OpenAgricultureFoundation/openag-mechanical/prj/hazelnut_large/LHC-001/1-Documentation/2018-2019 Large Tree Computer - Superceded Designs and Documentation/2019-4-18 Light Test Setup in SHC/IMG_1373.JPG

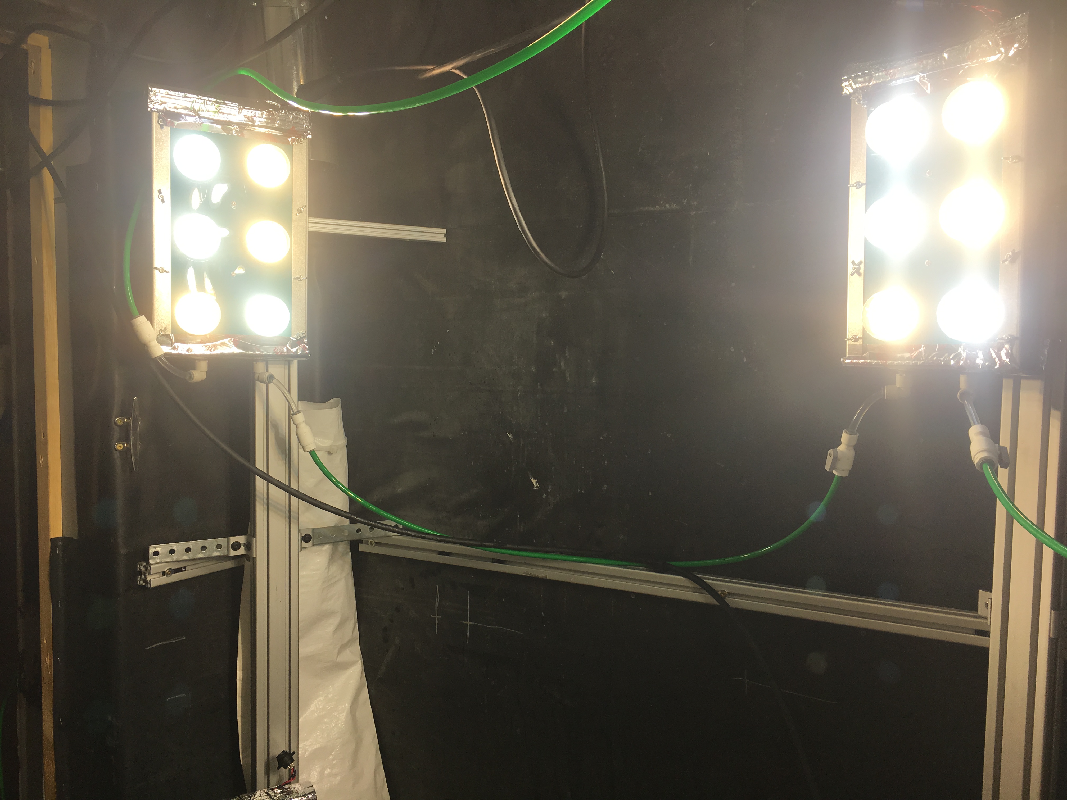
prj/hazelnut_large/LHC-001/1-Documentation/2018-2019 Large Tree Computer - Superceded Designs and Documentation/2019-4-18 Light Test Setup in SHC/IMG_1373.JPG
