OpenAgricultureFoundation/openag-mechanical/prj/hazelnut_large/LHC-001/1-Documentation/2018-2019 Large Tree Computer - Superceded Designs and Documentation/2018-10-1 Status Update/2.jpg

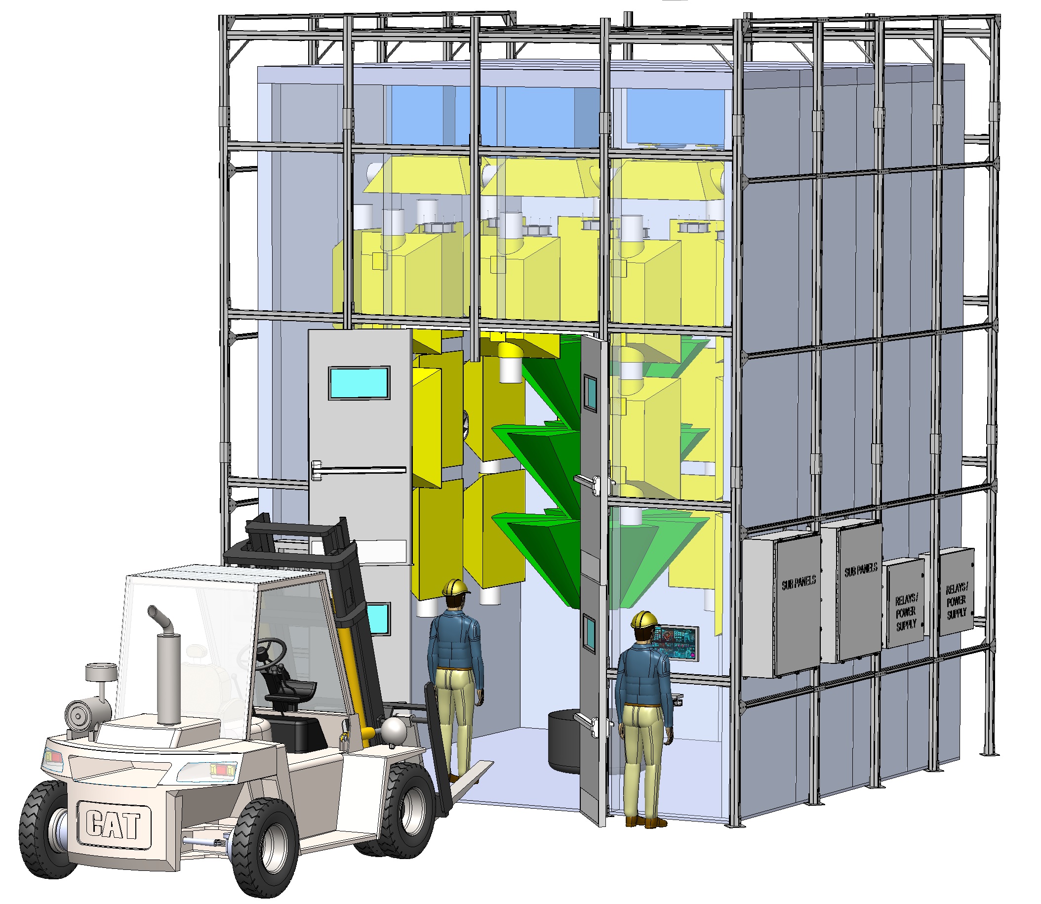
prj/hazelnut_large/LHC-001/1-Documentation/2018-2019 Large Tree Computer - Superceded Designs and Documentation/2018-10-1 Status Update/2.jpg
