OpenAgricultureFoundation/openag-mechanical/README.md

# OpenAg Body
Body of mechanical hardware for the various food computers.
Mechanical design based in Solidworks.

*WORK IN PROGRESS*

### Projects
- Create project directory structure
- Follow naming conventions
