OpenAgricultureFoundation/openag-mechanical/prj/fs-waterbot/v1.0/README.md

# waterbot
Mechanical specs and model for automated irrigation system sub-assemblies
