OpenAgricultureFoundation/openag-mechanical/prj/hazelnut_large/LHC-001/1-Documentation/2019-10-24 LED Coolant Line Routing Designs/2019-10-30 Fluid Line Routing Details.pptx

LHC-201 Fluid Line Routing Details
OpenAg, MIT Media Lab

By Eugene Zeleny
Oct 30th, 2019

## Slide 2

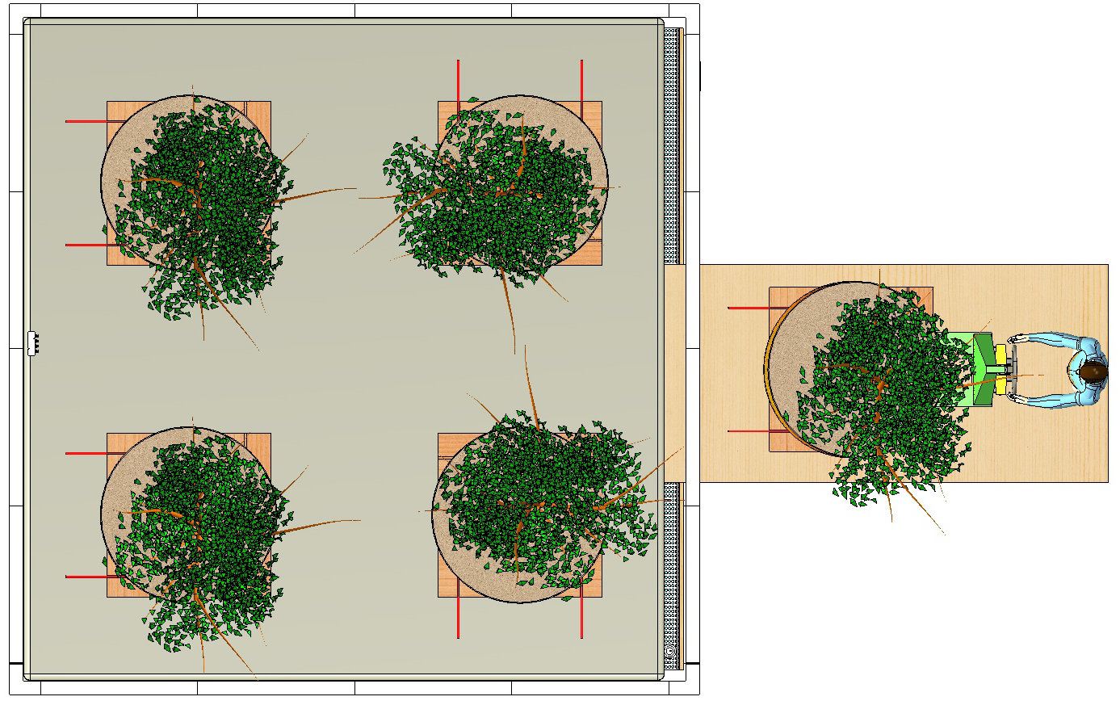
[picture p3: figure]

- Tree pallet layout and suggested fluid line routing for the Tree Heater Assembly

Fluid to Tree Heater

Fluid from Tree Heater

## Slide 3

Heated Fluid
To Radiator

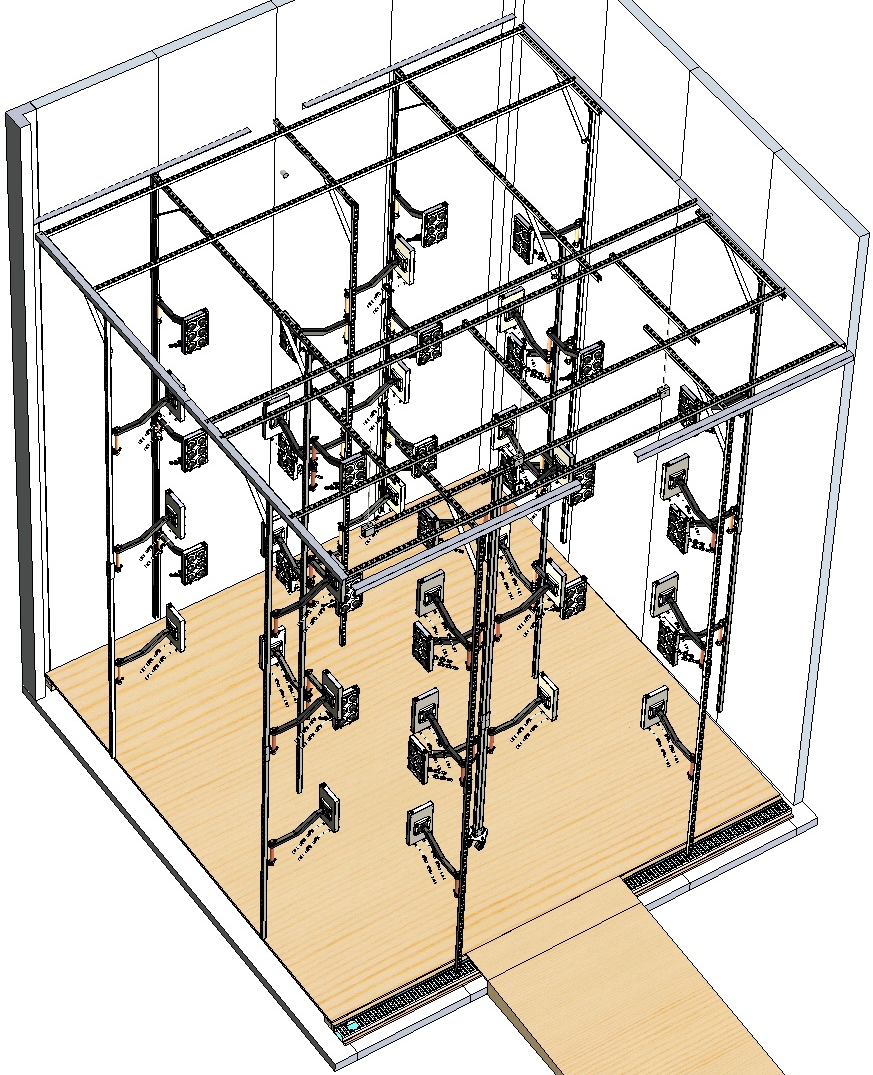
[picture p4: figure]

- Suggested fluid line routing for LED Enclosures

Cooled Fluid
To LEDs

Fluid Leaving the LEDs

Fluid Entering the LEDs
