OpenAgricultureFoundation/openag-mechanical/prj/hazelnut_large/LHC-001/1-Documentation/2019-10-23 Light Unistrut Designs - Updated/2019-10-29 LED Unistrut Design Details.pptx

LHC-201 LED Unistrut Design Details
and
Installation Guide
OpenAg, MIT Media Lab

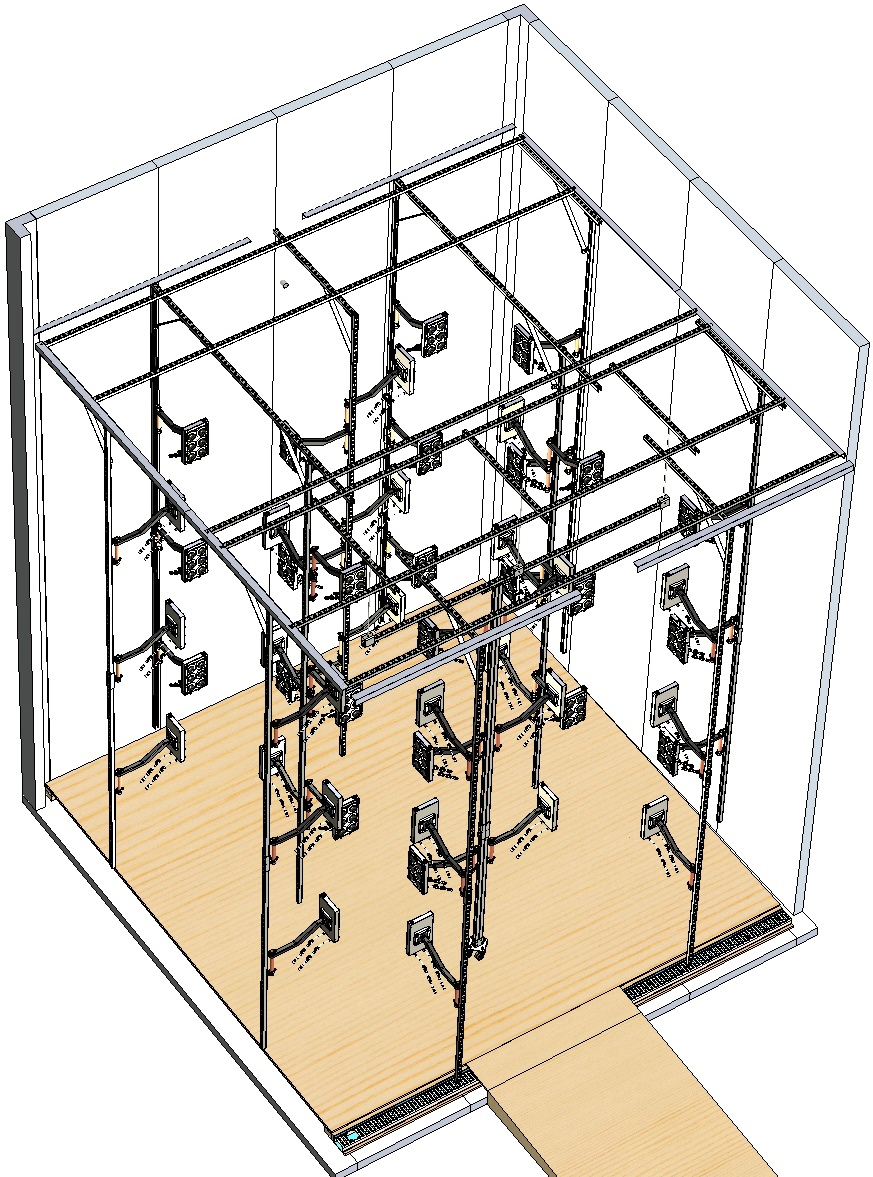
[picture p5: figure]

By Eugene Zeleny
Oct 29th, 2019

## Slide 2

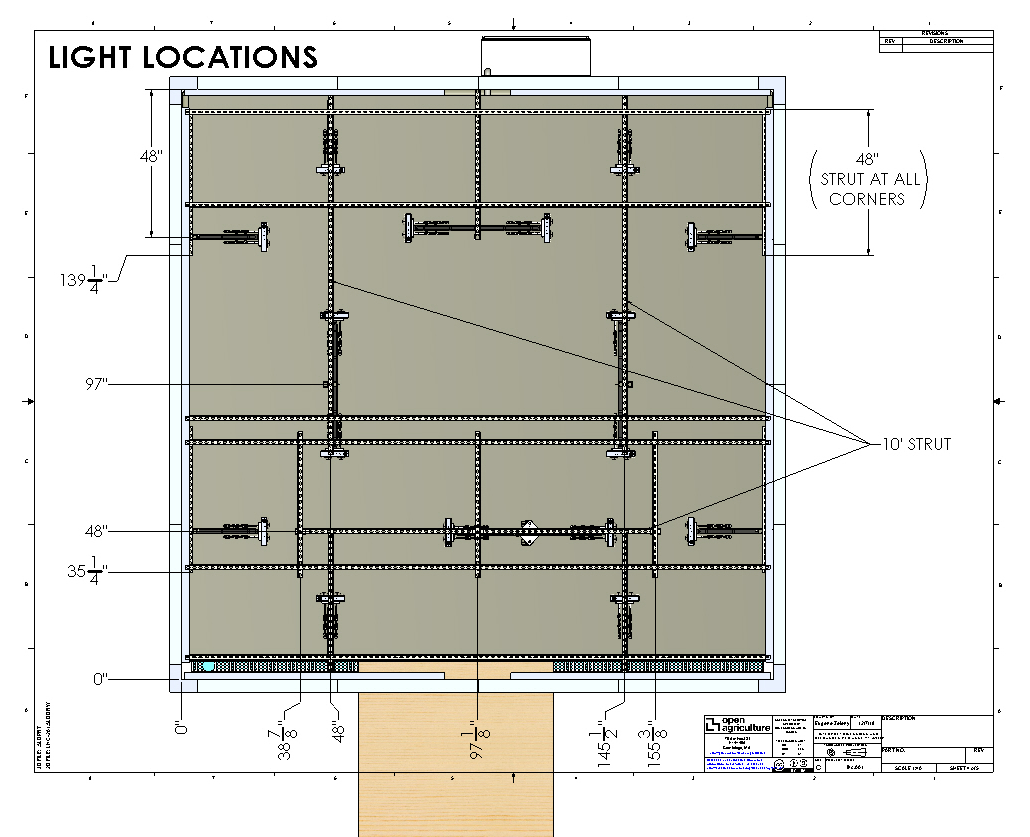
[picture p6: figure]

- Layout and dimensions for position of Unistrut channel that support the LED Enclosure Assemblies
- All LED Enclosures are shown in their most extended arm positions

## Slide 3

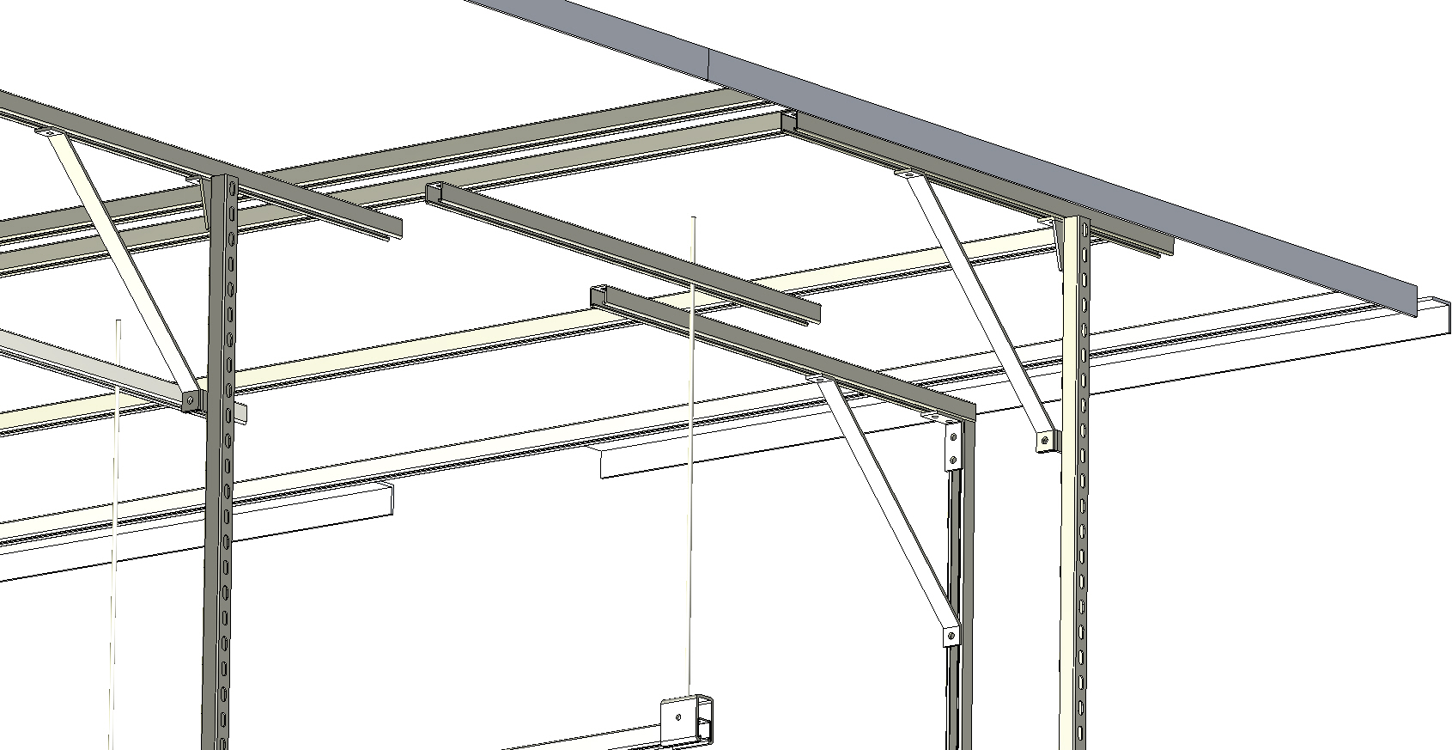
[picture p7: figure]

4” 90° Bracket
MCM 33125T146

Perpendicular 90° Bracket
MCM 33125T421

Front Left Corner (if facing the box from the outside, head-on)

3/8”-16 Threaded Rod, 3’
MCM 98847A031

Hanging/Connecting Channel Trolley Bracket MCM3626T42

2” 90° Bracket
MCM 33125T32

24” Strut Channel Brace
MCM 3574T42

Recommended 3/8-16 Strut Washer
MCM 3259T14

Hardware details and call-outs
All hardware sourced from McMaster Carr

## Slide 4

Rear Wall

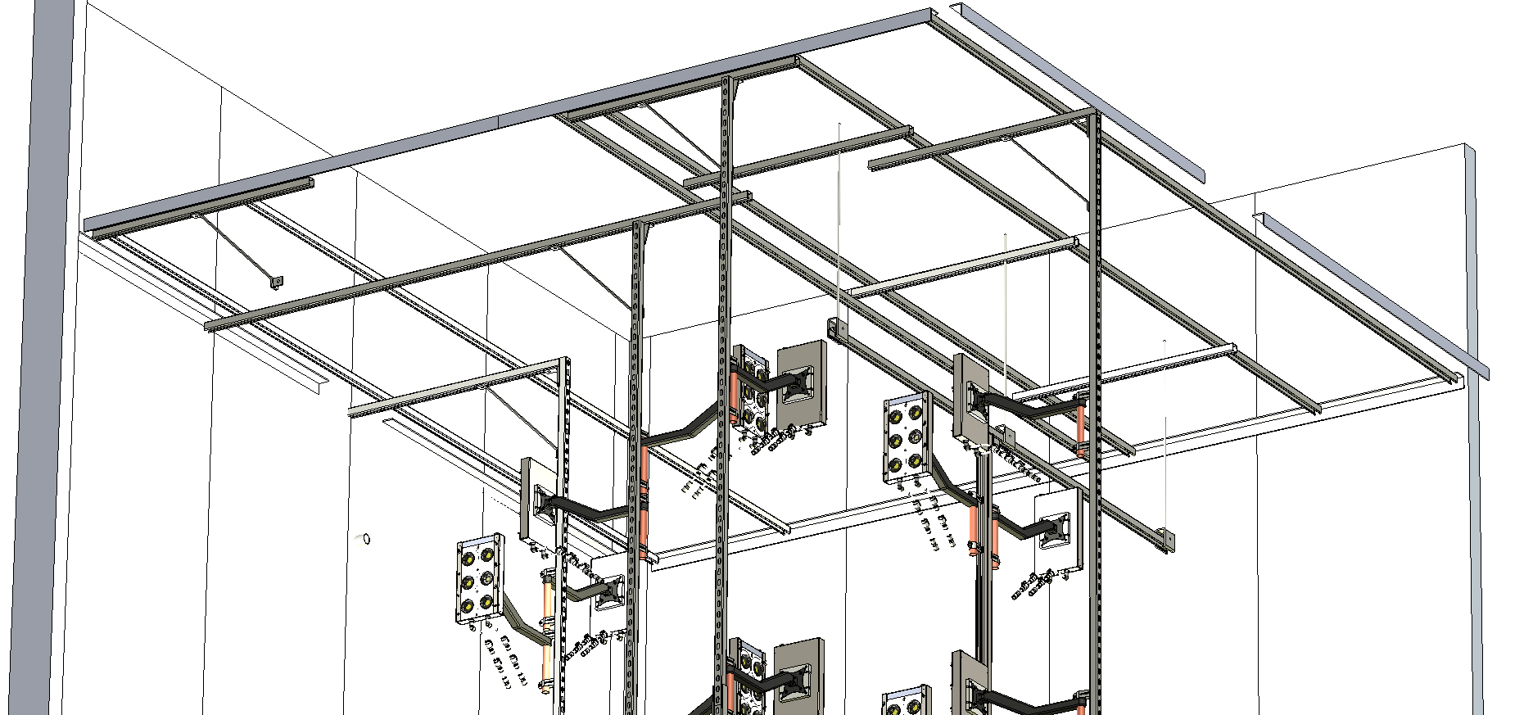
[picture p8: figure]

Strut installation reference images and views
All LED Enclosures are shown in their most extended arm positions

## Slide 5

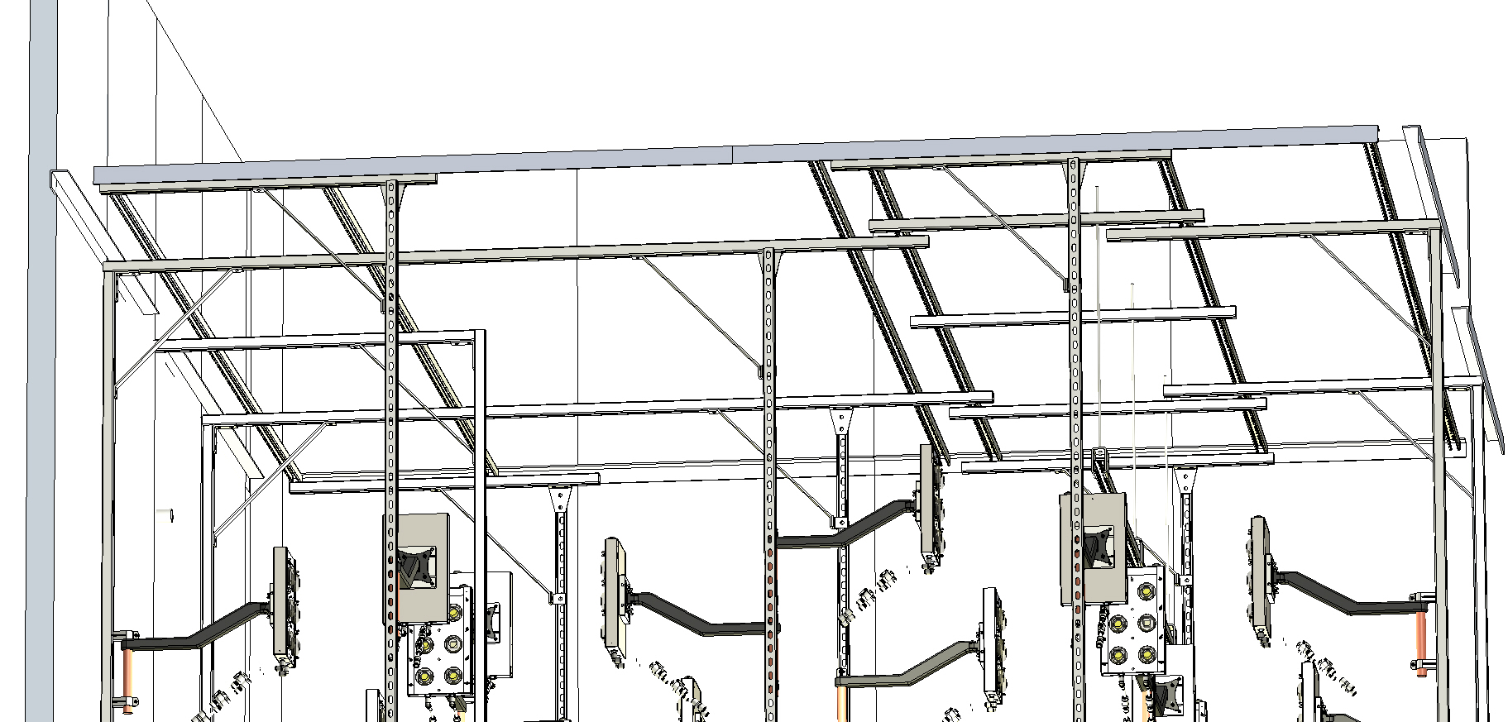
[picture p9: figure]

Rear Wall

Strut installation reference images and views
All LED Enclosures are shown in their most extended arm positions

## Slide 6

Rear Wall

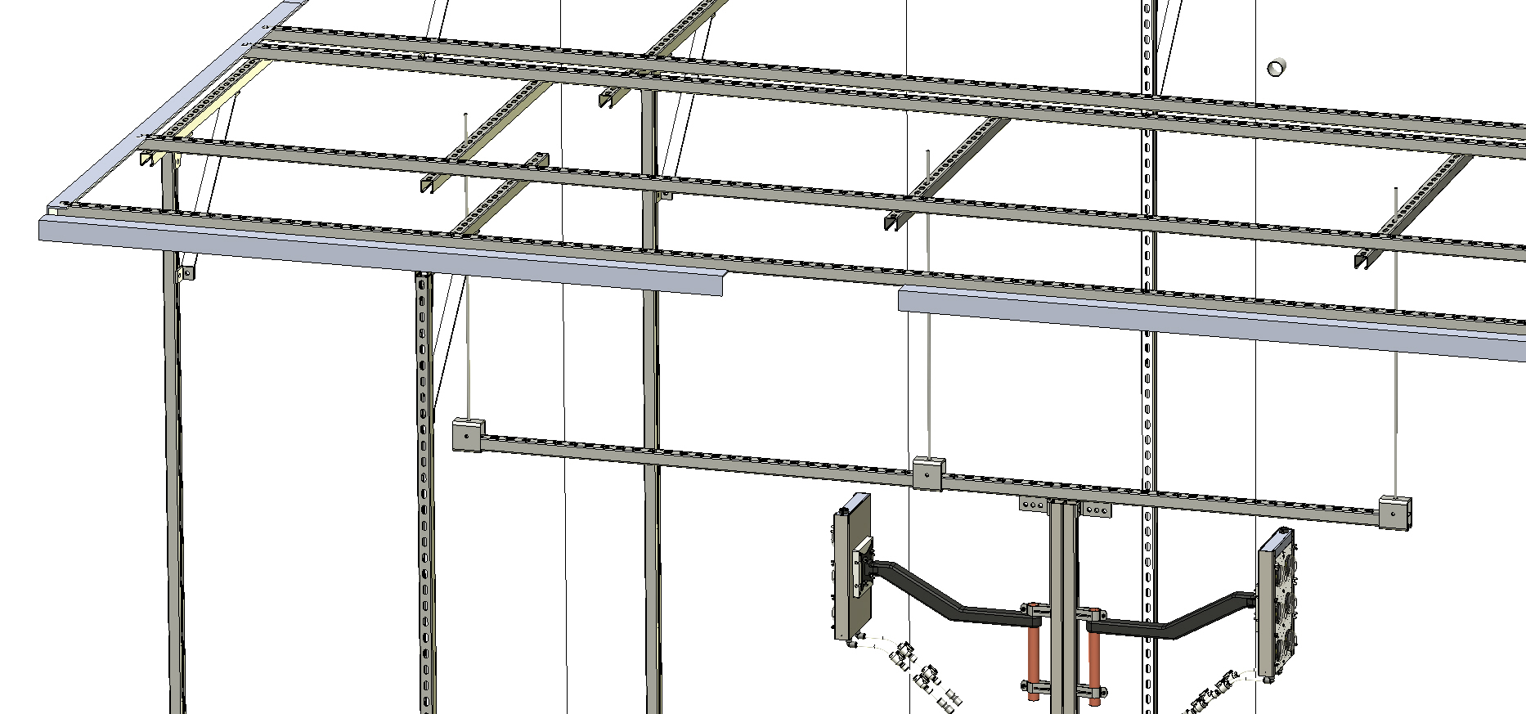
[picture p10: figure]

Strut installation reference images and views
All LED Enclosures are shown in their most extended arm positions

Front Left Corner (if facing the box from the outside, head-on)

10’ Unistrut

## Slide 7

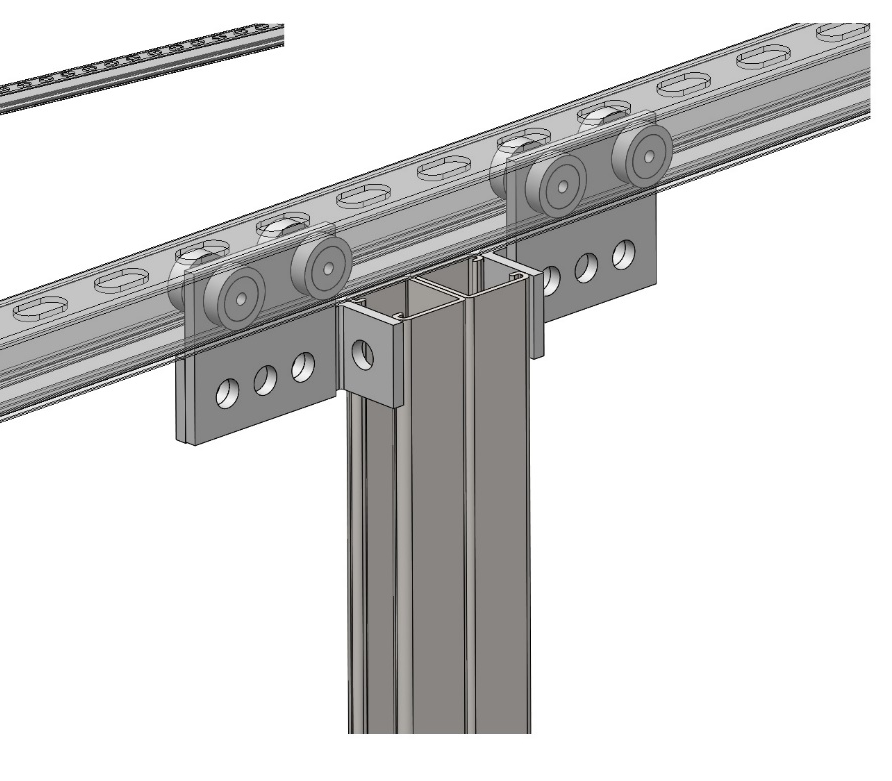
[picture p11: figure]
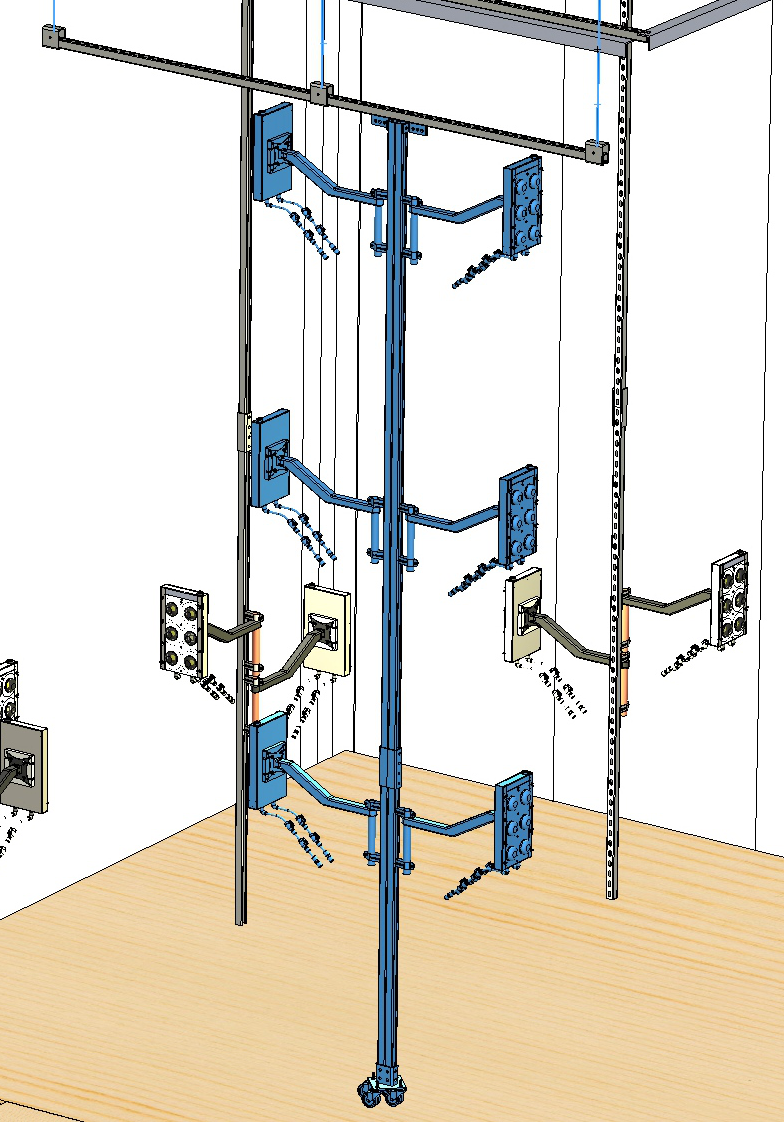
[picture p12: figure]
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

Strut Channel Trolley
MCM 3626T11

Back-to-Back Strut Channel, 10’
MCM 3208T6

90° Bracket
MCM 3626T11

Wraparound Bracket
MCM 33125T139

Floor Mount
MCM 33145T49

Swivel Caster
MCM 87845T64

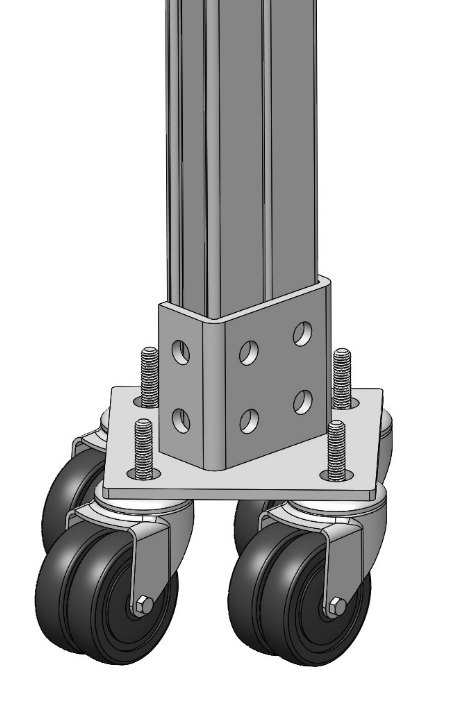
[picture p13: figure]

Back-to-Back Strut Channel, 5’
MCM 3208T6
