OpenAgricultureFoundation/openag-mechanical/prj/hazelnut_large/LHC-001/3-Specification Sheets/other/heat_exchange_specs.rtf

12” Aavid heatsink (https://www.digikey.com/product-detail/en/aavid-thermal-division-of-boyd-corporation/416201U00000G/416201U00000G-ND/6131504):
0.010°C/W @ 1.0 GPM

Circulation pump (https://www.mcmaster.com/9930k63):
1/12hp
@ 3’ of head: 11.8gpm
@ 10’ of head: 9.5gpm

Heat exchanger (https://www.mcmaster.com/35145k75)
7,100 btu/hr
