OpenAgricultureFoundation/openag-mechanical/prj/hazelnut_large/LHC-001/1-Documentation/2019-10-28 Fan Research and Comparison/2019-10-28 Large Tree Computer Fan Research.pptx

Wall-Mounted Fan Research

Open Agriculture Initiative
Project: Large Tree Computer
2019-10-28

## Slide 2

Non-Oscillating

## Slide 3

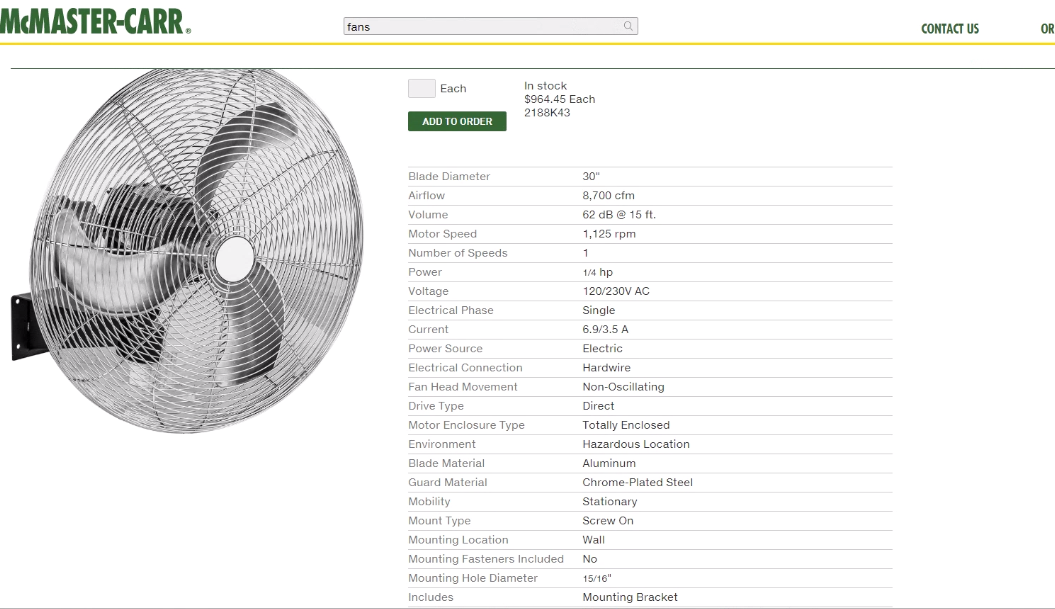
[picture p40: figure]

## Slide 4

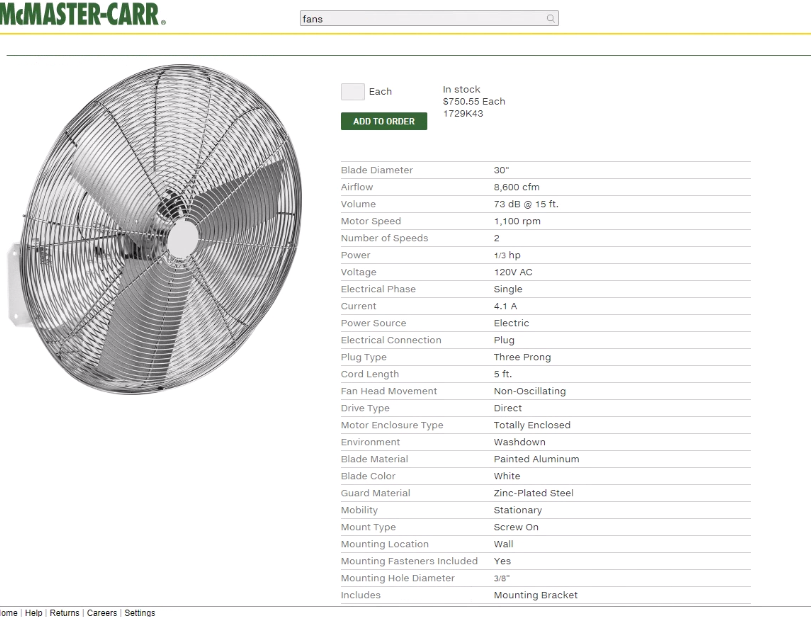
[picture p41: figure]

## Slide 5

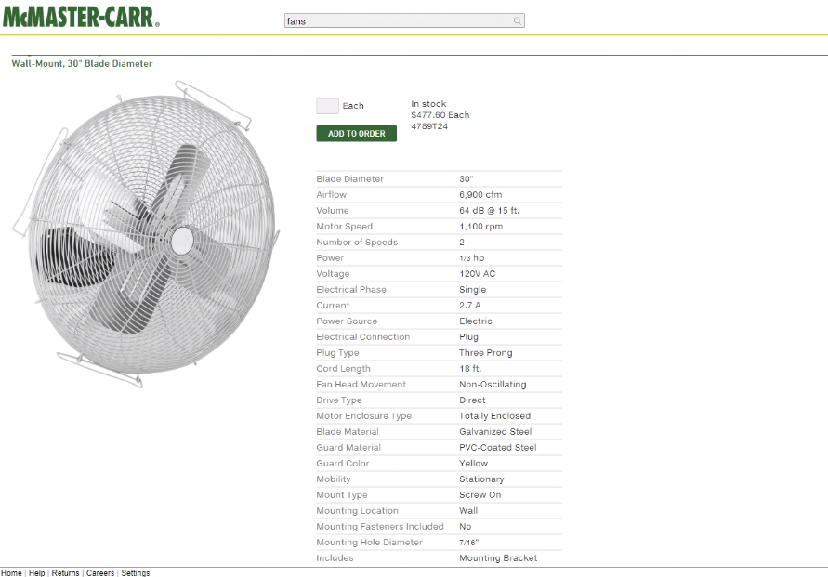
[picture p42: figure]

## Slide 6

Non-Oscillating, Tilting

## Slide 7

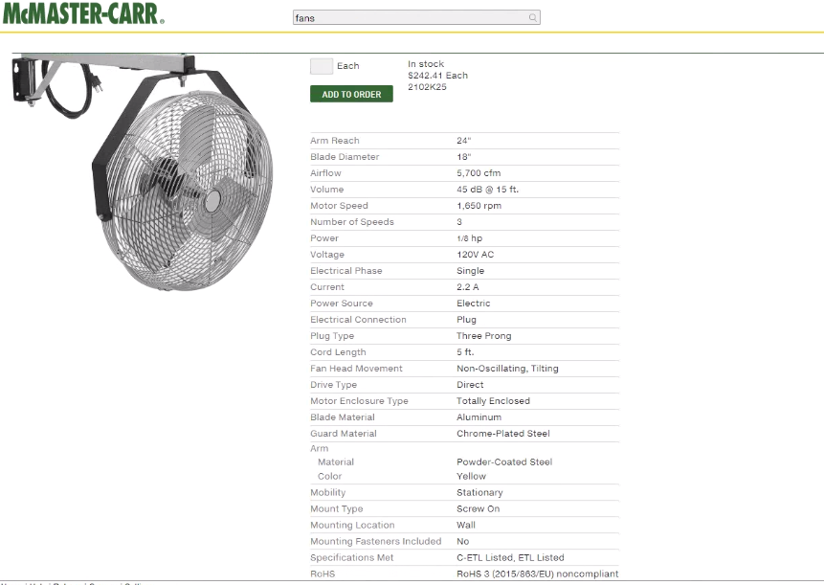
[picture p43: figure]

## Slide 8

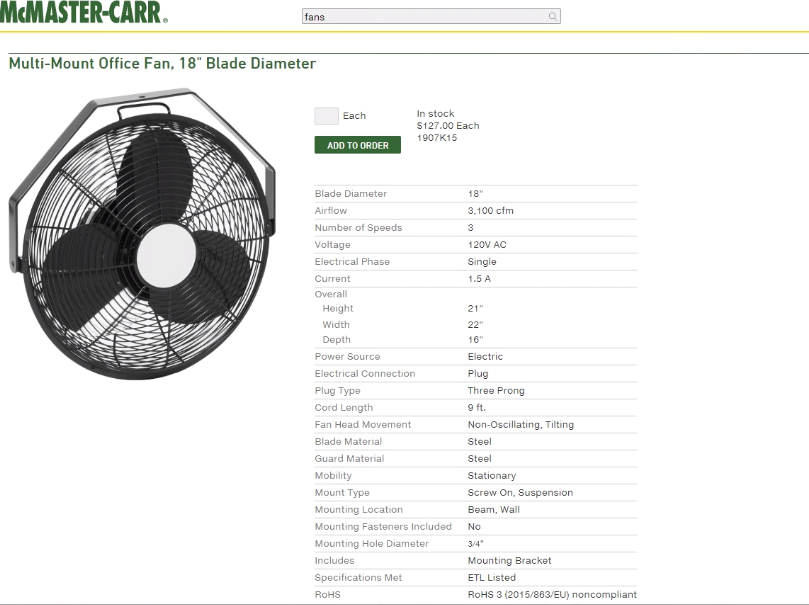
[picture p44: figure]

## Slide 9

Oscillating

## Slide 10

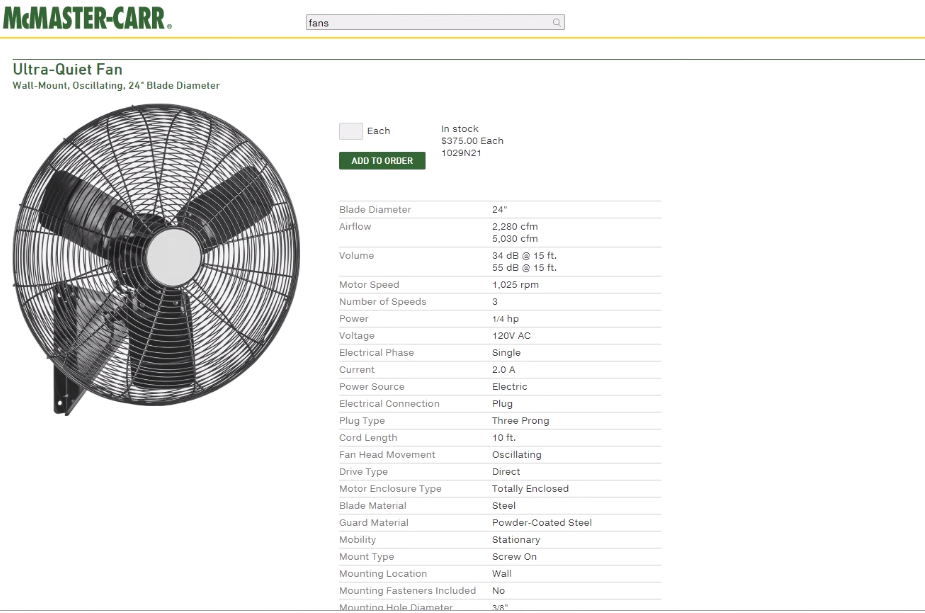
[picture p45: figure]

## Slide 11

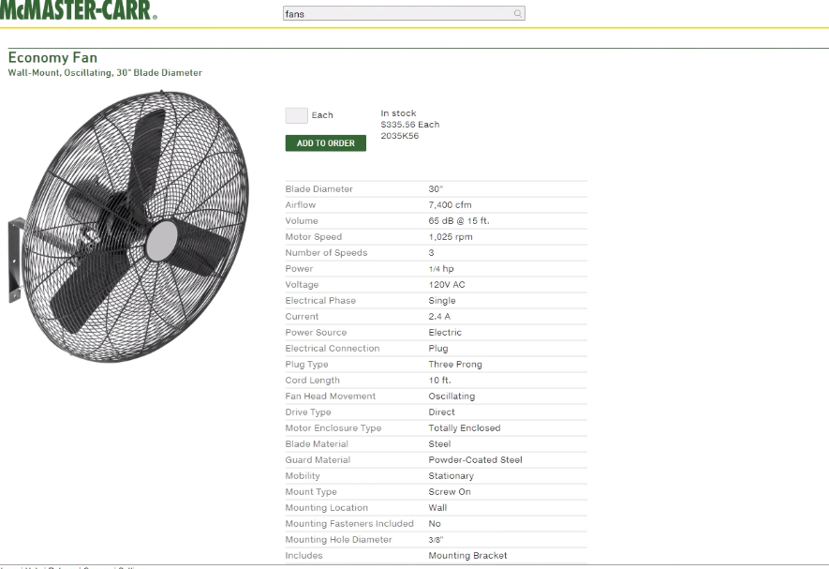
[picture p46: figure]

## Slide 12

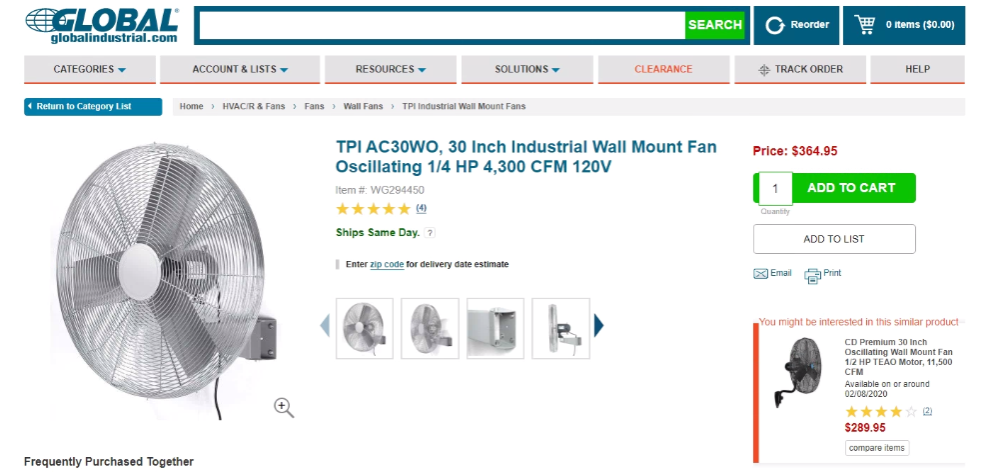
[picture p47: figure]

## Slide 13

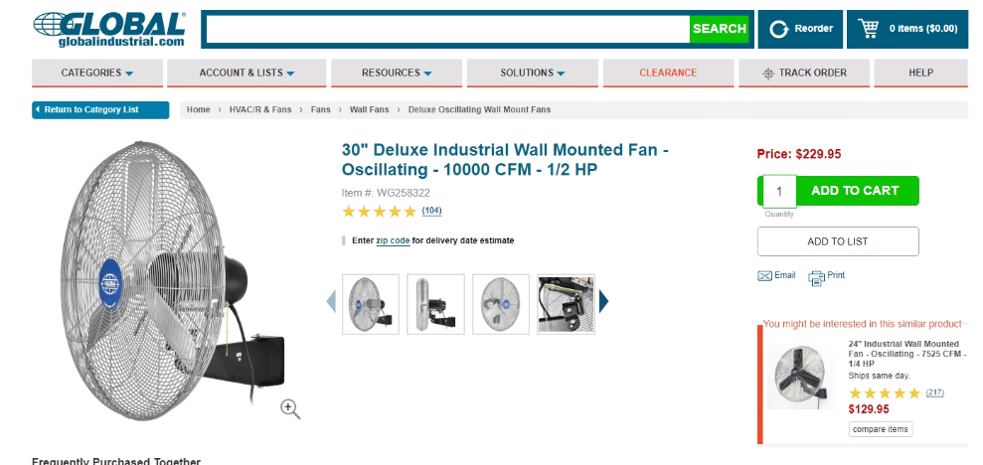
[picture p48: figure]

## Slide 14

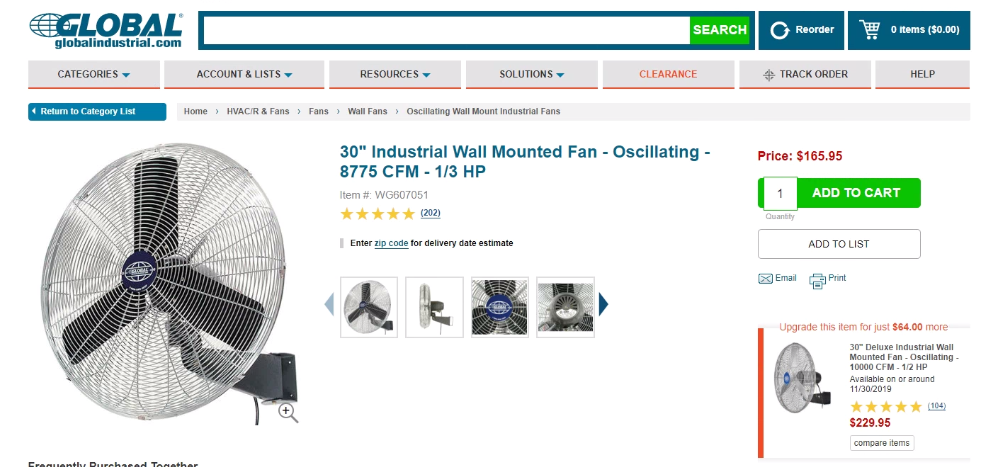
[picture p49: figure]

## Slide 15

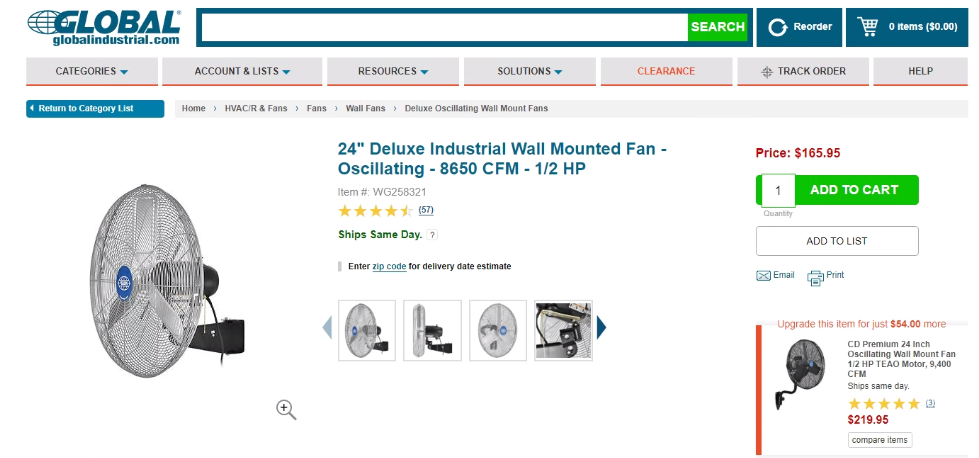
[picture p50: figure]
