OpenAgricultureFoundation/openag-mechanical/incoming/5-25-18 Salem Sheet Metal/Q6438.pdf

Quote To:

MIT Media Lab
75 Amherst Street
Cambridge MA 02139
United States

Date Quoted: 5/25/2018
Quote Expiration: 6/24/2018

978.777.4597
Email:
Phone: | 978.774.2100
Line | Part Number | Description | Rev | Drawing
1 | LFR.001 | LIGHT ARRAY ENCLOSURE | 1
| | | Lead Time TBD
Quantity | Unit Price | Net Price
50 | EA | $23.60 | $1,180.00
300 | EA | $21.00 | $6,300.00

Line(1) - Miscellaneous Charge -
| | | Non-Recurring Engineering Chg | 35.00
| | | First Article Inspection | 75.00

QuotForm:001:00

Thank you for this quotation opportunity.
Quoted pricing valid for 60 days unless otherwise noted.
Quote Number: 6438 | Quote

21 Lonergan Road
Middleton, MA 01949-2403
978-774-2100
F. 978-777-4597
