OpenAgricultureFoundation/openag-mechanical/prj/hazelnut_large/LHC-001/2-RFQs/2019-2-21 Salem Metal.pdf

Quote To:

MIT Media Lab
75 Amherst Street
Cambridge MA 02139
United States

Date Quoted: 2/22/2019
Quote Expiration: 3/24/2019

gregv@salemmetal.com

Fax: | 978.777.4597
Email:
Phone: | 978.774.2100
Sales Person: | Greg Valentine
Line | Part Number | Description | Rev | Drawing
1 | LHC-306 | LHC ENCLOSURE | 01
Lead Time 6 WEEKS ARO
Quantity | Unit Price | Net Price
40 | EA | $15.70 | $628.00
80 | EA | $14.30 | $1,144.00

Line(1) - Miscellaneous Charge -
| | | Non-Recurring Engineering Chg | 35.00
| | | First Article Inspection | 50.00

QuotForm:001:00

Thank you for this quotation opportunity.
Quoted pricing valid for 60 days unless otherwise noted.
Quote Number: 7209 | Quote

21 Lonergan Road
Middleton, MA 01949-2403
978-774-2100
F. 978-777-4597
