OpenAgricultureFoundation/openag-mechanical/prj/hazelnut_large/LHC-001/4-Brainstorm Concepts/STENCIL 1.docx

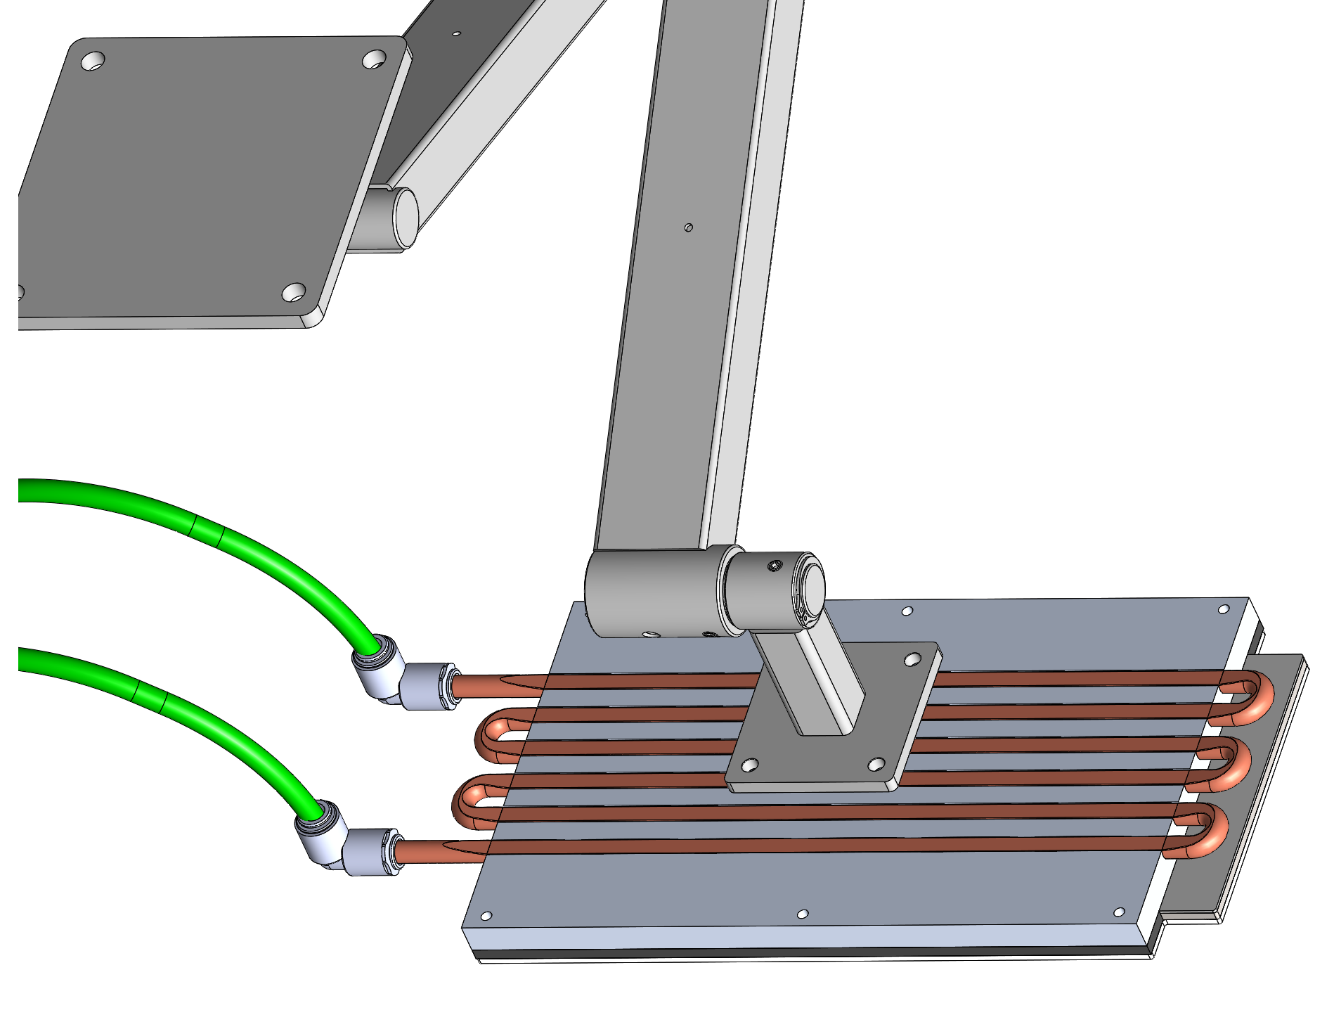
[picture p92: figure]
