OpenAgricultureFoundation/openag-mechanical/prj/hazelnut_large/LHC-001/1-Documentation/2019-9-11 LED Strut Redesign Sketches/9-11-19 Strut Redesign Overlays.docx

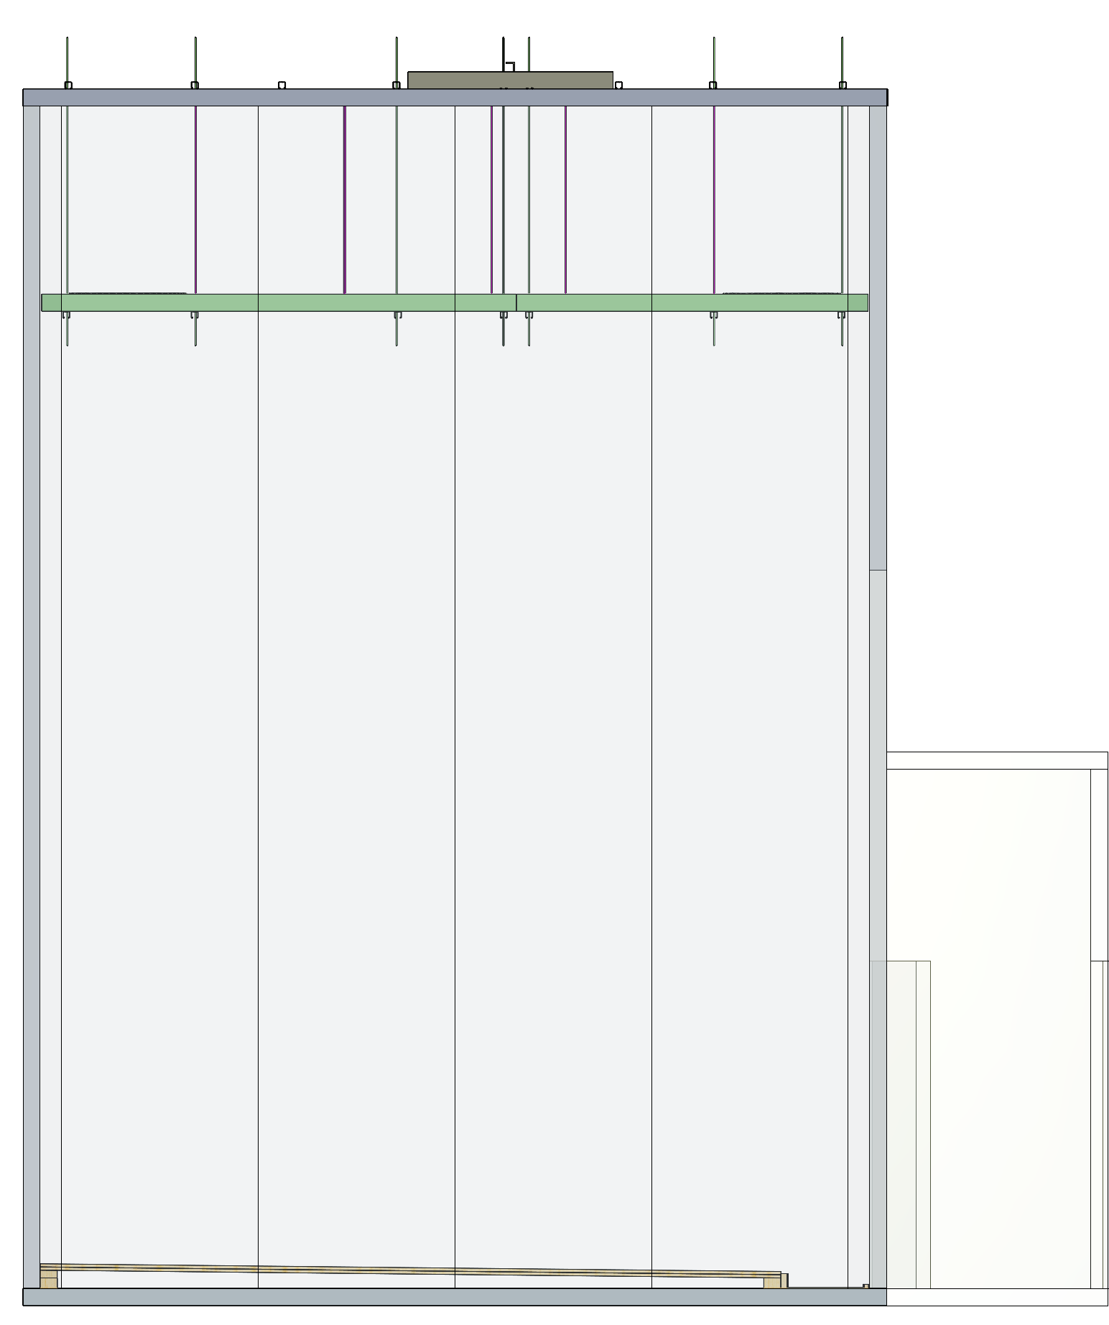
[picture p93: figure]
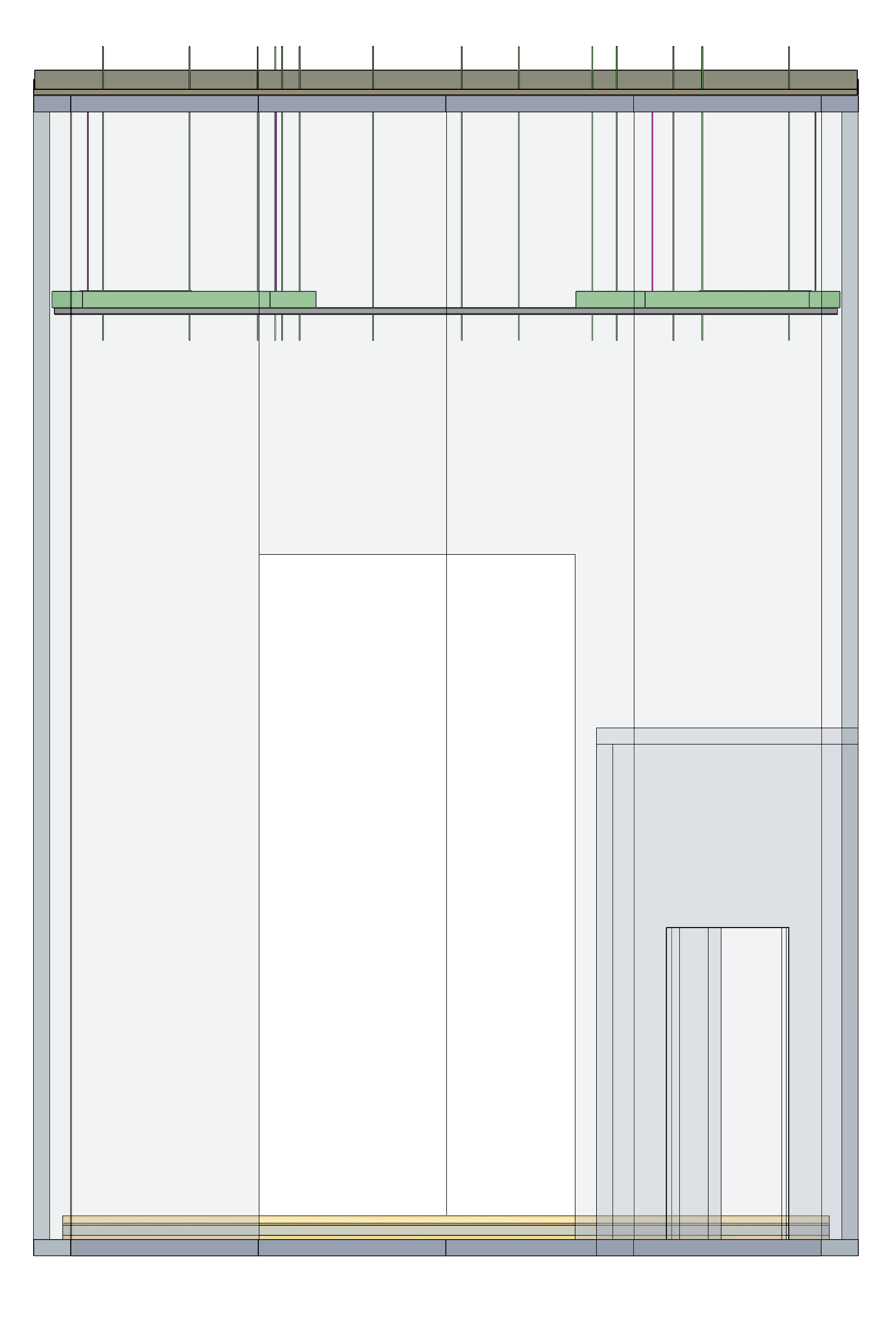
[picture p94: figure]
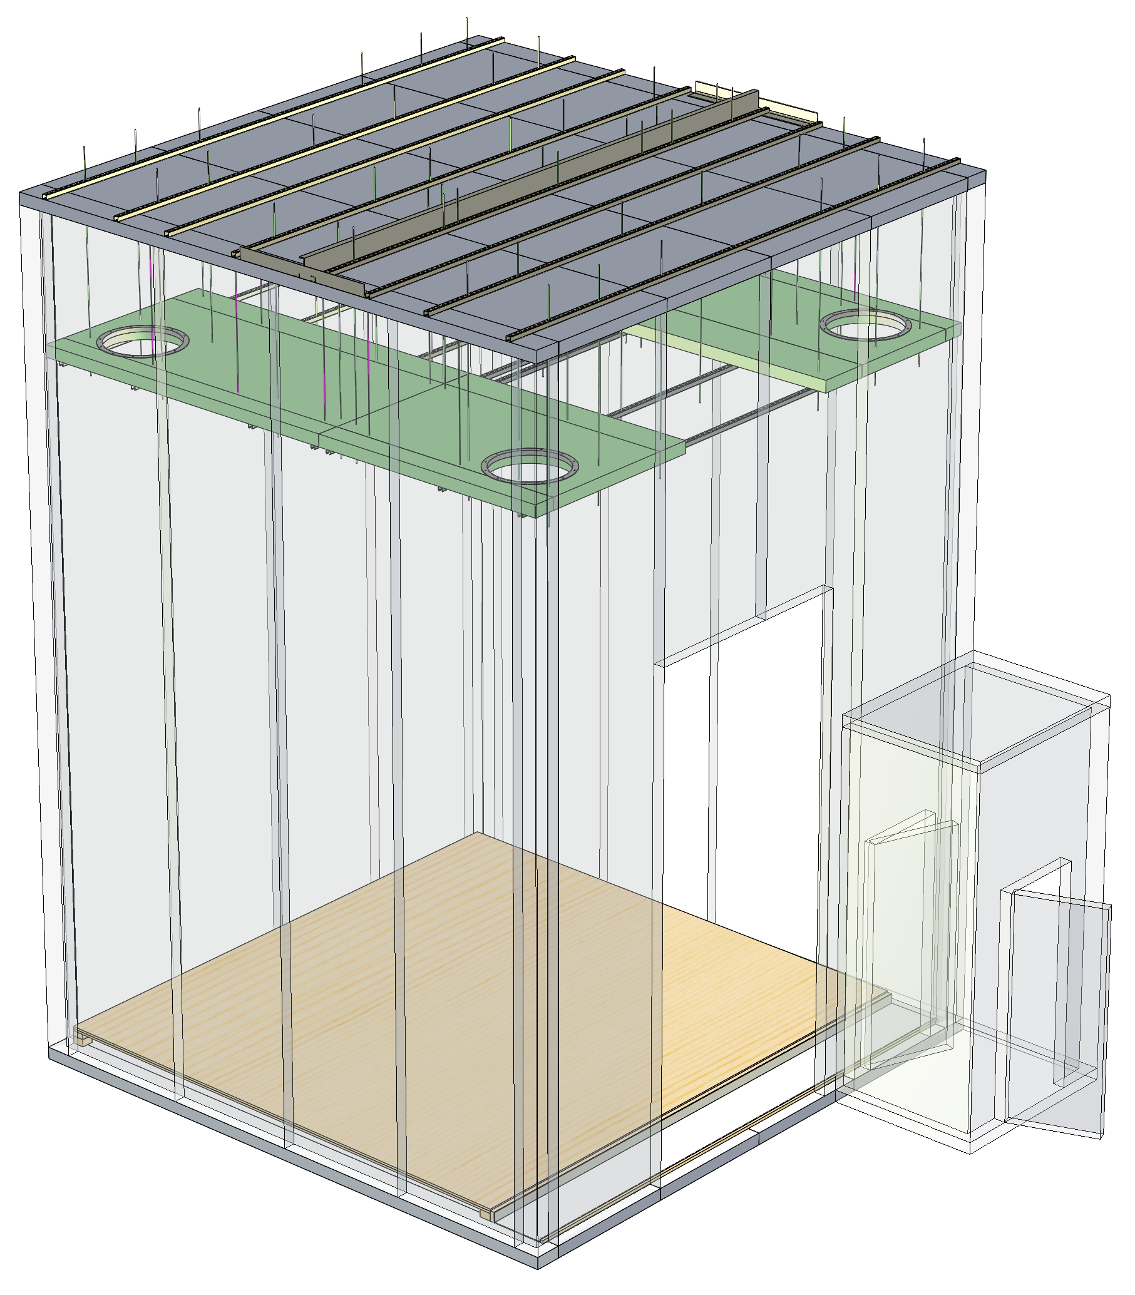
[picture p95: figure]
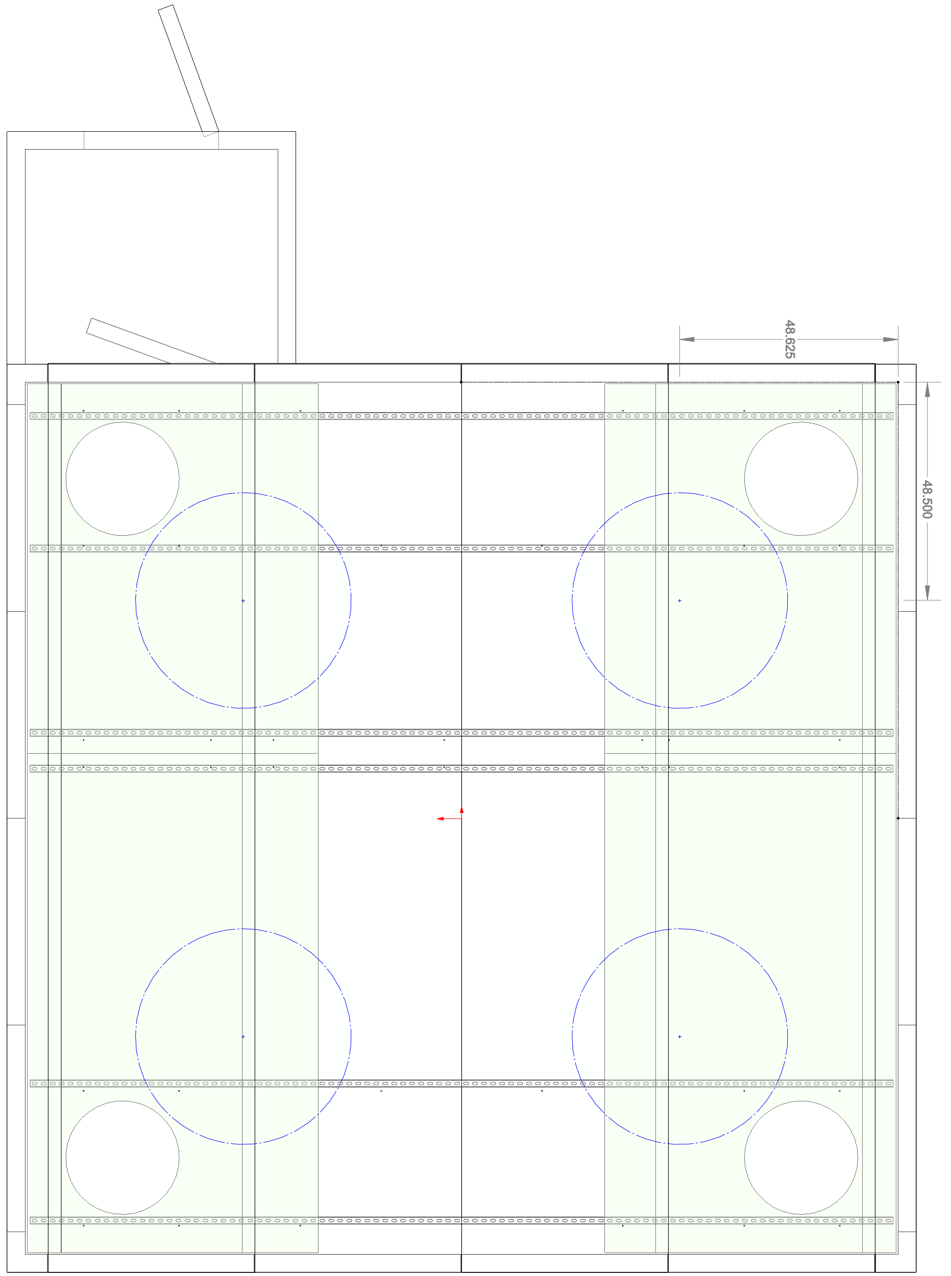
[picture p96: figure]
