OpenAgricultureFoundation/openag-mechanical/prj/container 1/Container/Container_Overlays.docx

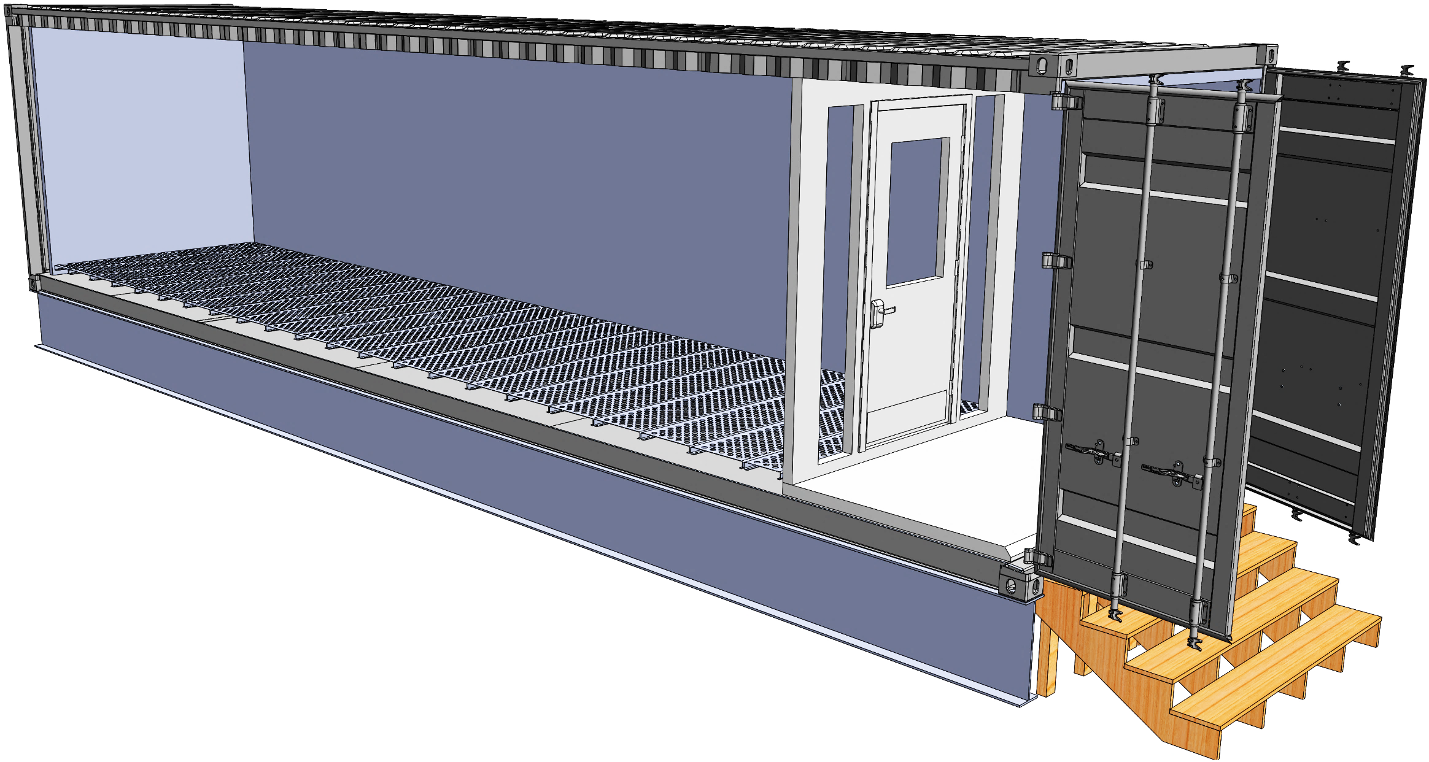
[picture p97: figure]
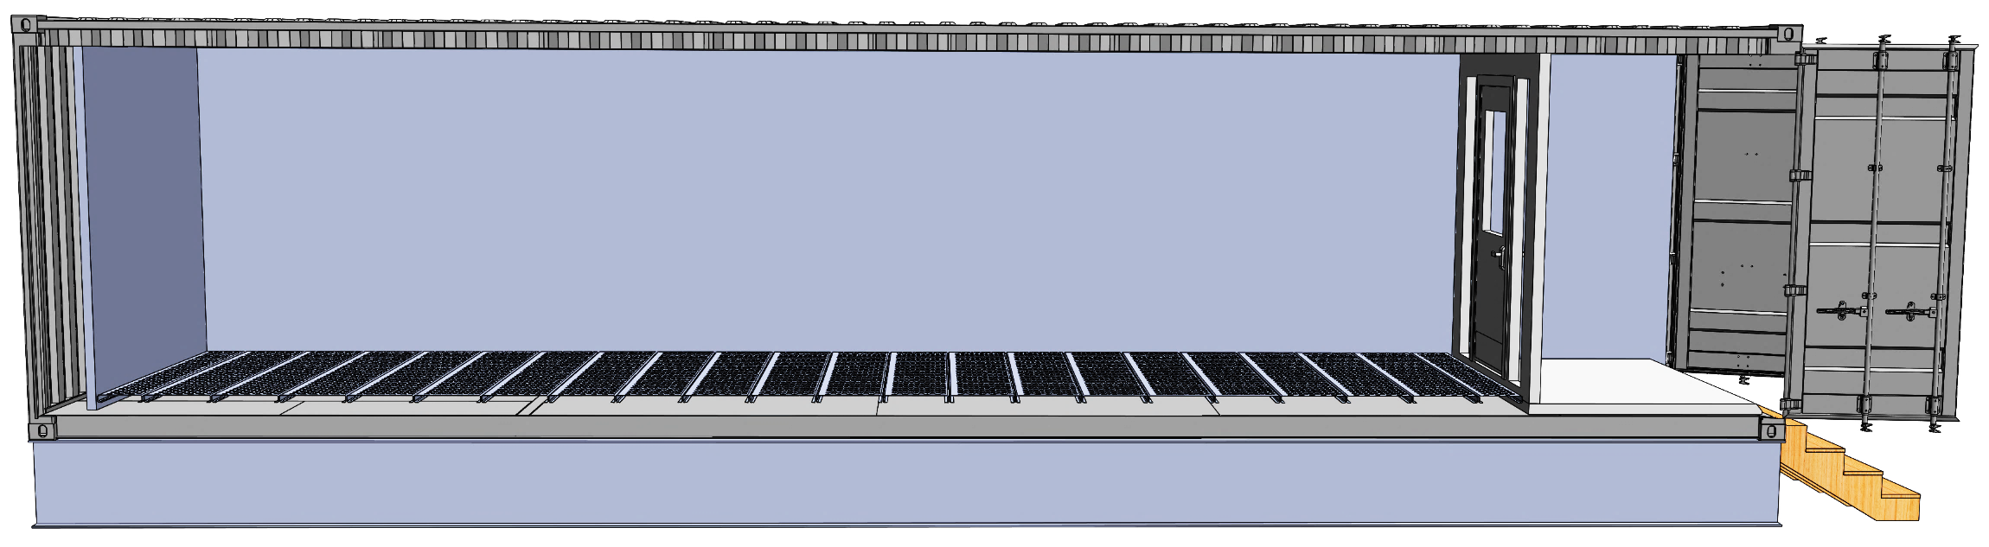
[picture p98: figure]
