OpenAgricultureFoundation/openag-mechanical/prj/hazelnut_large/LHC-001/3-Specification Sheets/DOC.PDF

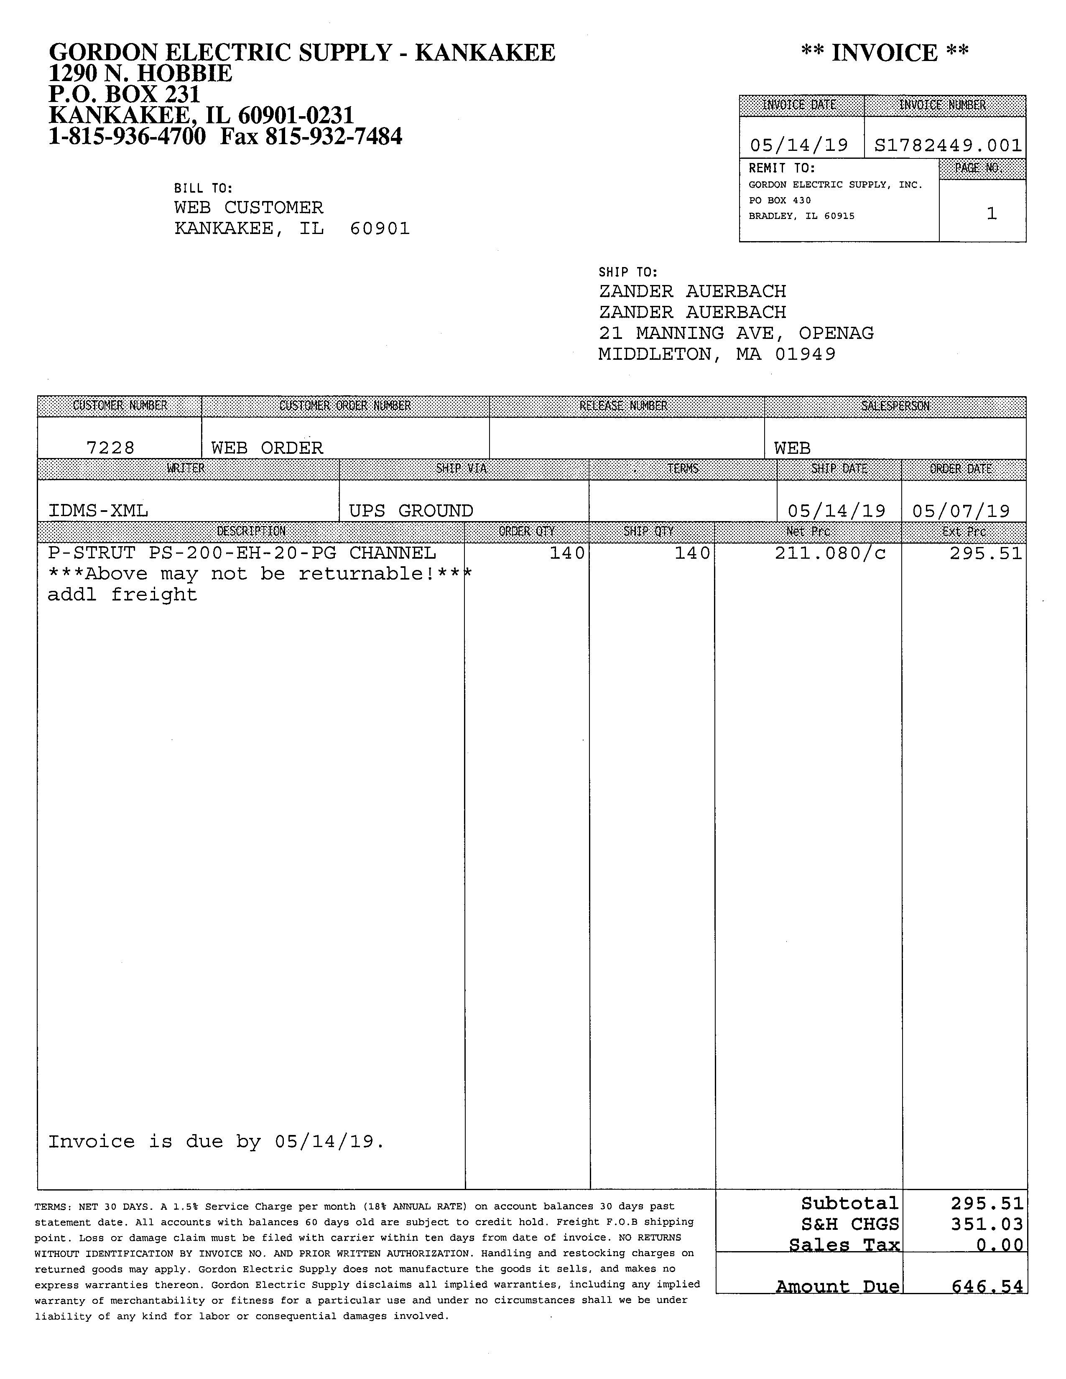
[picture p99: page 1]
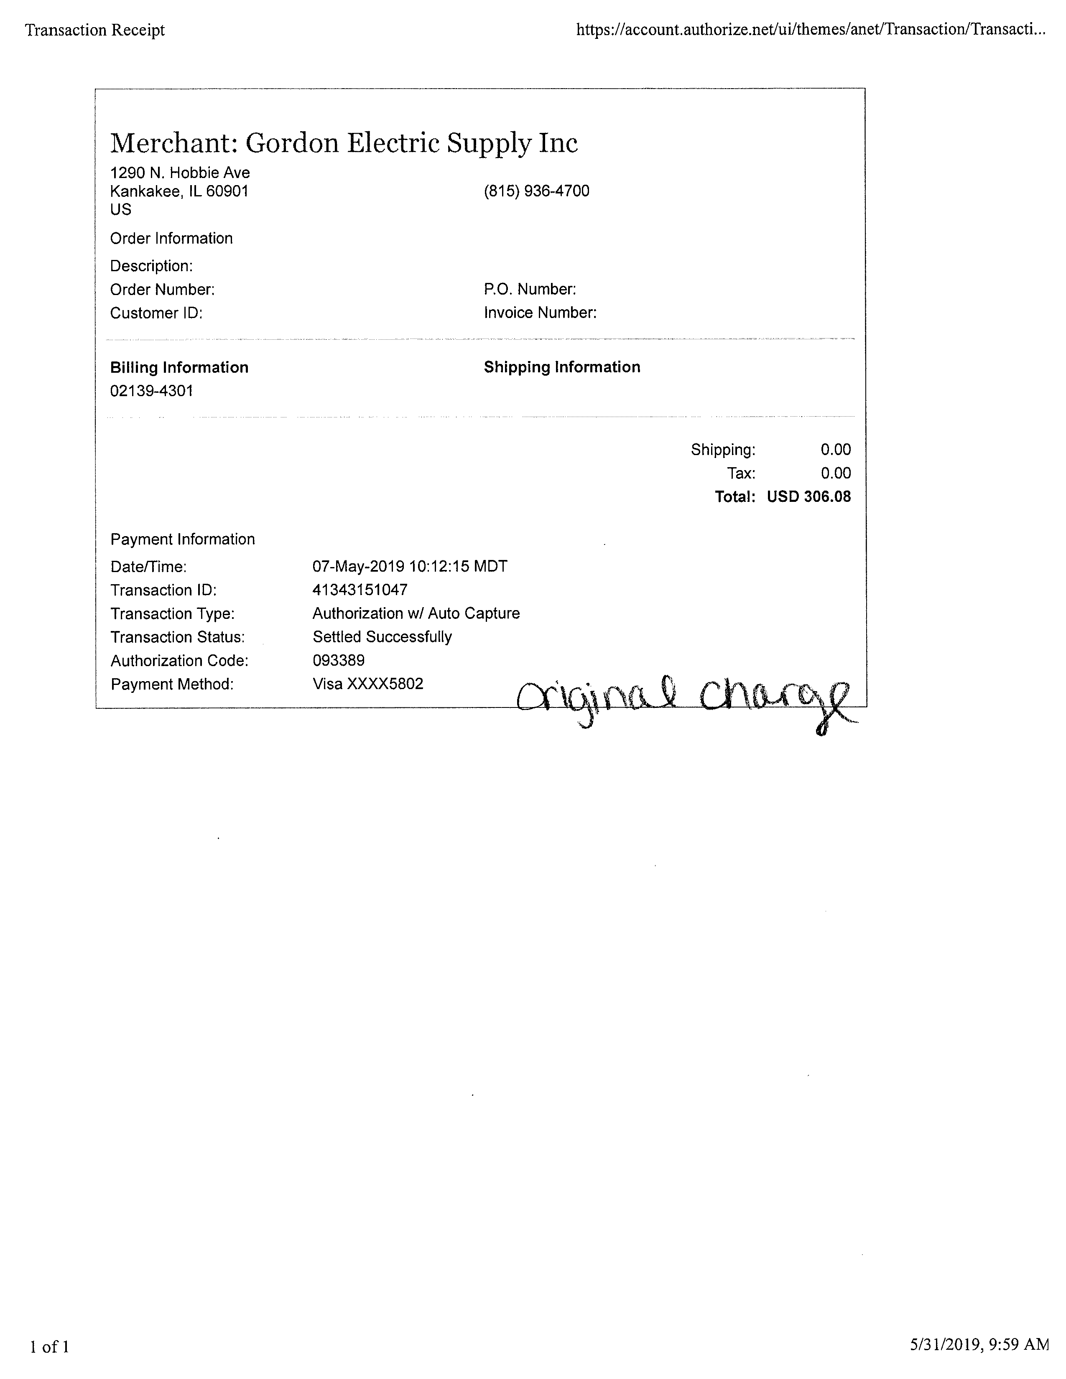
[picture p100: page 2]
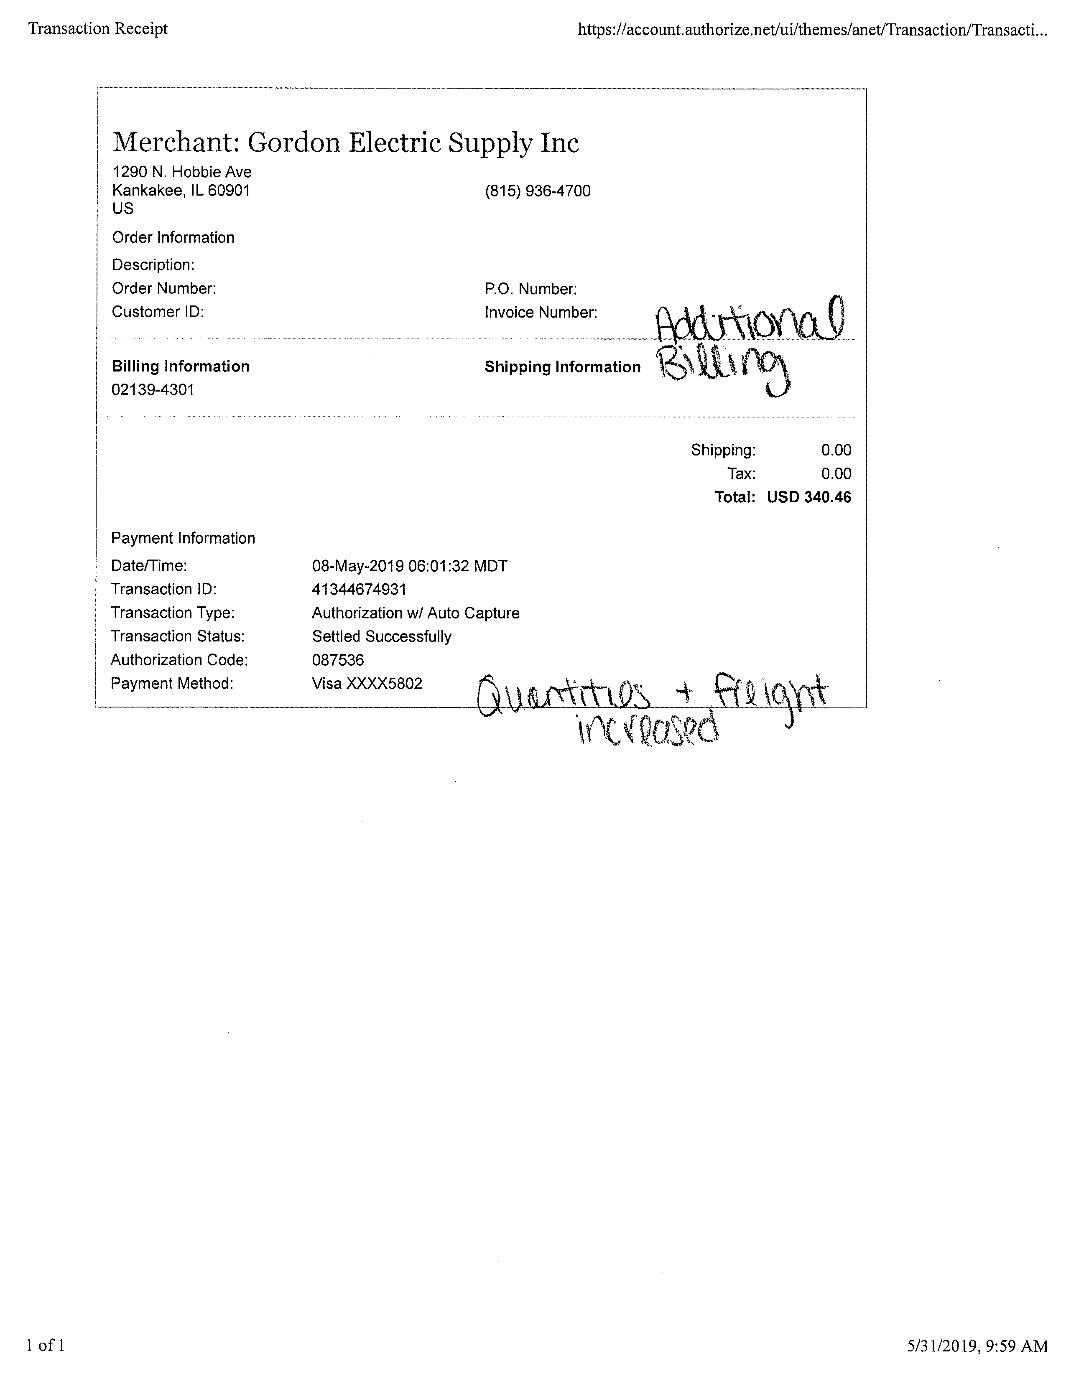
[picture p101: page 3]
