OpenAgricultureFoundation/openag-mechanical/prj/hazelnut_large/LHC-001/3-Specification Sheets/DOC001.PDF

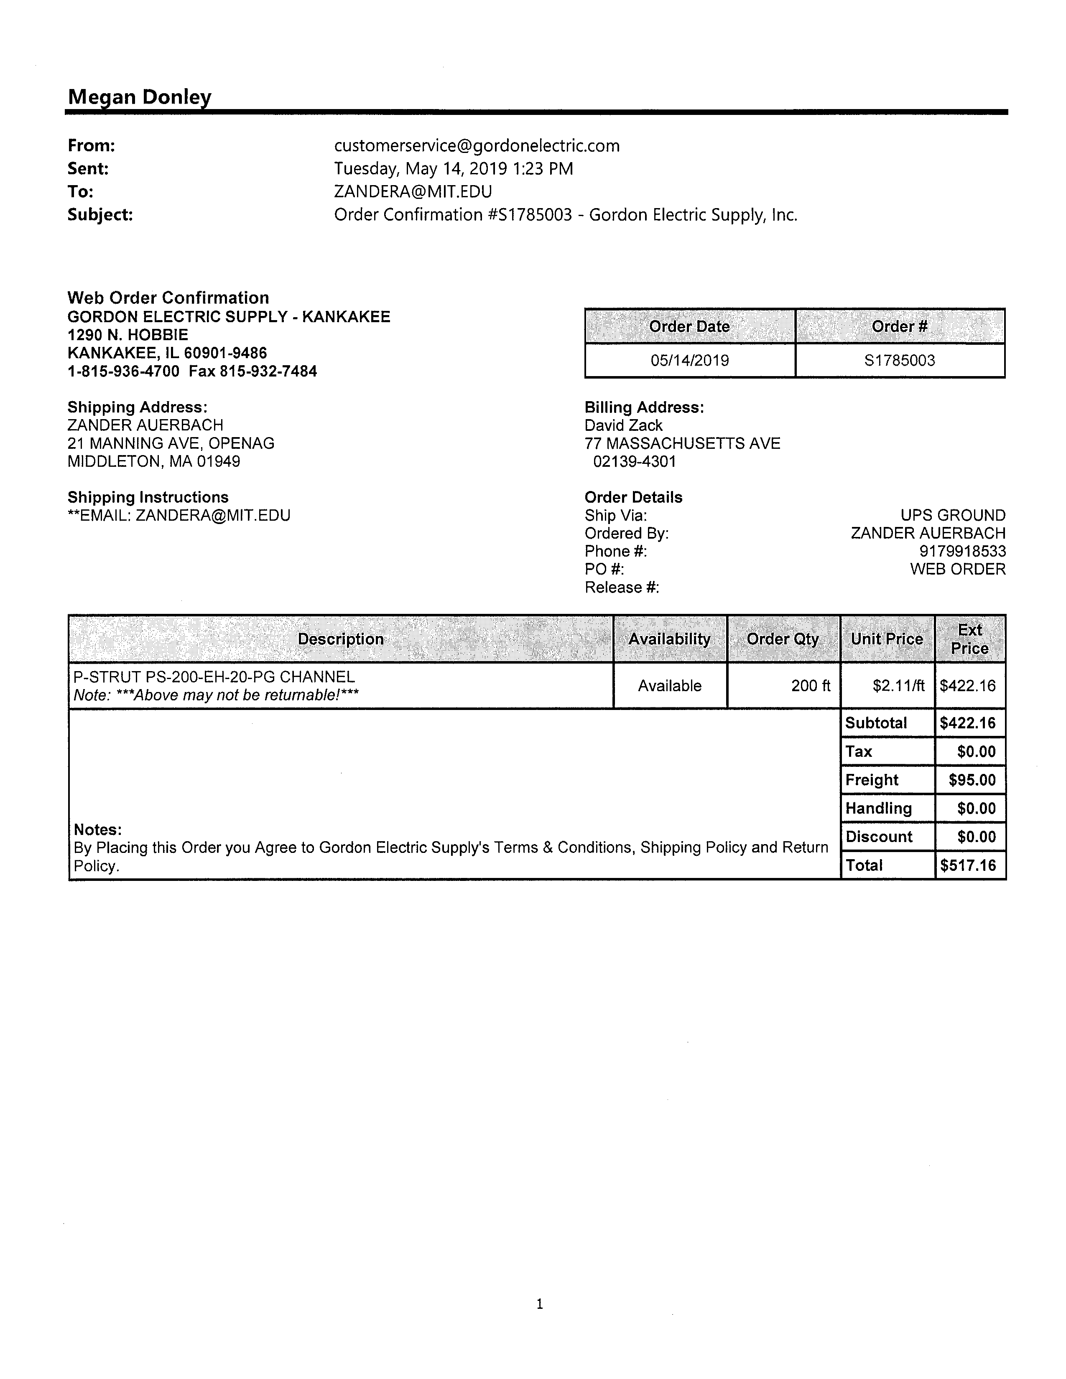
[picture p102: page 1]
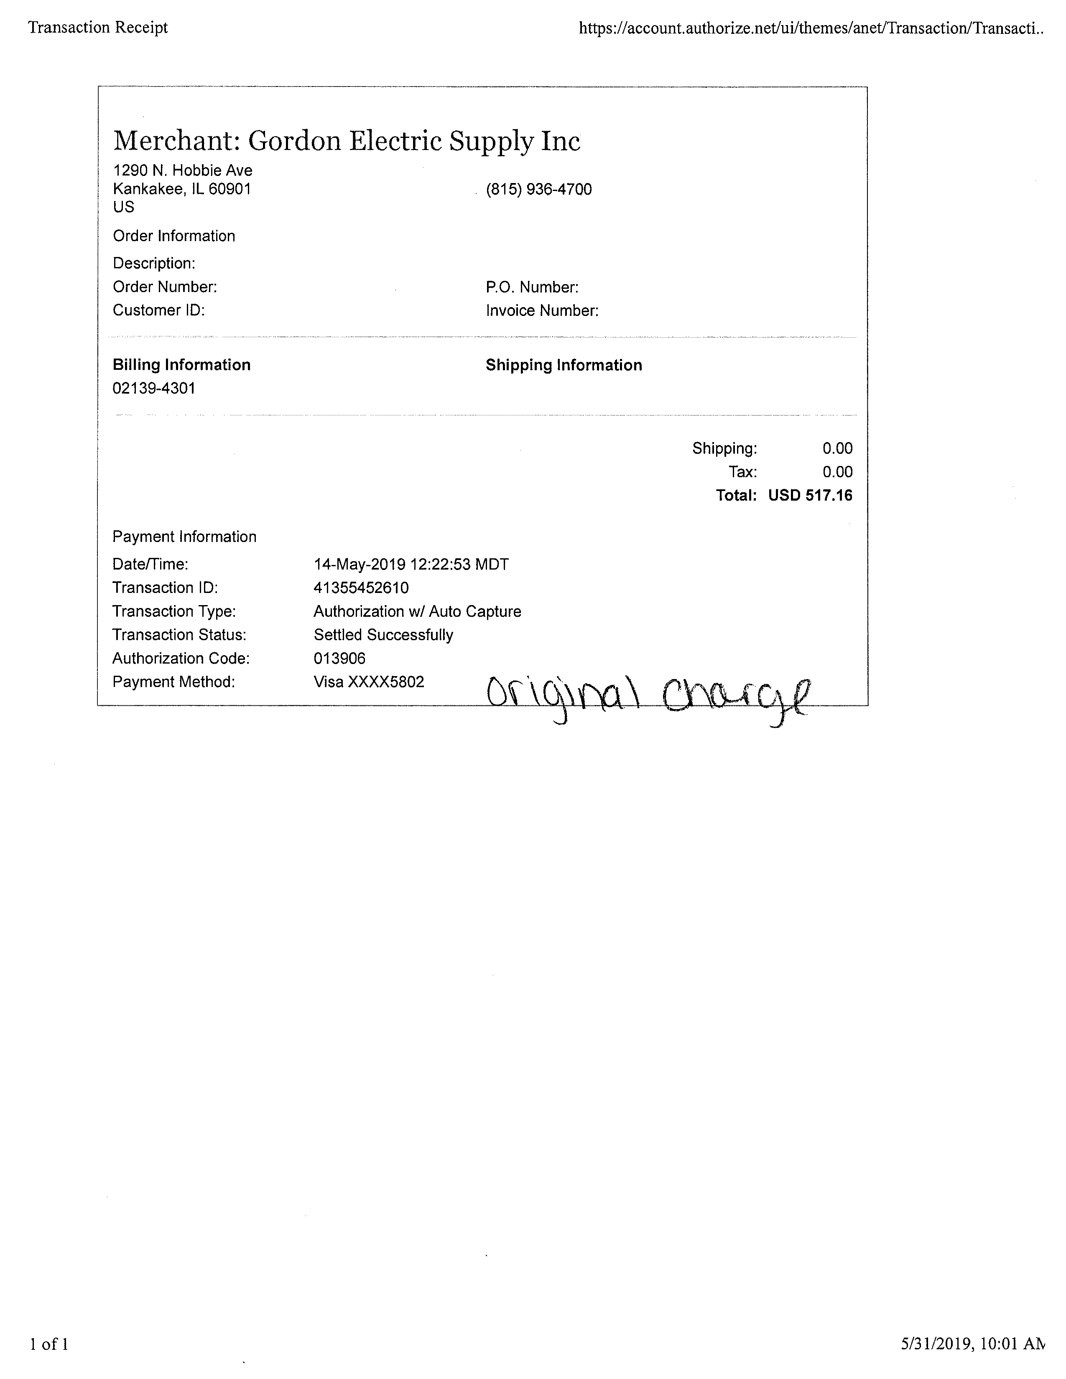
[picture p103: page 2]
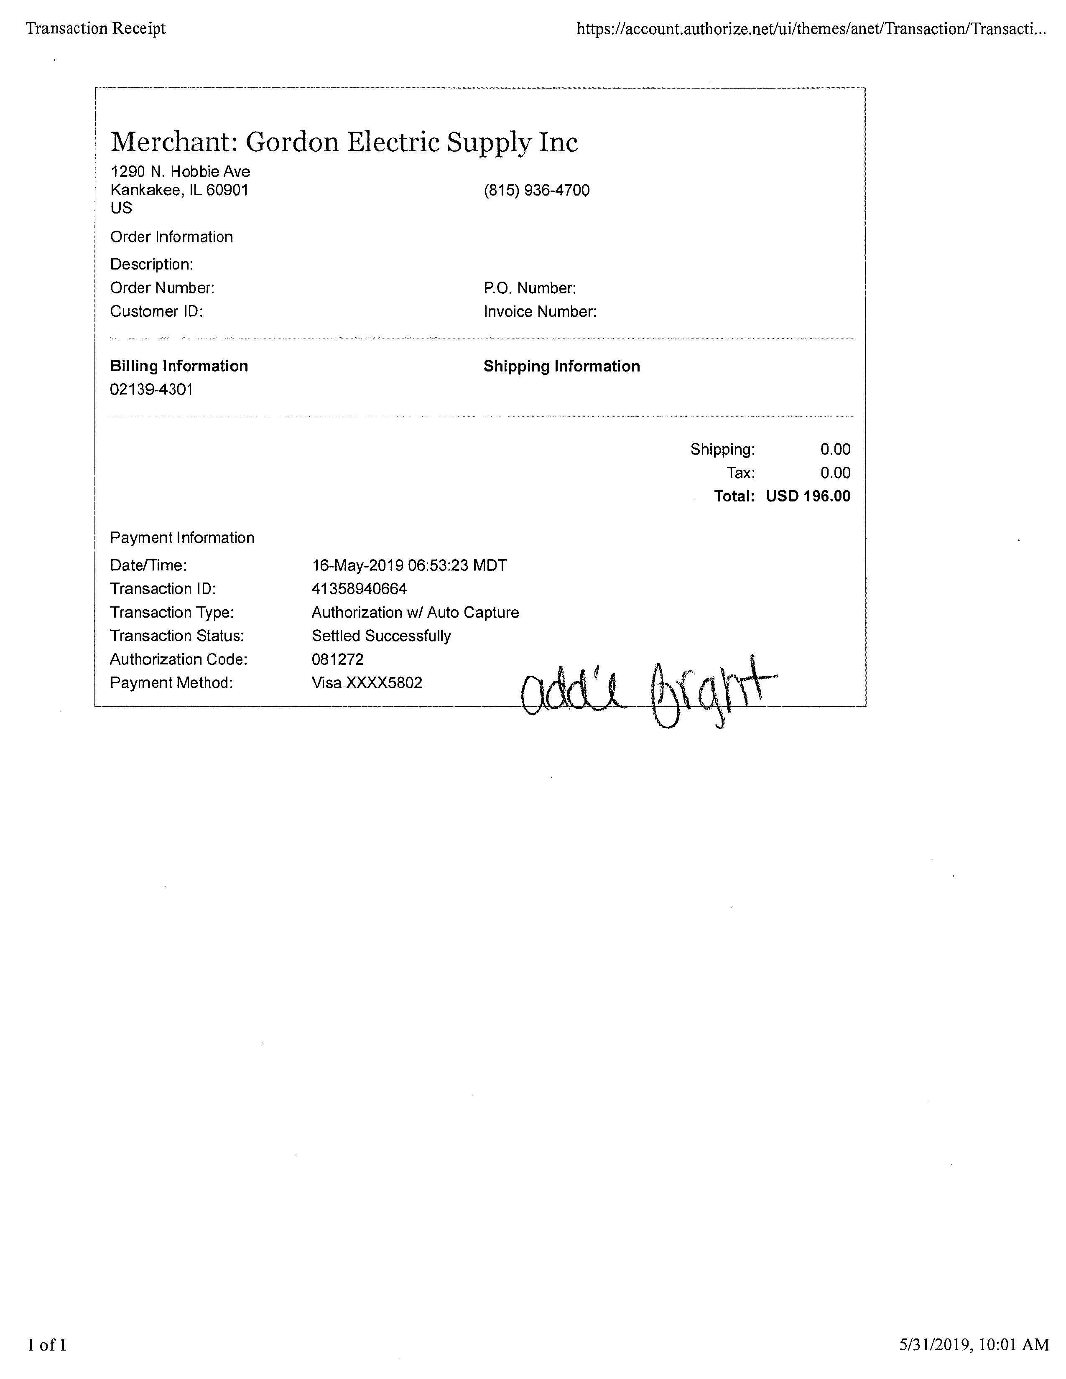
[picture p104: page 3]
