OpenAgricultureFoundation/openag-mechanical/prj/hazelnut_large/LHC-001/3-Specification Sheets/S1782449-0001_19021.pdf

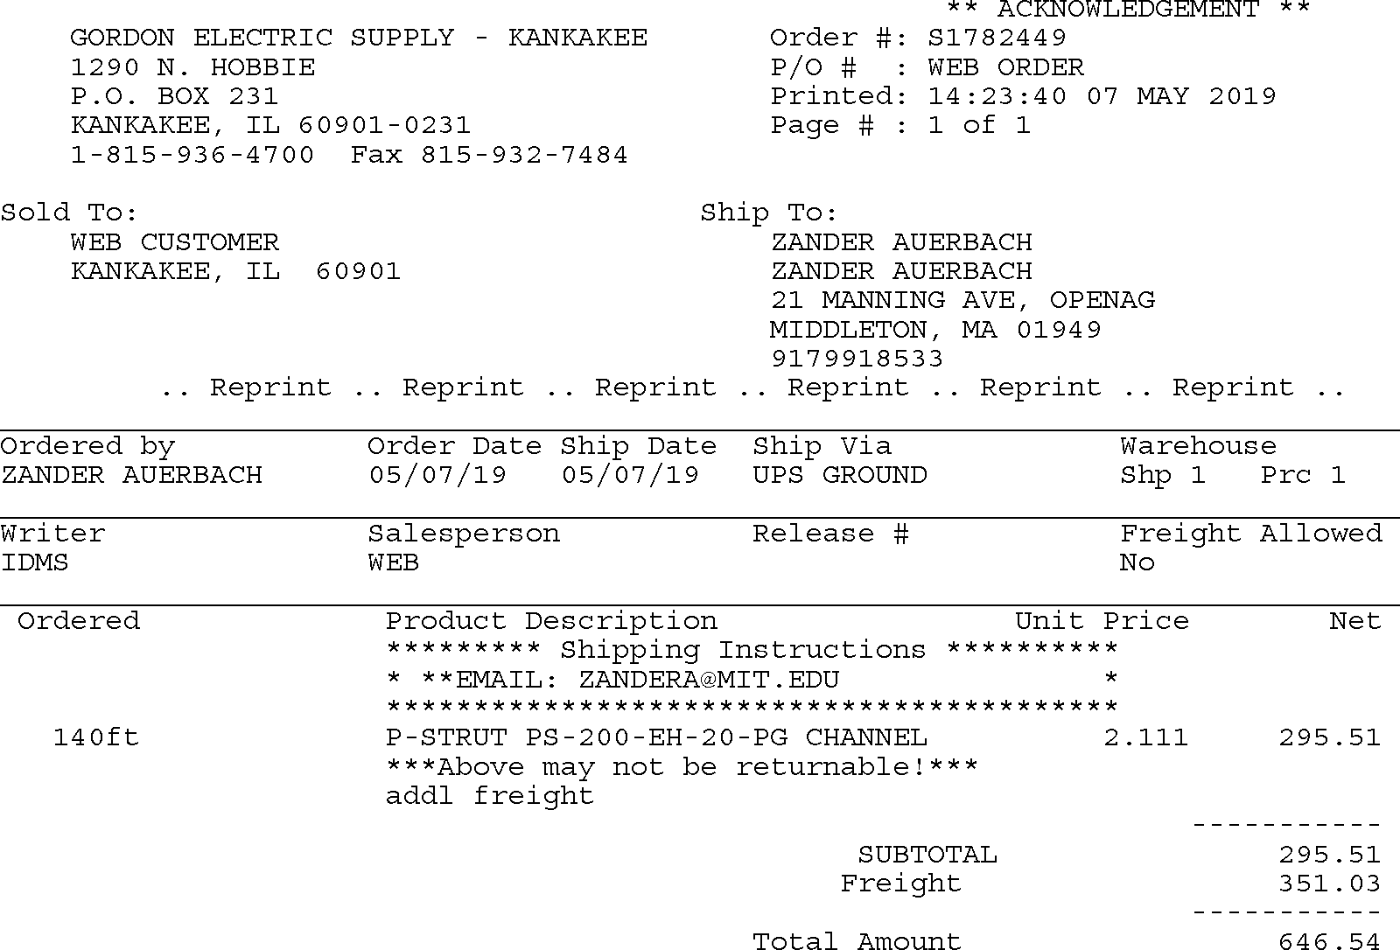
[picture p105: figure]
