OpenAgricultureFoundation/openag-mechanical/prj/hazelnut_large/LHC-001/1-Documentation/2019-9-11 LED Strut Redesign Sketches/9-11-19 Strut Redesign Overlays-top.pdf

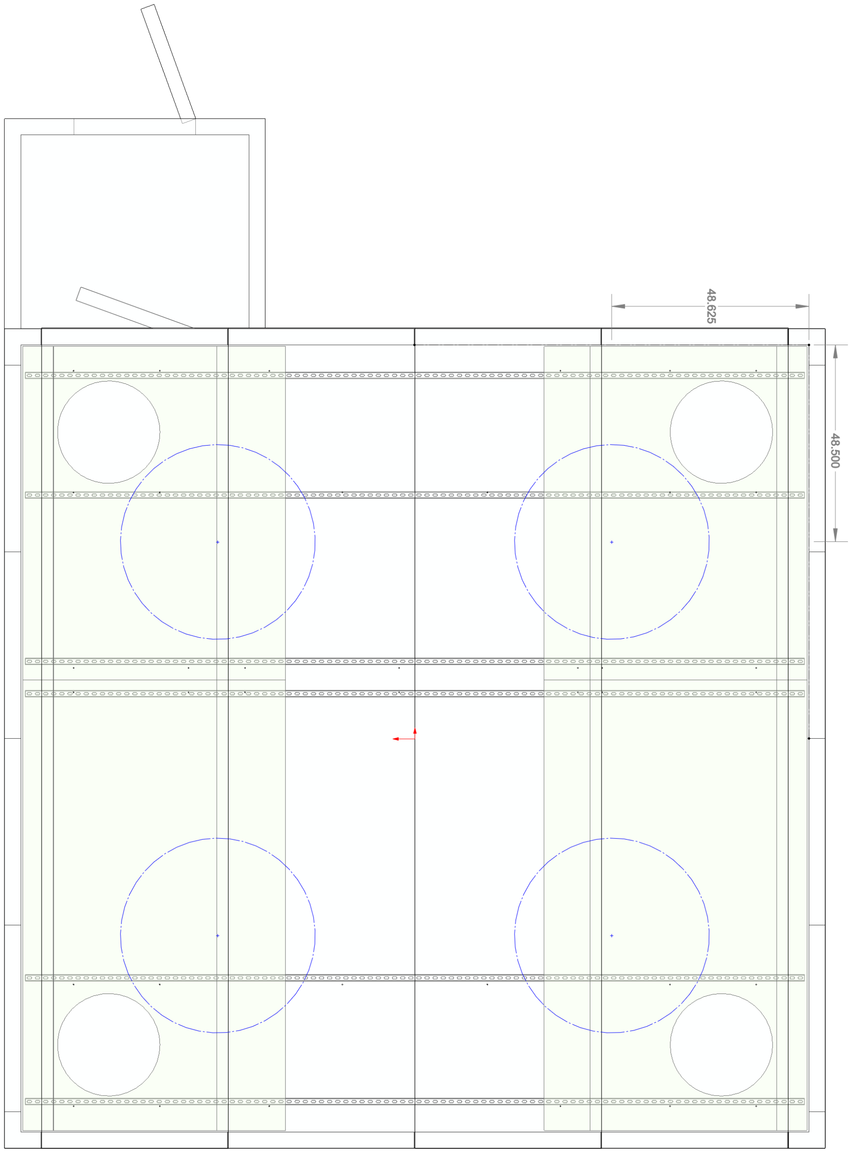
[picture p106: page 1]
