OpenAgricultureFoundation/openag-mechanical/prj/hazelnut_large/LHC-001/3-Specification Sheets/other/C01630G00610012.pdf

Create Your Individual 3D PDF Datasheet (http://www.cadenas.de/electronic-productcatalog/3d-pdf-data-sheet)

Learn How to Create Your
Mechanical Product Catalog (http://www.cadenas.de/electronic-productcatalog/motivation)

Learn How to Create Your BIM Product Catalog (http://www.cadenas.de/en/products/electronic-productcatalog/vertical-marketplaces/bimcatalogs.net)

Reduce Your Costs in
Engineering and Purchasing (http://www.cadenas.de/strategic-partsmanagement/motivation)

# 3D View

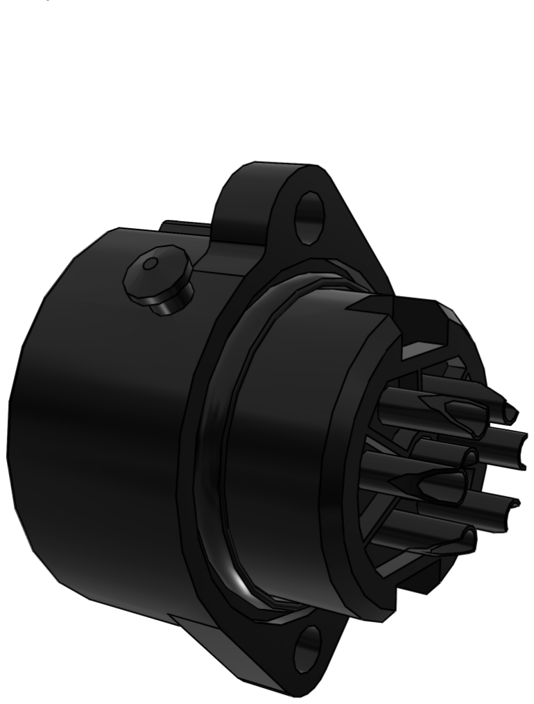
[picture p107: figure]

Create Your Individual 3D PDF Datasheet - www.cadenas.de (http://www.cadenas.de/en/contact/form) | Datasheet creation date: 14/03/2019 17:11

C01630G00610012

### Standard Female Receptacle - 6 Position, with Contacts

Moves the model vertically and horizontally only. You can also pan with the hand tool: Ctrl-drag.

Turns 3D objects around relative to the screen. How the objects move depends on the starting view, where you start dragging and the direction in which you drag.

Moves you toward or away from objects in the scene when you drag vertically. You can
also zoom with the hand tool by holding down
Shift as you drag.
Zoom | Pan | Rotate

To activate the interactive 3D view, you must trust this document (see hint on the top) in Adobe Acrobat and click on the question mark.

C01630G00610012

### Standard Female Receptacle - 6 Position, with Contacts

Create Your Individual 3D PDF Datasheet (http://www.cadenas.de/electronic-productcatalog/3d-pdf-data-sheet)

Learn How to Create Your
Mechanical Product Catalog (http://www.cadenas.de/electronic-productcatalog/motivation)

Learn How to Create Your BIM Product Catalog (http://www.cadenas.de/en/products/electronic-productcatalog/vertical-marketplaces/bimcatalogs.net)

Reduce Your Costs in
Engineering and Purchasing (http://www.cadenas.de/strategic-partsmanagement/motivation)
2D derivation | ISO View

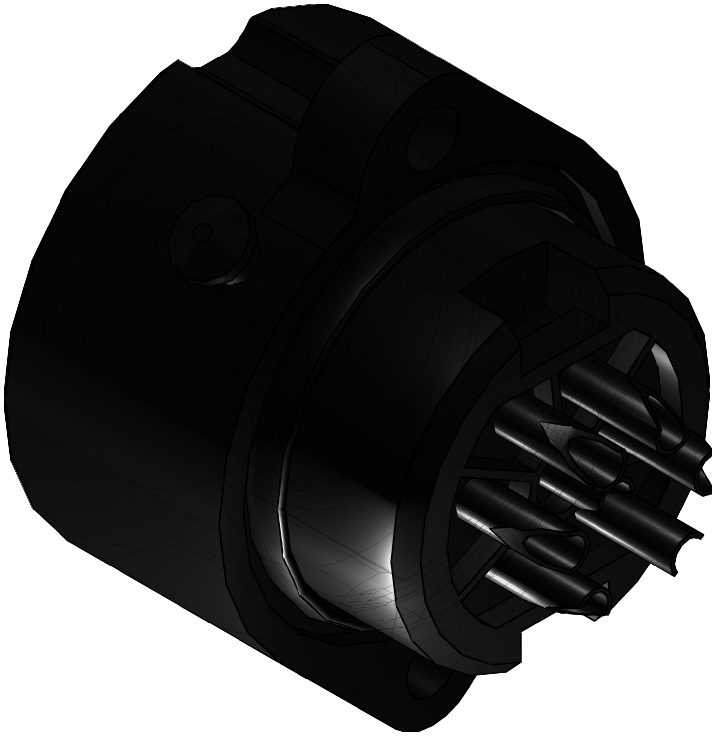
[picture p108: figure]
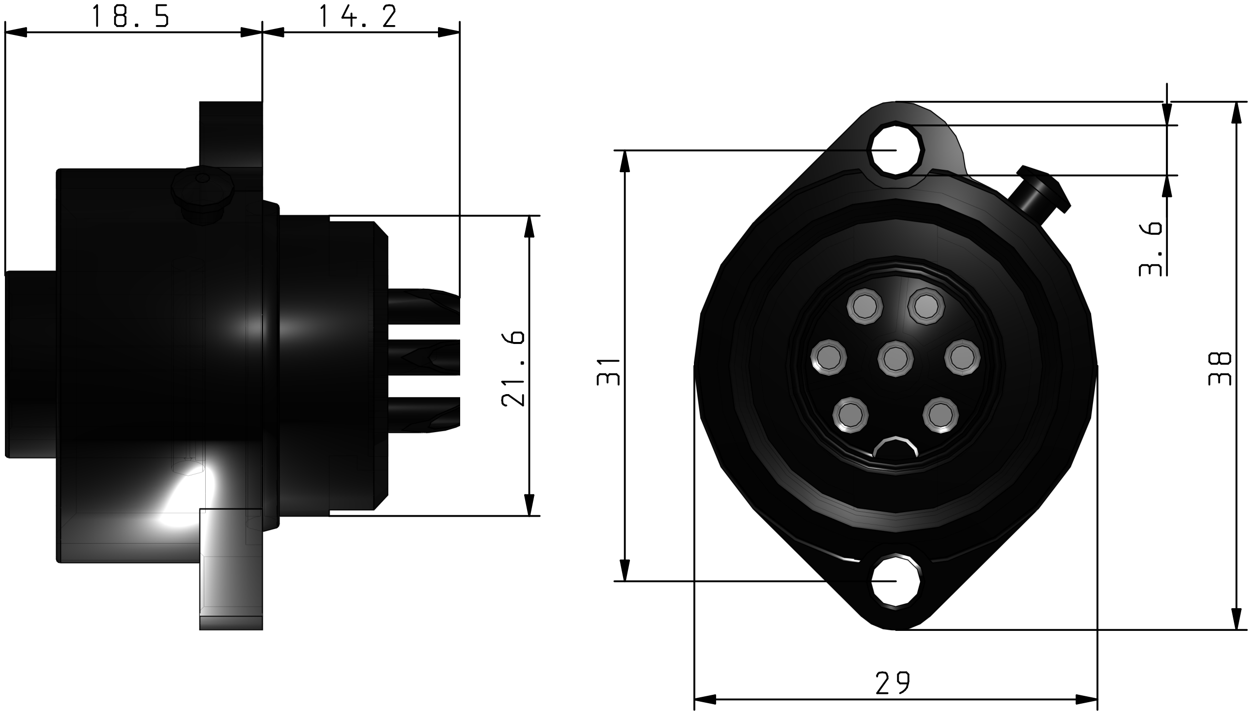
[picture p109: figure]
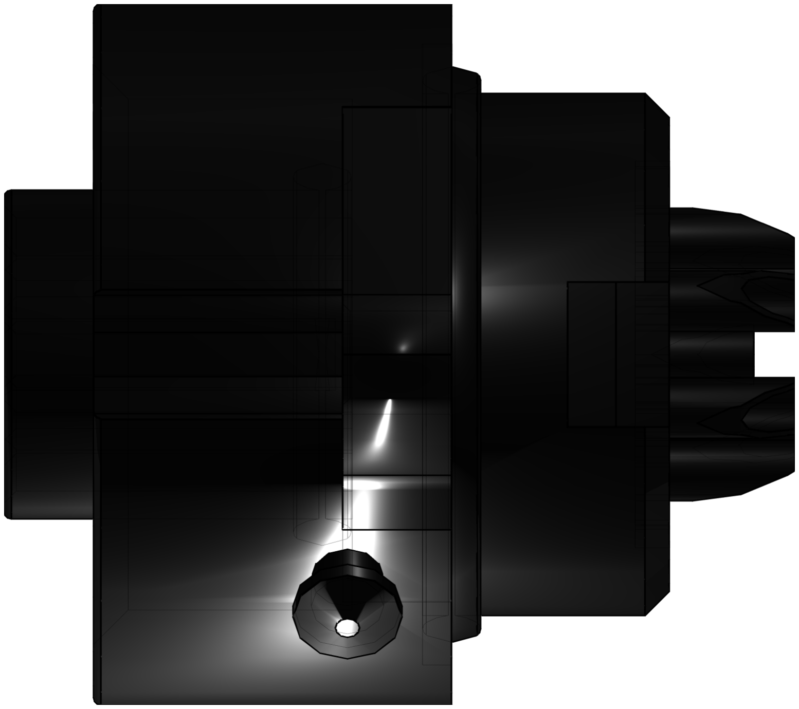
[picture p110: figure]

C01630G00610012

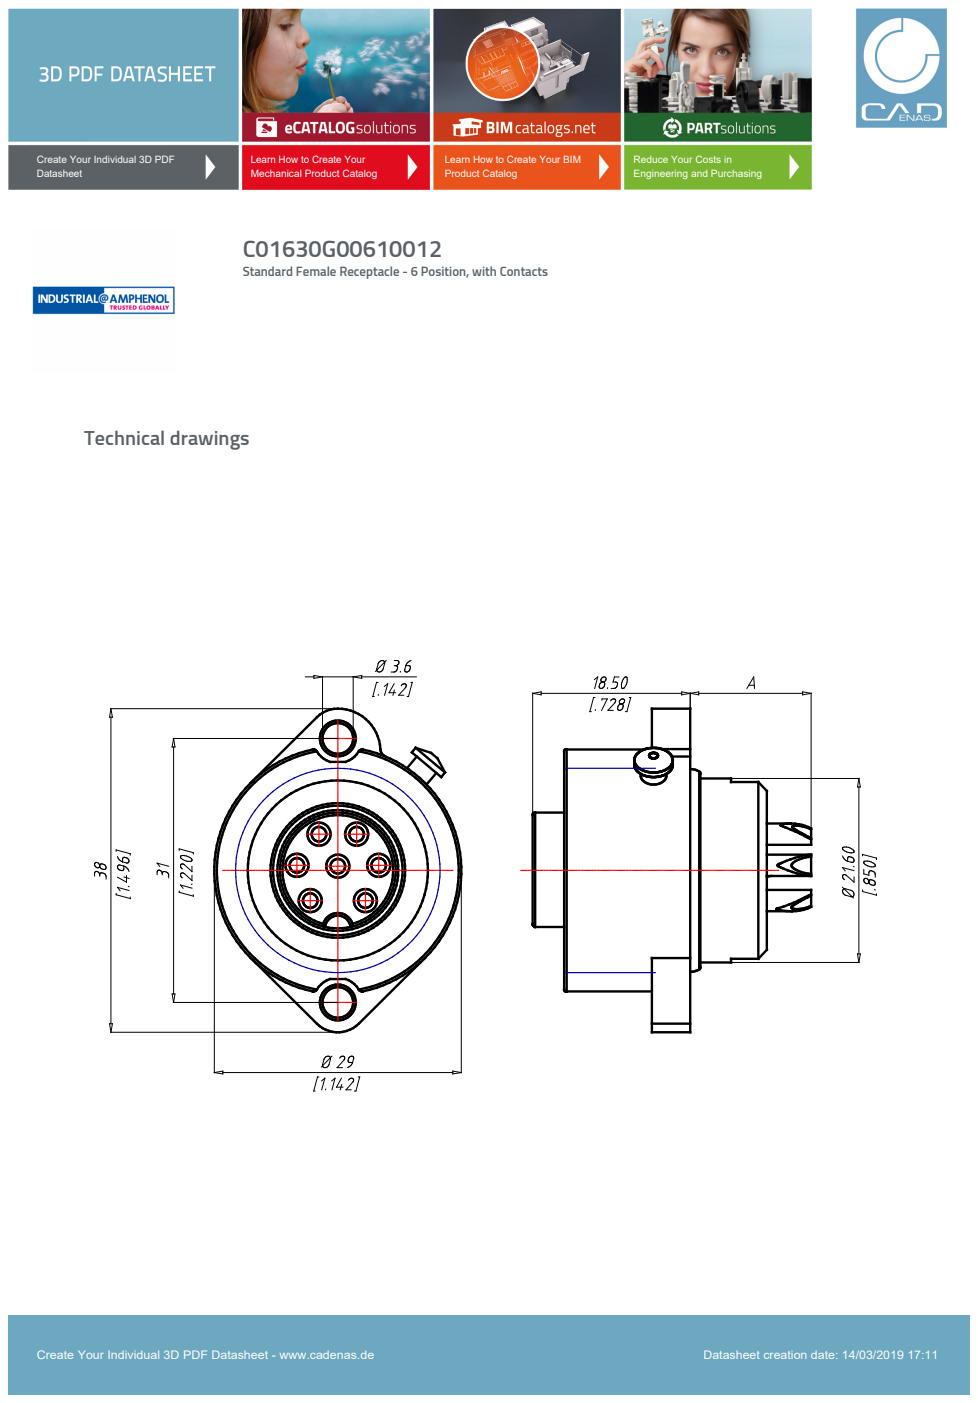
[picture p111: page 3]
Technical drawings

Create Your Individual 3D PDF
Datasheet (http://www.cadenas.de/electronic-productcatalog/3d-pdf-data-sheet)

Learn How to Create Your
Mechanical Product Catalog (http://www.cadenas.de/electronic-productcatalog/motivation)

Learn How to Create Your BIM
Product Catalog (http://www.cadenas.de/en/products/electronic-productcatalog/vertical-marketplaces/bimcatalogs.net)

Reduce Your Costs in
Engineering and Purchasing (http://www.cadenas.de/strategic-partsmanagement/motivation)

Standard Female Receptacle - 6 Position, with Contacts

PN (Part No.) | C01630G00610012
PL (Plating) | Silver
A (A / mm) | 14.2
INFO (More Product Information) | Link to Product Page

Create Your Individual 3D PDF Datasheet (http://www.cadenas.de/electronic-productcatalog/3d-pdf-data-sheet)

C01630G00610012

### Standard Female Receptacle - 6 Position, with Contacts

Learn How to Create Your
Mechanical Product Catalog (http://www.cadenas.de/electronic-productcatalog/motivation)

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

Reduce Your Costs in
Engineering and Purchasing (http://www.cadenas.de/strategic-partsmanagement/motivation)

# Technical Data

# Bill of Materials

N° | Description | Amount
1.1 | C01630G00610012 | 1

Create Your Individual 3D PDF Datasheet (http://www.cadenas.de/electronic-productcatalog/3d-pdf-data-sheet)

Learn How to Create Your
Mechanical Product Catalog (http://www.cadenas.de/electronic-productcatalog/motivation)

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

Reduce Your Costs in
Engineering and Purchasing (http://www.cadenas.de/strategic-partsmanagement/motivation)

C01630G00610012

### Standard Female Receptacle - 6 Position, with Contacts
