OpenAgricultureFoundation/openag-mechanical/prj/hazelnut_large/LHC-001/2-RFQs/2019-3-19_Profab_Quote.pdf

## MIT

00014623

03/19/2019

FOB DEFAULT

1-2 WEEKS

COD

MARK BECKETT

EUGENE ZELENY

Inquiry Date :

FOB :

Delivery :

Terms :

Sales Person :

Buyer :

Letter :

To:

This quote is valid for | : | 30 Days
Ship VIA : | | OUR TRUCK

# PROFAB METAL PRODUCTS

Zip Code:

541 CHESTNUT ST.
LYNN, MA 01904
PHONE 781-599-8500 FAX 781-599-1210 E-mail: GSellers@Profab-Metal.com

1

0029526

LHC-306 | 01
Item # : | Quote # :
P/N : | Rev :

Comment :

Quantity | Price Each | Extended Price

RFQ # :

Description
LHC ENCLOSURE | 10 | $38.50 | $385.00
| 50 | $30.00 | $1,500.00
By: | 03/20/2019 | Page | 1
