OpenAgricultureFoundation/openag-mechanical/prj/fermentabot/FMT201/For Reference/Fermentabot Spending Log (mechanical engineering only, for reference only).xlsx

PO | $
259578 | $87.83
253686 | $141.77
252616 | $297.08
247420 | $77.95
245127 | $170.73
245125 | $34.29
242080 | $39.86
234549 | $38.08
234460 | $76.11
224325 | $170.88
218319 | $138.57
216038 | $123.75
113-8821832-5289029 | $83.94
113-7017502-1517045 | $384.54
113-2892651-1823451 | $25.99
113-5756364-0440201 | $25.06
113-5514039-2855417 | $44.50
the first catering box? | $200.00
TOTAL PURCHASES: | $2160.93
Hours Worked (Eugene) | 187
TOTAL LABOR: | $5610.00
TOTAL BUDGET SPENT ON FERMENTABOT: | $7770.93
