OpenAgricultureFoundation/openag-mechanical/prj/fs-rack/v1.0/README.md

# server_rack
models and files for Food Server™ hydroponic rack system
