OpenAgricultureFoundation/openag-mechanical/prj/container 3 rack v2/hanging-fan/2018-9-11 Documentation/IMG_9427.JPG

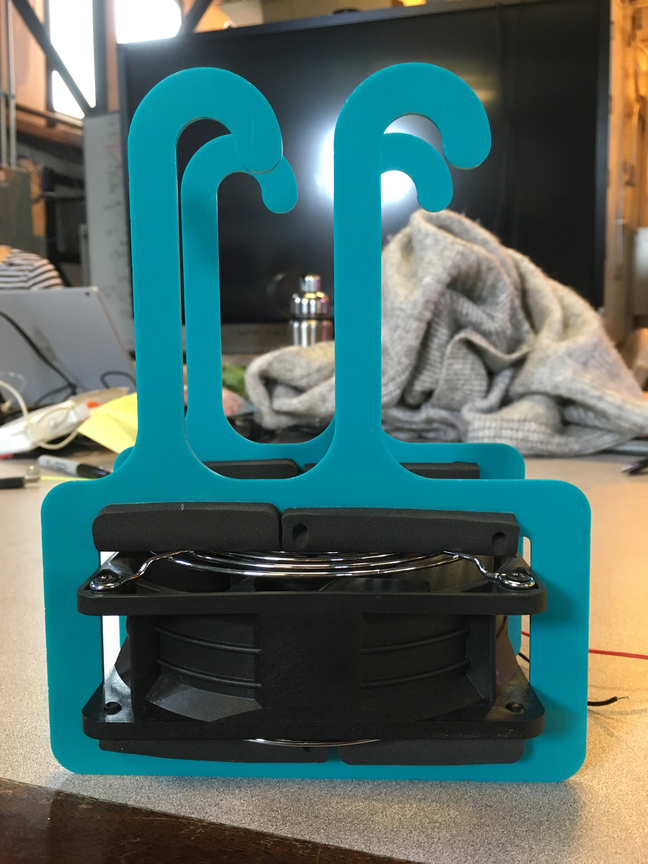
prj/container 3 rack v2/hanging-fan/2018-9-11 Documentation/IMG_9427.JPG
