OpenAgricultureFoundation/openag-mechanical/prj/container 3 rack v2/IMG_3295.JPG

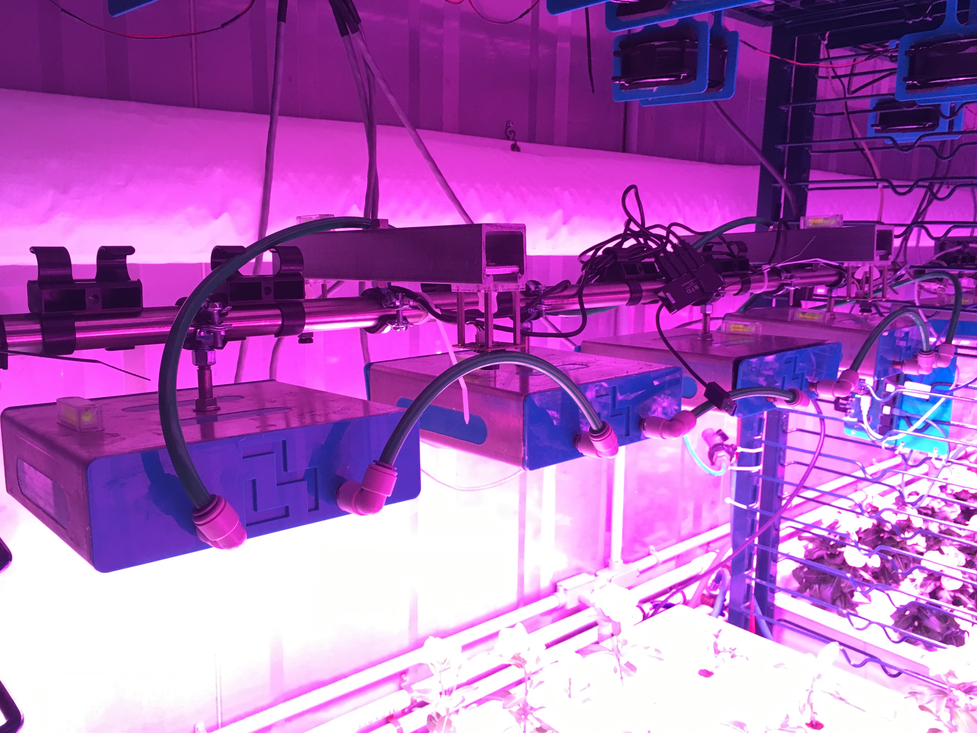
prj/container 3 rack v2/IMG_3295.JPG
