OpenAgricultureFoundation/openag-mechanical/prj/fermentabot/10-31-18 Progress Update Documentation/IMG_9802.JPG

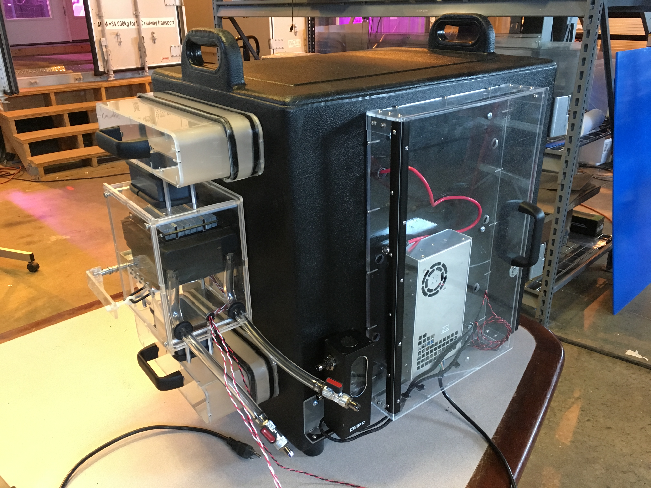
prj/fermentabot/10-31-18 Progress Update Documentation/IMG_9802.JPG
