OpenAgricultureFoundation/openag-mechanical/prj/fermentabot/FMT201/Fermentabot Image Documentation/2018.10.24 REV 1.1 Members Week Photoshoot/IMG_9810.JPG

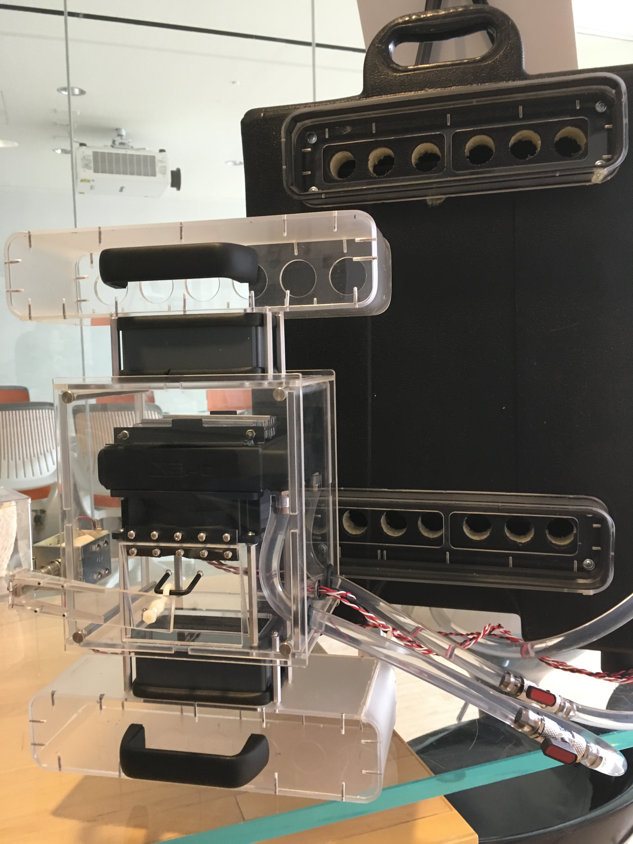
prj/fermentabot/FMT201/Fermentabot Image Documentation/2018.10.24 REV 1.1 Members Week Photoshoot/IMG_9810.JPG
