OpenAgricultureFoundation/openag-mechanical/prj/fermentabot/FMT201/Fermentabot Image Documentation/2018.12.06 REV 1.1 Photoshoot/IMG_0162.jpeg

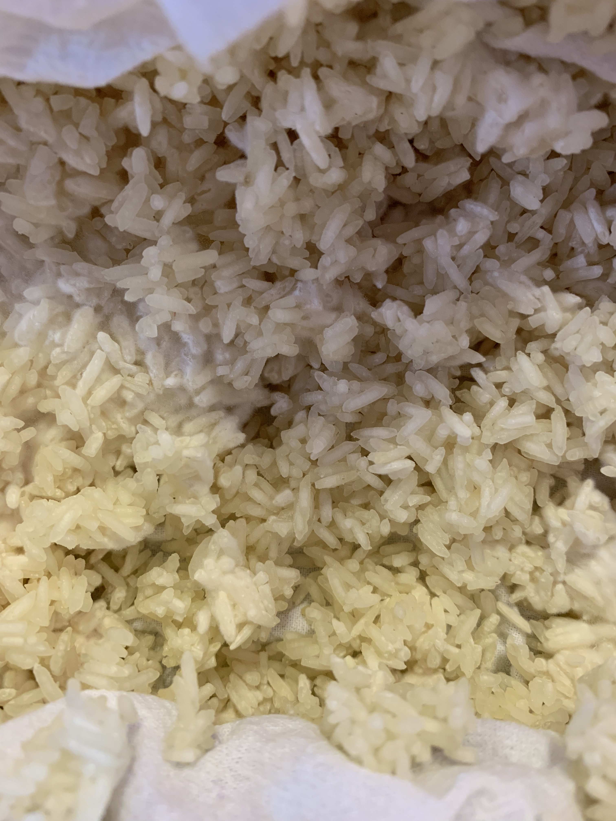
prj/fermentabot/FMT201/Fermentabot Image Documentation/2018.12.06 REV 1.1 Photoshoot/IMG_0162.jpeg
