OpenAgricultureFoundation/openag-mechanical/prj/fermentabot/FMT201/Fermentabot Image Documentation/2018.12.13 REV 1.1 Photoshoot/IMG_0311.JPG

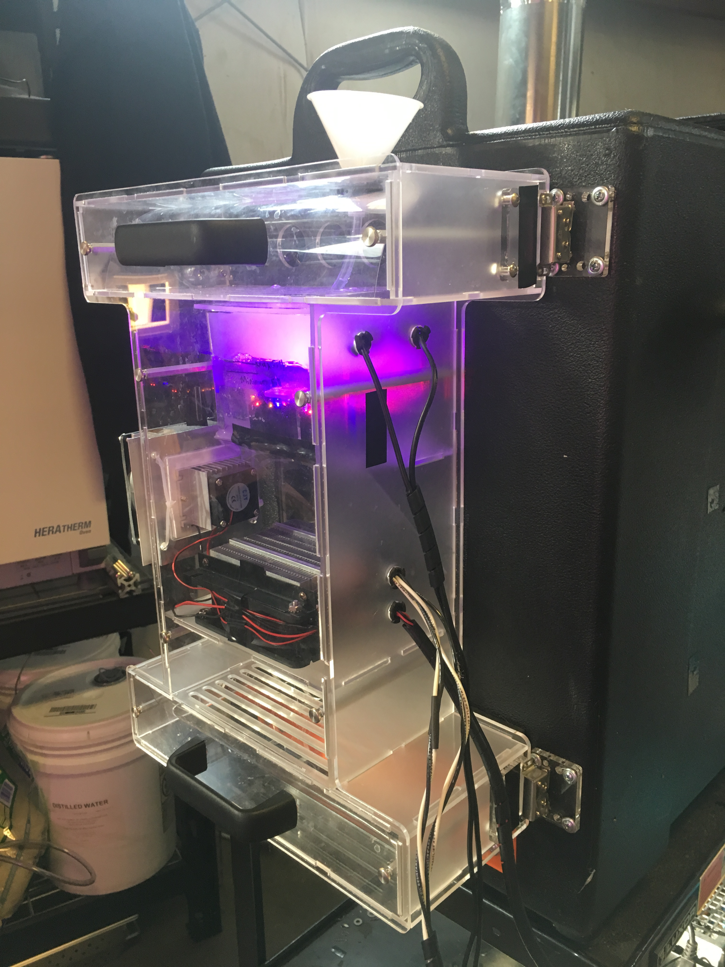
prj/fermentabot/FMT201/Fermentabot Image Documentation/2018.12.13 REV 1.1 Photoshoot/IMG_0311.JPG
