OpenAgricultureFoundation/openag-mechanical/prj/fermentabot/FMT201/Fermentabot Image Documentation/2018.12.26 REV 2.0 Renderings/Fermentabot Rendering 4 12-26-18.jpg

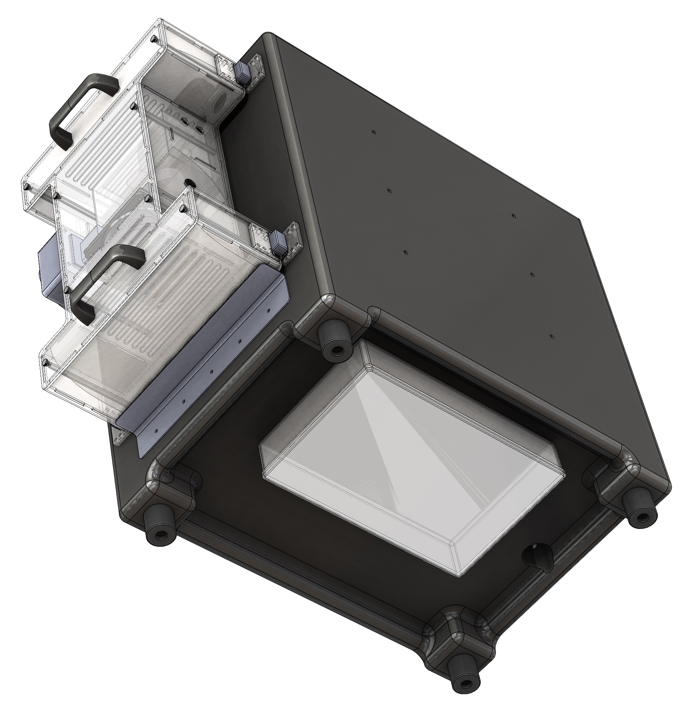
prj/fermentabot/FMT201/Fermentabot Image Documentation/2018.12.26 REV 2.0 Renderings/Fermentabot Rendering 4 12-26-18.jpg
