OpenAgricultureFoundation/openag-mechanical/prj/fermentabot/FMT201/Fermentabot Image Documentation/2019.01.25 REV 2.0 Photoshoot/IMG_0369.JPG

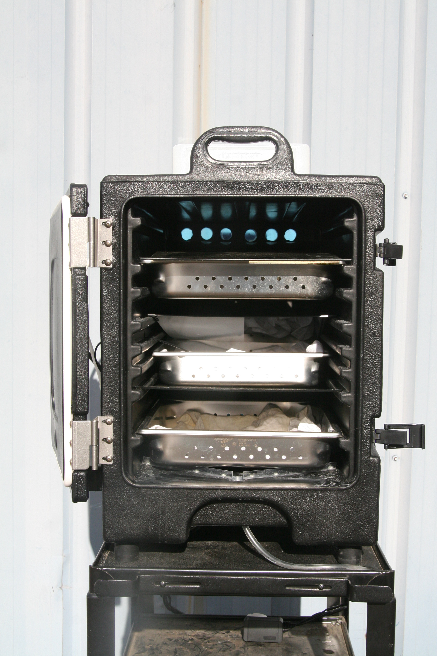
prj/fermentabot/FMT201/Fermentabot Image Documentation/2019.01.25 REV 2.0 Photoshoot/IMG_0369.JPG
