OpenAgricultureFoundation/openag-mechanical/prj/fermentabot/FMT201/Fermentabot Image Documentation/2019.02.06 Koji Batch/Tray 3 (4).JPG

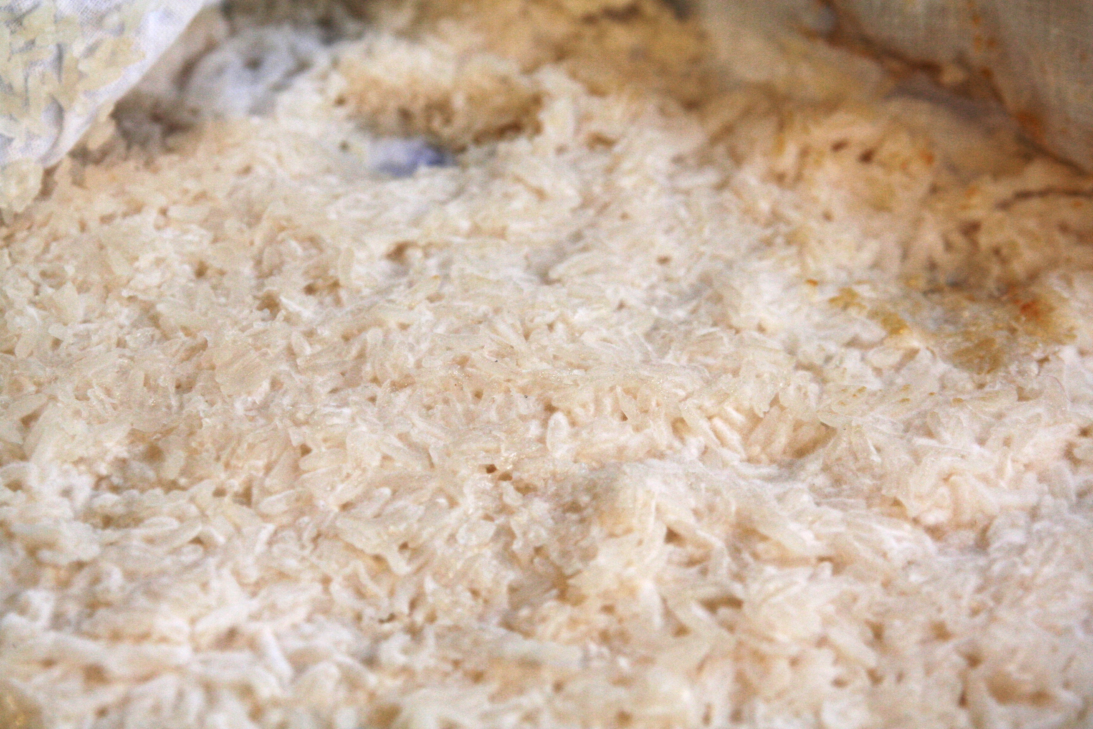
prj/fermentabot/FMT201/Fermentabot Image Documentation/2019.02.06 Koji Batch/Tray 3 (4).JPG
