OpenAgricultureFoundation/openag-mechanical/prj/fermentabot/FMT201/Fermentabot Image Documentation/2019.3.12 REV 2.1 Photoshoot/IMG_0417.JPG

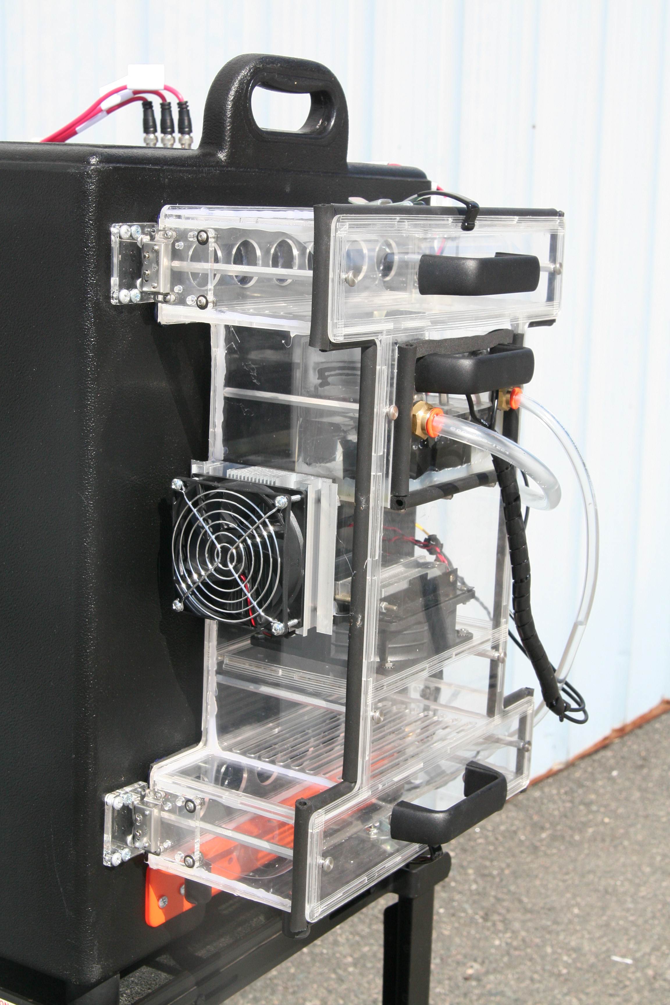
prj/fermentabot/FMT201/Fermentabot Image Documentation/2019.3.12 REV 2.1 Photoshoot/IMG_0417.JPG
