OpenAgricultureFoundation/openag-mechanical/prj/germinator v3/8-1-18 Prototype Documentation/GMR001 Flow simulation.jpg

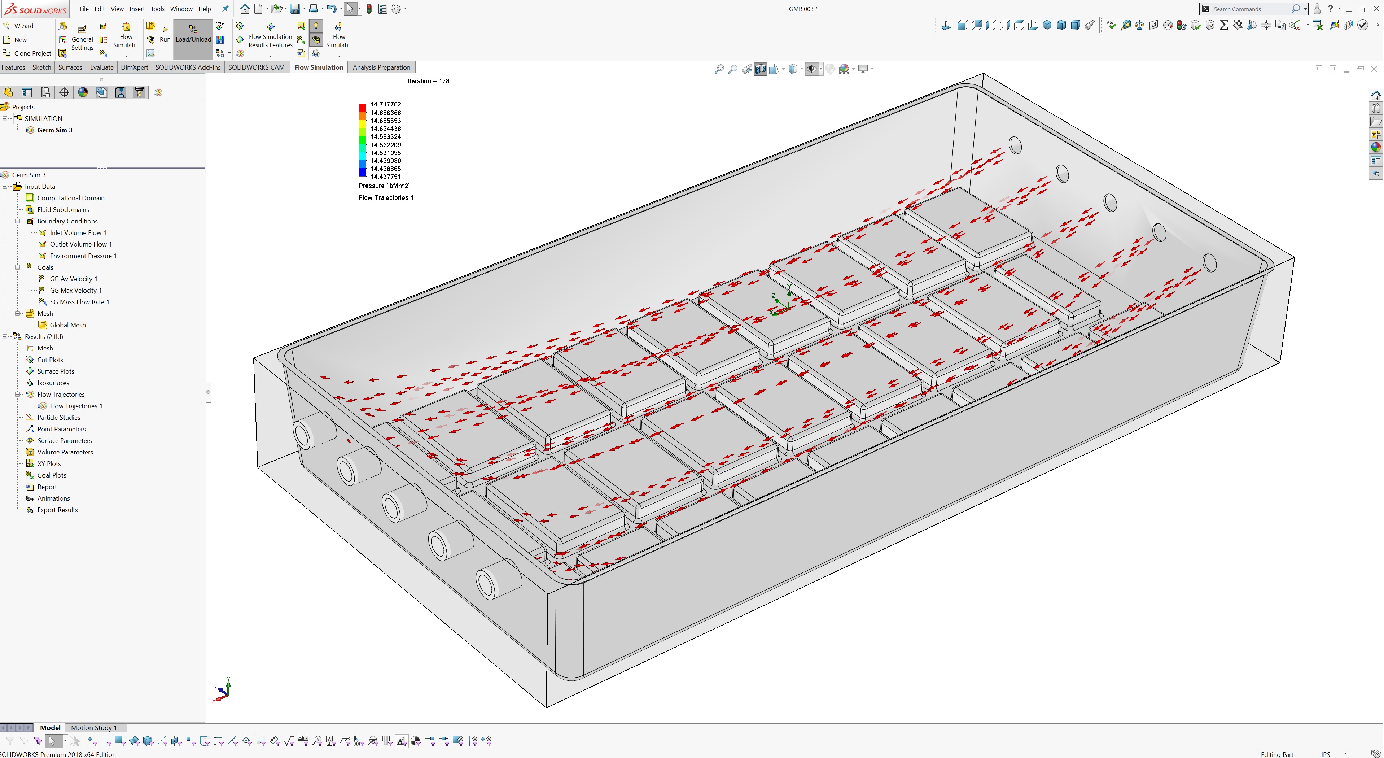
prj/germinator v3/8-1-18 Prototype Documentation/GMR001 Flow simulation.jpg
