OpenAgricultureFoundation/openag-mechanical/prj/germinator v3/8-1-18 Prototype Documentation/IMG_8914.JPG

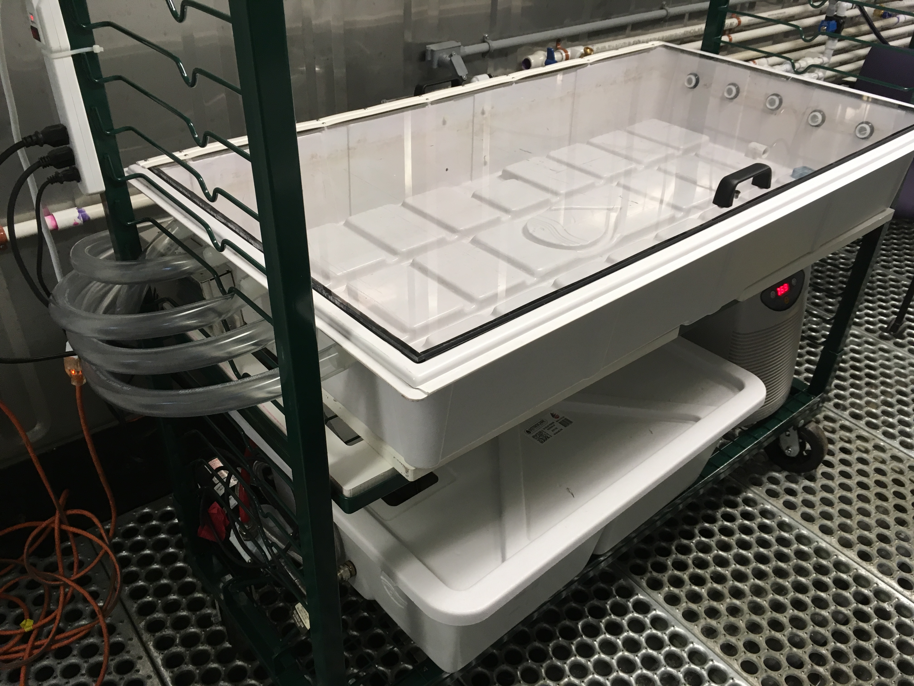
prj/germinator v3/8-1-18 Prototype Documentation/IMG_8914.JPG
