OpenAgricultureFoundation/openag-mechanical/prj/germinator v3/8-1-18 Prototype Documentation/IMG_8916.JPG

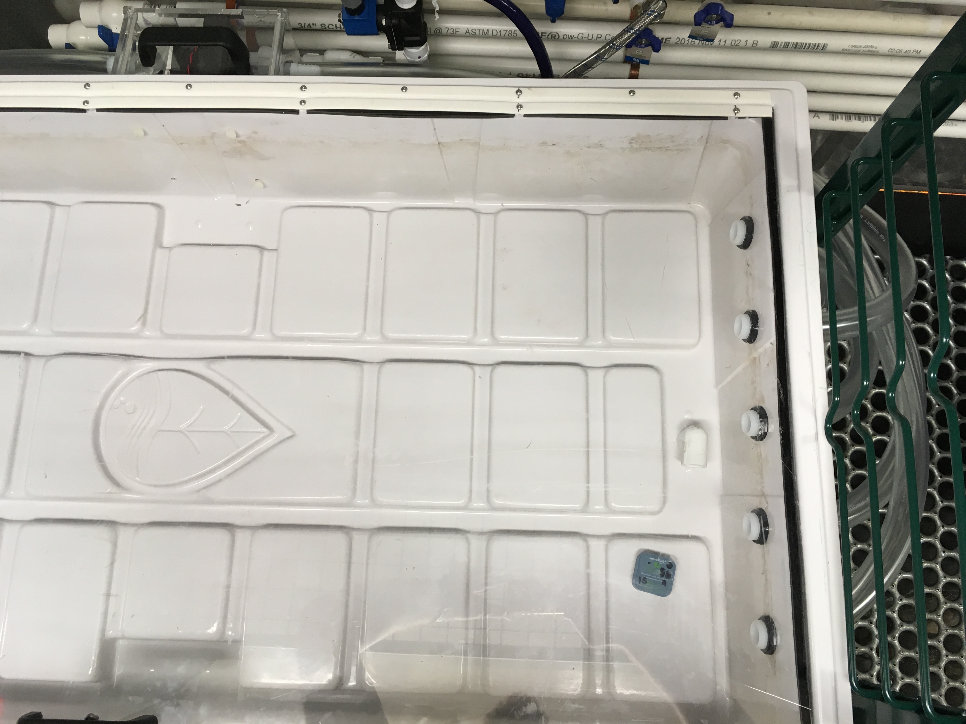
prj/germinator v3/8-1-18 Prototype Documentation/IMG_8916.JPG
