OpenAgricultureFoundation/openag-mechanical/prj/hazelnut_large/LHC-001/1-Documentation/2018-2019 Large Tree Computer - Superceded Designs and Documentation/2018-6-20 Screen Shots/LHC001 - 1.jpg

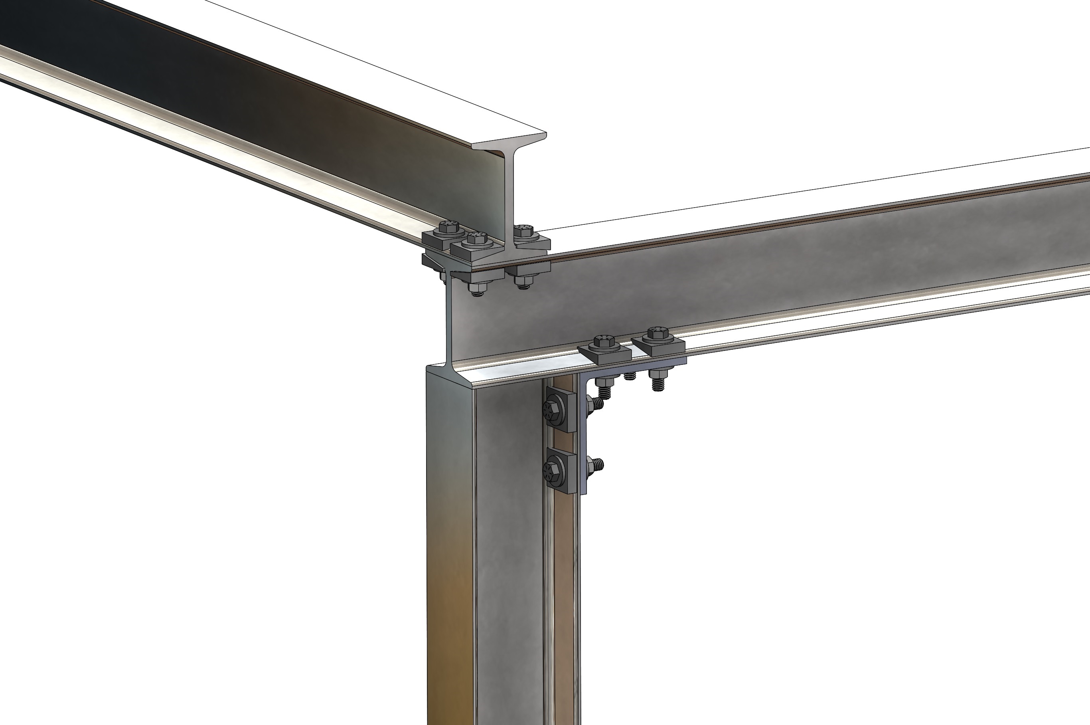
prj/hazelnut_large/LHC-001/1-Documentation/2018-2019 Large Tree Computer - Superceded Designs and Documentation/2018-6-20 Screen Shots/LHC001 - 1.jpg
