OpenAgricultureFoundation/openag-mechanical/prj/hazelnut_large/LHC-001/1-Documentation/2018-2019 Large Tree Computer - Superceded Designs and Documentation/2018-06-20 Structural Simulations/lhc-101-Static 1-Displacement-Displacement1.jpg

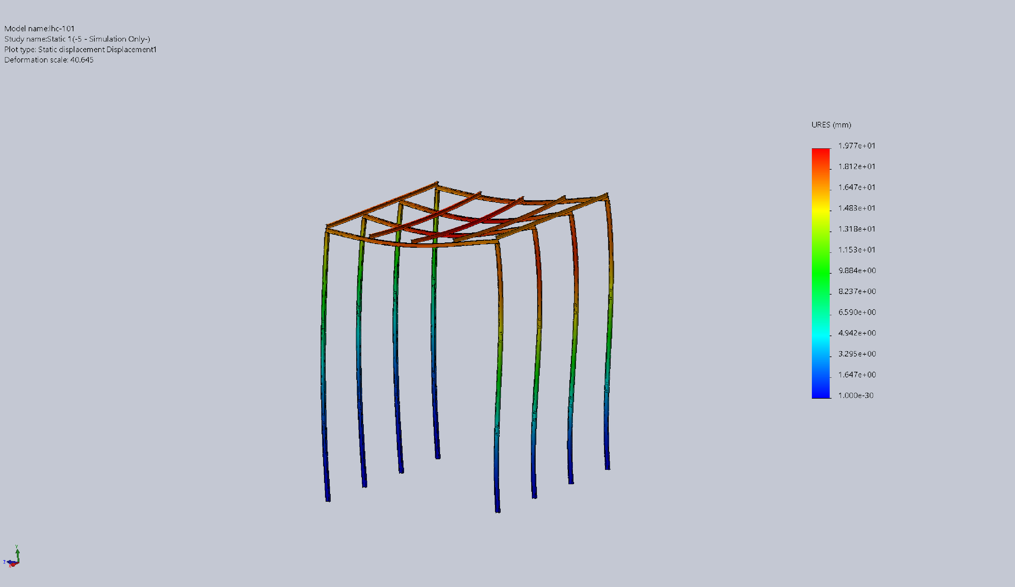
prj/hazelnut_large/LHC-001/1-Documentation/2018-2019 Large Tree Computer - Superceded Designs and Documentation/2018-06-20 Structural Simulations/lhc-101-Static 1-Displacement-Displacement1.jpg
