OpenAgricultureFoundation/openag-mechanical/prj/hazelnut_large/LHC-001/1-Documentation/2018-2019 Large Tree Computer - Superceded Designs and Documentation/2018-10-3 Outgoing to Ray McCabe/MIT_Media_Lab_OpenAg_3_LHC_10-3-18.jpg

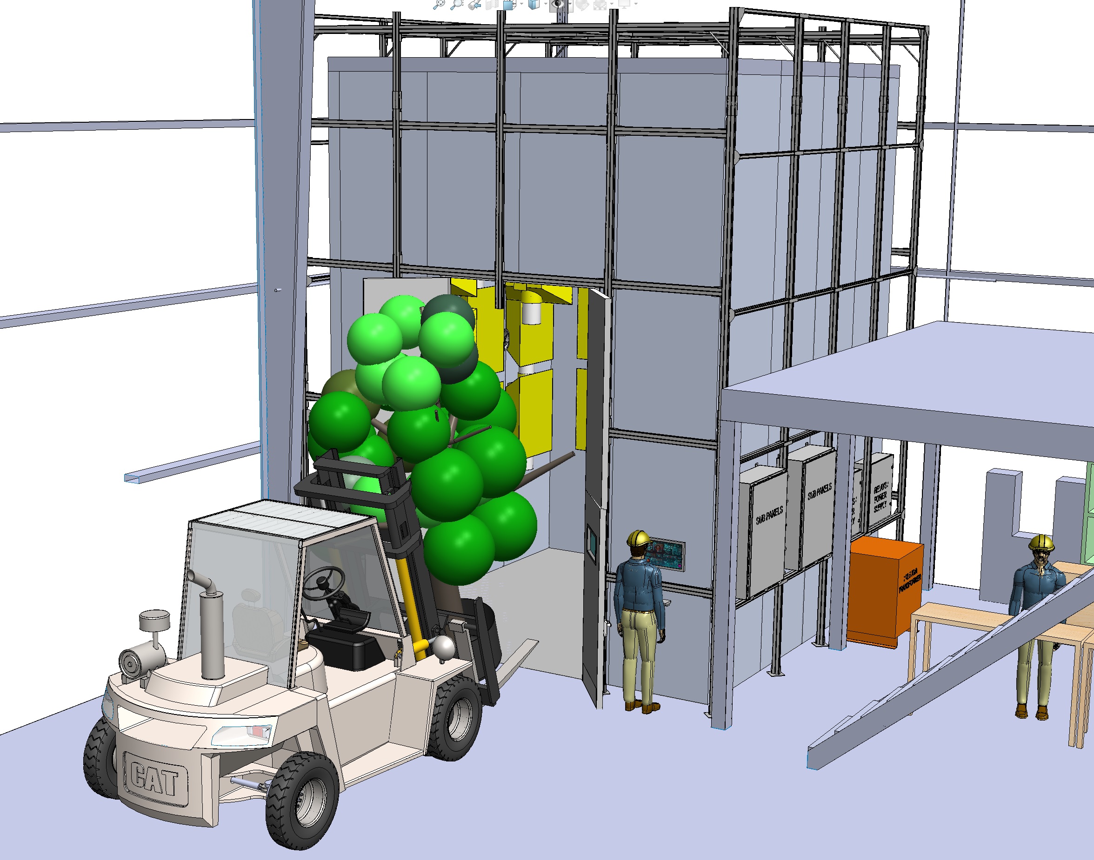
prj/hazelnut_large/LHC-001/1-Documentation/2018-2019 Large Tree Computer - Superceded Designs and Documentation/2018-10-3 Outgoing to Ray McCabe/MIT_Media_Lab_OpenAg_3_LHC_10-3-18.jpg
