OpenAgricultureFoundation/openag-mechanical/prj/hazelnut_large/LHC-001/1-Documentation/2018-2019 Large Tree Computer - Superceded Designs and Documentation/2018- Warehouse Renders/6-20-18 MIT Media Lab RFQ Warehouse Detail.jpg

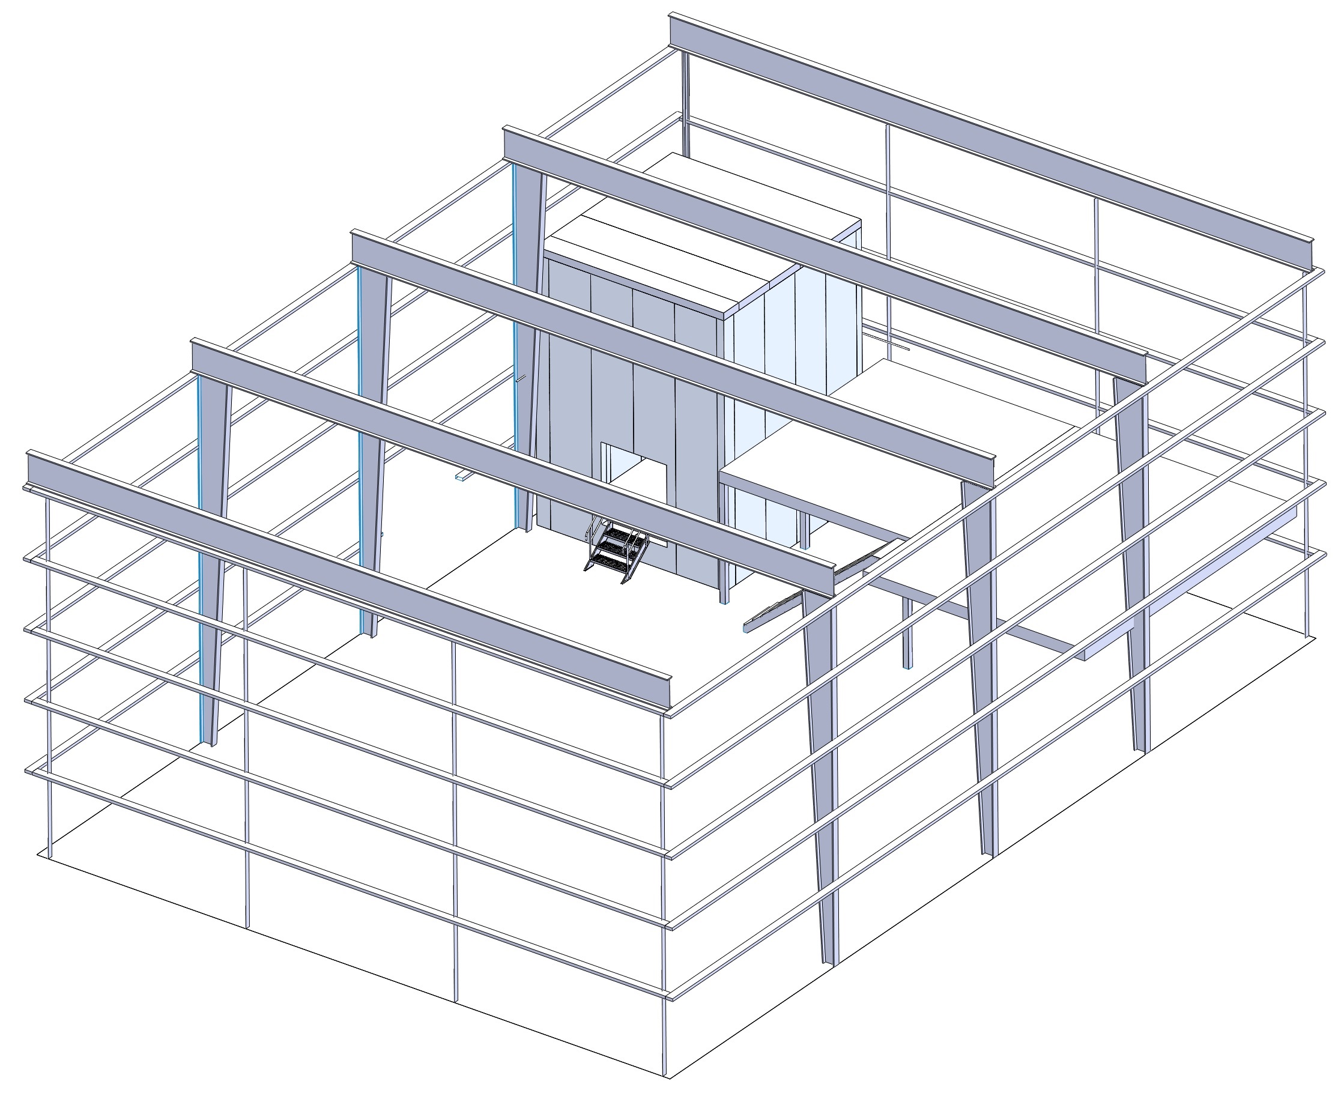
prj/hazelnut_large/LHC-001/1-Documentation/2018-2019 Large Tree Computer - Superceded Designs and Documentation/2018- Warehouse Renders/6-20-18 MIT Media Lab RFQ Warehouse Detail.jpg
