OpenAgricultureFoundation/openag-mechanical/prj/hazelnut_large/LHC-001/1-Documentation/2018-2019 Large Tree Computer - Superceded Designs and Documentation/2019-2-14 LHC in Warehouse/2019_2_14_Bates_Warehouse.jpg

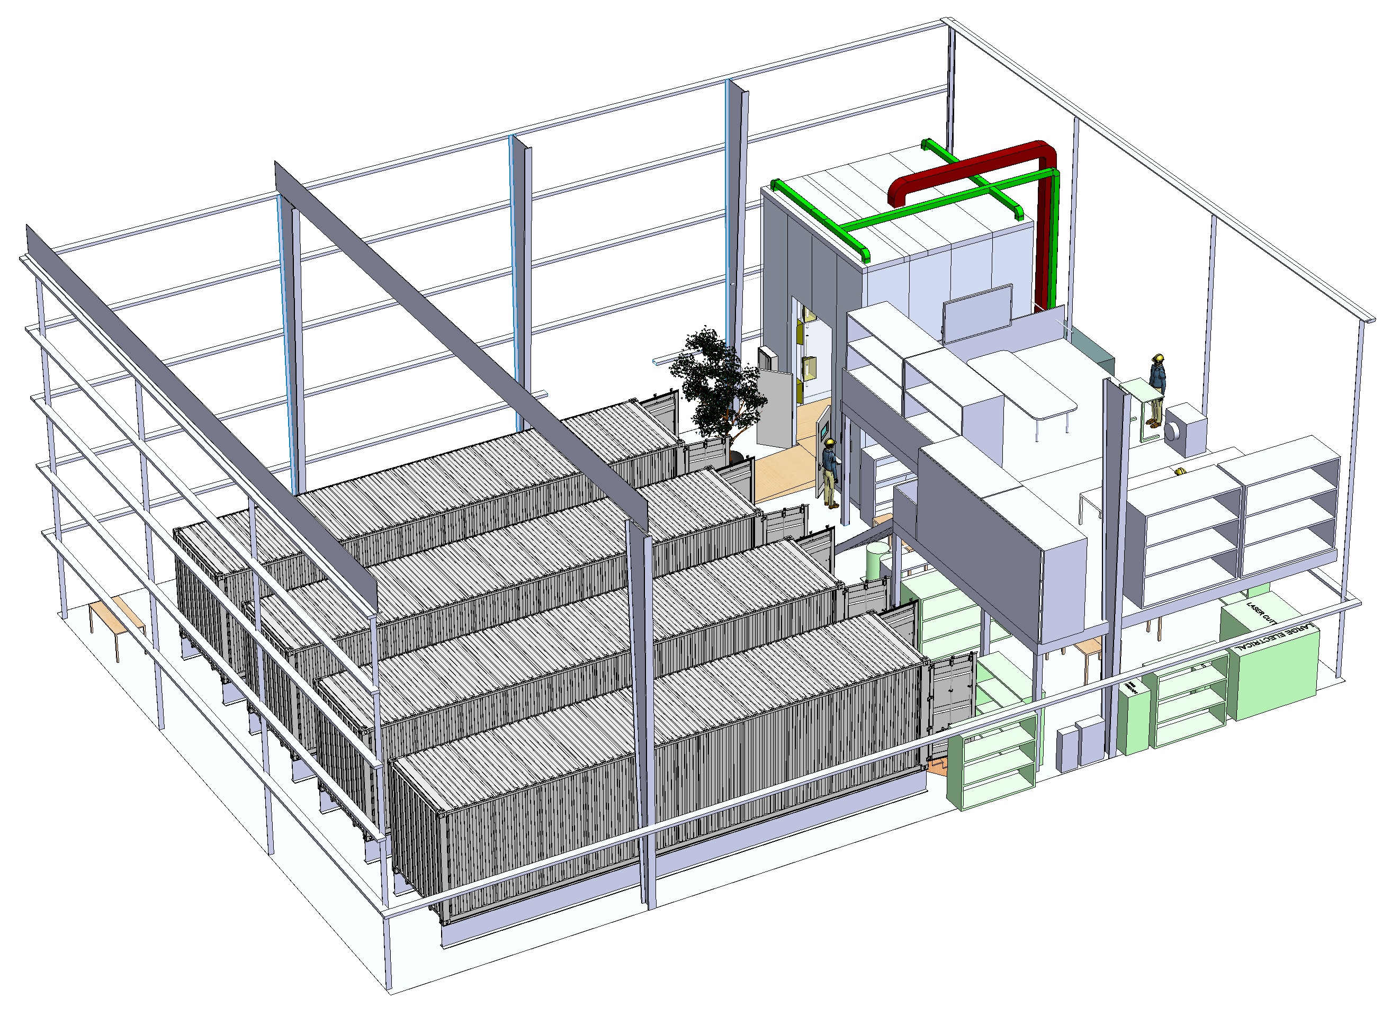
prj/hazelnut_large/LHC-001/1-Documentation/2018-2019 Large Tree Computer - Superceded Designs and Documentation/2019-2-14 LHC in Warehouse/2019_2_14_Bates_Warehouse.jpg
