OpenAgricultureFoundation/openag-mechanical/prj/hazelnut_large/LHC-001/1-Documentation/2018-2019 Large Tree Computer - Superceded Designs and Documentation/2019-2-25 12-inch 3-Optic Light design/LHC-301_WEIGHT.jpg

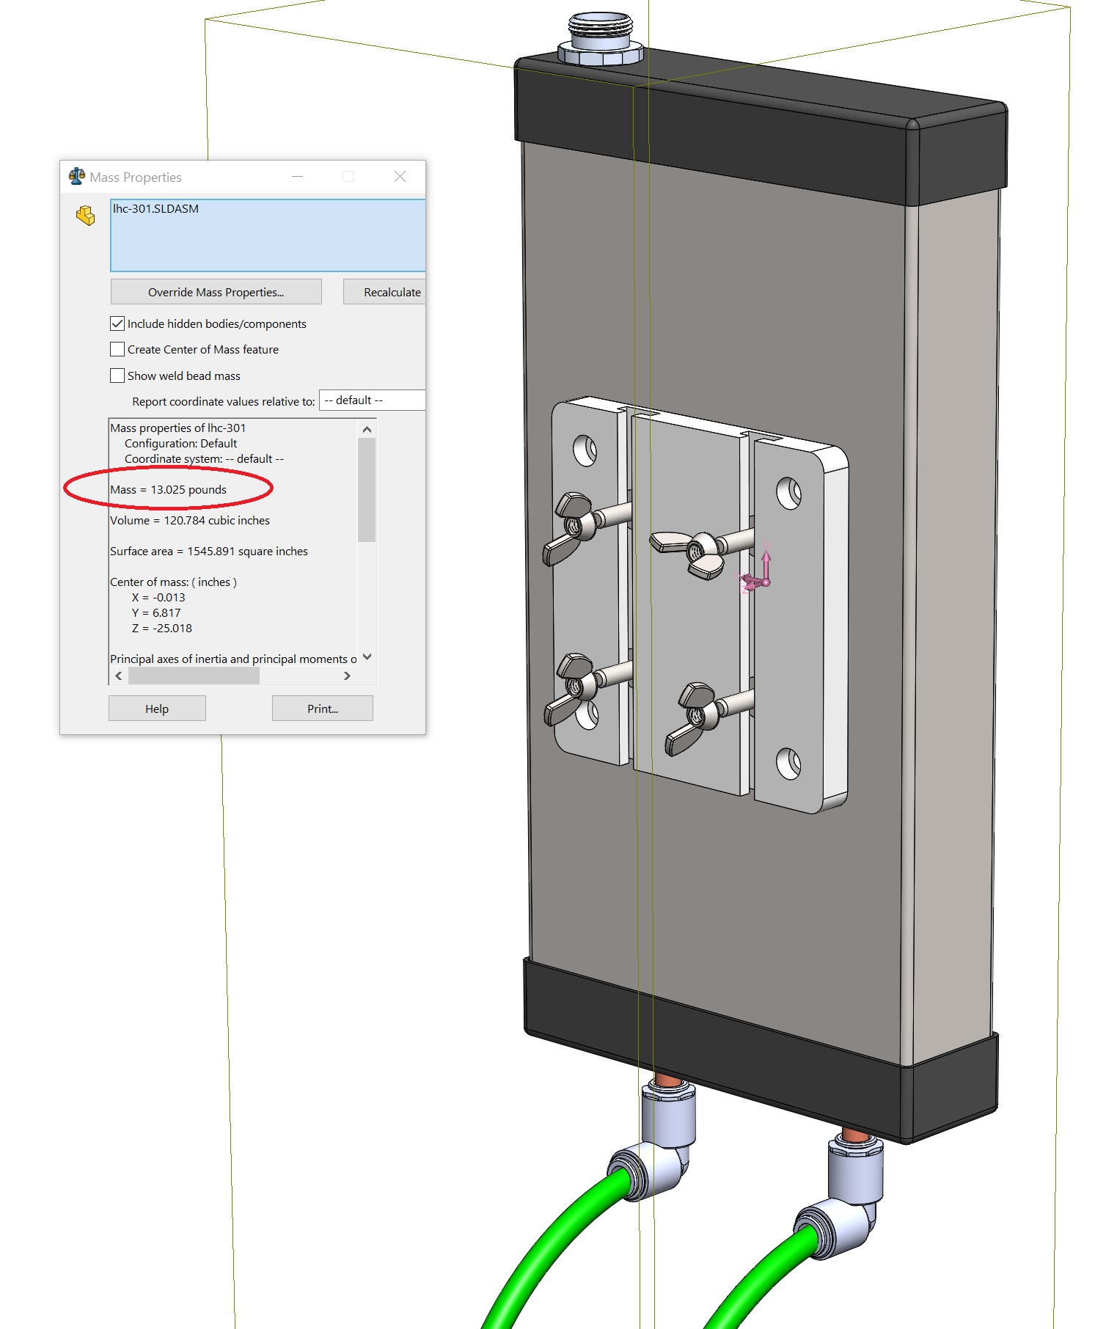
prj/hazelnut_large/LHC-001/1-Documentation/2018-2019 Large Tree Computer - Superceded Designs and Documentation/2019-2-25 12-inch 3-Optic Light design/LHC-301_WEIGHT.jpg
