OpenAgricultureFoundation/openag-mechanical/prj/hazelnut_large/LHC-001/1-Documentation/2018-2019 Large Tree Computer - Superceded Designs and Documentation/2019-4-17 Light Layout Pentagonal Plan/2019-4-17_LHC_Pentagon_Layout-Render4.jpg

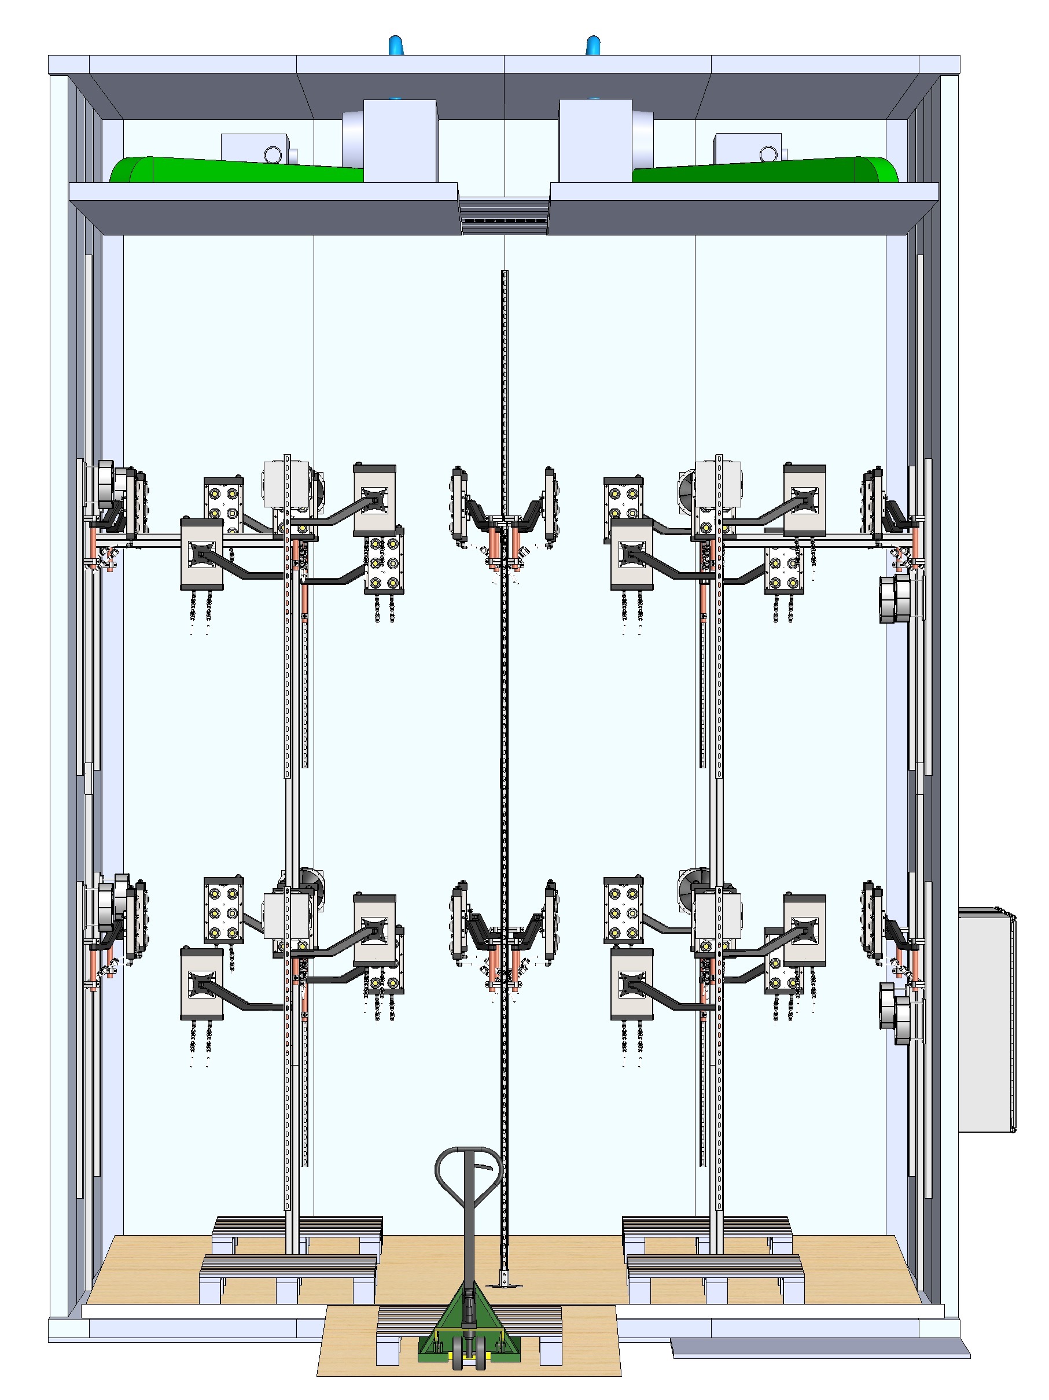
prj/hazelnut_large/LHC-001/1-Documentation/2018-2019 Large Tree Computer - Superceded Designs and Documentation/2019-4-17 Light Layout Pentagonal Plan/2019-4-17_LHC_Pentagon_Layout-Render4.jpg
