OpenAgricultureFoundation/openag-mechanical/prj/hazelnut_large/LHC-001/1-Documentation/2018-2019 Large Tree Computer - Superceded Designs and Documentation/2019-5-1 LHC HVAC Planning/2019-5-1_LHC_HVAC_5.jpg

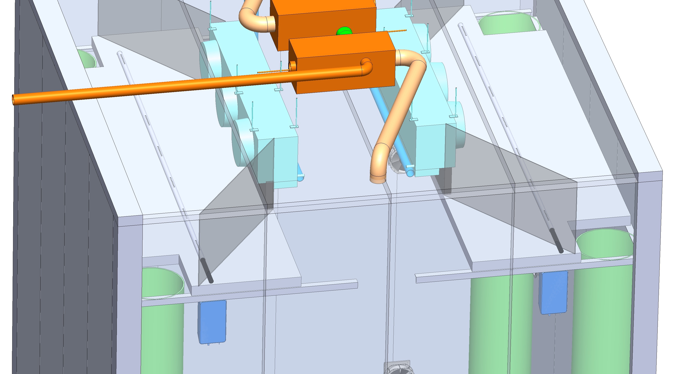
prj/hazelnut_large/LHC-001/1-Documentation/2018-2019 Large Tree Computer - Superceded Designs and Documentation/2019-5-1 LHC HVAC Planning/2019-5-1_LHC_HVAC_5.jpg
