OpenAgricultureFoundation/openag-mechanical/prj/hazelnut_large/LHC-001/1-Documentation/2018-2019 Large Tree Computer - Superceded Designs and Documentation/2019-5-8 LHC HVAC Planning Updates/2019-5-8_LHC_HVAC_1.jpg

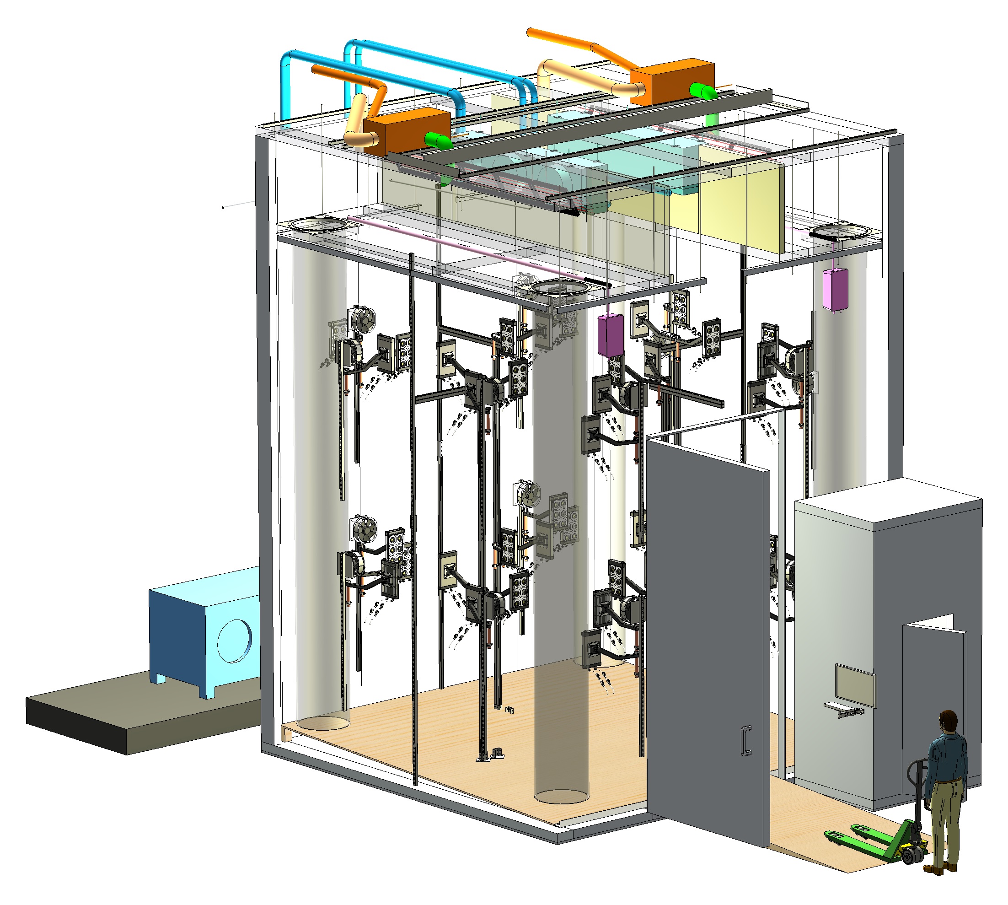
prj/hazelnut_large/LHC-001/1-Documentation/2018-2019 Large Tree Computer - Superceded Designs and Documentation/2019-5-8 LHC HVAC Planning Updates/2019-5-8_LHC_HVAC_1.jpg
