OpenAgricultureFoundation/openag-mechanical/prj/hazelnut_large/LHC-001/1-Documentation/2019-4-8 6-Optic Light Design/2019-4-8 LHC300-3.jpg

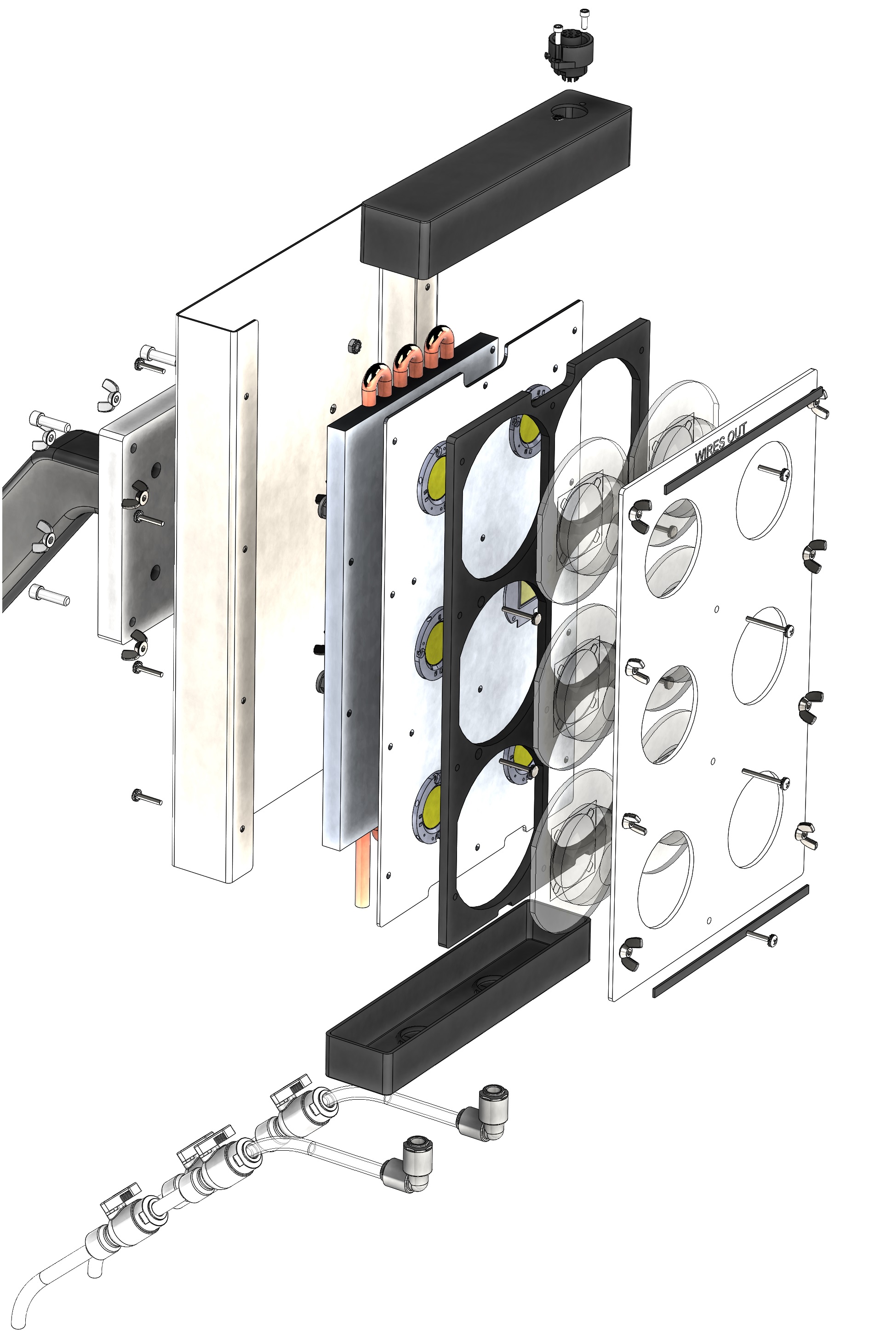
prj/hazelnut_large/LHC-001/1-Documentation/2019-4-8 6-Optic Light Design/2019-4-8 LHC300-3.jpg
