OpenAgricultureFoundation/openag-mechanical/prj/hazelnut_large/LHC-001/1-Documentation/2019-5-20 Entry-way Moving Light Frame Initial Design/2019-5-20 Entry-way Moving Light Frame_2.jpg

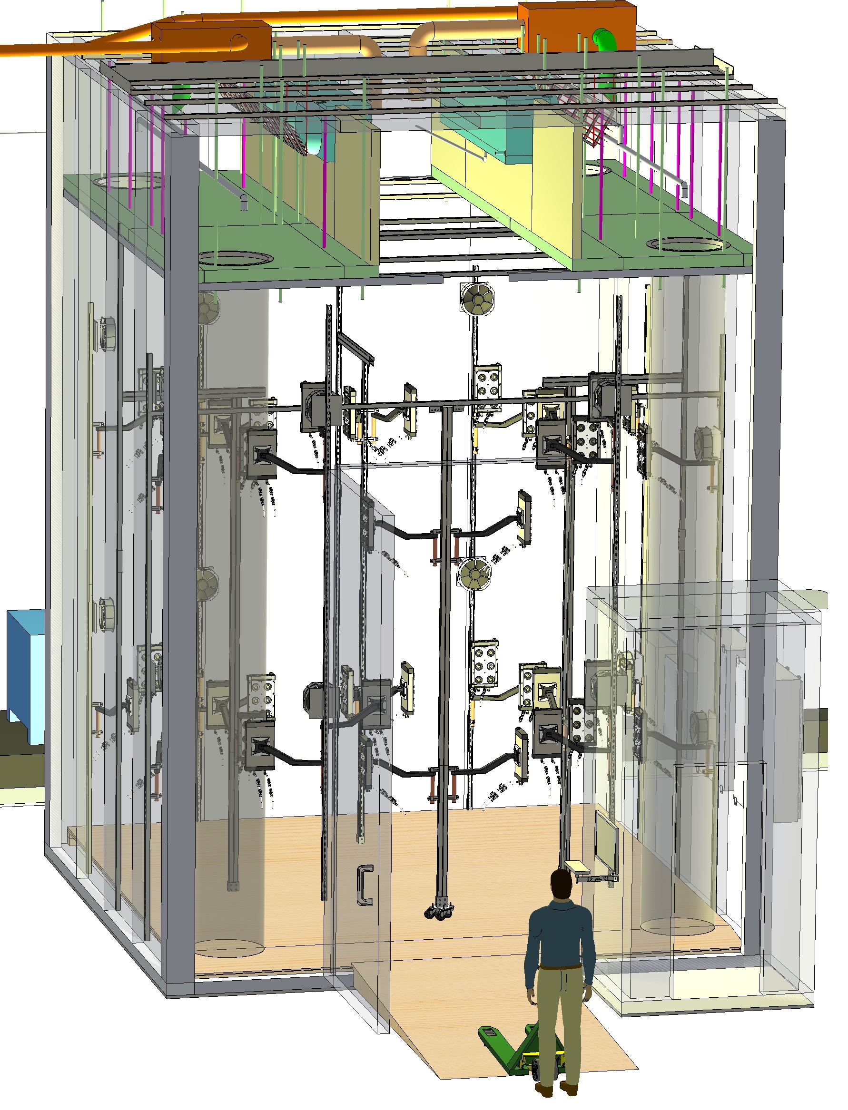
prj/hazelnut_large/LHC-001/1-Documentation/2019-5-20 Entry-way Moving Light Frame Initial Design/2019-5-20 Entry-way Moving Light Frame_2.jpg
