OpenAgricultureFoundation/openag-mechanical/prj/hazelnut_large/LHC-001/1-Documentation/2019-6-5 Pepsi Co Renderings/2019-6-5 PepsiCo_5.jpg

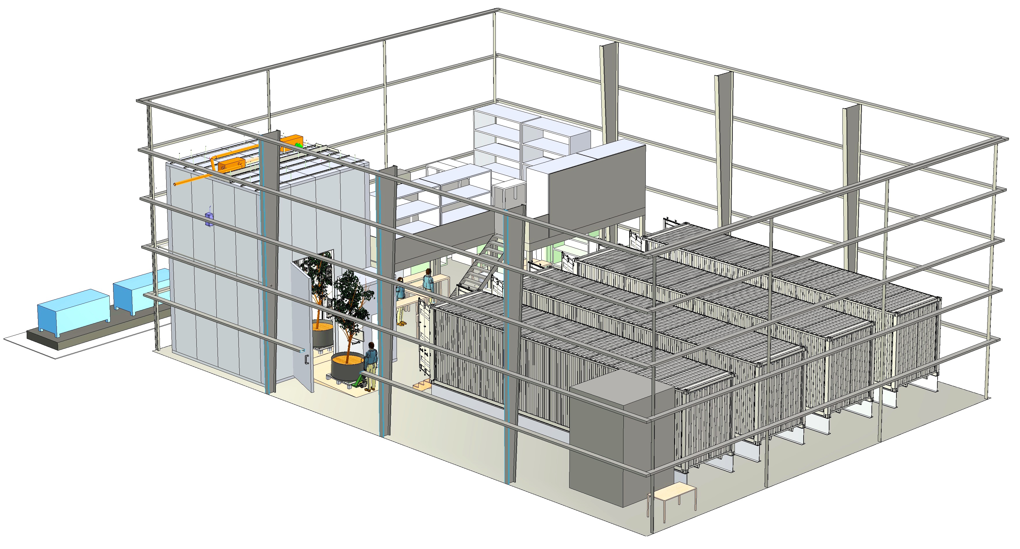
prj/hazelnut_large/LHC-001/1-Documentation/2019-6-5 Pepsi Co Renderings/2019-6-5 PepsiCo_5.jpg
