OpenAgricultureFoundation/openag-mechanical/prj/hazelnut_large/LHC-001/1-Documentation/2019-9-11 LED Strut Redesign Sketches/IMG_3334.JPG

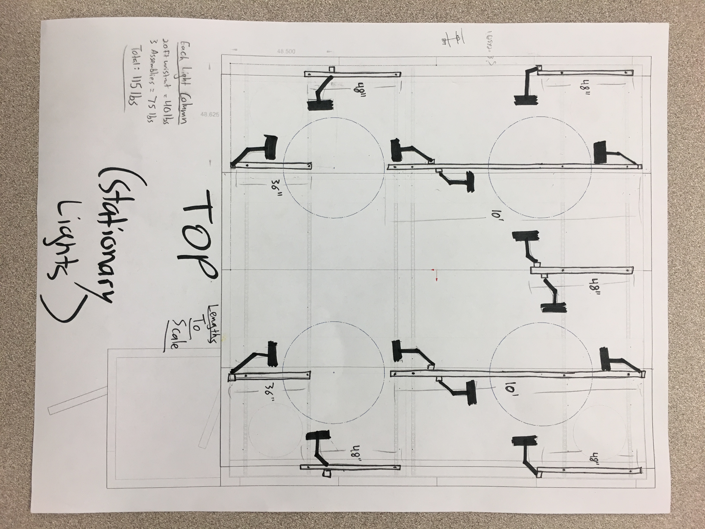
prj/hazelnut_large/LHC-001/1-Documentation/2019-9-11 LED Strut Redesign Sketches/IMG_3334.JPG
