OpenAgricultureFoundation/openag-mechanical/prj/hazelnut_large/LHC-001/1-Documentation/2019-9-18 LHC As Built Initial Photo Documentation/2019-9-18 As-Built Documentation Photos (5).JPG

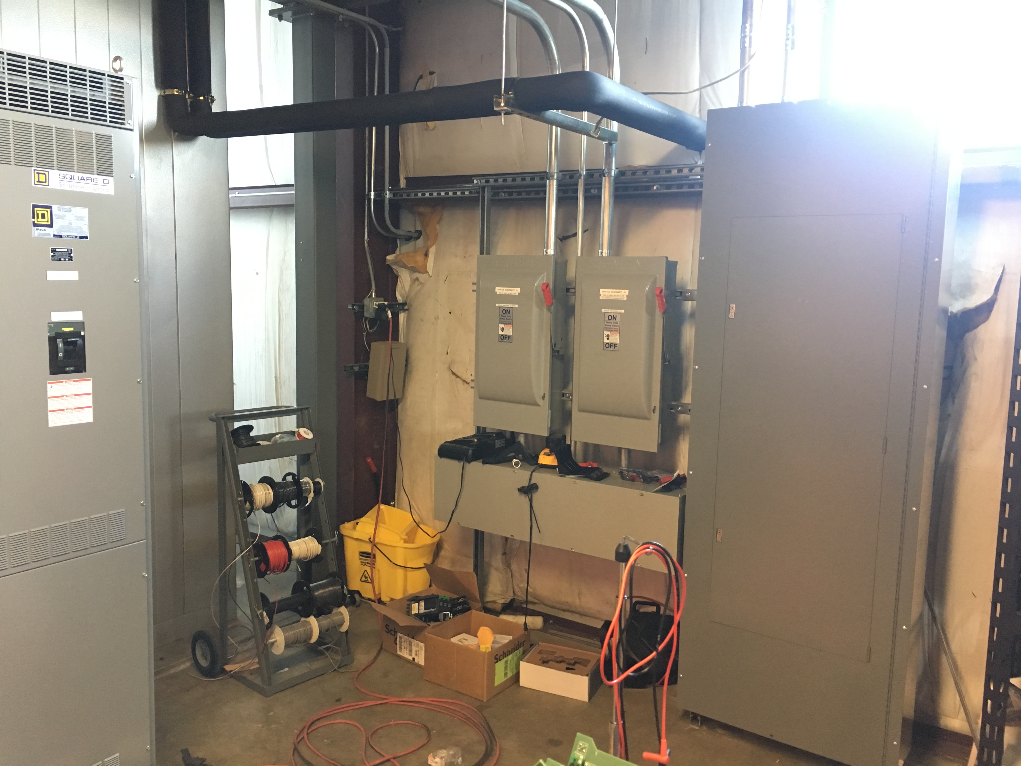
prj/hazelnut_large/LHC-001/1-Documentation/2019-9-18 LHC As Built Initial Photo Documentation/2019-9-18 As-Built Documentation Photos (5).JPG
