OpenAgricultureFoundation/openag-mechanical/prj/hazelnut_large/LHC-001/1-Documentation/2019-10-1 Tree Pallet Heating Designs/Coil Design 1/Heating-Pad-6.jpg

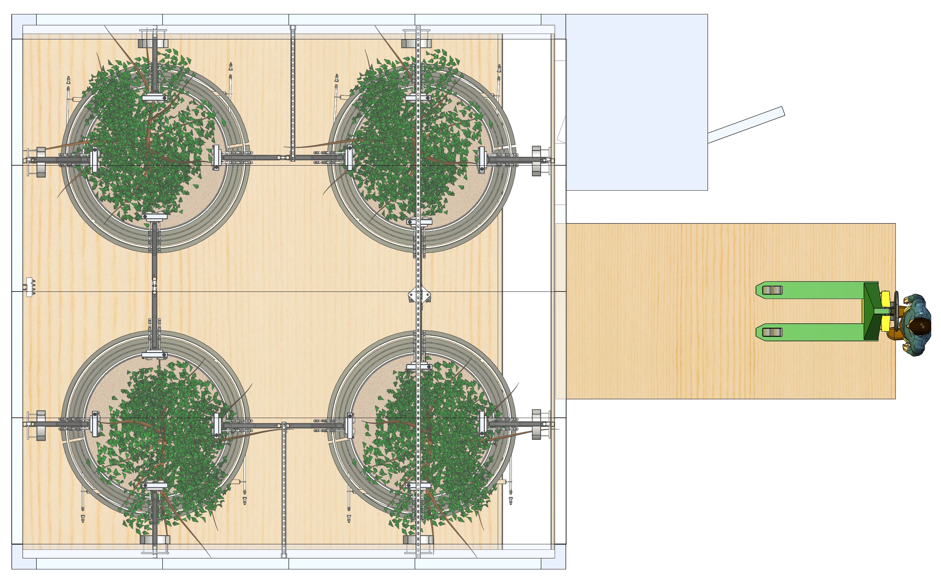
prj/hazelnut_large/LHC-001/1-Documentation/2019-10-1 Tree Pallet Heating Designs/Coil Design 1/Heating-Pad-6.jpg
