OpenAgricultureFoundation/openag-mechanical/prj/hazelnut_large/LHC-001/1-Documentation/2019-10-22 Outdoor Cement Pad/2019-10-29 Outside HVAC 7.JPG

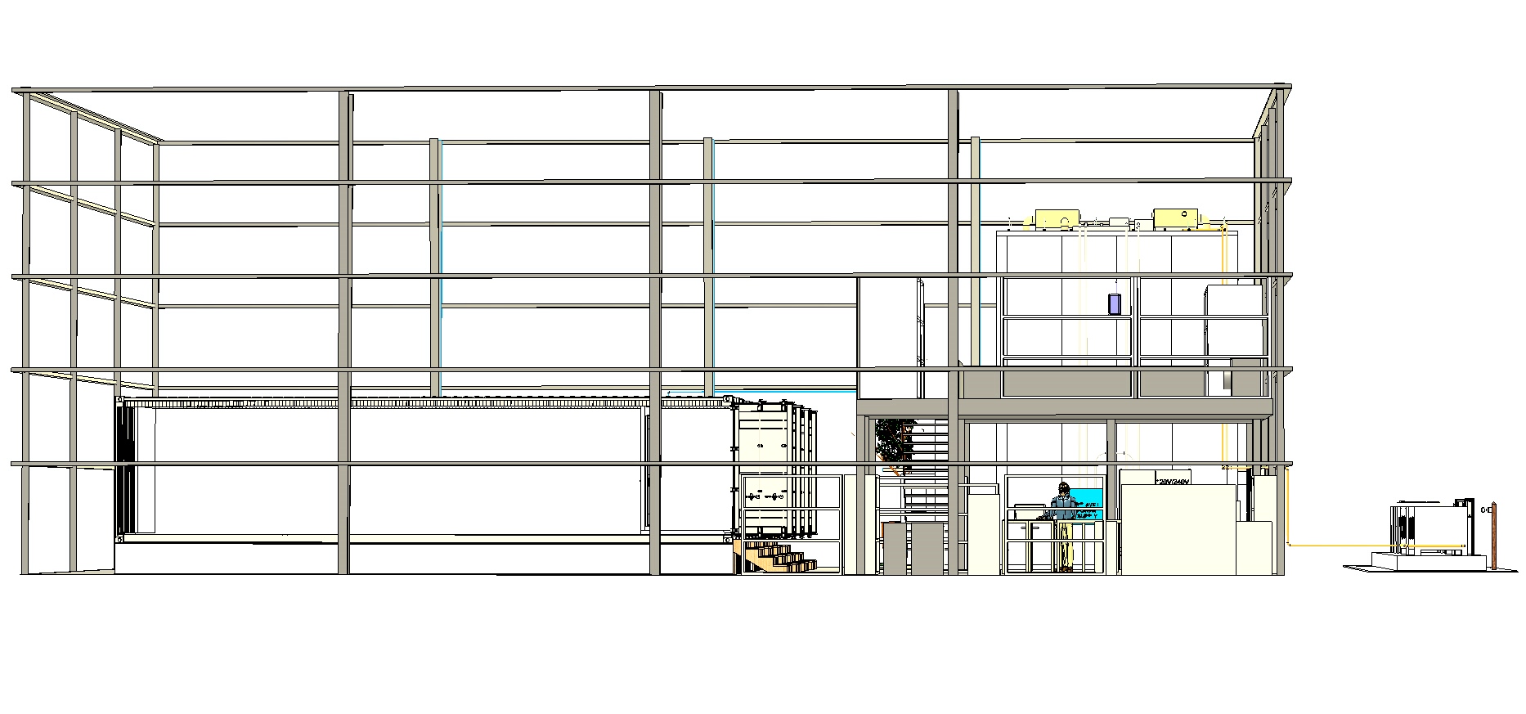
prj/hazelnut_large/LHC-001/1-Documentation/2019-10-22 Outdoor Cement Pad/2019-10-29 Outside HVAC 7.JPG
