OpenAgricultureFoundation/openag-mechanical/prj/hazelnut_large/LHC-001/1-Documentation/2019-10-23 Light Unistrut Designs - Updated/2019-10-28 LED Unistruts 2.JPG

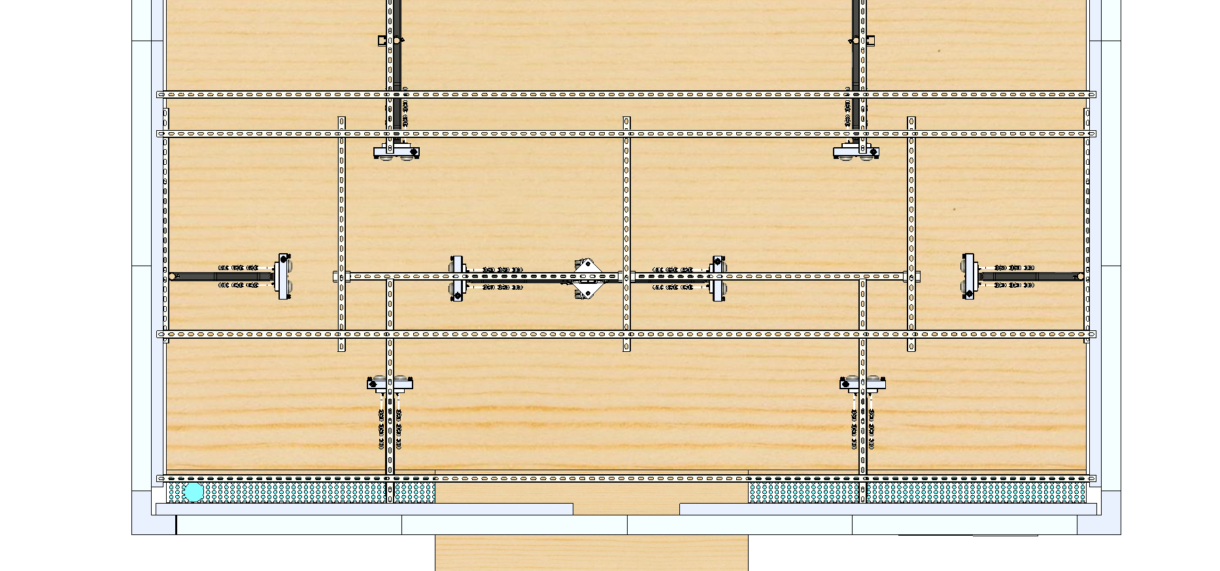
prj/hazelnut_large/LHC-001/1-Documentation/2019-10-23 Light Unistrut Designs - Updated/2019-10-28 LED Unistruts 2.JPG
