OpenAgricultureFoundation/openag-mechanical/prj/hazelnut_large/LHC-001/1-Documentation/2019-10-23 Light Unistrut Designs - Updated/Superceded Designs/2019-10-23 LED Unistruts 1.JPG

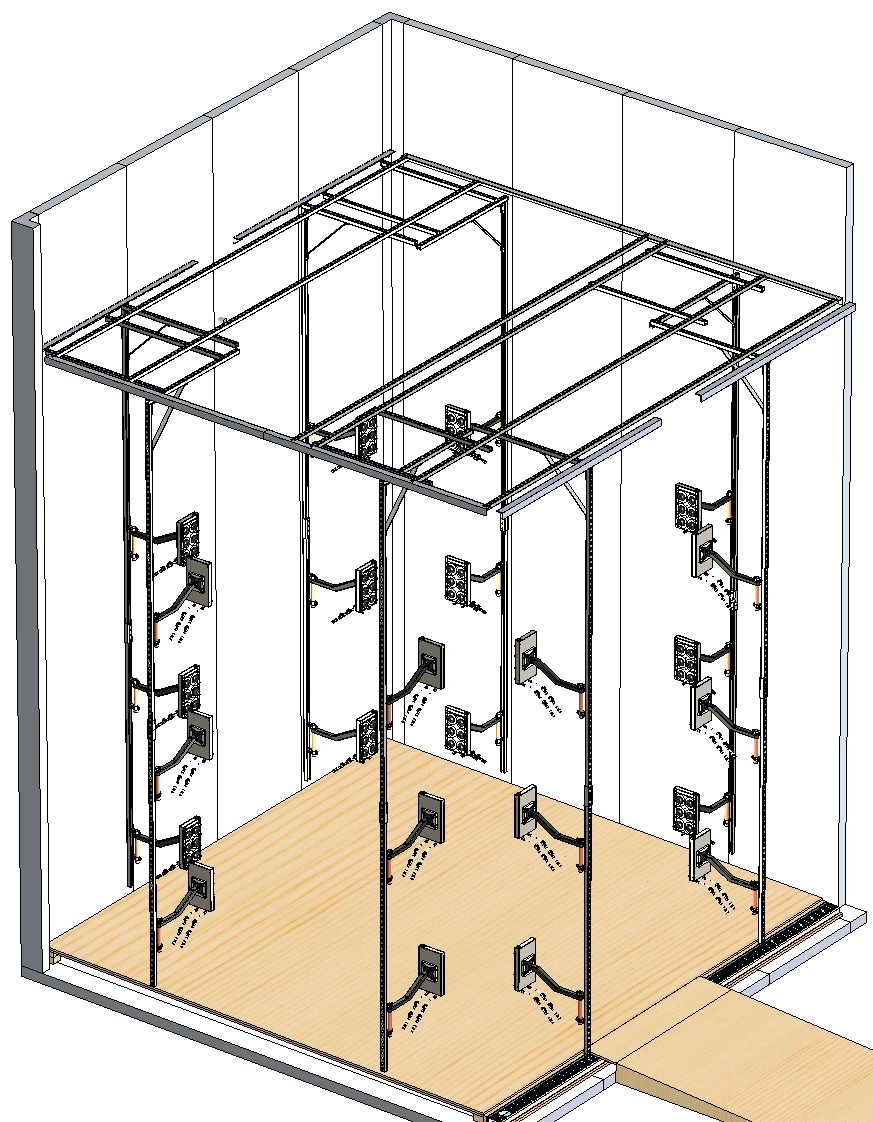
prj/hazelnut_large/LHC-001/1-Documentation/2019-10-23 Light Unistrut Designs - Updated/Superceded Designs/2019-10-23 LED Unistruts 1.JPG
