OpenAgricultureFoundation/openag-mechanical/prj/hazelnut_large/LHC-001/1-Documentation/2019-10-24 LED Coolant Line Routing Designs/2019-10-24 LED Coolant Routing Sketch.JPG

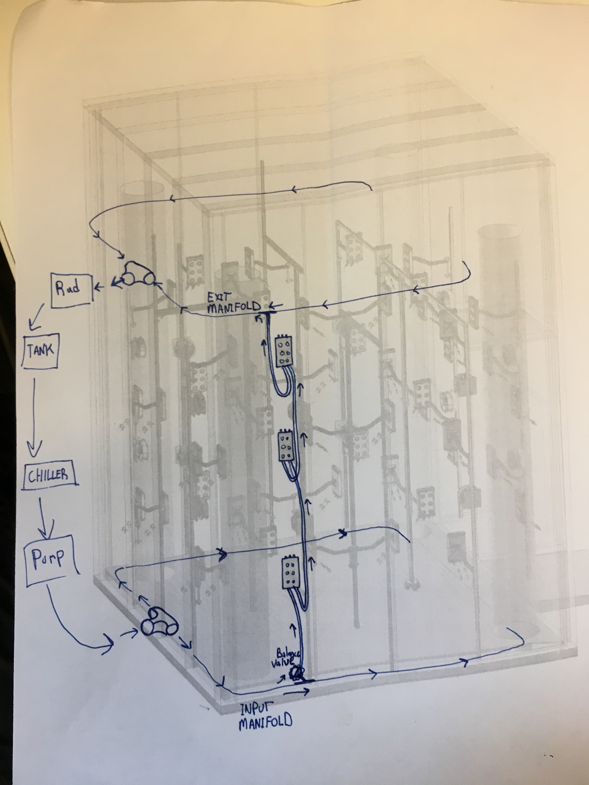
prj/hazelnut_large/LHC-001/1-Documentation/2019-10-24 LED Coolant Line Routing Designs/2019-10-24 LED Coolant Routing Sketch.JPG
