OpenAgricultureFoundation/openag-mechanical/prj/hazelnut_large/LHC-001/1-Documentation/2019-10-24 LED Coolant Line Routing Designs/2019-10-24 Overlay Options (1).jpg

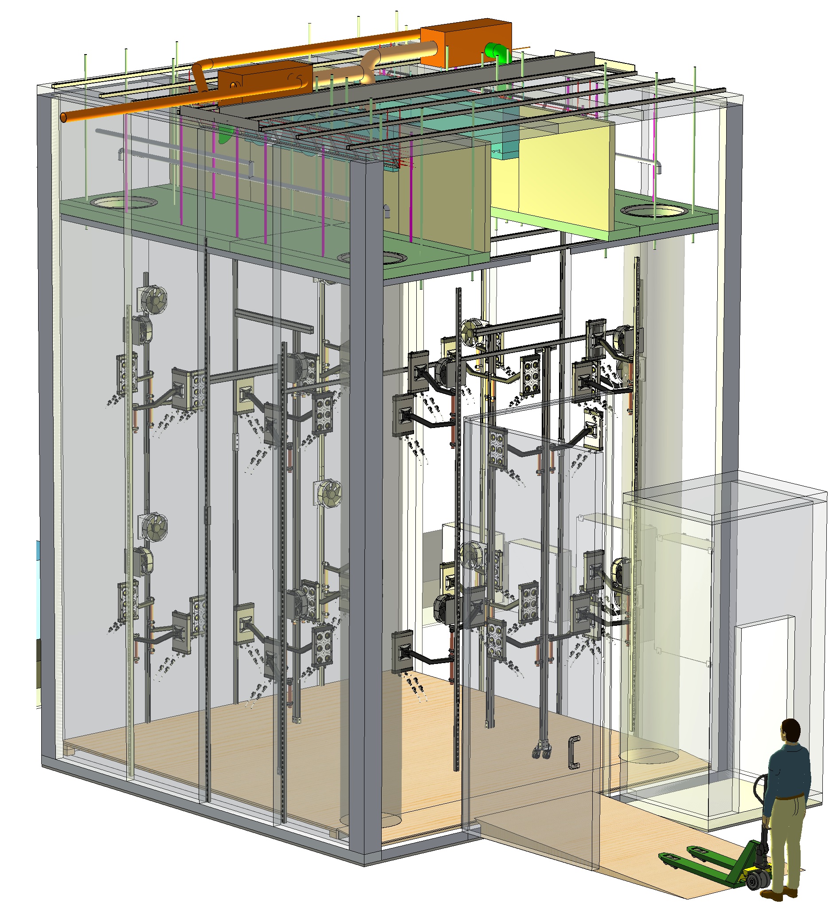
prj/hazelnut_large/LHC-001/1-Documentation/2019-10-24 LED Coolant Line Routing Designs/2019-10-24 Overlay Options (1).jpg
