OpenAgricultureFoundation/openag-mechanical/prj/hazelnut_large/LHC-001/3-Specification Sheets/Pallet Specs.jpg

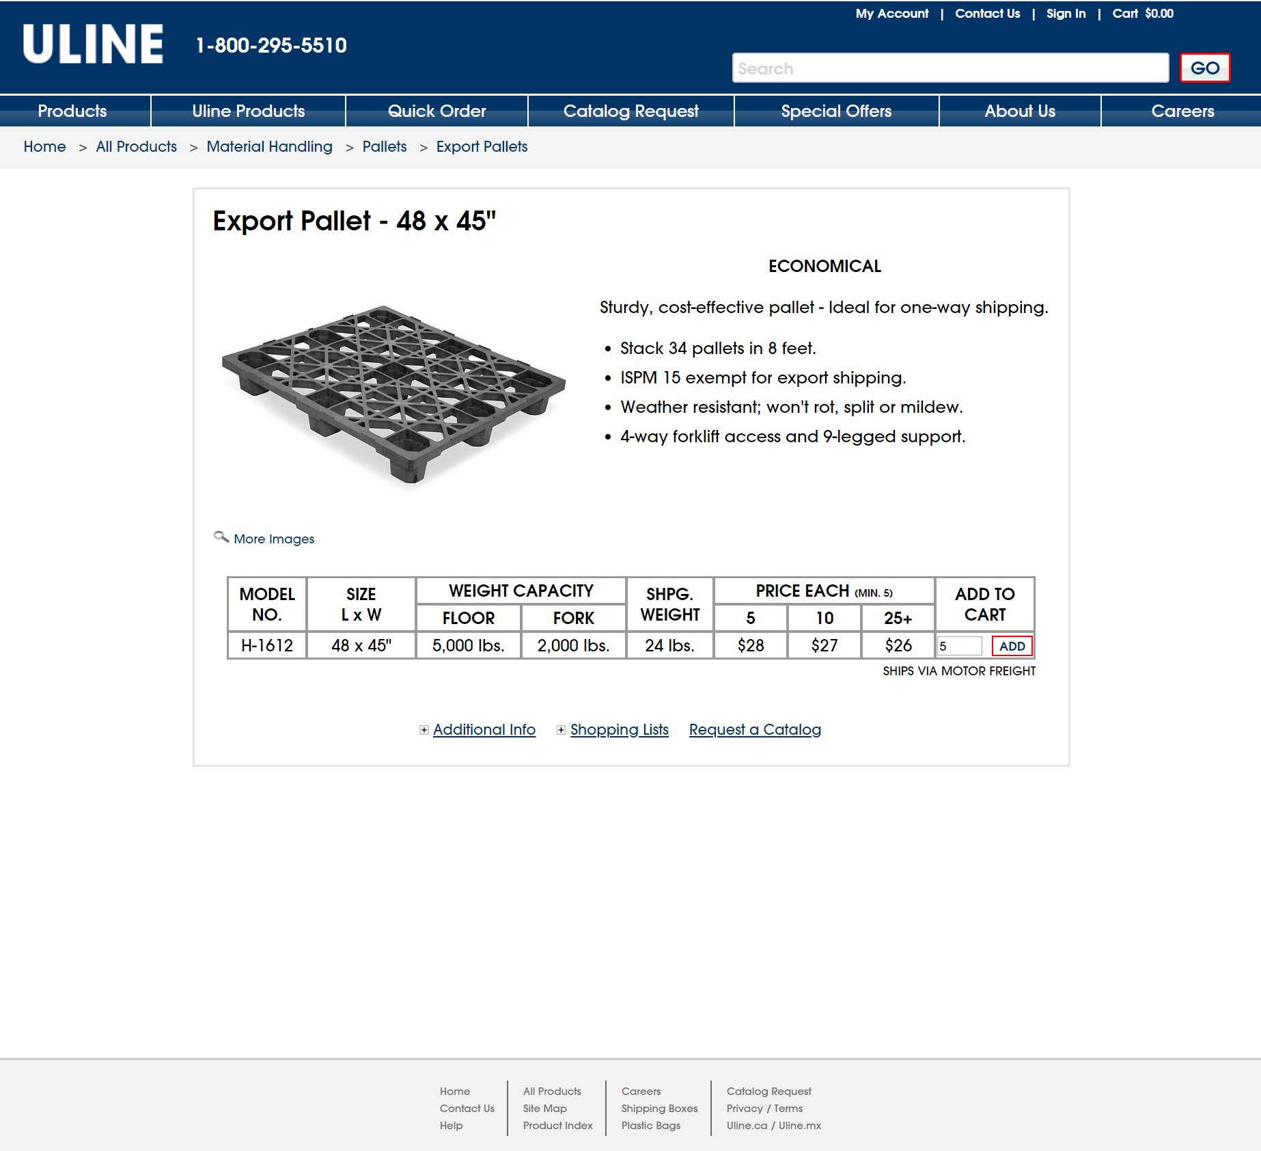
prj/hazelnut_large/LHC-001/3-Specification Sheets/Pallet Specs.jpg
