OpenAgricultureFoundation/openag-mechanical/prj/pfc-edu/Corrugated Plastic PFC/Corrugated Documentation/12-19-18_OpenAg_Ornaments.JPG

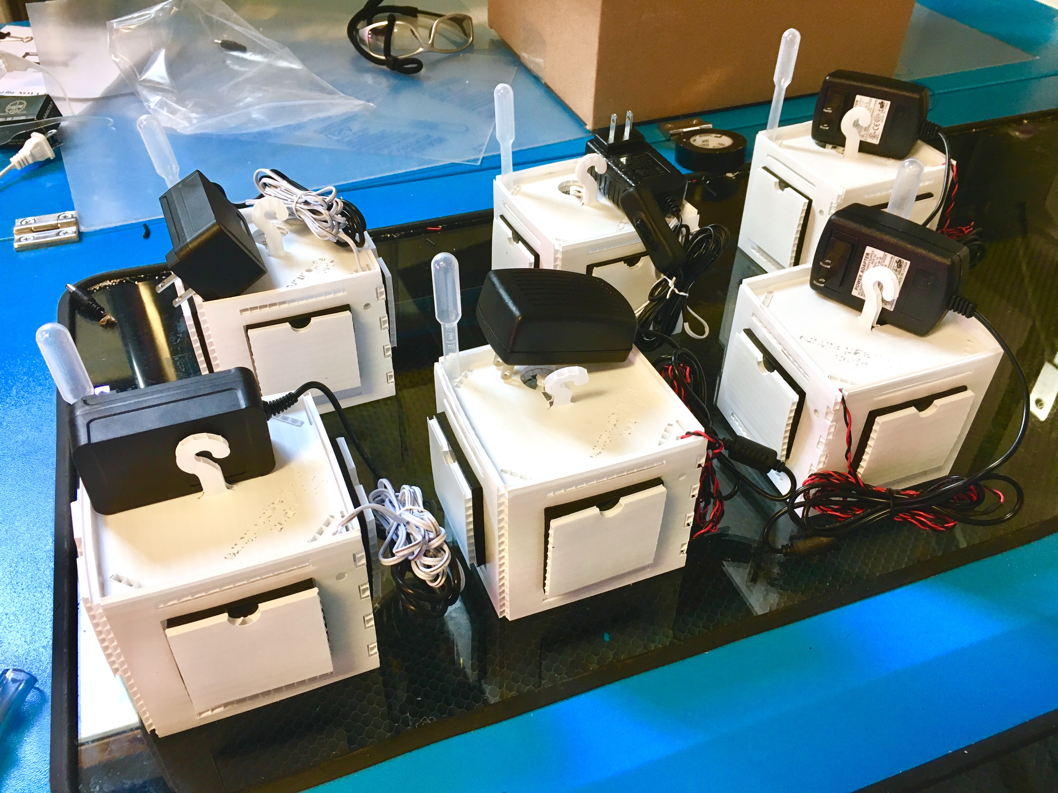
prj/pfc-edu/Corrugated Plastic PFC/Corrugated Documentation/12-19-18_OpenAg_Ornaments.JPG
