OpenAgricultureFoundation/openag-mechanical/prj/pfc-edu/Corrugated Plastic PFC/Corrugated Documentation/PFC_Mini_smallbox_12_21_18.JPG

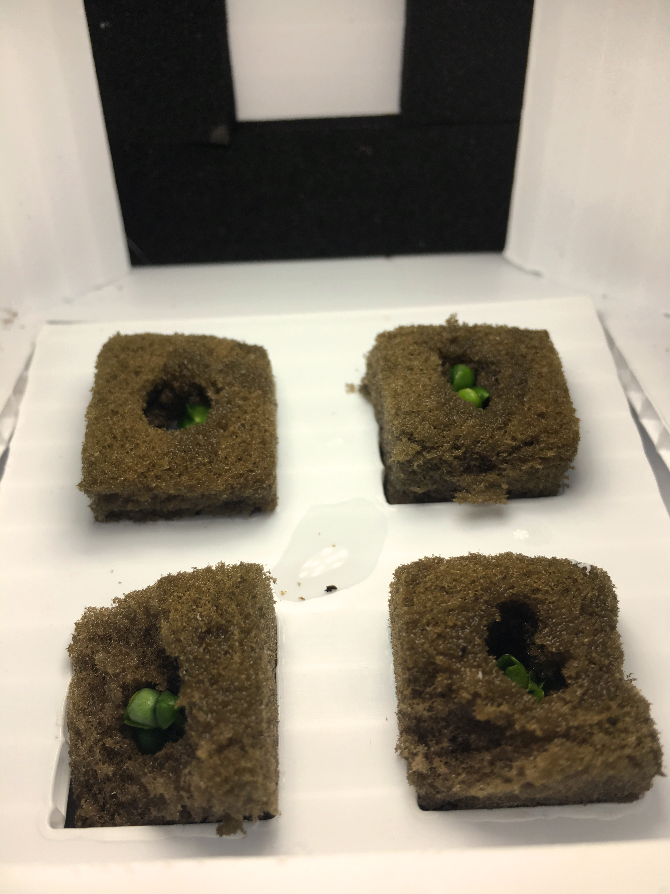
prj/pfc-edu/Corrugated Plastic PFC/Corrugated Documentation/PFC_Mini_smallbox_12_21_18.JPG
