OpenAgricultureFoundation/openag-mechanical/prj/container 3 rack v2/container 2 led-fixture/6-12-18 OpenAg Container #3 BOM.xls

 | MIT Bates OpenAg
 | Container #3 BOM
Item |  |  |  |  | Description | Material | Source PN | Source | Quantity | Price @ Qty | Qty Extended
 | LFR.000 Cart Assembly |  |  |  |  |  |  |  | 10
 |  | Hanging Rod |  |  | SS Light Fixture Rack, 6' | Stainless Steel | 89895K769 | McMaster | 10 | $61.93 | $619.30
 |  | Rod Clamp |  |  | Beam Clamp for Pipe, Tube, and Conduit | 316 Stainless Steel | 29585T2 | McMaster | 20 | $10.00 | $200.00
 |  | LFR.006 |  |  | Neoprene Rubber Strip 2" x 36", 1/16" | Neoprene 50A | 1372N33 | McMaster | 1 | $7.56 | $7.56
 |  | Cable Management Clamp |  |  | Snap-in Plastic Routing Clamp 7/8" to 1" ID | Acetal Plastic | 7429K48 | McMaster | 100 | $1.32 | $132.30
 |  | Trough Seat 1 |  |  | Machined Trough Insert 1 ? | - | - | MIT Bates | 10 |  | $0.00
 |  | Trough Seat 2 |  |  | Machined Trough Insert 2 ? | - | - | MIT Bates | 10 |  | $0.00
 |  | Plant Trough
 |  |  |  |  |  |  |  |  | 10 |  | $0.00
 |  | USB Extension Cables? |  |  |  |  |  |  | 40 |  | $0.00
 |  | Flexible Tubing |  |  |  |  |  |  |  |  | $0.00
 |  | 3/8" Push-To-Connect T-fitting |  |  |  |  |  |  |  |  | $0.00
 |  | Brain? |  |  |  |  |  |  |  |  | $0.00
 |  |  |  |  |  |  |  |  |  |  | $0.00
 |  | Cart |  |  | Green Monster plant cart | - | 22-777 | Matco | 10 | $237.00 | $2370.00
 |  | Dosatron |  |  | Dosatron mixing tank | - | MC34 | Dosatron | 10 | $73.81 | $738.10
 |  | Circulation pump |  |  | Little Giant circulation pump | - | 9930K63 | McMaster | 10 | $214.00 | $2140.00
 |  | Grow Tray |  |  | 24" x 48" hydroponic grow tray | - | B00CJIBMIK | Amazon / Botanicare | 10 | $89.99 | $899.90
 |  | Venturi injector |  |  | 1/2" NPT male-male Venturi injector | - | KINGSOKIJOP6559 | Amazon / KingSo | 10 | $19.44 | $194.40
 |  |  |  |  | 1/2" FNPT x FNPT x FNPT tee | - | 22FL01 | Grainger | 20 | $1.23 | $24.60
 |  |  |  |  | 1/2" MNPT x sock adapter | - | 22FJ19 | Grainger | 20 | $0.29 | $5.80
 |  |  |  |  | 1/2" NPT f-f corner_thr01 | - | 22FJ74 | Grainger | 20 | $0.66 | $13.20
 |  |  |  |  | 1/2" NPT union | - | 22FM79 | Grainger | 10 | $2.78 | $27.80
 |  |  |  |  | 3/4" 90 threaded street elbow | - | 22FJ82 | Grainger | 20 | $0.97 | $19.40
 |  |  |  |  | PVC Union, FNPT x FNPT, 3/4" NPT, Sch 40 | - | 22FM80 | Grainger | 20 | $4.50 | $90.00
 |  |  |  |  | PVC Union, FNPT x FNPT, 3/4" NPT, Sch 80 | - | 11W267 | Grainger | 20 | $5.97 | $119.40
 |  |  |  |  | 1/2" FPT x 1/2" FPT x 12"L braided sink line | - | B3-12A F | Home Depot | 10 | $5.98 | $59.80
 |  |  |  |  | 1/2" FPT x 1/2" FPT x 16"L braided sink line | - | B3-16A F | Home Depot | 10 | $6.47 | $64.70
 |  |  |  |  | 1/2" MPT x 3/4" hose spigot | - | 243496 | Home Depot | 10 | $8.90 | $89.00
 |  |  |  |  | galvanized l-bracket | - | A21Z | Home Depot | 10 | $0.58 | $5.80
 |  |  |  |  | 1/2" NPT gasket | - | 4061T163 | McMaster Carr | 20 | $11.36 | $227.20
 |  |  |  |  | 1/2" NPT nylon nut | - | 3185K112 | McMaster Carr | 20 | $0.44 | $8.80
 |  |  |  |  | 1/2" MPT x 1/2" MPT nipple | - | 8802845 | MSCDirect | 30 | $0.79 | $23.70
 |  |  |  |  | 1/2" MPT x 3/4" GHT hose adapter, plastic | - | 5726468 | MSCDirect | 10 | $0.85 | $8.50
 |  |  |  |  | 1/2" NPT male x 3/4" NPT reducer nipple | - | 8803066 | MSCDirect | 10 | $0.80 | $8.00
 |  |  |  |  | 3/4" MPT x 1/2" MPT adapter | - | 50580885 | MSCDirect | 10 | $0.99 | $9.90
 |  |  |  |  | 3/4" MPT x 3/4" MPT nipple | - | 8802852 | MSCDirect | 30 | $0.85 | $25.50
 |  |  |  |  | 3/4" NPT m - 3/4" hose m adapter, plastic | - | 05726484 | MSCDirect | 10 | $1.05 | $10.50
 |  |  |  |  | #6 standoffs |  |  |  |  |  | $0.00
 |  |  |  |  |  |  |  |  |  |  | $0.00
 |  |  |  |  |  |  |  |  |  |  | $0.00
 |  |  |  |  |  |  |  |  |  |  | $0.00
 |  |  |  |  |  |  |  |  |  |  | $0.00
 |  |  |  |  |  |  |  |  |  |  | $0.00
 |  | LFR.001 Light Fixture Assembly |  |  |  |  |  |  | 40
 |  |  | LFR.001 |  | Light Array Enclosure | Stainless Steel | LFR.001 | Salem Metal Inc. | 50 | $23.60 | $1180.00
 |  |  |  | LFR.001 Setup/Inspec. | - | - | - | - | 1 | $110.00 | $110.00
 |  |  | Light Panel |  | Light Panel | ? | ? | ? | 40 |  | $0.00
 |  |  | Heat Sink |  | Heat Sink | ? | ? | Digikey? | 40 |  | $0.00
 |  |  | 3/8" Push-To-Connect 90° |  |  | Plastic |  | McMaster |  |  | $0.00
 |  |  | Clamping Hanger |  | 7/8" Vibration Damping Clamping Hanger | Zinc-Plated Steel | 2615T13 | McMaster | 40 | $1.87 | $74.80
 |  |  | 3/8-16 Stud |  | 3/8-16, 2" Long Adjusting Positioning Stud | Stainless Steel | 92386A632 | McMaster | 40 | $2.44 | $97.60
 |  |  | 3/8-16 Locknut |  | 3/8-16 Serrated-Flange Locknut | Stainless Steel | 93776A461 | McMaster | 40 | $0.27 | $10.67
 |  |  | 5-40 Screw |  | Button Head, 5-40 Thread Size, 3/8" Long | Stainless Steel | 92949A133 | McMaster | 320 | $0.04 | $12.48
 |  |  | #5 Lock Washer |  | No. 5, 0.133" ID, 0.202" OD | Stainless Steel | 94241A230 | McMaster | 320 | $0.03 | $10.88
 |  |  | 5-40 Hex Nut |  | Narrow Hex Nut 5-40 Thread Size | Stainless Steel | 90730A006 | McMaster | 320 | $0.05 | $17.57
 |  |  | Level |  | Surface-Mount Tubular Level 2-3/16" Long | Plastic | 3338A22 | McMaster | 40 | $1.07 | $42.80
 |  |  | 3M VHB Foam Tape |  | #4905, 3/4" Width x 72 Yards, .020" Thick | Foam | 76665A68 | McMaster | 1 | $136.72 | $136.72
 |  |  | Camera Mount Assembly |  |  |  |  |  | 20
 |  |  |  | Clamping Hanger | 7/8" Vibration Damping Clamping Hanger | Zinc-Plated Steel | 2615T13 | McMaster | 20 | $1.87 | $37.40
 |  |  |  | 3/8-16 Stud | 3/8-16, 2" Long Adjusting Positioning Stud | Stainless Steel | 92386A632 | McMaster | 20 | $2.44 | $48.80
 |  |  |  | 3/8-16 Locknut | 3/8-16 Serrated-Flange Locknut | Stainless Steel | 93776A461 | McMaster | 40 | $0.27 | $10.80
 |  |  |  | Strut Channel | Solid Strut Channel, 1-5/8", 1' Long | Fiberglass | 3261T28 | McMaster | 20 | $8.76 | $175.20
 |  |  |  | Strut ChannelNut | Square Nut, 1/4"-20 Thread Size | Zinc-Plated Steel | 2233K15 | McMaster | 40 | $1.49 | $59.60
 |  |  |  | 1/4-20 Screw | Truss Head 1/4"-20 Thread, 1-1/4" Long | 18-8 Stainless Steel | 91770A544 | McMaster | 40 | $0.31 | $12.40
 |  |  |  | LFR.003 | 1.5"x1.5"x0.10" Camera Base | Acrylic | LFR.003 | MIT Bates | 40 |  | $0.00
 |  |  |  | LFR.004 | 1.5"x1.5"x0.10" Camera Spacer | Acrylic | LFR.004 | MIT Bates | 40 |  | $0.00
 |  |  |  | LFR.007 | Adhesive-Back Rubber 1/2" Wide x 10' Long | Silicone Rubber | 8622K51 | McMaster | 1 | $14.24 | $14.24
 |  |  |  | 1/4-20 Wing Nut | Plastic Wing Nut 1/4"-20 Thread Size | Nylon 6/6 | 94924A600 | McMaster | 40 | $0.16 | $6.51
 |  |  |  | 2-56 Hex Standoff | Female Threaded 3/16", 1-1/2" Long, 2-56 | Stainless Steel | 91115A819 | McMaster | 160 | $2.26 | $361.60
 |  |  |  | Camera | 5 Megapixel Camera w/ USB Cable | - | ELP-USB500W02M-L21 | Amazon? | 20 | $43.00 | $860.00
 |  |  |  | 2-56 Screw | Button Head Hex 2-56 Thread Size, 1/4" L | 18-8 Stainless Steel | 92949A077 | McMaster | 320 | $0.06 | $19.17
 |  |  |  | #2 Lock Washer | Split Lock #2, 0.094" ID, 0.172" OD | 316 Stainless Steel | 92147A410 | McMaster | 320 | $0.02 | $7.07
 |  |  |  | Level | Surface-Mount Tubular Level 2-3/16" Long | Plastic | 3338A22 | McMaster | 20 | $1.07 | $21.40
 |  |  |  |  |  |  |  |  |  |  | $0.00
 |  |  |  |  |  |  |  |  |  |  | $0.00
 |  |  |  |  |  |  |  |  | Sub-Total |  | $11470.87
