OpenAgricultureFoundation/openag-mechanical/prj/fs-rack/v2.0/fs_rack_bom_2.0.xlsx

Sheet: _fs_rack_bom
Part | Country of Origin | Assembly Quantity | For 6 | Manufacturer | Supplier | Part Number | Unit Cost | Total Cost | Unit Weight (lbs) | Total Weight (lbs)
1/2" NPT male-male Venturi injector |  | 1 | 6 | KingSo | Amazon (https://www.amazon.com/KingSo-Irrigation-Venturi-Fertilizer-Watering/dp/B07C2K6JQ4) | KINGSOKIJOP6559 | $19.44 | $19.44 | 0.41 | 0.41
24" x 48" hydroponic grow tray |  | 1 | 6 | Botanicare | Amazon (https://www.amazon.com/dp/B00CJIBMIK?creative=394997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) | B00CJIBMIK | $89.99 | $89.99 | 10.80 | 10.80
1/2" FNPT x FNPT x FNPT tee | United States | 2 | 12 | Lasco | Grainger (https://www.grainger.com/product/LASCO-PVC-Tee-22FL01) | 22FL01 | $1.23 | $2.46 | 0.10 | 0.20
1/2" MNPT x sock adapter | United States | 2 | 12 | Lasco | Grainger (https://www.grainger.com/product/LASCO-PVC-Male-Adapter-22FJ19) | 22FJ19 | $0.29 | $11.36 | 0.03 | 0.06
1/2" NPT f-f corner_thr01 | United States | 2 | 12 | Lasco | Grainger (https://www.grainger.com/product/LASCO-PVC-Elbow-22FJ74?cm_sp=Home-_-MyPurchasedProducts-_-22FJ74&cm_vc=HPMPPZ) | 22FJ74 | $0.66 | $1.32 | 0.05 | 0.10
1/2" NPT union | United States | 1 | 6 | Lasco | Grainger (https://www.grainger.com/product/LASCO-PVC-Union-22FM79) | 22FM79 | $2.78 | $11.36 | 0.07 | 0.07
3/4" 90 threaded street elbow | United States | 2 | 12 | Lasco | Grainger (https://www.grainger.com/product/LASCO-PVC-Street-Elbow-22FJ98) | 22FJ82 | $0.97 | $1.94 | 0.05 | 0.10
PVC Union, FNPT x FNPT, 3/4" NPT, Sch 40 | China | 2 | 12 | Lasco | Grainger (https://www.grainger.com/product/LASCO-PVC-Union-22FM80) | 22FM80 | $4.50 | $9.00 | 0.20 | 0.40
PVC Union, FNPT x FNPT, 3/4" NPT, Sch 80 |  | 2 | 12 | GF Pipe Systems | Grainger (https://www.grainger.com/product/GF-PIPING-SYSTEMS-PVC-Union-11W267) | 11W267 | $5.97 | $11.94 | 0.11 | 0.22
1/2" FPT x 1/2" FPT x 12"L braided sink line | China | 1 | 6 | Brass Craft | Home Depot (https://www.homedepot.com/p/1-2-in-Compression-x-1-2-in-FIP-x-12-in-Braided-Polymer-Faucet-Connector-B3-12A-F/100143862) | B3-12A F | $5.98 | $5.98
1/2" FPT x 1/2" FPT x 16"L braided sink line | China | 1 | 6 | Brass Craft | Home Depot (https://www.homedepot.com/p/BrassCraft-1-2-in-Compression-x-1-2-in-FIP-x-16-in-Braided-Polymer-Faucet-Connector-B3-16A-F/100148838) | B3-16A F | $6.47 | $6.47
1/2" MPT x 3/4" hose spigot | China | 1 | 6 | Everbilt | Home Depot (https://www.homedepot.com/p/Everbilt-1-2-in-x-1-4-in-Brass-MPT-x-MHT-Boiler-Drain-VBDQTRC3EB/205811822) | 243496 | $8.90 | $8.90 | 0.29 | 0.29
galvanized l-bracket |  | 1 | 6 | Simpson Strong Tie | Home Depot (https://www.homedepot.com/p/Simpson-Strong-Tie-ZMAX-18-Gauge-Galvanized-Steel-Angle-A21Z/100375047) | A21Z | $0.58 | $0.58 | 0.07 | 0.07
Green Monster plant cart | United States | 1 | 6 | Matco | Matco (https://www.matcodist.com/plant-distribution-cartindustrial-rolling-rack-horticulture-cart-nursery-cartplant-cart-flower-cart-greenhouse-transportation-cart) | 22-777 | $237.00 | $237.00 | 60.00 | 60.00
1/2" NPT gasket | China | 2 | 12 | not listed | McMaster Carr (https://www.mcmaster.com/#4061t163/=1afszoi) | 4061T163 | $11.36 | $11.36 | 0.0006 | 0.0012
1/2" NPT nylon nut | United States | 2 | 12 | not listed | McMaster Carr (https://www.mcmaster.com/#3185k112/=1aft071) | 3185K112 | $0.44 | $0.88 | 0.003 | 0.01
Little Giant circulation pump | Mexico | 1 | 6 | Franklin Electric | McMaster Carr (https://www.mcmaster.com/#9930k63/=1aft65a) | 9930K63 | $214.79 | $214.79 | 8.40 | 8.40
1/2" MPT x 1/2" MPT nipple | United States | 3 | 18 | Green Leaf | MSCDirect (https://www.mscdirect.com/product/details/08802845) | 8802845 | $0.79 | $2.37
1/2" MPT x 3/4" GHT hose adapter, plastic | United States | 1 | 6 | Green Leaf | MSCDirect (https://www.mscdirect.com/product/details/05726468) | 5726468 | $0.85 | $0.85
1/2" NPT male x 3/4" NPT reducer nipple | United States | 1 | 6 | Green Leaf | MSCDirect (https://www.mscdirect.com/product/details/08803066) | 8803066 | $0.80 | $11.36
3/4" MPT x 1/2" MPT adapter | United States | 1 | 6 | Parker | MSCDirect (https://www.mscdirect.com/product/details/50580885) | 50580885 | $0.99 | $0.99
3/4" MPT x 3/4" MPT nipple | United States | 3 | 18 | Green Leaf | MSCDirect (https://www.mscdirect.com/product/details/08802852) | 8802852 | $0.85 | $2.55 |  | 0.00
3/4" NPT m - 3/4" hose m adapter, plastic | United States | 1 | 6 | Green Leaf | MSCDirect (https://www.mscdirect.com/product/details/05726484) | 05726484 | $1.05 | $1.05 | 0.18 | 0.18
Dosatron mixing tank |  | 1 | 6 | Dosatron | Dosatron | MC34 | $73.87 | $73.87
#6 standoffs (https://www.mscdirect.com/product/details/67725085)

Sheet: _meta
Meta
Tim Savas
OpenAg Initiative
MIT Media Lab
2018-03-29
Contained in this file is the current, stable bill of materials for the latest version of the OpenAg Initiative Food Server's™ hydroponic rack system. This version of the rack system includes several mechanical changes: removal of hydroponic reservoir, effective connections to Waterbot, addition of mixing chamber, sensor probe mounting, and others. Bom will be updated with remaining components shortly.
2018-07-02
Adding new column for 6 units
