OpenAgricultureFoundation/openag-mechanical/prj/fs-waterbot/v1.0/waterbot_terminal_bom.xlsx

Part | SW Part Name | Quantity | Cost/Unit | Total Cost | Serial | Drawing | Manufacturer | Supplier | Description
S211GF15NPEG5 solenoid valve | solenoid_assembly | 5 | $84.26 | $421.30 | S211GF15NPEG5 | yes | GCValves (http://gcvalves.com/) | Sunbury Controls (http://www.sunburycontrols.com/) | GC Valves 2 way normally closed, ¾”, 12VDC, buna seat, noryl body
90 Degree Elbow Adapter, 3/4 Socket Female x 3/4 NPT Male | pvc-075-90-thr | 5 | $0.78 | $3.90 | 4880K622 | yes | McMaster Carr (https://www.mcmaster.com/#4880k622/=199t7sz) | McMaster Carr | Threaded 3/4" NPT male to 3/4" slip adapter (thread allows for low profile against wall)
3/4" NPT f-f union connector | pvc-075-union | 10 | $5.57 | $3.00 | 4881K62 | yes | McMaster Carr (https://www.mcmaster.com/#4881k62/=199t91x) | McMaster Carr | Unions to allow for detachment of solenoid manifold
3/4" NPT f-m threaded adapter | pvc-075-thr_coupling | 15 | $0.30 | $6.60 | 4880K620 | yes | McMaster Carr (https://www.mcmaster.com/#4880k62/=199ta63) | McMaster Carr | Threaded 3/4" NPT male to 3/4" slip straight adapter
3/4" NPT f-f-f slip tee connectors | pvc-075-tee | 6 | $0.44 | $2.64 | 4880K420 | yes | McMaster Carr (https://www.mcmaster.com/#4880k42/=199tbps) | McMaster Carr | Slip tee connectors for PVC junctions
3/4" NPT f-f slip corner connectors | pvc-075-90 | 5 | $0.35 | $1.75 | 4880K220 | yes | McMaster Carr (https://www.mcmaster.com/#4880k22/=19a5s7h) | McMaster Carr | 90deg corner connectors for PVC junctions
3/4" NPT f-f-f side outlet elbow | pvc-075-elbow | 1 | $2.25 | $2.25 | 4880K632 | yes | McMaster Carr (https://www.mcmaster.com/#4880k632/=19a5wy9) | McMaster Carr | Three-way elbow connector for final outlet junction/hose connection
3/4" PVC SuperKlip | pvc-075-standoff | 10 | $1.11 | $11.10 | 389005 | yes | Caddy (https://www.erico.com/caddy.asp) | Grainger (https://www.grainger.com/product/CADDY-Superklip-Tube-And-Pipe-Clamp-1RUZ8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) | pvc clip standoffs for mounting manifold onto backboard
1/4-20 x 1.25" stainless buttonhead screw | hrd-025-20-125-ss-btn | 14 | $0.28 | $3.89 | 92949A836 | yes | McMaster Carr (https://www.mcmaster.com/#92949a836/=19gvgfj) | McMaster Carr | screws for fastening pvc and rubber standoffs to board
1/4-20 stainless nut | hrd-025-20-532-nut | 10 | $0.04 | $0.41 | 91847A029 | yes | McMaster Carr (https://www.mcmaster.com/#91847a029/=19apdx0) | McMaster Carr | nuts for fastening pvc standoffs to board
1/4" stainless washer | hrd-025-ss-wsh | 14 | $0.07 | $1.04 | 90107A029 | yes | McMaster Carr (https://www.mcmaster.com/#90107a029/=19appgp) | McMaster Carr | washers for fastening pvc and rubber standoffs to board
48" x 96" x 3/4" PVC board | manifold_board | 0.125 | $98.00 | $12.25 | 1001736642 | yes | Home Depot (http://www.homedepot.com/p/Veranda-3-4-in-x-48-in-x-8-ft-White-Reversible-PVC-Trim-Sheet-H190AWS13/206822526) | Home Depot | 3/4" waterproof material for backboard of manifold
3/4" rubber dampening standoffs | dampener | 4 | $10.43 | $41.72 | 5823K23 | yes | McMaster Carr (https://www.mcmaster.com/#5823k23/=19gv1vl) | McMaster Carr | 3/4" dampening standoffs for mounting backboard to container wall
3/4" NPT f-f slip hose adapter | hose_slip | 1 | $1.70 | $1.70 | 685707 | yes | Orbit (https://www.orbitonline.com/products/hose-watering) | Home Depot (http://www.homedepot.com/p/3-4-in-Slip-x-FHT-PVC-Hose-Fitting-53360/100130381) | Sch 40 PVC for all water routing
switch | switch | 4 | $29.15 | $116.60 | 708-1455-ND | yes | Bulgin (https://www.digikey.com/en/supplier-centers/b/bulgin) | Digikey (https://www.digikey.com/product-detail/en/bulgin/MPL031/708-1455-ND/1980812) | Switches for actuating solenoid valves
3/4" x 1.5" sch 40 PVC | pvc-075-002 | 16 | $1.90 | $1.90 | 193712 |  | JM Eagle (http://www.jmeagle.com/products) | Home Depot (http://www.homedepot.com/p/JM-eagle-3-4-in-x-10-ft-480-PSI-Schedule-40-PVC-Plain-End-Pipe-57471/202280935) | 1.5" length of schedule 40 3/4" PVC
3/4" x 3" sch 40 PVC | pvc-075-003 | 6 |  |  |  |  |  |  | 3" length of schedule 40 3/4" PVC
3/4" x 5" sch 40 PVC | pvc-075-005 | 1 |  |  |  |  |  |  | 5" length of schedule 40 3/4" PVC
3/4" x 7" sch 40 PVC | pvc-075-007 | 1 |  |  |  |  |  |  | 7" length of schedule 40 3/4" PVC
3/4" x 8" sch 40 PVC | pvc-075-005 | 2 |  |  |  |  |  |  | 8" length of schedule 40 3/4" PVC
3/4" x 9" sch 40 PVC | pvc-075-009 | 1 |  |  |  |  |  |  | 9" length of schedule 40 3/4" PVC
