OpenAgricultureFoundation/openag-mechanical/prj/hazelnut_large/LHC-001/1-Documentation/2019-10-1 Tree Pallet Heating Designs/Coil Design BOM.xlsx

Description | Quantity for 1 Assembly | Quantity for 4 Assemblies | Vendor | Vendor Part # | Vendor Cost | Cost for 4
48"x48" Pallet | 1 | 4 | McMaster Carr | 4123T38 | $120.58 | $482.32
Black Smart Pot #200 - 200 gallon (742 liters), 50″ base x 24″ height | 1 | 4 | Smart Pot | Black Smart Pot #200 | $52.75 | $211.00
3/4" x 4' x 8' Plywood Sheet (for the tubing guides) | 1 | 1 | Home Depot | Store SKU #165921 | $55.98 | $55.98
1-1/4 in. x 16 ft. Ratchet Tie-Down (4-Pack) | 1 | 4 | Home Depot | Store SKU #1001755669 | 16.97 | $67.88
Hard Polyethylene Tubing - 1/2 Copper Tube Size (Wrap Around) | 100 ft | 400 ft | McMaster Carr | 51275K88 | $102.00 | $408.00
Hard Polyethylene Tubing - 1/2 Copper Tube Size (to Wall Manifold) | - | 200 ft | McMaster Carr | 51275K88 | $102.00 | $204.00
Quick-Disconnect Tube Coupling Plug with Shut-Off, 3/8 Coupling Size, for 1/2" Barbed Tube ID | 2 | 8 | McMaster Carr | 5385K55 | 17.85 | $142.80
Quick-Disconnect Tube Coupling Barbed Socket with Shut-Off, 3/8 Coupling Size, for 1/2" Tube ID | 2 | 8 | McMaster Carr | 5385K25 | $22.92 | $183.36
Drywall Screws, 1-5/8" Long, 5lb box | 1 | 1 | Home Depot | Store SKU #757451 | $19.97 | $19.97
Barbed Tube Fitting Straight Adapter, for 1/2" Tube ID x 1/2 NPT Male | - | 8 | McMaster Carr | 3528T23 | $4.25 | $34.00
Barbed Hose Fitting Adapter for 1/2" Hose ID, 3/4 NPT Male | - | 4 | McMaster Carr | 5350K43 | $3.53 | $14.12
Anodized Aluminum Right-Angle Flow Manifold - 4 Outlets on One Side, 3/4 NPT x 1/2 NPT | - | 2 | McMaster Carr | 5469K206 | $89.16 | $178.32
 |  |  |  |  |  | $0.00
 |  |  |  |  |  | $0.00
TOTAL COST: |  |  |  |  | $515.27 | $2001.75
