OpenAgricultureFoundation/openag-mechanical/prj/hazelnut_large/LHC-001/1-Documentation/2019-10-18 CO2 Injection System/CO2 System Design BOM.xlsx

Description | Quantity for 1 Assembly | Vendor | Vendor Part # | Vendor Cost
Solenoid On/Off Valve for Chemicals Dark Gray PVC Body, 1/2 NPT Female | 1 | McMaster Carr | 4744K24 | $362.68
Compressed Air Filter/Regulator/Lubricator Zinc Body with Clear Polycarbonate Bowl, 1/2 NPT | 1 | McMaster Carr | 41555K53 | $211.95
Copper Tubing, 1/2 Trade size, 50' | 30 ft | McMaster Carr | 8955K171 | $256.94
Copper Tubing Elbows | 4 | McMaster Carr | 5520K603 | $13.64
Cylinder Rack Wall-Mount, Plastic, 10-1/2" Wide x 4" High x 2-1/2" Deep Overall | 1 | McMaster Carr | 2283T11 | $32.62
Industrial Grade Carbon Dioxide, 50 Pound Cylinder, CGA-320 (cost approximated) | 1 | AirGas | CD 50 | $300.00
Vibration-Damping Loop Clamp, 1/2" Pipe | 6 | McMaster Carr | 3225T27 | $12.09
Loop Hanger, 1/2" Pipe | 2 | McMaster Carr | 3064T110 | $8.00
Alternative to Solenoid On/Off Valve:
Day and Night CO2 Monitor and Controller for Greenhouses | 1 | Amazon/CO2Meter | B017847K76 | $199.00
TOTAL COST: |  |  |  | $1396.92
