OpenAgricultureFoundation/openag-mechanical/prj/hazelnut_large/LHC-001/1-Documentation/2018-2019 Large Tree Computer - Superceded Designs and Documentation/Large Hazelnut Light Assembly BOM.xlsx

Designation | Finalized in CAD | Purchased for 50 units | Description | Quantity for 1 Assembly | Quantity for 50 Assemblies | Vendor 01 | Vendor 01 Part # | Vendor 01 Cost | Cost for 50
Electronics | ✓ |  | Khatod 1825 silicone optic | 6 | 300 | Digikey (https://www.digikey.com/products/en?keywords=PL1825SR%E2%80%8E) | 1621-1007-ND | $11.38 | $3414.00
 | ✓ |  | 12" heat sink | 1 | 50 | Digikey (https://www.digikey.com/product-detail/en/aavid-thermal-division-of-boyd-corporation/416201U00000G/416201U00000G-ND/6131504) | 416201U00000G-ND | $102.11 | $5105.50
 | ✓ |  | Vero SE 5000K COB LED | 2 | 100 | Digikey (https://www.digikey.com/product-detail/en/bridgelux/BXRC-50C10K1-D-74-SE/976-1596-ND/6557098) | 976-1596-ND | $17.97 | $1797.00
 | ✓ |  | Vero SE 3000K COB LED | 2 | 100 | Digikey (https://www.digikey.com/product-detail/en/bridgelux/BXRC-30E10K0-D-73-SE/976-1590-ND/6557092) | 976-1590-ND | $17.97 | $1797.00
 | ✓ |  | Far red LED | 1 | 50 | https://www.aliexpress.com/store/product/CHANZON-1pc-High-Power-LED-Chip-10W-20W-30W-50W-100W-Warm-Natural-Cold-White-Red/1913069_32972014244.html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 | - | $11.50 | $575.00
 | N/A |  | Far red LED Driver
 | N/A |  | COB Driver | 1 | 50 | Digikey (https://www.digikey.com/product-detail/en/mean-well-usa-inc/HLG-600H-42B/1866-2579-ND/7704137) | 1866-2579-ND | $169.00 | $8450.00
 | ✓ |  | 7-pole plug male | 1 | 50 | https://www.digikey.com/product-detail/en/amphenol-sine-systems-corp/C016-30C006-100-12/361-1091-ND/1036135 | 361-1091-ND | $11.07 | $553.50
 | N/A |  | 7-pole plug female (currently ~40 in stock) | 1 | 20 | https://www.digikey.com/product-detail/en/amphenol-sine-systems-corp/C016-30D006-110-12/361-1372-ND/1647628 | 361-1372-ND | $9.13 | $182.60
 | N/A |  | 2-conductor wire
 | N/A |  | Heatsink compound | 0.05 | 2.5 | https://www.digikey.com/products/en?keywords=473-8329tcf-50ml-nd | 473-8329TCF-50ML-ND | $38.83 | 97.075
 |  |  | LED wire (black) |  | 5 | https://punchout.digikey.com/product-detail/en/alpha-wire/3051-1-RD005/A3051R-100-ND/281577 | A3051B-100-ND | $30.60 | $153.00
 |  |  | LED wire (red) |  | 5 | https://punchout.digikey.com/product-detail/en/alpha-wire/3051-1-BK005/A3051B-100-ND/281576 | A3051R-100-ND | $30.60 | $153.00
Fabrication Materials | ✓ |  | .09" x 48" x 48" aluminum plate (mounting plate) | 1 | 4 | McMaster Carr (https://www.mcmaster.com/89015k59) | 89015K59 | $191.80 | $767.20
 | ✓ |  | 1/8" x 48" x 24" ABS | 1 | 9 | https://www.mcmaster.com/8586k261 | 8586K261 | $46.67 | $420.03
 | ✓ |  | Foam gasket/spacer (neoprene) | 1 | 4 | https://www.mcmaster.com/8647k23 | 8647K23 | $52.92 | $211.68
 | ✓ |  | 6"x6"x3/4" Plastic mounting bracket, back of enclosure | 1 | 50 | https://www.mcmaster.com/4296A165 | 4296A165 | $11.81 | $590.50
 | ✓ |  | Custom end cap 1 | 1 | 50 | https://www.smooth-on.com/products/reoflex-50/ | Reoflex60A | $27.78 | $27.78
 | ✓ |  | Custom end cap 2 | 1 | 50 | https://www.smooth-on.com/products/reoflex-50/ | Reoflex60A | $117.88 | $117.88
 | N/A |  | Casting mold for end caps | 1 | 1 | https://www.smooth-on.com/products/reoflex-50/ | Reoflex30A | $27.78 | $27.78
Fluidics | ✓ |  | Plastic-metal hydronic fittings | 2 | 100 | https://www.mcmaster.com/9406t17 | 9406T170 | $6.45 | $645.00
 | ✓ |  | 3/8" OD, 1/4" ID x 1' PVC tubing (Masterkleer) | 20 | 1000 | https://www.mcmaster.com/5233k56 | 5233K56 | $0.28 | $280.00
 |  |  | Polypropylene, 3/8" Push-to-Connect on/off valve | 4 | 200 | https://www.mcmaster.com/4379k62 | 4379K62 | $9.03 | $1806.00
 | N/A |  | Glycol
 |  |  | Heat exhangers
Pre-Made Components | ✓ |  | Mounting arm | 1 | 50 | https://www.fleximounts.com/shop/monitor-mounts/fleximounts-height-adjustable-desk-monitor-mount-for-10-27-computer-monitor-from-8-8-22-lbs/ | M17 | $69.00 | $3450.00
 | ✓ |  | Custom metal enclosure (60 units) | 1 | 60 | ProFab | LHC-306 | $29.50 | $1770.00
Hardware | ✓ |  | 6-32 x 1/2" long SHCS | 2 | 100 | in house | - | - | -
 | ✓ |  | 6-32 nuts (box of 100) | 2 | 100 | https://www.mcmaster.com/96278a007 | 96278A007 | $7.90 | $7.90
 | ✓ |  | 8-32 Wing Nuts | 14 | 700 | https://www.mcmaster.com/90866a009 | 90866A009 | $0.09 | $64.61
 | ✓ |  | 8-32 lock nut | 6 | 300 | https://www.mcmaster.com/96278a009 | 96278A009 | $0.09 | $26.31
 | ✓ |  | 8-32 x 3/4" bolt (box of 25) | 10 | 500 | https://www.mcmaster.com/95345a548 | 95345A548 | $0.38 | $192.00
 | ✓ |  | 8-32 x 1" bolt (box of 25) | 6 | 300 | https://www.mcmaster.com/95345a554 | 95345A554 | $0.56 | $166.68
 | ✓ |  | 8-32 x 1-1/4" lock bolt (box of 25) | 2 | 100 | https://www.mcmaster.com/95345a555 | 95345A555 | $0.47 | $46.56
 | ✓ |  | 10-32 Wing Nuts | 4 | 200 | https://www.mcmaster.com/92001a311 | 92001a311 | $0.26 | $51.68
 | ✓ |  | 10-32 Truss Head Bolt | 4 | 200 | https://www1.mcmaster.com/91785a831 | 91785A831 | $0.12 | $23.56
 | ✓ |  | 1/4-20 7/8" long SHC | 4 | 200 | https://www.mcmaster.com/92196a541 | 92196A541 | $0.24 | $48.32
 | ✓ |  | 1/4" locknut | 4 | 200 | https://www.mcmaster.com/93776a421 | 93776A421 | $0.12 | $24.12
 | ✓ |  | Grommets | 2 | 100 | https://www.mcmaster.com/4946a2 | 4946A2 | $0.42 | $41.68
 | ✓ |  | 1/16" Neoprene Foam Spacer | 2 | 100 | https://www.mcmaster.com/8694k111 | 8694K111 | $8.42 | $8.42
 |  |  | 8-32 Low Profile bolt (box of 50) | 4 | 200 | https://www1.mcmaster.com/90665a115 | 90665A115 | $0.20 | $39.40
 |  |  | #10 oversized washers | 4 | 200 | https://www1.mcmaster.com/91525a109 | 91525A109 | $0.07 | $13.44
 |  |  | TOTAL COST: |  |  |  |  | $160.93 | $35553.93
 | potential solution, do not add to BOM |  | Quick-disconnect tube coupling, socket | 2 | 100 | McMaster Carr (https://www.mcmaster.com/51545k73) | 51545K73 | $18.63 | $1863.00
 |  |  | Quick-disconnect tube coupling, plug | 2 | 100 | McMaster Carr (https://www.mcmaster.com/51545k79) | 51545K79 | $13.55 | $1355.00
 |  |  | NEED COSTS AND VENDORS
 |  |  | HIGH PRIORITY ITEMS |  |  | 624
 |  |  |  |  |  | 1014
