OpenAgricultureFoundation/openag-mechanical/prj/germinator v3/8-14-18 Thermal Grease Testing Documentation/8-13-18 Thermal Grease Testing.xlsx

Sheet: Calculated Results
Thermal Grease | Thermal Conductivity | Unit Cost | Cost per gram | Temp @ Heat Sink | Temp @ Back of LEDs | ∆T (°C) | Tr
Techspray Heat Sink Compound (SKU #1978) | 1 W/m-k | $83/450g | $0.18 | 30.4 | 32 | 1.6 | 1.2
Halnziye Heat Sink Grease HY700 | 3.5 W/m-k | $15/100g | $0.15 | 29.4 | 31.1 | 1.7 | 1.3
Arctic MX-4 Thermal Compound | 8.5 W/m-k | $8/2g | $4.00 | 29.2 | 30.6 | 1.4 | 1.1
None (Control) (technically air) | .03 W/m-k | $0 | $0.00 | 29.2 | 30.5 | 1.3 | 1.0
Actual Wattage (W) | 94
Efficiency at Power Supply (%) | 90%
Efficiency at LED Driver (%) | 80%
Efficiency at LEDs (%) | 70%
Wattage at LEDs (W) | 47.376
Watts per LED (36 LEDs) | 1.3
Run time for each LED array (minutes) | 45

Sheet: RAW DATA
https://www.flir.com/support/products/flir-one-pro#Specifications
