OpenAgricultureFoundation/openag-mechanical/prj/hazelnut_large/LHC-001/1-Documentation/LHC-300 Light Assembly Fabrication Checklist - ONGOING.xlsx

LHC-300 SERIAL NUMBER | RED LED Y/N? | LED WIRING VERIFIED W/ DRIVER | LED BOARD AND HEATSINK DEGREASED | ASSEMBLED WITH ABS AND FOAM | ASSEMBLED INTO FINAL ENCLOSURE | CAPS ATTACHED | LED WIRING VERIFIED AGAIN | COMMENTS | Burn-in Testing Log (hrs total) | 2019-08-09 | 2019-08-13 | 2019-08-14 | 2019-08-15 | 2019-08-19 | 2019-08-21 | 2019-09-18 | 2019-10-09 | 2019-10-10
001 | N | ✓ | ✓ | ✓ | ✓ | ✓ | ✓ |  | 9 |  |  |  |  |  |  |  | 5 | 4
002 | N | ✓ | ✓ | ✓ | ✓ | ✓ | ✓
003 | N | ✓ | ✓ | ✓ | ✓ | ✓ | ✓
004 | N | ✓ | ✓ | ✓ | ✓ | ✓ | ✓
005 | N | ✓ | ✓ | ✓ | ✓ | ✓ | ✓
006 | N | ✓ | ✓ | ✓ | ✓ | ✓ | ✓
007 | N | ✓ | ✓ | ✓ | ✓ | ✓ | ✓
008 | N | ✓ | ✓ | ✓ | ✓ | ✓ | ✓
009 | N | ✓ | ✓ | ✓ | ✓ | ✓ | ✓
010 | N | ✓ | ✓ | ✓ | ✓ | ✓ | ✓
011 | N | ✓ | ✓ | ✓ | ✓ | ✓ | ✓ |  | 42 | 3 | 6 | 7 | 6 | 7 | 6 | 7
012 | N | ✓ | ✓ | ✓ | ✓ | ✓ | ✓
013 | N | ✓ | ✓ | ✓ | ✓ | ✓ | ✓
014 | N | ✓ | ✓ | ✓ | ✓ | ✓ | ✓
015 | N | ✓ | ✓ | ✓ | ✓ | ✓ | ✓
016 | N | ✓ | ✓ | ✓ | ✓ | ✓ | ✓
017 | N | ✓ | ✓ | ✓ | ✓ | ✓ | ✓ |  | 42 | 3 | 6 | 7 | 6 | 7 | 6 | 7
018 | N | ✓ | ✓ | ✓ | ✓ | ✓ | ✓ |  | 42 | 3 | 6 | 7 | 6 | 7 | 6 | 7
019 | N | ✓ | ✓ | ✓ | ✓ | ✓ | ✓
020 | N | ✓ | ✓ | ✓ | ✓ | ✓ | ✓
021 | N | ✓ | ✓ | ✓ | ✓ | ✓ | ✓
022 | N | ✓ | ✓ | ✓ | ✓ | ✓ | ✓
023 | N | ✓ | ✓ | ✓ | ✓ | ✓ | ✓
024 | N | ✓ | ✓ | ✓ | ✓ | ✓ | ✓
025 | N | ✓ | ✓ | ✓ | ✓ | ✓ | ✓ |  | 9 |  |  |  |  |  |  |  | 5 | 4
026 | N | ✓ | ✓ | ✓ | ✓ | ✓ | ✓
027 | N | ✓ | ✓ | ✓ | ✓ | ✓ | ✓
028 | N | ✓ | ✓ | ✓ | ✓ | ✓ | ✓
029 | N | ✓ | ✓ | ✓ | ✓ | ✓ | ✓
030 | N | ✓ | ✓ | ✓ | ✓ | ✓ | ✓
LHC-300 SERIAL NUMBER | RED LED Y/N? | LED WIRING VERIFIED W/ DRIVER | LED BOARD AND HEATSINK DEGREASED | ASSEMBLED WITH ABS AND FOAM | ASSEMBLED INTO FINAL ENCLOSURE | CAPS ATTACHED | LED WIRING VERIFIED AGAIN | COMMENTS
031 | N | ✓ | ✓ | ✓ | ✓ | ✓ | ✓
032 | N | ✓ | ✓ | ✓ | ✓ | ✓ | ✓
033 | N | ✓ | ✓ | ✓ | ✓ | ✓ | ✓ | center orange COB re-epoxied
034 | N | ✓ | ✓ | ✓ | ✓ | ✓ | ✓
035 | N | ✓ | ✓ | ✓ | ✓ | ✓ | ✓
036 | N | ✓ | ✓ | ✓ | ✓ | ✓ | ✓
037 | N | ✓ | ✓ | ✓ | ✓ | ✓ | ✓ |  | 9 |  |  |  |  |  |  |  | 5 | 4
038 | N | ✓ | ✓ | ✓ | ✓ | ✓ | ✓
039 | N | ✓ | ✓ | ✓ | ✓ | ✓ | ✓
040 | N | ✓ | ✓ | ✓ | ✓ | ✓ | ✓
041 | Y | ✓ | ✓ | ✓ | ✓ | ✓ | ✓
042 | Y | ✓ | ✓ | ✓ | ✓ | ✓ | ✓
043 | Y | ✓ | ✓ | ✓ | ✓ | ✓ | ✓
044 | Y | ✓ | ✓ | ✓ | ✓ | ✓ | ✓
045 | Y | ✓ | ✓ | ✓ | ✓ | ✓ | ✓
046 | Y | ✓ | ✓ | ✓ | ✓ | ✓ | ✓
047 | Y | ✓ | ✓ | ✓ | ✓ | ✓ | ✓
048 | Y | ✓ | ✓ | ✓ | ✓ | ✓ | ✓
049
050
051
052
053
054
055
056
057
058
059
060
