OpenAgricultureFoundation/openag-mechanical/prj/hazelnut_large/LHC-001/LHC-200/STRUT CHANNEL BOM.xlsx

ITEM # | PART # | QTY | COST | TOTAL
1 | 33145T44 | 15 | $23.83 | $357.45
2 | 3208T45 | 31 | $73.02 | $2263.62
3 | 33125T139 | 60 | $8.74 | $524.40
4 | 3208T299 | 15 | $42.72 | $640.80
5 | 3208T317 | 78 | $56.96 | $4442.88
6 | 33125T34 | 138 | $2.64 | $364.32
7 | 33125T92 | 48 | $7.99 | $383.52
8 | 33125T891 | 84 | $9.00 | $756.00
9 | 3208T62 | 14 | $67.64 | $946.96
10 | 33125T22 | 8 | $8.61 | $68.88
11 | 3208T66 | 6 | $121.00 | $726.00
12 | 3574T32 | 10 | $14.05 | $140.50
13 | 33125T163 | 6 | $4.32 | $25.92
bolts | 91286A201 | 750 | $0.25 | $189.00
nuts | 3259T14 | 750 | $1.58 | $1185.00
 |  |  | total: | $13015.25
