OpenAgricultureFoundation/openag-mechanical/prj/container 3 rack v2/container 2 led-fixture/v1.0/LightPanel.SLDASM

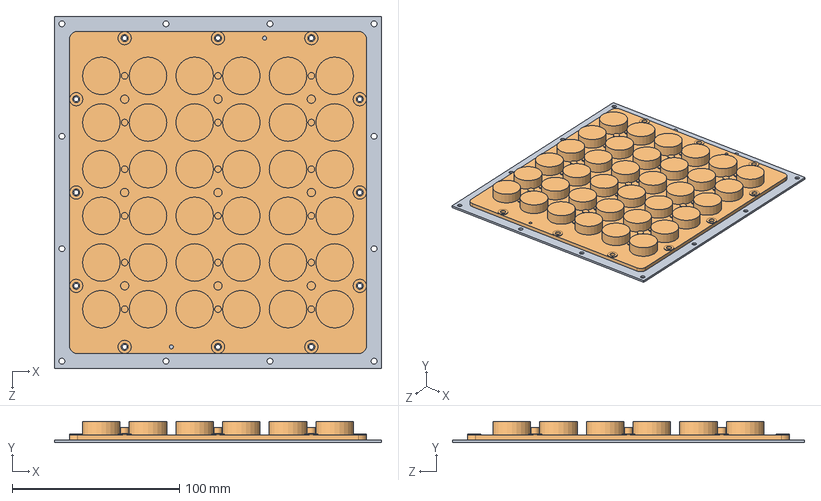
[picture p334: CAD file, 2019-07-03]
prj/container 3 rack v2/container 2 led-fixture/v1.0/LightPanel.SLDASM
195.8 x 12.6 x 210.8 mm
LightPCB
KNAC36xxADS_Optic
