OpenAgricultureFoundation/openag-mechanical/prj/container 3 rack v2/hanging-fan/fan-assembly.SLDASM

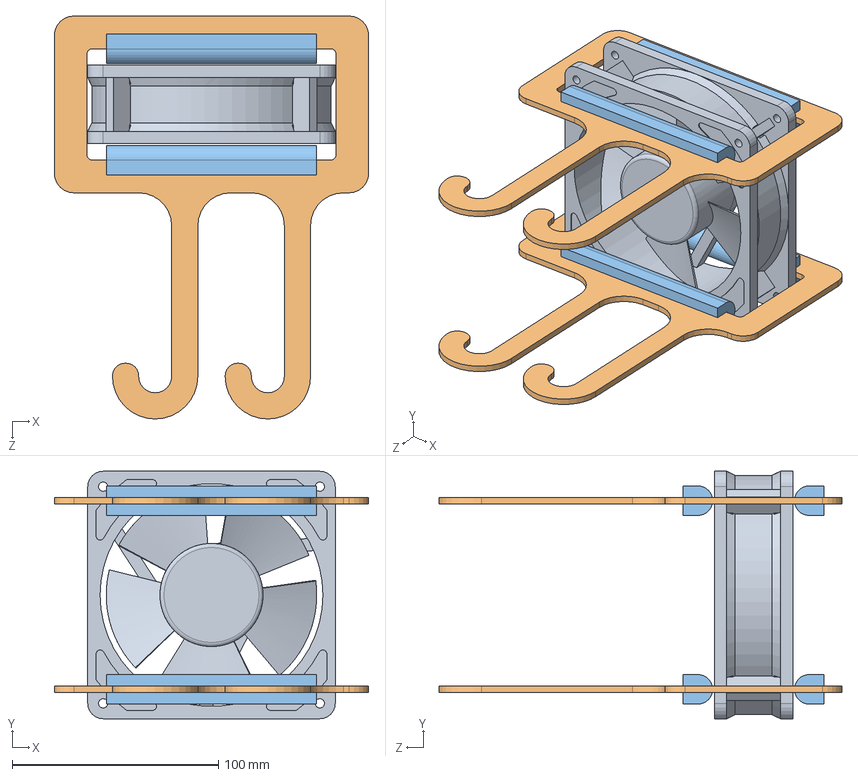
[picture p335: CAD file, 2019-07-03]
prj/container 3 rack v2/hanging-fan/fan-assembly.SLDASM
152.4 x 120.0 x 195.3 mm
9602K410_CORROSION-RESISTANT EQUIPMENT-COOLING FAN
fan-hooks x 2
93725K78 Ultra-Weather-Resistant EPDM Foam Strip x 4
