OpenAgricultureFoundation/openag-mechanical/prj/container 3 rack v2/Plumbing/shelf_insert_assembly.SLDASM

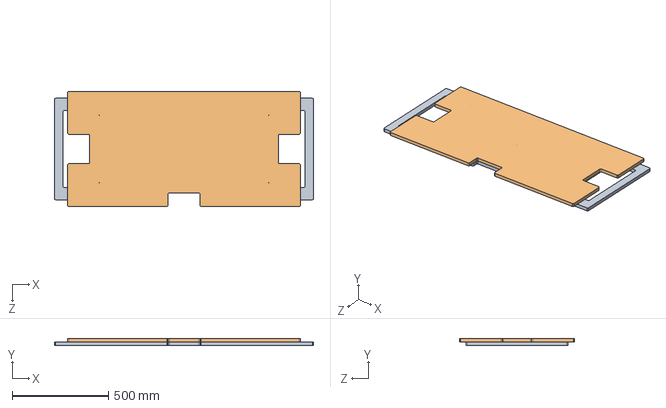
[picture p336: CAD file, 2019-07-03]
prj/container 3 rack v2/Plumbing/shelf_insert_assembly.SLDASM
1343.0 x 35.6 x 596.9 mm
shelf_insert01
shelf_insert_04
