OpenAgricultureFoundation/openag-mechanical/prj/hazelnut_large/LHC-001/LHC-200/forklift/FORKLIFTFULL.SLDASM

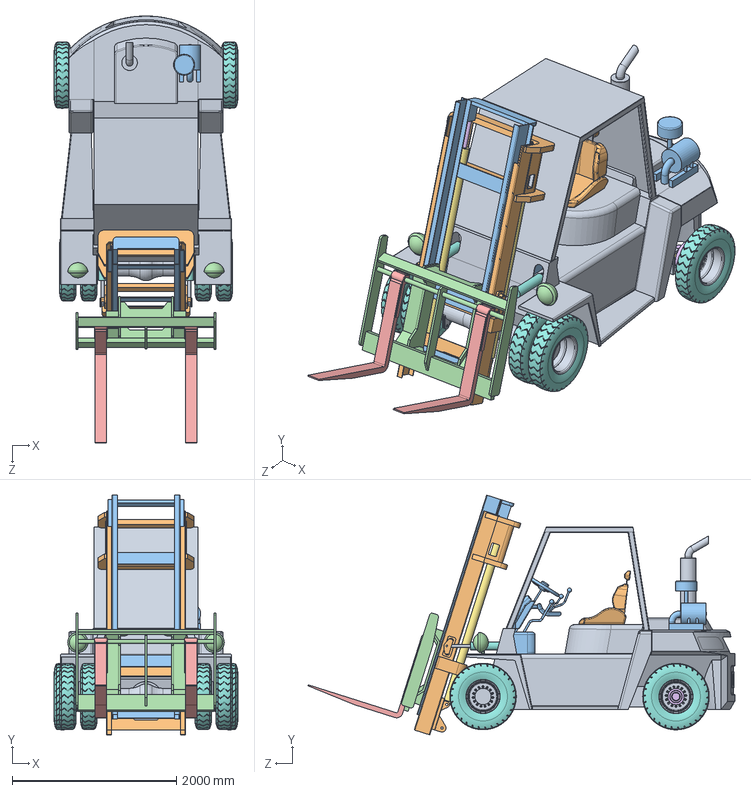
[picture p337: CAD file, 2019-03-18]
prj/hazelnut_large/LHC-001/LHC-200/forklift/FORKLIFTFULL.SLDASM
2235.6 x 2920.6 x 5199.9 mm
Partsteer
Partrearhub x 2
cyl10 x 2
push rod x 2
push rod2 x 2
cyl2 x 2
rim2SLDPRT x 6
pin x 2
light x 2
