OpenAgricultureFoundation/openag-mechanical/prj/hazelnut_large/LHC-001/LHC-200/Tree/Tree.SLDASM

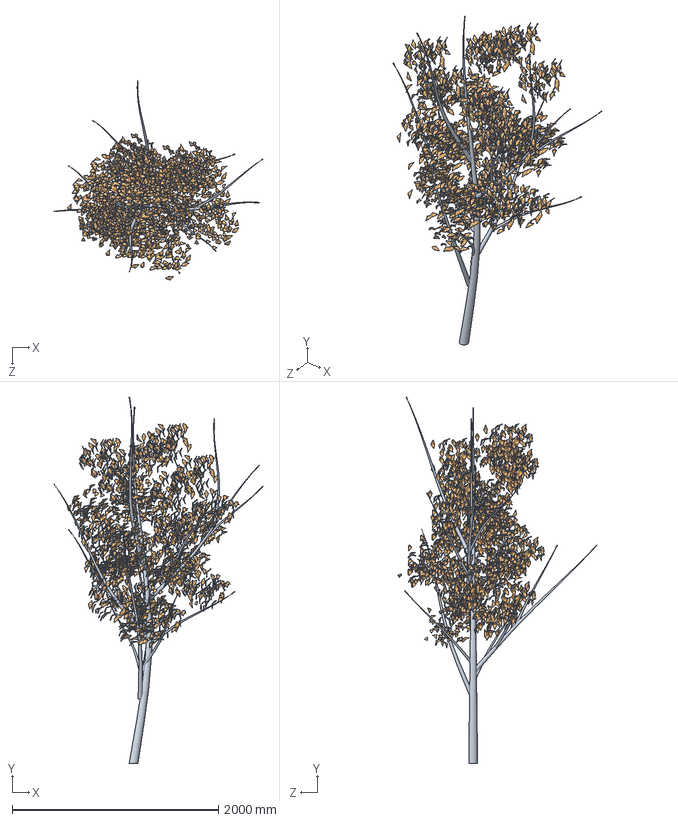
[picture p338: CAD file, 2019-10-22]
prj/hazelnut_large/LHC-001/LHC-200/Tree/Tree.SLDASM
2023.7 x 3552.7 x 1933.9 mm
Tr_1
Сборка1 x 29
