OpenAgricultureFoundation/openag-mechanical/prj/hazelnut_large/LHC-001/LHC-400/LHC-400.SLDASM

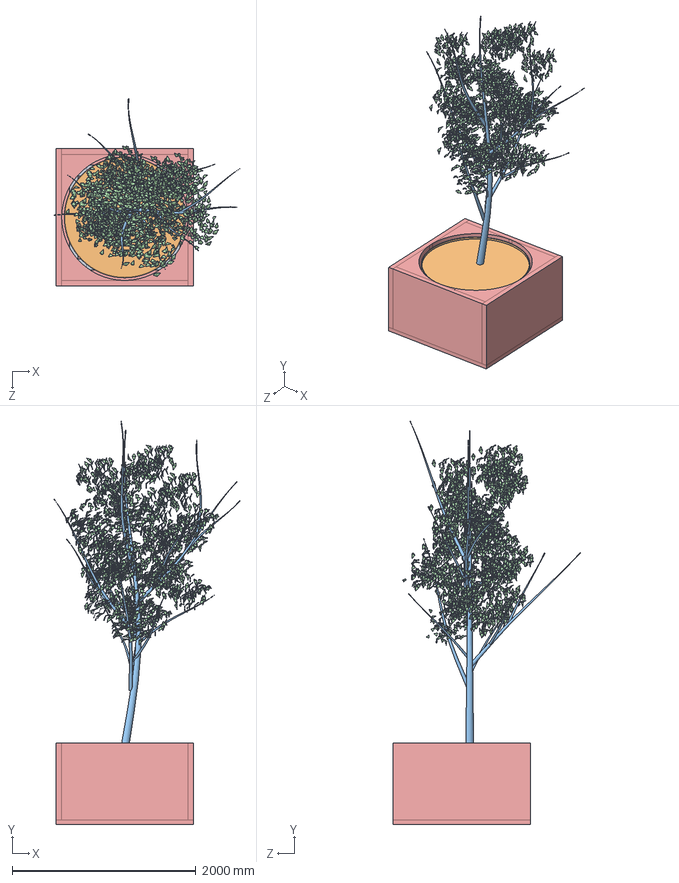
[picture p339: CAD file, 2019-10-24]
prj/hazelnut_large/LHC-001/LHC-400/LHC-400.SLDASM
2023.7 x 4386.4 x 2040.7 mm
wooden pallet
Smart Pots 100-Gallon Smart Pot Soft-Sided Container, Black
Tr_1
Сборка1 x 29
