OpenAgricultureFoundation/openag-mechanical/prj/hazelnut_large/v1.0/tims_test folder/1825 test/1825 test assembly.SLDASM

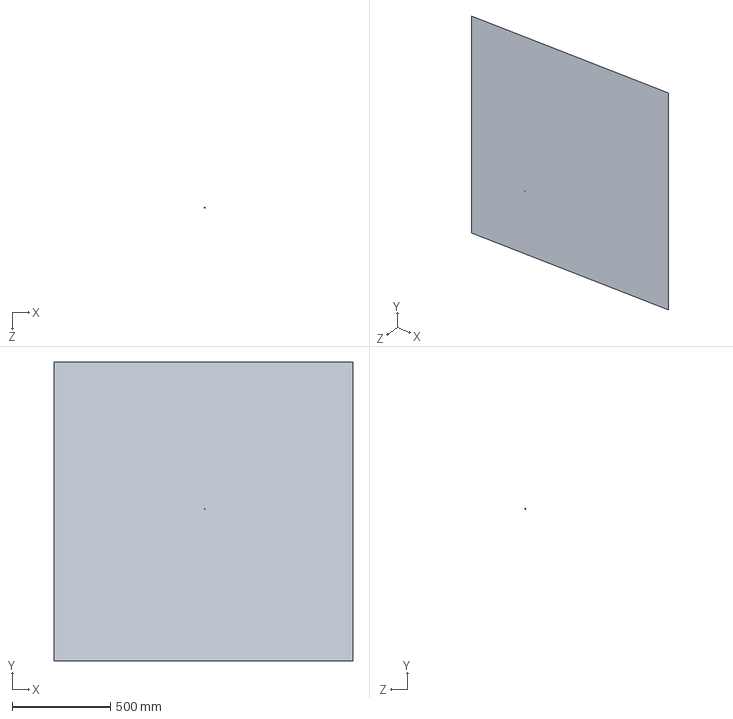
[picture p340: CAD file, 2019-01-23]
prj/hazelnut_large/v1.0/tims_test folder/1825 test/1825 test assembly.SLDASM
1524.0 x 1524.0 x 457.5 mm
hz_floor
ledlens75mm-spd2^1825 test assembly
