OpenAgricultureFoundation/openag-mechanical/prj/hazelnut_large/v1.0/tims_test folder/1825_ceiling_assemby.SLDASM

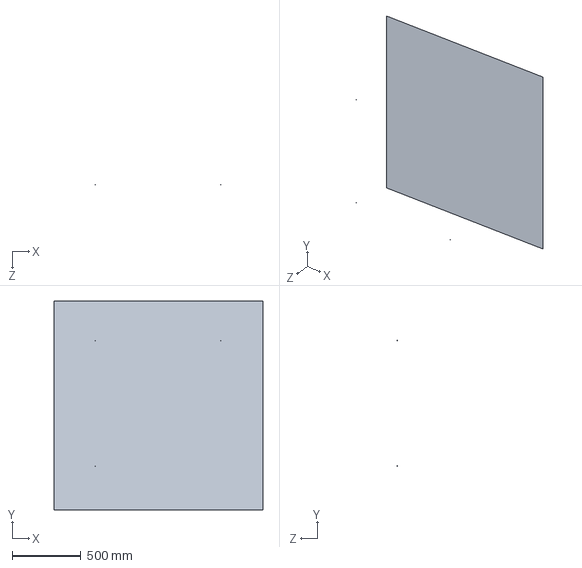
[picture p341: CAD file, 2019-01-25]
prj/hazelnut_large/v1.0/tims_test folder/1825_ceiling_assemby.SLDASM
1524.0 x 1524.0 x 762.2 mm
hz_floor
ledlens75mm-spd^1825_ceiling_assemby x 4
