OpenAgricultureFoundation/openag-mechanical/prj/hazelnut_small/v2-0/environments/frameworks/large_framework assembly.SLDASM

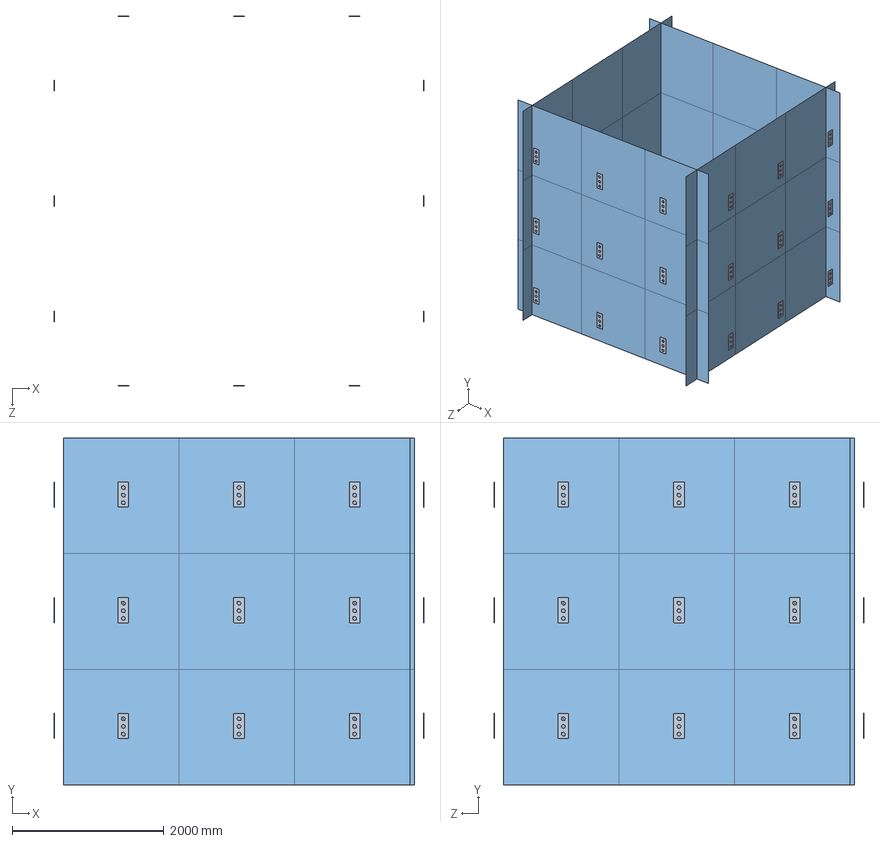
[picture p342: CAD file, 2019-02-21]
prj/hazelnut_small/v2-0/environments/frameworks/large_framework assembly.SLDASM
4876.8 x 4572.0 x 4876.8 mm
lhc-303 x 44
ledlens75mm-spd^lhc-308 x 88
5ft x 5ft Plane x 44
