OpenAgricultureFoundation/openag-mechanical/prj/hazelnut_small/v2-0/environments/rail_assembly.SLDASM

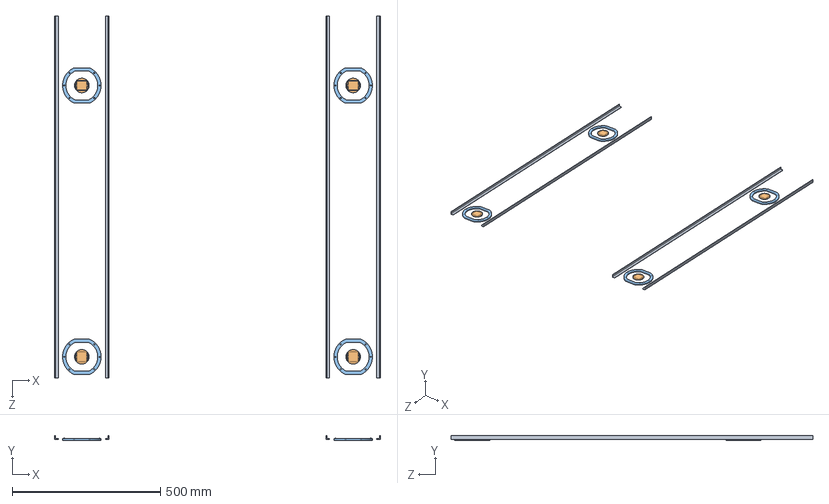
[picture p343: CAD file, 2019-02-08]
prj/hazelnut_small/v2-0/environments/rail_assembly.SLDASM
1098.6 x 15.5 x 1219.2 mm
aluminum_rail x 4
bridgelux x 4
optic_collar x 4
