OpenAgricultureFoundation/openag-mechanical/prj/hazelnut_small/v2-0/environments/sml_hz_chamber_current/master_assembly.SLDASM

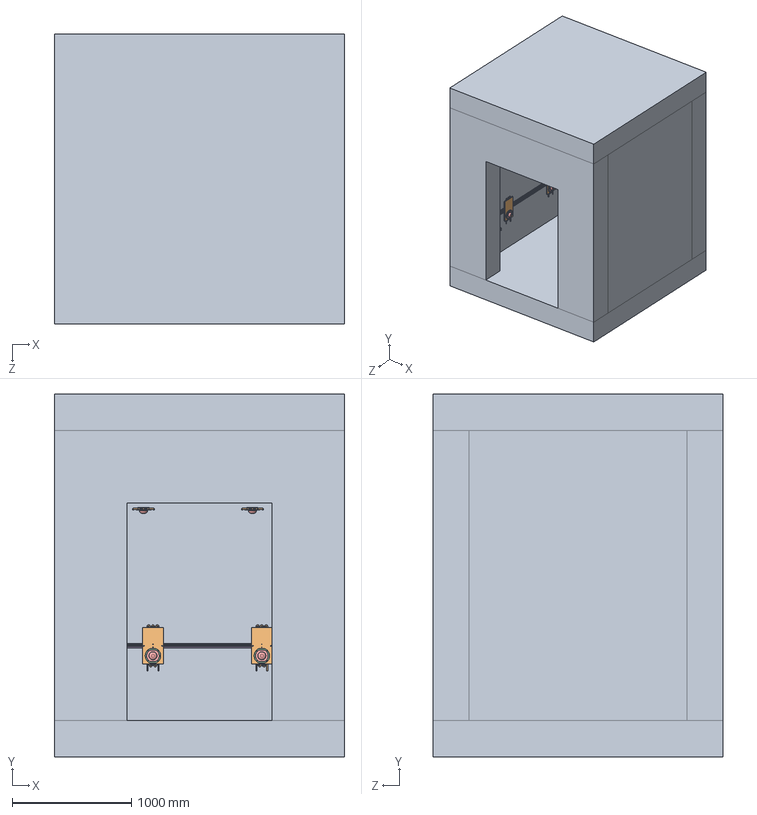
[picture p344: CAD file, 2019-02-08]
prj/hazelnut_small/v2-0/environments/sml_hz_chamber_current/master_assembly.SLDASM
2438.4 x 3048.0 x 2438.4 mm
box_panel x 6
aavid_heatsink x 12
bridgelux x 12
optic_collar x 12
khatod_1825_mock x 12
aluminum_rail x 4
