OpenAgricultureFoundation/openag-mechanical/prj/hazelnut_small/v2-0/photopia/photopia_tutorial_assembly.SLDASM

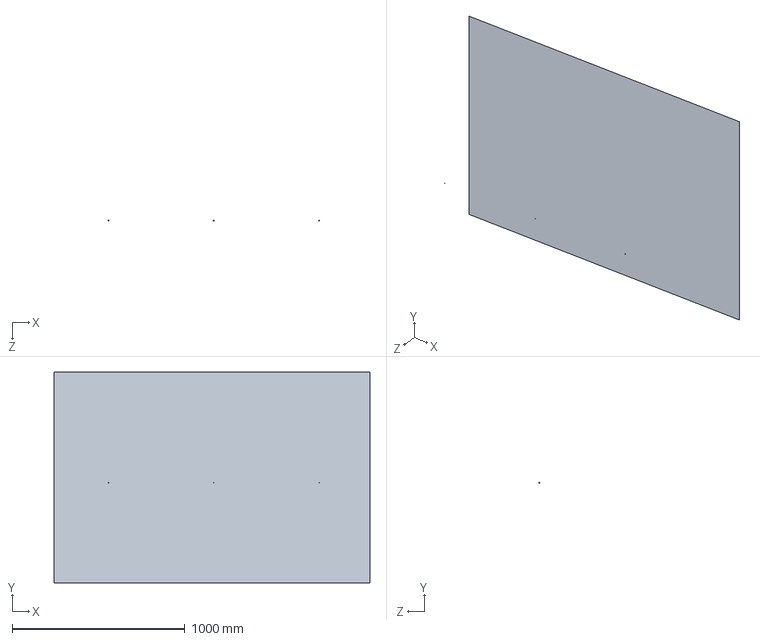
[picture p345: CAD file, 2019-01-17]
prj/hazelnut_small/v2-0/photopia/photopia_tutorial_assembly.SLDASM
1828.8 x 1219.2 x 609.8 mm
4ft x 6ft Plane
ledlens75mm-spd^photopia_tutorial_assembly x 4
