OpenAgricultureFoundation/openag-mechanical/prj/led-fixture/v1.0/LFR.101.SLDASM

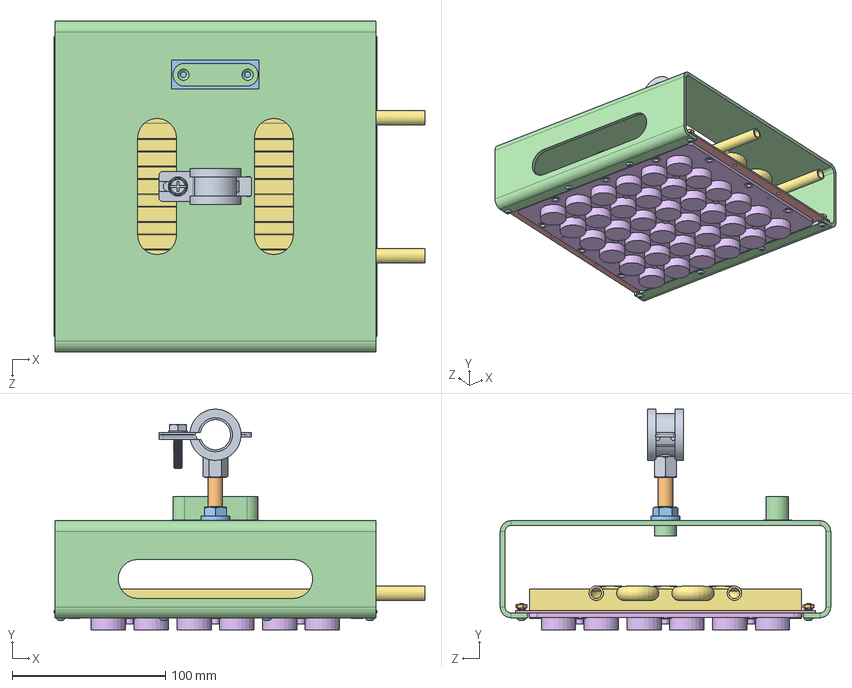
[picture p346: CAD file, 2018-07-19]
prj/led-fixture/v1.0/LFR.101.SLDASM
242.2 x 144.1 x 215.9 mm
2615T130_VIBRATION-DAMPING CLAMPING HANGER
92386A632_SS THRD-LOCKING ADJUSTING POSITIONING STUD
93776A461_TYPE 18-8 SS SERRATED-FLANGE LOCKNUT
LFR.001
LightPCB
KNAC36xxADS_Optic
aavid_heatsink
92949A133_18-8 SS BUTTON-HEAD SOCKET CAP SCREW x 8
94241A230_TYPE 316 STAINLESS STEEL SPLIT LOCK WASHER x 8
90730A006_TYPE 18-8 STAINLESS STEEL NARROW HEX NUT x 8
76665A68_VHB_TAPE
3338A22_HORIZONTAL_SURFACE_MOUNT_LEVEL
