OpenAgricultureFoundation/openag-mechanical/prj/pfc-edu/Corrugated Plastic PFC/PFC.200 - 6x6x6 corrugated PFC/PFC.200.SLDASM

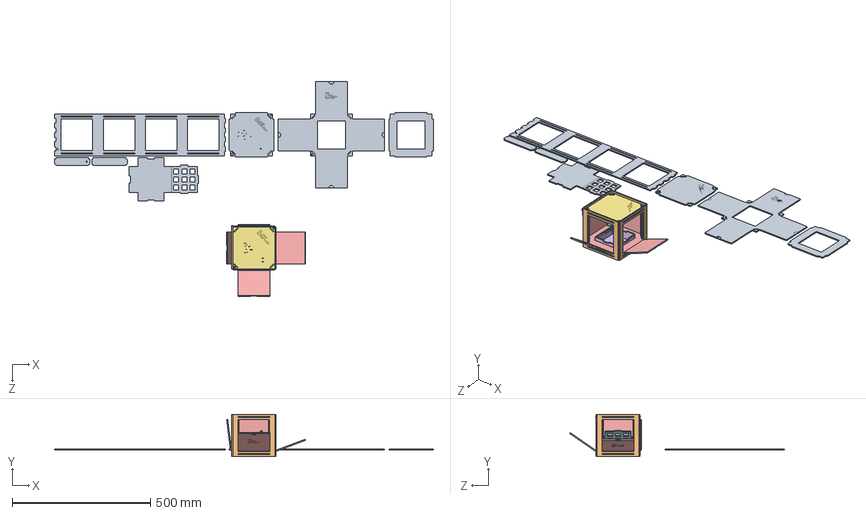
[picture p347: CAD file, 2019-09-18]
prj/pfc-edu/Corrugated Plastic PFC/PFC.200 - 6x6x6 corrugated PFC/PFC.200.SLDASM
1371.9 x 152.4 x 777.3 mm
PFC.201 x 4
PFC.202
PFC.203 x 4
PFC.204 x 5
PFC.205
PFC.207
PFC.208
