OpenAgricultureFoundation/openag-mechanical/prj/pfc-edu/Corrugated Plastic PFC/PFC.300 - 4x4x4 corrugated PFC/PFC.300.SLDASM

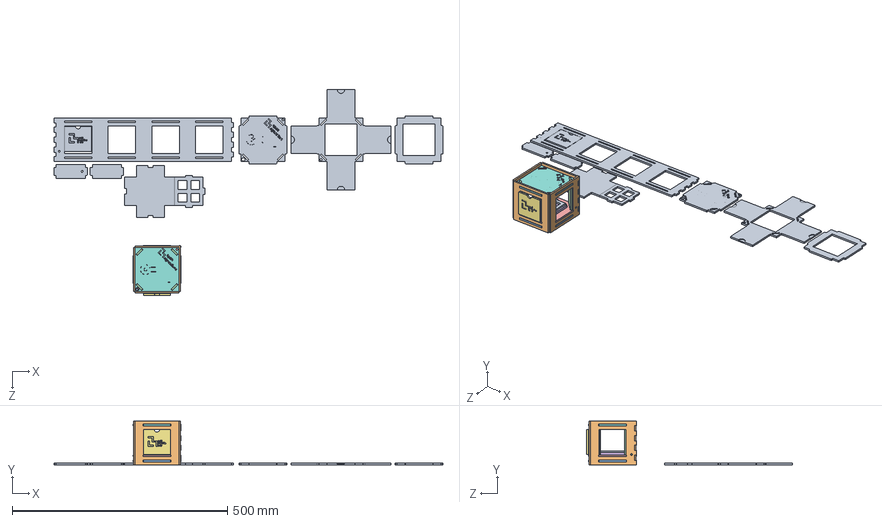
[picture p348: CAD file, 2019-06-13]
prj/pfc-edu/Corrugated Plastic PFC/PFC.300 - 4x4x4 corrugated PFC/PFC.300.SLDASM
902.7 x 101.6 x 477.6 mm
PFC.301 x 4
PFC.302
PFC.303 x 4
PFC.304
PFC.305
PFC.306
PFC.307
PFC.308
