OpenAgricultureFoundation/openag-mechanical/prj/container 3 rack v2/container 2 led-fixture/v1.0/LFR.102.SLDASM

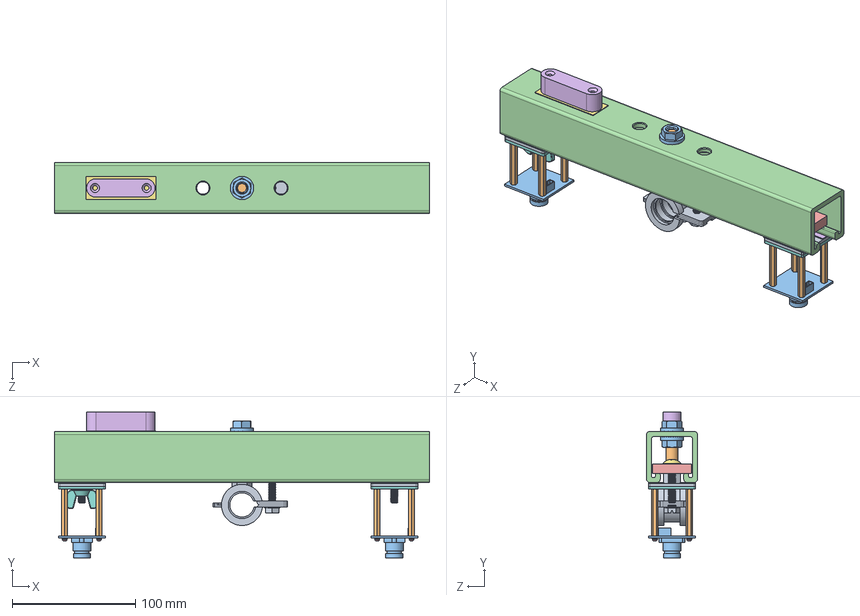
[picture p349: CAD file, 2019-07-03]
prj/container 3 rack v2/container 2 led-fixture/v1.0/LFR.102.SLDASM
304.8 x 118.3 x 41.3 mm
2615T130_VIBRATION-DAMPING CLAMPING HANGER
92386A632_SS THRD-LOCKING ADJUSTING POSITIONING STUD
93776A461_TYPE 18-8 SS SERRATED-FLANGE LOCKNUT x 2
LFR.005
2233K150_STRUT CHANNEL TAB-LOCK NUT x 2
LFR.007 x 4
91770A544_18-8 SS TRUSS HEAD PHILLIPS MACHINE SCREW x 2
LFR.003 x 2
LFR.004 x 2
91115A819_18-8 SS FEM THRDED HEX STANDOFF x 8
5 megapixel USB camera model ELP-USB500W02M-L21 x 2
92147A410_TYPE 316 STAINLESS STEEL SPLIT LOCK WASHER x 16
92949A077_18-8 SS BUTTON-HEAD SOCKET CAP SCREW x 16
3338A22_HORIZONTAL_SURFACE_MOUNT_LEVEL
76665A68_VHB_TAPE
94924A600_NYLON 6-6 WING NUTS
