OpenAgricultureFoundation/openag-mechanical/prj/container 3 rack v2/Plumbing/straight_assembly.SLDASM

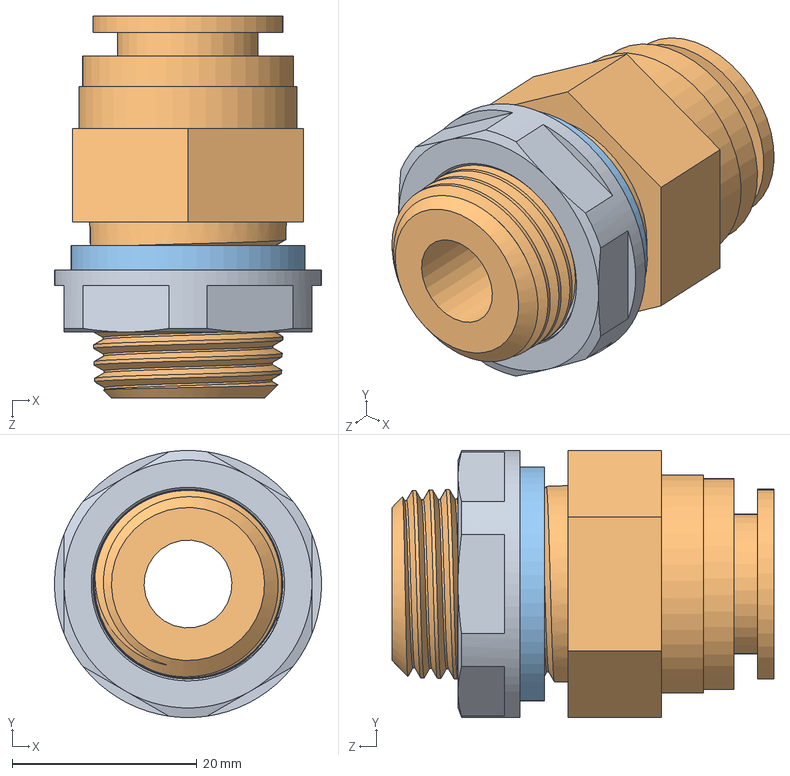
[picture p350: CAD file, 2019-07-03]
prj/container 3 rack v2/Plumbing/straight_assembly.SLDASM
29.0 x 29.0 x 41.4 mm
true_npt_nut
through-wall-black
hrd-050-gasket
