OpenAgricultureFoundation/openag-mechanical/prj/hazelnut_large/LHC-001/LHC-200/forklift/Assem6.SLDASM

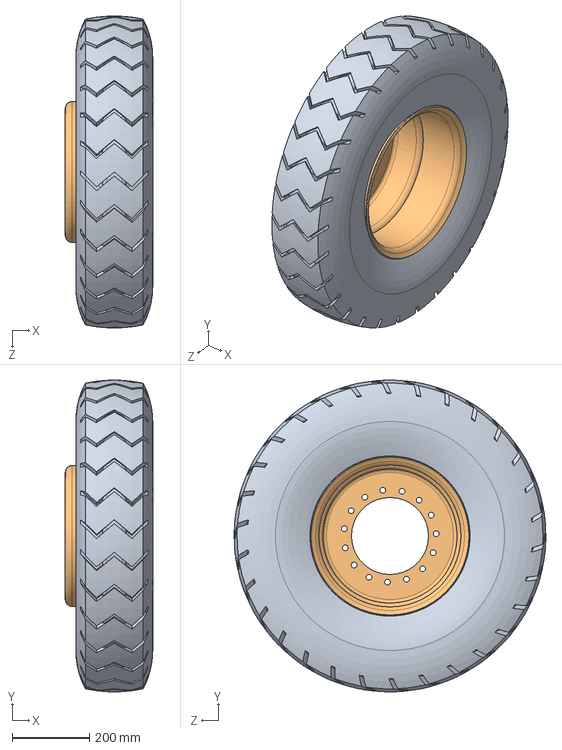
[picture p351: CAD file, 2019-03-18]
prj/hazelnut_large/LHC-001/LHC-200/forklift/Assem6.SLDASM
227.4 x 810.0 x 809.3 mm
rim2SLDPRT
