OpenAgricultureFoundation/openag-mechanical/prj/hazelnut_large/v1.0/rededge/rededge_assembly.SLDASM

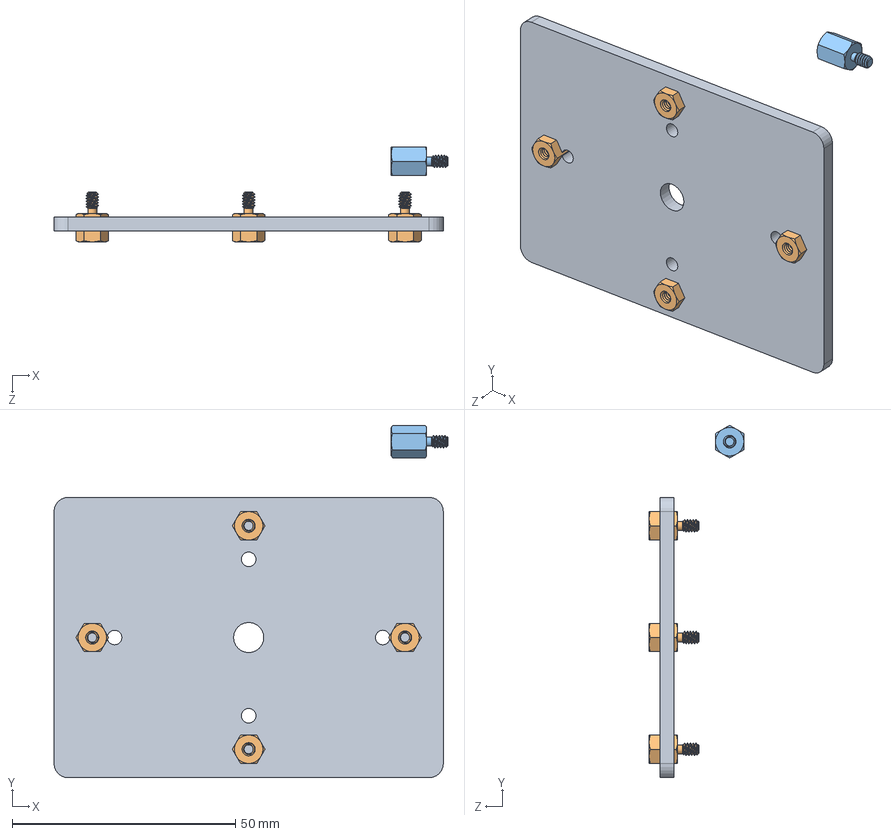
[picture p352: CAD file, 2018-08-10]
prj/hazelnut_large/v1.0/rededge/rededge_assembly.SLDASM
88.2 x 78.9 x 21.2 mm
rededge_mount
standoff.sldprt x 4
standoff_516
