OpenAgricultureFoundation/openag-mechanical/prj/hazelnut_small/v2-0/environments/sml_hz_chamber_current/small box assembly.SLDASM

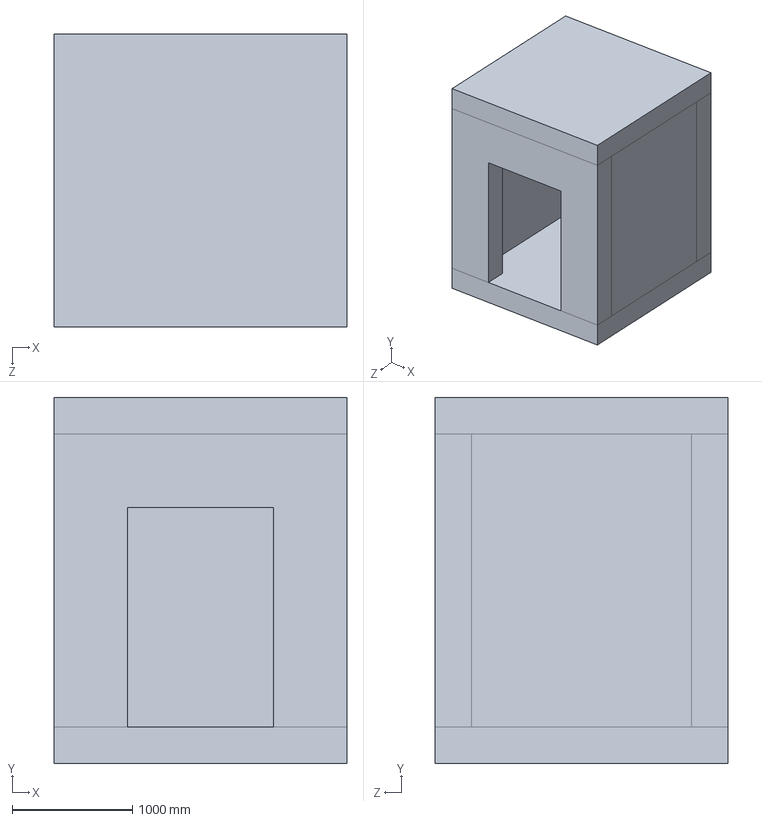
[picture p353: CAD file, 2019-02-08]
prj/hazelnut_small/v2-0/environments/sml_hz_chamber_current/small box assembly.SLDASM
2438.4 x 3048.0 x 2438.4 mm
box_panel x 6
