OpenAgricultureFoundation/openag-mechanical/prj/hazelnut_small/v2-0/environments/SML_LIGHT MODULE/small_hz_module assembly.SLDASM

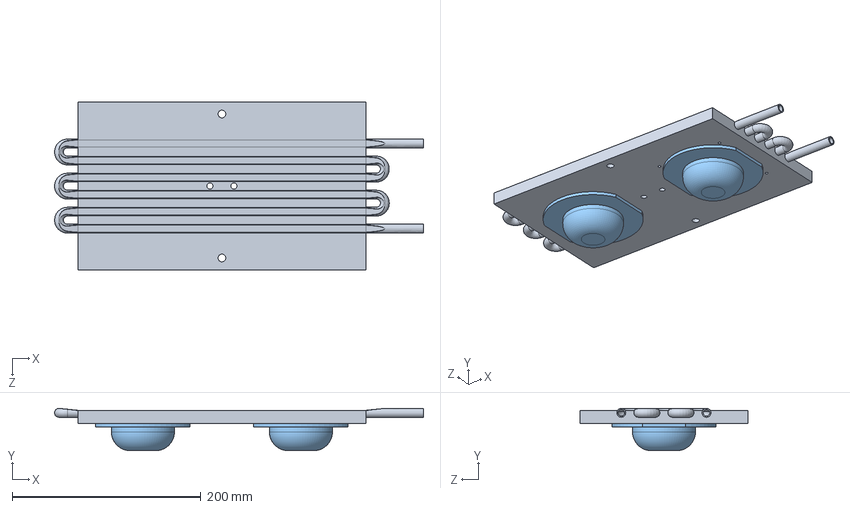
[picture p354: CAD file, 2019-02-14]
prj/hazelnut_small/v2-0/environments/SML_LIGHT MODULE/small_hz_module assembly.SLDASM
390.6 x 44.8 x 177.8 mm
aavid_heatsink
bridgelux
khatod_1825_mock x 2
Mirrorbridgelux
