OpenAgricultureFoundation/openag-mechanical/prj/container 1/RCK.201/reservroir_assembly.SLDASM

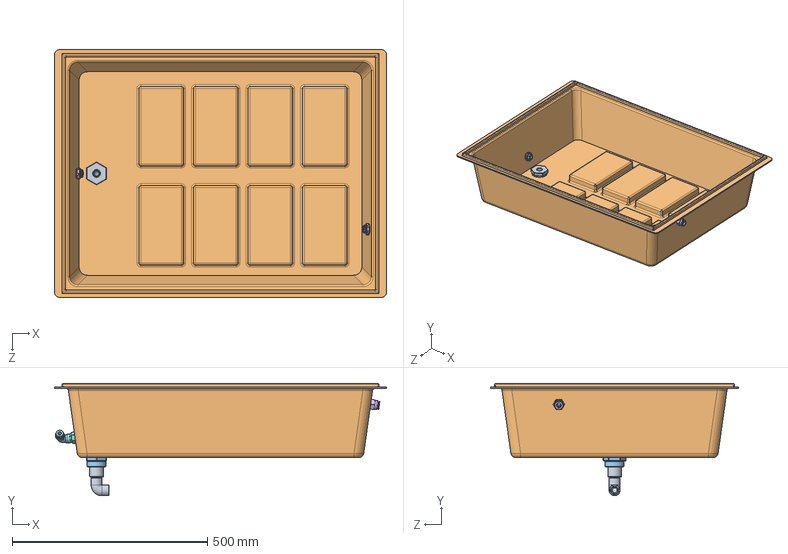
[picture p355: CAD file, 2019-09-18]
prj/container 1/RCK.201/reservroir_assembly.SLDASM
850.9 x 288.3 x 635.0 mm
drain
drain_gasket
drain_nut
TRUE_NIPPLE
true_npt_nut x 2
through-wall-black
hrd-050-gasket x 2
through-wall-90
threaded_threaded_90
GMR.505
