OpenAgricultureFoundation/openag-mechanical/prj/container 3 rack v2/Plumbing/manifold_intake.SLDASM

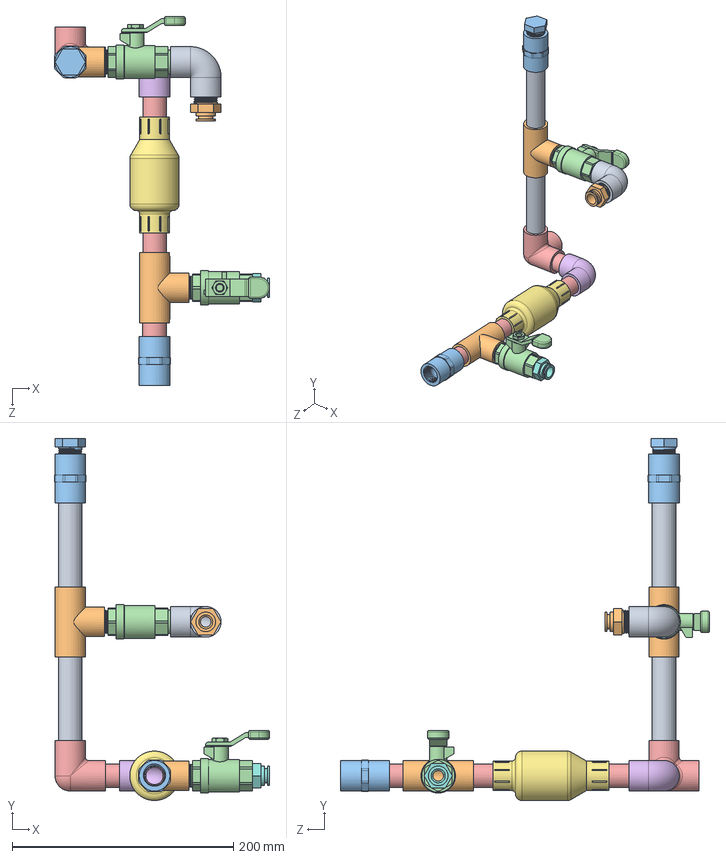
[picture p356: CAD file, 2019-07-03]
prj/container 3 rack v2/Plumbing/manifold_intake.SLDASM
194.5 x 327.4 x 333.7 mm
pvc-050-0045 x 2
threaded_tee x 2
new adapter x 2
TRUE_NIPPLE
pvc-050-0015 x 4
unthreaded 90
BACKFLOW
connector_orange
double thread
backflow_inlet
cap
short valve x 2
side-outlet-elbow
