OpenAgricultureFoundation/openag-mechanical/prj/fs-waterbot/v1.0/solidworks/solenoid_assembly.SLDASM

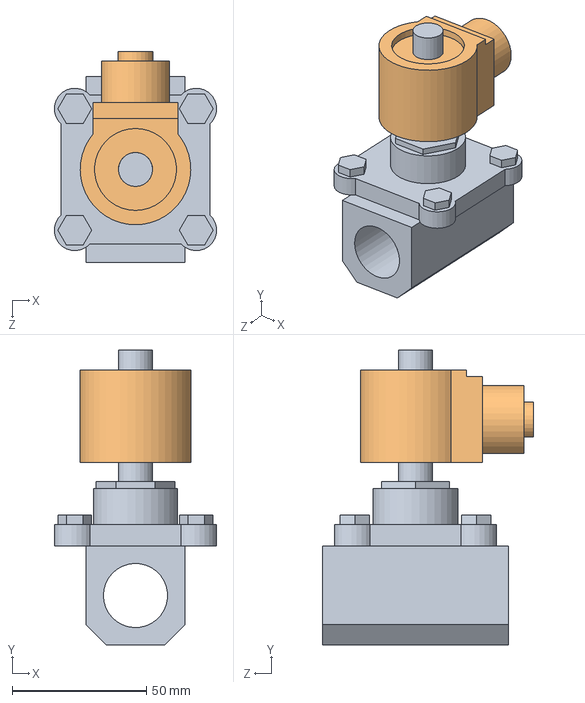
[picture p357: CAD file, 2018-05-29]
prj/fs-waterbot/v1.0/solidworks/solenoid_assembly.SLDASM
60.4 x 109.8 x 78.6 mm
solenoid_body
solenoid_valve
