OpenAgricultureFoundation/openag-mechanical/prj/hazelnut_large/v1.0/hz_light_test_manifold/manifold_assembly.SLDASM

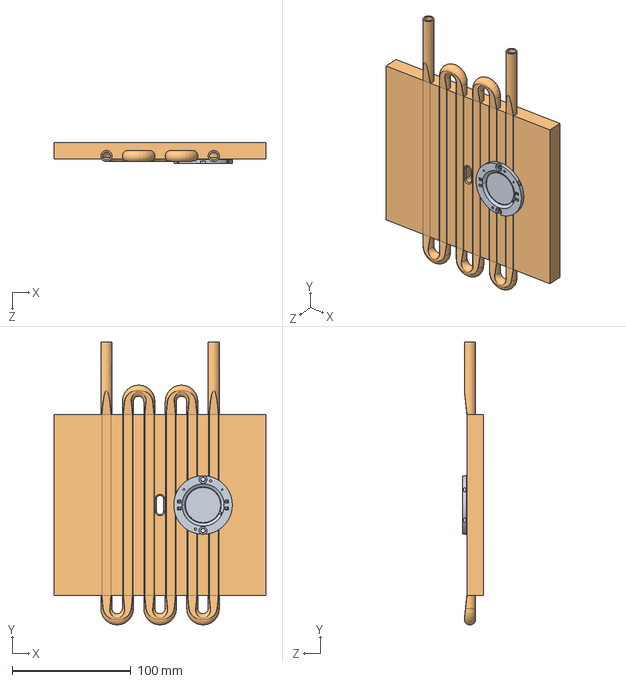
[picture p358: CAD file, 2019-01-14]
prj/hazelnut_large/v1.0/hz_light_test_manifold/manifold_assembly.SLDASM
177.8 x 237.8 x 17.6 mm
Bridgelux-VeroSE29-M-STP-17-000021-RA
heatsink
