OpenAgricultureFoundation/openag-mechanical/prj/hazelnut_large/v1.0/tims_test folder/large heatsink assembly.SLDASM

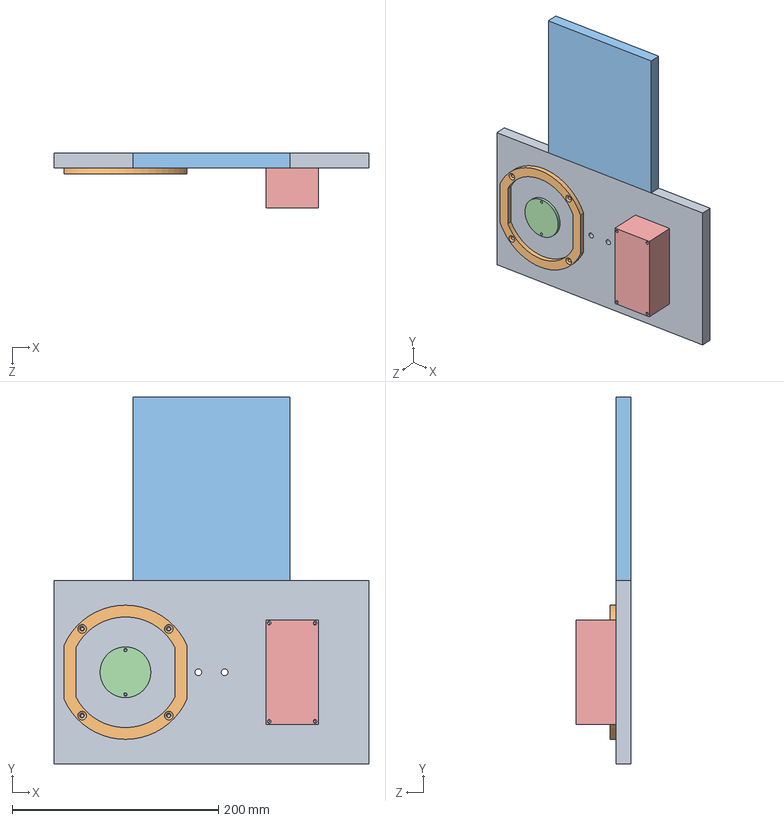
[picture p359: CAD file, 2019-01-23]
prj/hazelnut_large/v1.0/tims_test folder/large heatsink assembly.SLDASM
304.8 x 355.6 x 52.8 mm
heatsink_large
optic_collar
bridgelux_mock
erp_driver_mock
