OpenAgricultureFoundation/openag-mechanical/prj/hazelnut_small/v2-0/environments/SML_LIGHT MODULE/small_hz_module_test assembly.SLDASM

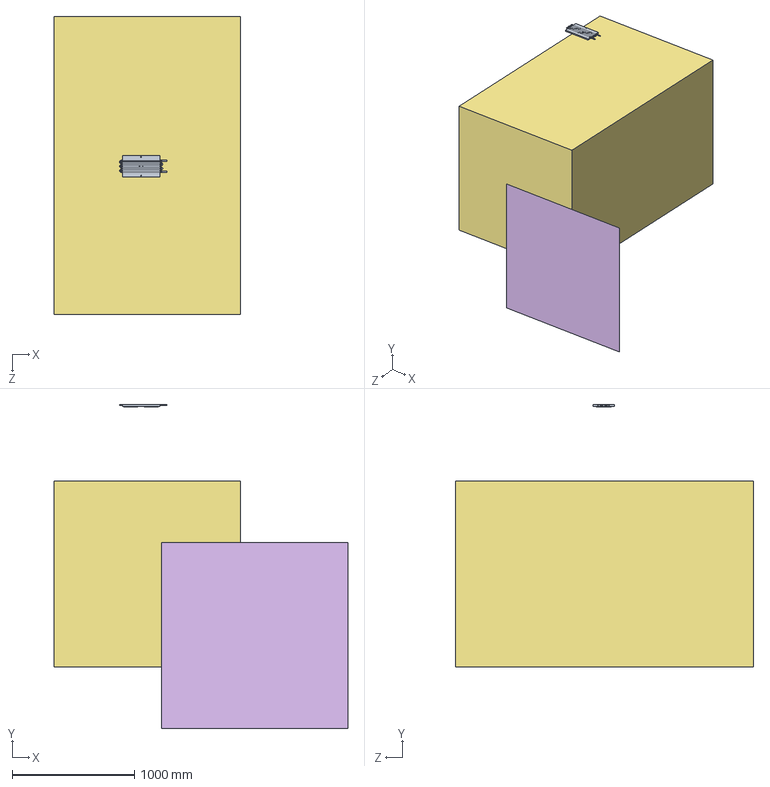
[picture p360: CAD file, 2019-02-12]
prj/hazelnut_small/v2-0/environments/SML_LIGHT MODULE/small_hz_module_test assembly.SLDASM
2404.8 x 2655.2 x 2742.7 mm
aavid_heatsink
bridgelux
optic_collar x 2
Mirrorbridgelux
ledlens75mm-spd^small_hz_module assembly x 2
5ft x 5ft Plane
lrg_tree_mock
