OpenAgricultureFoundation/openag-mechanical/prj/container 3 rack v2/Plumbing/90_assembly.SLDASM

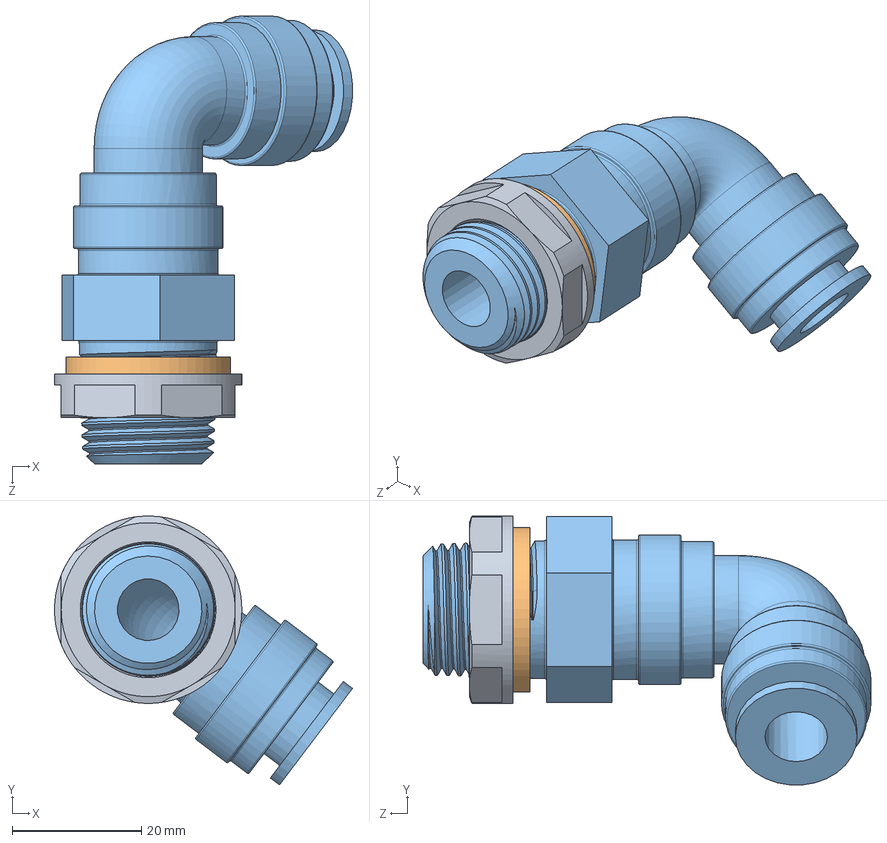
[picture p361: CAD file, 2019-07-03]
prj/container 3 rack v2/Plumbing/90_assembly.SLDASM
46.0 x 41.5 x 69.2 mm
true_npt_nut
hrd-050-gasket
through-wall-90
