OpenAgricultureFoundation/openag-mechanical/prj/hazelnut_large/LHC-001/LHC-200/Tree/Сборка большой кроны.SLDASM

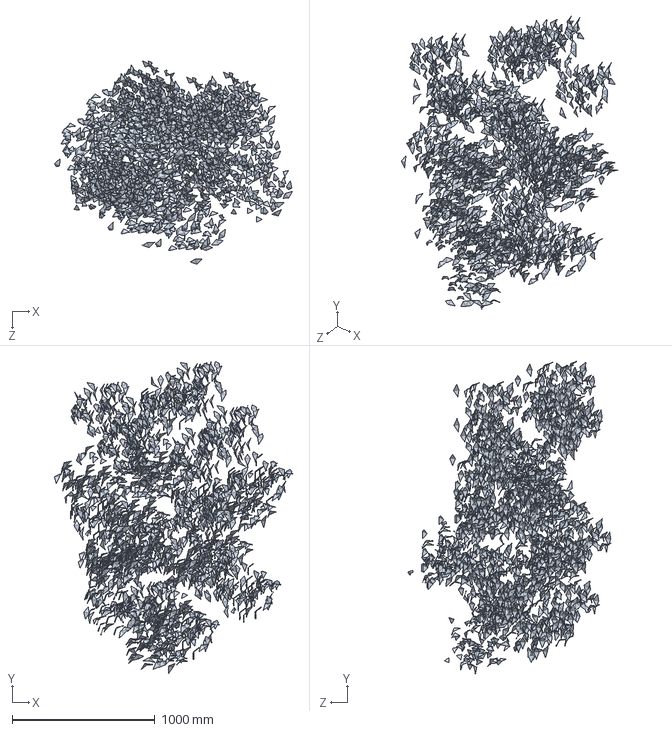
[picture p362: CAD file, 2019-10-22]
prj/hazelnut_large/LHC-001/LHC-200/Tree/Сборка большой кроны.SLDASM
1665.0 x 2182.2 x 1422.9 mm
Сборка1 x 29
