OpenAgricultureFoundation/openag-mechanical/prj/pfc-edu/Corrugated Plastic PFC/PFC.100 - 12x12x12 corrugated PFC/PFC.100.SLDASM

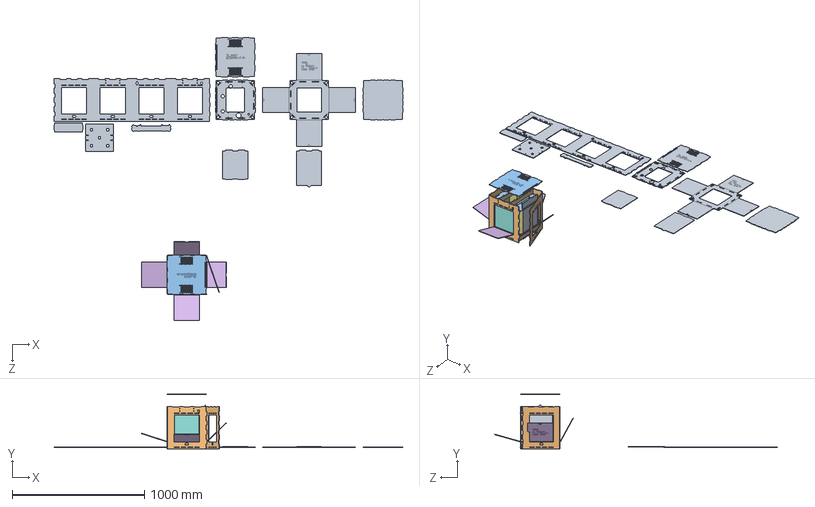
[picture p363: CAD file, 2019-09-18]
prj/pfc-edu/Corrugated Plastic PFC/PFC.100 - 12x12x12 corrugated PFC/PFC.100.SLDASM
2640.6 x 415.5 x 2141.8 mm
PFC.101 x 4
PFC.102
PFC.105
PFC.103
PFC.104 x 4
PFC.107 x 4
PFC.110 x 3
PFC.111
PFC.109 x 2
PFC.106
PFC.108
PFC.112
