OpenAgricultureFoundation/openag-mechanical/prj/container 3 rack v2/Plumbing/manifold_outlet.SLDASM

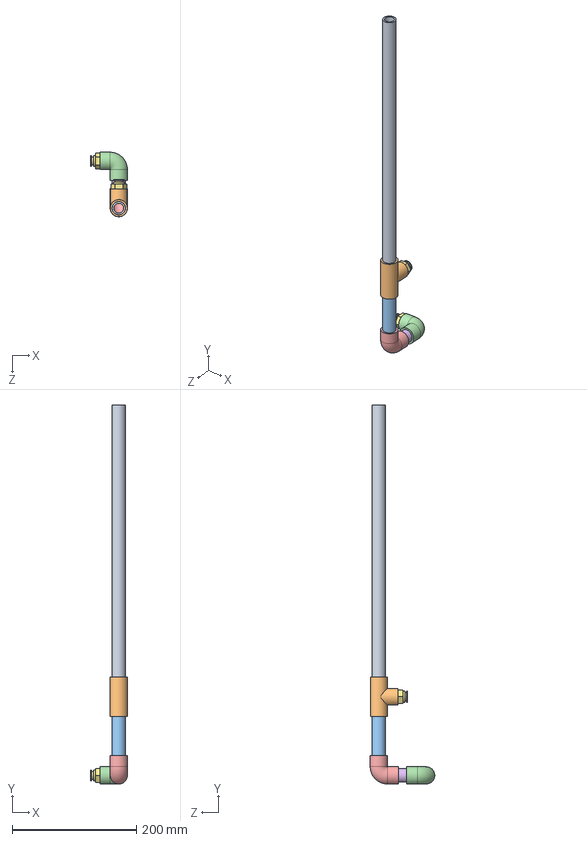
[picture p364: CAD file, 2019-07-03]
prj/container 3 rack v2/Plumbing/manifold_outlet.SLDASM
59.3 x 609.8 x 104.0 mm
pvc-050-018
threaded_tee
pvc-050-004
my90
unthreaded 90
pvc-050-002
connector_orange x 2
