OpenAgricultureFoundation/openag-mechanical/prj/hazelnut_large/LHC-001/8-Light Documentation and Simulations/lhc-414.SLDASM

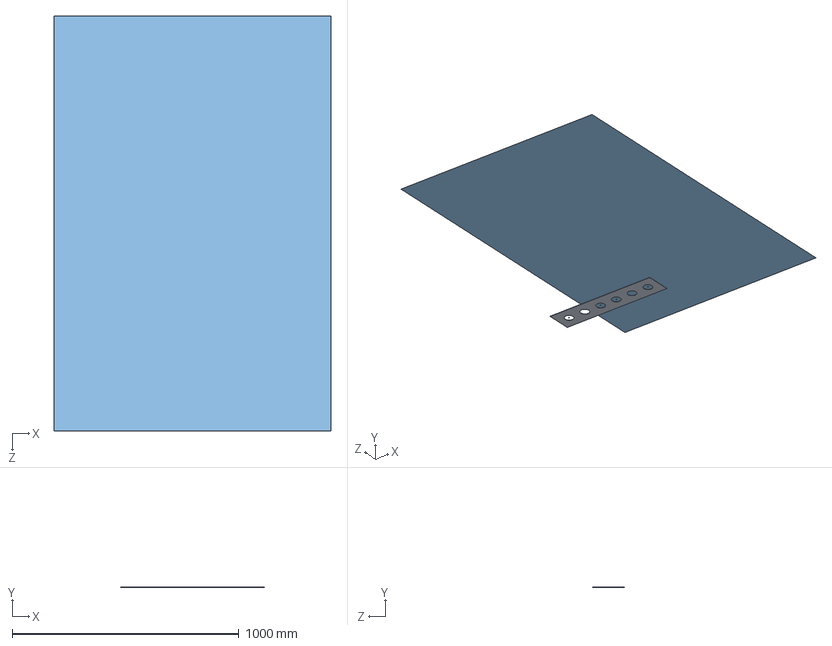
[picture p365: CAD file, 2019-03-12]
prj/hazelnut_large/LHC-001/8-Light Documentation and Simulations/lhc-414.SLDASM
1219.2 x 458.8 x 1828.8 mm
lhc-312
ledlens75mm-spd^lhc-314 x 4
5ft x 4ft Plane
