OpenAgricultureFoundation/openag-mechanical/prj/container 3 rack v2/cart_assembly.SLDASM

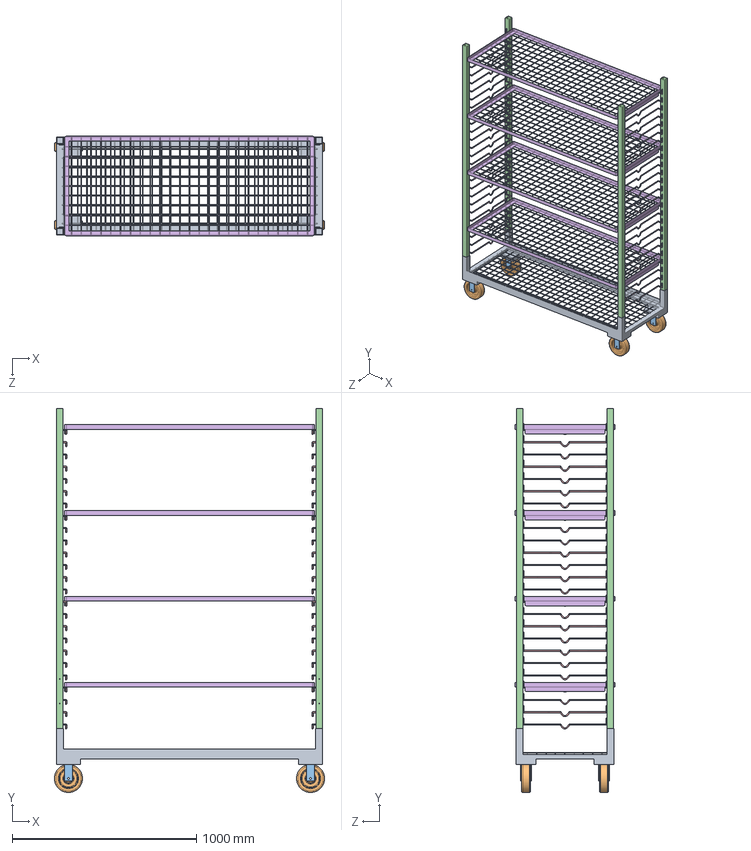
[picture p366: CAD file, 2019-07-03]
prj/container 3 rack v2/cart_assembly.SLDASM
1465.6 x 2082.7 x 540.5 mm
base
wheel x 4
wheel_housing x 4
side x 2
cross_bar x 50
shelf x 4
