OpenAgricultureFoundation/openag-mechanical/prj/container 3 rack v2/Plumbing/drain_assembly.SLDASM

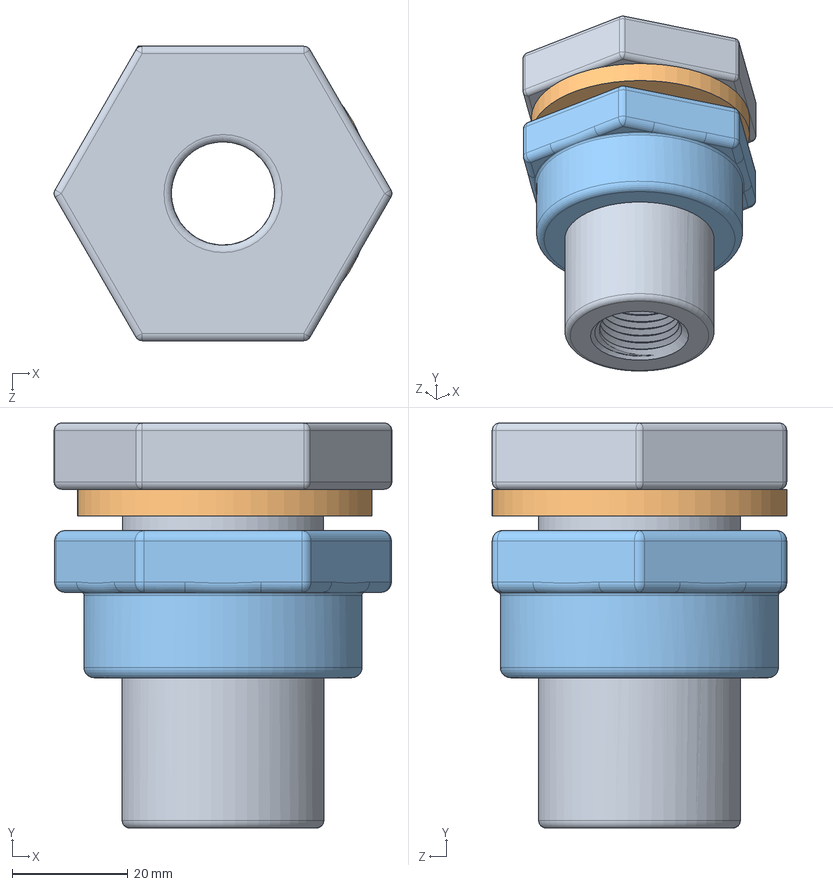
[picture p367: CAD file, 2019-07-03]
prj/container 3 rack v2/Plumbing/drain_assembly.SLDASM
58.3 x 69.8 x 50.8 mm
drain
drain_gasket
drain_nut
