OpenAgricultureFoundation/openag-mechanical/prj/hazelnut_large/LHC-001/8-Light Documentation and Simulations/CollimatorTutotrial-SW2015/LED Collimator.SLDASM

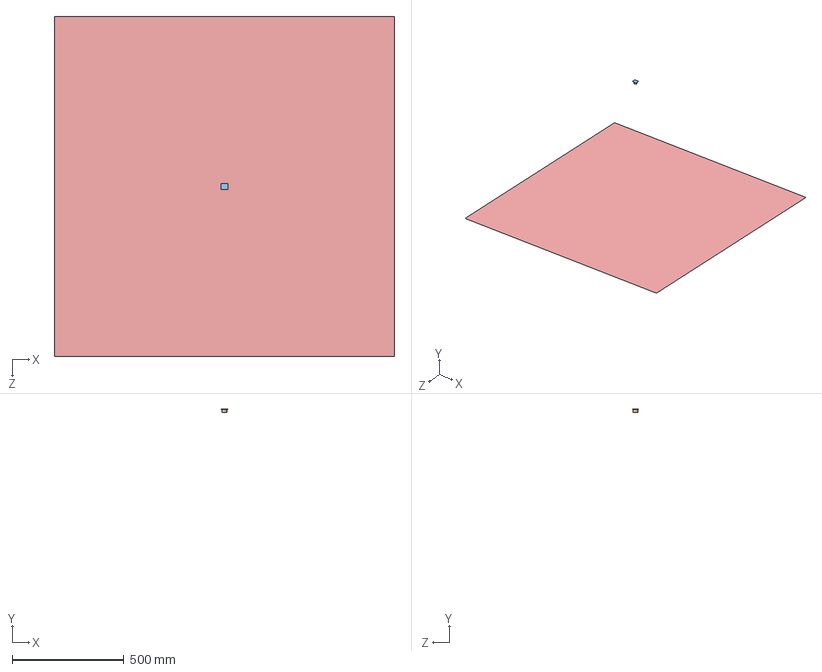
[picture p368: CAD file, 2019-03-14]
prj/hazelnut_large/LHC-001/8-Light Documentation and Simulations/CollimatorTutotrial-SW2015/LED Collimator.SLDASM
1524.0 x 916.7 x 1524.0 mm
collimatorreflandlens12132015
PCB102215
CREE XPL 12282015
IlluminancePlane
XP-L-3000KCORE
