OpenAgricultureFoundation/openag-mechanical/prj/fermentabot/FMT001/FMT.001.SLDASM

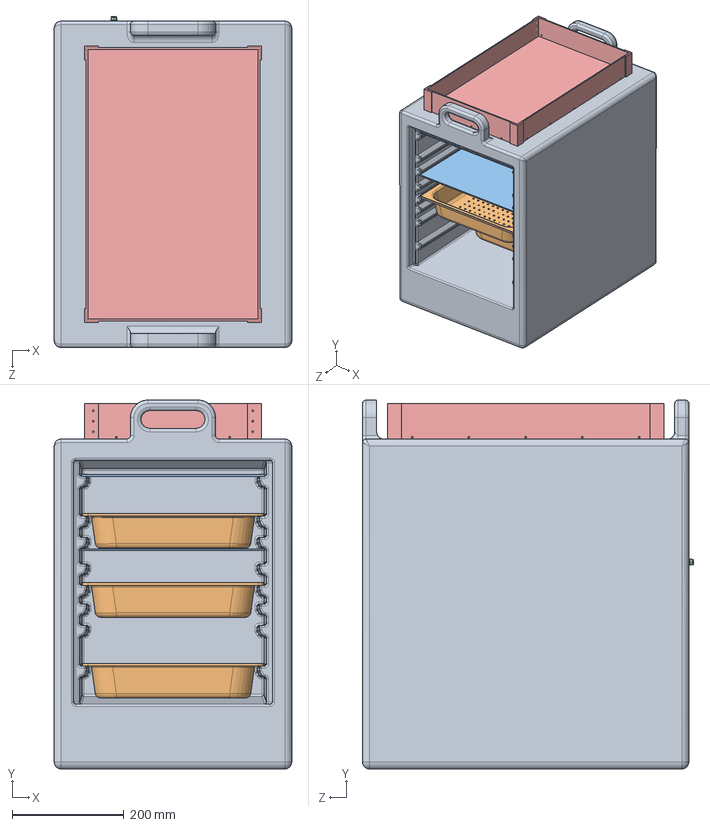
[picture p369: CAD file, 2018-08-08]
prj/fermentabot/FMT001/FMT.001.SLDASM
425.5 x 660.4 x 592.5 mm
FMT.003
FMT.004 x 3
FMT.005 x 2
5779K693_PUSH-TO-CONNECT TUBE FITTING FOR AIR
FMT.006
