OpenAgricultureFoundation/openag-mechanical/prj/fs-waterbot/v1.0/solidworks/master_outlet.SLDASM

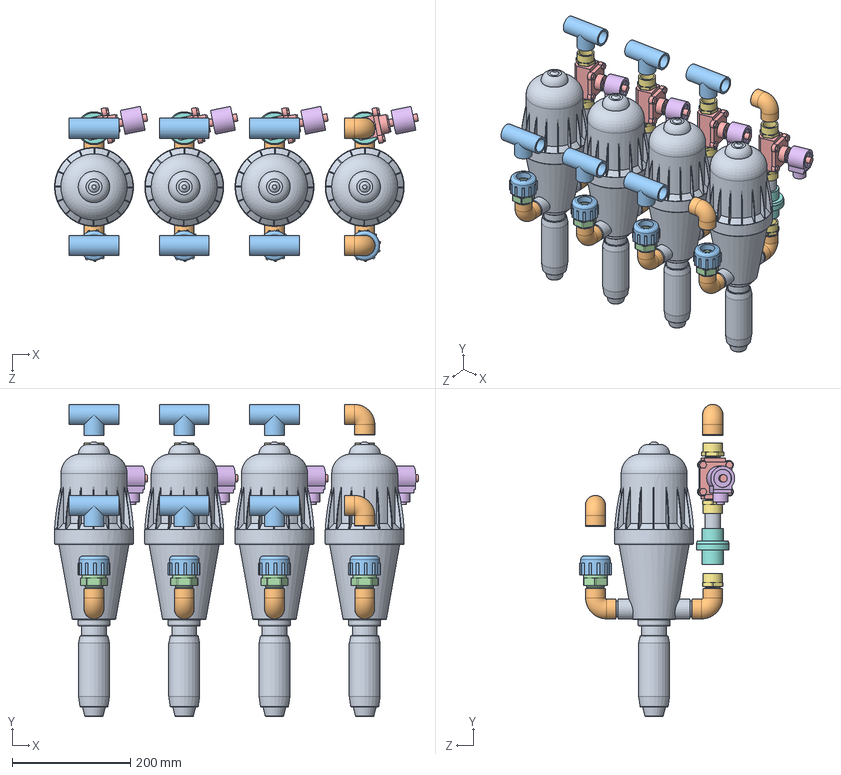
[picture p370: CAD file, 2018-05-29]
prj/fs-waterbot/v1.0/solidworks/master_outlet.SLDASM
614.7 x 527.2 x 262.4 mm
dosatron x 4
threaded-90 x 8
pvc-075-threaded_union x 4
pvc-075-threaded-union-male x 4
solenoid_body x 4
solenoid_valve x 4
pvc-075-threaded_coupler x 12
pvc-075-union x 4
075inSchedule40^Pipe_1-dosatron_subassembly x 4
pvc-075-90 x 2
pvc-075-tee x 6
