OpenAgricultureFoundation/openag-mechanical/prj/container 3 rack v2/side_assembly.SLDASM

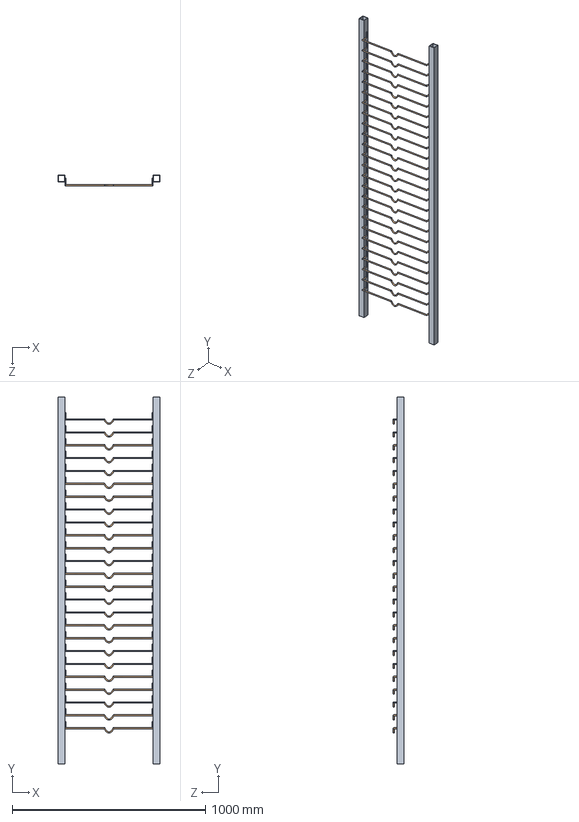
[picture p371: CAD file, 2019-07-03]
prj/container 3 rack v2/side_assembly.SLDASM
527.7 x 1898.7 x 55.7 mm
side
cross_bar x 25
