OpenAgricultureFoundation/openag-mechanical/prj/fs-waterbot/v1.0/solidworks/pvc-075-threaded-union-assembly.SLDASM

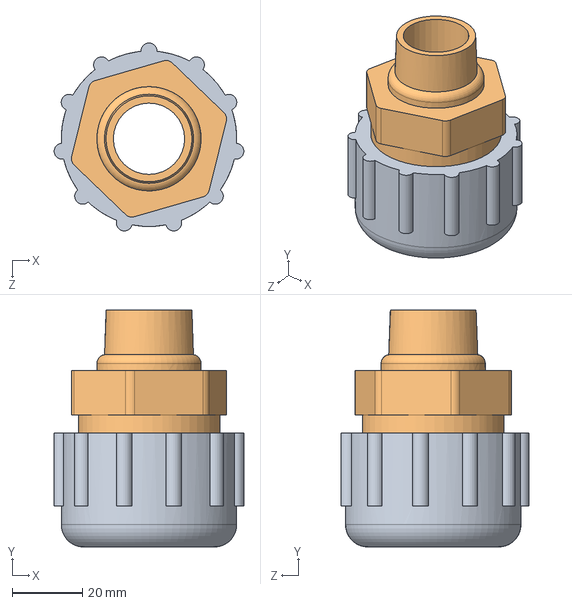
[picture p372: CAD file, 2018-05-29]
prj/fs-waterbot/v1.0/solidworks/pvc-075-threaded-union-assembly.SLDASM
54.1 x 67.6 x 53.6 mm
pvc-075-threaded_union
pvc-075-threaded-union-male
