OpenAgricultureFoundation/openag-mechanical/prj/hazelnut_large/LHC-001/LHC-300/lhc-301.SLDASM

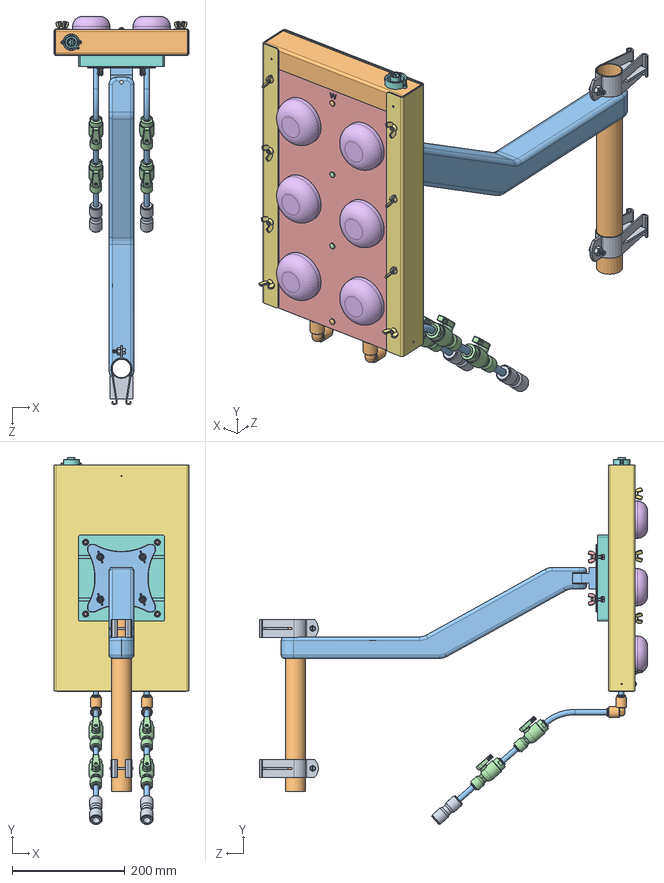
[picture p373: CAD file, 2019-10-30]
prj/hazelnut_large/LHC-001/LHC-300/lhc-301.SLDASM
238.1 x 649.7 x 687.6 mm
3193T140_STAND-OFF STRUT-MNT MTL ROUTING CLAMP x 2
5175K212_COPPER TUBING FOR DRINKING WATER
M17 MONITOR MOUNT x 2
95345A555_PAN HEAD PHIL MACHINE SCREW WITH LOCK WASHER x 2
92196A541_18-8 STAINLESS STEEL SOCKET HEAD CAP SCREW x 4
93776A421_TYPE 18-8 SS SERRATED-FLANGE LOCKNUT x 4
90866A009_ZINC-PLATED STEEL AND IRON WING NUTS x 14
92196A146_18-8 STAINLESS STEEL SOCKET HEAD CAP SCREW x 2
96278A007_TYPE 18-8 SS HEX NUT WITH TOOTH WASHER (1) x 2
95345A548_PAN HEAD PHIL MACHINE SCREW WITH LOCK WASHER x 10
4946A200_EXPANDABLE LOCKING GROMMETS x 2
95345A554_PAN HEAD PHIL MACHINE SCREW WITH LOCK WASHER x 4
92001A311_18-8 SS WING NUT x 4
96278A009_TYPE 18-8 SS HEX NUT WITH TOOTH WASHER x 6
90665A115_LOW-PROFILE ALLOY STEEL SOCKET HEAD CAP SCREW x 4
95345A099_PAN HEAD PHIL MACHINE SCREW WITH LOCK WASHER x 4
91525A109_TYPE 316 STAINLESS STEEL FLAT WASHER x 4
9406T170_PUSH-TO-CONNECT TUBE FITTING FOR SS TUBING x 2
5233K560_MASTERKLEER PVC TUBING (2) x 6
4379K620_FDA PLASTIC BALL VALVE x 4
976-1596-ND_BRIDGELUX VERO29 x 5
1621-1007-ND_KHATOD OPTIC 1825 x 6
1DGL-JC-50W-RE Red LED
C016 30C006 100 12
OPTIC_PLACEMENT_JIG
HEAT SINK HOLE JIG
416201U00000G-ND_12IN HEATSINK
lhc-302
lhc-304
lhc-305
lhc-306
lhc-308
7852T350_HOT DRINKING WATER PUSH-TO-CONNECT FITTING x 2
lhc-310
lhc-312
