OpenAgricultureFoundation/openag-mechanical/prj/container 3 rack v2/fastener_assembly.SLDASM

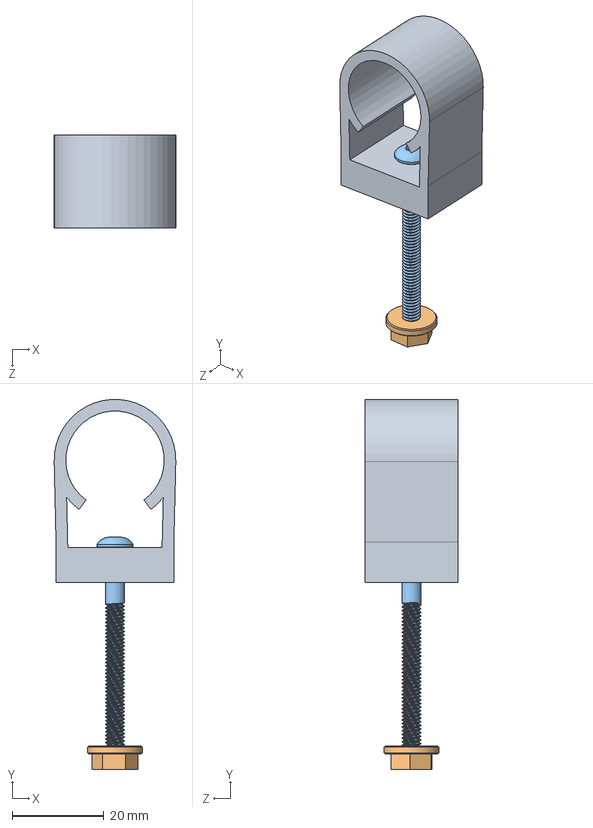
[picture p374: CAD file, 2019-07-03]
prj/container 3 rack v2/fastener_assembly.SLDASM
26.5 x 80.6 x 20.3 mm
pvc-050-standoff
hrd-08-32-flng-nut02
HRD-008-175-BTN-SS
