OpenAgricultureFoundation/openag-mechanical/prj/hazelnut_large/LHC-001/8-Light Documentation and Simulations/lhc-415.SLDASM

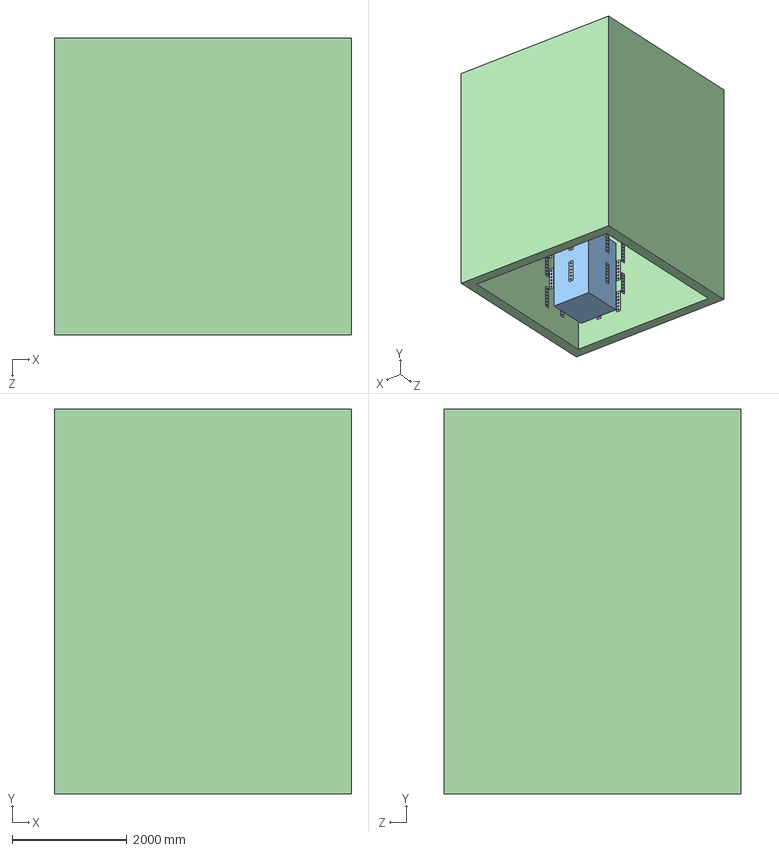
[picture p375: CAD file, 2019-03-05]
prj/hazelnut_large/LHC-001/8-Light Documentation and Simulations/lhc-415.SLDASM
5181.6 x 6705.6 x 5181.6 mm
lhc-312 x 18
ledlens75mm-spd^lhc-314 x 72
lhc-315
lhc-316
