OpenAgricultureFoundation/openag-mechanical/prj/hazelnut_large/LHC-001/LHC-200/Floating Light Assembly.SLDASM

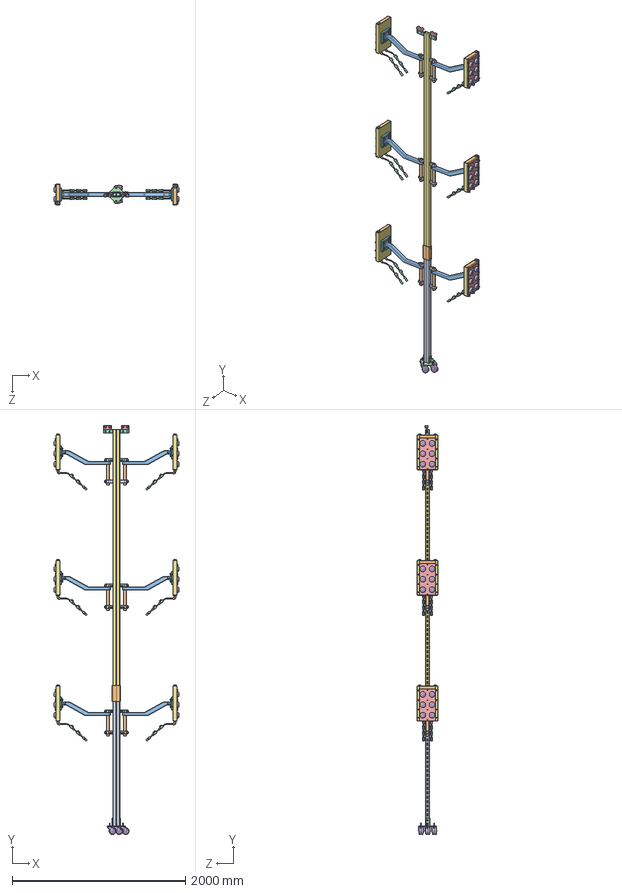
[picture p376: CAD file, 2019-10-30]
prj/hazelnut_large/LHC-001/LHC-200/Floating Light Assembly.SLDASM
1441.7 x 4718.0 x 238.1 mm
3193T140_STAND-OFF STRUT-MNT MTL ROUTING CLAMP x 12
5175K212_COPPER TUBING FOR DRINKING WATER x 6
M17 MONITOR MOUNT x 12
95345A555_PAN HEAD PHIL MACHINE SCREW WITH LOCK WASHER x 12
92196A541_18-8 STAINLESS STEEL SOCKET HEAD CAP SCREW x 24
93776A421_TYPE 18-8 SS SERRATED-FLANGE LOCKNUT x 24
90866A009_ZINC-PLATED STEEL AND IRON WING NUTS x 84
92196A146_18-8 STAINLESS STEEL SOCKET HEAD CAP SCREW x 12
96278A007_TYPE 18-8 SS HEX NUT WITH TOOTH WASHER (1) x 12
95345A548_PAN HEAD PHIL MACHINE SCREW WITH LOCK WASHER x 60
4946A200_EXPANDABLE LOCKING GROMMETS x 12
95345A554_PAN HEAD PHIL MACHINE SCREW WITH LOCK WASHER x 24
92001A311_18-8 SS WING NUT x 24
96278A009_TYPE 18-8 SS HEX NUT WITH TOOTH WASHER x 36
90665A115_LOW-PROFILE ALLOY STEEL SOCKET HEAD CAP SCREW x 24
95345A099_PAN HEAD PHIL MACHINE SCREW WITH LOCK WASHER x 24
91525A109_TYPE 316 STAINLESS STEEL FLAT WASHER x 24
9406T170_PUSH-TO-CONNECT TUBE FITTING FOR SS TUBING x 12
5233K560_MASTERKLEER PVC TUBING (2) x 36
4379K620_FDA PLASTIC BALL VALVE x 24
976-1596-ND_BRIDGELUX VERO29 x 30
1621-1007-ND_KHATOD OPTIC 1825 x 36
1DGL-JC-50W-RE Red LED x 6
C016 30C006 100 12 x 6
OPTIC_PLACEMENT_JIG x 6
HEAT SINK HOLE JIG x 6
416201U00000G-ND_12IN HEATSINK x 6
lhc-302 x 6
lhc-304 x 6
lhc-305 x 6
lhc-306 x 6
lhc-308 x 6
7852T350_HOT DRINKING WATER PUSH-TO-CONNECT FITTING x 12
lhc-310 x 6
lhc-312 x 6
33145T490_STRUT CHANNEL FLOOR MNT
3626T110_STRUT CHANNEL TROLLEY x 2
87845T640_DUAL-WHEEL THREADED-STEM CASTER x 4
3208T174_BACK-TO-BACK STACKED STRUT CHANNEL
33125T411_STRUT CHANNEL CONNECTOR x 2
3208T190_BACK-TO-BACK STACKED STRUT CHANNEL
33125T139_STRUT CHANNEL CONNECTOR x 2
