OpenAgricultureFoundation/openag-mechanical/prj/hazelnut_large/LHC-001/8-Light Documentation and Simulations/lhc-410.SLDASM

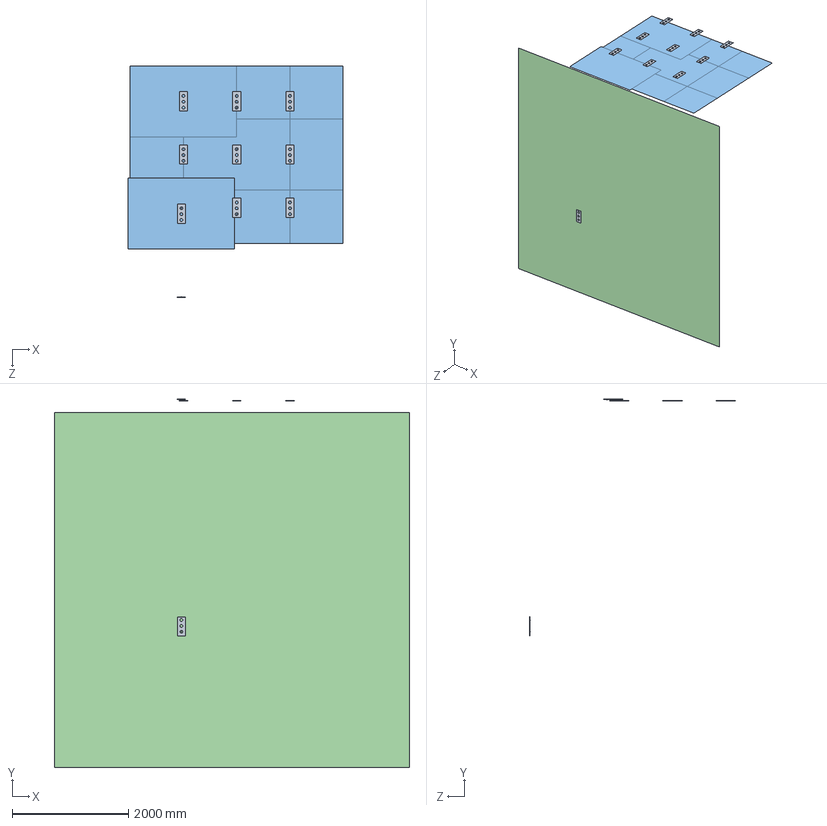
[picture p377: CAD file, 2019-03-05]
prj/hazelnut_large/LHC-001/8-Light Documentation and Simulations/lhc-410.SLDASM
6096.0 x 6324.8 x 3972.0 mm
lhc-311 x 10
ledlens75mm-spd^lhc-311 x 20
5ft x 4ft Plane x 10
20ft x 20ft Plane
