OpenAgricultureFoundation/openag-mechanical/prj/hazelnut_large/LHC-001/8-Light Documentation and Simulations/lhc-411.SLDASM

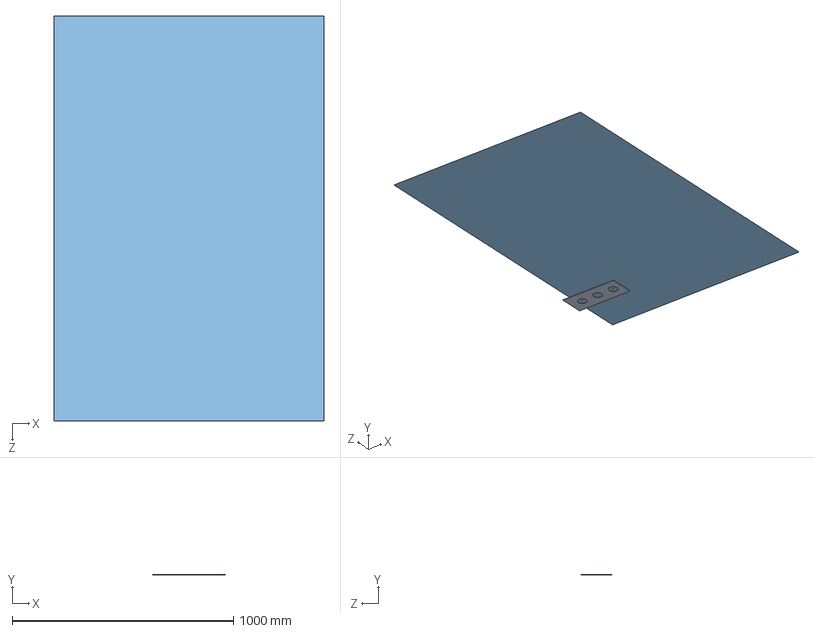
[picture p378: CAD file, 2019-03-05]
prj/hazelnut_large/LHC-001/8-Light Documentation and Simulations/lhc-411.SLDASM
1219.2 x 458.8 x 1828.8 mm
lhc-311
ledlens75mm-spd^lhc-311 x 2
5ft x 4ft Plane
