OpenAgricultureFoundation/openag-mechanical/prj/hazelnut_large/v1.0/tims_test folder/full test assembly.SLDASM

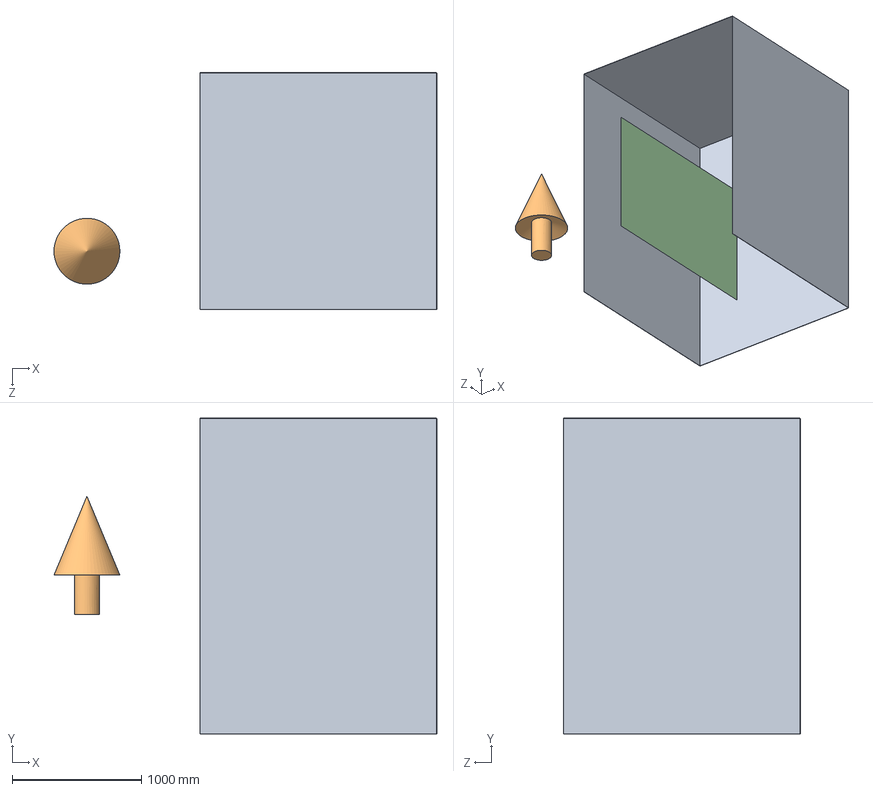
[picture p379: CAD file, 2019-01-17]
prj/hazelnut_large/v1.0/tims_test folder/full test assembly.SLDASM
2962.9 x 2441.6 x 1832.0 mm
sml_hazelnut box
ledlens75mm-spd^full test assembly
4ft x 6ft Plane
