OpenAgricultureFoundation/openag-mechanical/prj/container 3 rack v2/wheel_assembly.SLDASM

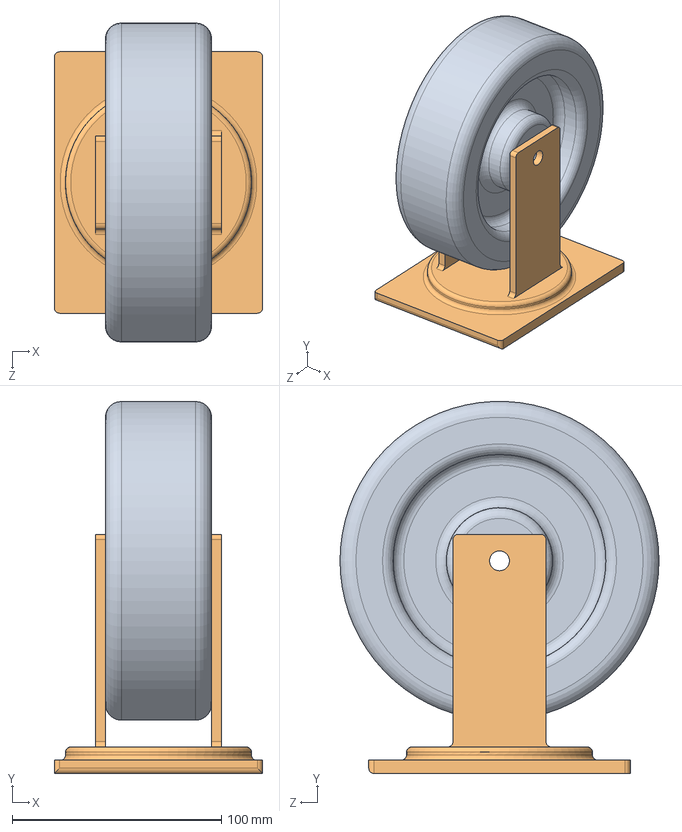
[picture p380: CAD file, 2019-07-03]
prj/container 3 rack v2/wheel_assembly.SLDASM
99.6 x 177.7 x 152.4 mm
wheel
wheel_housing
