OpenAgricultureFoundation/openag-mechanical/prj/fs-waterbot/v1.0/solidworks/source_assembly.SLDASM

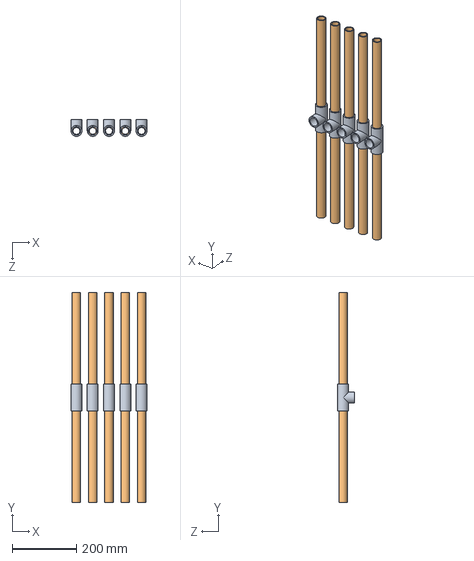
[picture p381: CAD file, 2018-05-29]
prj/fs-waterbot/v1.0/solidworks/source_assembly.SLDASM
237.5 x 655.8 x 52.7 mm
pvc-075-tee x 5
pvc-075-012 x 10
