OpenAgricultureFoundation/openag-mechanical/prj/hazelnut_large/v1.0/tims_test folder/box_assembly.SLDASM

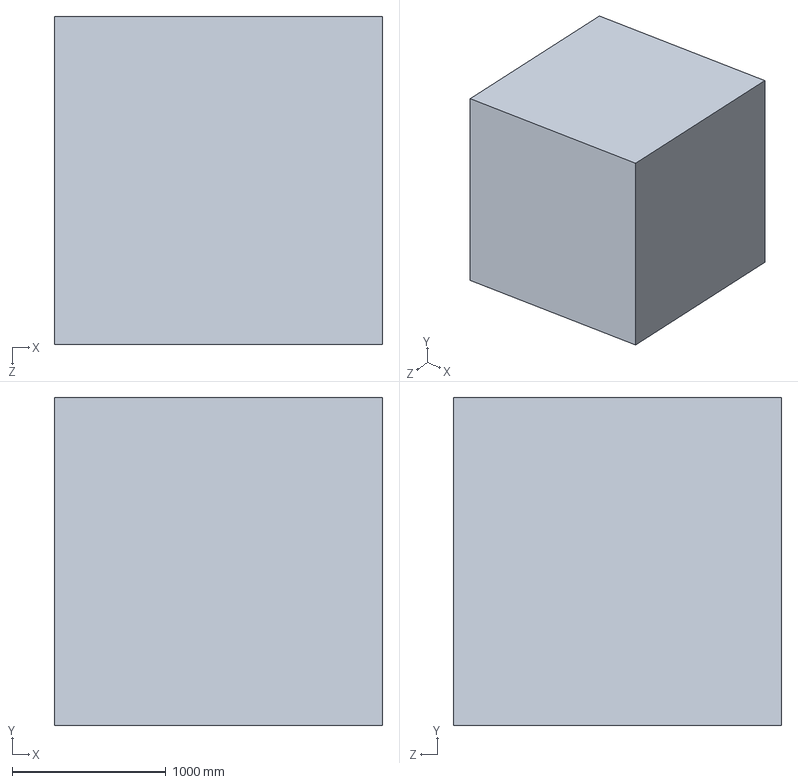
[picture p382: CAD file, 2019-01-14]
prj/hazelnut_large/v1.0/tims_test folder/box_assembly.SLDASM
2133.6 x 2133.6 x 2133.6 mm
simple_box
Bridgelux-VeroSE29-M-STP-17-000021-RA x 5
heatsink x 5
