OpenAgricultureFoundation/openag-mechanical/prj/fermentabot/FMT201/Brain Box.SLDASM

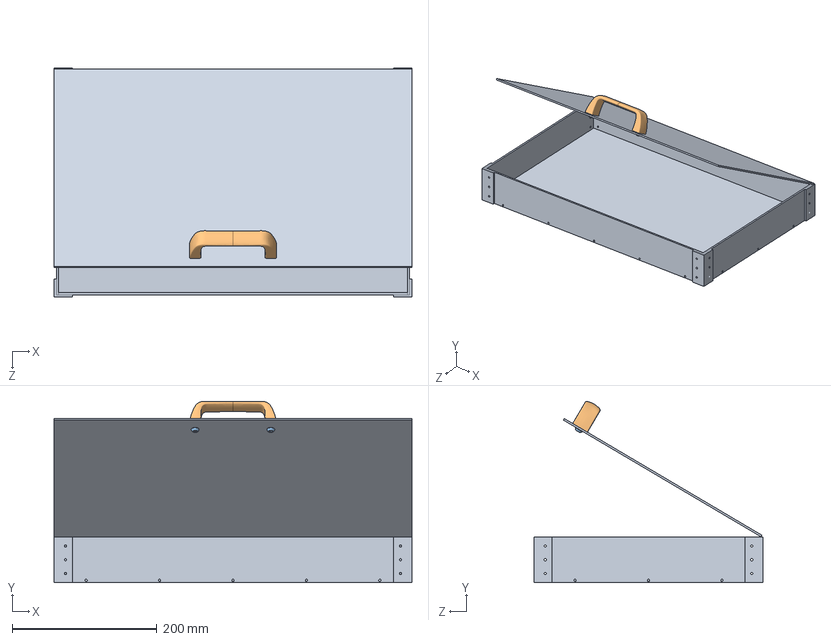
[picture p383: CAD file, 2018-11-08]
prj/fermentabot/FMT201/Brain Box.SLDASM
495.3 x 250.9 x 317.5 mm
FMT.006 x 2
1661A100_LOAD-RATED PULL HANDLE WITH THREADED HOLES
92949A537_18-8 SS BUTTON-HEAD SOCKET CAP SCREW x 2
