OpenAgricultureFoundation/openag-mechanical/prj/fs-waterbot/v1.0/solidworks/button_bank_assembly.SLDASM

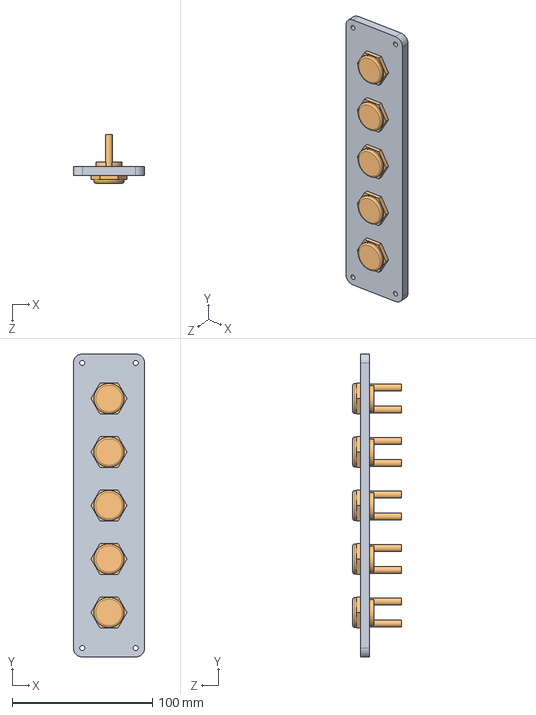
[picture p384: CAD file, 2018-05-29]
prj/fs-waterbot/v1.0/solidworks/button_bank_assembly.SLDASM
50.8 x 215.9 x 34.6 mm
button_bank
switch x 5
