OpenAgricultureFoundation/openag-mechanical/prj/fs-waterbot/v1.0/solidworks/solenoid_bank.SLDASM

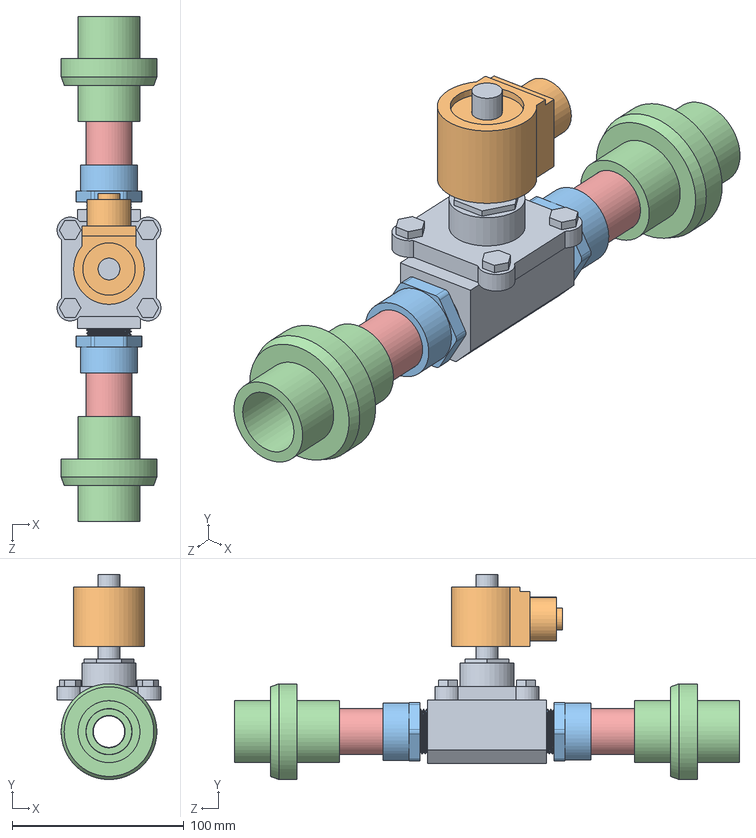
[picture p385: CAD file, 2018-05-29]
prj/fs-waterbot/v1.0/solidworks/solenoid_bank.SLDASM
60.4 x 119.2 x 293.6 mm
solenoid_body
solenoid_valve
pvc-075-threaded_coupler x 2
pvc-075-union x 2
pvc-075-001 x 2
