OpenAgricultureFoundation/openag-mechanical/prj/germinator v3/cart_assembly.SLDASM

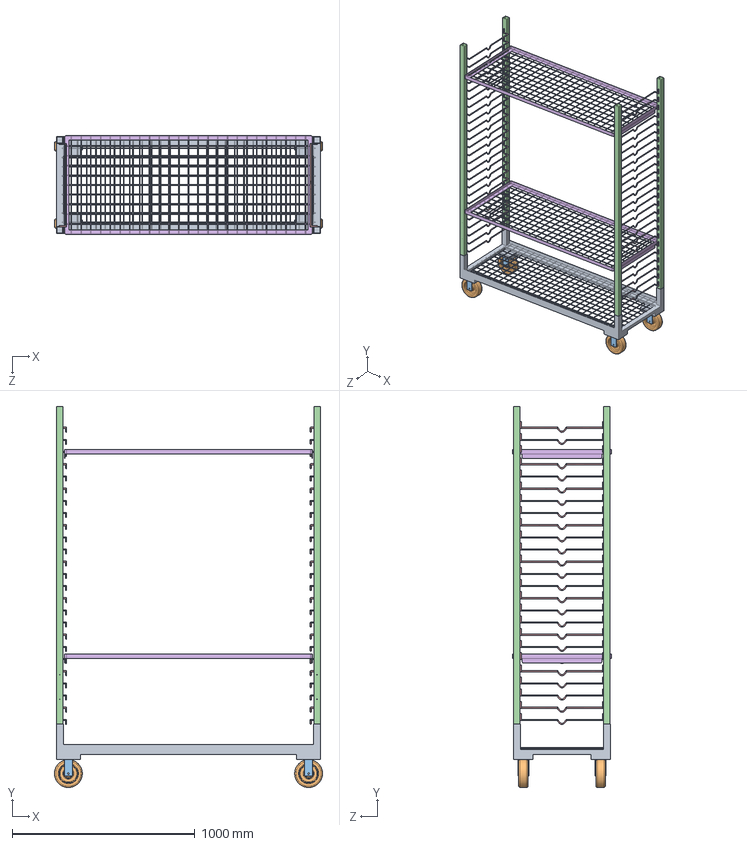
[picture p386: CAD file, 2018-08-08]
prj/germinator v3/cart_assembly.SLDASM
1465.6 x 2082.7 x 540.5 mm
base
wheel x 4
wheel_housing x 4
side x 2
cross_bar x 50
shelf x 2
