OpenAgricultureFoundation/openag-mechanical/prj/fs-waterbot/v1.0/solidworks/waterbot_master_assembly.SLDASM

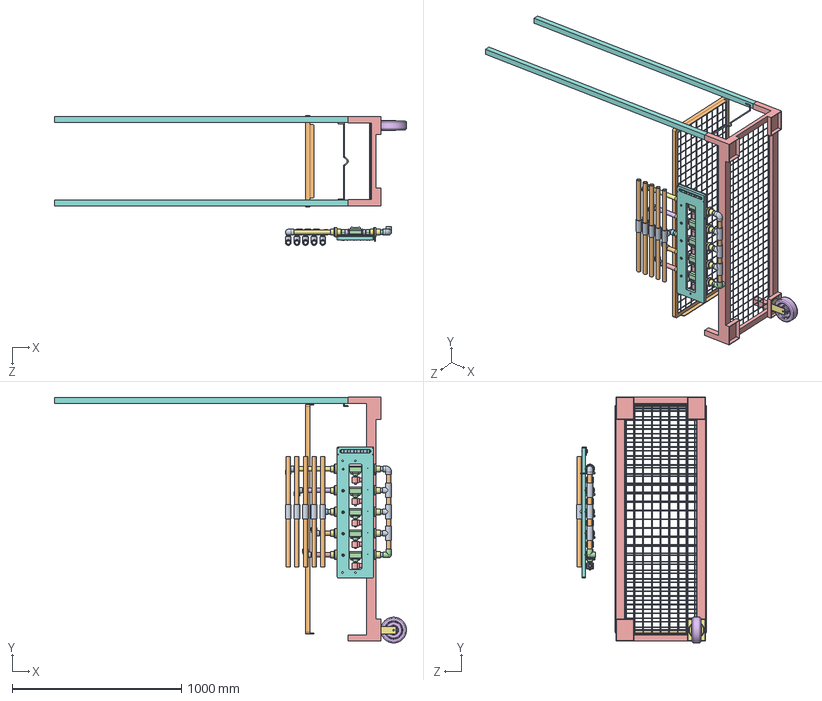
[picture p387: CAD file, 2018-05-29]
prj/fs-waterbot/v1.0/solidworks/waterbot_master_assembly.SLDASM
2082.7 x 1454.8 x 768.3 mm
pvc-075-tee x 8
pvc-075-012 x 10
pvc-075-90-thr x 5
solenoid_body x 9
solenoid_valve x 9
pvc-075-threaded_coupler x 18
pvc-075-union x 18
pvc-075-001 x 24
pvc-075-90 x 5
pvc-075-003 x 7
pvc-075-008 x 2
pvc-075-elbow
pvc-075-005
pvc-075-007
pvc-075-009
manifold_board
hrd-025-20-532-nut x 4
hrd-025-ss-wsh x 5
hrd-025-20-125-ss-btn x 5
pvc-075-standoff02 x 10
button_bank
switch x 5
