OpenAgricultureFoundation/openag-mechanical/prj/hazelnut_large/LHC-001/LHC-100/WINCH MOUNT ASSEMBLY WELDMENT.SLDPRT

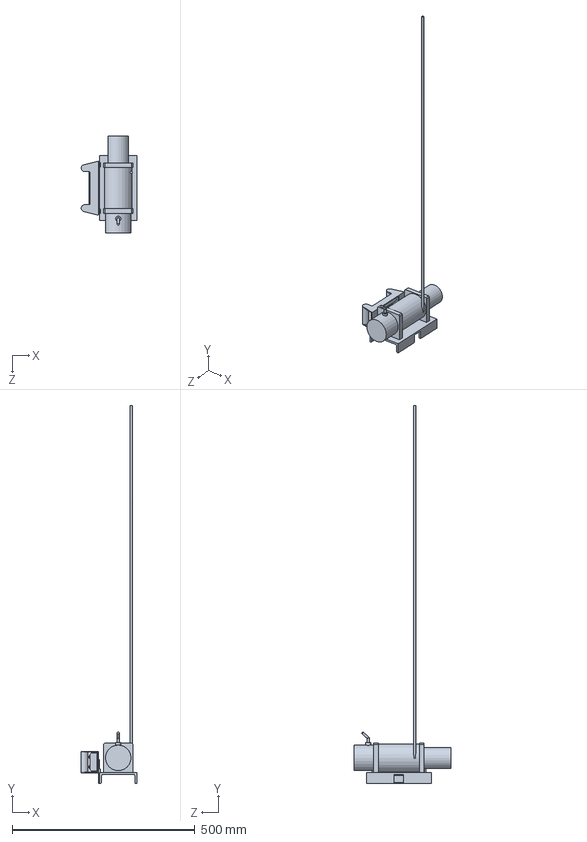
[picture p388: CAD file, 2019-02-14]
prj/hazelnut_large/LHC-001/LHC-100/WINCH MOUNT ASSEMBLY WELDMENT.SLDPRT
152.1 x 1033.5 x 266.1 mm
