OpenAgricultureFoundation/openag-mechanical/prj/fs-waterbot/v1.0/solidworks/manifold_assembly.SLDASM

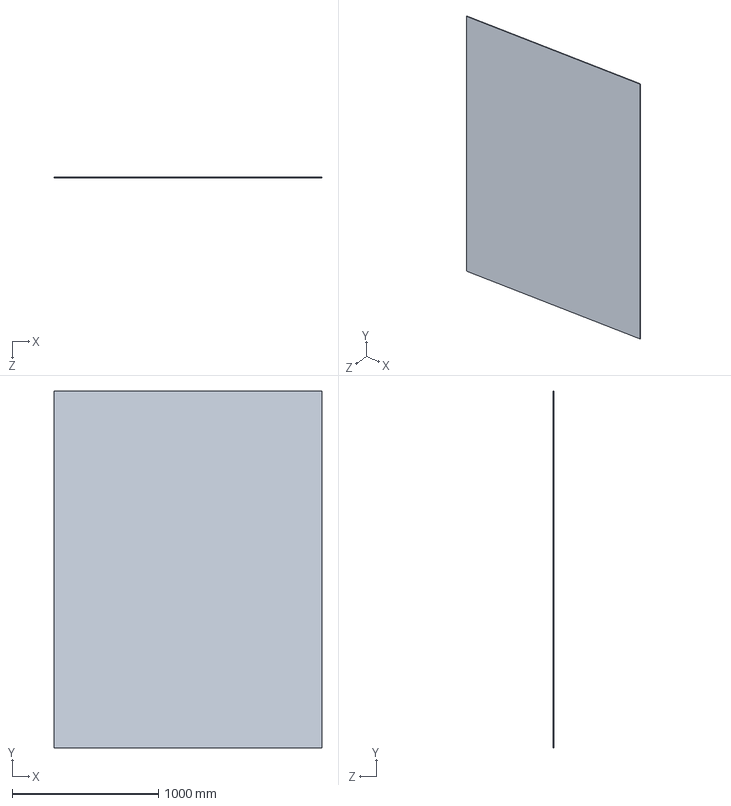
[picture p389: CAD file, 2018-05-29]
prj/fs-waterbot/v1.0/solidworks/manifold_assembly.SLDASM
1828.8 x 2438.4 x 6.35 mm
