OpenAgricultureFoundation/openag-mechanical/prj/fs-waterbot/v1.0/solidworks/dosatron_subassembly.SLDASM

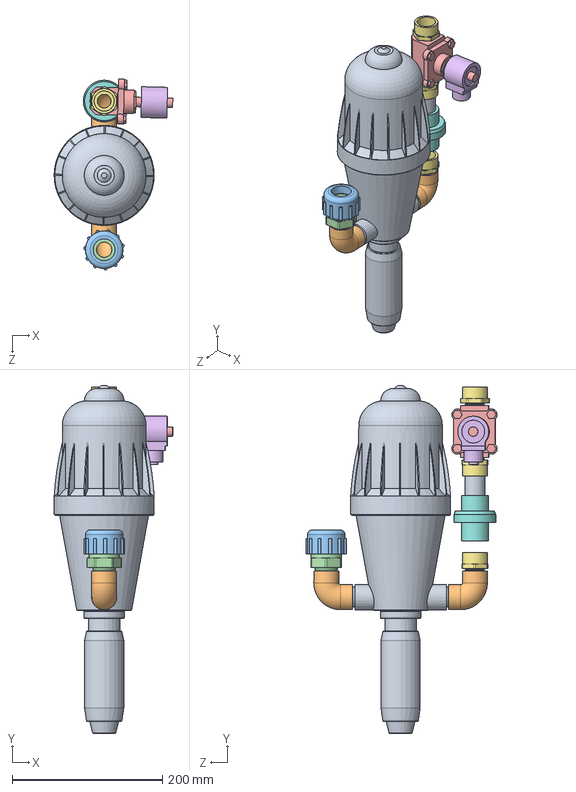
[picture p390: CAD file, 2018-05-29]
prj/fs-waterbot/v1.0/solidworks/dosatron_subassembly.SLDASM
158.2 x 463.8 x 255.1 mm
dosatron
threaded-90 x 2
pvc-075-threaded_union
pvc-075-threaded-union-male
solenoid_body
solenoid_valve
pvc-075-threaded_coupler x 3
pvc-075-union
075inSchedule40^Pipe_1-dosatron_subassembly
