OpenAgricultureFoundation/openag-mechanical/prj/hazelnut_large/LHC-001/LHC-200/lhc-101.SLDASM

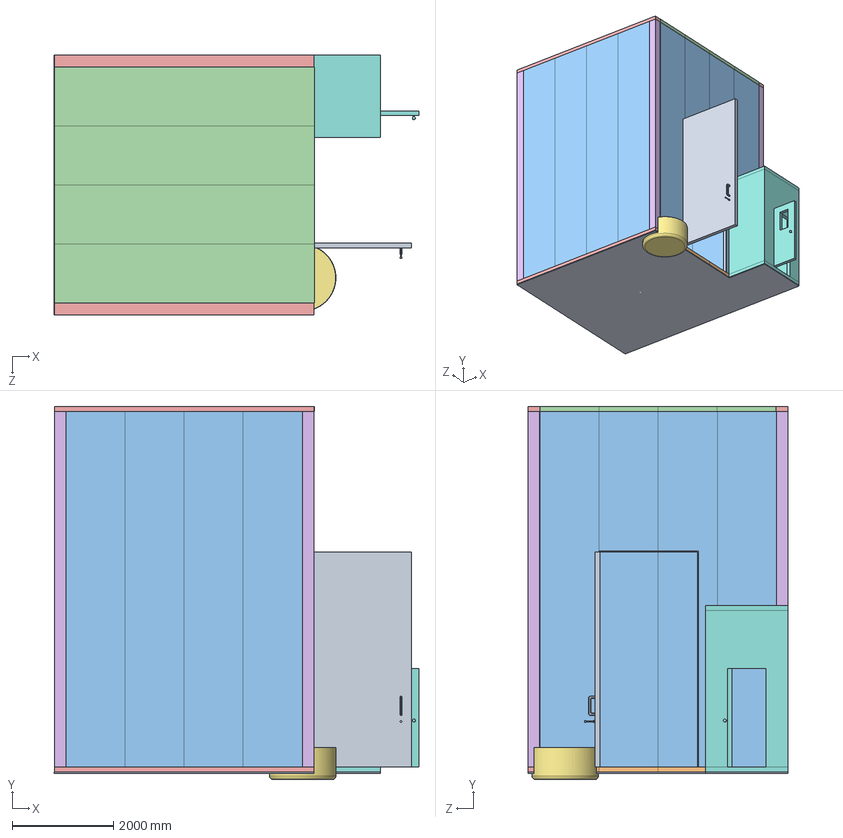
[picture p391: CAD file, 2019-10-24]
prj/hazelnut_large/LHC-001/LHC-200/lhc-101.SLDASM
7213.6 x 7378.7 x 5137.1 mm
floor
lhc-014 x 4
lhc-005 x 16
lhc-009 x 4
lhc-011 x 4
lhc-007 x 4
lhc-006
Jamison Refrigerator Door
