OpenAgricultureFoundation/openag-mechanical/prj/fs-waterbot/v1.0/solidworks/waterbot_supply_manifold_assembly.SLDASM

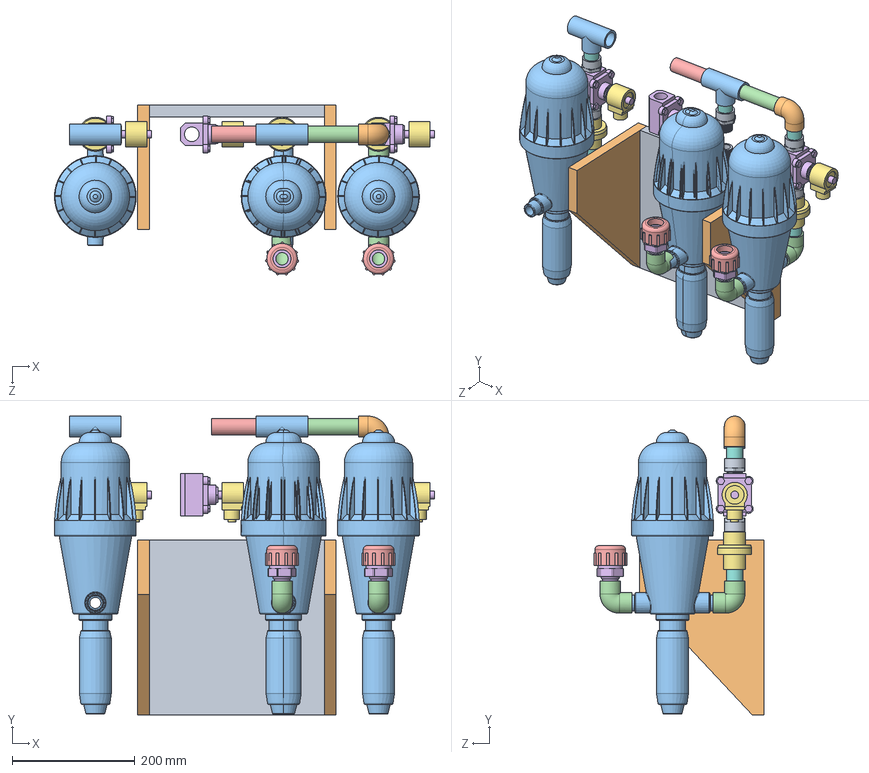
[picture p392: CAD file, 2018-05-29]
prj/fs-waterbot/v1.0/solidworks/waterbot_supply_manifold_assembly.SLDASM
620.3 x 487.8 x 277.2 mm
waterbot_supply_manifold_back
waterbot_supply_manifold_side x 2
dosatron x 4
pvc-075-90-f-f-thr x 3
pvc-075-threaded_union x 2
pvc-075-threaded-union-male x 2
pvc-075-union x 3
pvc-075-001 x 6
pvc-075-threaded_coupler x 6
pvc-075-90
pvc-075-tee x 2
pvc-075-004
pvc-075-003
solenoid_body x 3
solenoid_valve x 3
