OpenAgricultureFoundation/openag-mechanical/prj/hazelnut_large/LHC-001/LHC-200/Heater Assembly.SLDASM

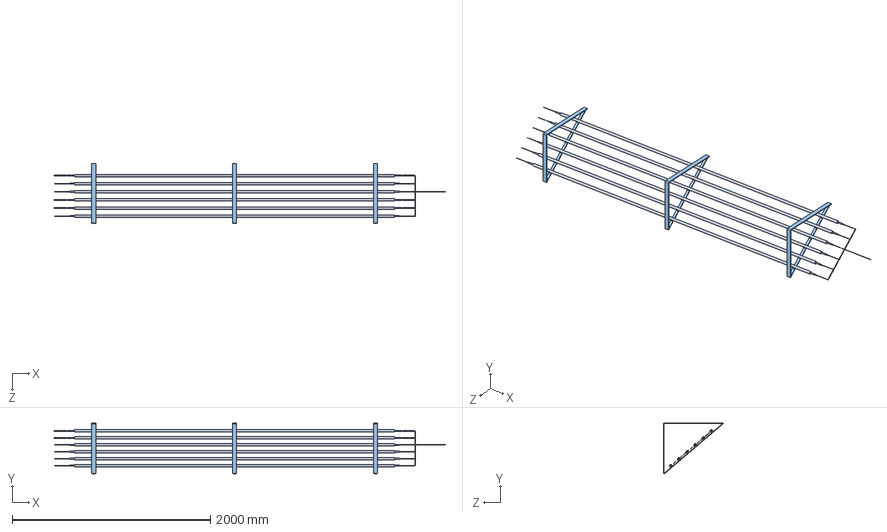
[picture p393: CAD file, 2019-10-22]
prj/hazelnut_large/LHC-001/LHC-200/Heater Assembly.SLDASM
3947.2 x 512.8 x 609.6 mm
10-137-05_PGN1 HEATER x 6
1556A240_BRACKET x 24
3200T940_STRUT CHANNEL SHELF BRACKET x 4
