OpenAgricultureFoundation/openag-mechanical/outgoing/2019-2-21 Salem Metal/2019_2_21-RFQ_LHC-306.STEP

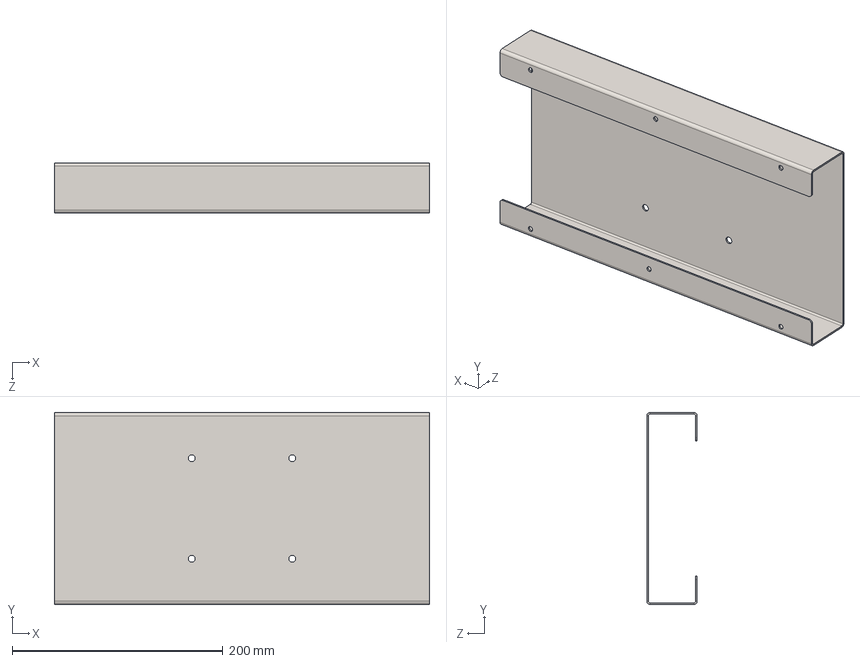
[picture p394: CAD file, 2019-02-21]
outgoing/2019-2-21 Salem Metal/2019_2_21-RFQ_LHC-306.STEP
355.6 x 182.2 x 47.6 mm
