OpenAgricultureFoundation/openag-mechanical/outgoing/5-24-18 Sheet Metal RFQ/5_24_18_RFQ_LFR-001.DXF

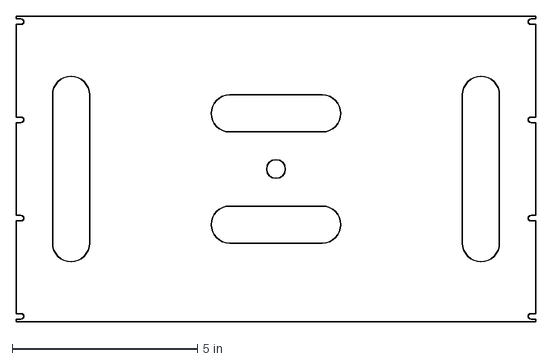
[picture p395: CAD file, 2018-05-28]
outgoing/5-24-18 Sheet Metal RFQ/5_24_18_RFQ_LFR-001.DXF
14.0 x 8.25 in
