OpenAgricultureFoundation/openag-mechanical/outgoing/6-7-18 Salem Metal/LFR.001_6-7-18.STEP

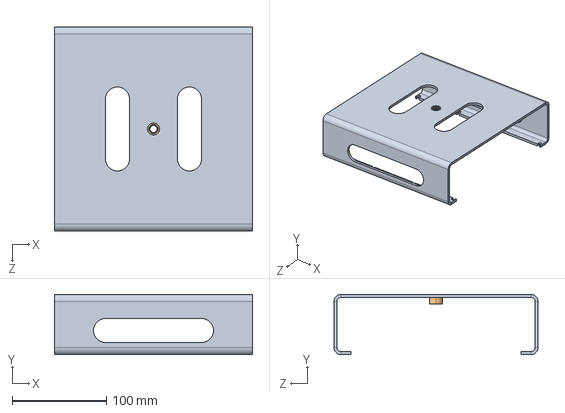
[picture p396: CAD file, 2018-06-07]
outgoing/6-7-18 Salem Metal/LFR.001_6-7-18.STEP
209.5 x 63.5 x 215.9 mm
