OpenAgricultureFoundation/openag-mechanical/prj/container 1/Container/MCM 64935T45 - PLANK GRATING.SLDPRT

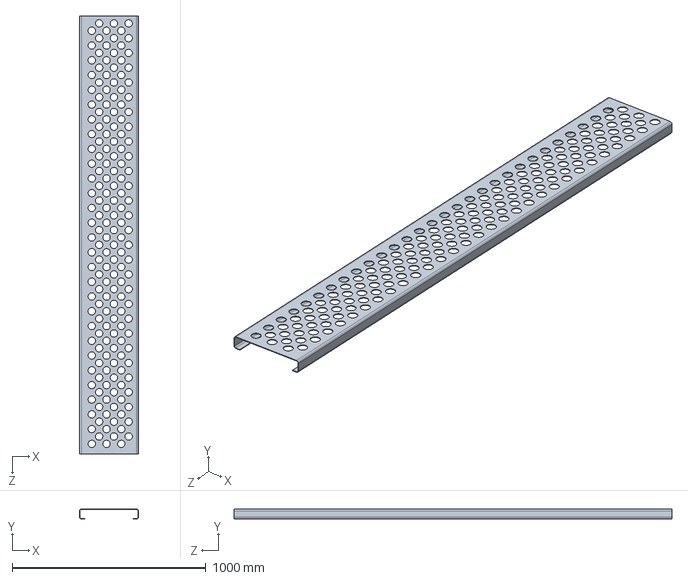
[picture p397: CAD file, 2019-07-03]
prj/container 1/Container/MCM 64935T45 - PLANK GRATING.SLDPRT
304.8 x 50.8 x 2260.6 mm
