OpenAgricultureFoundation/openag-mechanical/prj/container 3 rack v2/container 2 led-fixture/v1.0/10-17-18 Members Week Laser Cuts/cart rack sin.DXF

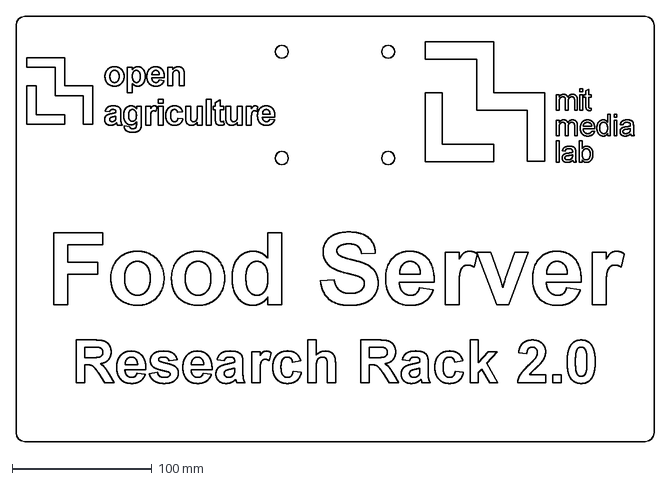
[picture p398: CAD file, 2018-10-29]
prj/container 3 rack v2/container 2 led-fixture/v1.0/10-17-18 Members Week Laser Cuts/cart rack sin.DXF
457.2 x 304.8 mm
