OpenAgricultureFoundation/openag-mechanical/prj/container 3 rack v2/container 2 led-fixture/v1.0/led fixture covers eugene 10-22-18/back1.DXF

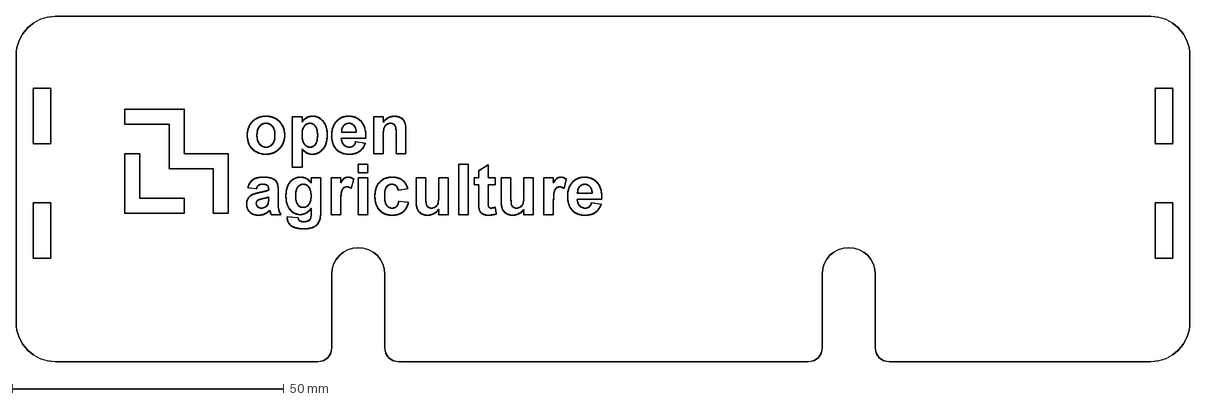
[picture p399: CAD file, 2018-10-29]
prj/container 3 rack v2/container 2 led-fixture/v1.0/led fixture covers eugene 10-22-18/back1.DXF
215.9 x 63.5 mm
