OpenAgricultureFoundation/openag-mechanical/prj/fermentabot/FMT001/FERMENTABOT_SIGN-2.DXF

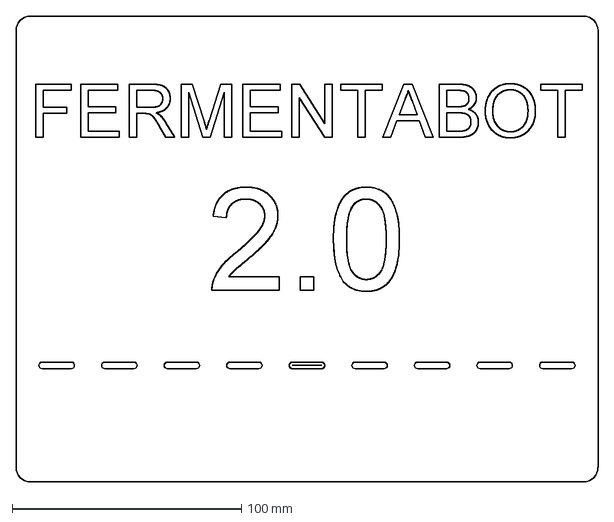
[picture p400: CAD file, 2018-10-29]
prj/fermentabot/FMT001/FERMENTABOT_SIGN-2.DXF
254.0 x 203.2 mm
