OpenAgricultureFoundation/openag-mechanical/prj/fermentabot/FMT001/Laser Cut Parts 10-15-18/FMT.007-pump-bracket.DXF

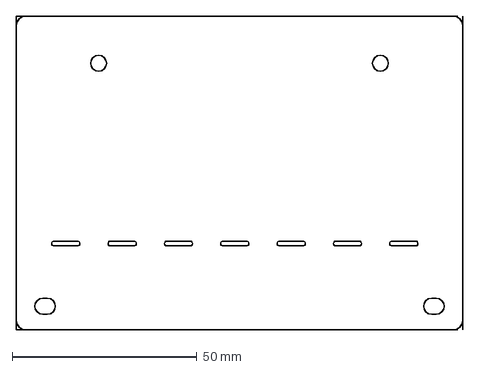
[picture p401: CAD file, 2018-10-29]
prj/fermentabot/FMT001/Laser Cut Parts 10-15-18/FMT.007-pump-bracket.DXF
120.7 x 84.8 mm
