OpenAgricultureFoundation/openag-mechanical/prj/fermentabot/FMT001/Laser cut parts 7-18-18/FMT.006-3.DXF

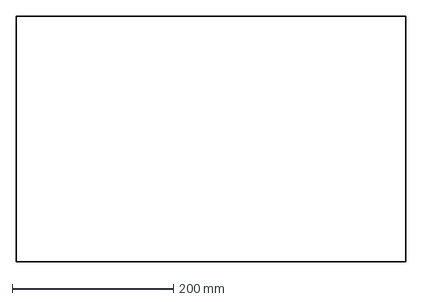
[picture p402: CAD file, 2018-07-19]
prj/fermentabot/FMT001/Laser cut parts 7-18-18/FMT.006-3.DXF
482.6 x 304.8 mm
