OpenAgricultureFoundation/openag-mechanical/prj/fermentabot/FMT201/12-6-18 PROTOTYPE CUT PARTS/MOUNTING_BLOCKS-025INCH.DXF

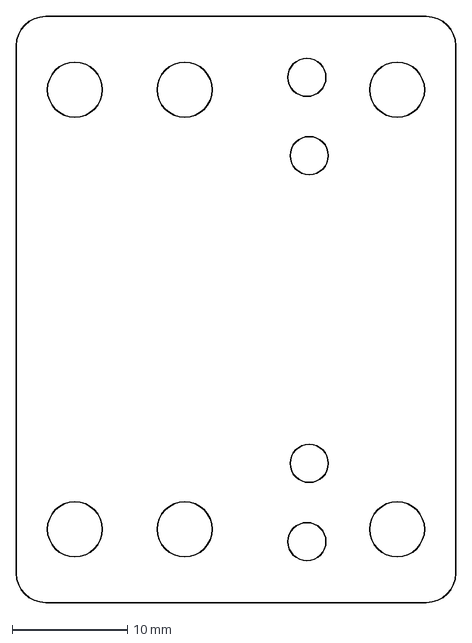
[picture p403: CAD file, 2018-12-11]
prj/fermentabot/FMT201/12-6-18 PROTOTYPE CUT PARTS/MOUNTING_BLOCKS-025INCH.DXF
38.1 x 50.8 mm
