OpenAgricultureFoundation/openag-mechanical/prj/fermentabot/FMT201/AIR SYSTEM 9-18-18/bottle.SLDPRT

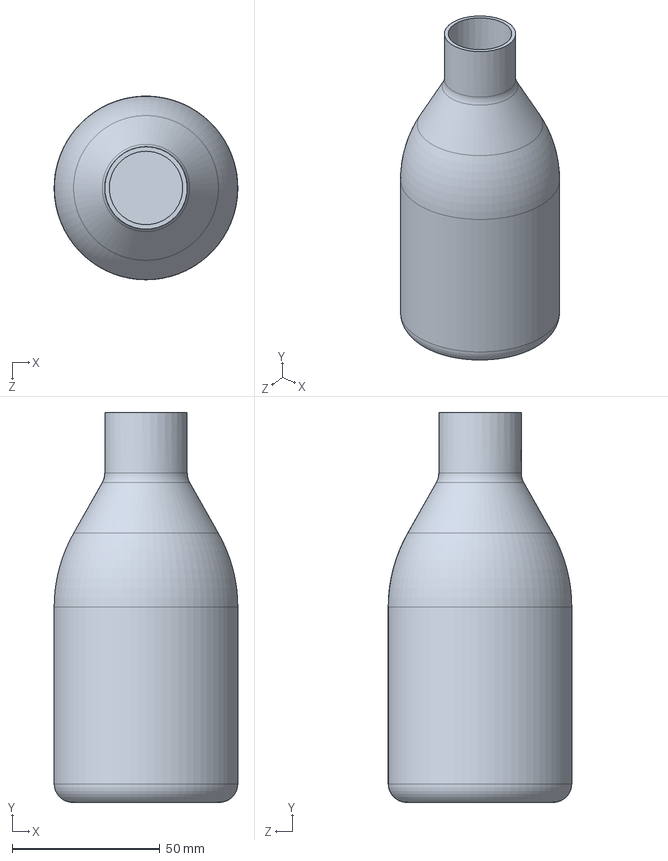
[picture p404: CAD file, 2018-11-05]
prj/fermentabot/FMT201/AIR SYSTEM 9-18-18/bottle.SLDPRT
62.2 x 132.1 x 62.2 mm
