OpenAgricultureFoundation/openag-mechanical/prj/fermentabot/FMT201/bathtub.SLDPRT

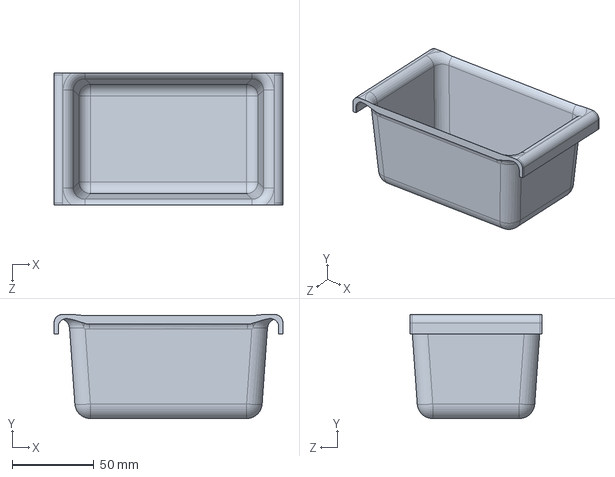
[picture p405: CAD file, 2018-12-11]
prj/fermentabot/FMT201/bathtub.SLDPRT
139.7 x 63.5 x 80.7 mm
