OpenAgricultureFoundation/openag-mechanical/prj/fs-waterbot/v1.0/part_drawings/button_bank.DXF

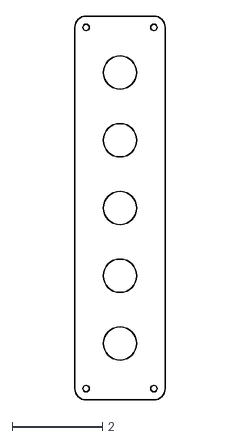
[picture p406: CAD file, 2018-05-29]
prj/fs-waterbot/v1.0/part_drawings/button_bank.DXF
2.00 x 8.50
