OpenAgricultureFoundation/openag-mechanical/prj/fs-waterbot/v1.0/solidworks/solenoid_body.SLDPRT

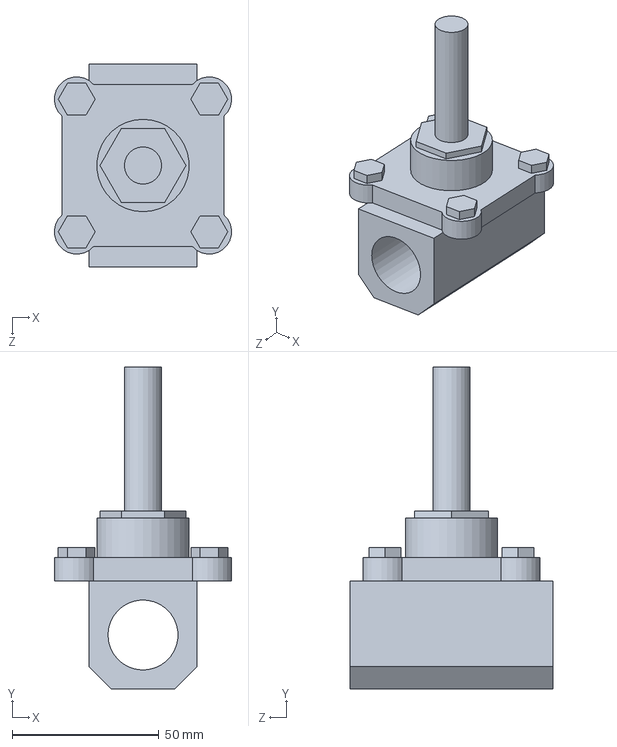
[picture p407: CAD file, 2018-05-29]
prj/fs-waterbot/v1.0/solidworks/solenoid_body.SLDPRT
60.4 x 109.8 x 69.3 mm
