OpenAgricultureFoundation/openag-mechanical/prj/germinator v3/GMR.503.SLDPRT

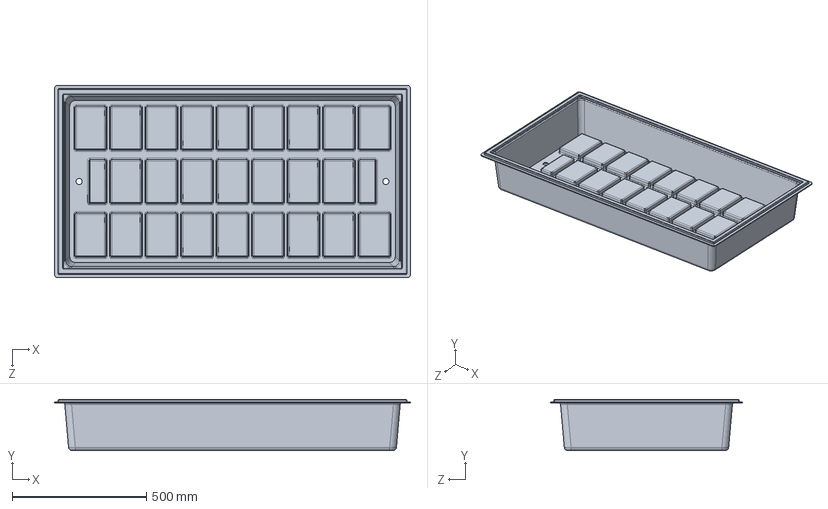
[picture p408: CAD file, 2019-07-03]
prj/germinator v3/GMR.503.SLDPRT
1327.2 x 190.4 x 717.5 mm
