OpenAgricultureFoundation/openag-mechanical/prj/hazelnut_large/LHC-001/1-Documentation/2018-2019 Large Tree Computer - Superceded Designs and Documentation/2018-9-25 Outgoing to Paul/MIT_OpenAg_FloorPlan_9-25-18.DXF

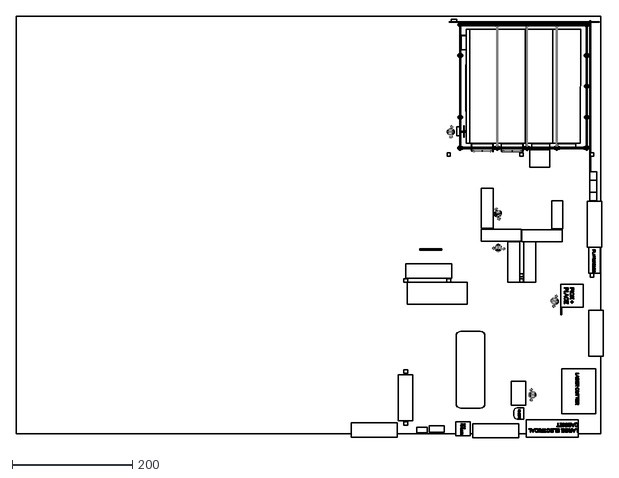
[picture p409: CAD file, 2019-02-14]
prj/hazelnut_large/LHC-001/1-Documentation/2018-2019 Large Tree Computer - Superceded Designs and Documentation/2018-9-25 Outgoing to Paul/MIT_OpenAg_FloorPlan_9-25-18.DXF
975.9 x 701.5
