OpenAgricultureFoundation/openag-mechanical/prj/hazelnut_large/LHC-001/8-Light Documentation and Simulations/CollimatorTutotrial-SW2015/collimatorreflandlens12132015.SLDPRT

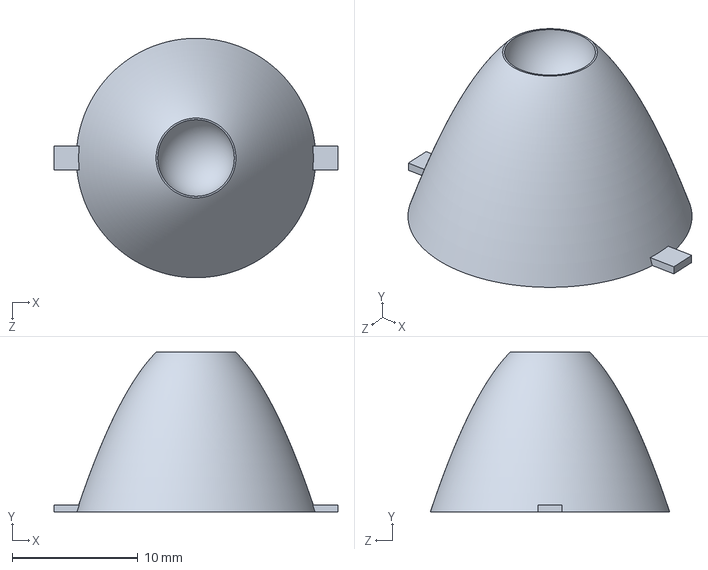
[picture p410: CAD file, 2019-03-14]
prj/hazelnut_large/LHC-001/8-Light Documentation and Simulations/CollimatorTutotrial-SW2015/collimatorreflandlens12132015.SLDPRT
22.6 x 12.7 x 19.0 mm
