OpenAgricultureFoundation/openag-mechanical/prj/hazelnut_large/LHC-001/8-Light Documentation and Simulations/new led lamp/ledlens75mm-spd.dxf

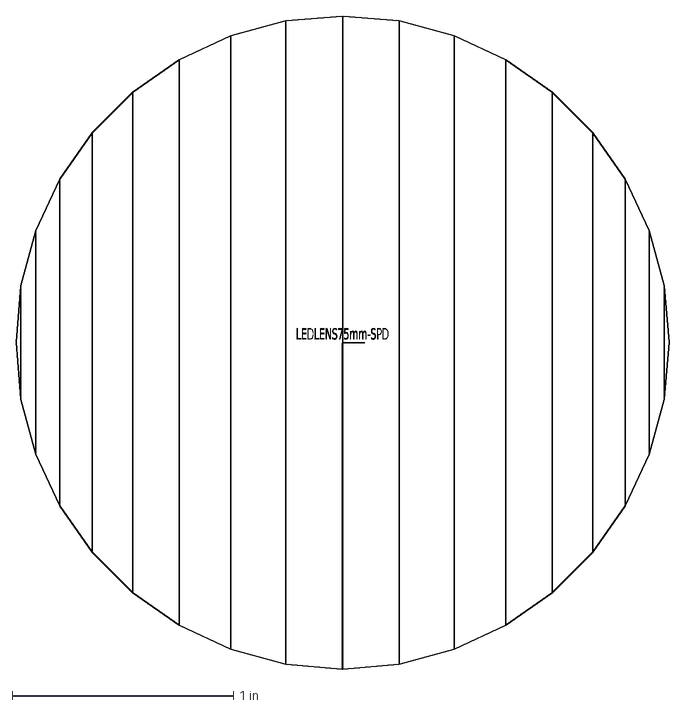
[picture p411: CAD file, 2019-03-14]
prj/hazelnut_large/LHC-001/8-Light Documentation and Simulations/new led lamp/ledlens75mm-spd.dxf
LEDLENS75mm-SPD
