OpenAgricultureFoundation/openag-mechanical/prj/hazelnut_large/LHC-001/8-Light Documentation and Simulations/XP-L-3000KCORE.SLDPRT

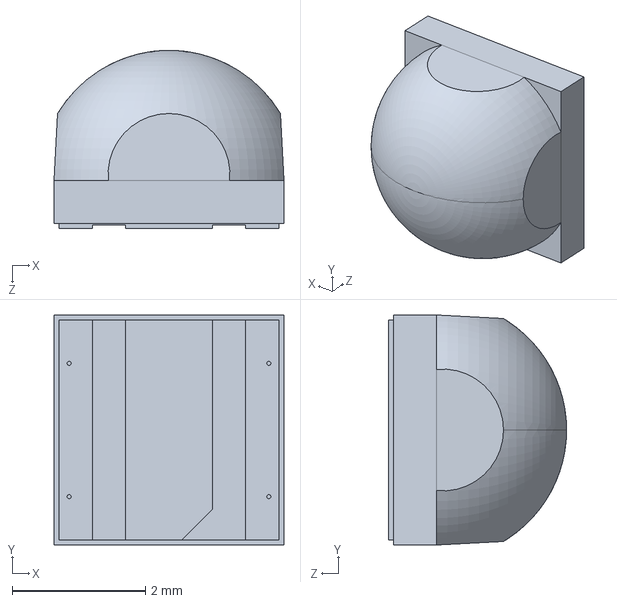
[picture p412: CAD file, 2019-03-14]
prj/hazelnut_large/LHC-001/8-Light Documentation and Simulations/XP-L-3000KCORE.SLDPRT
3.45 x 3.45 x 2.67 mm
