OpenAgricultureFoundation/openag-mechanical/prj/hazelnut_large/LHC-001/LHC-300/lhc-310.SLDPRT

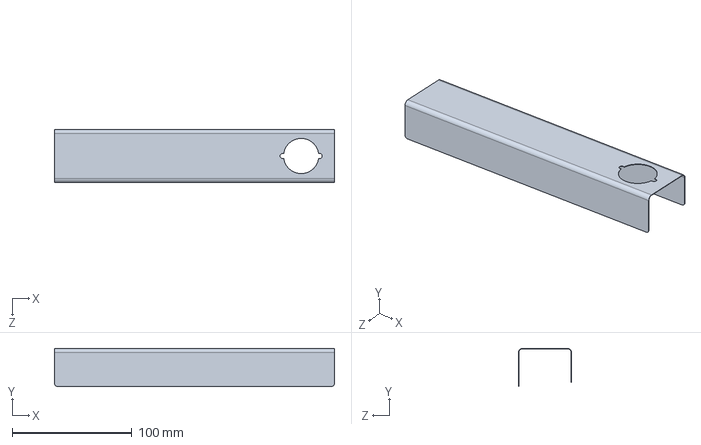
[picture p413: CAD file, 2019-10-30]
prj/hazelnut_large/LHC-001/LHC-300/lhc-310.SLDPRT
233.4 x 31.8 x 44.5 mm
