OpenAgricultureFoundation/openag-mechanical/prj/hazelnut_large/v1.0/hz_light_test_manifold/Bridgelux.SLDPRT

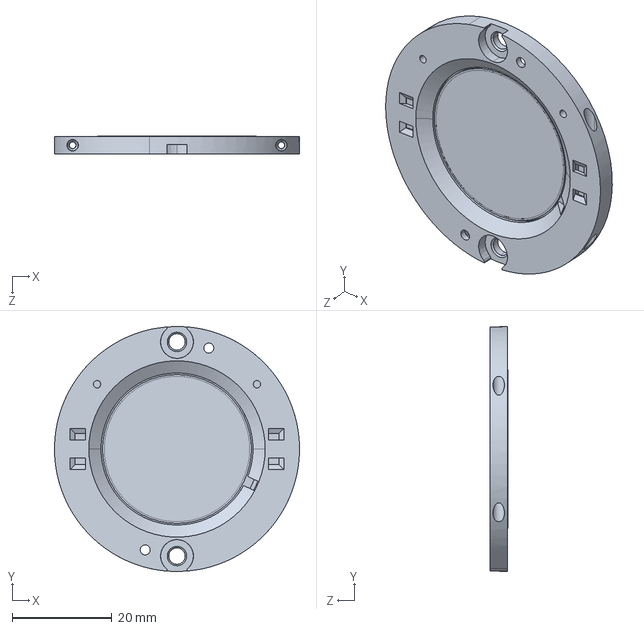
[picture p414: CAD file, 2019-01-14]
prj/hazelnut_large/v1.0/hz_light_test_manifold/Bridgelux.SLDPRT
49.2 x 49.2 x 3.60 mm
