OpenAgricultureFoundation/openag-mechanical/prj/hazelnut_large/v1.0/light_board_hood.SLDPRT

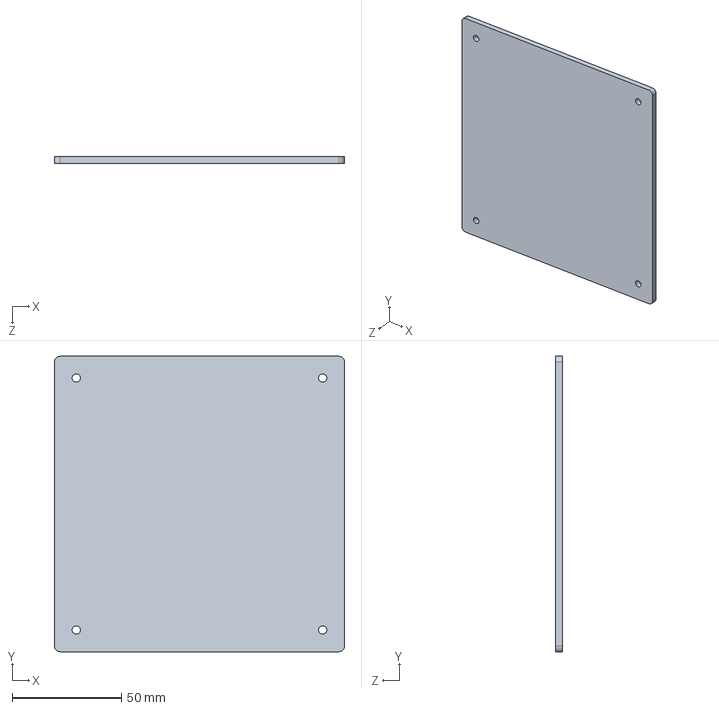
[picture p415: CAD file, 2018-09-26]
prj/hazelnut_large/v1.0/light_board_hood.SLDPRT
132.7 x 135.3 x 3.17 mm
