OpenAgricultureFoundation/openag-mechanical/prj/hazelnut_large/v1.0/rededge/standoff_516.SLDPRT

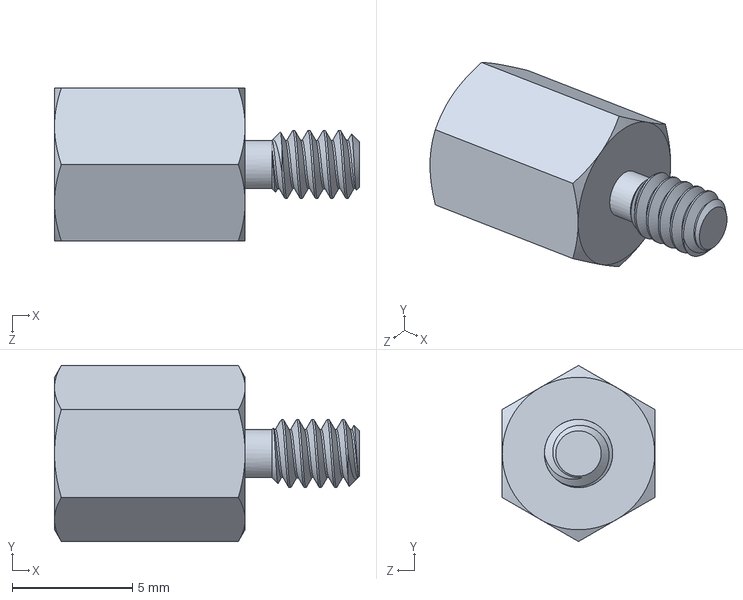
[picture p416: CAD file, 2018-08-10]
prj/hazelnut_large/v1.0/rededge/standoff_516.SLDPRT
12.7 x 7.33 x 6.35 mm
