OpenAgricultureFoundation/openag-mechanical/prj/hazelnut_small/v2-0/environments/SML_LIGHT MODULE/1621-1007-ND_KHATOD.SLDPRT

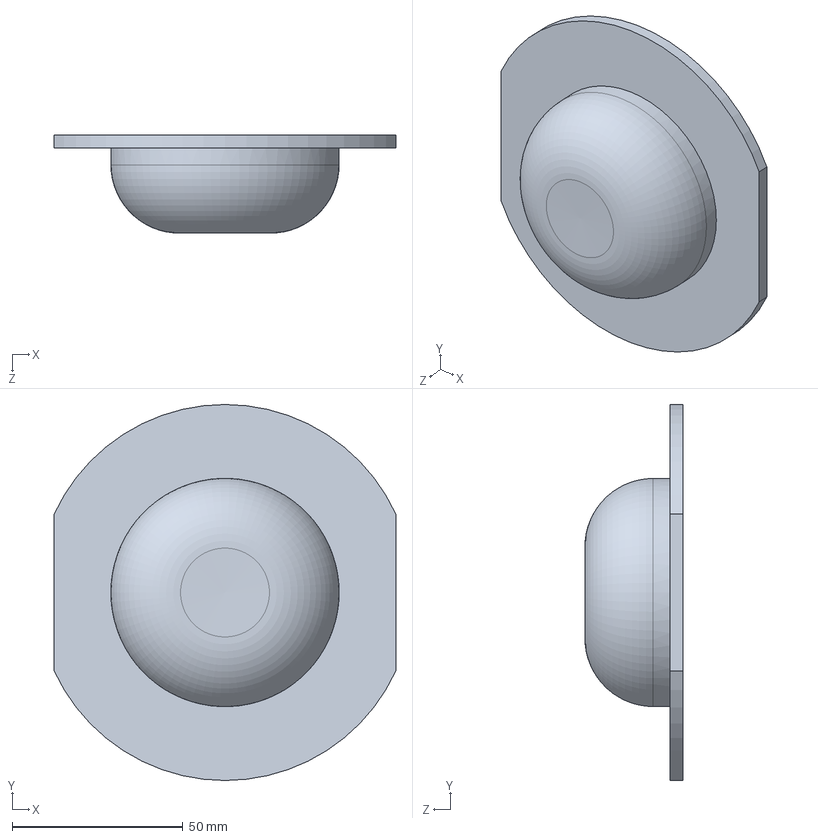
[picture p417: CAD file, 2019-02-14]
prj/hazelnut_small/v2-0/environments/SML_LIGHT MODULE/1621-1007-ND_KHATOD.SLDPRT
100.0 x 110.0 x 28.7 mm
