OpenAgricultureFoundation/openag-mechanical/prj/pfc-edu/Corrugated Plastic PFC/PFC.100 - 12x12x12 corrugated PFC/PFC.107.SLDPRT

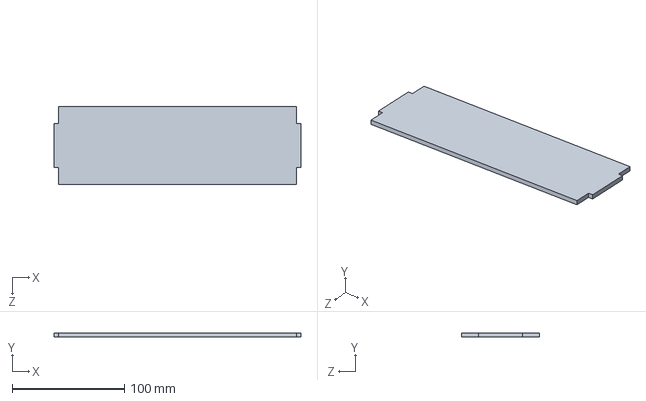
[picture p418: CAD file, 2019-09-18]
prj/pfc-edu/Corrugated Plastic PFC/PFC.100 - 12x12x12 corrugated PFC/PFC.107.SLDPRT
220.3 x 3.96 x 69.8 mm
