OpenAgricultureFoundation/openag-mechanical/prj/pfc-edu/Corrugated Plastic PFC/PFC.400 - 12x12x24 corrugated PFC/PFC.400_Master.SLDPRT

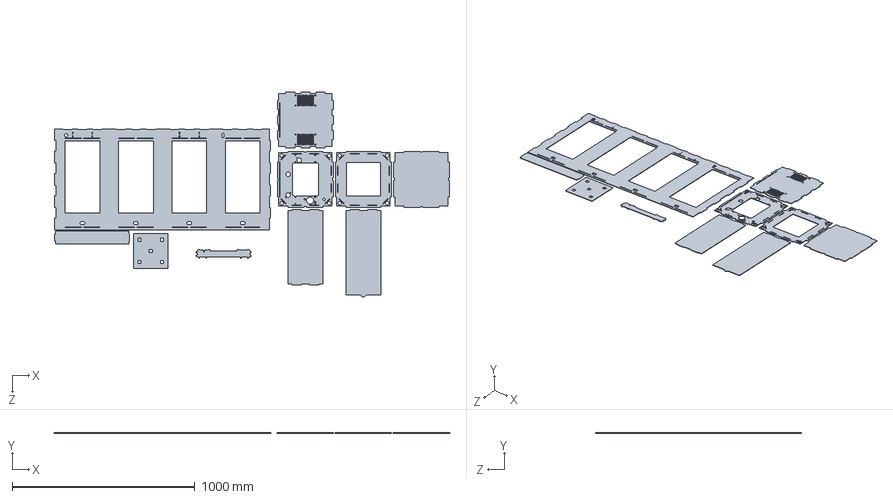
[picture p419: CAD file, 2019-01-23]
prj/pfc-edu/Corrugated Plastic PFC/PFC.400 - 12x12x24 corrugated PFC/PFC.400_Master.SLDPRT
2160.5 x 2.54 x 1121.4 mm
