OpenAgricultureFoundation/openag-mechanical/prj/container 1/Container/Door Frame.SLDPRT

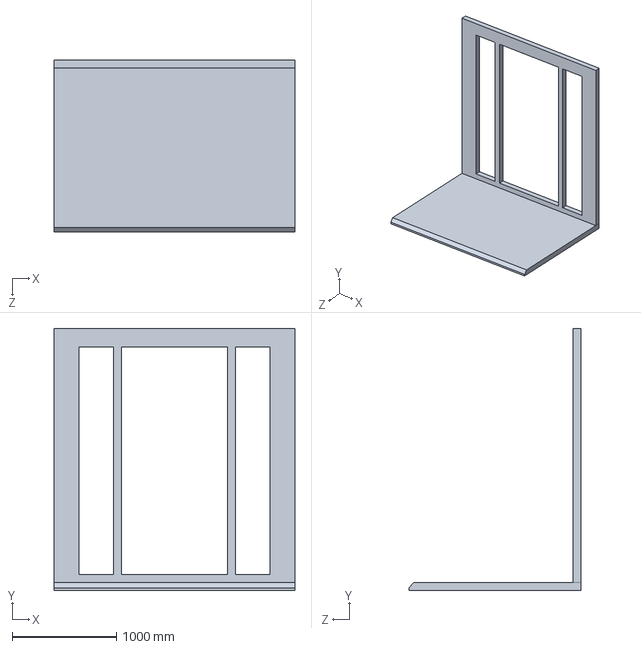
[picture p420: CAD file, 2019-07-03]
prj/container 1/Container/Door Frame.SLDPRT
2311.4 x 2514.6 x 1651.0 mm
