OpenAgricultureFoundation/openag-mechanical/prj/container 1/RCK.201/pvc-050-0045.SLDPRT

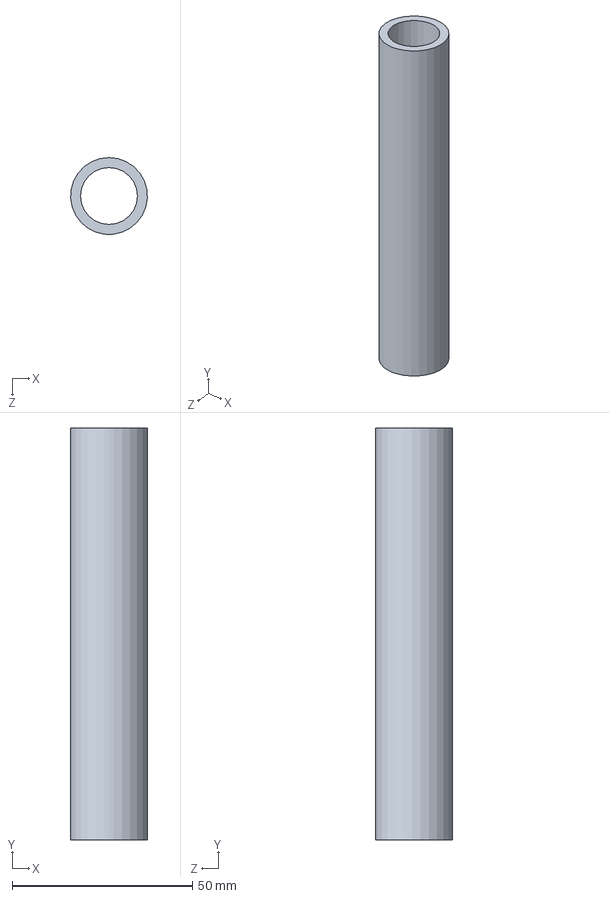
[picture p421: CAD file, 2019-09-18]
prj/container 1/RCK.201/pvc-050-0045.SLDPRT
21.3 x 114.3 x 21.3 mm
