OpenAgricultureFoundation/openag-mechanical/prj/container 3 rack v2/container 2 led-fixture/v1.0/10-17-18 Members Week Laser Cuts/panel_front.DXF

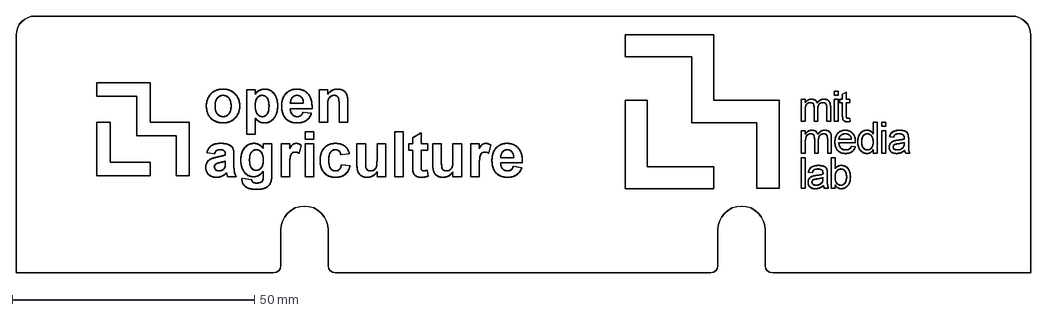
[picture p422: CAD file, 2018-10-29]
prj/container 3 rack v2/container 2 led-fixture/v1.0/10-17-18 Members Week Laser Cuts/panel_front.DXF
209.3 x 53.0 mm
