OpenAgricultureFoundation/openag-mechanical/prj/container 3 rack v2/container 2 led-fixture/v1.0/led fixture covers eugene 10-22-18/side1.DXF

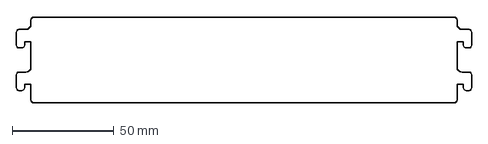
[picture p423: CAD file, 2018-10-29]
prj/container 3 rack v2/container 2 led-fixture/v1.0/led fixture covers eugene 10-22-18/side1.DXF
223.9 x 42.0 mm
