OpenAgricultureFoundation/openag-mechanical/prj/container 3 rack v2/hanging-fan/fan-hooks.SLDPRT

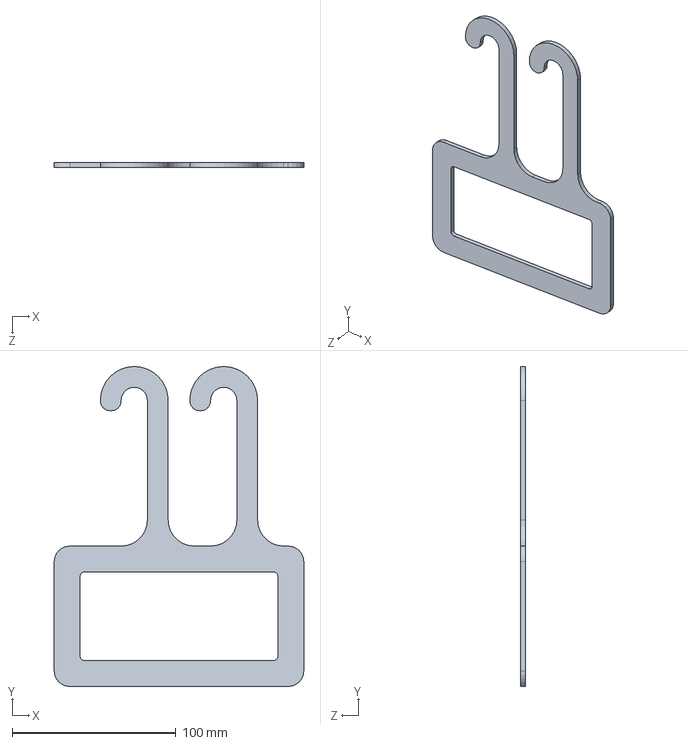
[picture p424: CAD file, 2018-09-12]
prj/container 3 rack v2/hanging-fan/fan-hooks.SLDPRT
152.4 x 195.3 x 3.17 mm
