OpenAgricultureFoundation/openag-mechanical/prj/fermentabot/FMT001/Laser Cut Parts 10-15-18/Side_1_DOOR.DXF

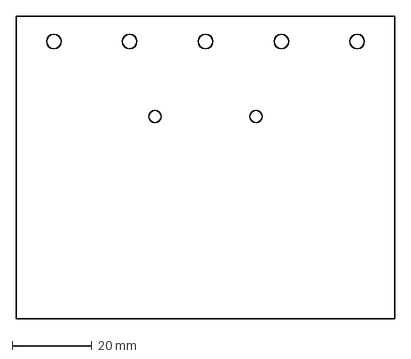
[picture p426: CAD file, 2018-10-16]
prj/fermentabot/FMT001/Laser Cut Parts 10-15-18/Side_1_DOOR.DXF
95.0 x 76.0 mm
