OpenAgricultureFoundation/openag-mechanical/prj/fermentabot/FMT001/Laser cut parts 7-18-18/FMT.006-1.DXF

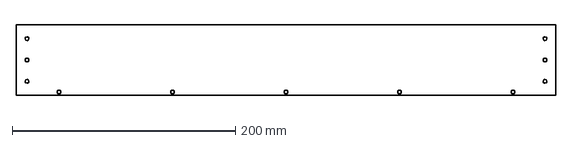
[picture p427: CAD file, 2018-07-19]
prj/fermentabot/FMT001/Laser cut parts 7-18-18/FMT.006-1.DXF
482.6 x 63.5 mm
