OpenAgricultureFoundation/openag-mechanical/prj/fermentabot/FMT201/12-6-18 PROTOTYPE CUT PARTS/SIDE_BIG_PELTIER.DXF

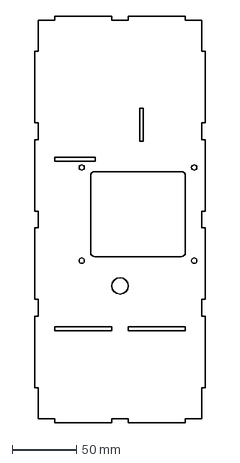
[picture p428: CAD file, 2018-12-11]
prj/fermentabot/FMT201/12-6-18 PROTOTYPE CUT PARTS/SIDE_BIG_PELTIER.DXF
132.9 x 315.8 mm
