OpenAgricultureFoundation/openag-mechanical/prj/fermentabot/FMT201/2019.01.28 FMT201 Database/HEATER POWER SUPPLY.SLDPRT

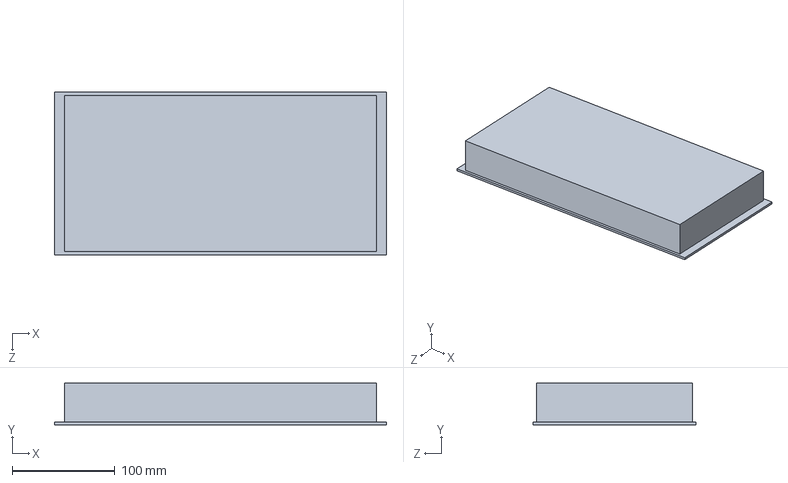
[picture p429: CAD file, 2019-03-12]
prj/fermentabot/FMT201/2019.01.28 FMT201 Database/HEATER POWER SUPPLY.SLDPRT
323.9 x 40.6 x 158.8 mm
