OpenAgricultureFoundation/openag-mechanical/prj/fermentabot/FMT201/AIR SYSTEM 9-18-18/FMT.010.SLDPRT

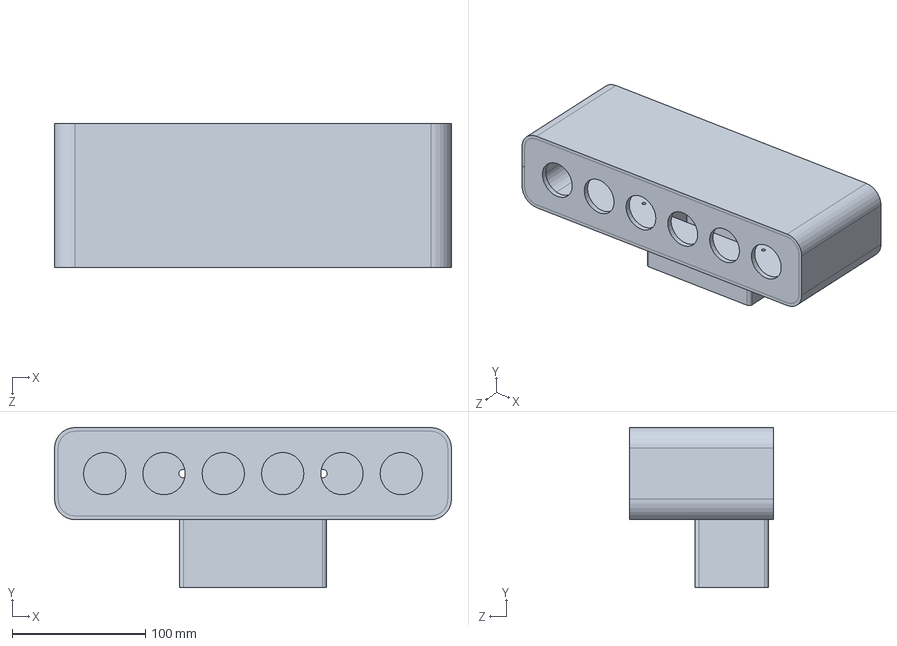
[picture p430: CAD file, 2018-11-05]
prj/fermentabot/FMT201/AIR SYSTEM 9-18-18/FMT.010.SLDPRT
297.4 x 119.9 x 108.0 mm
