OpenAgricultureFoundation/openag-mechanical/prj/fs-waterbot/v1.0/part_drawings/dampener.SLDPRT

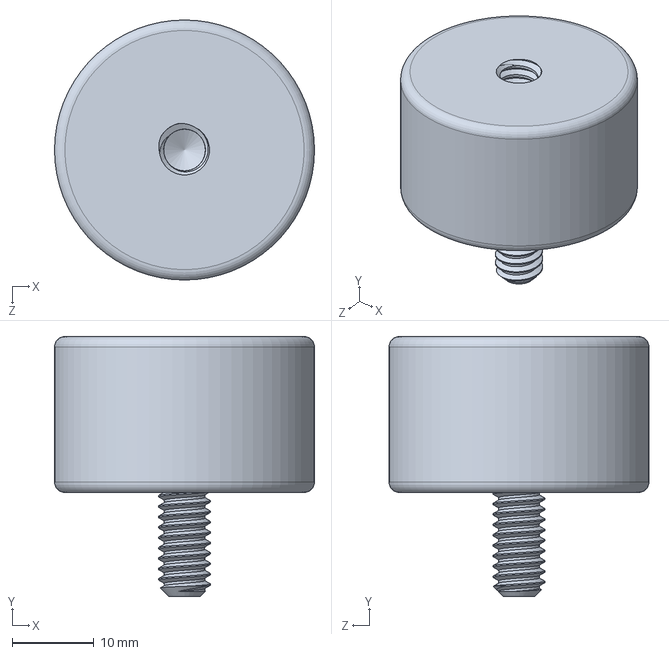
[picture p431: CAD file, 2018-05-29]
prj/fs-waterbot/v1.0/part_drawings/dampener.SLDPRT
31.8 x 31.8 x 31.8 mm
