OpenAgricultureFoundation/openag-mechanical/prj/fs-waterbot/v1.0/solidworks/solenoid_valve.SLDPRT

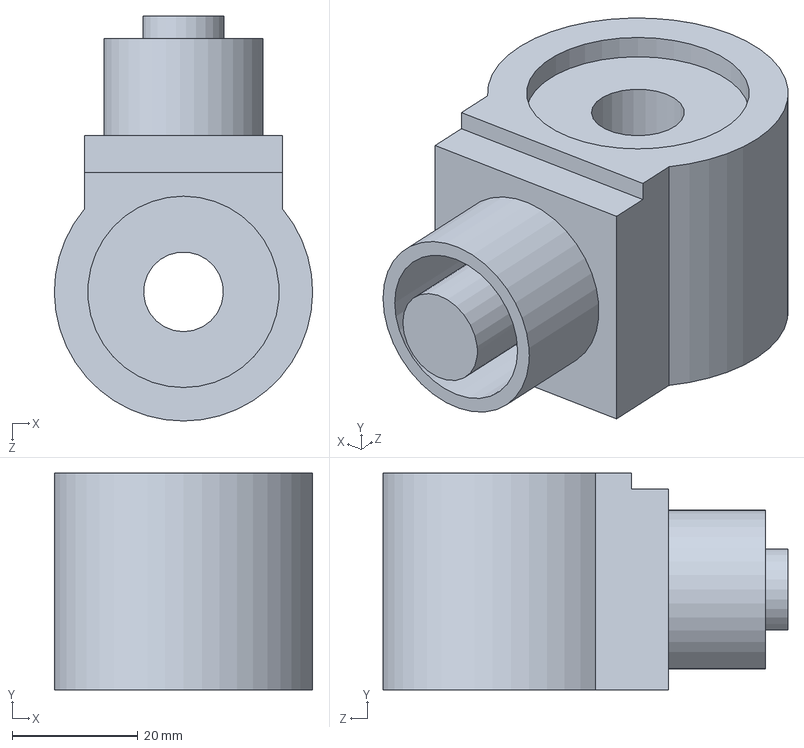
[picture p432: CAD file, 2018-05-29]
prj/fs-waterbot/v1.0/solidworks/solenoid_valve.SLDPRT
41.1 x 34.5 x 64.5 mm
