OpenAgricultureFoundation/openag-mechanical/prj/germinator v3/Nervous_System_Rack_Mount_Board.SLDPRT

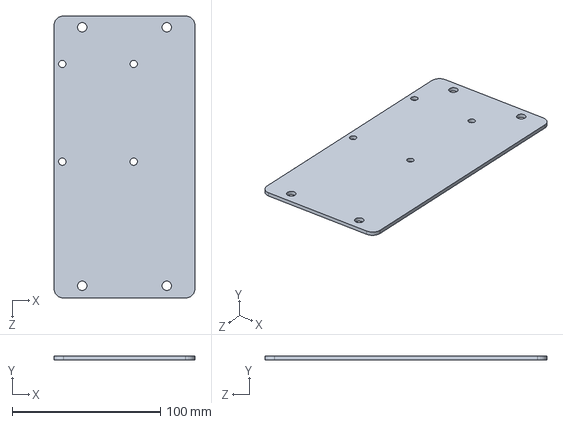
[picture p433: CAD file, 2018-10-29]
prj/germinator v3/Nervous_System_Rack_Mount_Board.SLDPRT
95.2 x 2.54 x 190.5 mm
