OpenAgricultureFoundation/openag-mechanical/prj/hazelnut_large/LHC-001/8-Light Documentation and Simulations/CollimatorTutotrial-SW2015/cylinder.SLDPRT

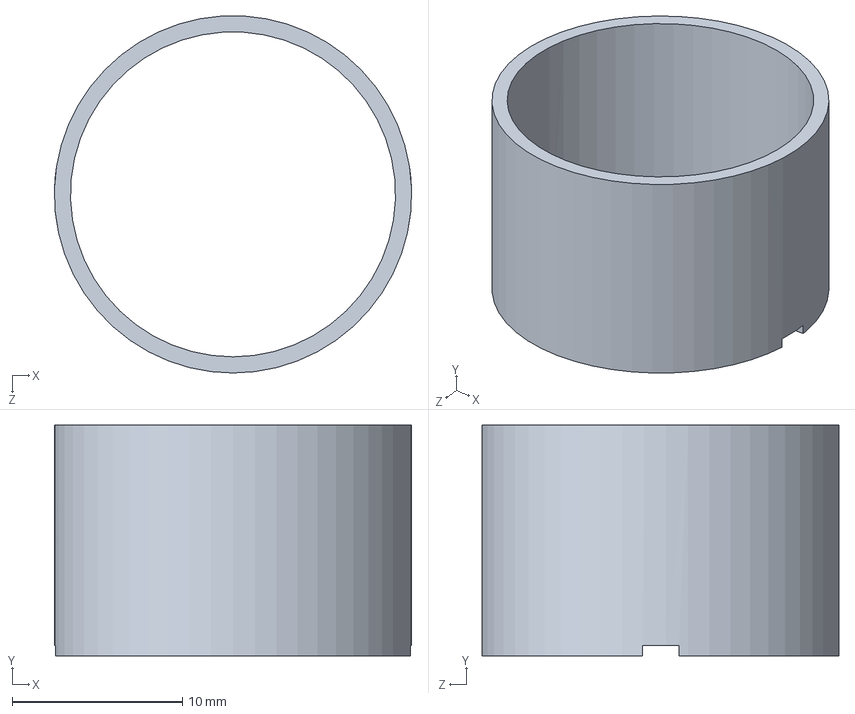
[picture p434: CAD file, 2019-03-14]
prj/hazelnut_large/LHC-001/8-Light Documentation and Simulations/CollimatorTutotrial-SW2015/cylinder.SLDPRT
21.0 x 13.6 x 21.0 mm
