OpenAgricultureFoundation/openag-mechanical/prj/hazelnut_large/LHC-001/LHC-100/WAREHOUSE_PLANNING.SLDPRT

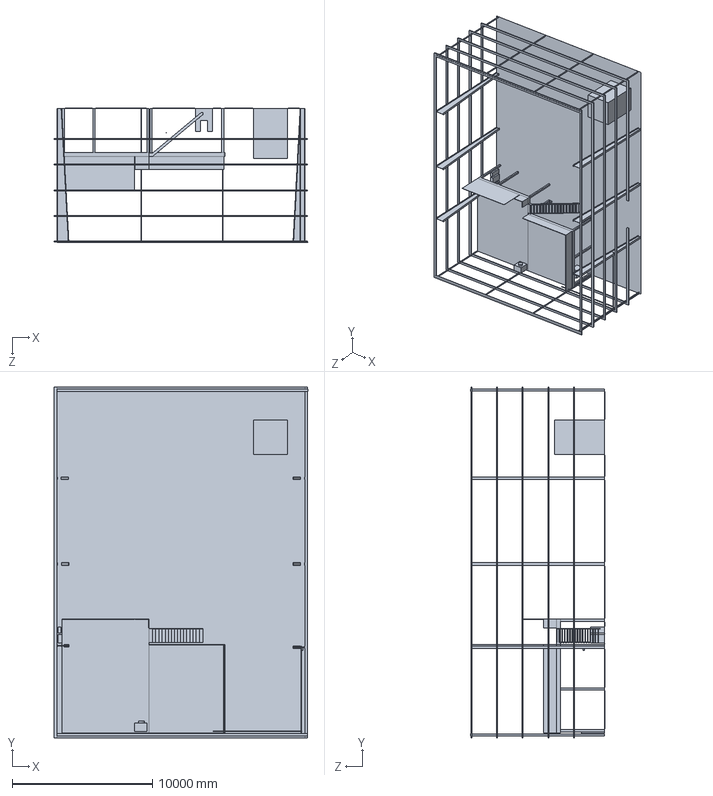
[picture p436: CAD file, 2019-10-10]
prj/hazelnut_large/LHC-001/LHC-100/WAREHOUSE_PLANNING.SLDPRT
18056.5 x 24993.6 x 9557.0 mm
