OpenAgricultureFoundation/openag-mechanical/prj/hazelnut_large/LHC-001/LHC-200/Tree/Tr_1.SLDPRT

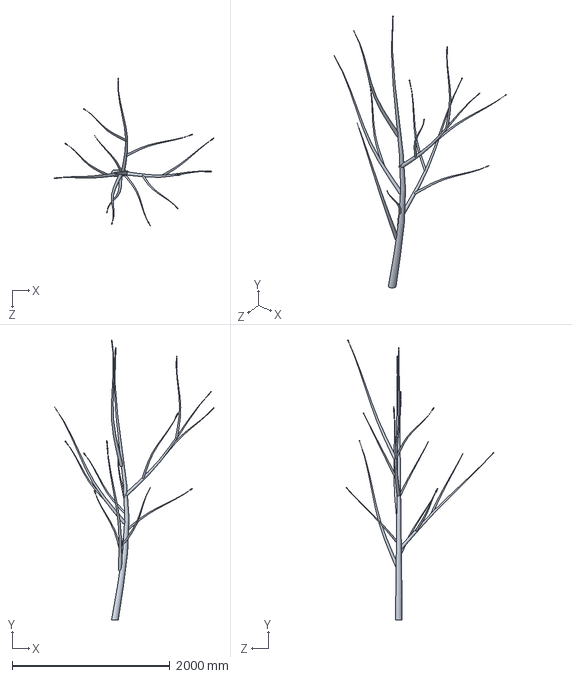
[picture p437: CAD file, 2019-10-22]
prj/hazelnut_large/LHC-001/LHC-200/Tree/Tr_1.SLDPRT
2023.7 x 3552.7 x 1869.1 mm
