OpenAgricultureFoundation/openag-mechanical/prj/hazelnut_large/LHC-001/LHC-300/HEAT SINK HOLE JIG.SLDPRT

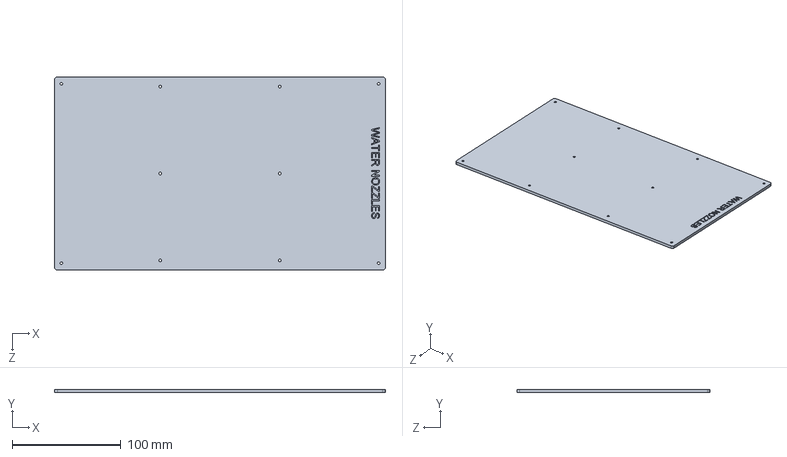
[picture p438: CAD file, 2019-10-30]
prj/hazelnut_large/LHC-001/LHC-300/HEAT SINK HOLE JIG.SLDPRT
304.8 x 3.17 x 177.8 mm
