OpenAgricultureFoundation/openag-mechanical/prj/hazelnut_large/LHC-001/LHC-400/Foam Insulation Box.SLDPRT

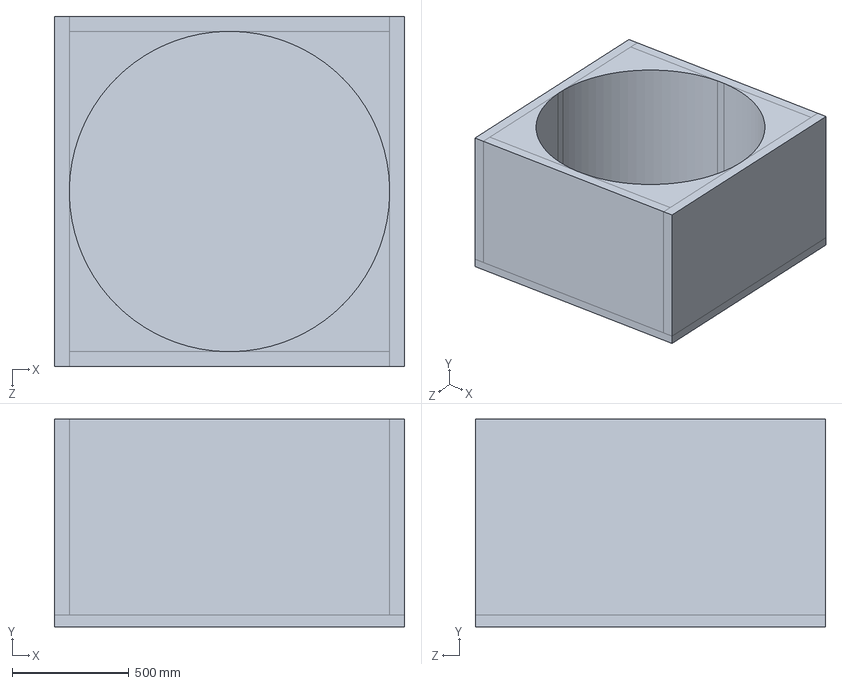
[picture p439: CAD file, 2019-10-22]
prj/hazelnut_large/LHC-001/LHC-400/Foam Insulation Box.SLDPRT
1498.6 x 889.0 x 1498.6 mm
