OpenAgricultureFoundation/openag-mechanical/prj/hazelnut_large/v1.0/hz_light_test_manifold/heatsink.SLDPRT

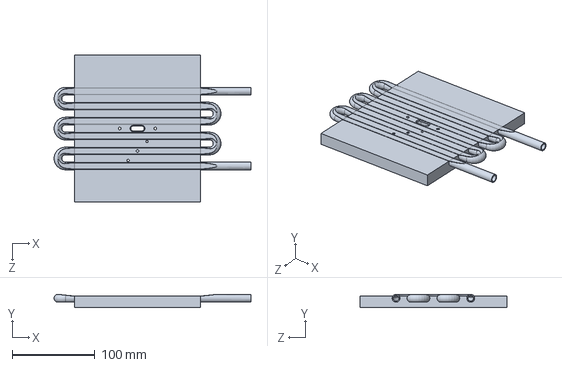
[picture p440: CAD file, 2019-01-14]
prj/hazelnut_large/v1.0/hz_light_test_manifold/heatsink.SLDPRT
237.8 x 16.1 x 177.8 mm
