OpenAgricultureFoundation/openag-mechanical/prj/hazelnut_large/v1.0/pex_mount.SLDPRT

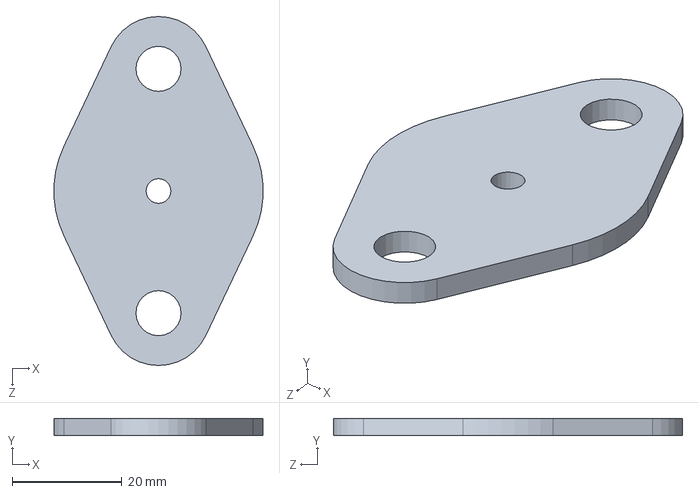
[picture p441: CAD file, 2018-05-29]
prj/hazelnut_large/v1.0/pex_mount.SLDPRT
38.0 x 3.17 x 63.5 mm
