OpenAgricultureFoundation/openag-mechanical/prj/hazelnut_small/v2-0/environments/aluminum_rail.SLDPRT

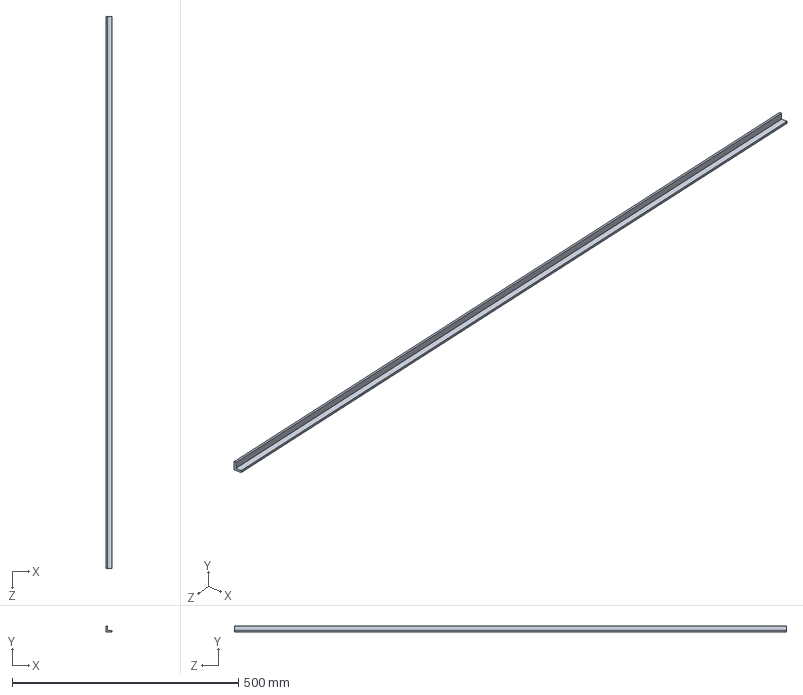
[picture p442: CAD file, 2019-02-08]
prj/hazelnut_small/v2-0/environments/aluminum_rail.SLDPRT
12.7 x 12.7 x 1219.2 mm
