OpenAgricultureFoundation/openag-mechanical/prj/hazelnut_small/v2-0/environments/frameworks/lrg_tree_mock.SLDPRT

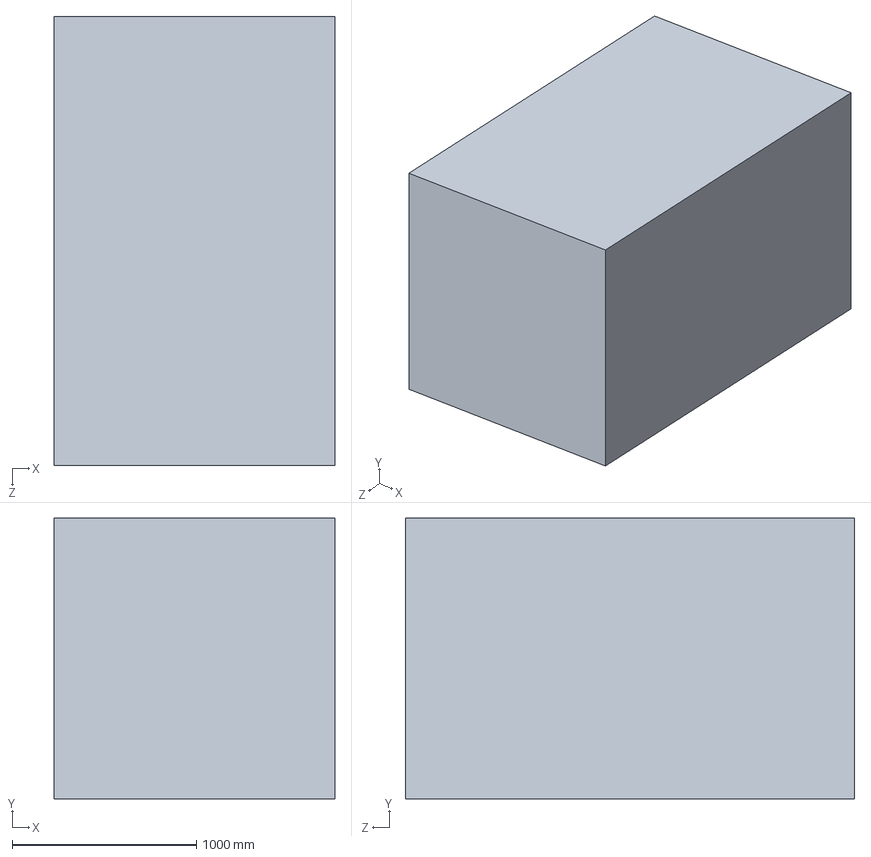
[picture p443: CAD file, 2019-02-12]
prj/hazelnut_small/v2-0/environments/frameworks/lrg_tree_mock.SLDPRT
1524.0 x 1524.0 x 2438.4 mm
