OpenAgricultureFoundation/openag-mechanical/prj/pfc-edu/Corrugated Plastic PFC/PFC.100 - 12x12x12 corrugated PFC/PFC.106.SLDPRT

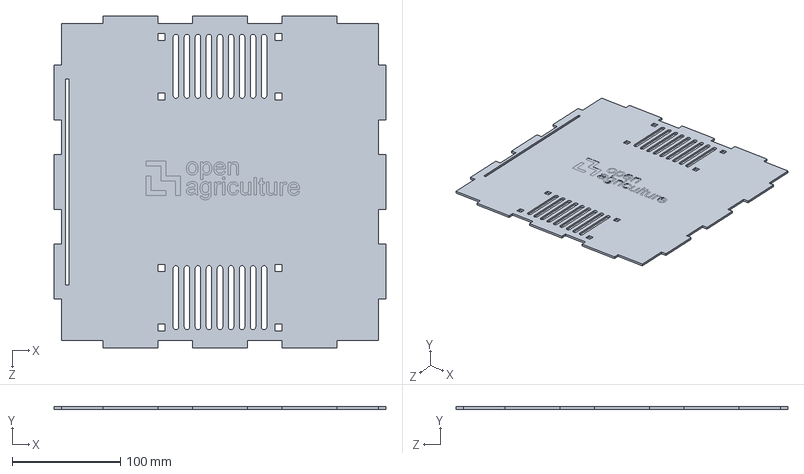
[picture p444: CAD file, 2019-09-18]
prj/pfc-edu/Corrugated Plastic PFC/PFC.100 - 12x12x12 corrugated PFC/PFC.106.SLDPRT
306.3 x 2.54 x 306.3 mm
