OpenAgricultureFoundation/openag-mechanical/prj/pfc-edu/Corrugated Plastic PFC/PFC.200 - 6x6x6 corrugated PFC/PFC.203.SLDPRT

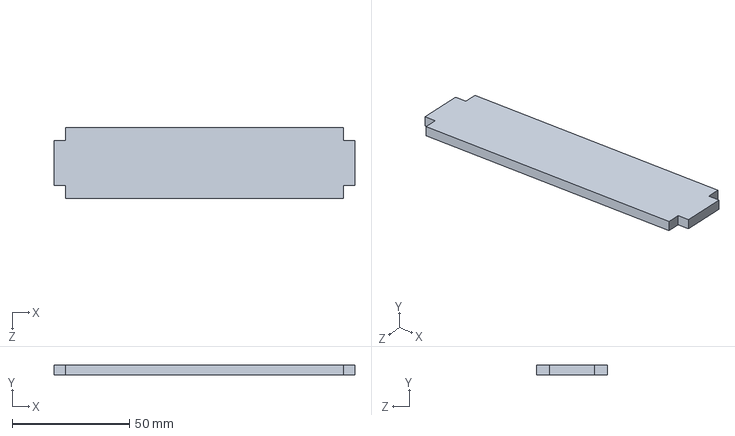
[picture p445: CAD file, 2019-08-06]
prj/pfc-edu/Corrugated Plastic PFC/PFC.200 - 6x6x6 corrugated PFC/PFC.203.SLDPRT
128.4 x 4.06 x 30.5 mm
