OpenAgricultureFoundation/openag-mechanical/prj/pfc-edu/Corrugated Plastic PFC/PFC.300 - 4x4x4 corrugated PFC/PFC.303.SLDPRT

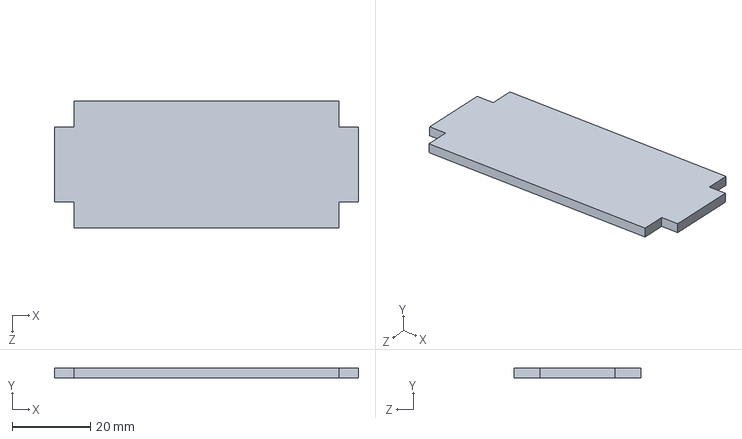
[picture p446: CAD file, 2019-02-14]
prj/pfc-edu/Corrugated Plastic PFC/PFC.300 - 4x4x4 corrugated PFC/PFC.303.SLDPRT
77.6 x 2.54 x 32.4 mm
