OpenAgricultureFoundation/openag-mechanical/prj/pfc-edu/Corrugated Plastic PFC/PFC.400 - 12x12x24 corrugated PFC/PFC.101_Master_CUT_FILE.DXF

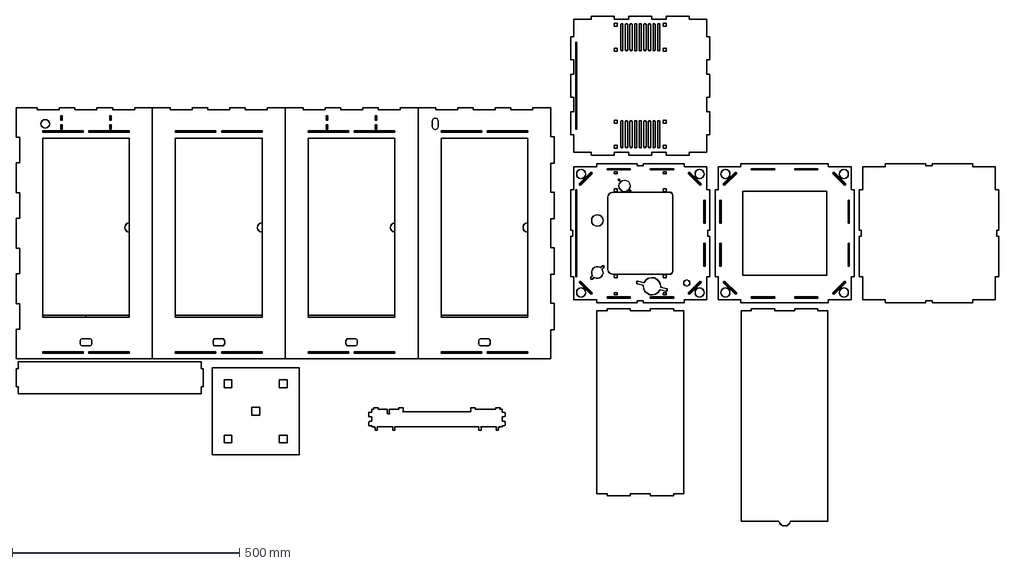
[picture p447: CAD file, 2019-01-17]
prj/pfc-edu/Corrugated Plastic PFC/PFC.400 - 12x12x24 corrugated PFC/PFC.101_Master_CUT_FILE.DXF
2160.5 x 1121.5 mm
