OpenAgricultureFoundation/openag-mechanical/prj/container 1/Container/Single Door Commercial Internal Left.SLDPRT

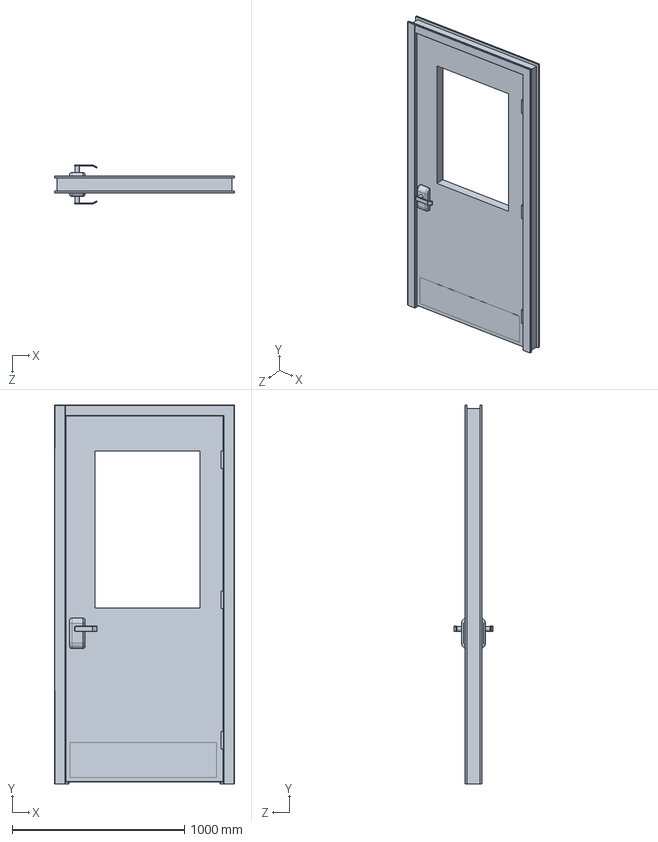
[picture p448: CAD file, 2019-07-03]
prj/container 1/Container/Single Door Commercial Internal Left.SLDPRT
1047.8 x 2203.4 x 228.6 mm
