OpenAgricultureFoundation/openag-mechanical/prj/container 3 rack v2/container 2 led-fixture/v1.0/10-17-18 Members Week Laser Cuts/elect-panel-1.DXF

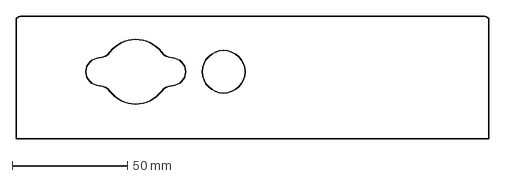
[picture p449: CAD file, 2018-10-29]
prj/container 3 rack v2/container 2 led-fixture/v1.0/10-17-18 Members Week Laser Cuts/elect-panel-1.DXF
205.0 x 53.0 mm
