OpenAgricultureFoundation/openag-mechanical/prj/fermentabot/FMT001/FERMENTABOT_SIGN.SLDPRT

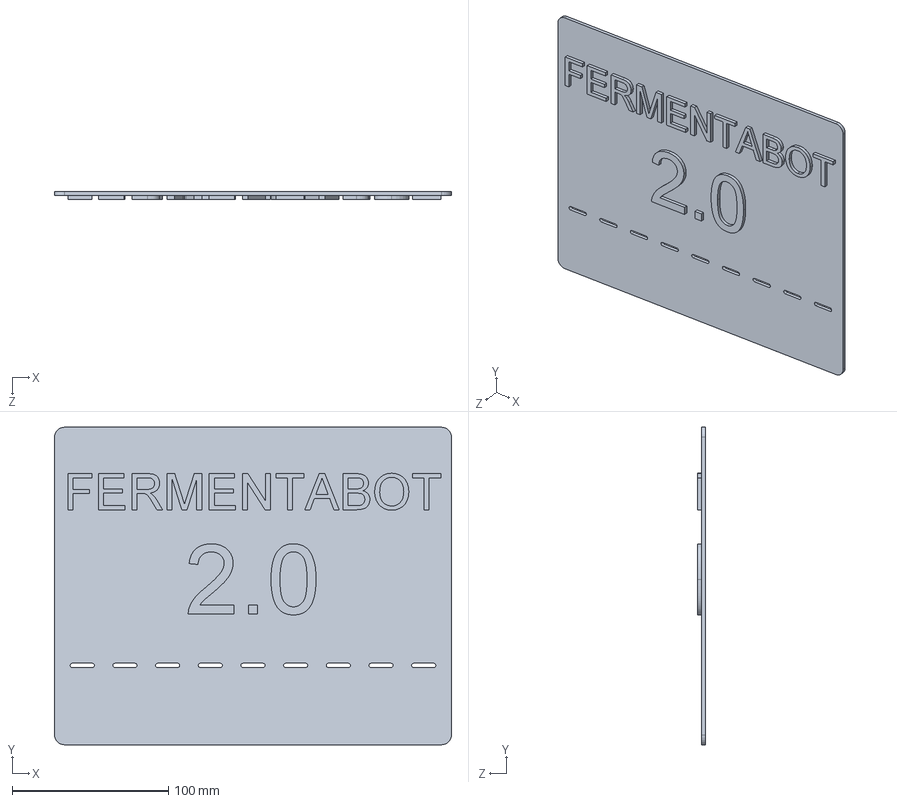
[picture p451: CAD file, 2018-10-29]
prj/fermentabot/FMT001/FERMENTABOT_SIGN.SLDPRT
254.0 x 203.2 x 5.08 mm
