OpenAgricultureFoundation/openag-mechanical/prj/fermentabot/FMT001/Laser Cut Parts 10-15-18/Side_4.DXF

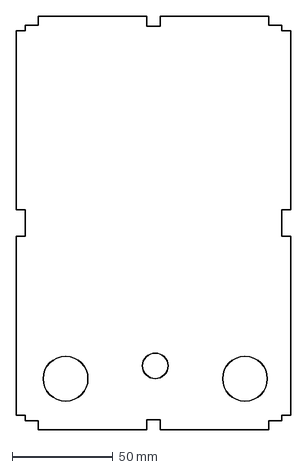
[picture p452: CAD file, 2018-10-16]
prj/fermentabot/FMT001/Laser Cut Parts 10-15-18/Side_4.DXF
136.0 x 205.1 mm
