OpenAgricultureFoundation/openag-mechanical/prj/fermentabot/FMT001/Laser cut parts 7-18-18/FMT.006-2.DXF

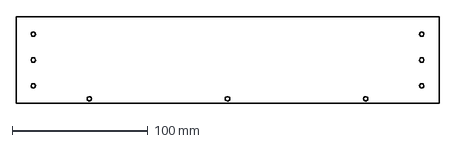
[picture p453: CAD file, 2018-07-19]
prj/fermentabot/FMT001/Laser cut parts 7-18-18/FMT.006-2.DXF
311.1 x 63.5 mm
