OpenAgricultureFoundation/openag-mechanical/prj/fermentabot/FMT201/12-6-18 PROTOTYPE CUT PARTS/TROUGH_CENTER.DXF

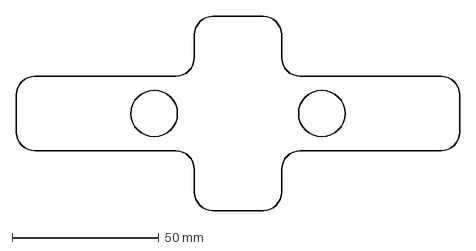
[picture p454: CAD file, 2018-12-11]
prj/fermentabot/FMT201/12-6-18 PROTOTYPE CUT PARTS/TROUGH_CENTER.DXF
151.2 x 66.3 mm
