OpenAgricultureFoundation/openag-mechanical/prj/fermentabot/FMT201/AIR SYSTEM 9-18-18/FMT.011.SLDPRT

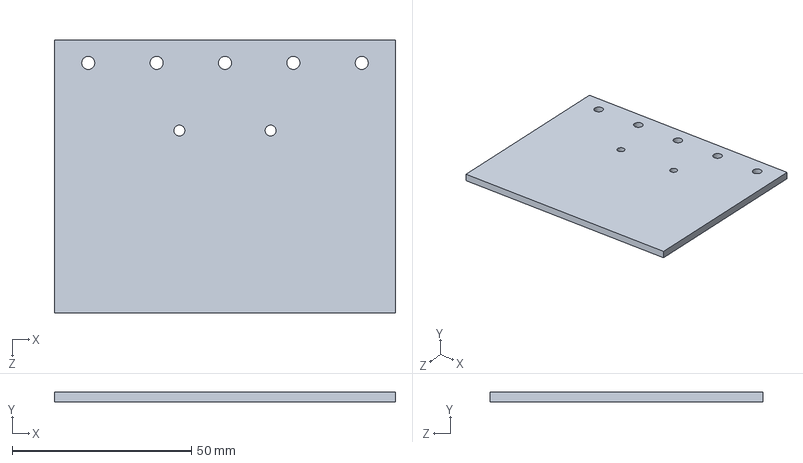
[picture p455: CAD file, 2018-10-16]
prj/fermentabot/FMT201/AIR SYSTEM 9-18-18/FMT.011.SLDPRT
95.0 x 2.79 x 76.0 mm
