OpenAgricultureFoundation/openag-mechanical/prj/fs-waterbot/v1.0/part_drawings/manifold_board.DXF

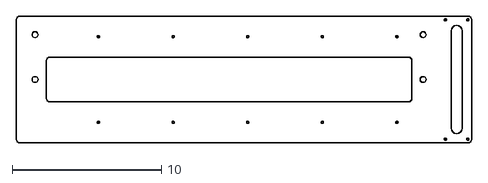
[picture p456: CAD file, 2018-05-29]
prj/fs-waterbot/v1.0/part_drawings/manifold_board.DXF
30.5 x 8.50
