OpenAgricultureFoundation/openag-mechanical/prj/hazelnut_large/LHC-001/8-Light Documentation and Simulations/CollimatorTutotrial-SW2015/IlluminancePlane.SLDPRT

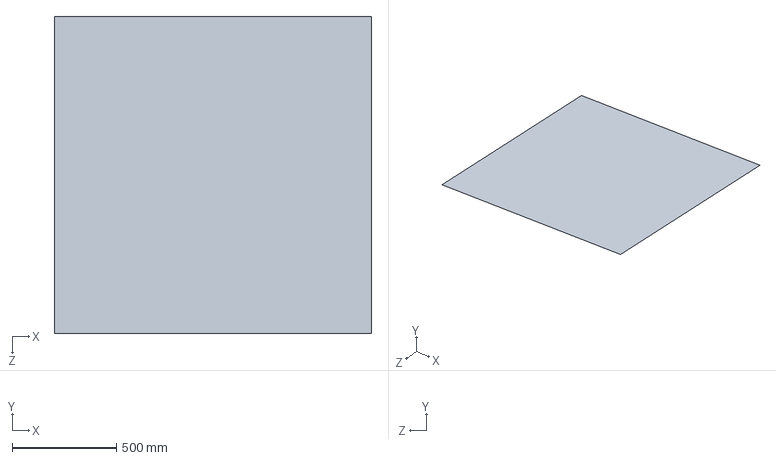
[picture p457: CAD file, 2019-03-14]
prj/hazelnut_large/LHC-001/8-Light Documentation and Simulations/CollimatorTutotrial-SW2015/IlluminancePlane.SLDPRT
1524.0 x 0 x 1524.0 mm
