OpenAgricultureFoundation/openag-mechanical/prj/hazelnut_large/LHC-001/LHC-200/forklift/cyl10.SLDPRT

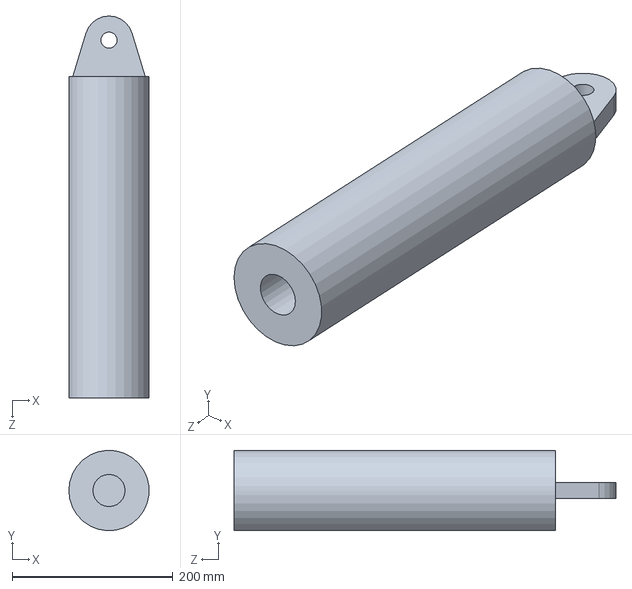
[picture p459: CAD file, 2019-02-14]
prj/hazelnut_large/LHC-001/LHC-200/forklift/cyl10.SLDPRT
100.0 x 99.9 x 475.0 mm
