OpenAgricultureFoundation/openag-mechanical/prj/hazelnut_large/LHC-001/LHC-200/Tree/Сборка1.SLDPRT

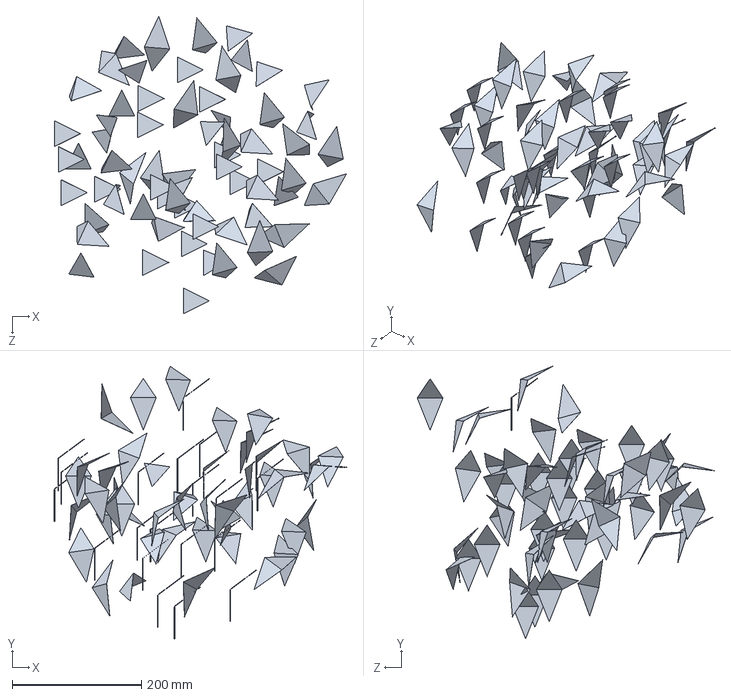
[picture p460: CAD file, 2019-10-22]
prj/hazelnut_large/LHC-001/LHC-200/Tree/Сборка1.SLDPRT
452.4 x 422.1 x 461.0 mm
