OpenAgricultureFoundation/openag-mechanical/prj/hazelnut_large/LHC-001/LHC-400/WarmBoard-S-2x4.SLDPRT

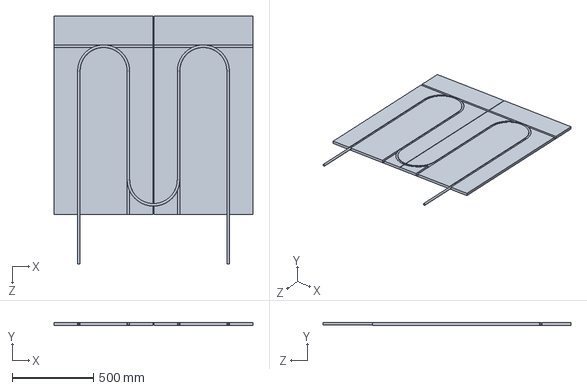
[picture p461: CAD file, 2019-10-22]
prj/hazelnut_large/LHC-001/LHC-400/WarmBoard-S-2x4.SLDPRT
1222.4 x 19.1 x 1524.0 mm
