OpenAgricultureFoundation/openag-mechanical/prj/hazelnut_large/v1.0/fan_mount.SLDPRT

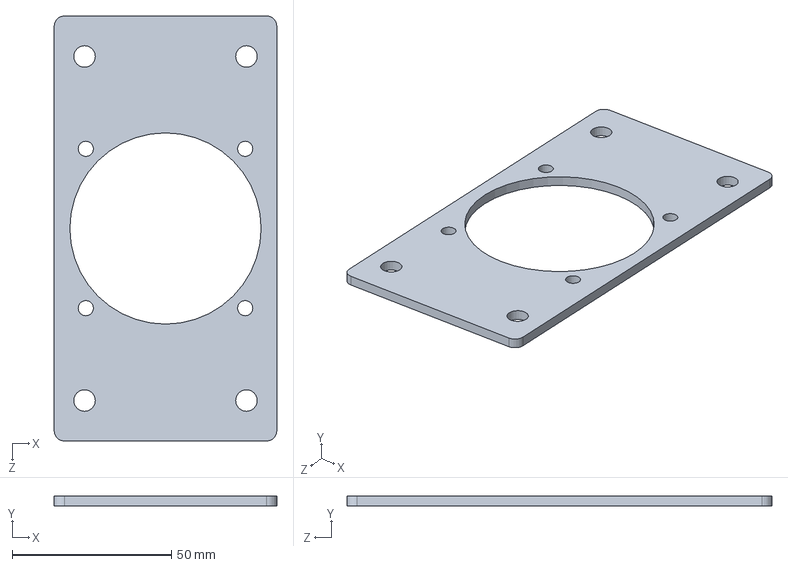
[picture p462: CAD file, 2018-05-29]
prj/hazelnut_large/v1.0/fan_mount.SLDPRT
69.8 x 3.17 x 133.4 mm
