OpenAgricultureFoundation/openag-mechanical/prj/hazelnut_large/v1.0/rededge/rededge_mount.SLDPRT

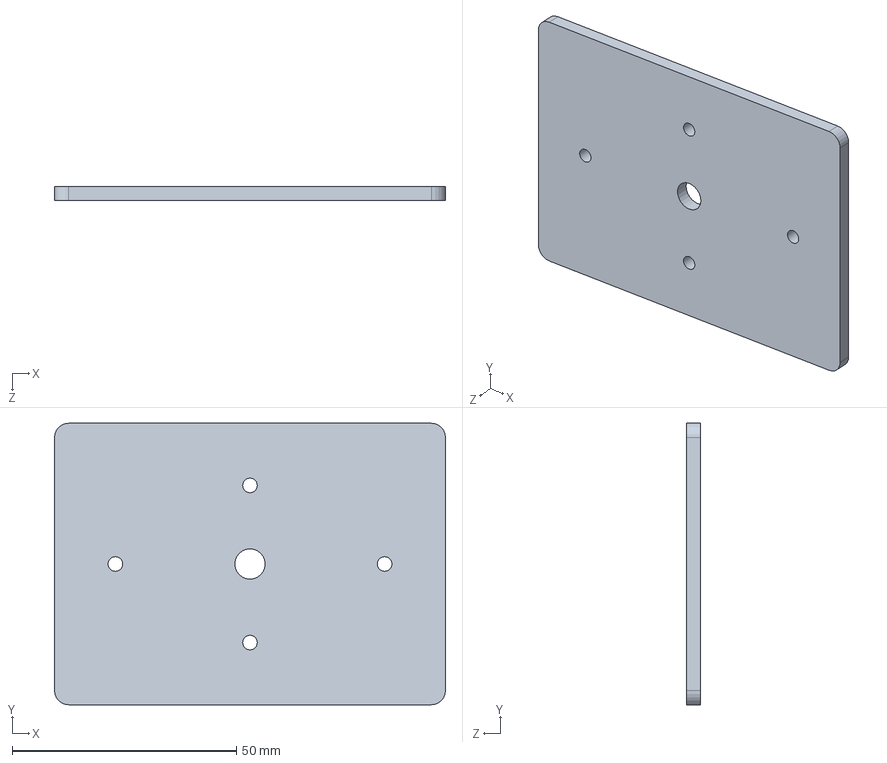
[picture p463: CAD file, 2018-08-08]
prj/hazelnut_large/v1.0/rededge/rededge_mount.SLDPRT
87.1 x 62.7 x 3.17 mm
