OpenAgricultureFoundation/openag-mechanical/(list of files, cad)

Other CAD files:
SolidWorks Templates/MIT_OpenAg_Assembly_Template.SLDASM
prj/hazelnut_large/v1.0/tims_test folder/photopia_tutorial_assembly.SLDASM
prj/container 3 rack v2/LFR.102.SLDASM
prj/hazelnut_large/LHC-001/8-Light Documentation and Simulations/lhc-417.SLDASM
prj/container 1/RCK.201/fan-assembly.SLDASM
prj/container 1/RCK.201/LightPanel.SLDASM
prj/container 3 rack v2/reservroir_assembly.SLDASM
prj/container 1/RCK.201/90_assembly.SLDASM
prj/fs-waterbot/v1.0/solidworks/Pipe_1-dosatron_subassembly.sldasm
prj/container 1/RCK.201/manifold_intake.SLDASM
prj/germinator v3/side_assembly.SLDASM
prj/germinator v3/wheel_assembly.SLDASM
prj/container 1/RCK.201/manifold_outlet.SLDASM
prj/fs-waterbot/v1.0/solidworks/Pipe_2-master_outlet.sldasm
prj/container 1/RCK.201/drain_assembly.SLDASM
prj/container 1/RCK.201/straight_assembly.SLDASM
prj/hazelnut_large/v1.0/lrg_hz_light/framework.SLDPRT
prj/pfc-edu/v5.0/Logo SprayPaint Stencil.SLDPRT
SolidWorks Templates/MIT_OpenAg_Part_Template.SLDPRT
SolidWorks Templates/4x8_template.SLDDRW
SolidWorks Templates/MIT_OpenAg_Drawing_SizeA_Template.SLDDRW
SolidWorks Templates/MIT_OpenAg_Drawing_SizeC_Template.SLDDRW
prj/container 1/Container/I-Beam.SLDPRT
prj/container 1/Container/Stairs.SLDPRT
prj/container 1/RCK.201/1586A130_SURFACE-MOUNT HINGE.SLDPRT
prj/container 1/RCK.201/2615T130_VIBRATION-DAMPING CLAMPING HANGER.SLDPRT
prj/container 1/RCK.201/3338A22_HORIZONTAL_SURFACE_MOUNT_LEVEL.SLDPRT
prj/container 1/RCK.201/5-15-18_Cart_Racks.SLDPRT
prj/container 1/RCK.201/5346K460_BRASS BARBED HOSE FITTING.SLDPRT
prj/container 1/RCK.201/5648K263_CHOOSE-A-COLOR POLYURETHANE TUBING.SLDPRT
prj/container 1/RCK.201/6308T12 Wye-Shaped On-Off Valve.SLDPRT
prj/container 1/RCK.201/73605T87 3-4 GHT Male x 1-2 NPT Male Adapter.SLDPRT
prj/container 1/RCK.201/7429K480_SNAP-IN PLASTIC CLAMP.SLDPRT
prj/container 1/RCK.201/76665A68_VHB_TAPE.SLDPRT
prj/container 1/RCK.201/8 ft folding table.SLDPRT
prj/container 1/RCK.201/90730A006_TYPE 18-8 STAINLESS STEEL NARROW HEX NUT.SLDPRT
prj/container 1/RCK.201/92386A632_SS THRD-LOCKING ADJUSTING POSITIONING STUD.SLDPRT
prj/container 1/RCK.201/92949A133_18-8 SS BUTTON-HEAD SOCKET CAP SCREW.SLDPRT
prj/container 1/RCK.201/92949A151_18-8 SS BUTTON-HEAD SOCKET CAP SCREW.SLDPRT
prj/container 1/RCK.201/93725K78 Ultra-Weather-Resistant EPDM Foam Strip.SLDPRT
prj/container 1/RCK.201/93776A461_TYPE 18-8 SS SERRATED-FLANGE LOCKNUT.SLDPRT
prj/container 1/RCK.201/9406T170_PUSH-TO-CONNECT TUBE FITTING FOR SS TUBING.SLDPRT
prj/container 1/RCK.201/94241A230_TYPE 316 STAINLESS STEEL SPLIT LOCK WASHER.SLDPRT
prj/container 1/RCK.201/94639A303_NYLON UNTHREADED SPACERS.SLDPRT
prj/container 1/RCK.201/9602K410_CORROSION-RESISTANT EQUIPMENT-COOLING FAN.SLDPRT
prj/container 1/RCK.201/96439A820_18-8 SS PRESS-IN NUT FOR SHEET MTL.SLDPRT
prj/container 1/RCK.201/BACKFLOW.SLDPRT
prj/container 1/RCK.201/GMR.503.SLDPRT
prj/container 1/RCK.201/GMR.505.SLDPRT
prj/container 1/RCK.201/KNAC36xxADS_Optic.SLDPRT
prj/container 1/RCK.201/LFR.001.SLDDRW
prj/container 1/RCK.201/LFR.001.SLDPRT
prj/container 1/RCK.201/LFR.002.SLDDRW
prj/container 1/RCK.201/LFR.002.SLDPRT
prj/container 1/RCK.201/LFR.008.SLDPRT
prj/container 1/RCK.201/LFR.101.SLDDRW
prj/container 1/RCK.201/LightPCB.SLDPRT
prj/container 1/RCK.201/Mock Container.SLDPRT
prj/container 1/RCK.201/TRUE_NIPPLE.SLDPRT
prj/container 1/RCK.201/aavid_heatsink.SLDPRT
prj/container 1/RCK.201/backflow_inlet.SLDPRT
prj/container 1/RCK.201/cap.SLDPRT
prj/container 1/RCK.201/connector_orange.SLDPRT
prj/container 1/RCK.201/double thread.SLDPRT
prj/container 1/RCK.201/drain.SLDPRT
prj/container 1/RCK.201/drain_gasket.SLDPRT
prj/container 1/RCK.201/drain_nut.SLDPRT
prj/container 1/RCK.201/fan-hooks.SLDPRT
prj/container 1/RCK.201/hrd-050-gasket.SLDPRT
prj/container 1/RCK.201/my90.SLDPRT
prj/container 1/RCK.201/new adapter.SLDPRT
prj/container 1/RCK.201/pump.SLDPRT
prj/container 1/RCK.201/pvc-050-0015.SLDPRT
prj/container 1/RCK.201/pvc-050-002.SLDPRT
prj/container 1/RCK.201/pvc-050-004.SLDPRT
prj/container 1/RCK.201/pvc-050-018.SLDPRT
prj/container 1/RCK.201/short valve.SLDPRT
prj/container 1/RCK.201/side-outlet-elbow.SLDPRT
prj/container 1/RCK.201/threaded_tee.SLDPRT
prj/container 1/RCK.201/threaded_threaded_90.SLDPRT
prj/container 1/RCK.201/through-wall-90.SLDPRT
prj/container 1/RCK.201/through-wall-black.SLDPRT
prj/container 1/RCK.201/true_npt_nut.SLDPRT
prj/container 1/RCK.201/unthreaded 90.SLDPRT
prj/container 3 rack v2/2233K150_STRUT CHANNEL TAB-LOCK NUT.SLDPRT
prj/container 3 rack v2/2615T130_VIBRATION-DAMPING CLAMPING HANGER.SLDPRT
prj/container 3 rack v2/29585T200_BEAM CLAMP FOR PIPE TUBE AND CONDUIT.SLDPRT
prj/container 3 rack v2/3338A22_HORIZONTAL_SURFACE_MOUNT_LEVEL.SLDPRT
prj/container 3 rack v2/5 megapixel USB camera model ELP-USB500W02M-L21.SLDPRT
prj/container 3 rack v2/5-15-18_Cart_Racks.SLDPRT
prj/container 3 rack v2/5346K460_BRASS BARBED HOSE FITTING.SLDPRT
prj/container 3 rack v2/5648K263_CHOOSE-A-COLOR POLYURETHANE TUBING.SLDPRT
prj/container 3 rack v2/6308T12 Wye-Shaped On-Off Valve.SLDPRT
prj/container 3 rack v2/73605T87 3-4 GHT Male x 1-2 NPT Male Adapter.SLDPRT
prj/container 3 rack v2/7429K480_SNAP-IN PLASTIC CLAMP.SLDPRT
prj/container 3 rack v2/76665A68_VHB_TAPE.SLDPRT
prj/container 3 rack v2/90730A006_TYPE 18-8 STAINLESS STEEL NARROW HEX NUT.SLDPRT
prj/container 3 rack v2/91115A819_18-8 SS FEM THRDED HEX STANDOFF.SLDPRT
prj/container 3 rack v2/91770A544_18-8 SS TRUSS HEAD PHILLIPS MACHINE SCREW.SLDPRT
prj/container 3 rack v2/92147A410_TYPE 316 STAINLESS STEEL SPLIT LOCK WASHER.SLDPRT
prj/container 3 rack v2/92386A632_SS THRD-LOCKING ADJUSTING POSITIONING STUD.SLDPRT
prj/container 3 rack v2/92949A077_18-8 SS BUTTON-HEAD SOCKET CAP SCREW.SLDPRT
prj/container 3 rack v2/92949A133_18-8 SS BUTTON-HEAD SOCKET CAP SCREW.SLDPRT
prj/container 3 rack v2/92949A151_18-8 SS BUTTON-HEAD SOCKET CAP SCREW.SLDPRT
prj/container 3 rack v2/93725K78 Ultra-Weather-Resistant EPDM Foam Strip.SLDPRT
prj/container 3 rack v2/93776A461_TYPE 18-8 SS SERRATED-FLANGE LOCKNUT.SLDPRT
prj/container 3 rack v2/9406T170_PUSH-TO-CONNECT TUBE FITTING FOR SS TUBING.SLDPRT
prj/container 3 rack v2/94241A230_TYPE 316 STAINLESS STEEL SPLIT LOCK WASHER.SLDPRT
prj/container 3 rack v2/94639A303_NYLON UNTHREADED SPACERS.SLDPRT
prj/container 3 rack v2/94922A029_NYLON 6-6 CAP NUTS.SLDPRT
prj/container 3 rack v2/94922A034_NYLON 6-6 CAP NUTS.SLDPRT
prj/container 3 rack v2/94924A600_NYLON 6-6 WING NUTS.SLDPRT
prj/container 3 rack v2/9602K410_CORROSION-RESISTANT EQUIPMENT-COOLING FAN.SLDPRT
prj/container 3 rack v2/96439A820_18-8 SS PRESS-IN NUT FOR SHEET MTL.SLDPRT
prj/container 3 rack v2/BACKFLOW.SLDPRT
prj/container 3 rack v2/GMR.503.SLDPRT
prj/container 3 rack v2/GMR.505.SLDPRT
prj/container 3 rack v2/HRD-008-175-BTN-SS.SLDPRT
prj/container 3 rack v2/KNAC36xxADS_Optic.SLDPRT
prj/container 3 rack v2/LFR.001.SLDDRW
prj/container 3 rack v2/LFR.001.SLDPRT
prj/container 3 rack v2/LFR.002.SLDDRW
prj/container 3 rack v2/LFR.002.SLDPRT
prj/container 3 rack v2/LFR.003.SLDDRW
prj/container 3 rack v2/LFR.003.SLDPRT
prj/container 3 rack v2/LFR.004.SLDDRW
prj/container 3 rack v2/LFR.004.SLDPRT
prj/container 3 rack v2/LFR.005.SLDDRW
prj/container 3 rack v2/LFR.005.SLDPRT
prj/container 3 rack v2/LFR.006.SLDDRW
prj/container 3 rack v2/LFR.006.SLDPRT
prj/container 3 rack v2/LFR.007.SLDDRW
prj/container 3 rack v2/LFR.007.SLDPRT
prj/container 3 rack v2/LFR.008.SLDPRT
prj/container 3 rack v2/LFR.101.SLDDRW
prj/container 3 rack v2/LFR.102.SLDDRW
prj/container 3 rack v2/LightPCB.SLDPRT
prj/container 3 rack v2/TRUE_NIPPLE.SLDPRT
prj/container 3 rack v2/aavid_heatsink.SLDPRT
prj/container 3 rack v2/backflow_inlet.SLDPRT
prj/container 3 rack v2/base.SLDPRT
prj/container 3 rack v2/cap.SLDPRT
prj/container 3 rack v2/connector_orange.SLDPRT
prj/container 3 rack v2/container 2 led-fixture/v1.0/10-17-18 Members Week Laser Cuts/Rubber-press.DXF
prj/container 3 rack v2/container 2 led-fixture/v1.0/10-17-18 Members Week Laser Cuts/elect-panel-2.DXF
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
