OpenAgricultureFoundation/openag-mechanical/prj/hazelnut_large/LHC-001/1-Documentation/2019-10-23 Light Unistrut Designs - Updated/2019-10-30 LED Electrical Wiring Routing Details.pptx

LHC-201 LED Electrical Wiring Routing Details
OpenAg, MIT Media Lab

By Eugene Zeleny
Oct 30th, 2019

## Slide 2

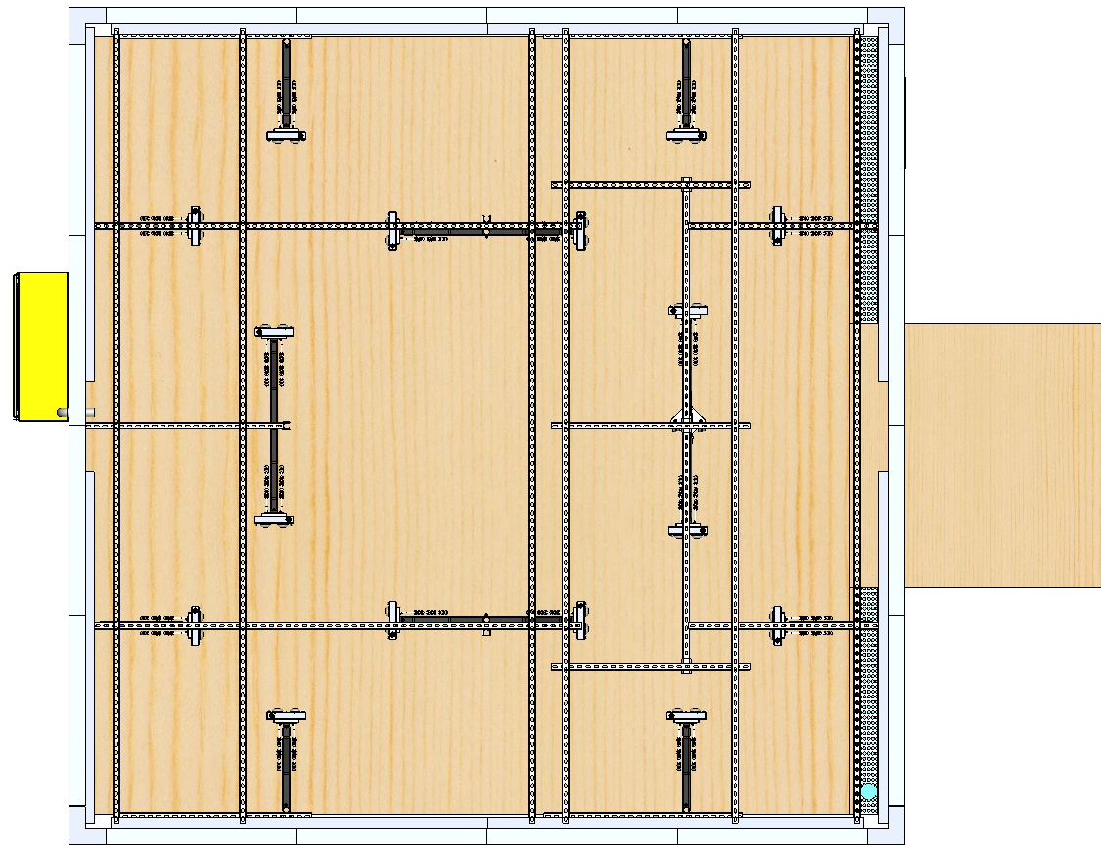
[picture p464: figure]

- All wires to be routed vertically up Strut Channel to the Strut Channel Support Structure, then routed as suggested

LED Drivers
Enclosure

Wire Routing Path
