OpenAgricultureFoundation/openag-mechanical/prj/hazelnut_large/LHC-001/1-Documentation/2019-5-22 LHC-300 LED Enclosure Assembly Instructions/2019-5-20 LHC-300 Assembly Instructions.pdf

## LHC-300 MECHANICAL LIGHT ASSEMBLY INSTRUCTIONS

OpenAg, MIT Media Lab

By Eugene Zeleny
May 20th, 2019

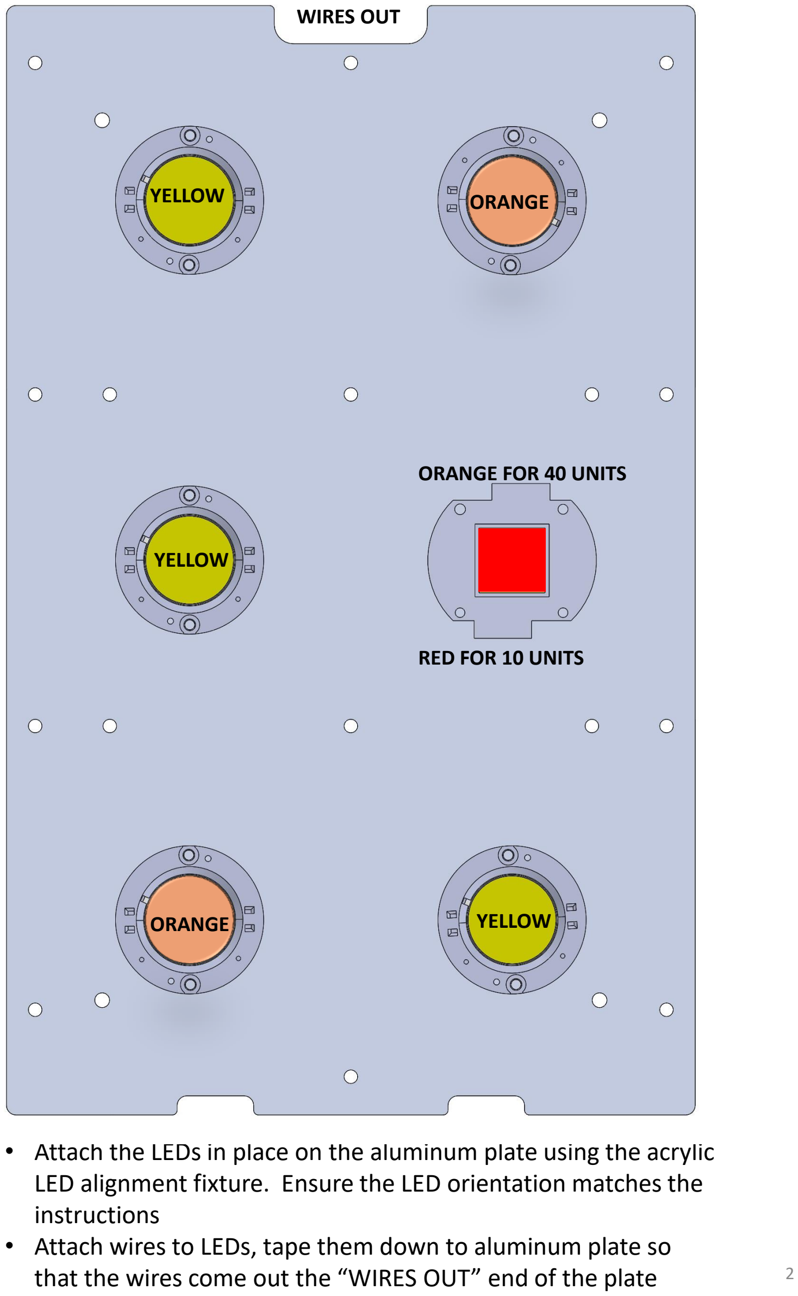
[picture p471: page 2]

- Attach the LEDs in place on the aluminum plate using the acrylic LED alignment fixture. Ensure the LED orientation matches the instructions
- Attach wires to LEDs, tape them down to aluminum plate so that the wires come out the “WIRES OUT” end of the plate

YELLOW

YELLOW

YELLOW

ORANGE FOR 40 UNITS

RED FOR 10 UNITS

WIRES OUT

ORANGE

ORANGE

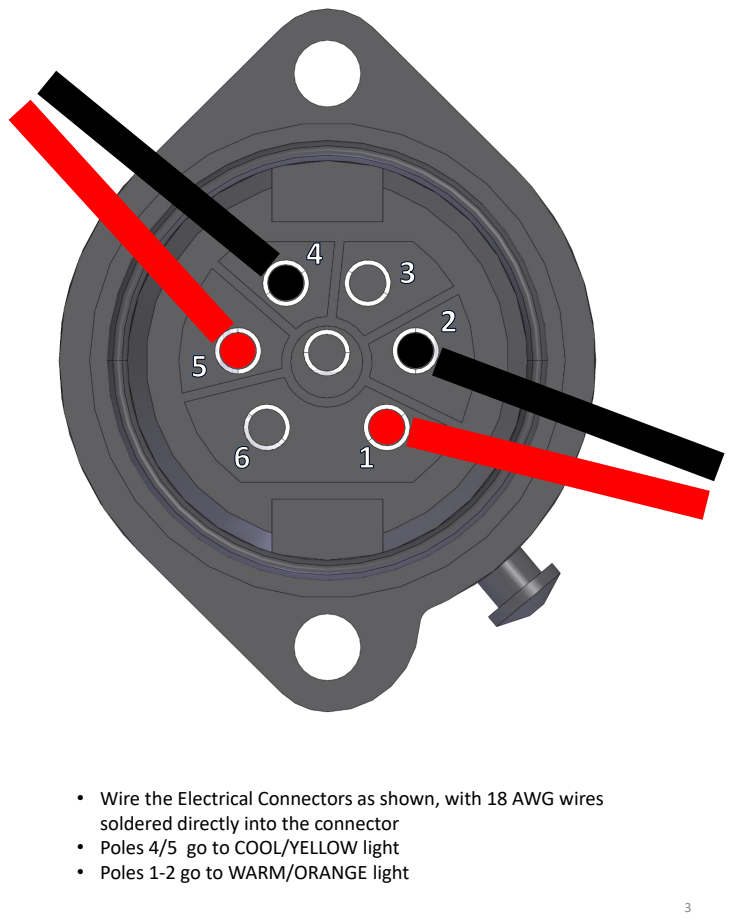
[picture p472: page 3]

• Wire the Electrical Connectors as shown, with 18 AWG wires
soldered directly into the connector
• Poles 4/5 go to COOL/YELLOW light
• Poles 1-2 go to WARM/ORANGE light

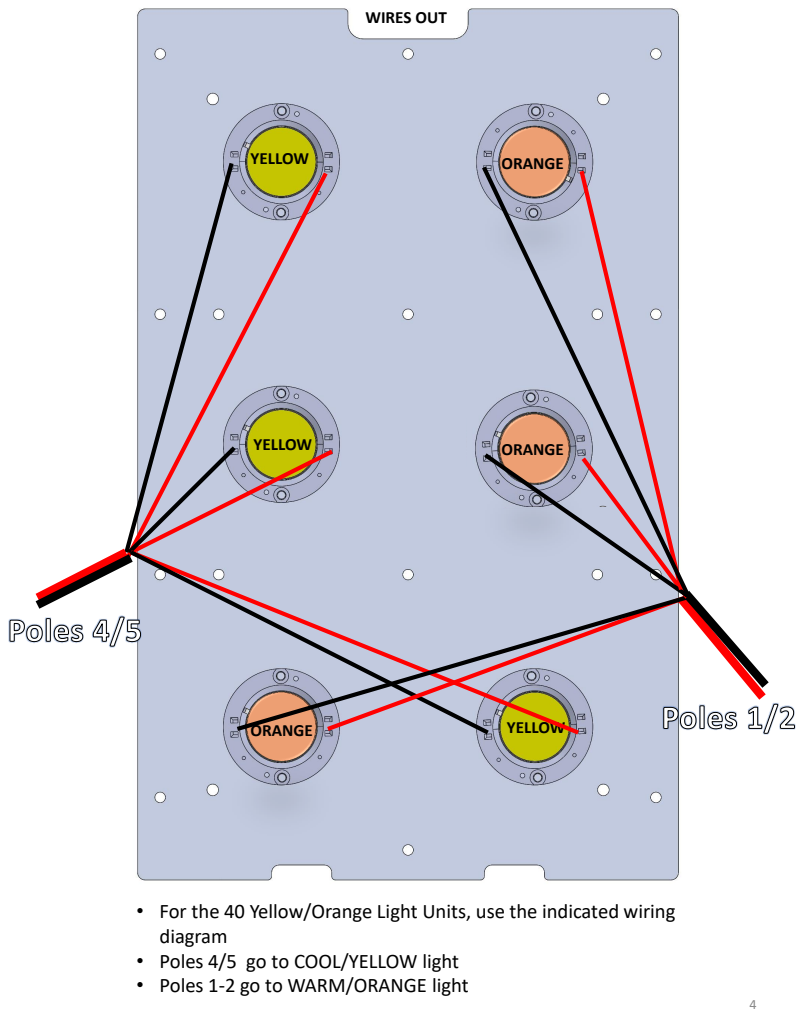
[picture p473: page 4]
YELLOW; WIRES OUT; ORANGE

• For the 40 Yellow/Orange Light Units, use the indicated wiring
diagram
• Poles 4/5 go to COOL/YELLOW light
• Poles 1-2 go to WARM/ORANGE light

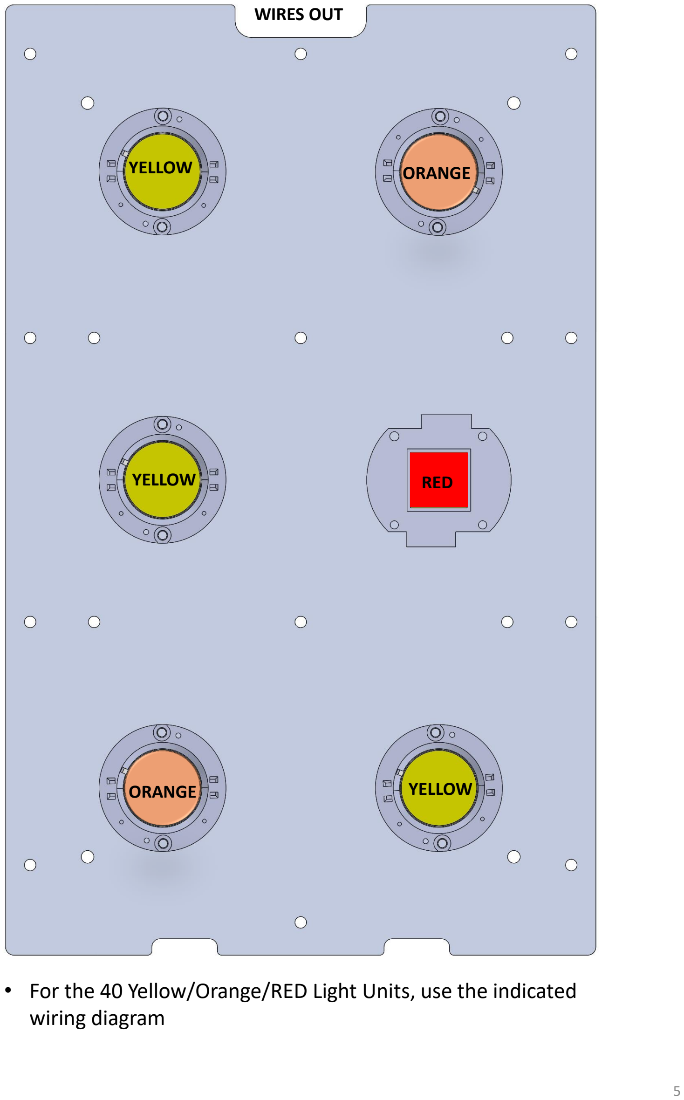
[picture p474: page 5]

- For the 40 Yellow/Orange/RED Light Units, use the indicated wiring diagram

YELLOW

YELLOW

YELLOW

WIRES OUT

ORANGE

ORANGE

RED

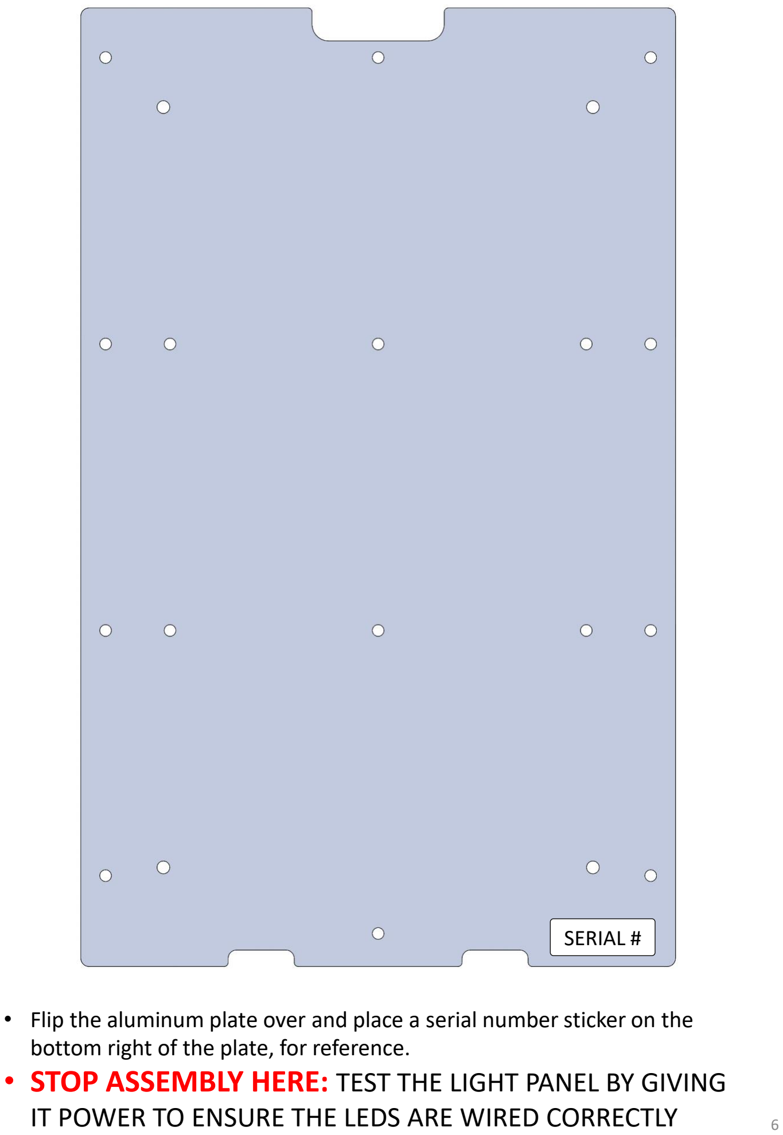
[picture p475: page 6]

- Flip the aluminum plate over and place a serial number sticker on the bottom right of the plate, for reference.

### - STOP ASSEMBLY HERE: TEST THE LIGHT PANEL BY GIVING IT POWER TO ENSURE THE LEDS ARE WIRED CORRECTLY

SERIAL #

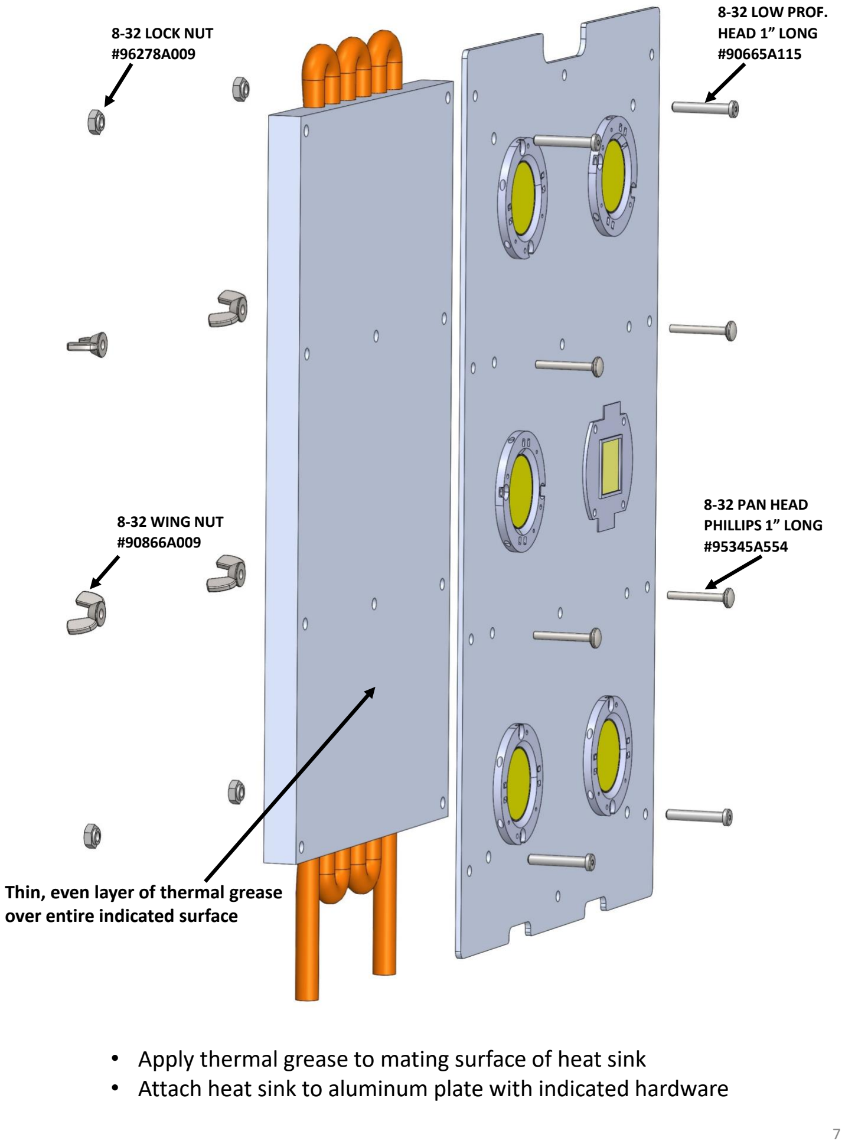
[picture p476: page 7]

8-32 PAN HEAD
PHILLIPS 1” LONG
#95345A554

8-32 LOW PROF.
HEAD 1” LONG
#90665A115

8-32 WING NUT
#90866A009

8-32 LOCK NUT
#96278A009

- Apply thermal grease to mating surface of heat sink
- Attach heat sink to aluminum plate with indicated hardware

Thin, even layer of thermal grease over entire indicated surface

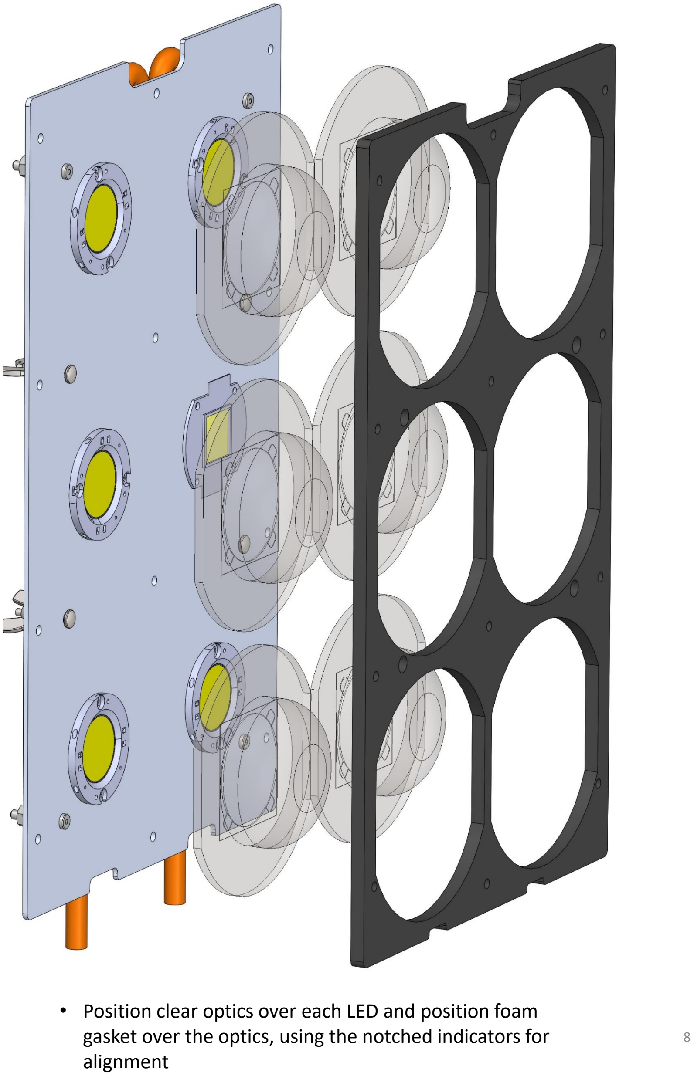
[picture p477: page 8]

- Position clear optics over each LED and position foam gasket over the optics, using the notched indicators for alignment

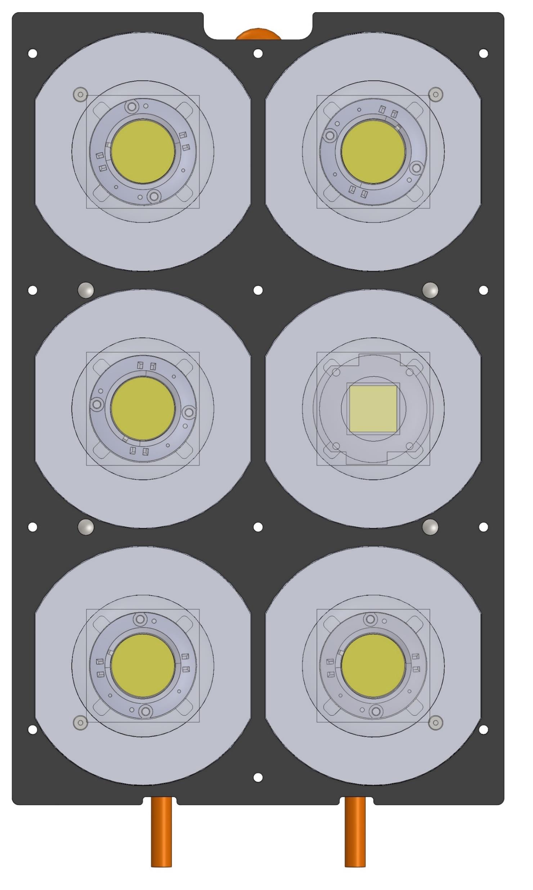
[picture p478: figure]

- This is what the assembly should look like at this point

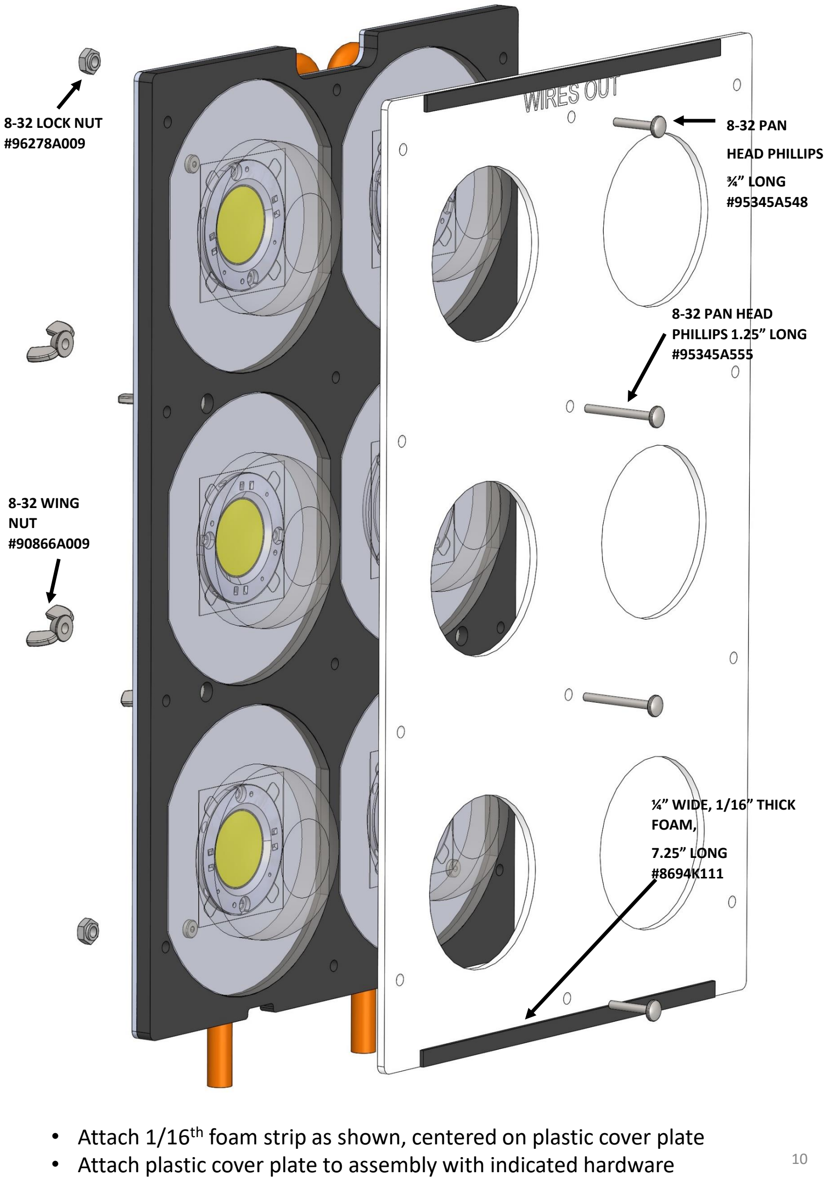
[picture p479: page 10]

- Attach 1/16th foam strip as shown, centered on plastic cover plate
- Attach plastic cover plate to assembly with indicated hardware

8-32 PAN HEAD
PHILLIPS 1.25” LONG
#95345A555

8-32 PAN

HEAD PHILLIPS

¾” LONG
#95345A548

8-32 WING
NUT
#90866A009

¼” WIDE, 1/16” THICK
FOAM,

7.25” LONG
#8694K111

8-32 LOCK NUT
#96278A009

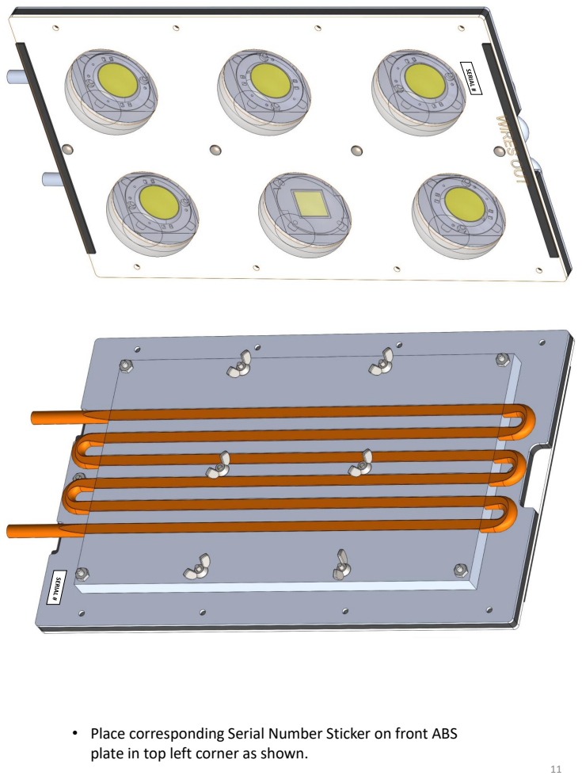
[picture p480: page 11]

• Place corresponding Serial Number Sticker on front ABS
plate in top left corner as shown.

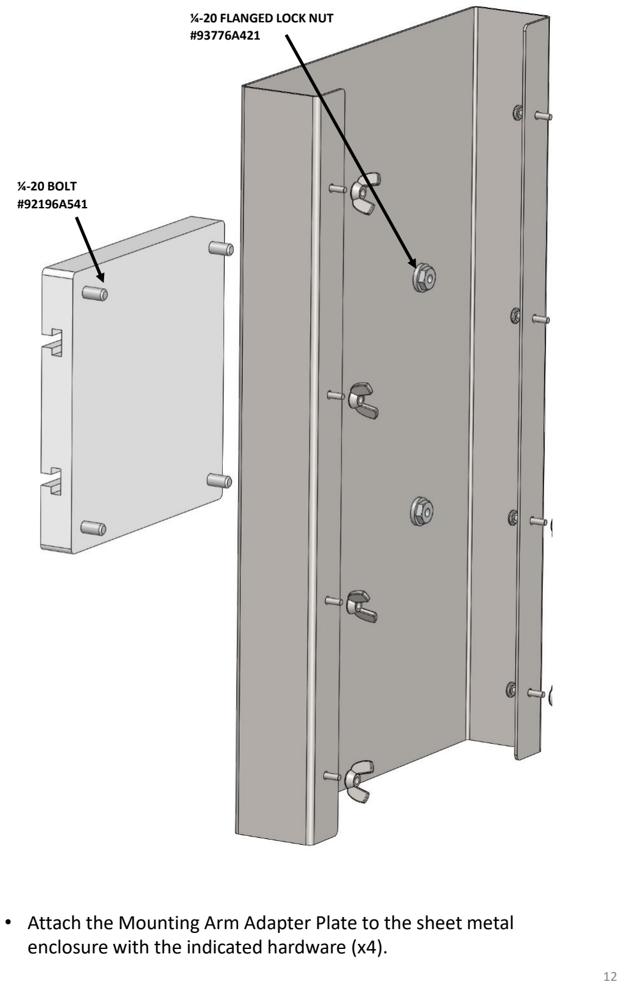
[picture p481: page 12]

- Attach the Mounting Arm Adapter Plate to the sheet metal enclosure with the indicated hardware (x4).

¼-20 FLANGED LOCK NUT
#93776A421

¼-20 BOLT
#92196A541

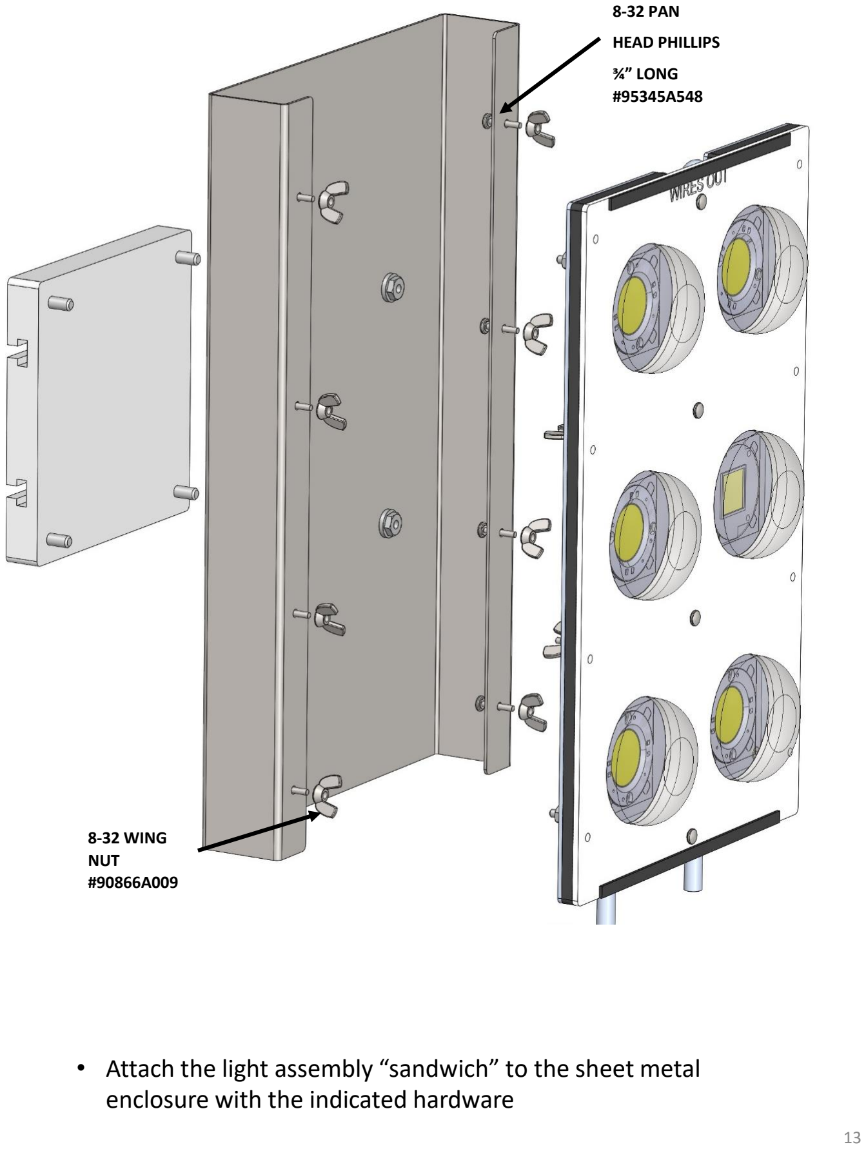
[picture p482: page 13]

- Attach the light assembly “sandwich” to the sheet metal enclosure with the indicated hardware

8-32 WING
NUT
#90866A009

8-32 PAN

HEAD PHILLIPS

¾” LONG
#95345A548

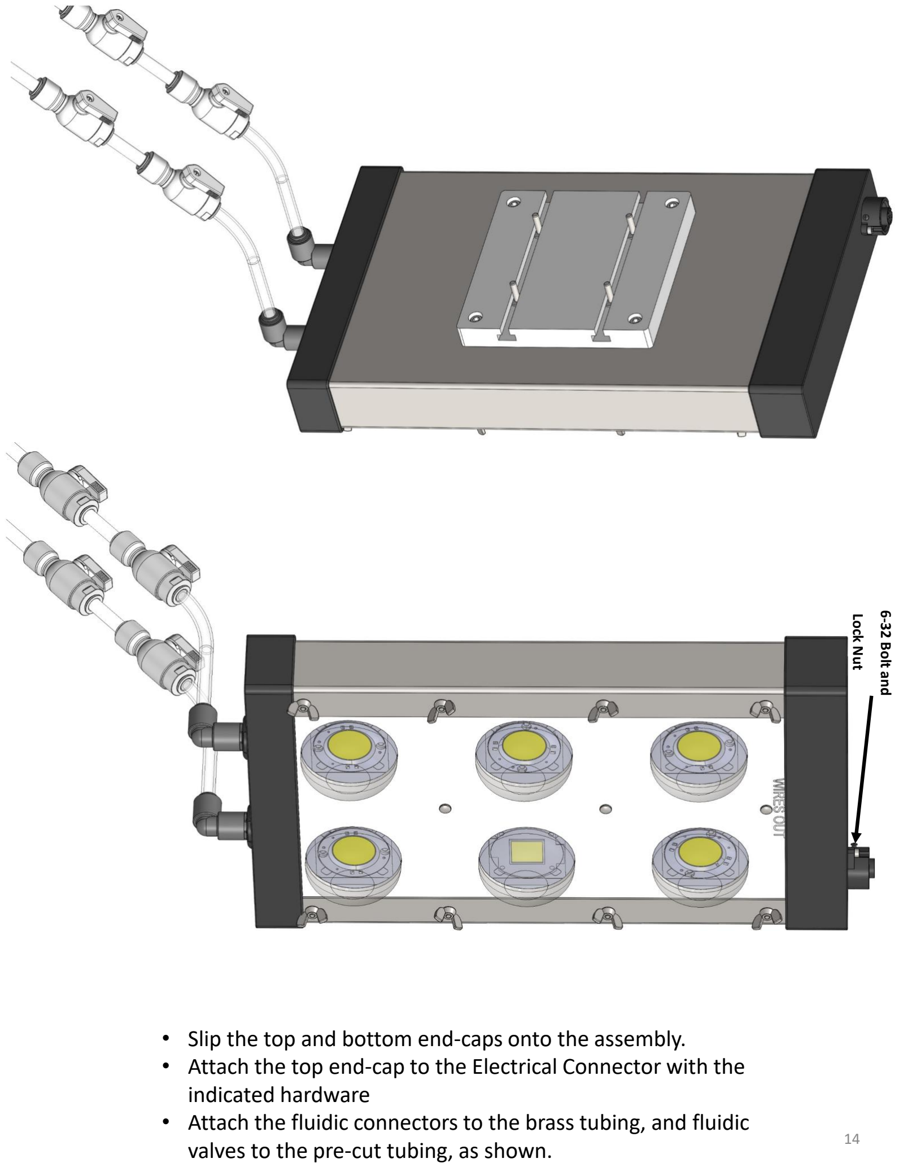
[picture p483: page 14]

- Slip the top and bottom end-caps onto the assembly.
- Attach the top end-cap to the Electrical Connector with the
indicated hardware
- Attach the fluidic connectors to the brass tubing, and fluidic
valves to the pre-cut tubing, as shown. | 14

6-32 Bolt and
Lock Nut
