OpenAgricultureFoundation/openag-mechanical/prj/hazelnut_large/LHC-001/1-Documentation/2019-5-22 LHC-300 LED Enclosure Assembly Instructions/LHC-300 Sign-out Sheet.pdf

LHC-300 SERIAL NUMBER | RED LED Y/N? | LED WIRING VERIFIED W/ DRIVER | LED BOARD AND HEATSINK DEGREASED | ASSEMBLED WITH ABS AND FOAM

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
ASSEMBLED INTO
ENCLOSURE
