OpenAgricultureFoundation/openag-mechanical/prj/hazelnut_large/LHC-001/1-Documentation/2019-5-22 LHC-300 LED Enclosure Assembly Instructions/LHC-300 Sign-out Sheet.xlsx

LHC-300 SERIAL NUMBER | RED LED Y/N? | LED WIRING VERIFIED W/ DRIVER | LED BOARD AND HEATSINK DEGREASED | ASSEMBLED WITH ABS AND FOAM | LED WIRING VERIFIED AGAIN | ASSEMBLED INTO ENCLOSURE | CAPS ATTACHED | COMMENTS
001
002
003
004
005
006
007
008
009
010
011
012
013
014
015
016
017
018
019
020
021
022
023
024
025
026
027
028
029
030
LHC-300 SERIAL NUMBER | RED LED Y/N? | LED WIRING VERIFIED W/ DRIVER | LED BOARD AND HEATSINK DEGREASED | ASSEMBLED WITH ABS AND FOAM | LED WIRING VERIFIED AGAIN | ASSEMBLED INTO ENCLOSURE | CAPS ATTACHED | COMMENTS
031
032
033
034
035
036
037
038
039
040
041
042
043
044
045
046
047
048
049
050
051
052
053
054
055
056
057
058
059
060
