OpenAgricultureFoundation/openag-mechanical/prj/germinator v3/BRAIN BOARD SOLDERING DIAGRAM.docx

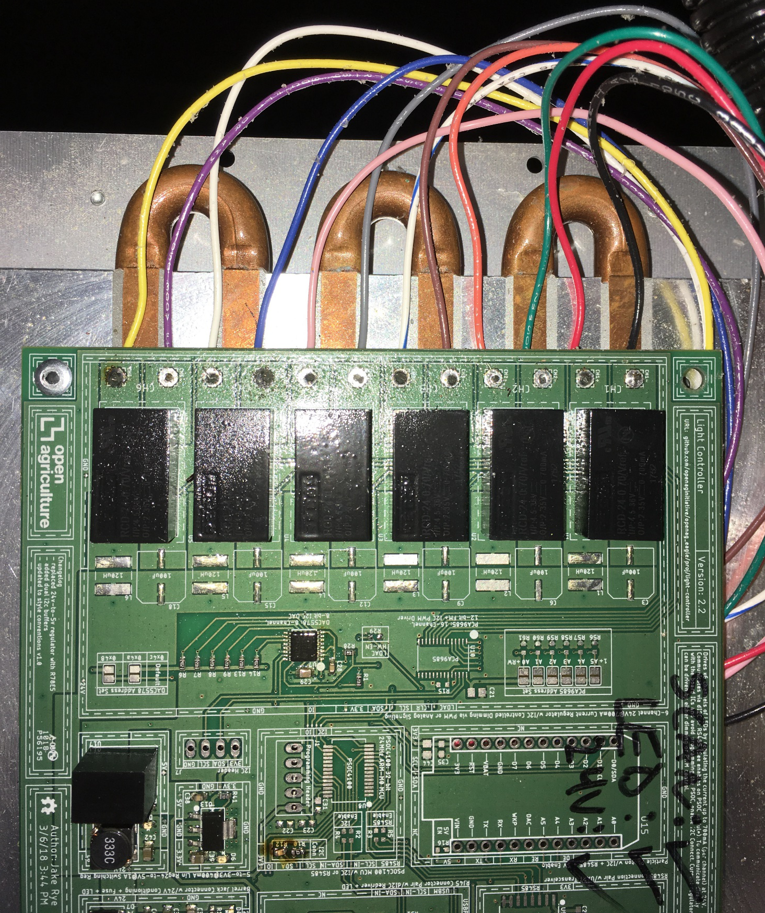
[picture p484: figure]
