OpenAgricultureFoundation/openag-mechanical/prj/hazelnut_large/LHC-001/5-Photopia/Photopia Certificate and Installation Guide.docx

Photopia Annual Maintenance Certificate

Contract Holder

MIT Media Lab

77 Mass. Ave., E14/15

Cambridge, MA 02139

Terms

Start 01/09/2019

End 01/09/2020

For the period of the contract the customer is entitled to the Parametric Optical Design Tools, unlimited support via telephone or e-mail, automatic receipt of maintenance releases or fixes, as well as all product updates and upgrades. Lamp and material library updates will also be made available to contract holders. Product and library updates are only available via the Annual Maintenance Package.

Photopia v2019 Download

Download the file at the following link to a temporary folder and unzip it. Ensure that Photopia is not currently running and then run the Photopia.exe file to start the installation. If you are sharing Photopia from a server, then run this installation on the server computer and ensure that no clients are running Photopia.

http://www.ltioptics.com/PhotopiaAll9408yj

Licensing

If this is a new installation, then you will need an Authorization Key to start using Photopia. If this is an existing installation, then you'll need a new Authorization Key in order to renew access to the PODT module.

To license an individual workstation, for the stand alone version of Photopia, start Photopia and choose License / Authorization and then click the button to "Send a License Request."

To license the SolidWorks version, Start SOLIDWORKS and choose Tools / Photopia / Licensing under the main menu. Then click the button to "Request an authorization key.

To license aserver, start the License Server application on the server computer and this will open the license status web page. Once this page is open, click the "Relicense server" link and then click the "Request License" button. You can also open the license status web page from any client workstation running Photopia by clicking the "Server Status" link in its Authorization screen.

Let us know if you have any questions. Thank you.

Product Support Contact Information

Phone : (720) 891-0030

Email : photopia@ltioptics.com
