OpenAgricultureFoundation/openag-mechanical/prj/hazelnut_large/LHC-001/1-Documentation/2019-8-21 LHC-301 LED Light Assembly Serial Number Labels/LHC-301 Serial Number Labels.pdf

Serial Number :

# LHC-301- ____

Serial Number :

# LHC-301- ____

Serial Number :

# LHC-301- ____

Serial Number :

# LHC-301- ____

Serial Number :

# LHC-301- ____

Serial Number :

# LHC-301- ____

Serial Number :

# LHC-301- ____

Serial Number :

# LHC-301- ____

Serial Number :

# LHC-301- ____

Serial Number :

# LHC-301- ____

Serial Number :

# LHC-301- ____

Serial Number :

# LHC-301- ____

Serial Number :

# LHC-301- ____

Serial Number :

# LHC-301- ____

Serial Number :

# LHC-301- ____

Serial Number :

# LHC-301- ____

Serial Number :

# LHC-301- ____

Serial Number :

# LHC-301- ____

Serial Number :

# LHC-301- ____

Serial Number :

# LHC-301- ____

Serial Number :

# LHC-301- ____

Serial Number :

# LHC-301- ____

Serial Number :

# LHC-301- ____

Serial Number :

# LHC-301- ____

Serial Number :

# LHC-301- ____

Serial Number :

# LHC-301- ____

Serial Number :

# LHC-301- ____

Serial Number :

# LHC-301- ____

Serial Number :

# LHC-301- ____

Serial Number :

# LHC-301- ____
