OpenAgricultureFoundation/openag-mechanical/prj/hazelnut_large/LHC-001/1-Documentation/2019-5-22 LHC-300 Failure Mode Testing/LHC-300 Light Assembly Temperature Testing.xlsx

Sheet: Two LED panels in series
Ambient | block 1 in | water in | block 2 in | block 1 out | block 2 out | water middle | water out
 |  |  |  |  |  |  |  | the chiller pump can be 70gpm @38psi
20.44 | 26.06 | 26.06 | 26.06 | 26.31 | 26 | 25.75 | 25.62
20.44 | 26.06 | 26.06 | 26.06 | 26.31 | 26 | 25.75 | 25.62
20.44 | 26.06 | 26.06 | 26.06 | 26.31 | 26 | 25.75 | 25.69
20.5 | 26.06 | 26.06 | 26.06 | 26.31 | 26 | 25.75 | 25.69
20.5 | 26.06 | 26.06 | 26.06 | 26.31 | 26 | 25.75 | 25.69
20.5 | 26.06 | 26.06 | 26.06 | 26.31 | 26 | 25.75 | 25.69
20.5 | 26.06 | 26.06 | 26 | 26.31 | 26 | 25.75 | 25.69
20.5 | 26.06 | 26.06 | 26 | 26.31 | 26 | 25.75 | 25.69
20.75 | 26.06 | 26.06 | 26 | 26.31 | 26 | 25.75 | 25.69
24.56 | 26.06 | 26.06 | 26 | 26.31 | 26 | 25.75 | 25.62
23.31 | 26.06 | 26.06 | 26.06 | 26.31 | 26 | 25.75 | 25.69
22.62 | 26.06 | 26.06 | 26 | 26.31 | 26 | 25.75 | 25.69
22.31 | 26.06 | 26.06 | 26 | 26.31 | 26 | 25.75 | 25.69
22.19 | 26.06 | 26.06 | 26.06 | 26.31 | 26 | 25.75 | 25.62
22.12 | 26.06 | 26.06 | 26 | 26.31 | 26 | 25.75 | 25.69
22.12 | 26.06 | 26.06 | 26 | 26.31 | 26 | 25.75 | 25.69
22.06 | 26.06 | 26.06 | 26.06 | 26.31 | 26 | 25.75 | 25.69
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
