OpenAgricultureFoundation/openag-mechanical/prj/hazelnut_large/LHC-001/1-Documentation/2019-5-22 LHC-300 LED Enclosure Assembly Instructions/2019-5-6 LHC Light Instructions 1.jpg

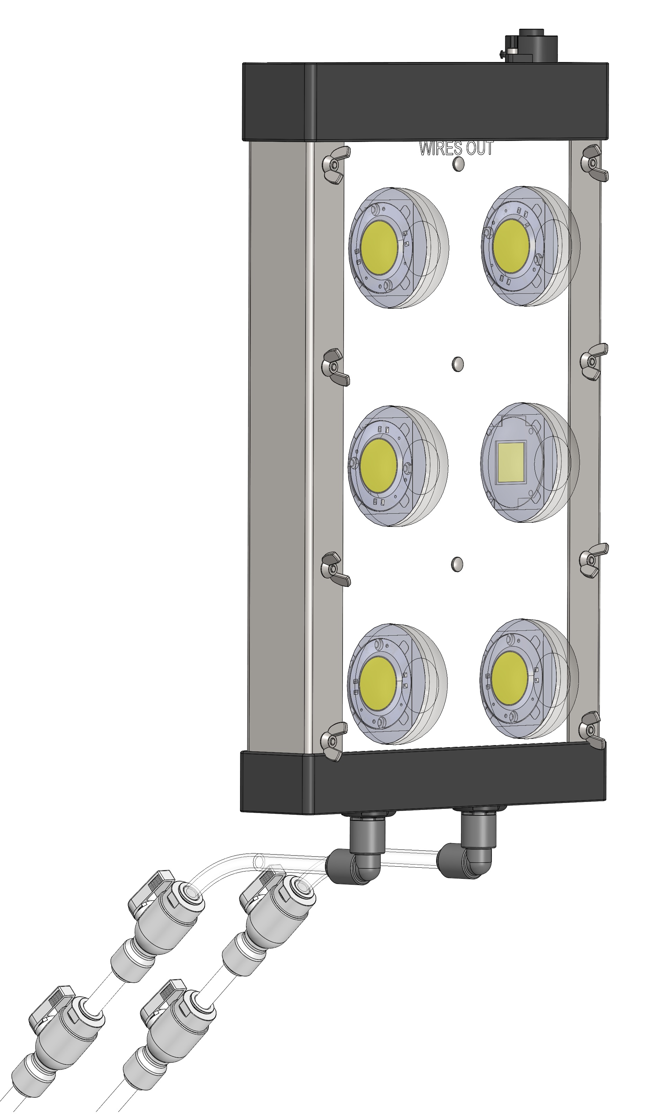
prj/hazelnut_large/LHC-001/1-Documentation/2019-5-22 LHC-300 LED Enclosure Assembly Instructions/2019-5-6 LHC Light Instructions 1.jpg
