OpenAgricultureFoundation/openag-mechanical/prj/hazelnut_large/LHC-001/1-Documentation/2019-10-8 LED Enclosure Cable Wiring Diagrams/IMG_3558.JPG

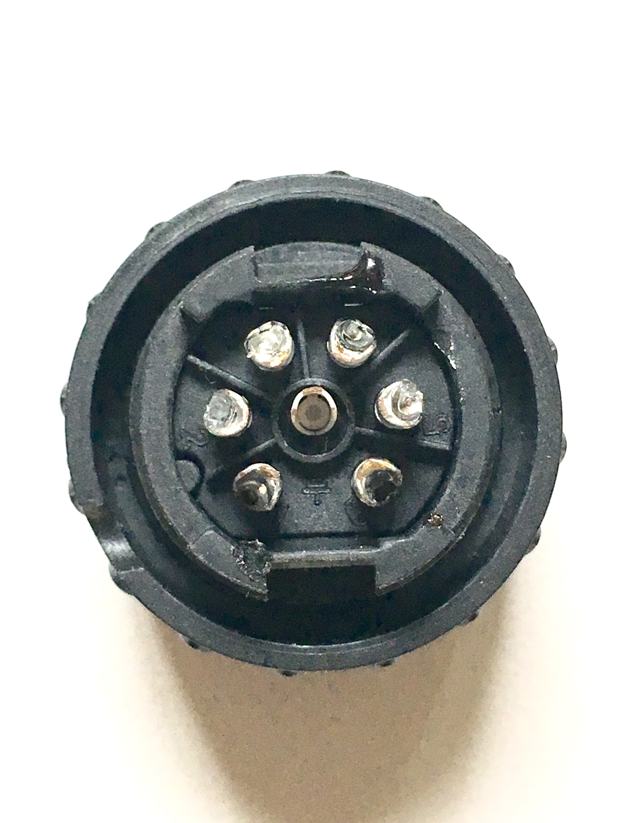
prj/hazelnut_large/LHC-001/1-Documentation/2019-10-8 LED Enclosure Cable Wiring Diagrams/IMG_3558.JPG
