OpenAgricultureFoundation/openag-mechanical/prj/hazelnut_large/LHC-001/6-Photometric Test Data/2019-03-21_tests.xlsx

Sheet: test01
Target Wall, Warehouse |  |  |  |  |  |  | MAX | 66.22
4'x6' Illiumination Plane |  |  |  |  |  |  | MIN | 0.64
Single far red unit only, 1825 optic |  |  |  |  |  |  | AVG | 23.84
Data are PPFD 701-780nm
Unit tested at 19.8V 1.5A
0.80 | 1.82 | 5.96 | 12.96 | 23.86 | 28.69 | 23.03 | 12.96 | 5.37 | 1.65 | 0.87
0.97 | 4.15 | 14.91 | 35.18 | 42.17 | 43.48 | 48.17 | 35.97 | 15.00 | 4.22 | 0.98
1.39 | 7.72 | 29.82 | 45.02 | 54.45 | 63.00 | 63.81 | 55.87 | 24.14 | 6.89 | 1.28
1.66 | 8.52 | 28.18 | 47.20 | 57.24 | 64.36 | 65.17 | 54.48 | 30.85 | 7.88 | 1.42
1.35 | 8.07 | 26.63 | 41.99 | 56.95 | 66.22 | 64.81 | 55.15 | 25.73 | 6.38 | 1.23
0.81 | 3.61 | 17.80 | 34.29 | 50.80 | 56.52 | 51.81 | 36.68 | 13.52 | 4.10 | 1.07
0.64 | 1.62 | 4.86 | 13.40 | 27.14 | 32.65 | 27.82 | 10.98 | 4.91 | 1.52 | 0.85
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
