OpenAgricultureFoundation/openag-mechanical/prj/hazelnut_large/LHC-001/6-Photometric Test Data/Single COB Tests.xlsx

Sheet: data_1x lens
File name | LED unit | lens unit | x coordinate | y coordinate | z coordinate | x distance, inch | y distance, inch | z distance, inch | Date | Time | Driver | Natural Light @ Target | PPFD, original | PPFD, zero adjusted | Current | Voltage | Watts | Driver Adjusted | PPFD, power adjusted | LUX |  |  |  |  |  |  |  |  |  |  |  |  | PAR
Round 1 | 30E10K0D7 | 1845 | 0 | 0 |  | 0 | 0 | 6 | 2018-12-04 | 11:00:00 | ERP | 146 | 77569 | 77423 | 3.9 | 36.6 | 142.74 | 1 | 77423 | 60 | 92 | 146 | 270 | 402 | 459 | 402 | 270 | 146 | 92 | 60 | LED unit: | 30E10K0D7 | 0.9 | 1.3 | 2.1 | 3.9 | 5.8 | 6.6 | 5.8 | 3.9 | 2.1 | 1.3 | 0.9 | LED unit: | 30E10K0D7
Round 1 | 30E10K0D7 | 1845 | -1 | 0 |  | -6 | 0 | 6 | 2018-12-04 | 11:00:00 | ERP | 147 | 70260 | 70113 | 3.9 | 36.6 | 142.74 | 1 | 70113 | 64 | 108 | 181 | 386 | 2845 | 4482 | 2845 | 386 | 181 | 108 | 64 | lens unit: | 1845 | 0.9 | 1.6 | 2.6 | 5.6 | 41.0 | 64.5 | 41.0 | 5.6 | 2.6 | 1.6 | 0.9 | lens unit: | 1845
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
