OpenAgricultureFoundation/openag-mechanical/prj/fermentabot/FMT201/Data Collection/Fermentabot Testing Data 2-21-19.xlsx

Sheet: 2-HR BURN-IN, ONE HUMIDIFIER
 | NOTE: INTERIOR OF FERMENTABOT INCLUDES TRAYS AND CONDENSATION GUARDS
 | NOTE: TEMPERATURE PROBE LOCATED ABOVE TOP TRAY
Bottom Tray |  |  | Middle Tray |  |  | Top Tray
Time | Temperature | Humidity | Time | Temperature | Humidity | Time | Temperature | Humidity
12:28:00 | 22.3698 | 58.1365 | 12:28:00 | 22.4376 | 48.4167 | 12:29:00 | 21.7263 | 64.4231
12:29:00 | 22.1767 | 64.3773 | 12:29:00 | 22.3625 | 53.5131 | 12:30:00 | 21.8657 | 68.3523
12:30:00 | 22.2304 | 68.4591 | 12:30:00 | 22.4054 | 57.0608 | 12:31:00 | 22.1553 | 70.9844
12:31:00 | 22.4341 | 71.5566 | 12:31:00 | 22.5556 | 59.9981 | 12:32:00 | 22.5307 | 72.6858
12:32:00 | 22.7559 | 72.7315 | 12:32:00 | 22.7594 | 61.8902 | 12:33:00 | 22.9704 | 73.586
12:33:00 | 23.142 | 73.113 | 12:33:00 | 23.0275 | 63.3245 | 12:34:00 | 23.4745 | 73.6776
12:34:00 | 23.5388 | 72.7544 | 12:34:00 | 23.3492 | 64.2019 | 12:35:00 | 24.0214 | 73.1283
12:35:00 | 24 | 72.3195 | 12:35:00 | 23.6924 | 64.591 | 12:36:00 | 24.5577 | 72.5942
12:36:00 | 24.4612 | 71.076 | 12:36:00 | 24.0678 | 64.6291 | 12:37:00 | 25.0725 | 70.664
12:37:00 | 24.9545 | 68.6803 | 12:37:00 | 24.4754 | 63.9425 | 12:38:00 | 25.7053 | 69.3059
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
