OpenAgricultureFoundation/openag-mechanical/prj/hazelnut_large/LHC-001/6-Photometric Test Data/Large Hazelnut Light Test Data.xlsx

Sheet: 1845_optic_2x COB
Target Wall, Warehouse |  |  |  | MAX | 309.62
4'x6' Illiumination Plane |  |  |  | MIN | 48.15
2x COB, Khatod 1845 square optic |  |  |  | AVG | 177.40
54.699 | 108.61 | 202.32 | 218.93 | 241.84 | 242.65 | 258.29 | 257.3 | 182.69 | 123.41 | 48.543
73.367 | 121.85 | 199.86 | 259.92 | 258.77 | 280.47 | 289.64 | 280 | 227.82 | 120.47 | 70.07
76.053 | 111.26 | 228.95 | 232.21 | 278.71 | 299.55 | 282.93 | 285.37 | 270.74 | 117.39 | 66.877
66.102 | 105.26 | 208.69 | 222.59 | 272.74 | 309.62 | 278.55 | 276.47 | 248.97 | 114.03 | 63.05
55.258 | 107.66 | 201 | 219.33 | 247.18 | 269.02 | 250.59 | 257.12 | 241.49 | 106.16 | 61.679
50.135 | 85.575 | 161.78 | 198.23 | 211.26 | 226.43 | 224.77 | 222.58 | 184.61 | 102.98 | 74.471
48.152 | 60.099 | 155.07 | 149.23 | 160.84 | 150.37 | 157.16 | 174.19 | 161.36 | 93.153 | 53.425
Target Wall, Simulation |  |  |  | MAX | 323.73
4'x6' Illiumination Plane |  |  |  | MIN | 56.13
2x COB, Khatod 1845 round optic |  |  |  | AVG | 197.24
56.27 | 102.64 | 171.70 | 218.67 | 219.99 | 211.73 | 209.94 | 198.03 | 169.41 | 112.81 | 69.05
61.92 | 122.30 | 211.39 | 272.45 | 283.65 | 275.76 | 276.87 | 266.87 | 218.91 | 142.51 | 75.08
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
