OpenAgricultureFoundation/openag-mechanical/prj/pfc-edu/Corrugated Plastic PFC/Corrugated Documentation/Corrugated PFC Benchmark Data 1-11-19.xlsx

Sheet: 1-11-18 24HR data
 |  | 4x4x4 Hinged Doors |  |  | 6x6x6 Hinged Doors |  |  | 6x6x6 Foam/Removable Doors
 |  | Time | Temperature | Humidity | Time | Temperature | Humidity | Time | Temperature | Humidity
2019-01-10 18:00 | 2019-01-10 | 18:00:00 | 22.4234 | 37.2777 |  | 21.2544 | 49.7671 |  | 20.6323 | 51.7888
2019-01-10 18:10 | 2019-01-10 | 18:10:00 | 23.2171 | 38.178 |  | 21.3831 | 46.9594 |  | 20.9004 | 59.9218
2019-01-10 18:20 | 2019-01-10 | 18:20:00 | 23.8391 | 39.2614 |  | 21.5868 | 46.6848 |  | 21.3294 | 59.3496
2019-01-10 18:30 | 2019-01-10 | 18:30:00 | 24.2467 | 38.735 |  | 21.737 | 42.3208 |  | 21.619 | 60.4024
2019-01-10 18:40 | 2019-01-10 | 18:40:00 | 24.5684 | 39.6123 |  | 21.9301 | 47.2951 |  | 21.9301 | 63.4771
2019-01-10 18:50 | 2019-01-10 | 18:50:00 | 24.858 | 38.7502 |  | 22.1017 | 44.5791 |  | 22.1553 | 59.5632
2019-01-10 19:00 | 2019-01-10 | 19:00:00 | 24.9438 | 39.681 |  | 22.1553 | 42.3894 |  | 22.1446 | 57.4422
2019-01-10 19:10 | 2019-01-10 | 19:10:00 | 24.9867 | 38.651 |  | 22.1338 | 42.3894 |  | 22.1231 | 54.1006
2019-01-10 19:20 | 2019-01-10 | 19:20:00 | 24.976 | 38.1551 |  | 22.1017 | 42.1682 |  | 22.1875 | 53.1393
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
