OpenAgricultureFoundation/openag-mechanical/prj/container 3 rack v2/container 2 led-fixture/v1.0/2018-9-7 Burn In Test/Middle - Heat Sink.PNG

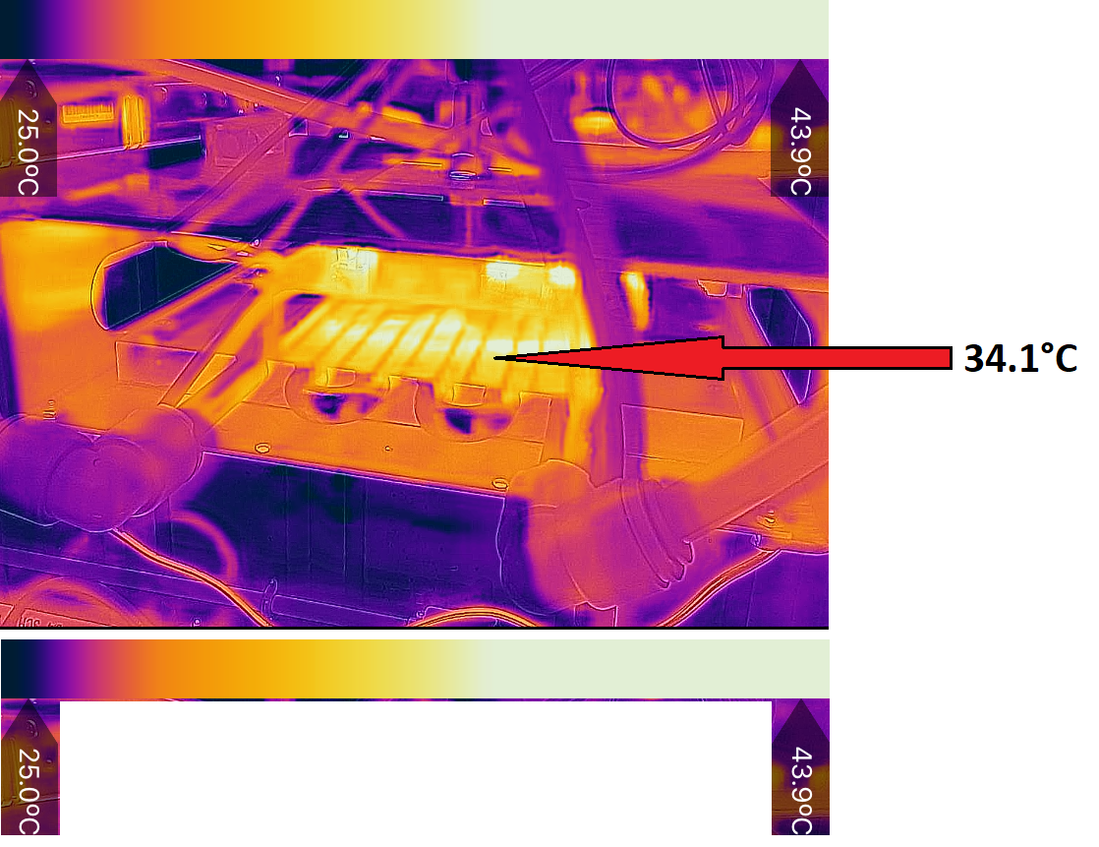
prj/container 3 rack v2/container 2 led-fixture/v1.0/2018-9-7 Burn In Test/Middle - Heat Sink.PNG
