OpenAgricultureFoundation/openag-mechanical/prj/germinator v3/8-14-18 Thermal Grease Testing Documentation/1 - TECHSPRAY HEAT SINK COMPOUND.PNG

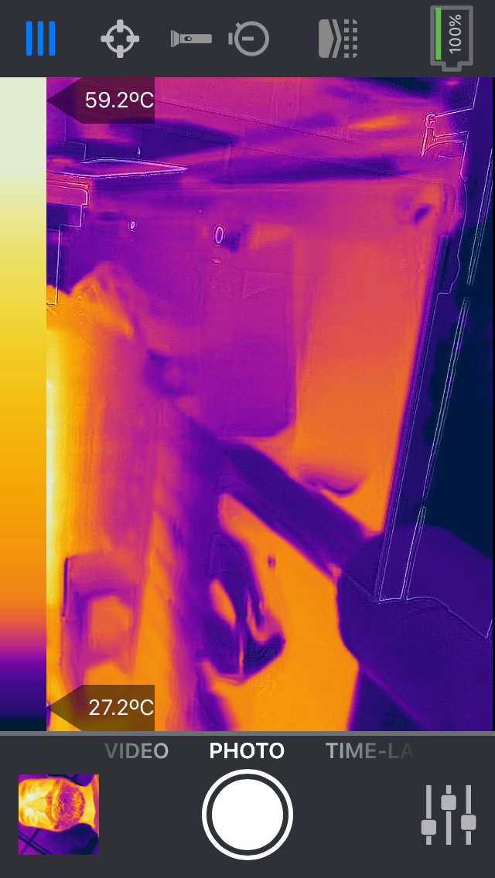
prj/germinator v3/8-14-18 Thermal Grease Testing Documentation/1 - TECHSPRAY HEAT SINK COMPOUND.PNG
