OpenAgricultureFoundation/openag-mechanical/prj/germinator v3/8-14-18 Thermal Grease Testing Documentation/2 - HALNZIYE HY700 THERMAL GREASE.PNG

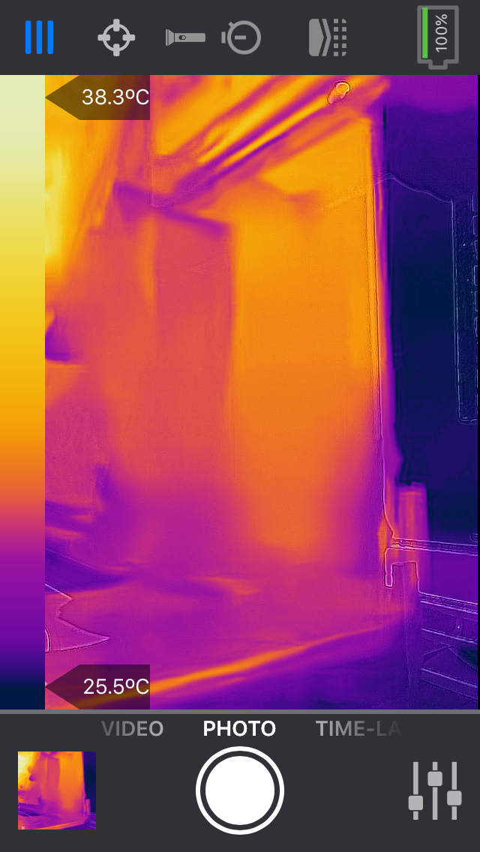
prj/germinator v3/8-14-18 Thermal Grease Testing Documentation/2 - HALNZIYE HY700 THERMAL GREASE.PNG
