OpenAgricultureFoundation/openag-mechanical/prj/germinator v3/8-14-18 Thermal Grease Testing Documentation/3 - ARCTIC MX-4 THERMAL COMPOUND - ANALYSIS.PNG

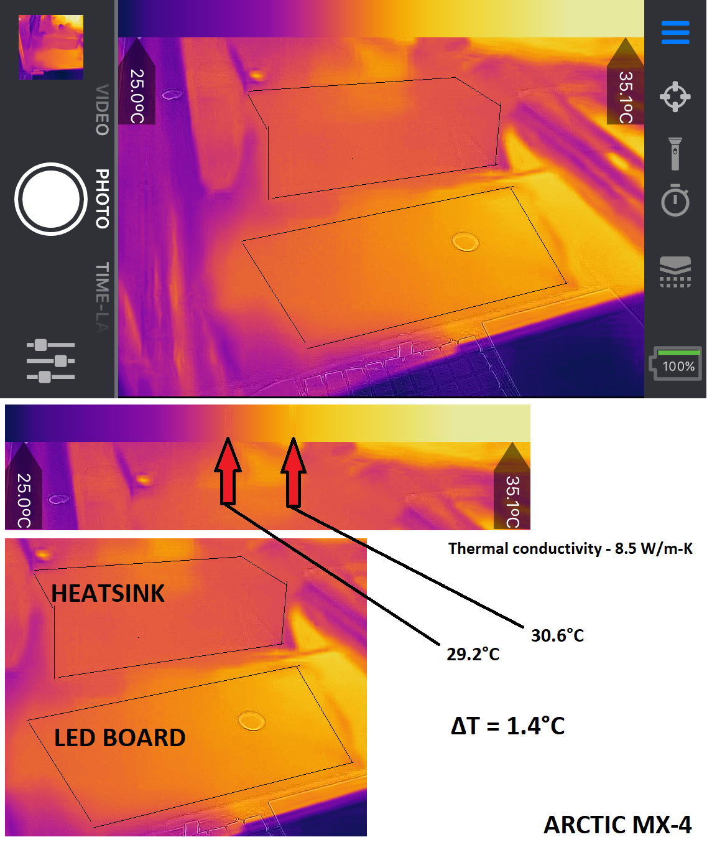
prj/germinator v3/8-14-18 Thermal Grease Testing Documentation/3 - ARCTIC MX-4 THERMAL COMPOUND - ANALYSIS.PNG
