OpenAgricultureFoundation/openag-mechanical/prj/germinator v3/8-14-18 Thermal Grease Testing Documentation/4 - CONTROL - NO THERMAL GREASE - ANALYSIS.PNG

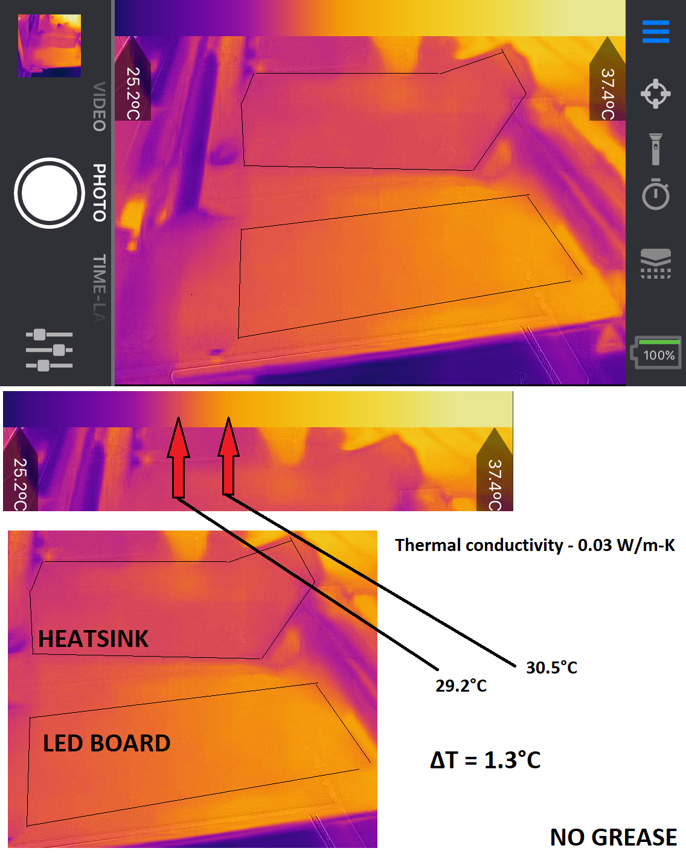
prj/germinator v3/8-14-18 Thermal Grease Testing Documentation/4 - CONTROL - NO THERMAL GREASE - ANALYSIS.PNG
