OpenAgricultureFoundation/openag-mechanical/prj/germinator v3/8-14-18 Thermal Grease Testing Documentation/IMG_9114.JPG

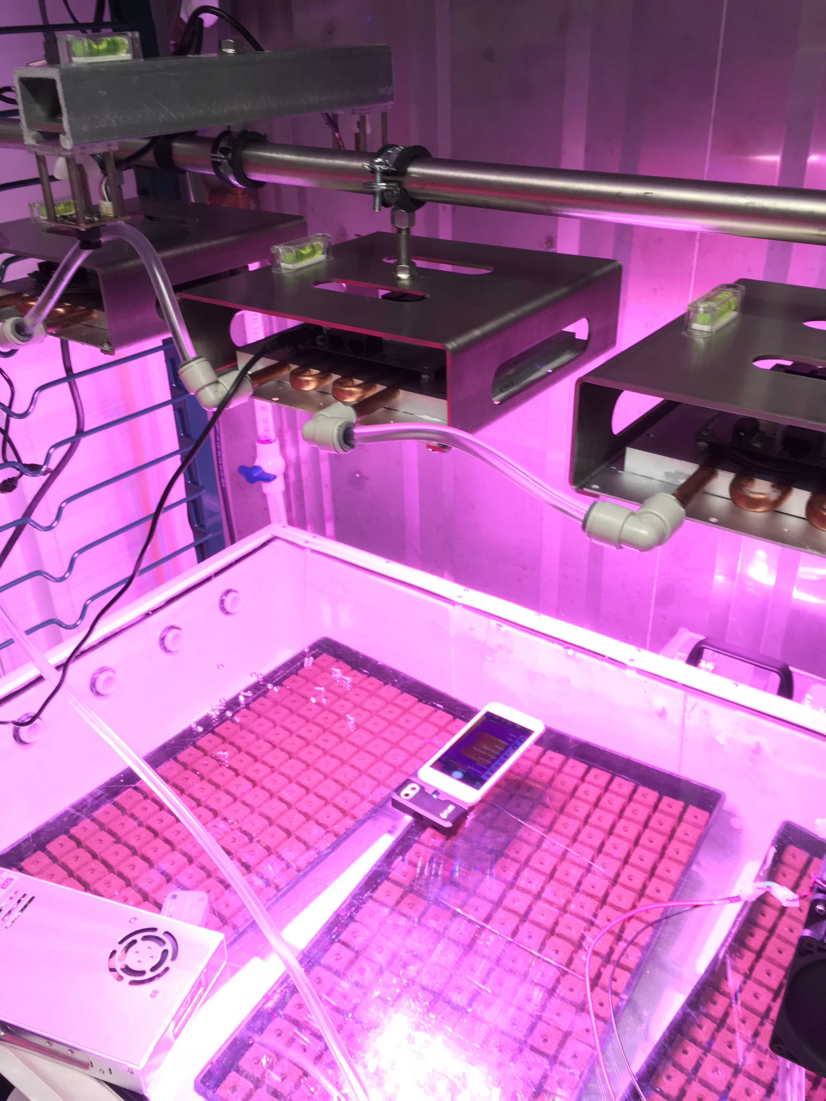
prj/germinator v3/8-14-18 Thermal Grease Testing Documentation/IMG_9114.JPG
