OpenAgricultureFoundation/openag-mechanical/prj/hazelnut_large/LHC-001/3-Specification Sheets/119-0184-TB most recent.pdf

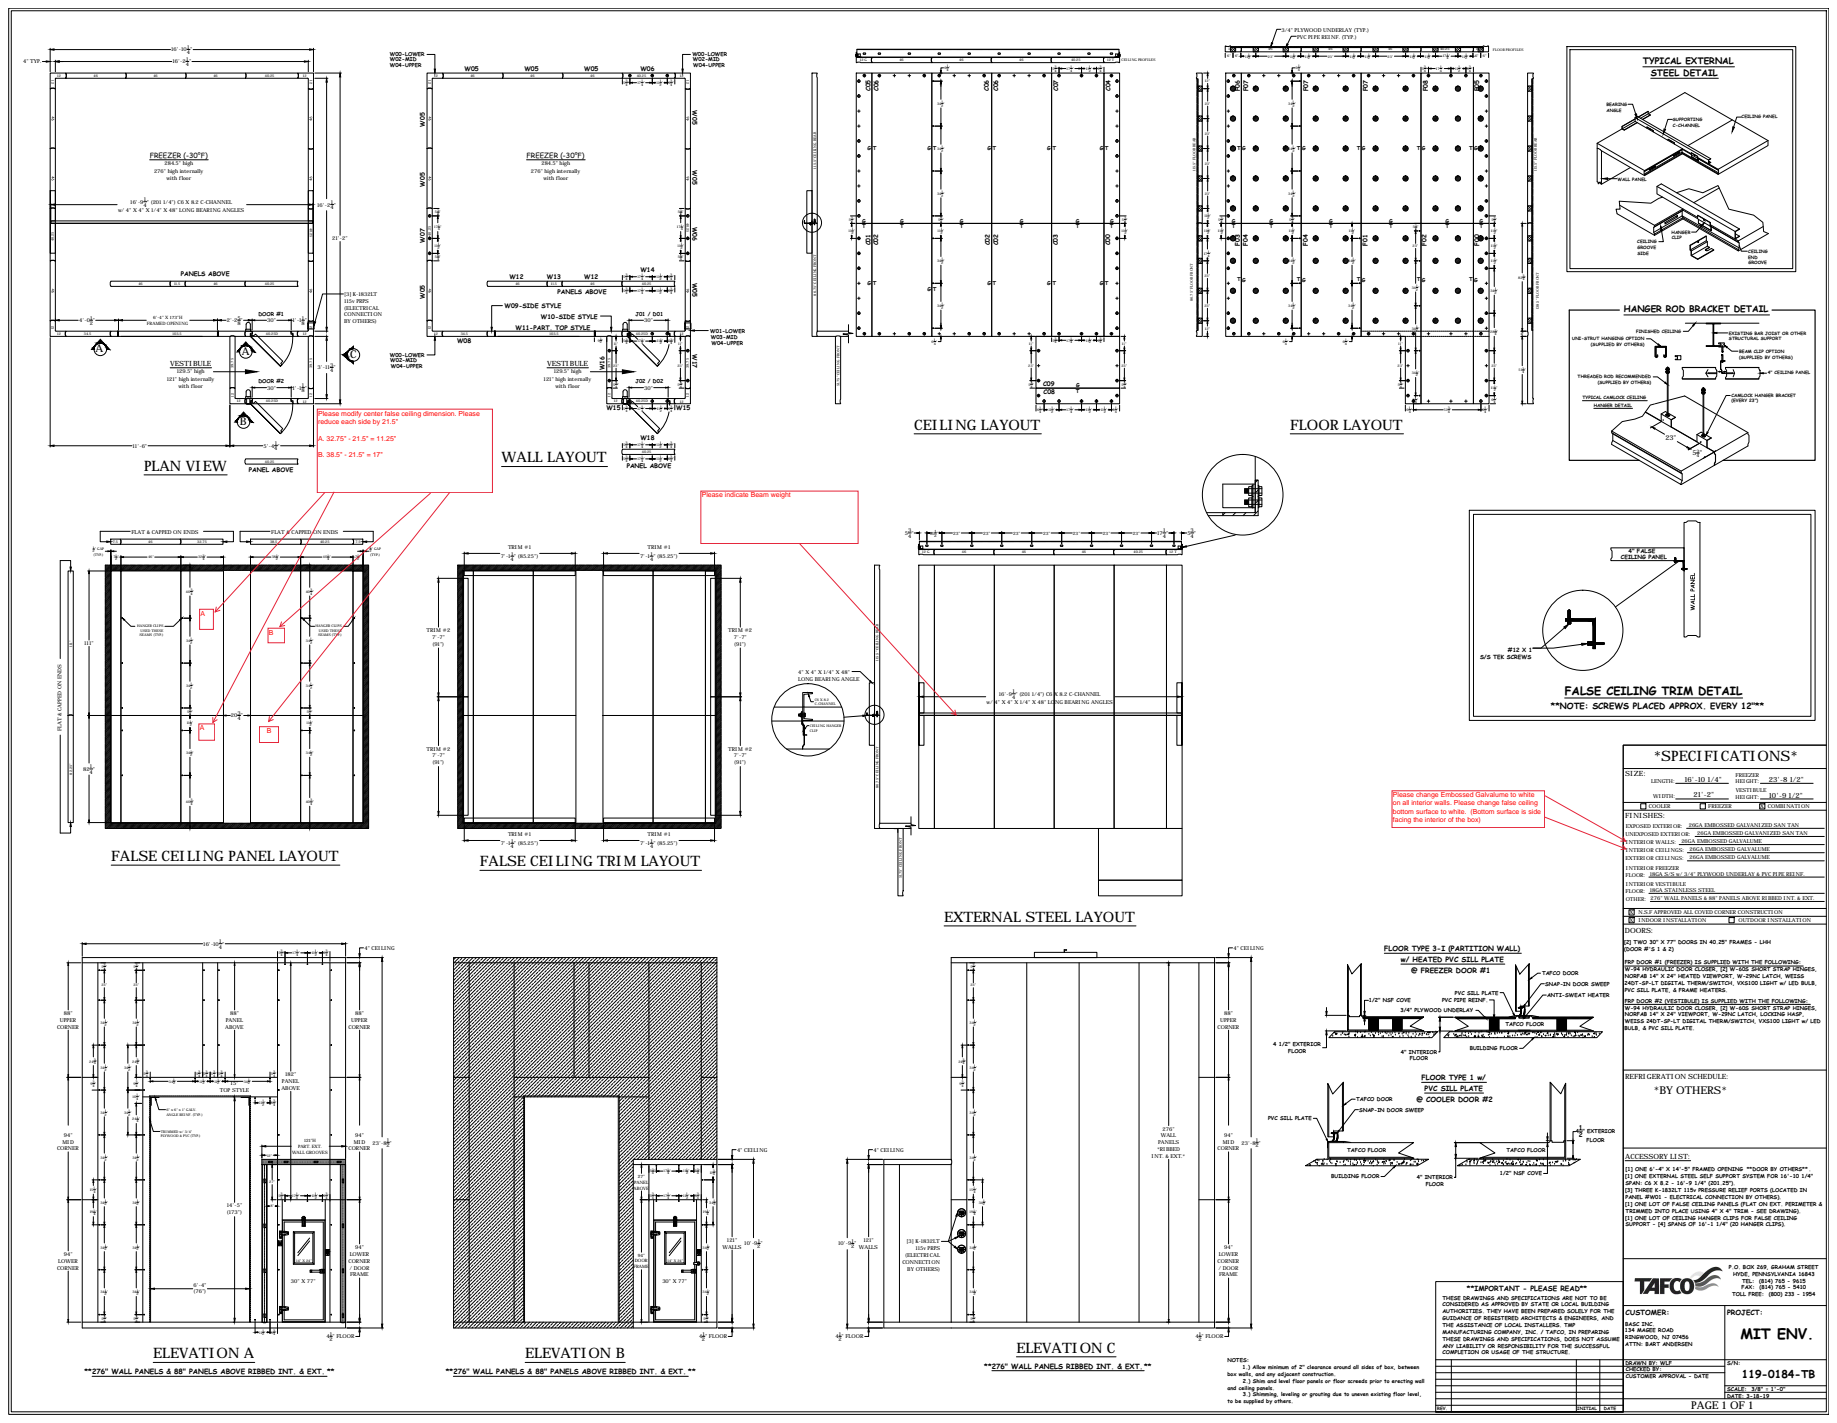
[picture p544: page 1]

138.5" FLOOR FRONT 46 1112" 23" 1112"PVC PIPE REINF. (TYP.)

39.75 30" 40.25D DOOR #2 16'-914" (201 1/4") C6 X 8.2 C-CHANNEL w/ 4" X 4" X 1/4" X 48" LONG BEARING ANGLES 1'-118" 1'-118" 2'-258" VESTIBULE 129.5" high 121" high internally with floor )5((=(5) 284.5" high 276" high internally with floor 16'-214" 16'-1014" 21'-2" 16'-214" 3'-1134" 5'-414 11'-6" " BA [3] K-1832LT 115v PRPS (ELECTRICAL CONNECTION BY OTHERS) C 6'-4" (76") 14'-5" (173") A 6" x 6" x 1" GALV. ANGLE REINF. (TYP.) TRIMMED w/ 3/4" PLYWOOD & PVC (TYP.) 30" X 77" 14" X 24" 1914" 934" 3412" 1514" 3412" 3412" 534" 3412" 3412" 3412" 2434" 3412" 23" 534" 934" 3412" 3412" 3412" 534" 3412" 3412" 3412"2434" 3412" 23" 534" 2414" 1014" 94" LOWER CORNER 94" MID CORNER 88" UPPER CORNER 94" LOWER CORNER / DOOR FRAME 94" MID CORNER 88" UPPER CORNER 182" PANEL ABOVE 15" TOP STYLE 88" PANEL ABOVE 1112" 534" 534" 534" 3412" 534 5 " 34" 1112" 534" 3412" 534" 1112" 23'-812" 4" CEILING 412" FLOOR 1112" 534" 121"H PART. EXT. WALL GROOVES 16'-1014" 534" 1714" 1112" 46 11.5 46 40.25 PANELS ABOVE 30" X 77" 14" X 24" 12

82.25" 111" FLAT & CAPPED ON ENDS 38.5 40.25 7.5 FLAT & CAPPED ON ENDS HANGER CLIPS USED THESE SEAMS (TYP.) HANGER CLIPS USED THESE SEAMS (TYP.) TRIM #1 7'-114" (85.25") TRIM #2 7'-7" (91") TRIM #2 7'-7" (91") TRIM #2 7'-7" (91") FLOOR PROFILES FLOOR LAYOUT G

W05 W08 W11-PART. TOP STYLE W00-LOWER W00-LOWER W01-LOWER W02-MID W02-MID W02-MID W03-MID W04-UPPER W04-UPPER W04-UPPER W04-UPPER 27" 12"8" W05 W05

86.75" CEILING FRONT 115.5" CEILING REAR 12 G 46 46 46 40.25 12 T G

115.5" FLOOR REAR 5134" 4" 8234" 23" 534" HANGER ROD BRACKET DETAIL FINISHED CEILING UNI-STRUT HANGING OPTION (SUPPLIED BY OTHERS) THREADED ROD RECOMMENDED (SUPPLIED BY OTHERS) TYPICAL CAMLOCK CEILING HANGER DETAIL CAMLOCK HANGER BRACKET (EVERY 23") 4" CEILING PANEL BEAM CLIP OPTION (SUPPLIED BY OTHERS) EXISTING BAR JOIST OR OTHER STRUCTURAL SUPPORT TYPICAL EXTERNAL STEEL DETAIL CEILING PANEL WALL PANEL SUPPORTING C-CHANNEL BEARING ANGLE CEILING GROOVE SIDE HANGER CLIP CEILING END GROOVE FLOOR TYPE 3-I (PARTITION WALL)

W06 1714 5 " 34" 1112" 534" 534" 1714" 1112" 534" 534" W07 912" W09-SIDE STYLE W10-SIDE STYLE 534" 1714" 1112" 534 W12 W13 W12 " W14 1112 17 " 14" 534" 23" 11" 534" 23" 11" W15 W15

39.75 30" 40.25D J02 / D02 46 11.5 46 40.25 PANELS ABOVE 10'-912" 4" CEILING 121" WALLS 412" FLOOR 1914"3412" 3412" 3412" 534" ELEVATION A ELEVATION B 1134" 94" DOOR FRAME 27" PANEL ABOVE 10'-912" 4" CEILING 121" WALLS 412" FLOOR 94" LOWER CORNER / DOOR FRAME 23'-812" 4" CEILING 412" FLOOR94" MID CORNER 88" UPPER CORNER 276" WALL PANELS *RIBBED INT. & EXT.* ELEVATION C EXTERNAL STEEL LAYOUT 16'-914" (201 1/4") C6 X 8.2 C-CHANNEL w/ 4" X 4" X 1/4" X 48" LONG BEARING ANGLES 12 G 46 46 46 40.25 12 T 1112 5 " 23" 23" 23" 23" 23" 23" 23" 34" 1714" 534" CEILING LAYOUT

51.75" CEILING FRONT C6 X 8.2 C-CHANNEL CEILING HANGER CLIP 4" X 4" X 1/4" X 48" LONG BEARING ANGLE 23" 534" 11" 23" 534" 11" 614" 614"

86.75" CEILING FRONT 115.5" CEILING REAR

box walls, and any adjacent construction.
2.) Shim and level floor panels or floor screeds prior to erecting wall
and ceiling panels.
3.) Shimming, leveling or grouting due to uneven existing floor level,
to be supplied by others.
