OpenAgricultureFoundation/openag-mechanical/prj/hazelnut_large/LHC-001/3-Specification Sheets/12_ATR_10.pdf

## Steel Threaded Rod

## Hardware

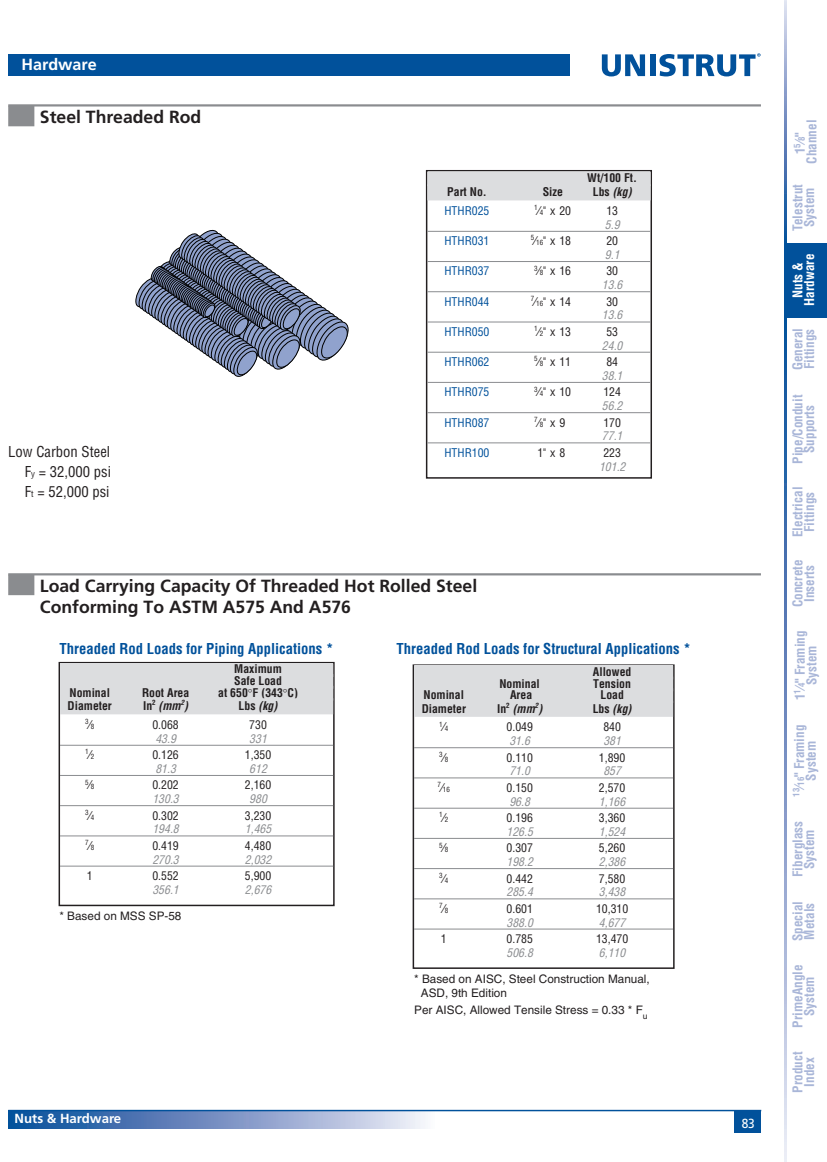
[picture p545: page 1]
Nuts & Hardware; Channel; Nuts &; Hardware; General; Part No.; Size; Lbs (kg); HTHR025; HTHR031; HTHR037; HTHR044; HTHR050; HTHR062; HTHR075; HTHR087; HTHR100; Maximum Safe Load; Nominal; Root Area; Diameter; In² (mm²; Allowed; Tension; Area; Load; Threaded Rod Loads for Piping Applications *; Threaded Rod Loads for Structural Applications *

⁄4" Framing System 13⁄16" Framing System Fiberglass System Special Metals Telestrut System PrimeAngle System Product Index

Fittings Pipe/Conduit Supports Electrical Fittings Concrete Inserts 11

Low Carbon Steel
Fy = 32,000 psi
Ft = 52,000 psi

Load Carrying Capacity Of Threaded Hot Rolled Steel
Conforming To ASTM A575 And A576

* Based on MSS SP-58

* Based on AISC, Steel Construction Manual,
ASD, 9th Edition
Per AISC, Allowed Tensile Stress = 0.33 * Fu
