OpenAgricultureFoundation/openag-mechanical/prj/fs-waterbot/v1.0/part_drawings/solenoid_assembly.pdf

# - 3/4" NPT - Noryl Body - 2-Way Piloted Diaphragm - Normally Closed

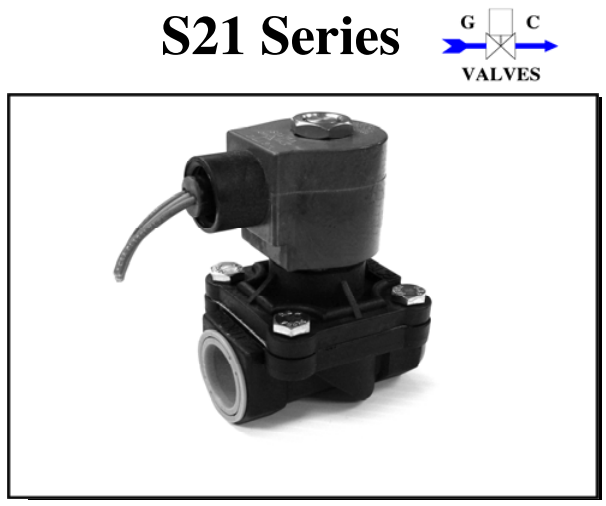
[picture p546: figure]
S21 Series

Materials | Seals: | Nitrile, FKM, Ethylene Propylene
Orifice: | Pilot | Stainless Steel
Main | Noryl 3/4" Diameter
Electrical | Standard Housing: | Encapsulated Waterproof Conduit (NEMA 4X)
Optional Housings: | Metal Conduit, Explosion-Proof (NEMA 7), Grommet
Open Frame, Junction Box (single or dual knockouts), DIN, Contact GC Valves Customer Svc. For others.
Standard Voltages: | 24, 120, 240, AC, 60 and/or 50 Hz. Available
6, 12, 24 DC
Contact GC Valves Customer Svc. For Additional Voltages
Voltage Tolerance: | + 10% of applicable volltage
Coil Classes: | F, H, N
Standard Lead Length: | 24 inches
Operating Temperature Ambient (Nominal): | 32o F to 125o F
Mounting | Position: | Any
Approvals* | Agency: | UL Recognized, CSA Approved, CE Certified
* Not available for all variations

Weight (oz.)
14.4

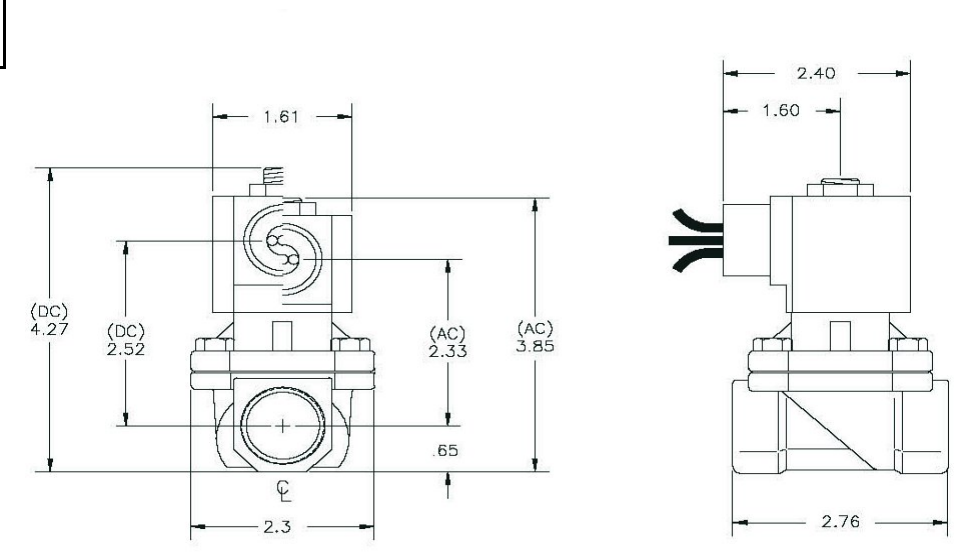
[picture p547: figure]

3/4-P-211-1

# Dimensions / Weight

GC Valves Customer Service: 800-828-0484 (7:30 AM to 4:00 PM ET) or 800-582-4232 (7:30 AM to 4:00 PM PT)

# S211 – 3/4" NPT, Noryl Body, Normally Closed

### Normally Closed

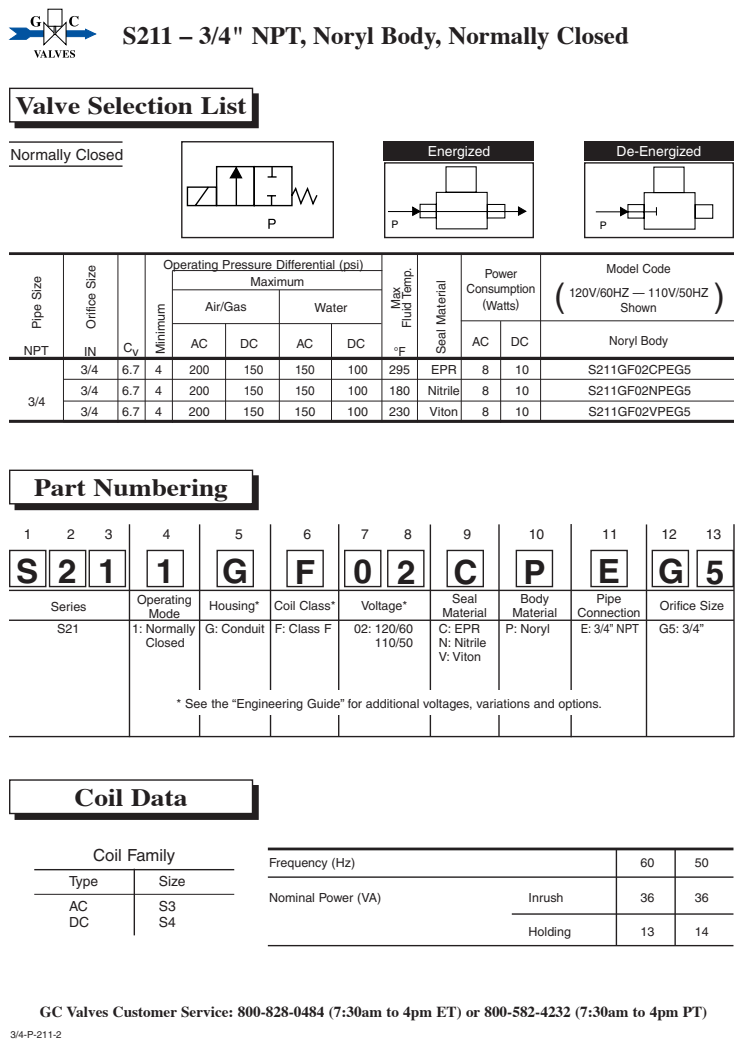
[picture p548: page 2]
Part Numbering; Series; Operating; Mode; Housing*; Coil Class*; Voltage*; Seal; Material; Body Material; Pipe; Connection; Orifice Size; G: Conduit; F: Class F; C: EPR N: Nitrile V: Viton; P: Noryl; E: 3/4” NPT; 1: Normally Closed; Coil Data; Frequency (Hz); Nominal Power (VA); Inrush; Holding; Coil Family; Type; Size; Energized; De-Energized; °F Orifice Size; Pipe Size; Minimum; DC Seal Material Max Fluid Temp.; NPT; Air/Gas; Water; Maximum; Power; Consumption (Watts); Model Code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

Valve Selection List

Operating Pressure Differential (psi)

* See the “Engineering Guide” for additional voltages, variations and options.

GC Valves Customer Service: 800-828-0484 (7:30am to 4pm ET) or 800-582-4232 (7:30am to 4pm PT)
