OpenAgricultureFoundation/openag-mechanical/prj/hazelnut_large/LHC-001/3-Specification Sheets/other/s25_spec_sheet_web.pdf

20/25/30/35

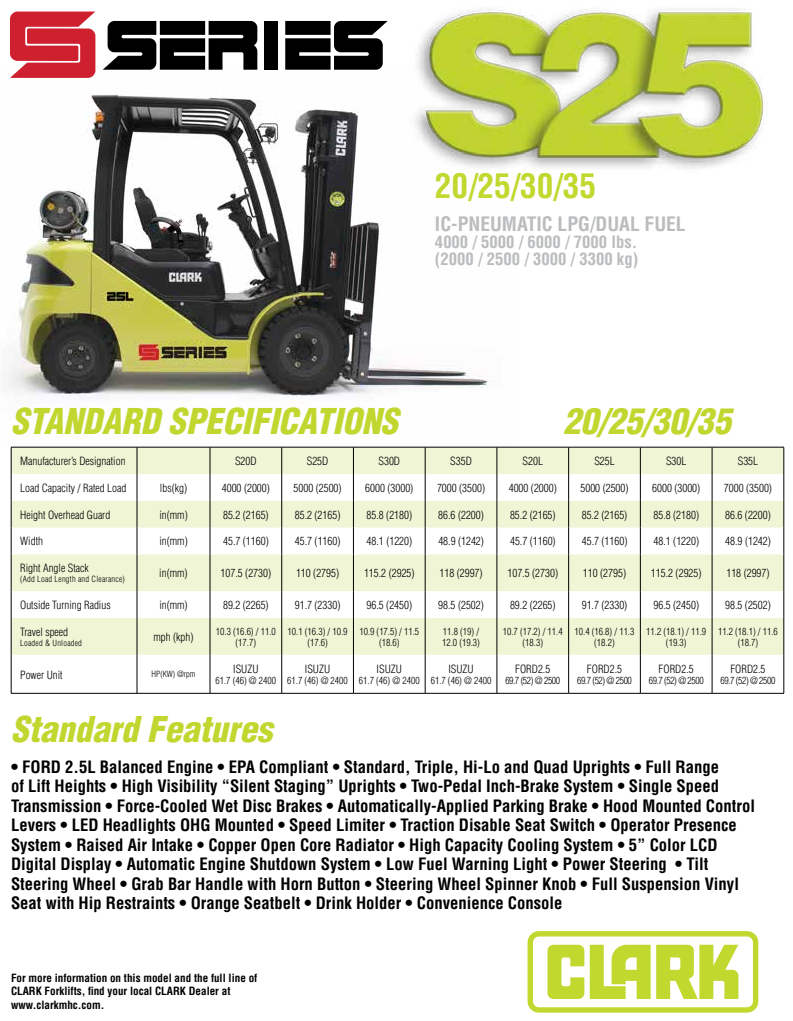
[picture p549: page 1]
STANDARD SPECIFICATIONS; Standard Features

IC-PNEUMATIC LPG/DUAL FUEL
4000 / 5000 / 6000 / 7000 lbs.

Manufacturer’s Designation | | S20D | S25D | S30D | S35D | S20L | S25L | S30L | S35L

Load Capacity / Rated Load | lbs(kg) | 4000 (2000) | 5000 (2500) | 6000 (3000) | 7000 (3500) | 4000 (2000) | 5000 (2500) | 6000 (3000) | 7000 (3500)

Height Overhead Guard | in(mm) | 85.2 (2165) | 85.2 (2165) | 85.8 (2180) | 86.6 (2200) | 85.2 (2165) | 85.2 (2165) | 85.8 (2180) | 86.6 (2200)

Width | in(mm) | 45.7 (1160) | 45.7 (1160) | 48.1 (1220) | 48.9 (1242) | 45.7 (1160) | 45.7 (1160) | 48.1 (1220) | 48.9 (1242)

Right Angle Stack (Add Load Length and Clearance) | in(mm) | 107.5 (2730) | 110 (2795) | 115.2 (2925) | 118 (2997) | 107.5 (2730) | 110 (2795) | 115.2 (2925) | 118 (2997)

Outside Turning Radius | in(mm) | 89.2 (2265) | 91.7 (2330) | 96.5 (2450) | 98.5 (2502) | 89.2 (2265) | 91.7 (2330) | 96.5 (2450) | 98.5 (2502)

Loaded & Unloaded Travel speed | mph (kph) | 10.3 (16.6) / 11.0 (17.7) | 10.1 (16.3) / 10.9 (17.6) | 10.9 (17.5) / 11.5 (18.6) | 11.8 (19) / 12.0 (19.3) | 10.7 (17.2) / 11.4 (18.3) | 10.4 (16.8) / 11.3 (18.2) | 11.2 (18.1) / 11.9 (19.3) | 11.2 (18.1) / 11.6 (18.7)

Power Unit | HP(KW) @rpm | ISUZU 61.7 (46) @ 2400 | ISUZU 61.7 (46) @ 2400 | ISUZU 61.7 (46) @ 2400 | ISUZU 61.7 (46) @ 2400 | FORD2.5 69.7 (52) @ 2500 | FORD2.5 69.7 (52) @ 2500 | FORD2.5 69.7 (52) @ 2500 | FORD2.5 69.7 (52) @ 2500

• FORD 2.5L Balanced Engine • EPA Compliant • Standard, Triple, Hi-Lo and Quad Uprights • Full Range
of Lift Heights • High Visibility “Silent Staging” Uprights • Two-Pedal Inch-Brake System • Single Speed
Transmission • Force-Cooled Wet Disc Brakes • Automatically-Applied Parking Brake • Hood Mounted Control
Levers • LED Headlights OHG Mounted • Speed Limiter • Traction Disable Seat Switch • Operator Presence
System • Raised Air Intake • Copper Open Core Radiator • High Capacity Cooling System • 5” Color LCD
Digital Display • Automatic Engine Shutdown System • Low Fuel Warning Light • Power Steering • Tilt
Steering Wheel • Grab Bar Handle with Horn Button • Steering Wheel Spinner Knob • Full Suspension Vinyl
Seat with Hip Restraints • Orange Seatbelt • Drink Holder • Convenience Console

For more information on this model and the full line of
CLARK Forklifts, find your local CLARK Dealer at
www.clarkmhc.com.
