OpenAgricultureFoundation/openag-mechanical/prj/hazelnut_large/LHC-001/3-Specification Sheets/drivers/SLM-Series-1-pager.pdf

Tri-Mode Dimming™ (TRIAC, ELV & 0-10 V), High Power,

# CC LED Drivers with 1-100% Dimming Range

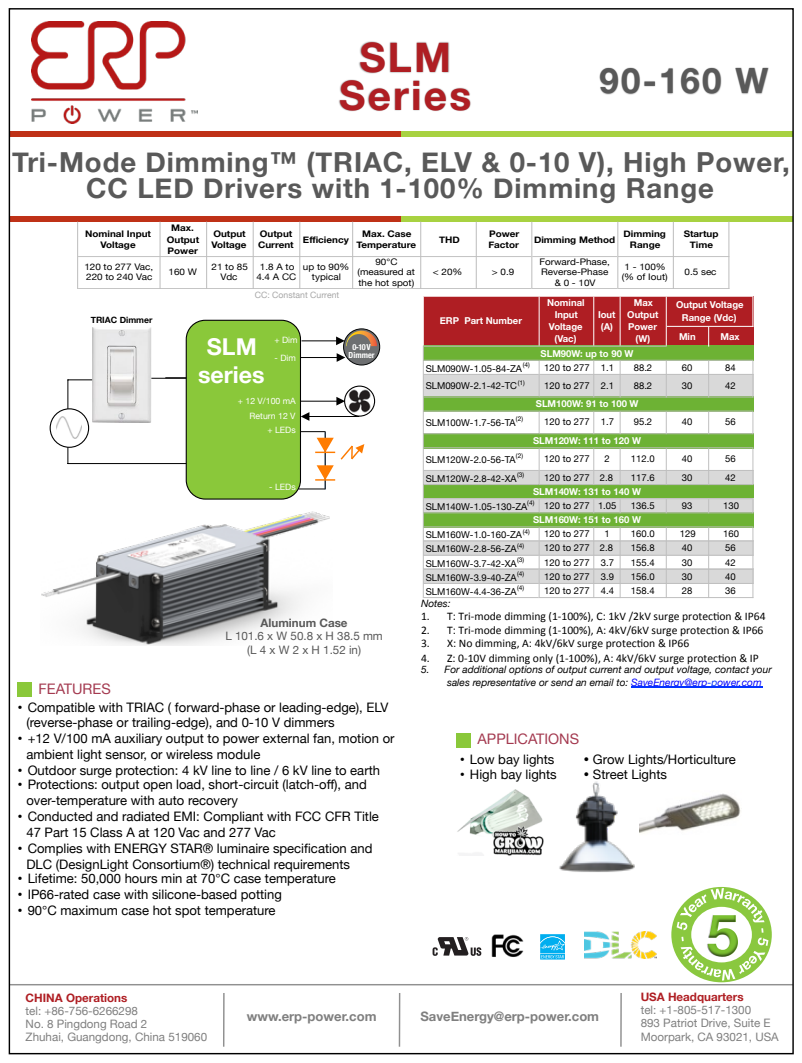
[picture p550: page 1]
TROPO; Triac Based Dimmer; Nominal Input Voltage; Max. Output Power; Output Voltage; Output; Current; Efficiency; Max. Case; Temperature; THD; Power; Factor; Dimming Method; Dimming; Range; Startup Time; 120 to 277 Vac,; 220 to 240 Vac; Vdc; up to 90% typical; Forward-Phase, Reverse-Phase & 0 - 10V; (% of Iout); 0.5 sec; APPLICATIONS; • Low bay lights; ! Grow Lights/Horticulture; • High bay lights; ! Street Lights; CC: Constant Current; 90-160 W SLM Series; SLM series; + LEDs; - LEDs; + Dim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

(measured at
the hot spot)

(A) ERP Part Number

SLM120W-2.0-56-TA⁽²⁾ | 120 to 277 | 2 | 112.0 | 40 | 56
SLM120W-2.8-42-XA⁽³⁾ | 120 to 277 | 2.8 | 117.6 | 30 | 42

SLM160W-1.0-160-ZA⁽⁴⁾ | 120 to 277 | 1 | 160.0 | 129 | 160
SLM160W-2.8-56-ZA⁽⁴⁾ | 120 to 277 | 2.8 | 156.8 | 40 | 56
SLM160W-3.7-42-XA⁽³⁾ | 120 to 277 | 3.7 | 155.4 | 30 | 42
SLM160W-3.9-40-ZA⁽⁴⁾ | 120 to 277 | 3.9 | 156.0 | 30 | 40
SLM160W-4.4-36-ZA⁽⁴⁾ | 120 to 277 | 4.4 | 158.4 | 28 | 36

Notes:
1. T: Tri-mode dimming (1-100%), C: 1kV /2kV surge protec>on & IP64
2. T: Tri-mode dimming (1-100%), A: 4kV/6kV surge protec>on & IP66
3. X: No dimming, A: 4kV/6kV surge protec>on & IP66
4. Z: 0-10V dimming only (1-100%), A: 4kV/6kV surge protec>on & IP
5. For additional options of output current and output voltage, contact your
sales representative or send an email to: SaveEnergy@erp-power.com

FEATURES
• Compatible with TRIAC ( forward-phase or leading-edge), ELV
(reverse-phase or trailing-edge), and 0-10 V dimmers
• +12 V/100 mA auxiliary output to power external fan, motion or
ambient light sensor, or wireless module
• Outdoor surge protection: 4 kV line to line / 6 kV line to earth
• Protections: output open load, short-circuit (latch-off), and
over-temperature with auto recovery
• Conducted and radiated EMI: Compliant with FCC CFR Title
47 Part 15 Class A at 120 Vac and 277 Vac
• Complies with ENERGY STAR® luminaire specification and
DLC (DesignLight Consortium®) technical requirements
• Lifetime: 50,000 hours min at 70°C case temperature
• IP66-rated case with silicone-based potting
• 90°C maximum case hot spot temperature

CHINA Operations
tel: +86-756-6266298
No. 8 Pingdong Road 2
Zhuhai, Guangdong, China 519060

USA Headquarters
tel: +1-805-517-1300
893 Patriot Drive, Suite E
Moorpark, CA 93021, USA

www.erp-power.com

SaveEnergy@erp-power.com
