OpenAgricultureFoundation/openag-mechanical/outgoing/5-24-18 Sheet Metal RFQ/5_24_18_RFQ_LFR-001.PDF

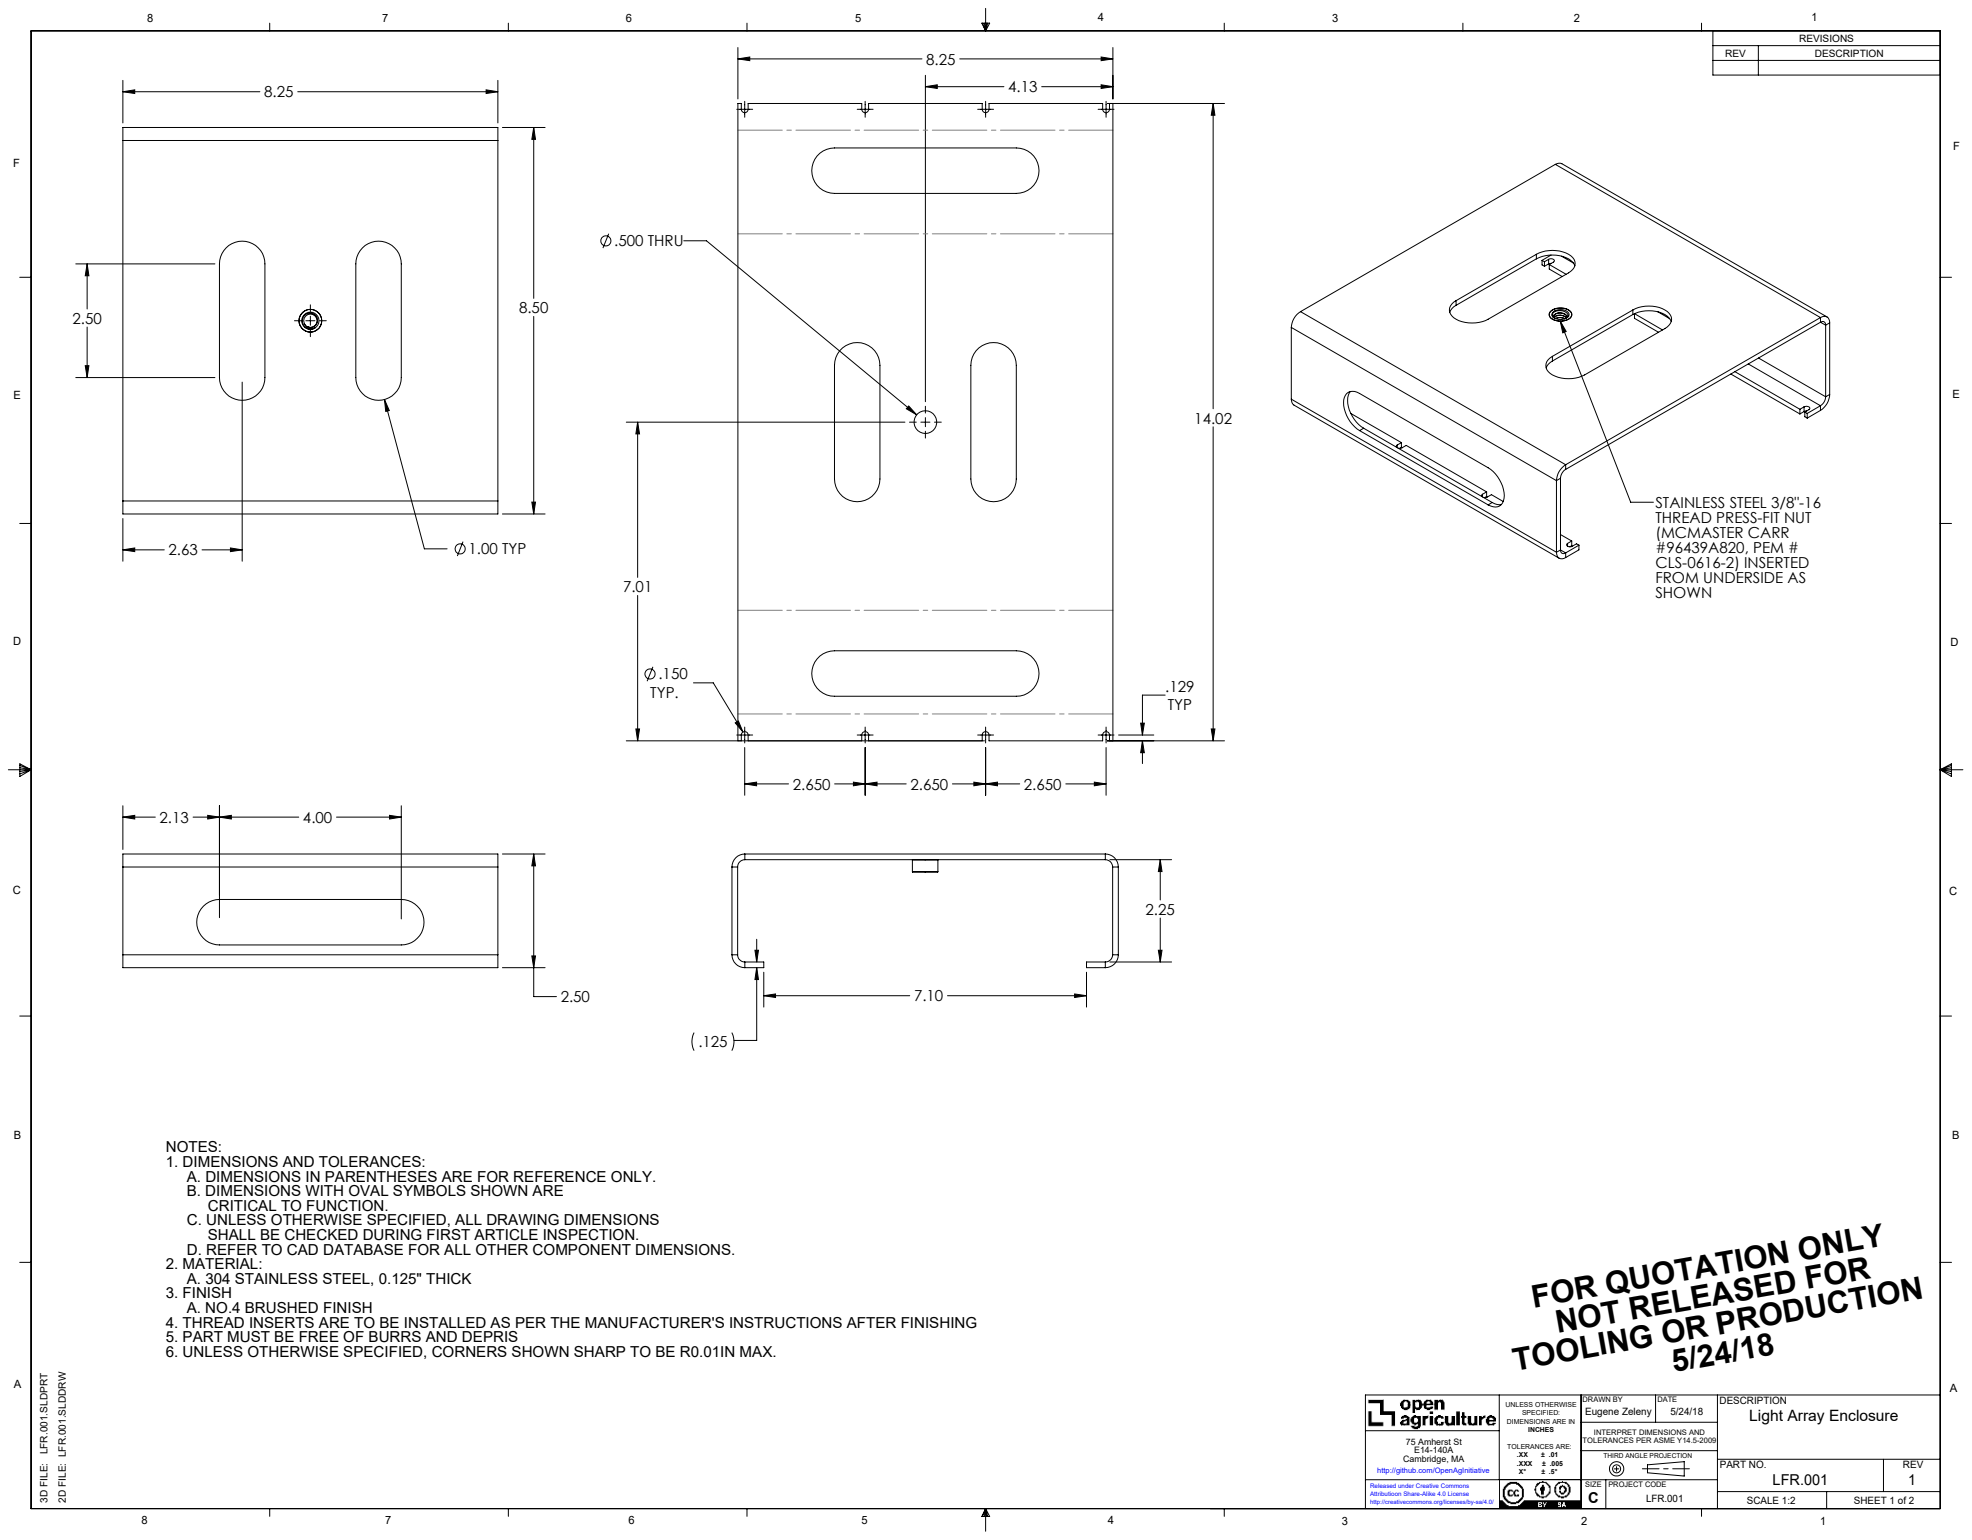
[picture p553: page 1]
1.00 TYP; .500 THRU; PART NO.; SCALE 1:2; SHEET 1 of 2; PROJECT CODE; Eugene Zeleny; C LFR.001; DRAWN BY; DATE

STAINLESS STEEL 3/8"-16
THREAD PRESS-FIT NUT
(MCMASTER CARR
#96439A820, PEM #
CLS-0616-2) INSERTED
FROM UNDERSIDE AS
SHOWN

NOTES:
1. DIMENSIONS AND TOLERANCES:
A. DIMENSIONS IN PARENTHESES ARE FOR REFERENCE ONLY.
B. DIMENSIONS WITH OVAL SYMBOLS SHOWN ARE
CRITICAL TO FUNCTION.
C. UNLESS OTHERWISE SPECIFIED, ALL DRAWING DIMENSIONS
SHALL BE CHECKED DURING FIRST ARTICLE INSPECTION.
D. REFER TO CAD DATABASE FOR ALL OTHER COMPONENT DIMENSIONS.
2. MATERIAL:
A. 304 STAINLESS STEEL, 0.125" THICK
3. FINISH
A. NO.4 BRUSHED FINISH
4. THREAD INSERTS ARE TO BE INSTALLED AS PER THE MANUFACTURER'S INSTRUCTIONS AFTER FINISHING
5. PART MUST BE FREE OF BURRS AND DEPRIS
6. UNLESS OTHERWISE SPECIFIED, CORNERS SHOWN SHARP TO BE R0.01IN MAX.

FOR QUOTATION ONLY

NOT RELEASED FOR TOOLING OR PRODUCTION 5/24/18

3D FILE: LFR.001.SLDPRT

2D FILE: LFR.001.SLDDRW

DESCRIPTION
Light Array Enclosure

UNLESS OTHERWISE
SPECIFIED:
DIMENSIONS ARE IN
INCHES
TOLERANCES ARE:
.XXX ± .005

75 Amherst St
Cambridge, MA
http://github.com/OpenAgInitiative

INTERPRET DIMENSIONS AND
TOLERANCES PER ASME Y14.5-2009
THIRD ANGLE PROJECTION

Released under Creative Commons
Attributioon Share-Alike 4.0 License
http://creativecommons.org/licenses/by-sa/4.0/

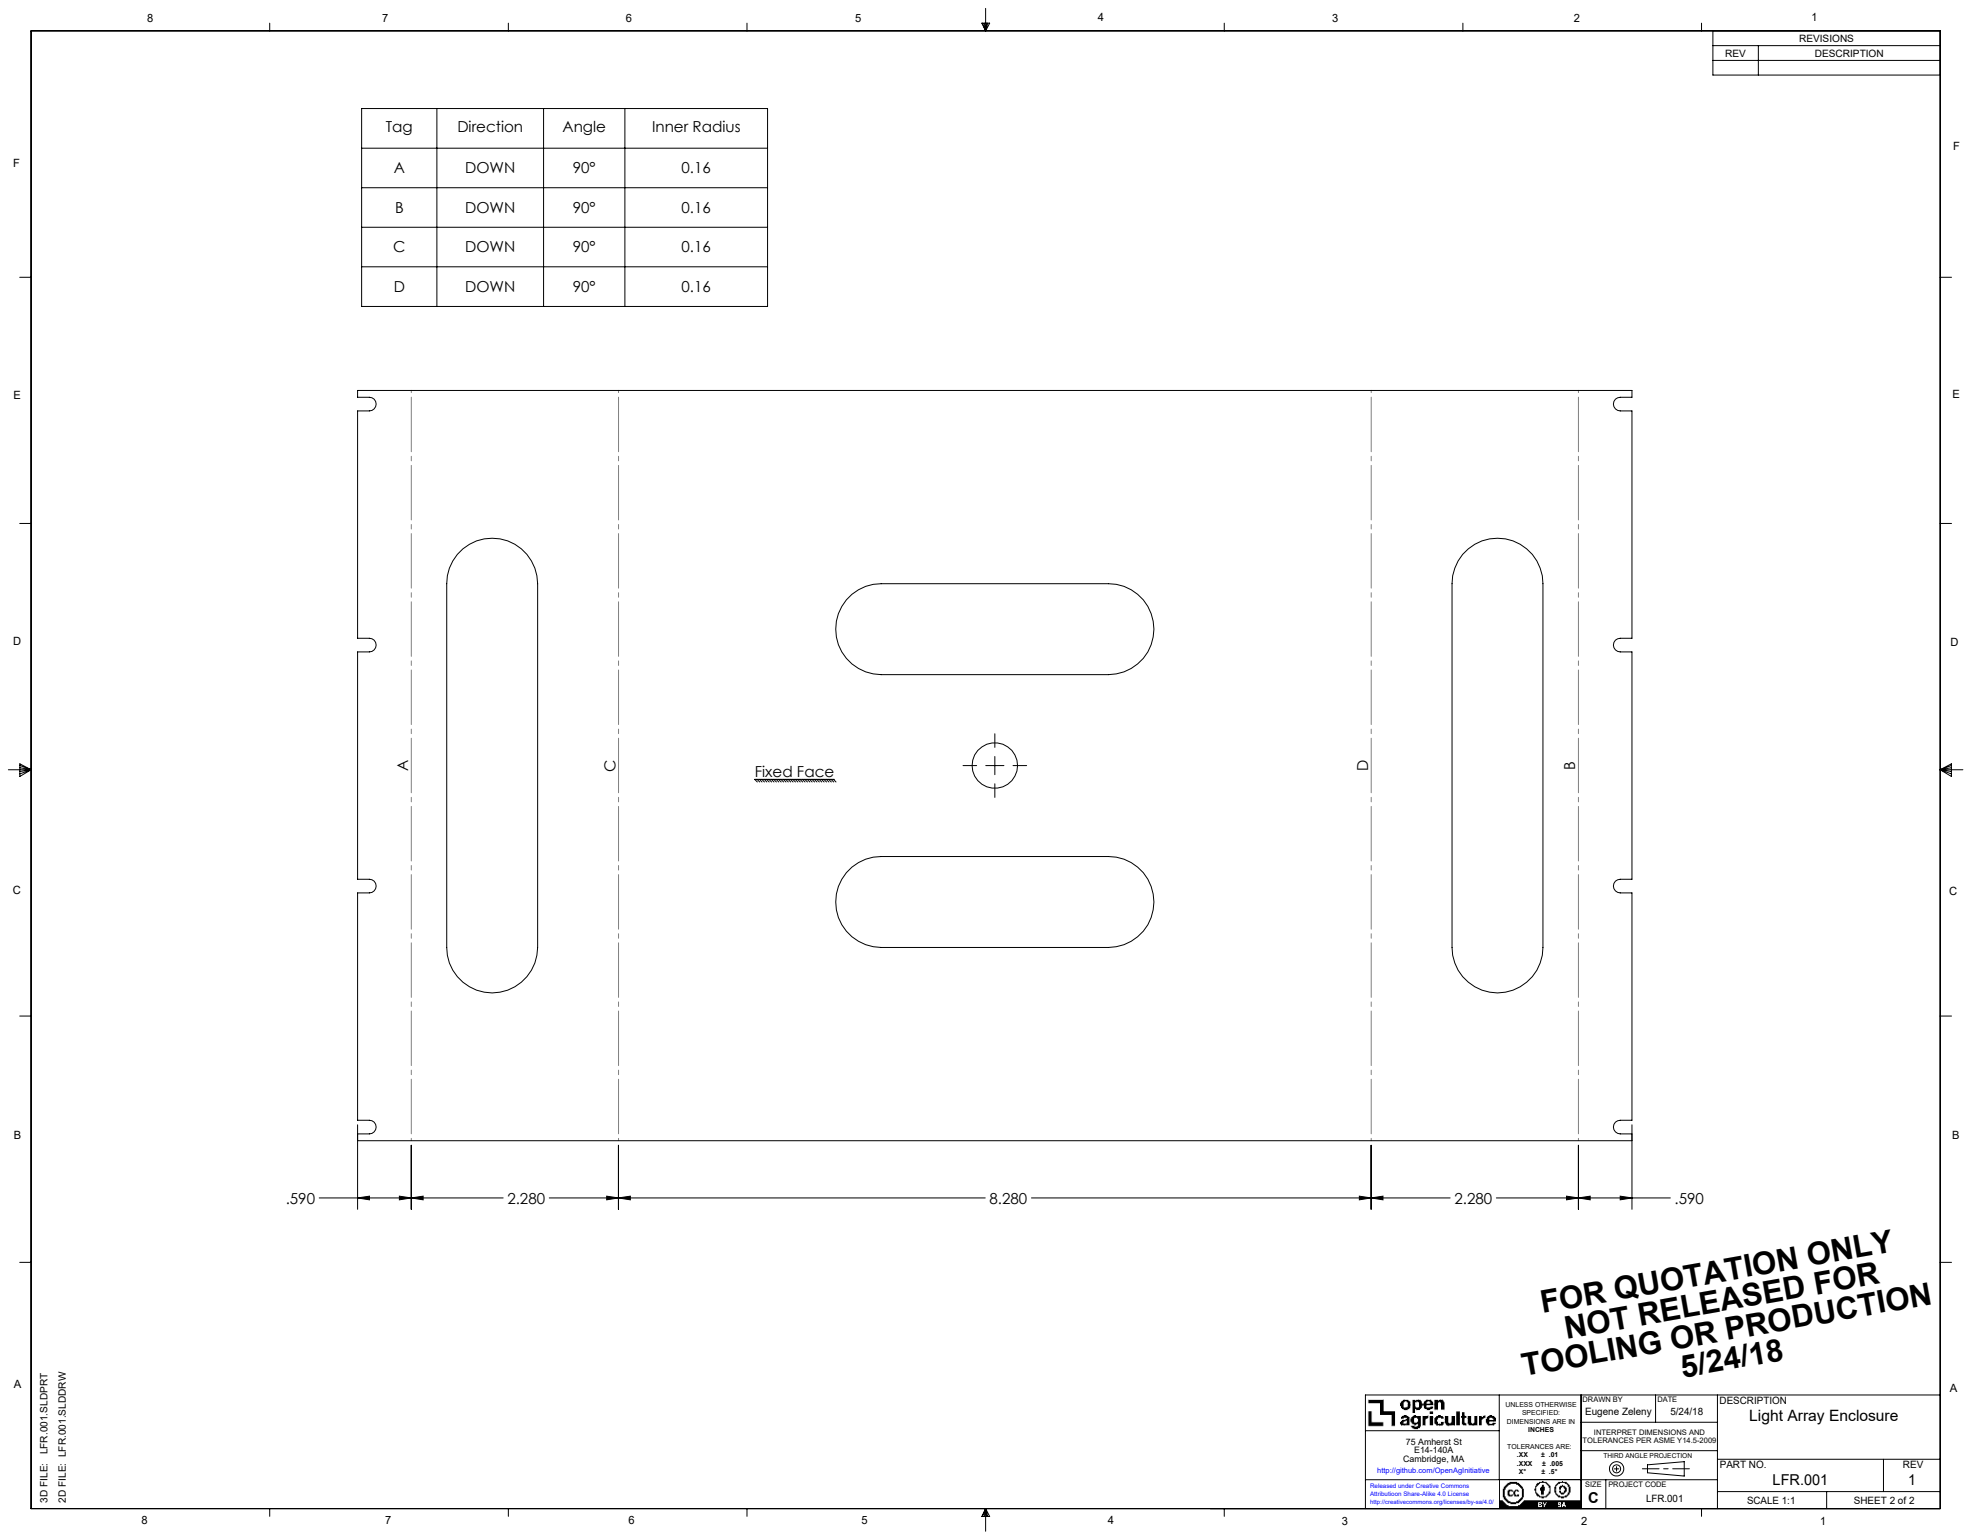
[picture p554: page 2]
Fixed Face A; PART NO.; SCALE 1:1; SHEET 2 of 2; PROJECT CODE; Eugene Zeleny; C LFR.001; DRAWN BY; DATE

Tag | Direction | Angle | Inner Radius

A | DOWN | 90° | 0.16
B | DOWN | 90° | 0.16
C | DOWN | 90° | 0.16
D | DOWN | 90° | 0.16

FOR QUOTATION ONLY

NOT RELEASED FOR TOOLING OR PRODUCTION 5/24/18

3D FILE: LFR.001.SLDPRT

2D FILE: LFR.001.SLDDRW

DESCRIPTION
Light Array Enclosure

UNLESS OTHERWISE
SPECIFIED:
DIMENSIONS ARE IN
INCHES
TOLERANCES ARE:
.XXX ± .005

75 Amherst St
Cambridge, MA
http://github.com/OpenAgInitiative

INTERPRET DIMENSIONS AND
TOLERANCES PER ASME Y14.5-2009
THIRD ANGLE PROJECTION

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
