OpenAgricultureFoundation/openag-mechanical/prj/hazelnut_large/LHC-001/LHC-300/lhc-308.PDF

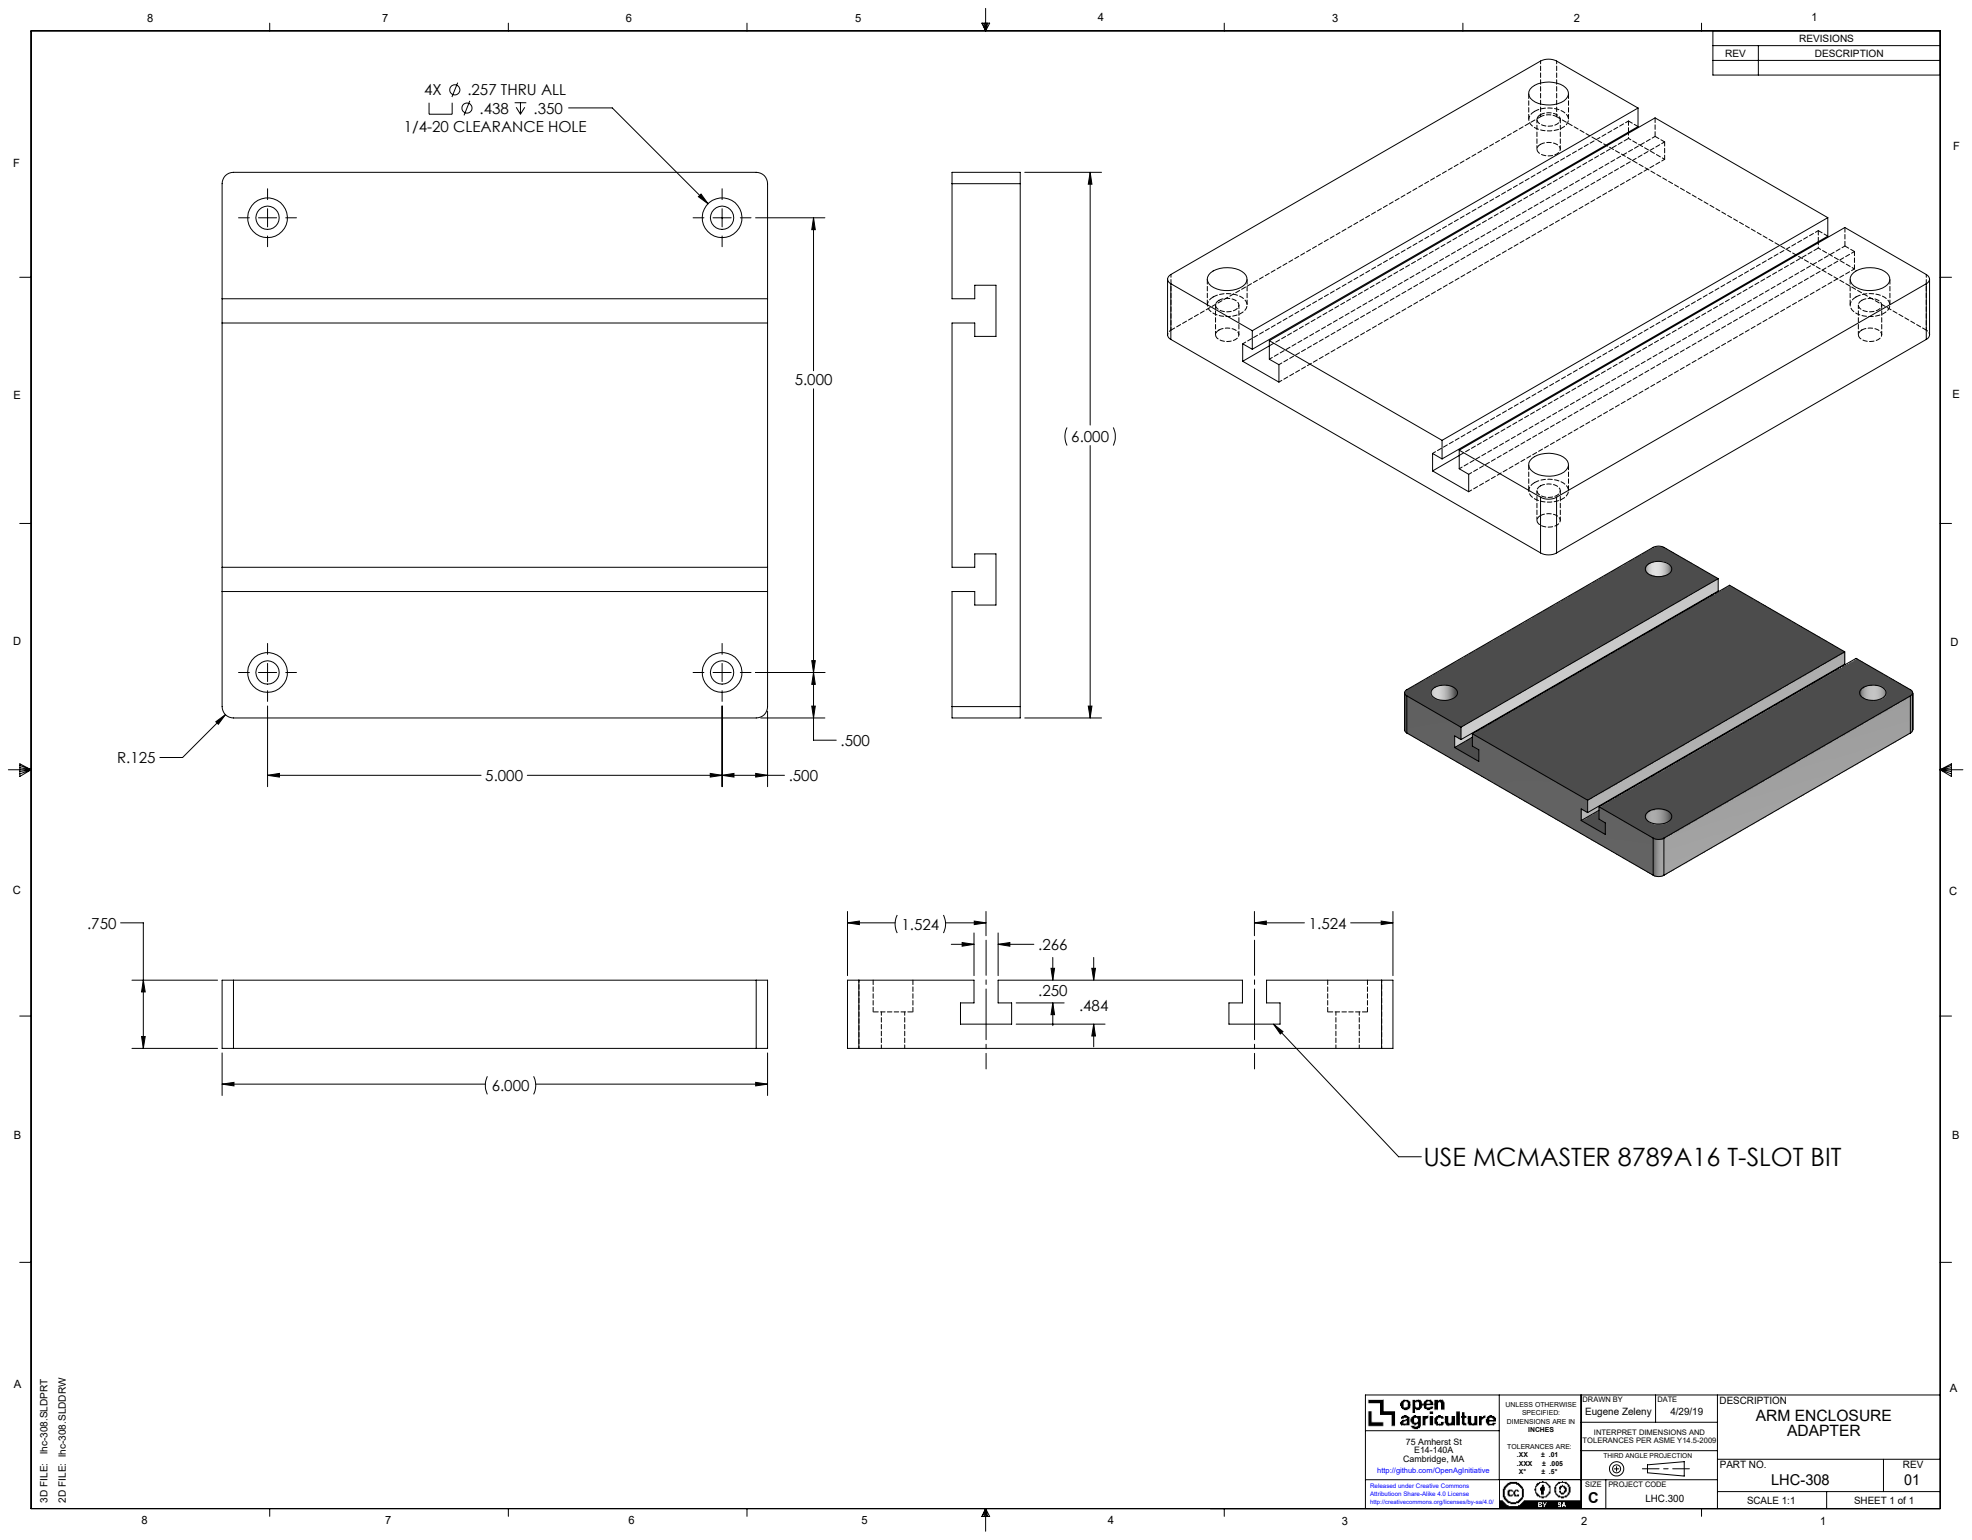
[picture p555: page 1]
.257 THRU ALL; .438 .350 1/4-20 CLEARANCE HOLE; PART NO.; SCALE 1:1; SHEET 1 of 1; ARM ENCLOSURE; INTERPRET DIMENSIONS AND; ADAPTER; PROJECT CODE; Eugene Zeleny; C LHC.300; DRAWN BY; DATE

USE MCMASTER 8789A16 T-SLOT BIT

3D FILE: lhc-308.SLDPRT

2D FILE: lhc-308.SLDDRW

TOLERANCES PER ASME Y14.5-2009
THIRD ANGLE PROJECTION

UNLESS OTHERWISE
SPECIFIED:
DIMENSIONS ARE IN
INCHES
TOLERANCES ARE:
.XXX ± .005

75 Amherst St
Cambridge, MA
http://github.com/OpenAgInitiative

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
