OpenAgricultureFoundation/openag-mechanical/prj/hazelnut_large/LHC-001/LHC-300/416201U00000G-ND_12IN HEATSINK.PDF

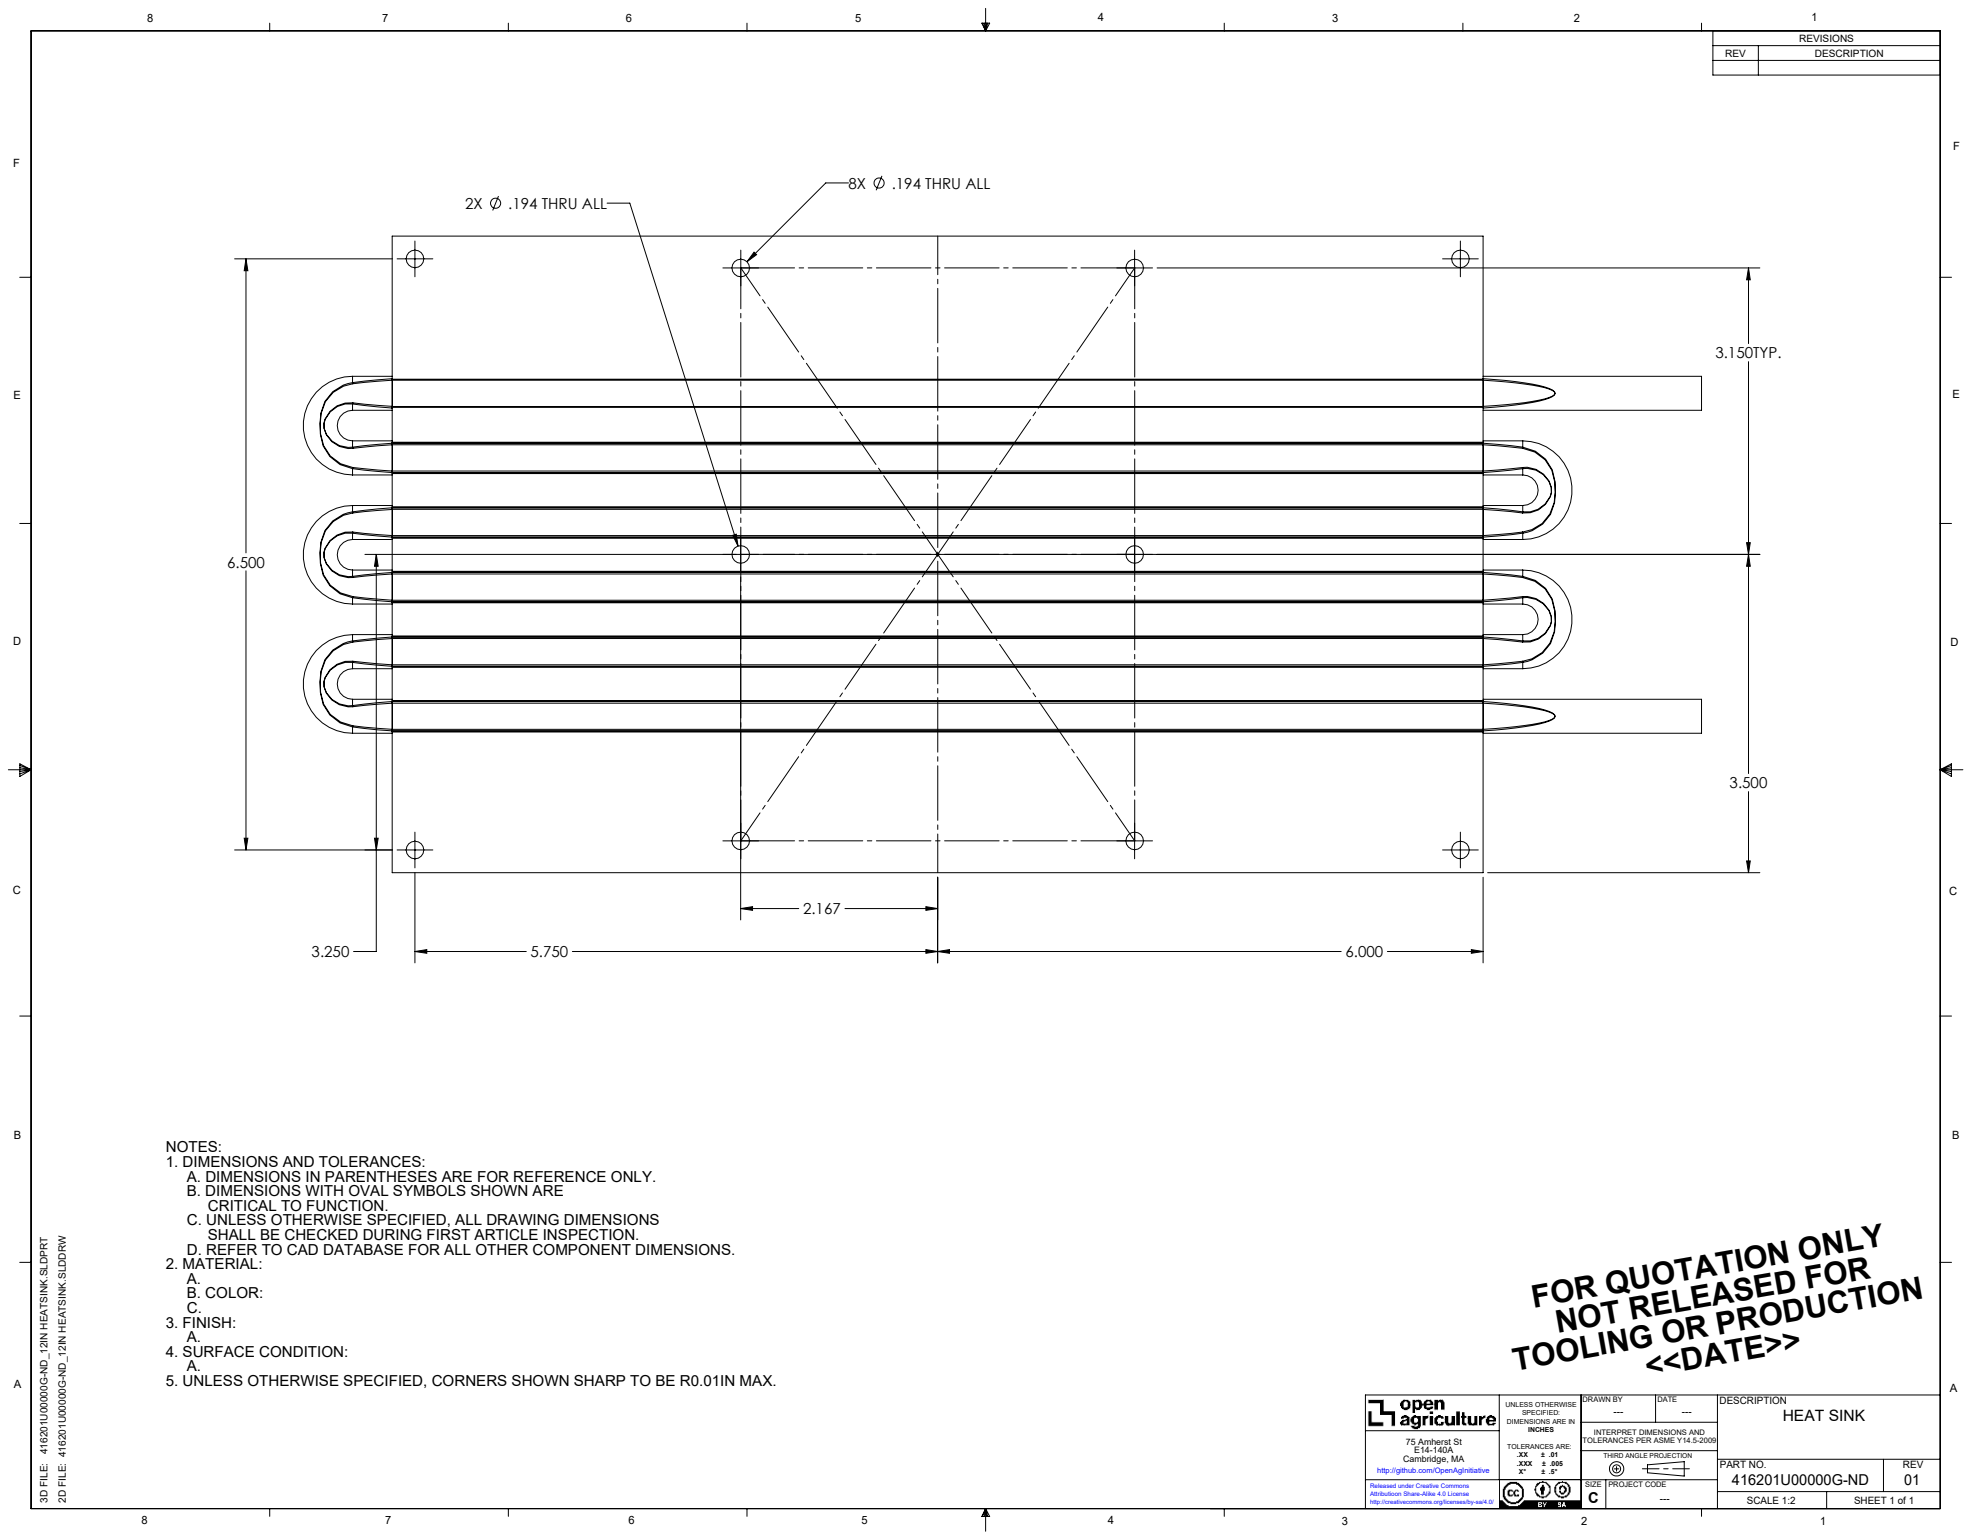
[picture p556: page 1]
.194 THRU ALL; PART NO.; SCALE 1:2; SHEET 1 of 1; HEAT SINK; PROJECT CODE C ---; DRAWN BY; DATE

NOTES:
1. DIMENSIONS AND TOLERANCES:
A. DIMENSIONS IN PARENTHESES ARE FOR REFERENCE ONLY.
B. DIMENSIONS WITH OVAL SYMBOLS SHOWN ARE
CRITICAL TO FUNCTION.
C. UNLESS OTHERWISE SPECIFIED, ALL DRAWING DIMENSIONS
SHALL BE CHECKED DURING FIRST ARTICLE INSPECTION.
D. REFER TO CAD DATABASE FOR ALL OTHER COMPONENT DIMENSIONS.
2. MATERIAL:
B. COLOR:
3. FINISH:
4. SURFACE CONDITION:
5. UNLESS OTHERWISE SPECIFIED, CORNERS SHOWN SHARP TO BE R0.01IN MAX.

FOR QUOTATION ONLY

3D FILE: 416201U00000G-ND_12IN HEATSINK.SLDPRT

2D FILE: 416201U00000G-ND_12IN HEATSINK.SLDDRW

NOT RELEASED FOR TOOLING OR PRODUCTION <<DATE>>

UNLESS OTHERWISE
SPECIFIED:
DIMENSIONS ARE IN
INCHES
TOLERANCES ARE:
.XXX ± .005

75 Amherst St
Cambridge, MA
http://github.com/OpenAgInitiative

INTERPRET DIMENSIONS AND
TOLERANCES PER ASME Y14.5-2009
THIRD ANGLE PROJECTION

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
