OpenAgricultureFoundation/openag-mechanical/prj/hazelnut_large/LHC-001/2-RFQs/9-12-18_MIT_MEDIA_LAB_OPENAG_RFQ_BRACKET.PDF

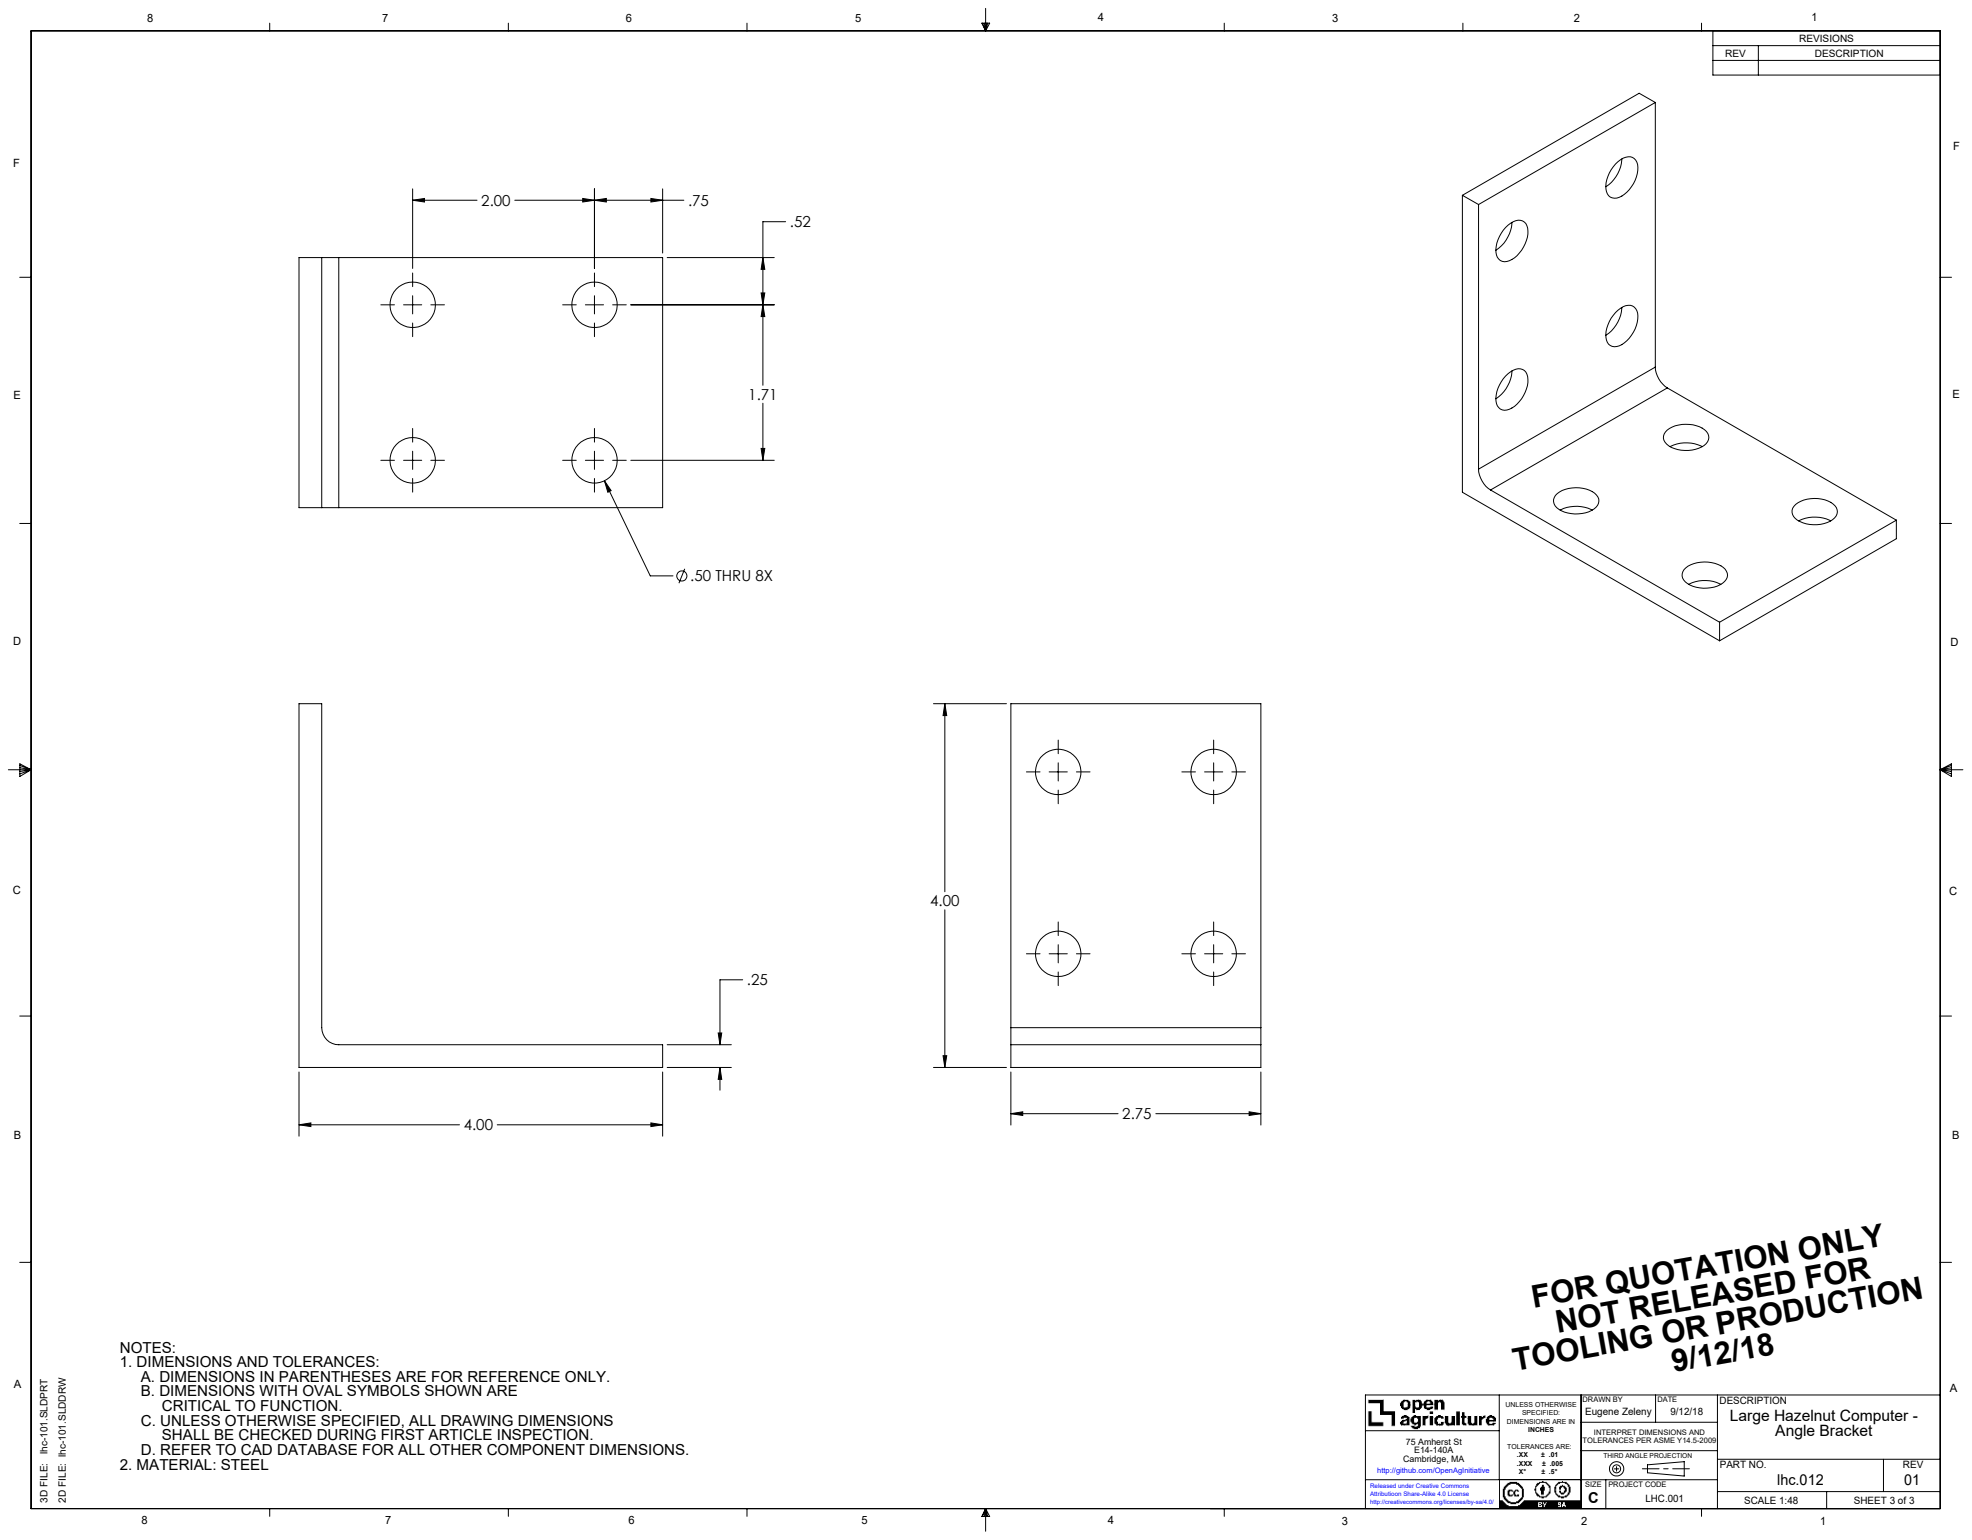
[picture p558: page 1]
.50 THRU 8X; PART NO.; SCALE 1:48; SHEET 3 of 3; INTERPRET DIMENSIONS AND; Angle Bracket TOLERANCES PER ASME Y14.5-2009; PROJECT CODE; Eugene Zeleny; C LHC.001; DRAWN BY; DATE

FOR QUOTATION ONLY

NOT RELEASED FOR TOOLING OR PRODUCTION 9/12/18

NOTES:
1. DIMENSIONS AND TOLERANCES:
A. DIMENSIONS IN PARENTHESES ARE FOR REFERENCE ONLY.
B. DIMENSIONS WITH OVAL SYMBOLS SHOWN ARE
CRITICAL TO FUNCTION.
C. UNLESS OTHERWISE SPECIFIED, ALL DRAWING DIMENSIONS
SHALL BE CHECKED DURING FIRST ARTICLE INSPECTION.
D. REFER TO CAD DATABASE FOR ALL OTHER COMPONENT DIMENSIONS.
2. MATERIAL: STEEL

3D FILE: lhc-101.SLDPRT

2D FILE: lhc-101.SLDDRW

DESCRIPTION
Large Hazelnut Computer -

UNLESS OTHERWISE
SPECIFIED:
DIMENSIONS ARE IN
INCHES
TOLERANCES ARE:
.XXX ± .005

75 Amherst St
Cambridge, MA
http://github.com/OpenAgInitiative

THIRD ANGLE PROJECTION

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
