OpenAgricultureFoundation/openag-mechanical/prj/hazelnut_large/LHC-001/2-RFQs/9-12-18_MIT_MEDIA_LAB_OPENAG_RFQ_STEEL.PDF

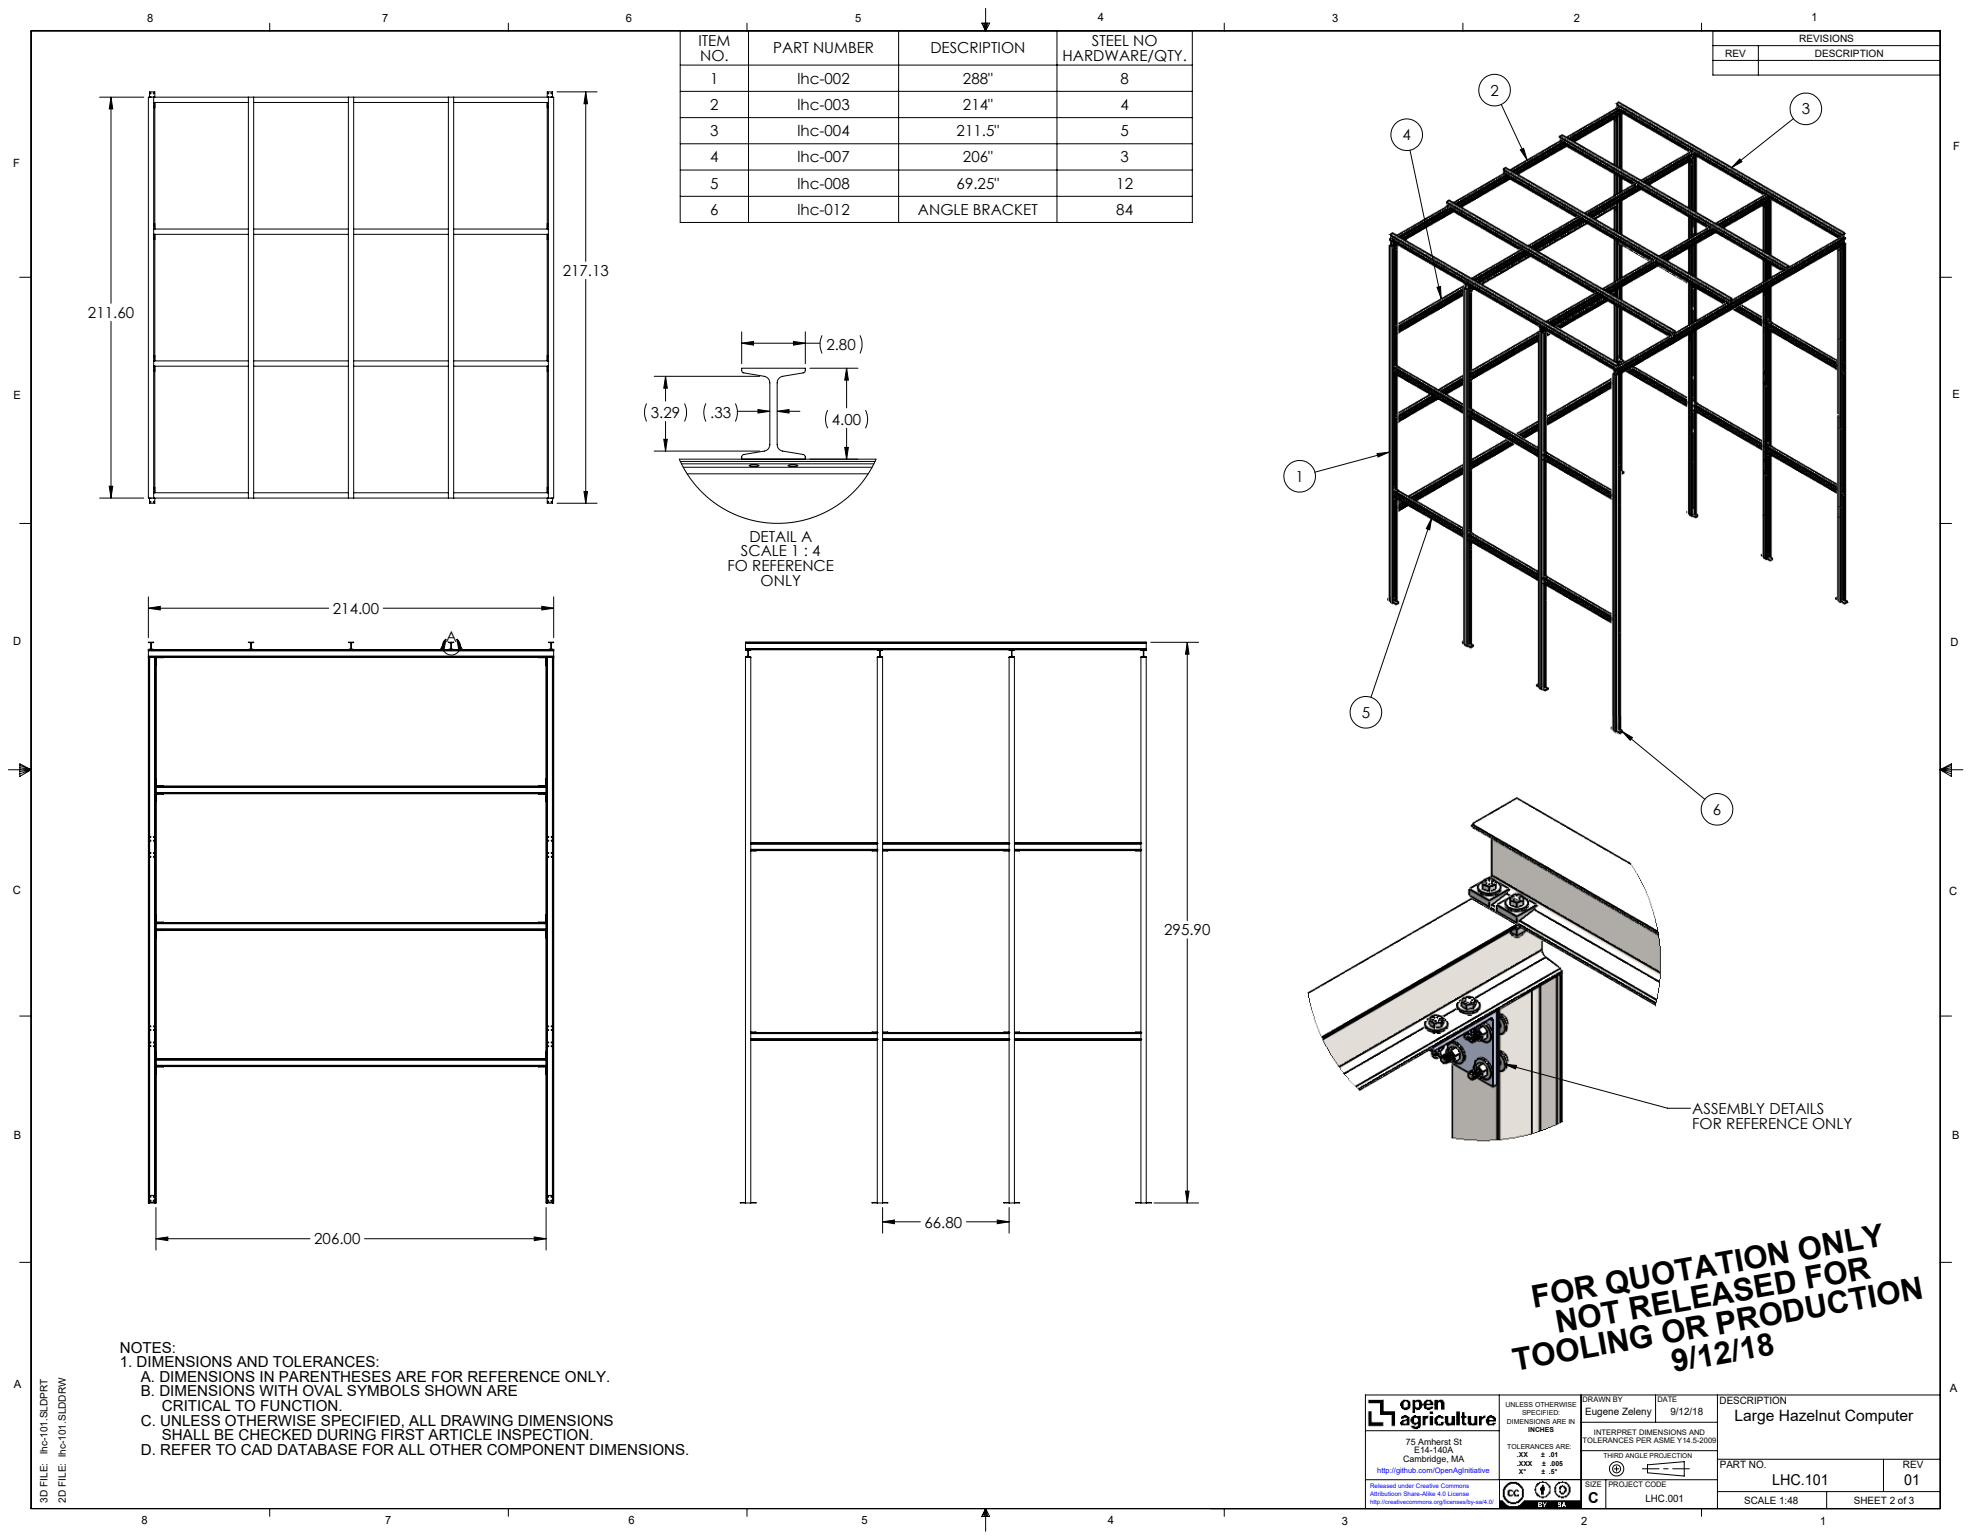
[picture p559: page 1]
DETAIL A SCALE 1 : 4 FO REFERENCE; PART NUMBER; DESCRIPTION; STEEL NO; PART NO.; SCALE 1:48; SHEET 2 of 3; PROJECT CODE; Eugene Zeleny; C LHC.001; DRAWN BY; DATE

1 | lhc-002 | 288" | 8
2 | lhc-003 | 214" | 4
3 | lhc-004 | 211.5" | 5
4 | lhc-007 | 206" | 3
5 | lhc-008 | 69.25" | 12
6 | lhc-012 | ANGLE BRACKET | 84

ASSEMBLY DETAILS
FOR REFERENCE ONLY

FOR QUOTATION ONLY

NOT RELEASED FOR TOOLING OR PRODUCTION 9/12/18

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

3D FILE: lhc-101.SLDPRT

2D FILE: lhc-101.SLDDRW

DESCRIPTION
Large Hazelnut Computer

UNLESS OTHERWISE
SPECIFIED:
DIMENSIONS ARE IN
INCHES
TOLERANCES ARE:
.XXX ± .005

75 Amherst St
Cambridge, MA
http://github.com/OpenAgInitiative

INTERPRET DIMENSIONS AND
TOLERANCES PER ASME Y14.5-2009
THIRD ANGLE PROJECTION

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
