OpenAgricultureFoundation/openag-mechanical/prj/container 3 rack v2/600fwt2448us_specsheet.pdf

# REGENCY

# FOLDING WORK TABLE

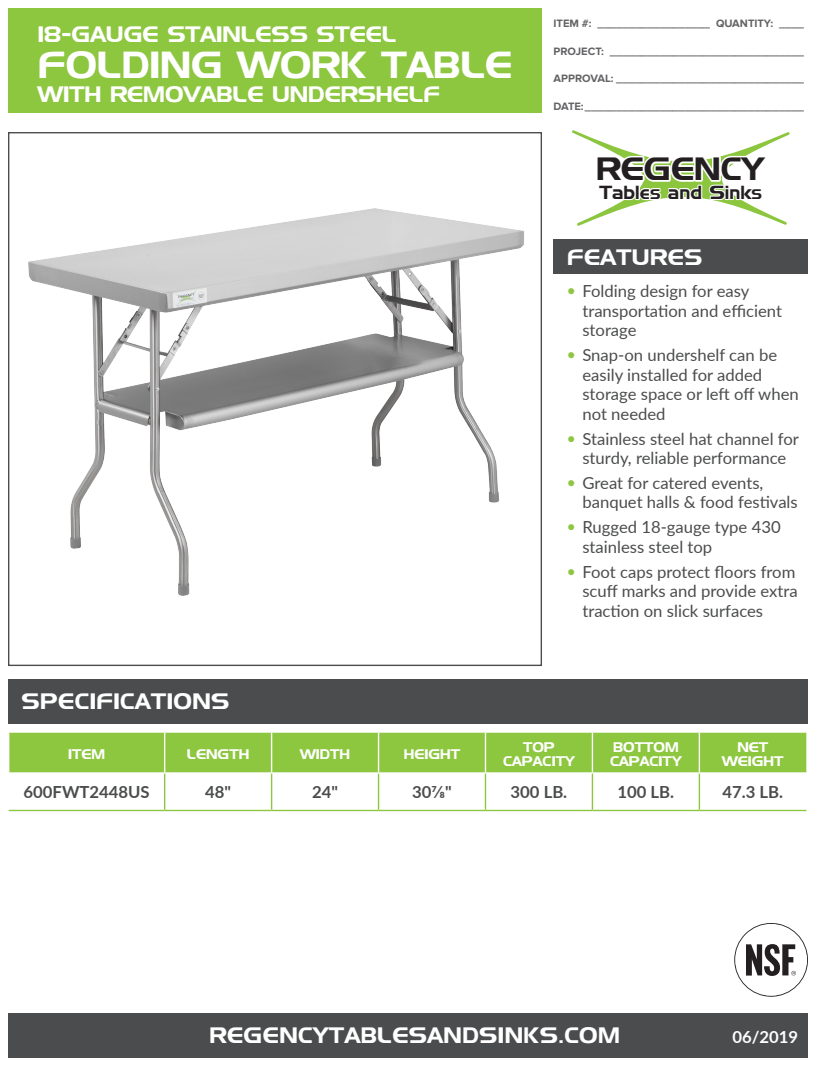
[picture p560: page 1]
SPECIFICATIONS; REGENCYTABLESANDSINKS.COM; ITEM; LENGTH; WIDTH; HEIGHT; TOP; CAPACITY; BOTTOM CAPACITY; NET WEIGHT; 600FWT2448US; ITEM #: __________________ QUANTITY: ____; PROJECT: _______________________________; APPROVAL: ______________________________; DATE:___________________________________

18-GAUGE STAINLESS STEEL

WITH REMOVABLE UNDERSHELF

Tables and Sinks

FEATURES
• Folding design for easy
transportation and efficient
storage
• Snap-on undershelf can be
easily installed for added
storage space or left off when
not needed
• Stainless steel hat channel for
sturdy, reliable performance
• Great for catered events,
banquet halls & food festivals
• Rugged 18-gauge type 430
stainless steel top
• Foot caps protect floors from
scuff marks and provide extra
traction on slick surfaces

# REGENCY

48”

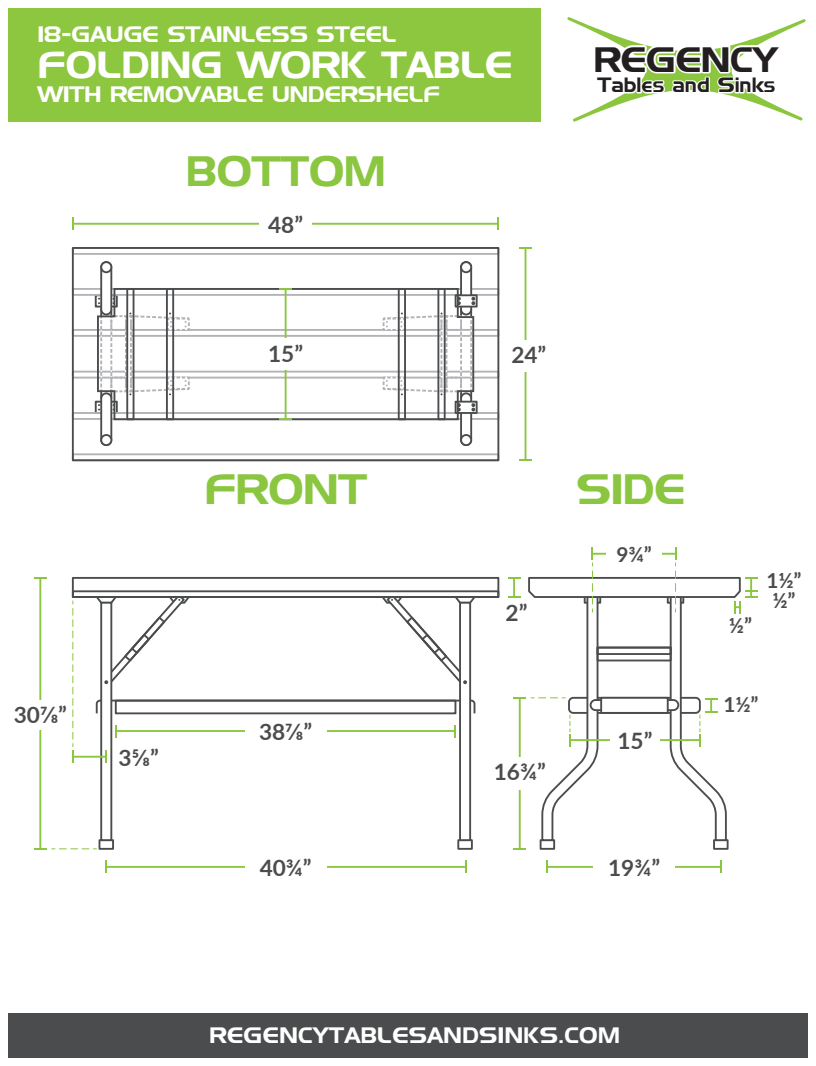
[picture p561: page 2]
REGENCYTABLESANDSINKS.COM; FRONT; SIDE

18-GAUGE STAINLESS STEEL
FOLDING WORK TABLE
WITH REMOVABLE UNDERSHELF
BOTTOM

Tables and Sinks
