OpenAgricultureFoundation/openag-mechanical/prj/fs-waterbot/v1.0/waterbot_supply_manifold_assembly.PDF

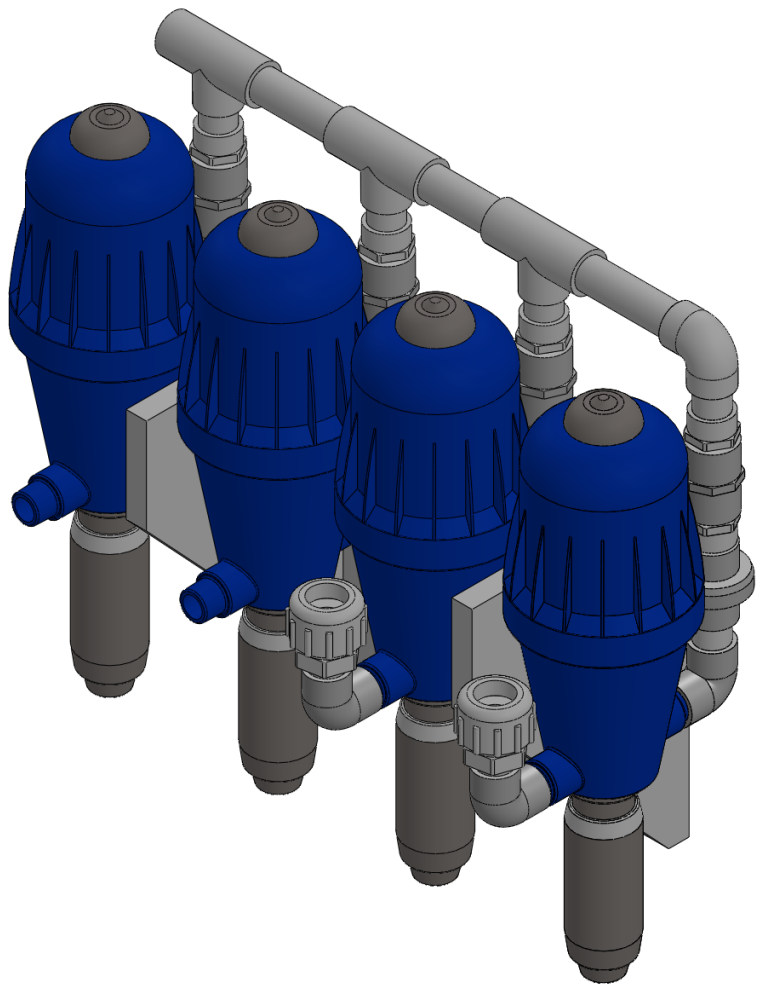
[picture p562: page 1]
