OpenAgricultureFoundation/openag-mechanical/prj/hazelnut_large/LHC-001/3-Specification Sheets/10-137-05_PGN1.pdf

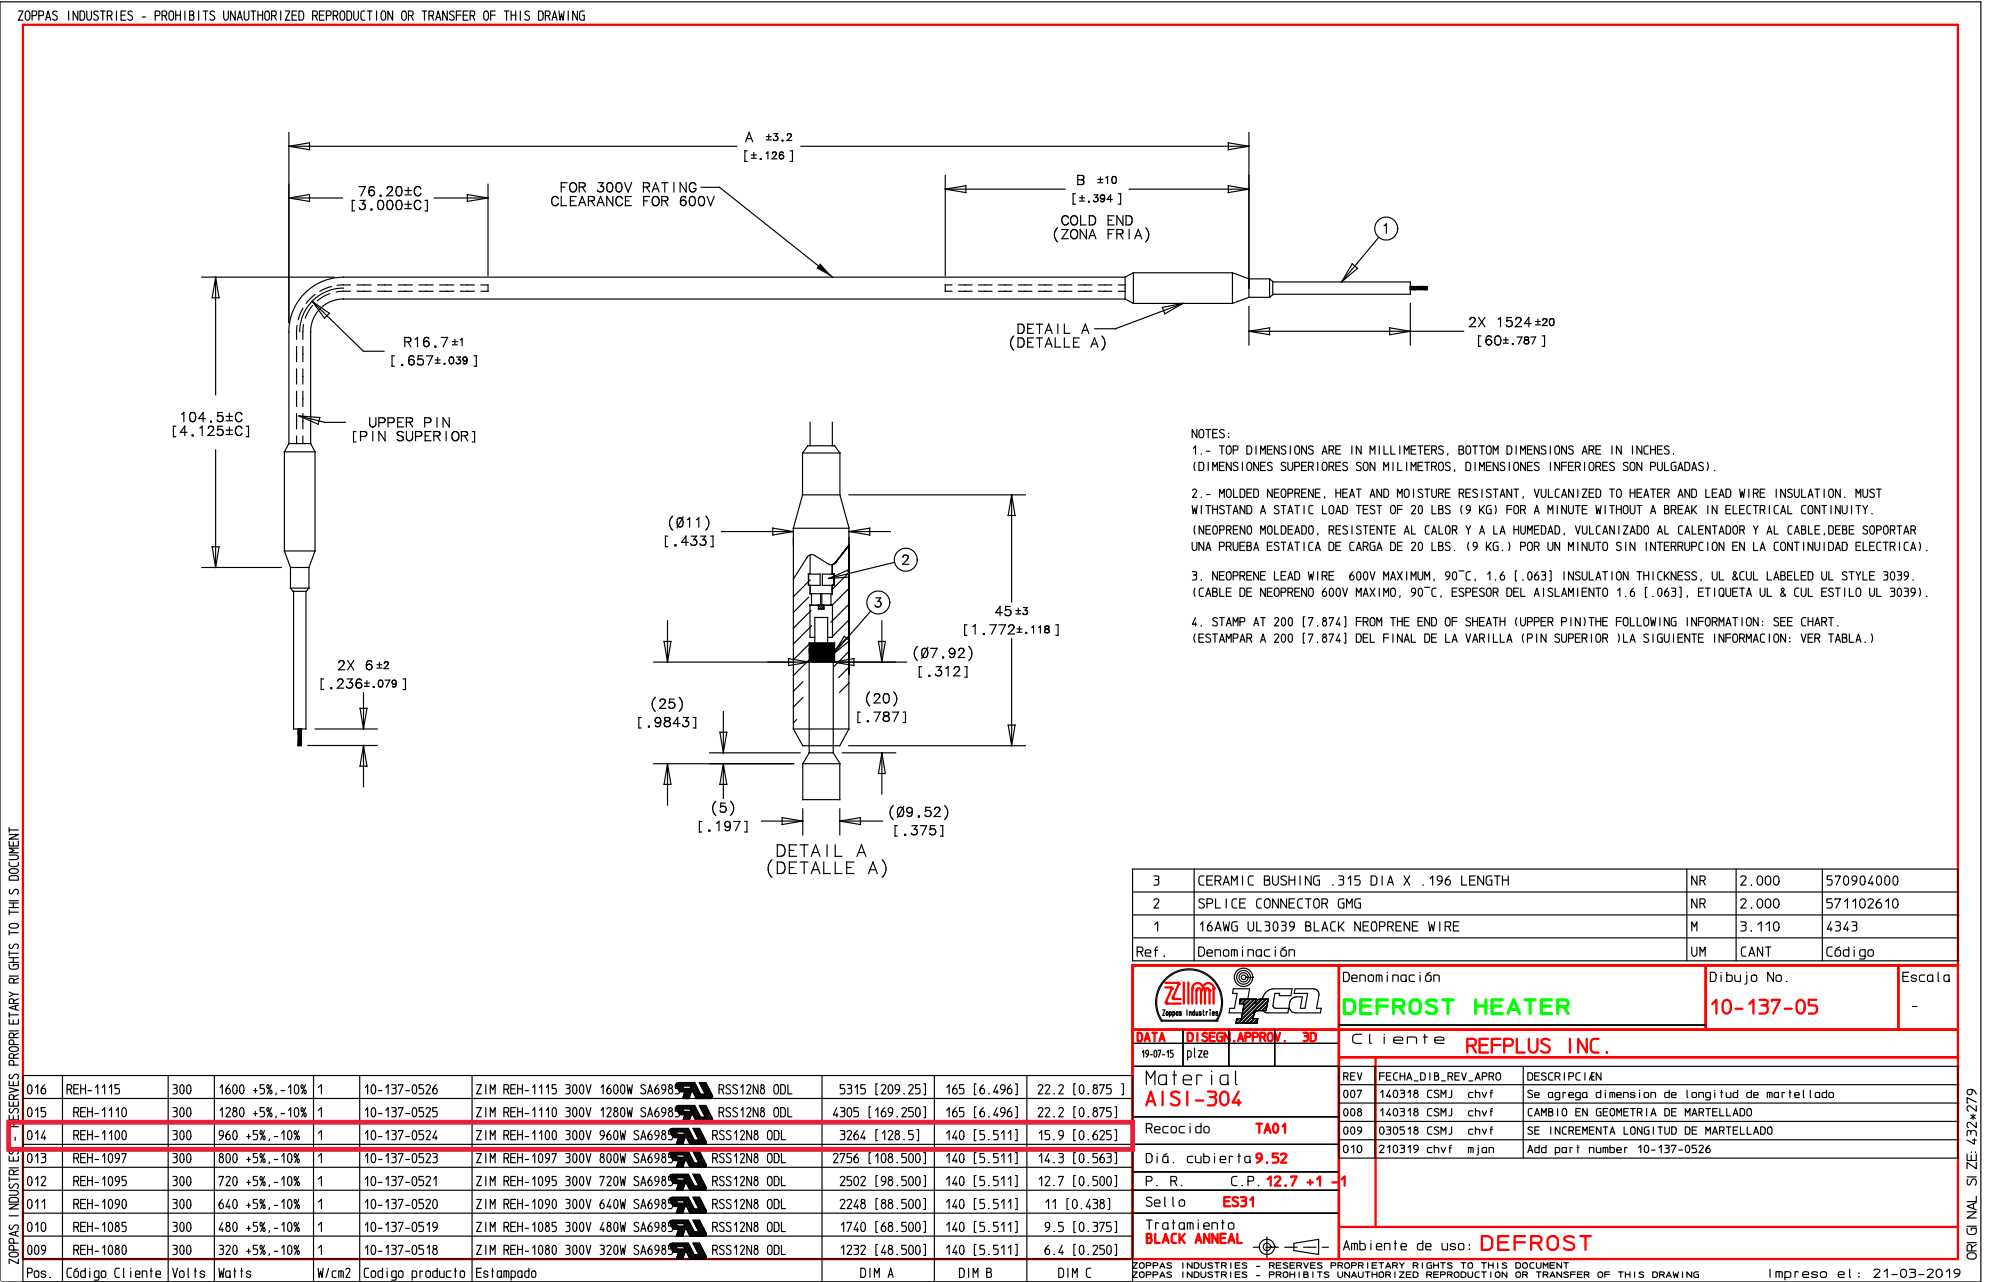
[picture p563: page 1]
