OpenAgricultureFoundation/openag-mechanical/prj/hazelnut_large/LHC-001/1-Documentation/2019-10-23 Light Unistrut Designs - Updated/LHC-201 Lights Locations Drawing.PDF

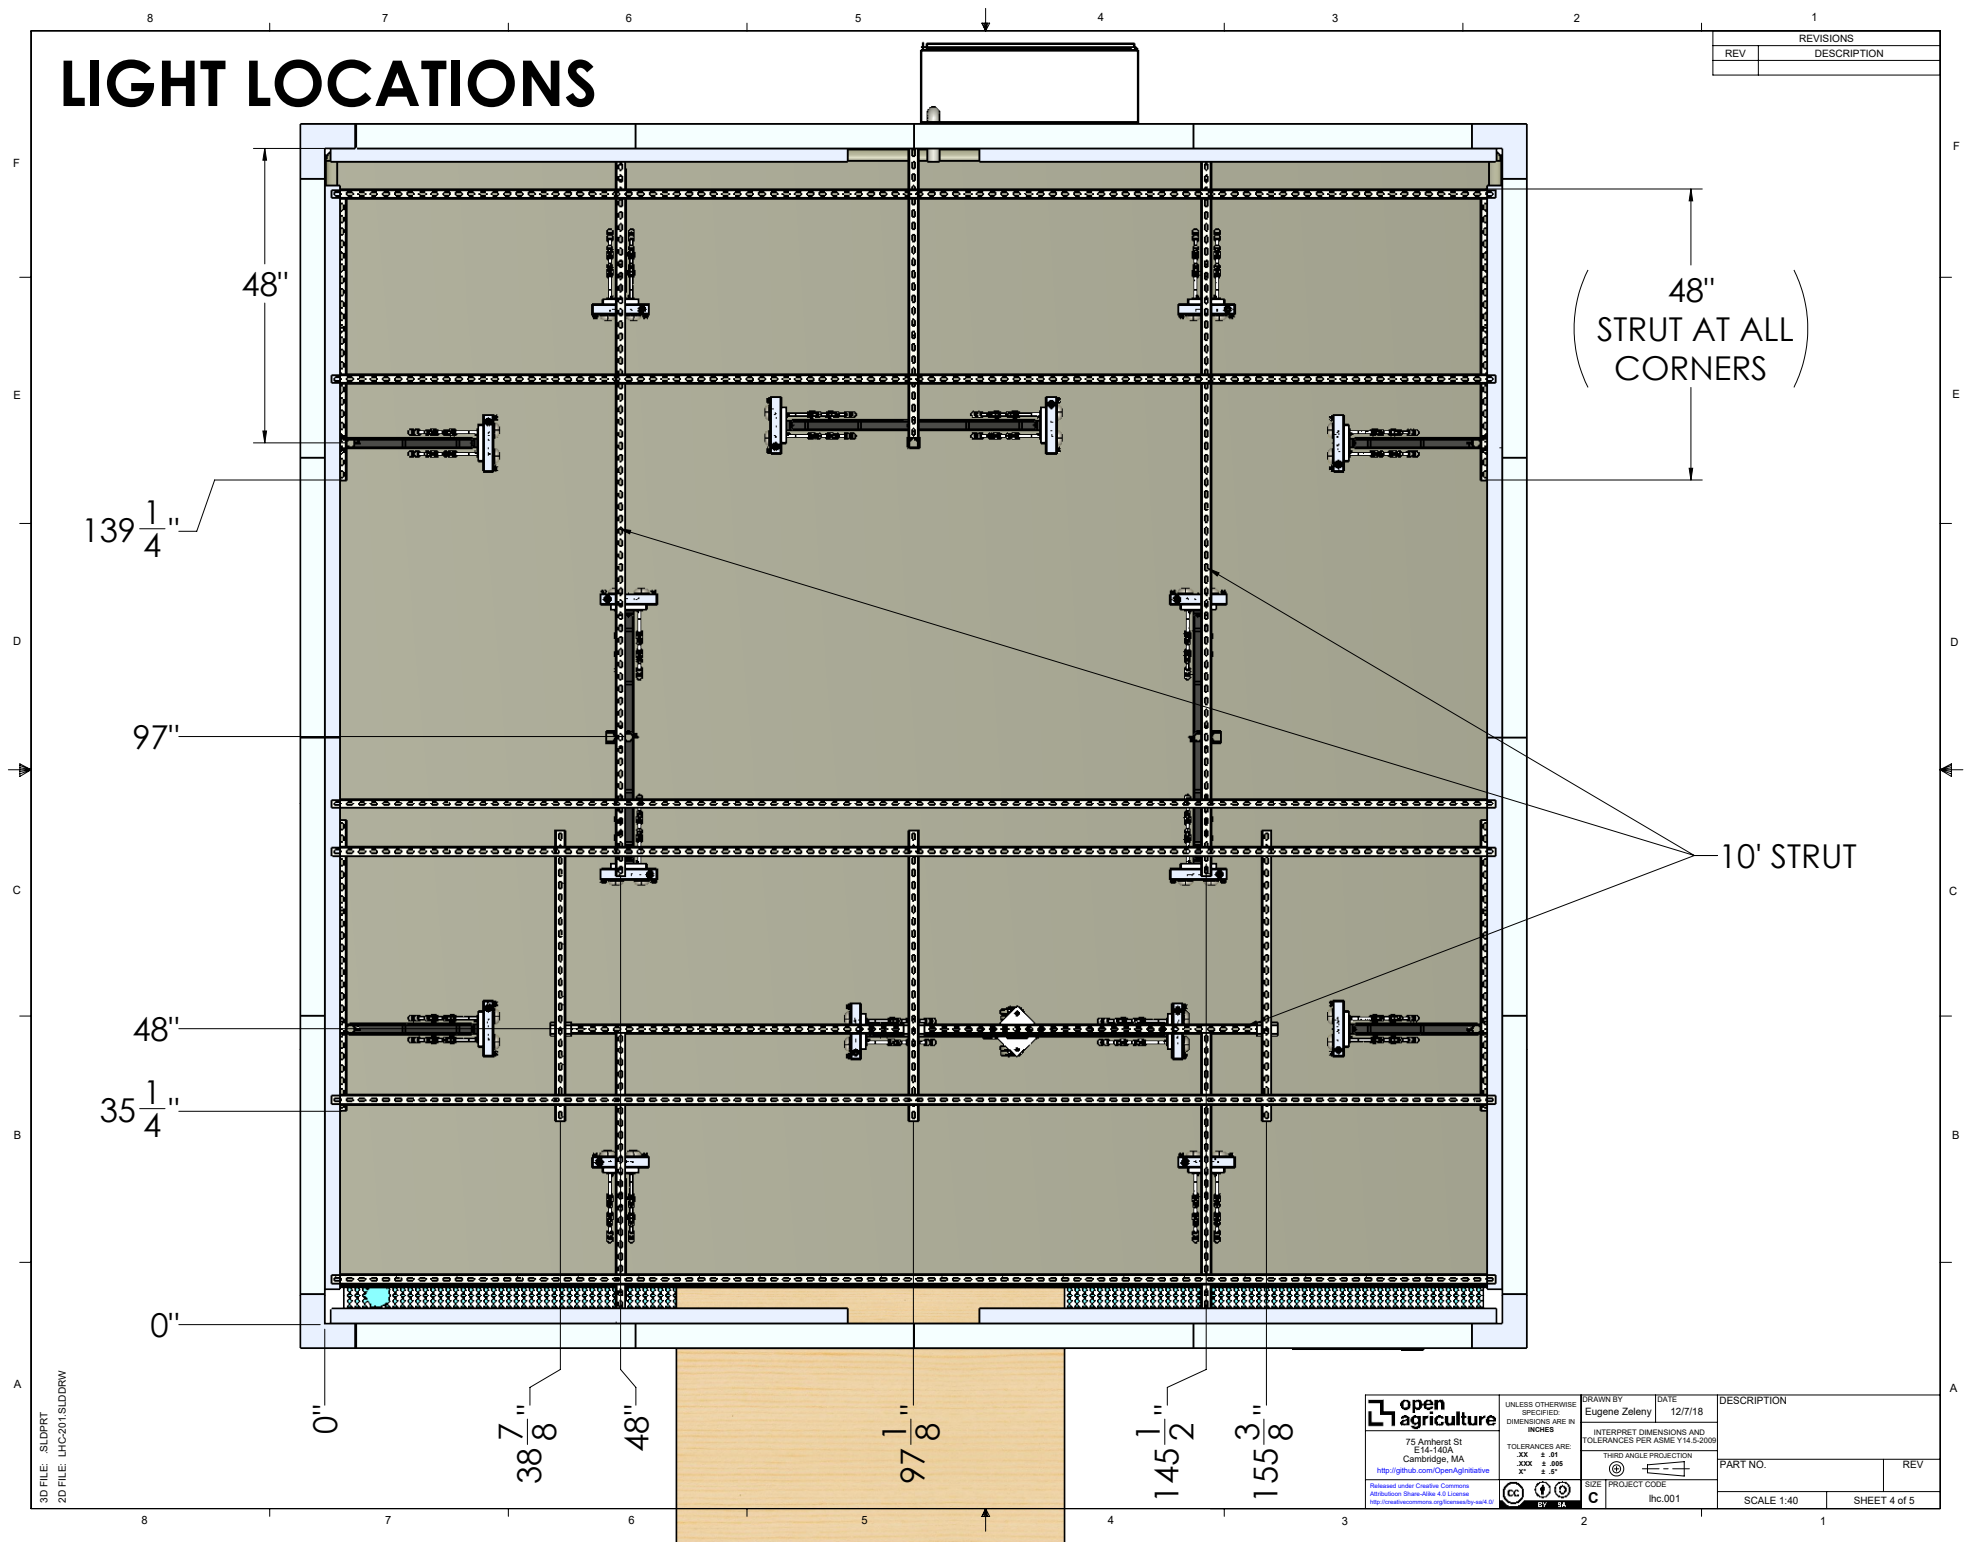
[picture p564: page 1]
STRUT AT ALL; 10' STRUT; LIGHT LOCATIONS; 3D FILE: .SLDPRT; PART NO.; SCALE 1:40; SHEET 4 of 5; PROJECT CODE; Eugene Zeleny; C lhc.001; DRAWN BY; DATE

2D FILE: LHC-201.SLDDRW

UNLESS OTHERWISE
SPECIFIED:
DIMENSIONS ARE IN
INCHES
TOLERANCES ARE:
.XXX ± .005

75 Amherst St
Cambridge, MA
http://github.com/OpenAgInitiative

INTERPRET DIMENSIONS AND
TOLERANCES PER ASME Y14.5-2009
THIRD ANGLE PROJECTION

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
