OpenAgricultureFoundation/openag-mechanical/prj/hazelnut_large/LHC-001/3-Specification Sheets/other/C01630G00610012_mech.pdf

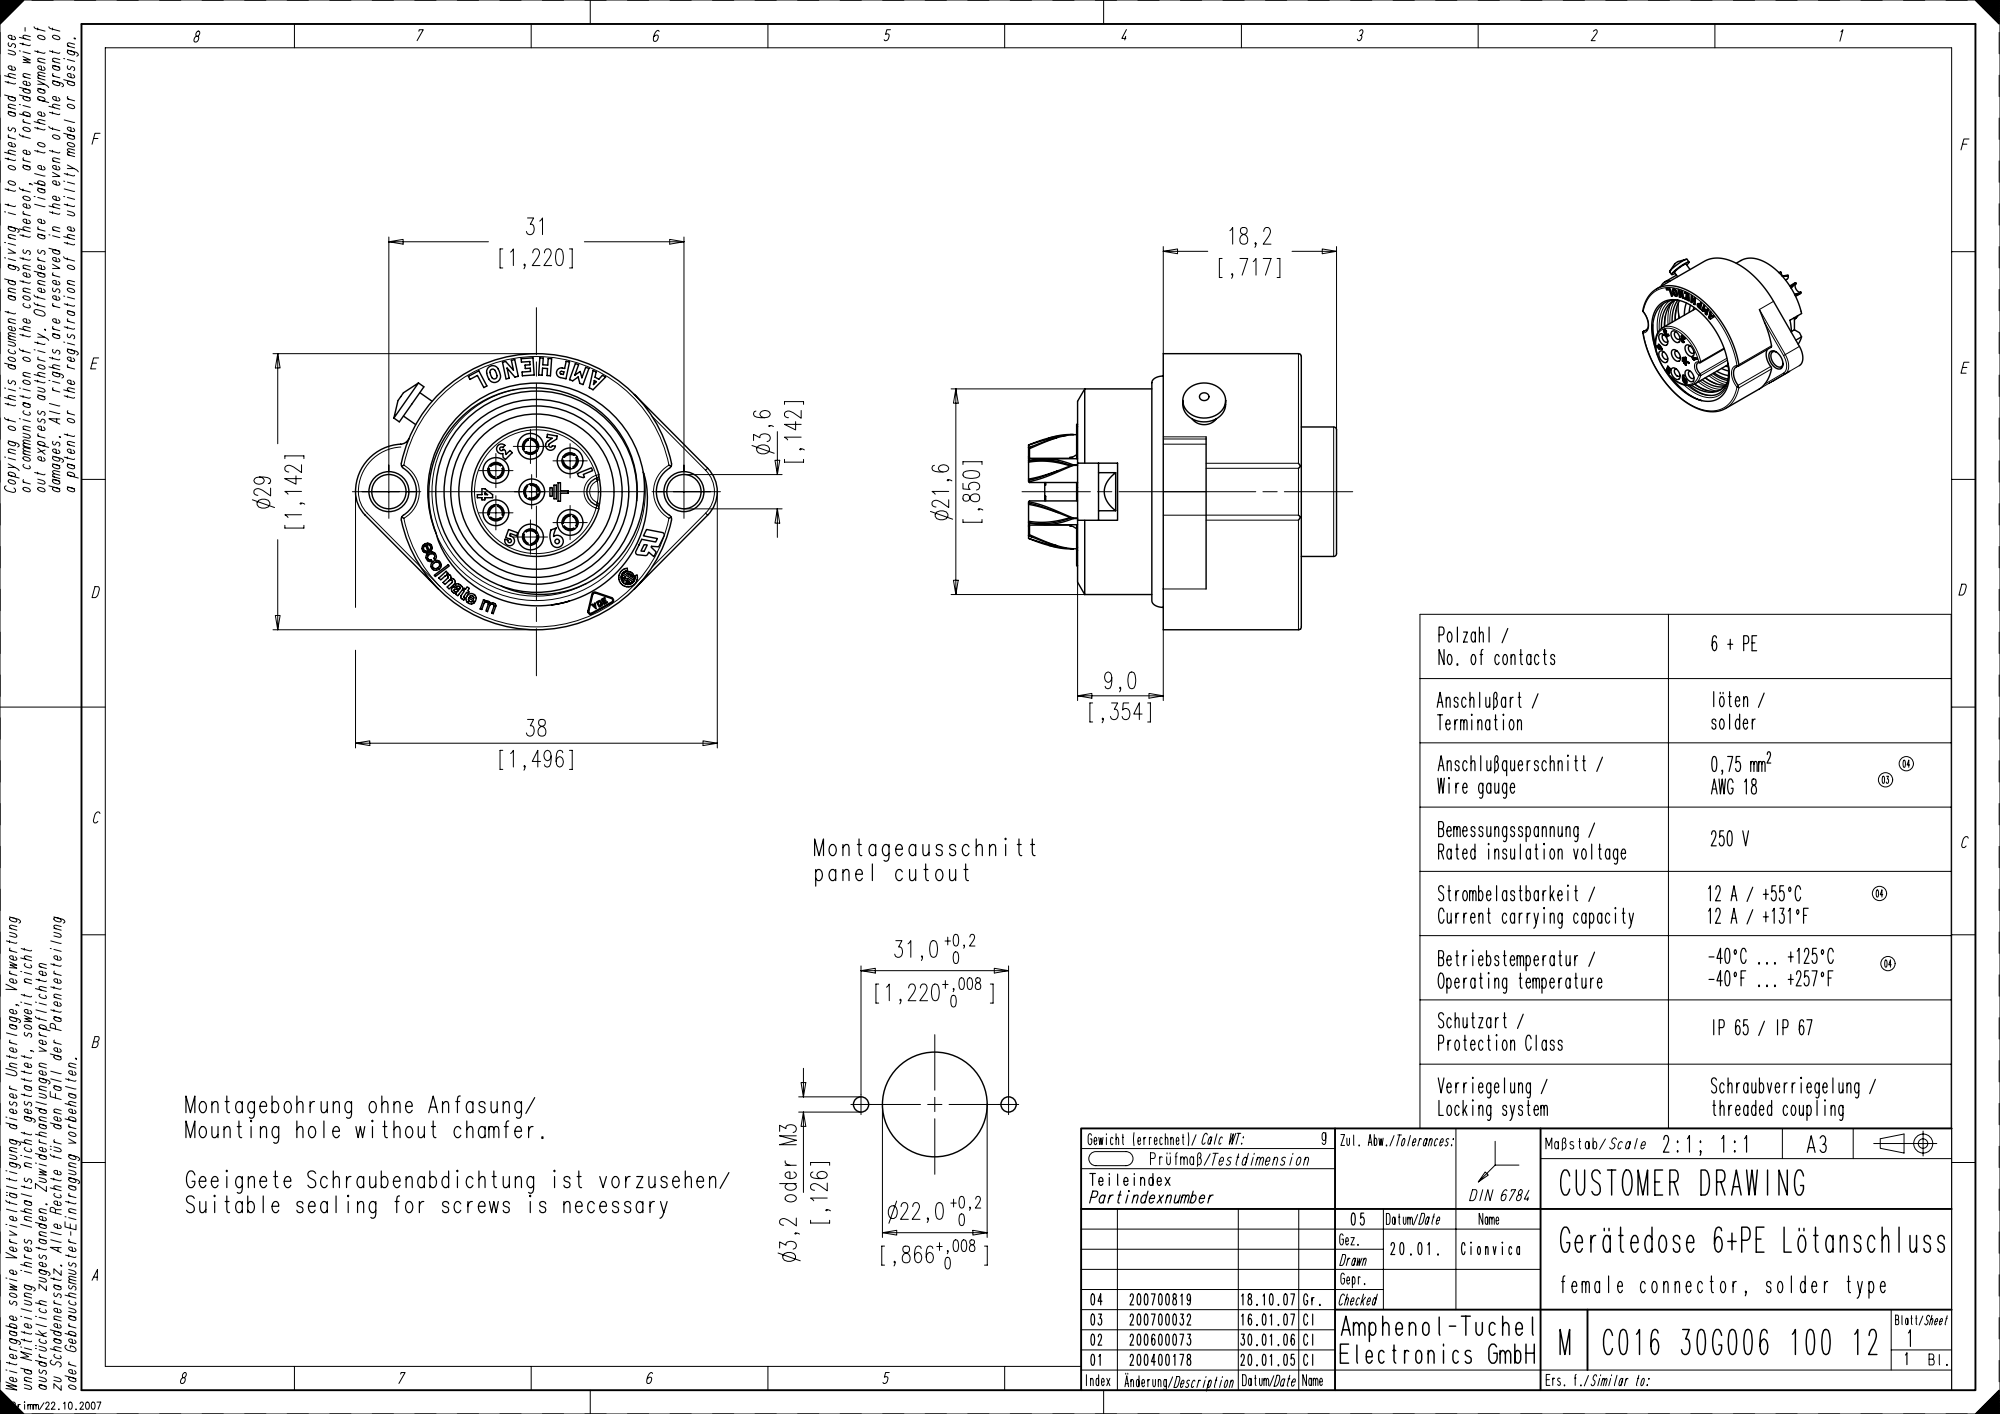
[picture p565: page 1]
