OpenAgricultureFoundation/openag-mechanical/prj/hazelnut_large/LHC-001/1-Documentation/2018-2019 Large Tree Computer - Superceded Designs and Documentation/2018 - MIT Bates Warehouse Floorplan/OC19N_1.pdf

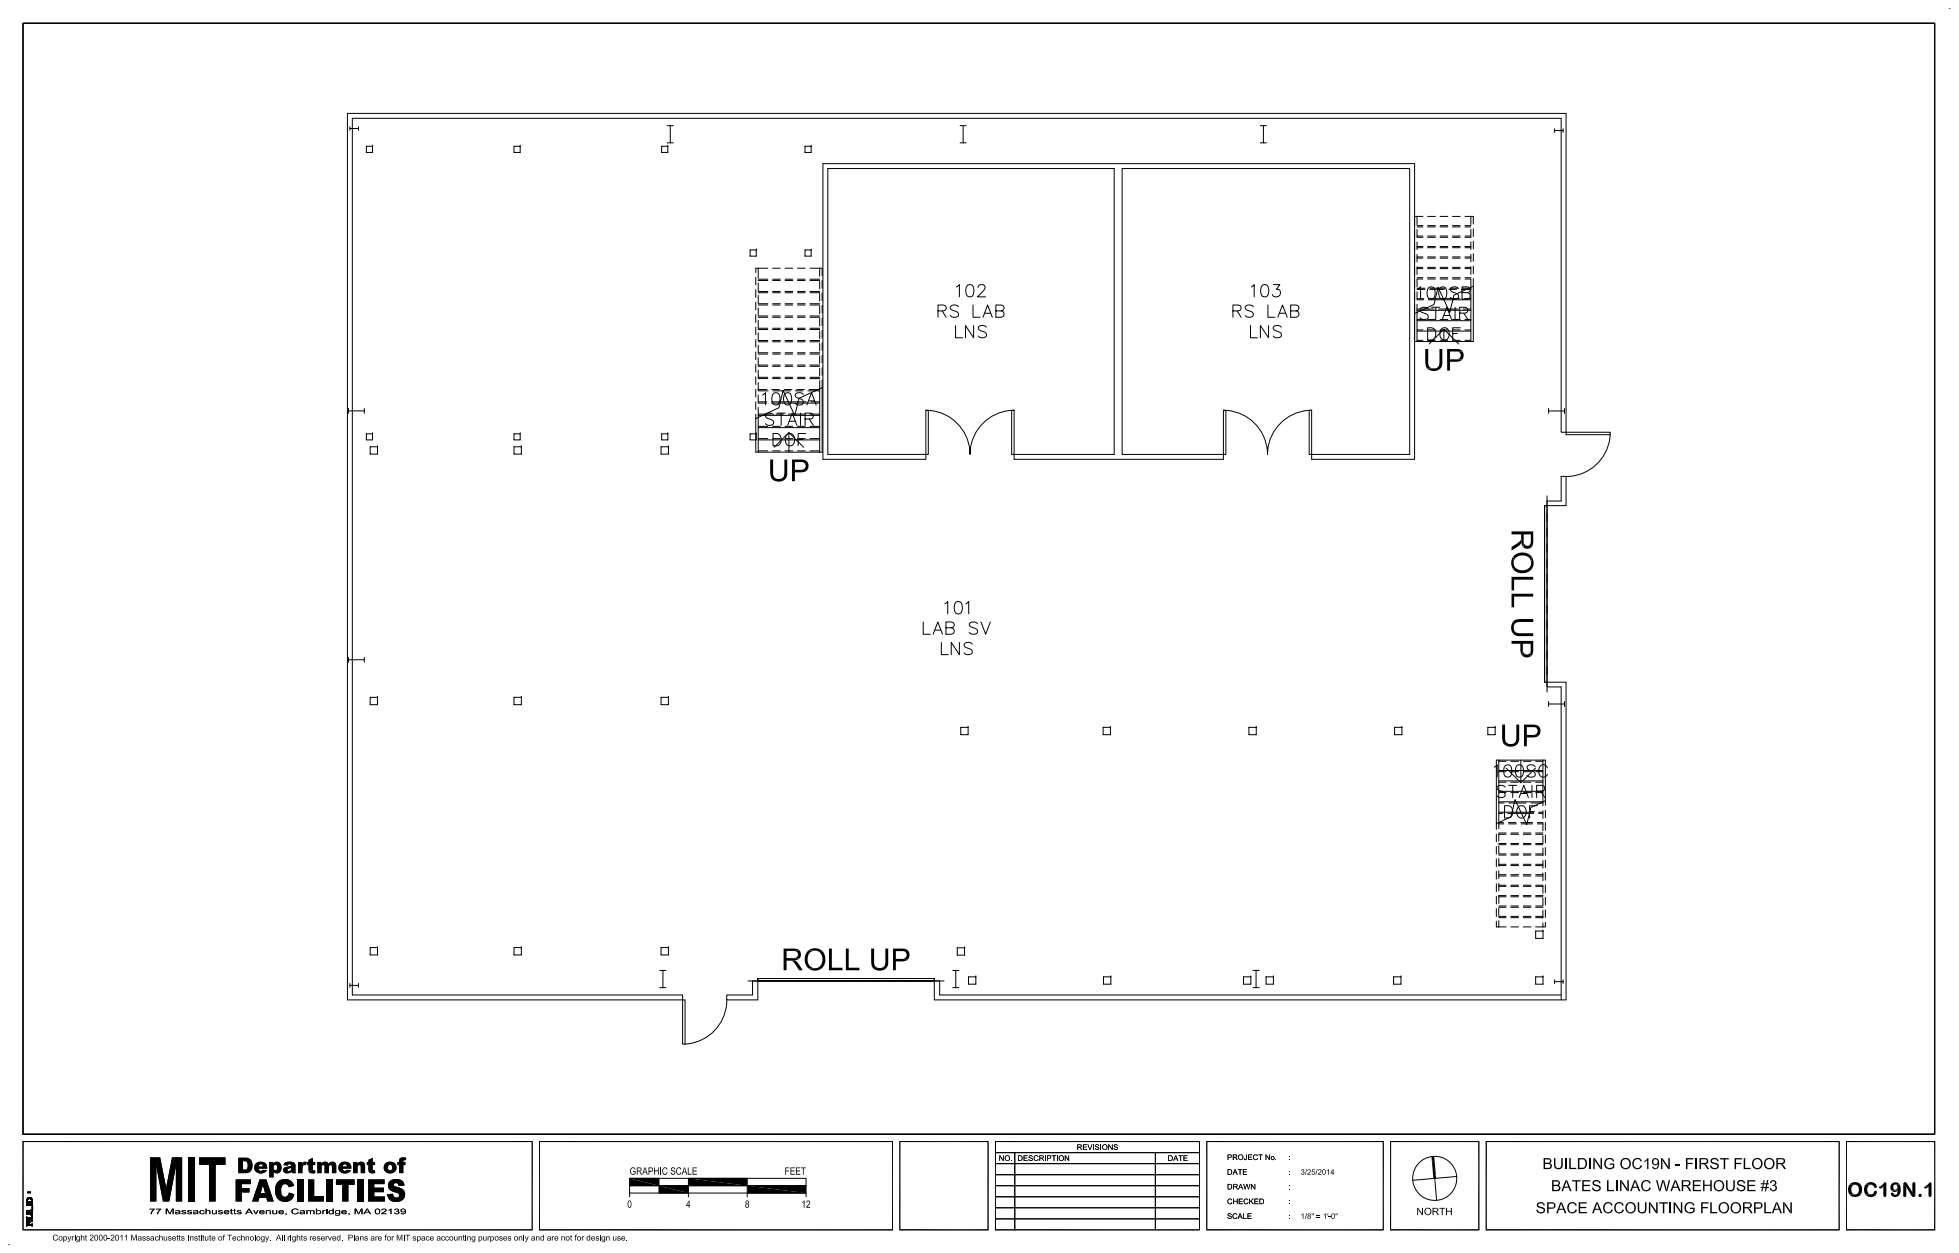
[picture p567: page 1]
