OpenAgricultureFoundation/openag-mechanical/prj/hazelnut_large/LHC-001/1-Documentation/2018-2019 Large Tree Computer - Superceded Designs and Documentation/2018-12-7 Renders for Zander/LHC-201_12-7-18.PDF

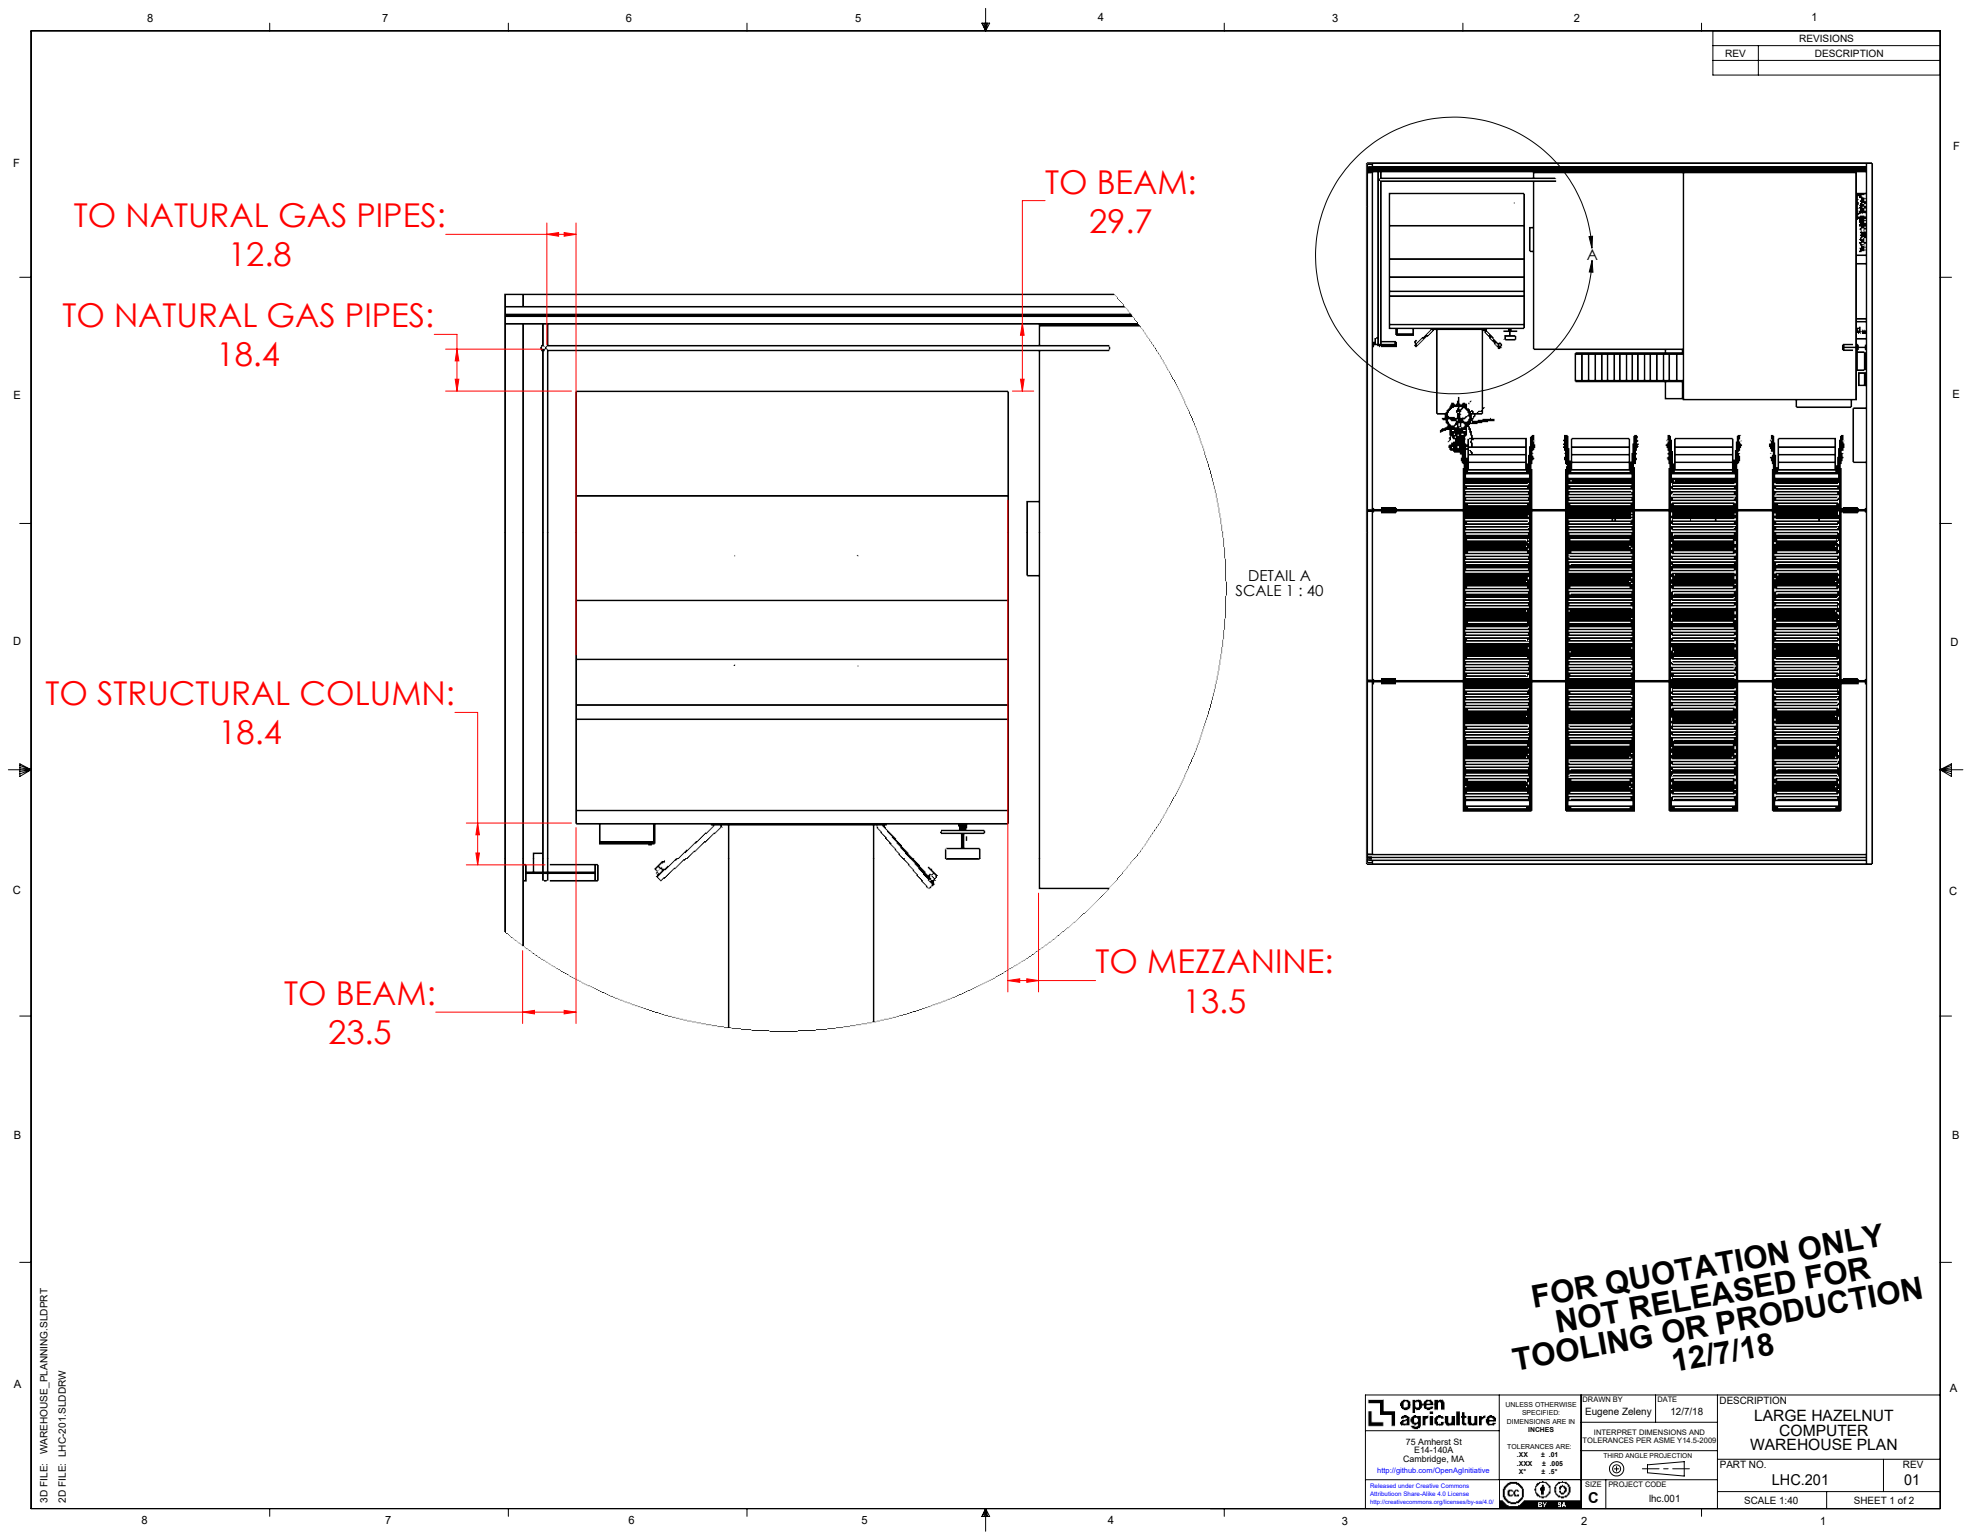
[picture p569: page 1]
TO MEZZANINE:; TO BEAM:; DETAIL A SCALE 1 : 40; 3D FILE: WAREHOUSE_PLANNING.SLDPRT; PART NO.; SCALE 1:40; SHEET 1 of 2; LARGE HAZELNUT WAREHOUSE PLAN; PROJECT CODE; Eugene Zeleny; C lhc.001; DRAWN BY; DATE

TO NATURAL GAS PIPES:

TO STRUCTURAL COLUMN:

FOR QUOTATION ONLY

NOT RELEASED FOR TOOLING OR PRODUCTION 12/7/18

2D FILE: LHC-201.SLDDRW

UNLESS OTHERWISE
SPECIFIED:
DIMENSIONS ARE IN
INCHES
TOLERANCES ARE:
.XXX ± .005

75 Amherst St
Cambridge, MA
http://github.com/OpenAgInitiative

INTERPRET DIMENSIONS AND
TOLERANCES PER ASME Y14.5-2009
THIRD ANGLE PROJECTION

Released under Creative Commons
Attributioon Share-Alike 4.0 License
http://creativecommons.org/licenses/by-sa/4.0/

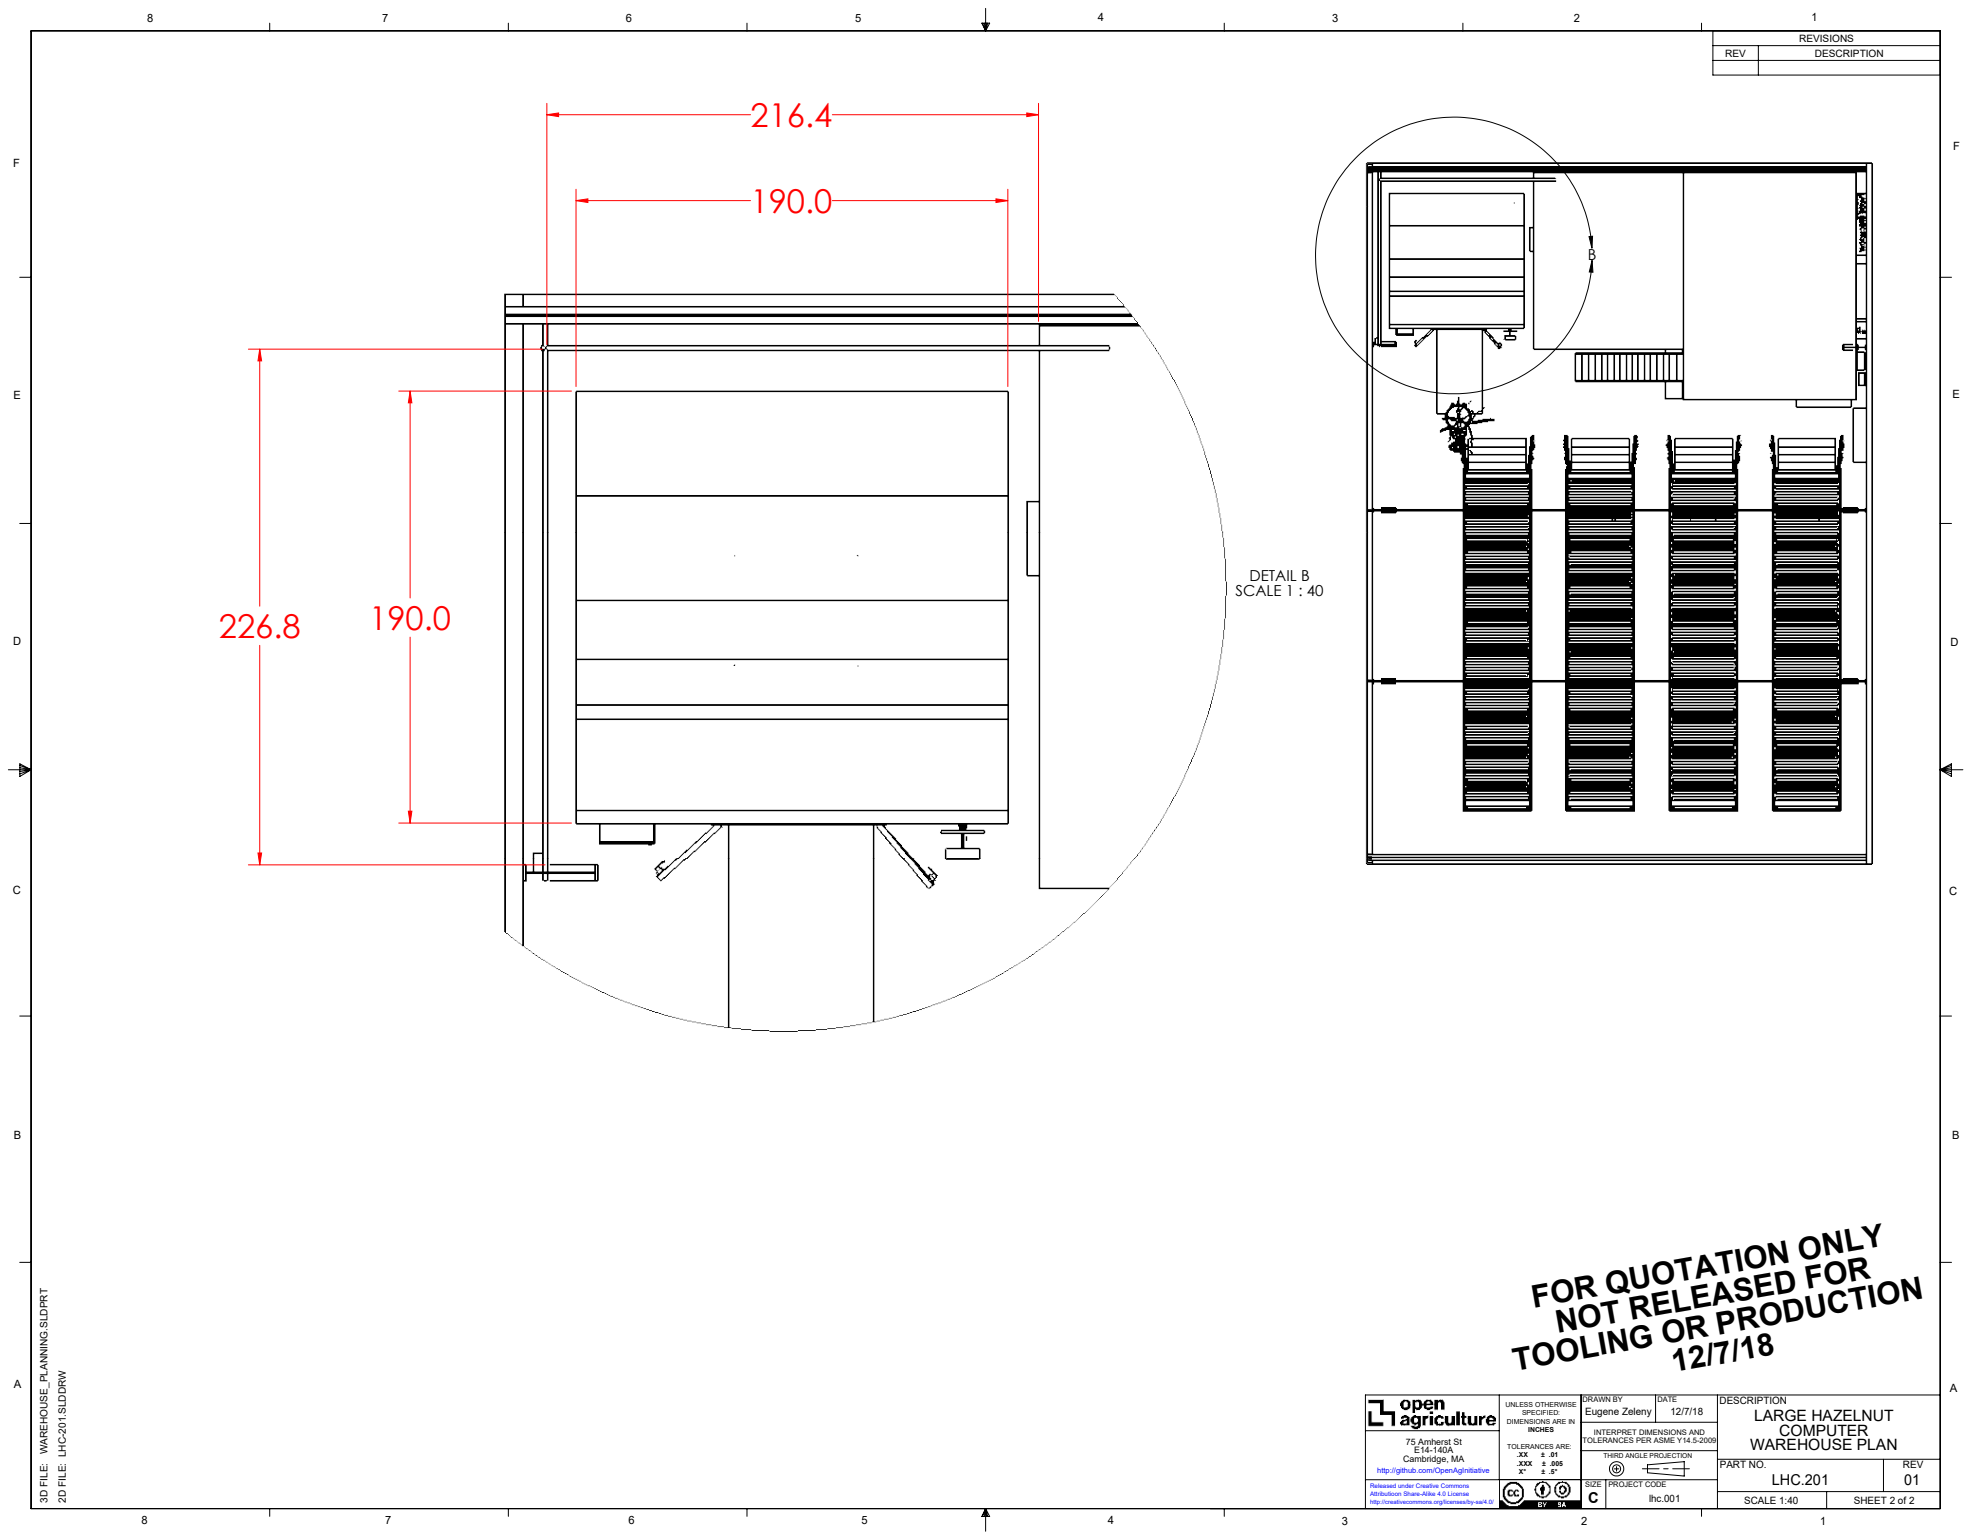
[picture p570: page 2]
DETAIL B SCALE 1 : 40; 3D FILE: WAREHOUSE_PLANNING.SLDPRT; PART NO.; SCALE 1:40; SHEET 2 of 2; LARGE HAZELNUT WAREHOUSE PLAN; PROJECT CODE; Eugene Zeleny; C lhc.001; DRAWN BY; DATE

FOR QUOTATION ONLY

NOT RELEASED FOR TOOLING OR PRODUCTION 12/7/18

2D FILE: LHC-201.SLDDRW

UNLESS OTHERWISE
SPECIFIED:
DIMENSIONS ARE IN
INCHES
TOLERANCES ARE:
.XXX ± .005

75 Amherst St
Cambridge, MA
http://github.com/OpenAgInitiative

INTERPRET DIMENSIONS AND
TOLERANCES PER ASME Y14.5-2009
THIRD ANGLE PROJECTION

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
