OpenAgricultureFoundation/openag-mechanical/prj/hazelnut_large/LHC-001/1-Documentation/2018-2019 Large Tree Computer - Superceded Designs and Documentation/2018-12-7 Renders for Zander/LHC-201_PANELS_12-7-18.PDF

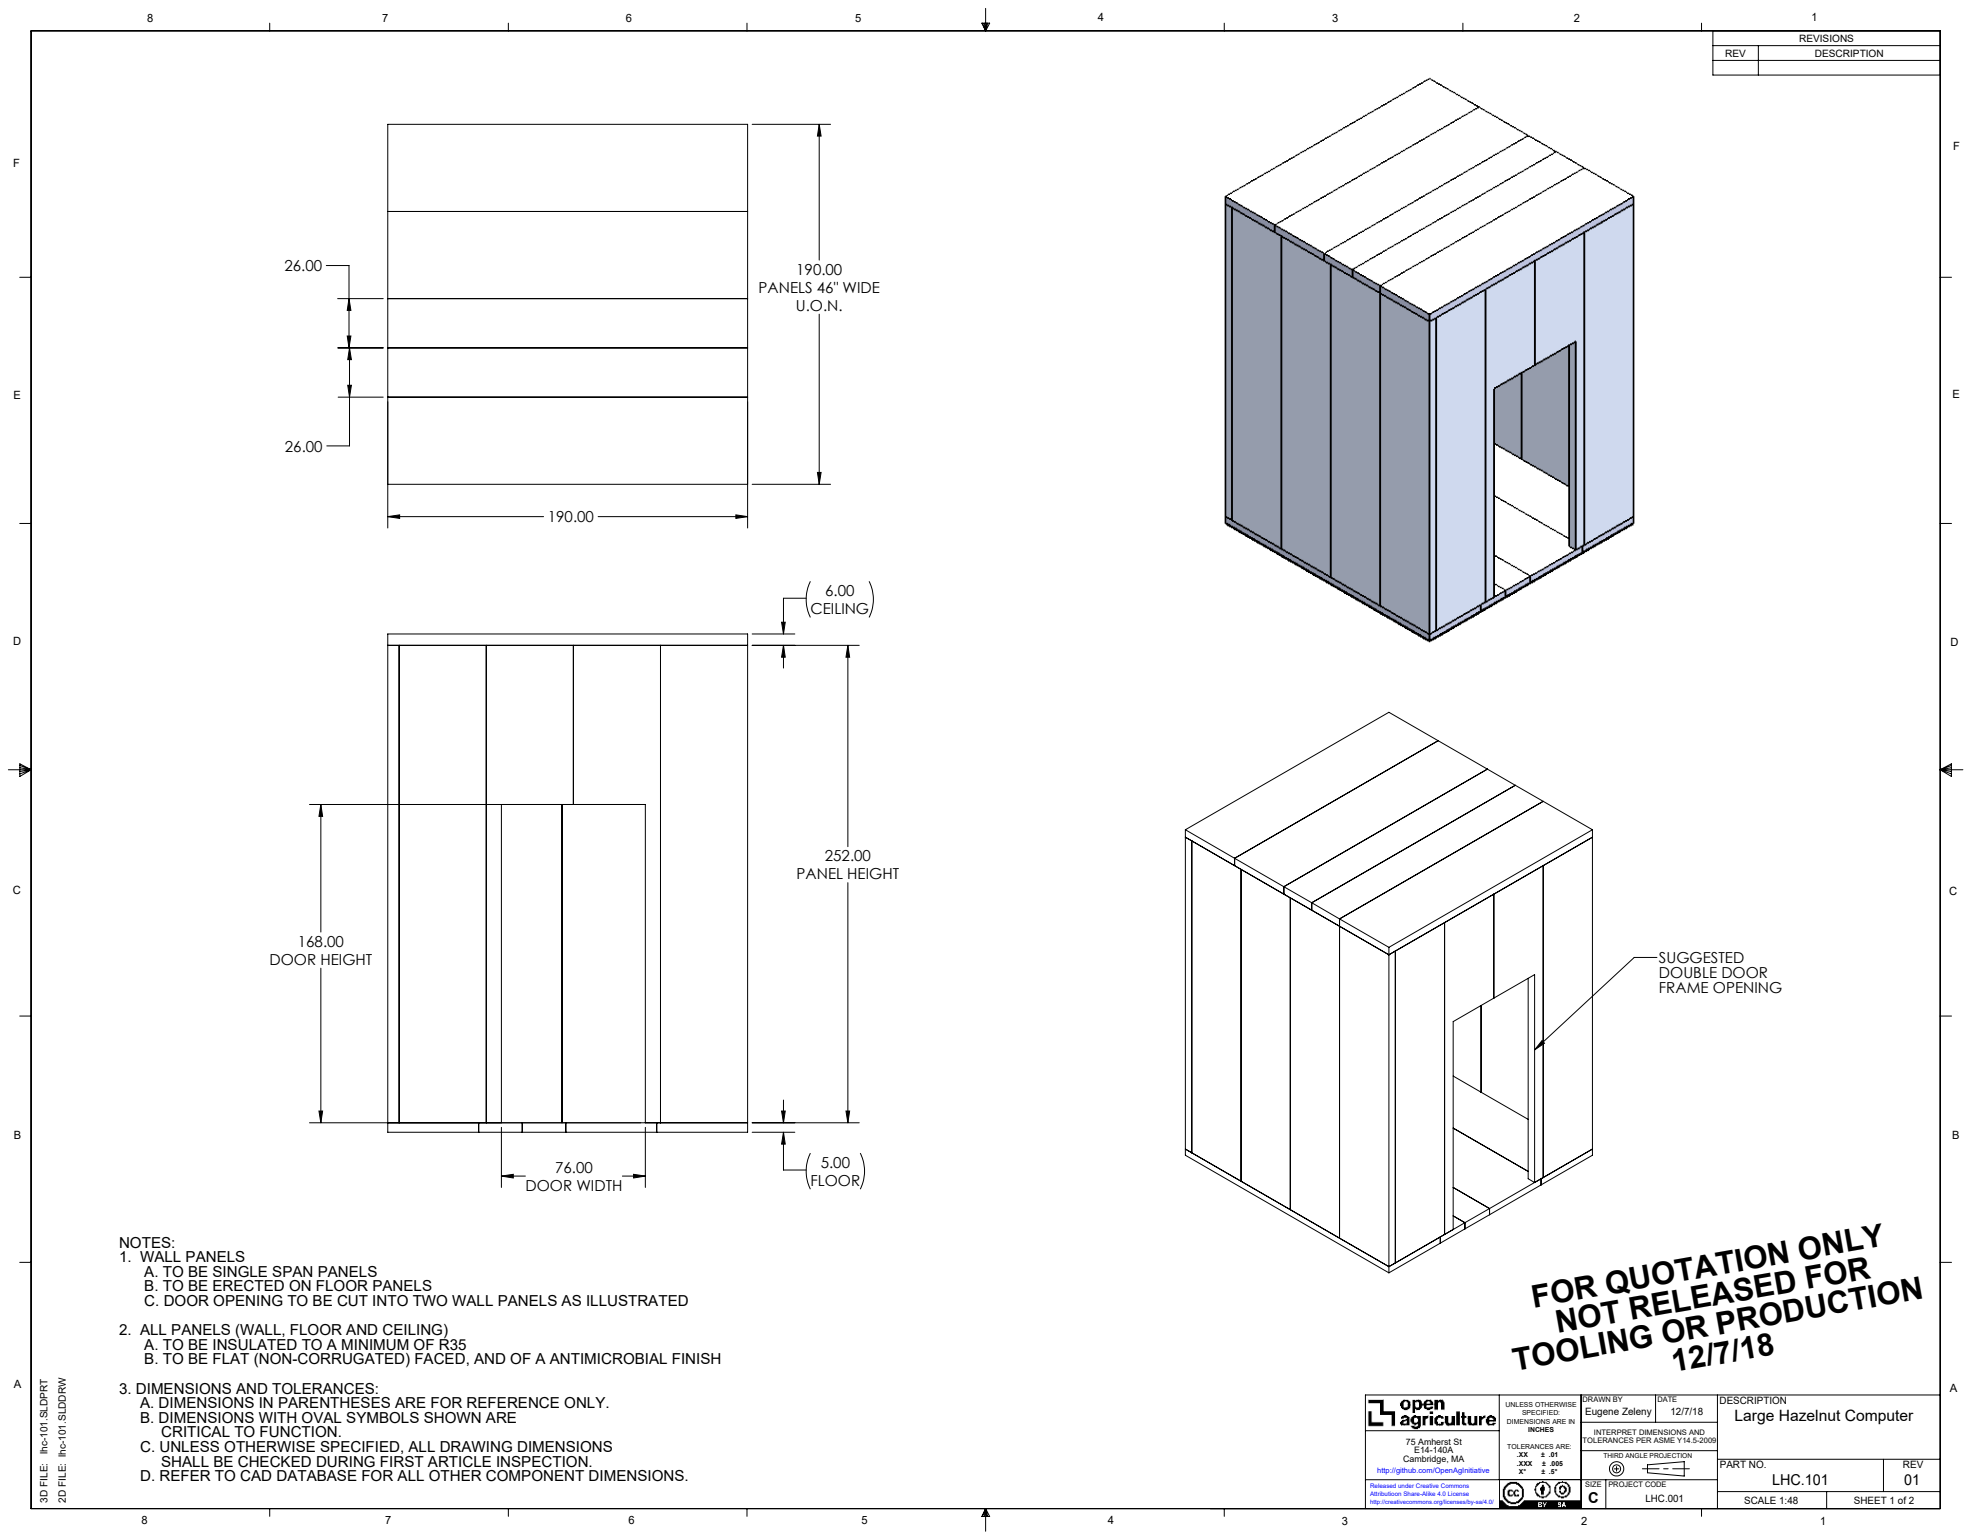
[picture p571: page 1]
DOUBLE DOOR FRAME OPENING; PANEL HEIGHT; DOOR HEIGHT; DOOR WIDTH; PANELS 46" WIDE; PART NO.; SCALE 1:48; SHEET 1 of 2; PROJECT CODE; Eugene Zeleny; C LHC.001; DRAWN BY; DATE

FOR QUOTATION ONLY

NOTES:
1. WALL PANELS
A. TO BE SINGLE SPAN PANELS
B. TO BE ERECTED ON FLOOR PANELS
C. DOOR OPENING TO BE CUT INTO TWO WALL PANELS AS ILLUSTRATED
2. ALL PANELS (WALL, FLOOR AND CEILING)
A. TO BE INSULATED TO A MINIMUM OF R35
B. TO BE FLAT (NON-CORRUGATED) FACED, AND OF A ANTIMICROBIAL FINISH
3. DIMENSIONS AND TOLERANCES:
A. DIMENSIONS IN PARENTHESES ARE FOR REFERENCE ONLY.
B. DIMENSIONS WITH OVAL SYMBOLS SHOWN ARE
CRITICAL TO FUNCTION.
C. UNLESS OTHERWISE SPECIFIED, ALL DRAWING DIMENSIONS
SHALL BE CHECKED DURING FIRST ARTICLE INSPECTION.
D. REFER TO CAD DATABASE FOR ALL OTHER COMPONENT DIMENSIONS.

NOT RELEASED FOR TOOLING OR PRODUCTION 12/7/18

3D FILE: lhc-101.SLDPRT

2D FILE: lhc-101.SLDDRW

DESCRIPTION
Large Hazelnut Computer

UNLESS OTHERWISE
SPECIFIED:
DIMENSIONS ARE IN
INCHES
TOLERANCES ARE:
.XXX ± .005

75 Amherst St
Cambridge, MA
http://github.com/OpenAgInitiative

INTERPRET DIMENSIONS AND
TOLERANCES PER ASME Y14.5-2009
THIRD ANGLE PROJECTION

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
