OpenAgricultureFoundation/openag-mechanical/prj/hazelnut_large/LHC-001/1-Documentation/2018-2019 Large Tree Computer - Superceded Designs and Documentation/2018-12-7 Renders for Zander/LHC-201_RAMP_12-7-18.PDF

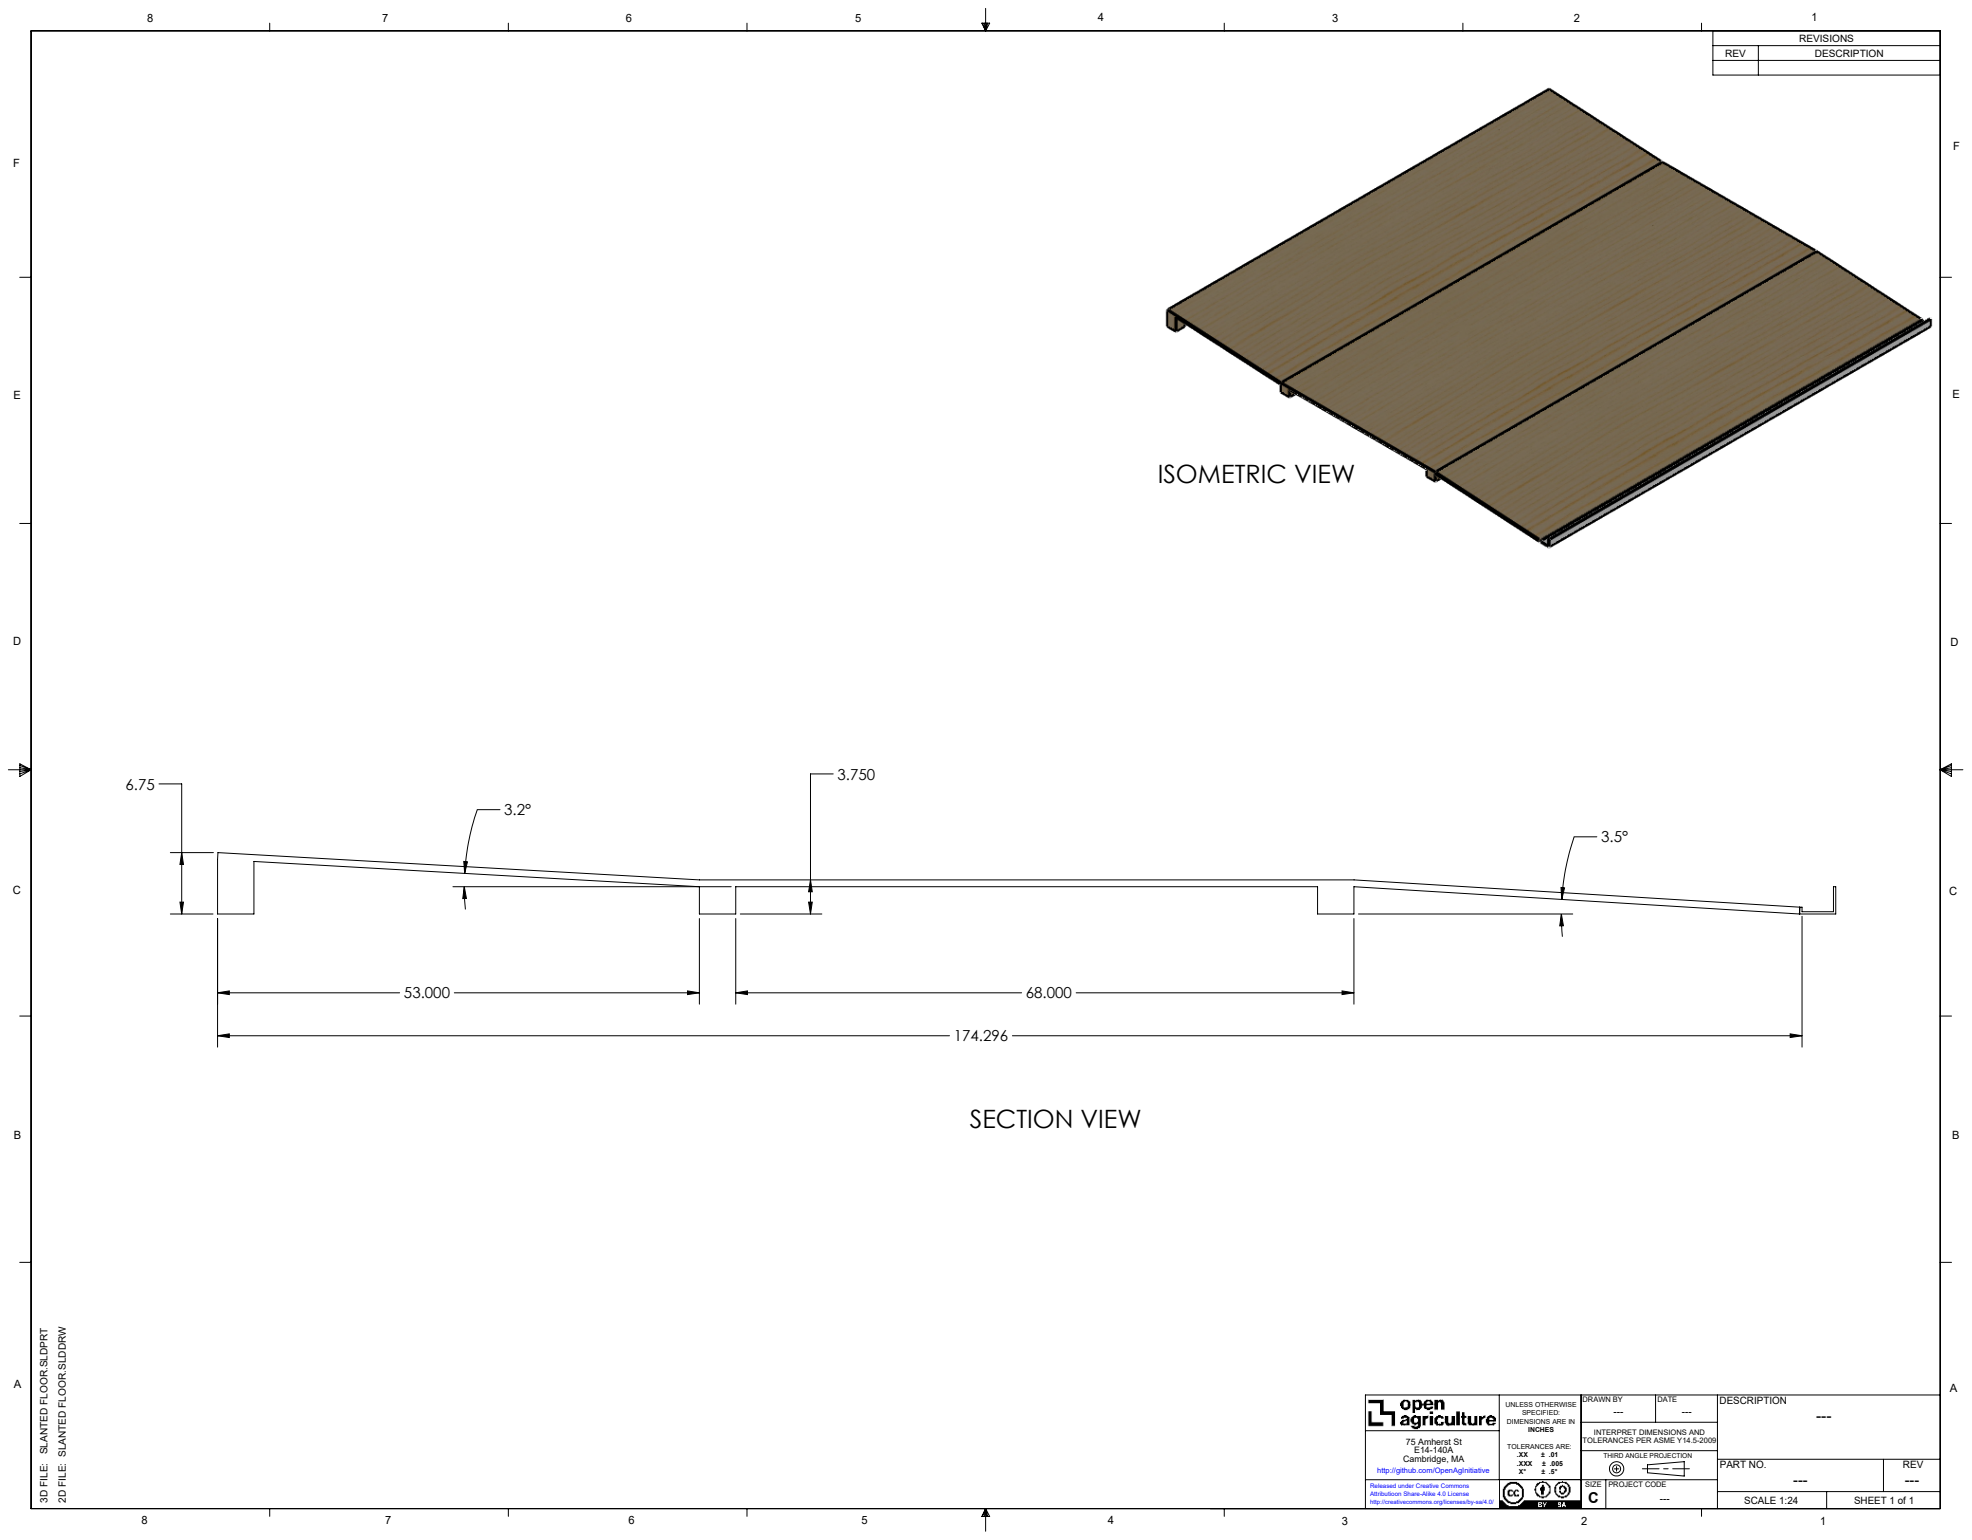
[picture p572: page 1]
ISOMETRIC VIEW; SECTION VIEW; PART NO.; SCALE 1:24; SHEET 1 of 1; PROJECT CODE C ---; DRAWN BY; DATE

3D FILE: SLANTED FLOOR.SLDPRT

2D FILE: SLANTED FLOOR.SLDDRW

--- INTERPRET DIMENSIONS AND

UNLESS OTHERWISE
SPECIFIED:
DIMENSIONS ARE IN
INCHES
TOLERANCES ARE:
.XXX ± .005

75 Amherst St
Cambridge, MA
http://github.com/OpenAgInitiative

TOLERANCES PER ASME Y14.5-2009
THIRD ANGLE PROJECTION

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
