OpenAgricultureFoundation/openag-mechanical/prj/hazelnut_large/LHC-001/3-Specification Sheets/optics/optics_mech/pl1825sr_technical_detail.pdf

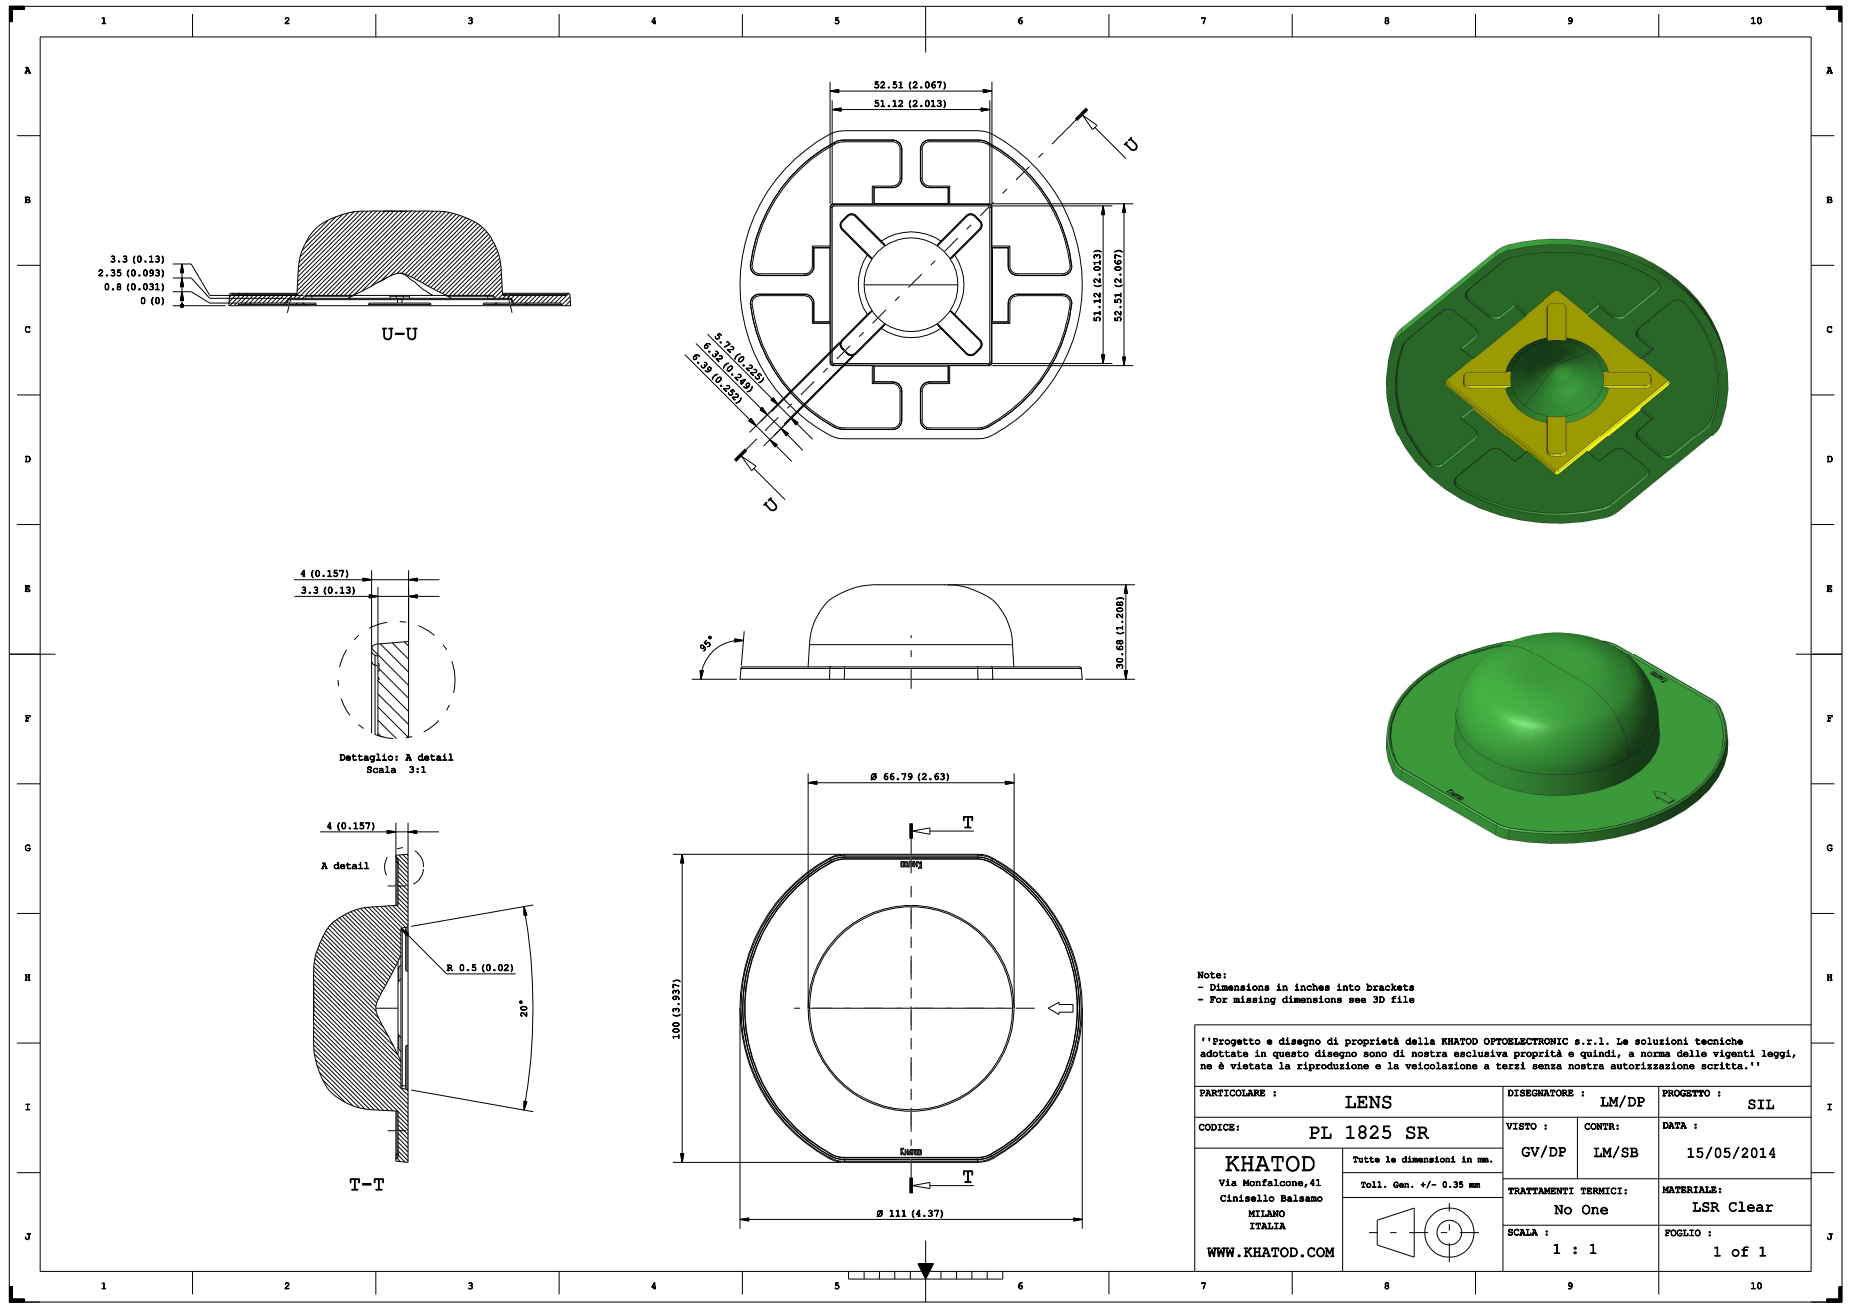
[picture p573: page 1]
