OpenAgricultureFoundation/openag-mechanical/prj/hazelnut_large/LHC-001/3-Specification Sheets/optics/optics_mech/pl1845sr_technical_detail.pdf

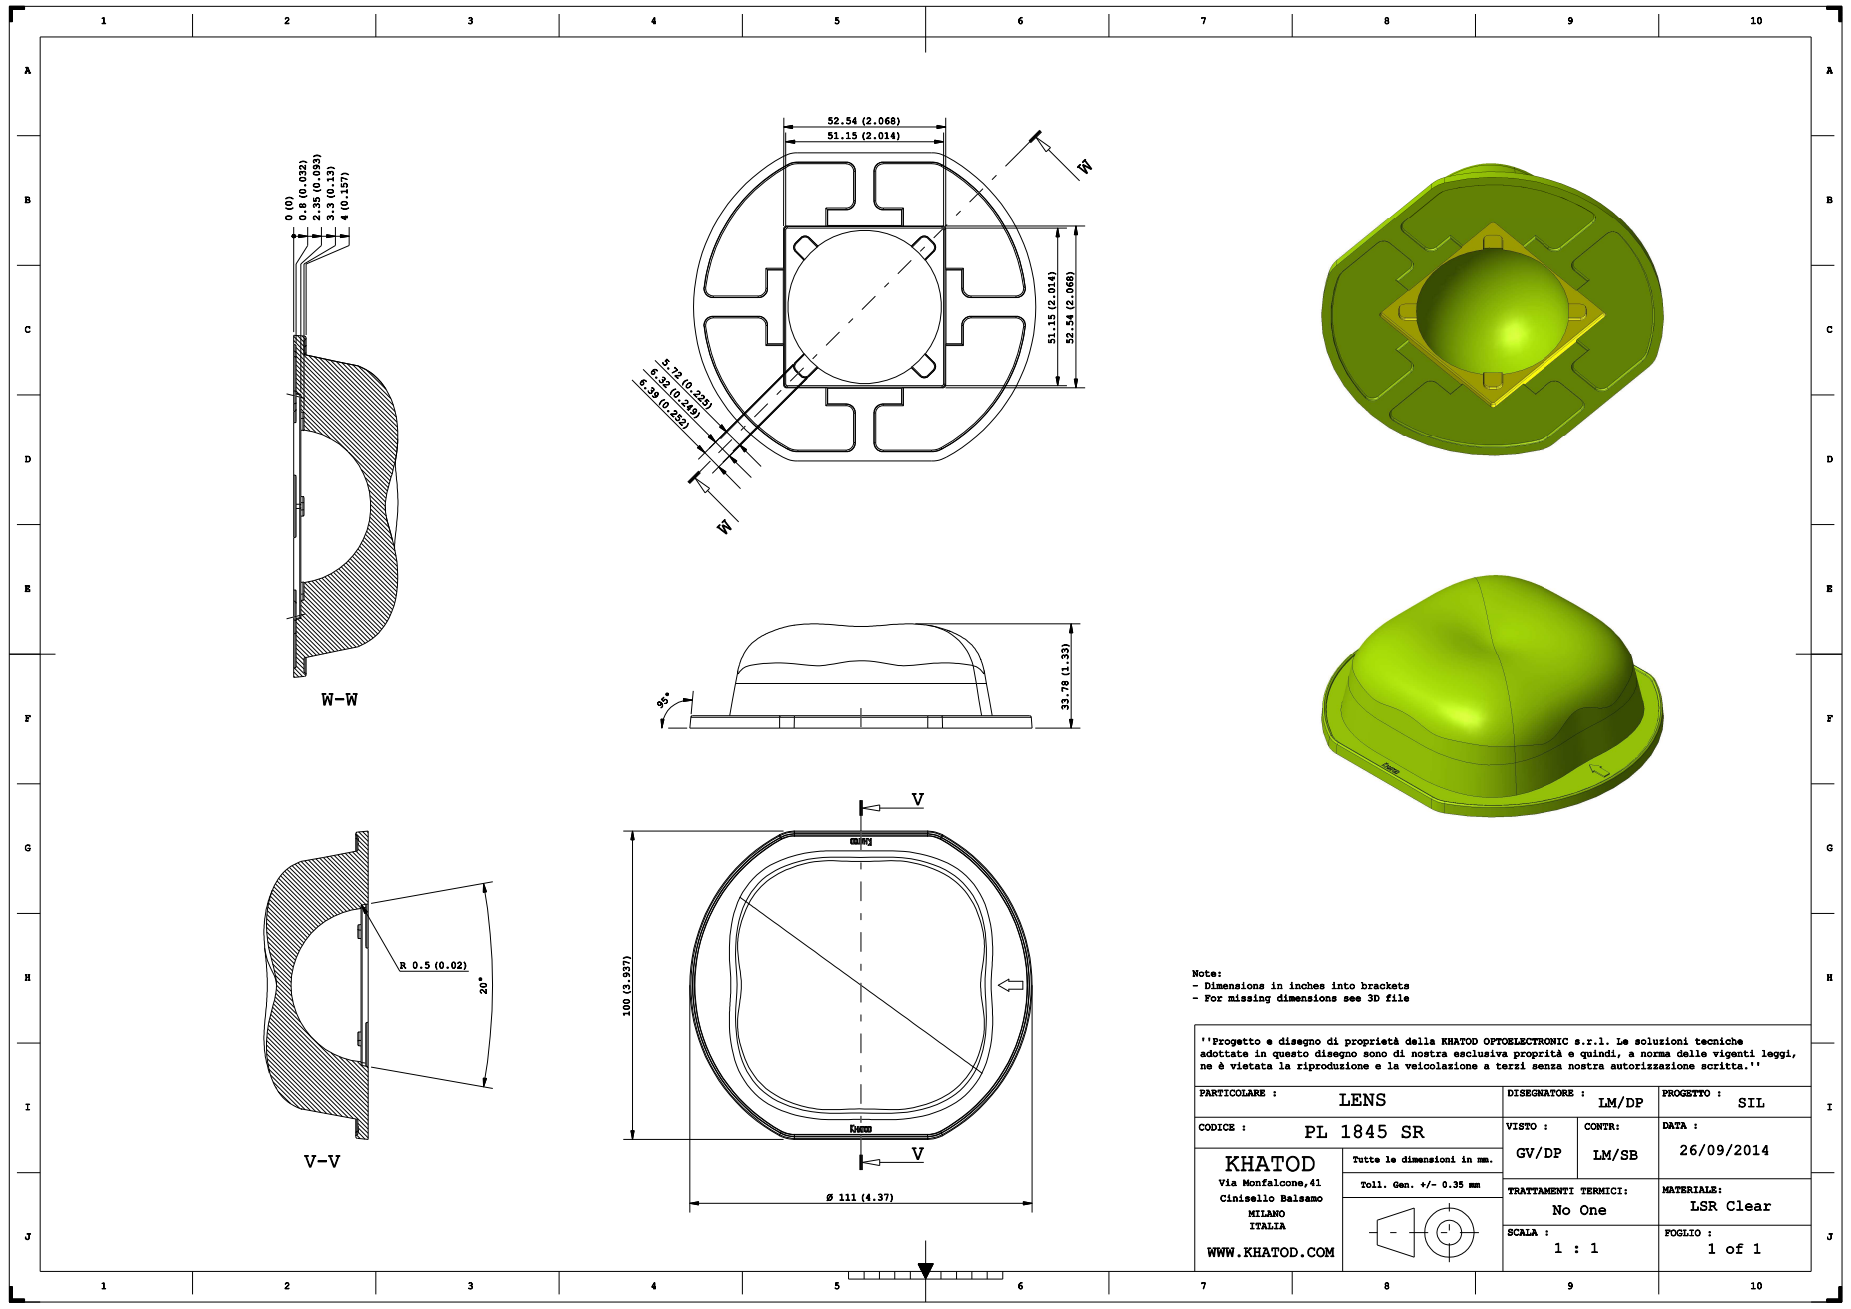
[picture p574: page 1]
