OpenAgricultureFoundation/openag-mechanical/incoming/5-29-18 BZ Metalworks/Quote.17937pdf.pdf

## Quote

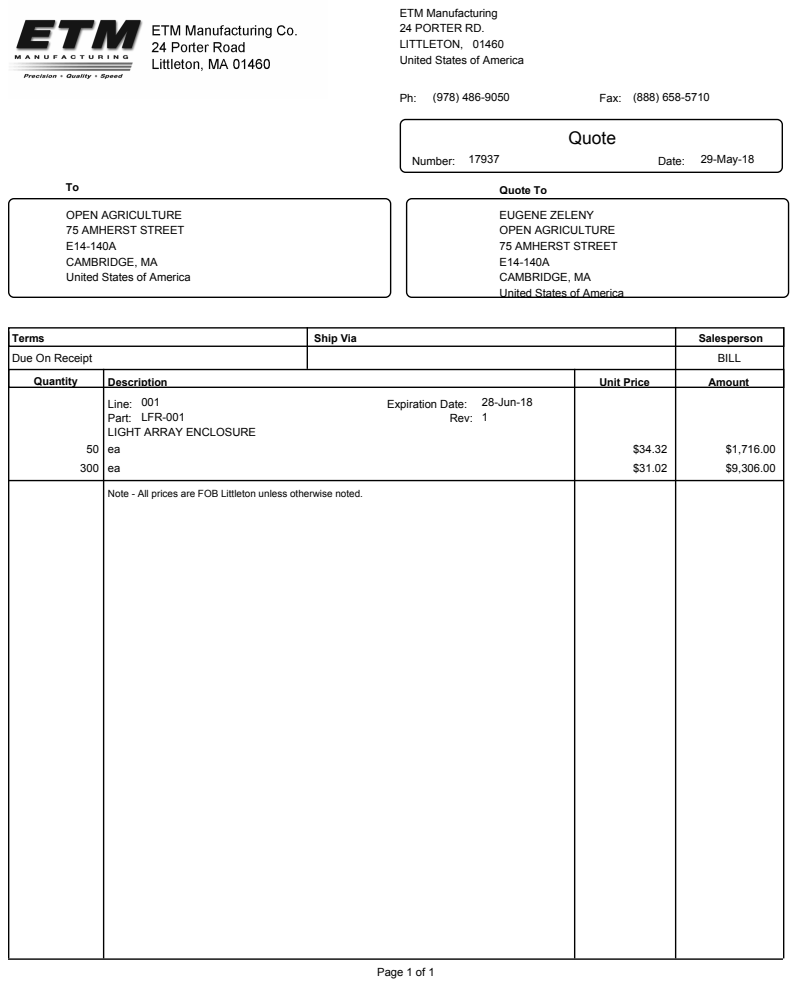
[picture p577: page 1]
Number:; Date:; Quote To; Fax: (888) 658-5710; 29-May-18; Page 1 of 1

ETM Manufacturing
24 PORTER RD.
LITTLETON, 01460
United States of America

OPEN AGRICULTURE
75 AMHERST STREET
CAMBRIDGE, MA

EUGENE ZELENY

Terms | Ship Via | Salesperson
Due On Receipt | | BILL

Quantity | Description | Unit Price | Amount

50 300 | Line: 001 Expiration Date: 28-Jun-18 Part: LFR-001 Rev: 1 LIGHT ARRAY ENCLOSURE ea ea | $34.32 $31.02 | $1,716.00 $9,306.00

Note - All prices are FOB Littleton unless otherwise noted.
