OpenAgricultureFoundation/openag-mechanical/prj/fs-waterbot/v1.0/dosatron.PDF

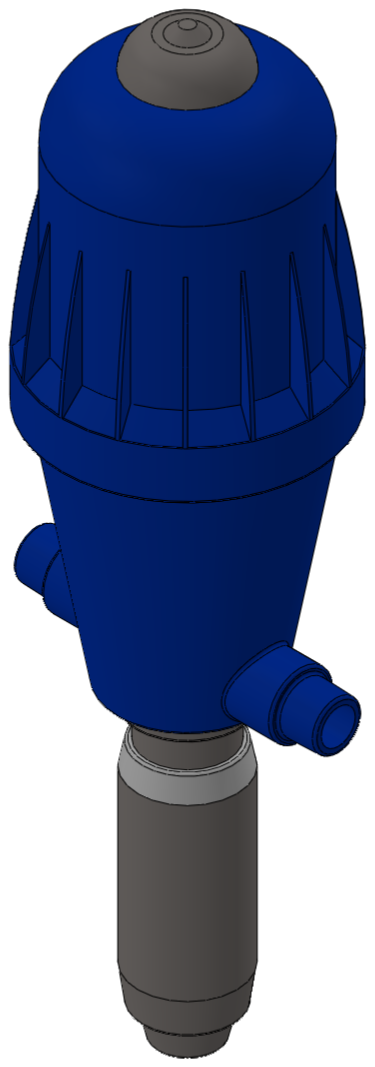
[picture p578: page 1]
