OpenAgricultureFoundation/openag-mechanical/prj/hazelnut_large/LHC-001/LHC-200/LHC-201_Strut_Planning_Package.pdf

| REVISIONS
REV | DESCRIPTION

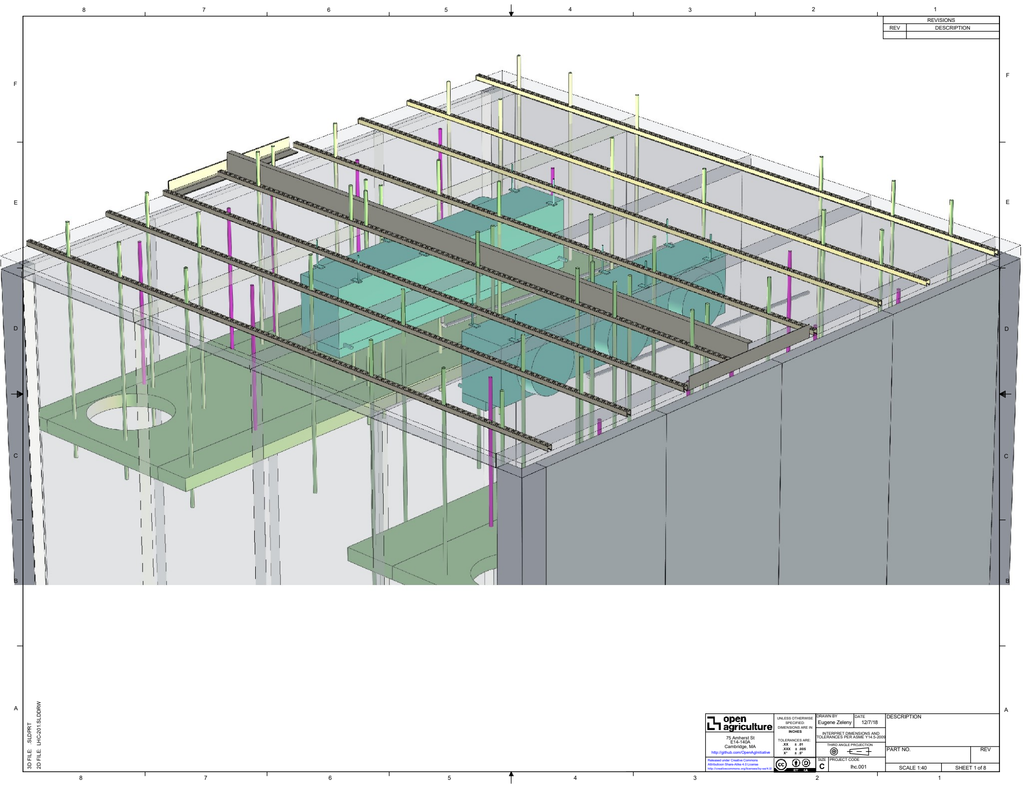
[picture p579: page 1]
SIZE 2D FILE: LHC⁻²⁰¹.SLDDRW; PART NO.; DESCRIPTION; Eugene Zeleny; DRAWN BY; DATE; INCHES 3D FILE: .SLDPRT; TOLERANCES ARE:; .XXX

UNLESS OTHERWISE
SPECIFIED:
DIMENSIONS ARE IN

75 Amherst St
Cambridge, MA
http://github.com/OpenAgInitiative

INTERPRET DIMENSIONS AND
TOLERANCES PER ASME Y14.5-2009

THIRD ANGLE PROJECTION

REV

Released under Creative Commons Attributioon Share-Alike 4.0 License http://creativecommons.org/licenses/by-sa/4.0/ | C | PROJECT CODE lhc.001

SCALE 1:40 | SHEET 1 of 8

5

"

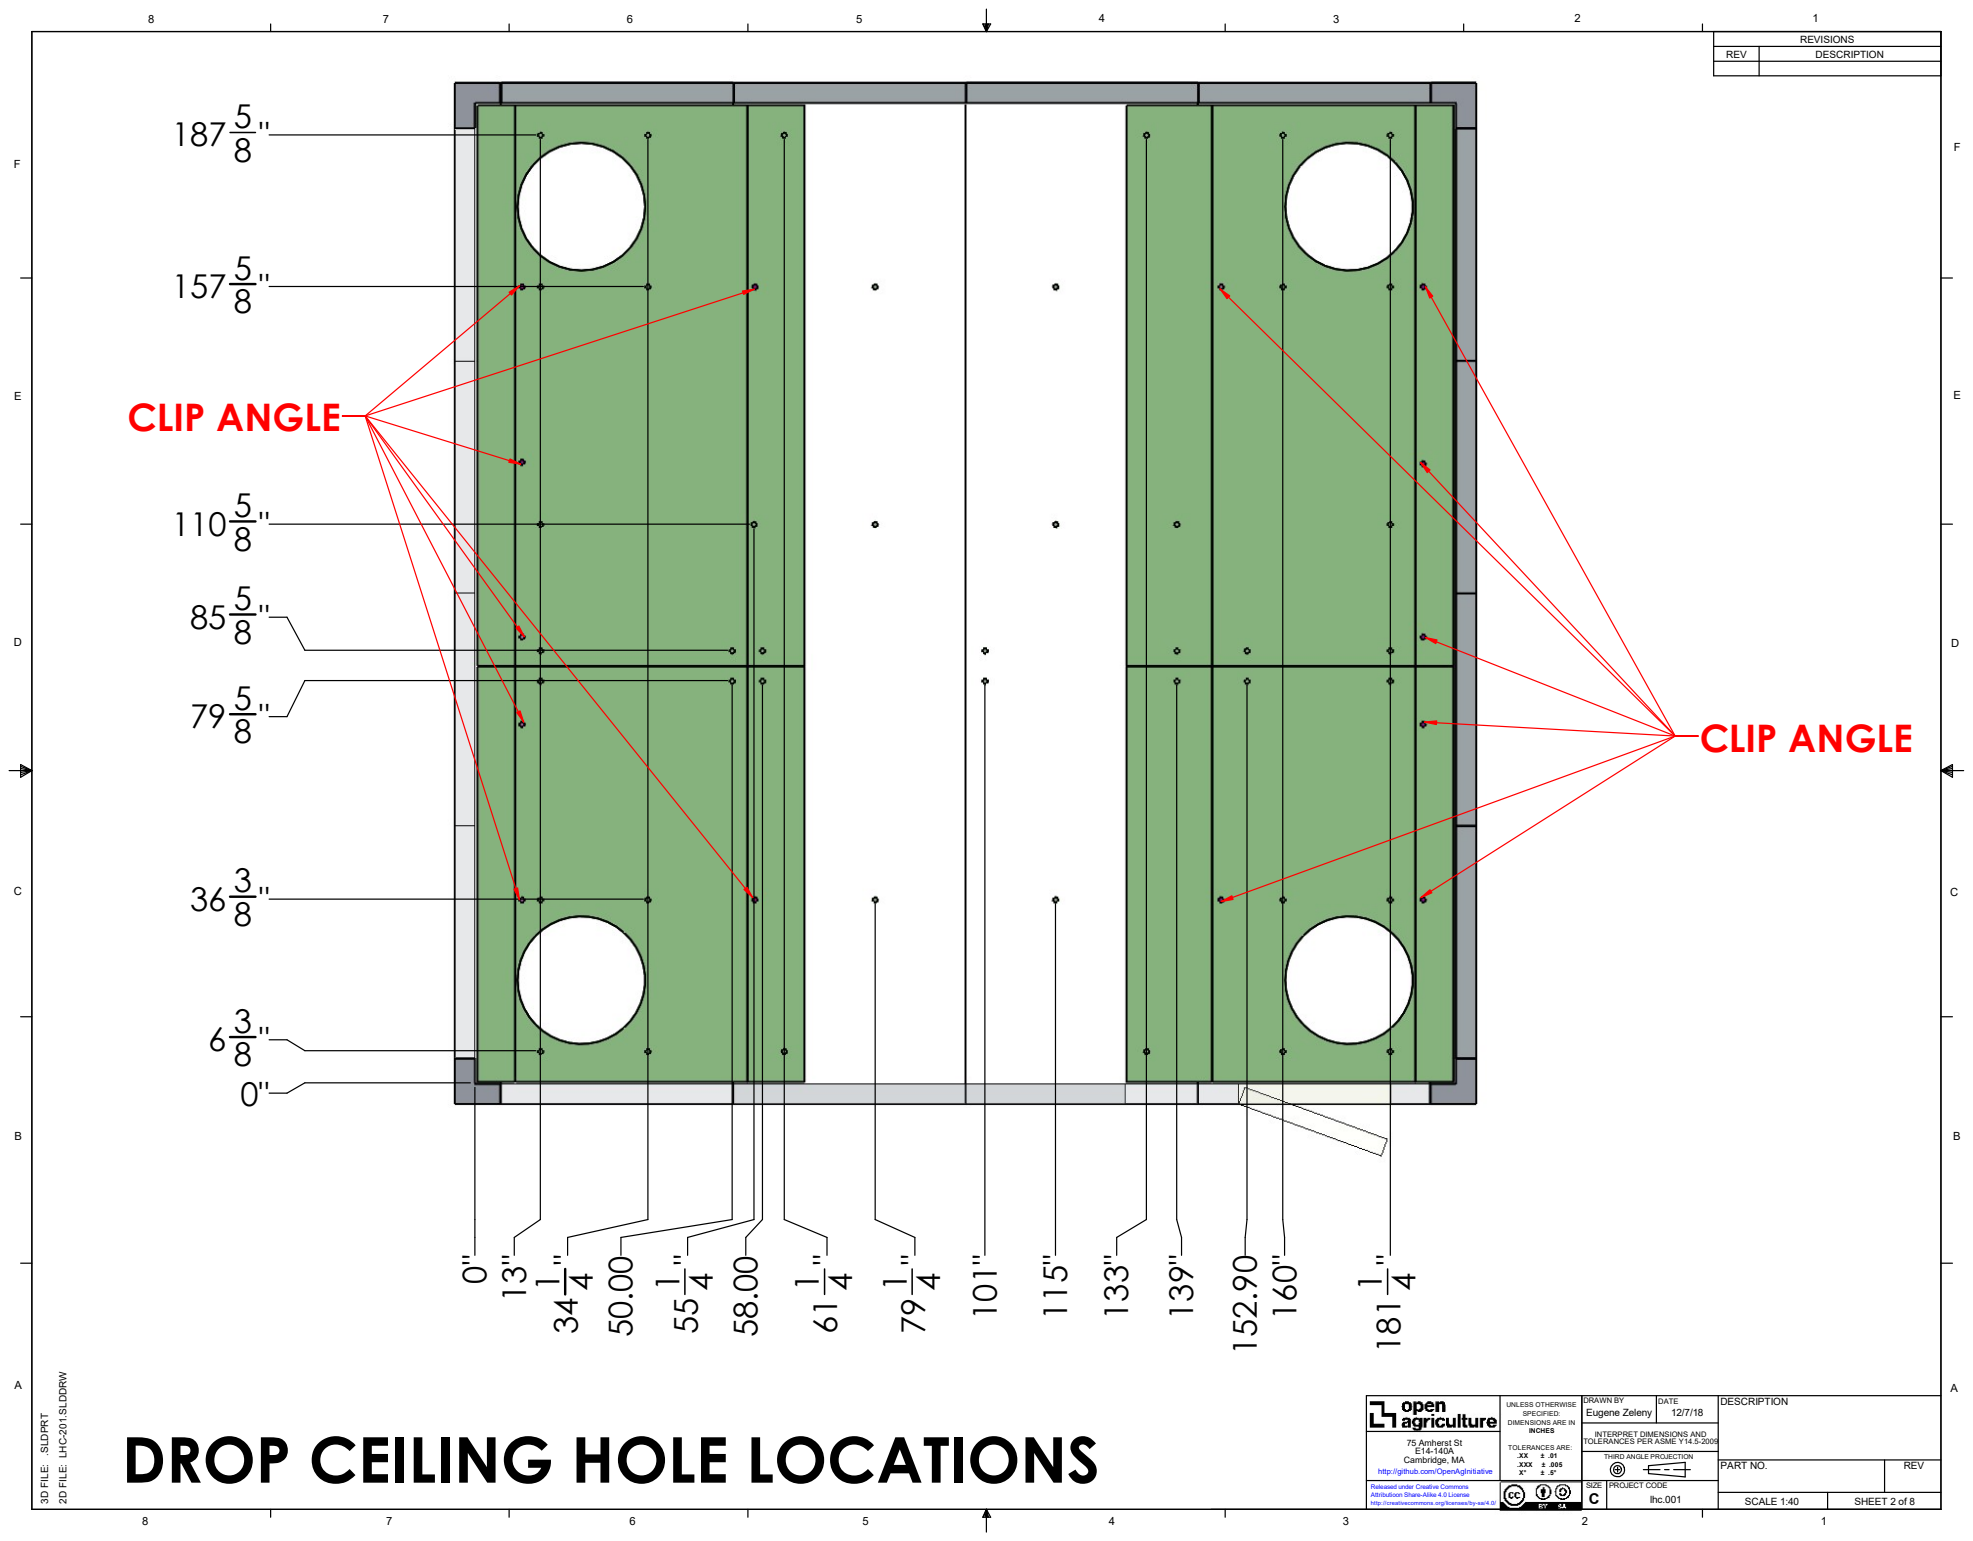
[picture p580: page 2]
INCHES; 75 Amherst St 2D FILE: LHC⁻²⁰¹.SLDDRW; PART NO.; DESCRIPTION; UNLESS OTHERWISE; DRAWN BY; DATE; INTERPRET DIMENSIONS AND 3D FILE: .SLDPRT; Cambridge, MA; TOLERANCES ARE:; CLIP ANGLE

DROP CEILING HOLE LOCATIONS

SIZE | lhc.001

SHEET 2 of 8

161 5
8

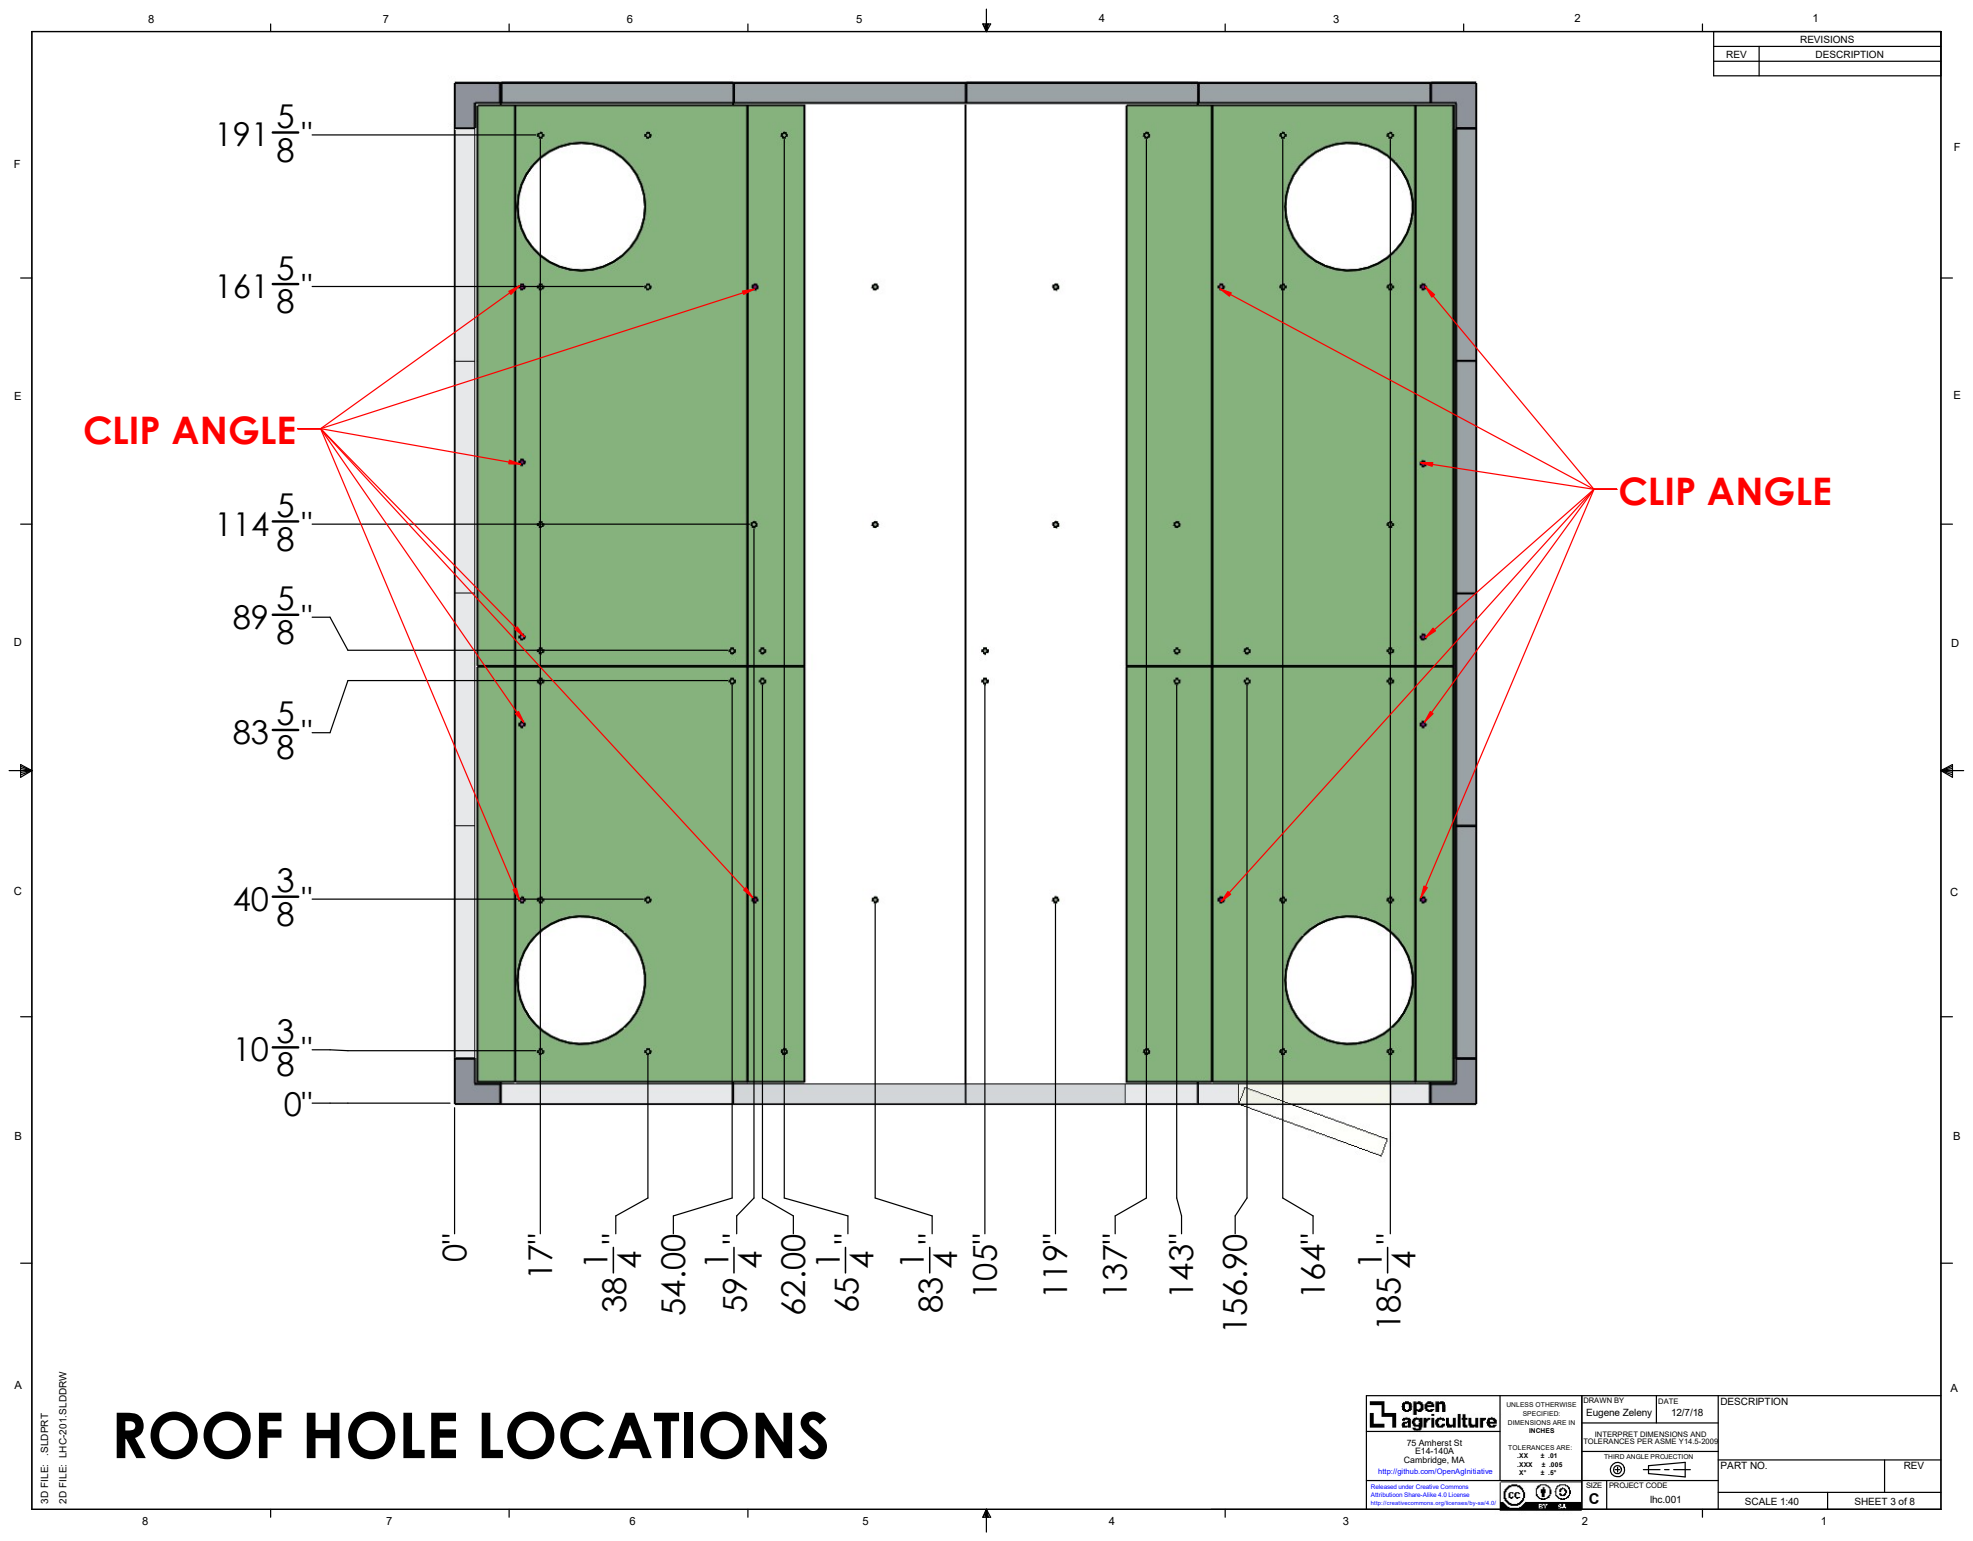
[picture p581: page 3]
ROOF HOLE LOCATIONS; http://github.com/OpenAgInitiative; INCHES 2D FILE: LHC⁻²⁰¹.SLDDRW; PART NO.; DESCRIPTION; UNLESS OTHERWISE; DRAWN BY; DATE; CLIP ANGLE

http://creativecommons.org/licenses/by-sa/4.0/ | lhc.001

SHEET 3 of 8

1 62

F

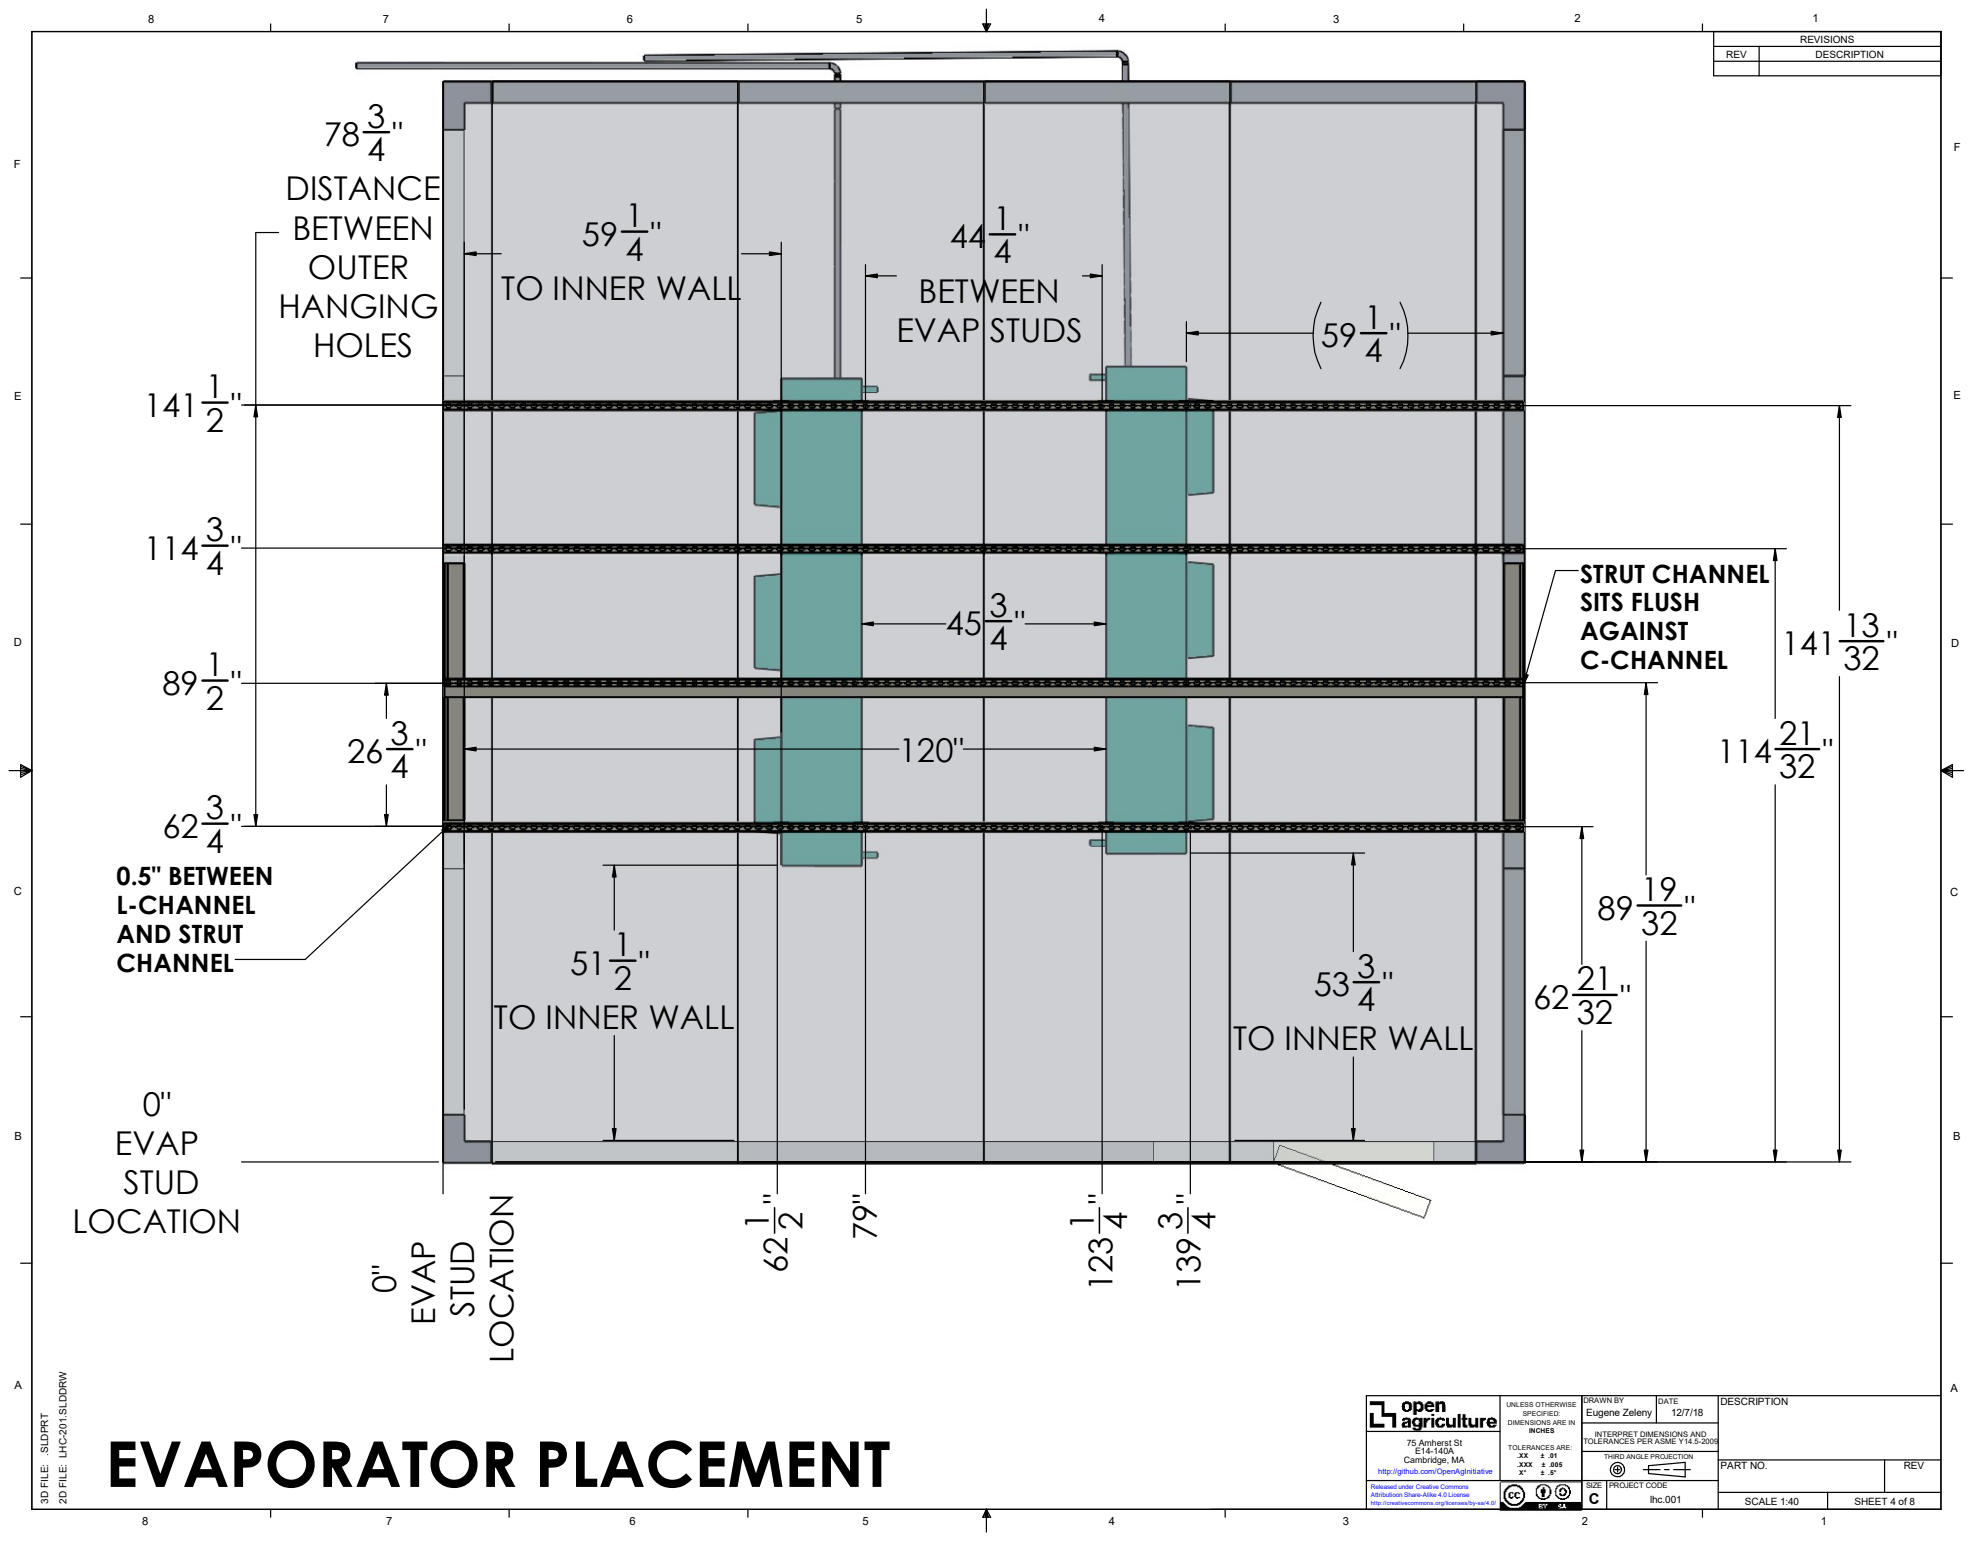
[picture p582: page 4]
STUD; EVAP; LOCATION; EVAPORATOR PLACEMENT; http://github.com/OpenAgInitiative; INCHES 2D FILE: LHC⁻²⁰¹.SLDDRW; PART NO.; DESCRIPTION; UNLESS OTHERWISE; Eugene Zeleny; DRAWN BY; DATE; SITS FLUSH AGAINST C-CHANNEL; STRUT CHANNEL; 0.5" BETWEEN L-CHANNEL AND STRUT CHANNEL; TO INNER WALL; HANGING; OUTER; BETWEEN; DISTANCE; EVAP STUDS; HOLES

141 0" EVAP STUD LOCATION

TO INNER WALL

http://creativecommons.org/licenses/by-sa/4.0/ | lhc.001

SHEET 4 of 8

161 27
32 "

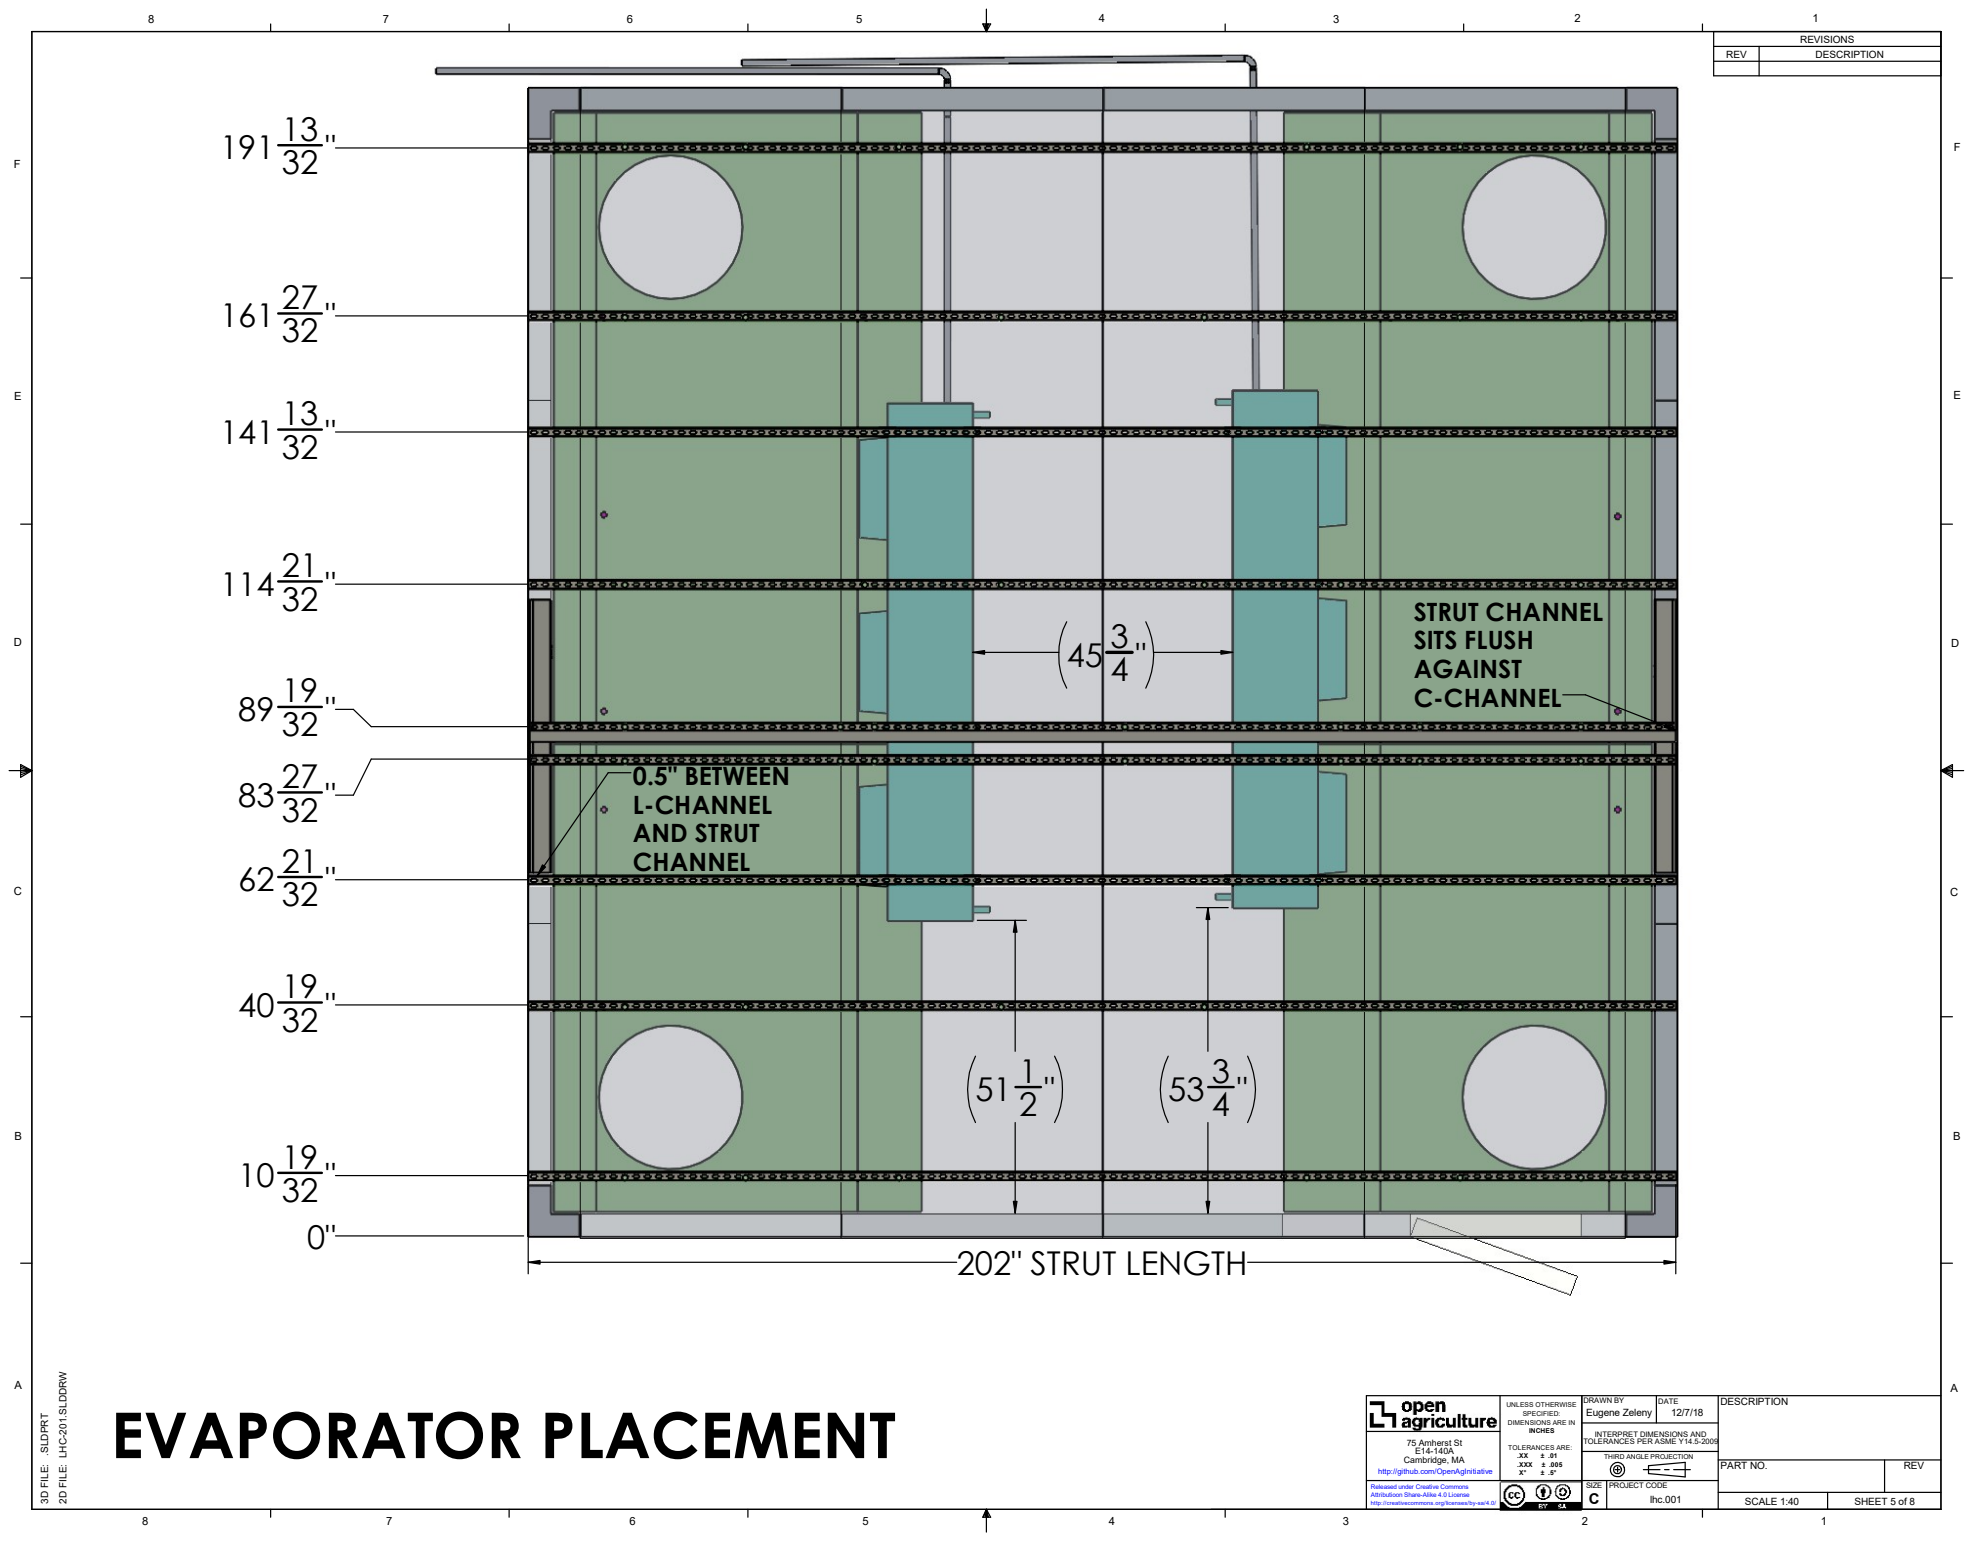
[picture p583: page 5]
EVAPORATOR PLACEMENT; http://github.com/OpenAgInitiative; INCHES 2D FILE: LHC⁻²⁰¹.SLDDRW; PART NO.; UNLESS OTHERWISE; DESCRIPTION; DRAWN BY; DATE; SITS FLUSH AGAINST C-CHANNEL; STRUT CHANNEL; 0.5" BETWEEN L-CHANNEL AND STRUT CHANNEL; 202" STRUT LENGTH

lhc.001

SHEET 5 of 8

F
F

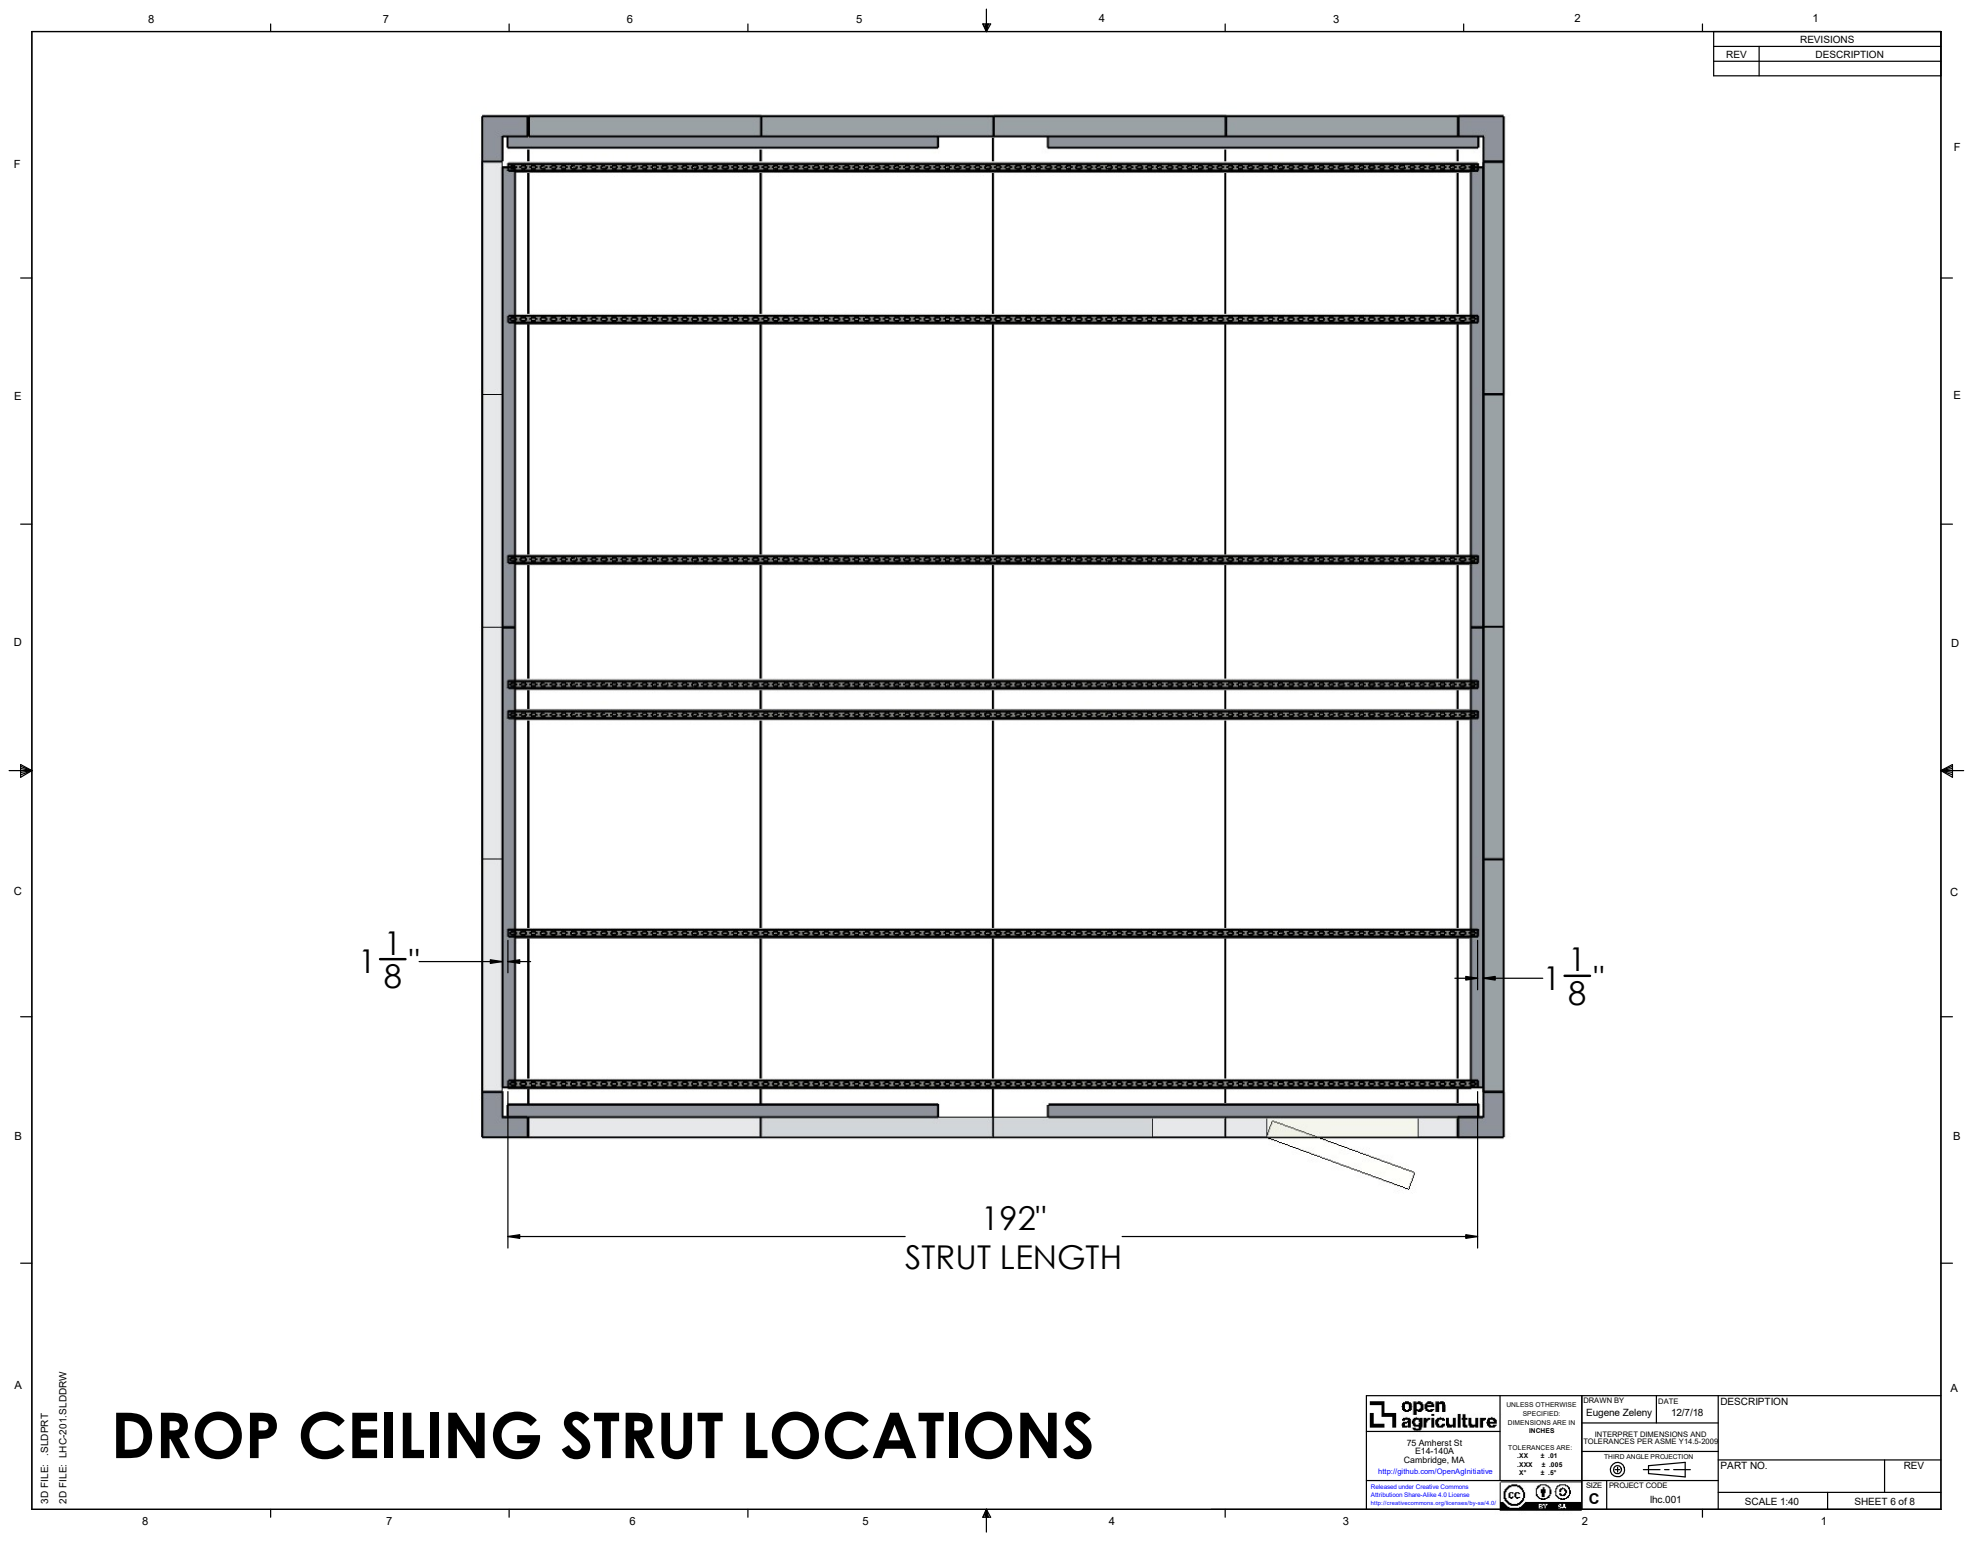
[picture p584: page 6]
TOLERANCES PER ASME Y14.5-2009 3D FILE: .SLDPRT; Cambridge, MA; UNLESS OTHERWISE; DRAWN BY; DATE; PART NO. 2D FILE: LHC⁻²⁰¹.SLDDRW; SCALE 1:40; SPECIFIED:; Eugene Zeleny; DESCRIPTION; 192" STRUT LENGTH

DROP CEILING STRUT LOCATIONS

INTERPRET DIMENSIONS AND

C lhc.001

SHEET 6 of 8

F
F

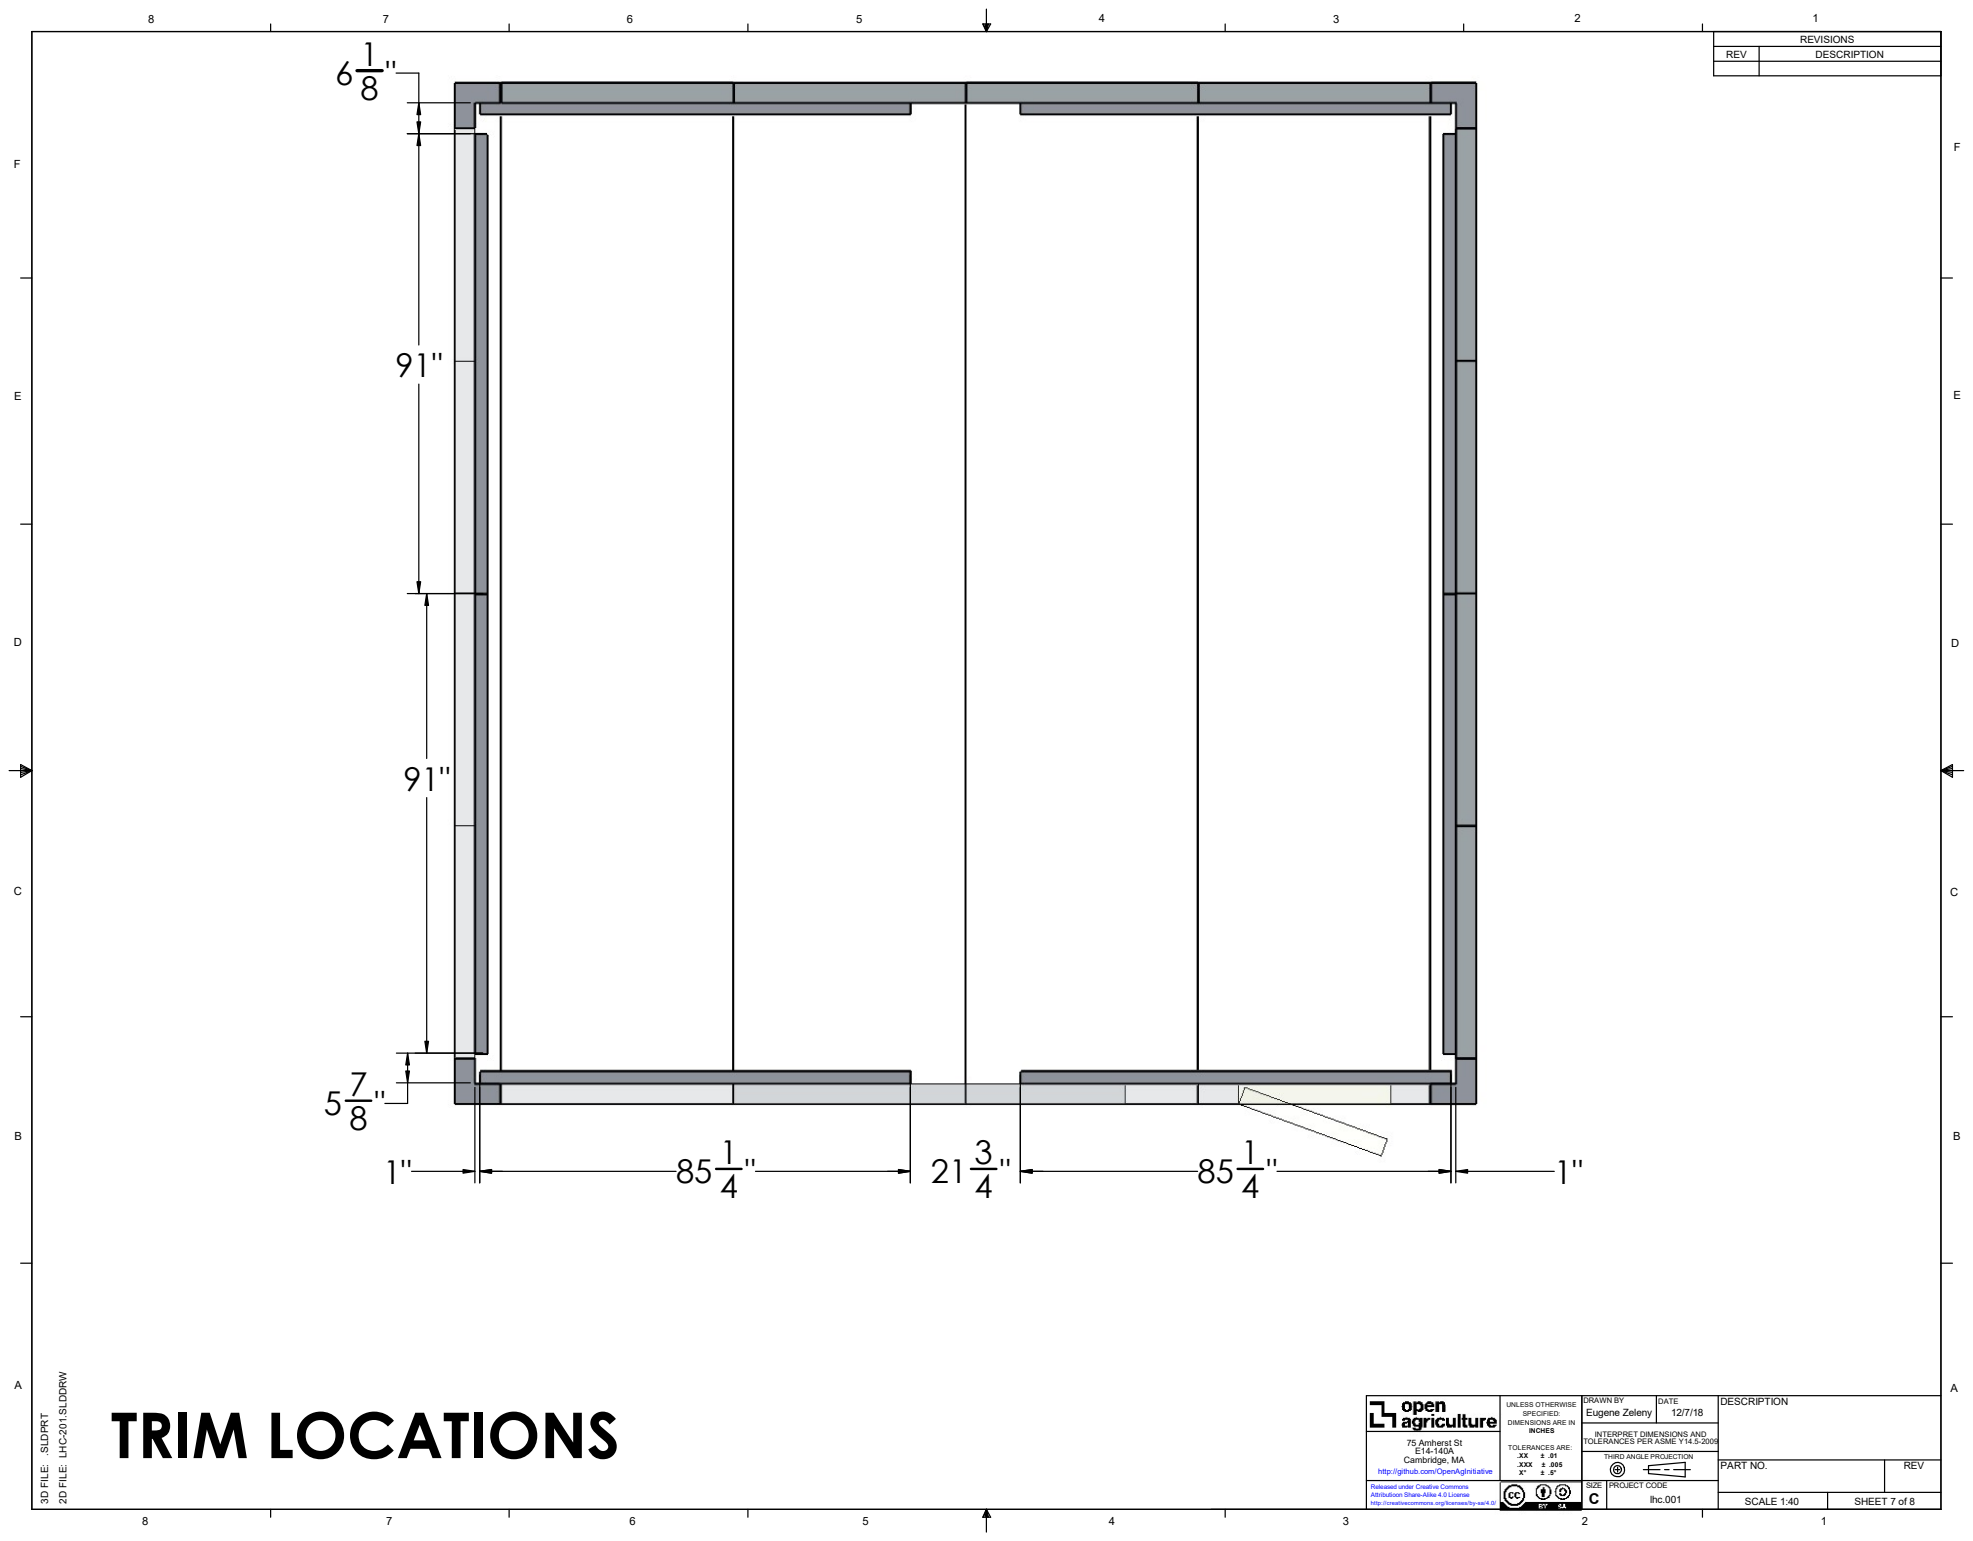
[picture p585: page 7]
TRIM LOCATIONS; http://github.com/OpenAgInitiative; UNLESS OTHERWISE; DIMENSIONS ARE IN 2D FILE: LHC⁻²⁰¹.SLDDRW; PART NO.; DESCRIPTION; Eugene Zeleny; DRAWN BY; DATE

lhc.001

SHEET 7 of 8
