OpenAgricultureFoundation/openag-mechanical/prj/hazelnut_large/LHC-001/LHC-200/LHC-201_STRUT_EVAP.PDF

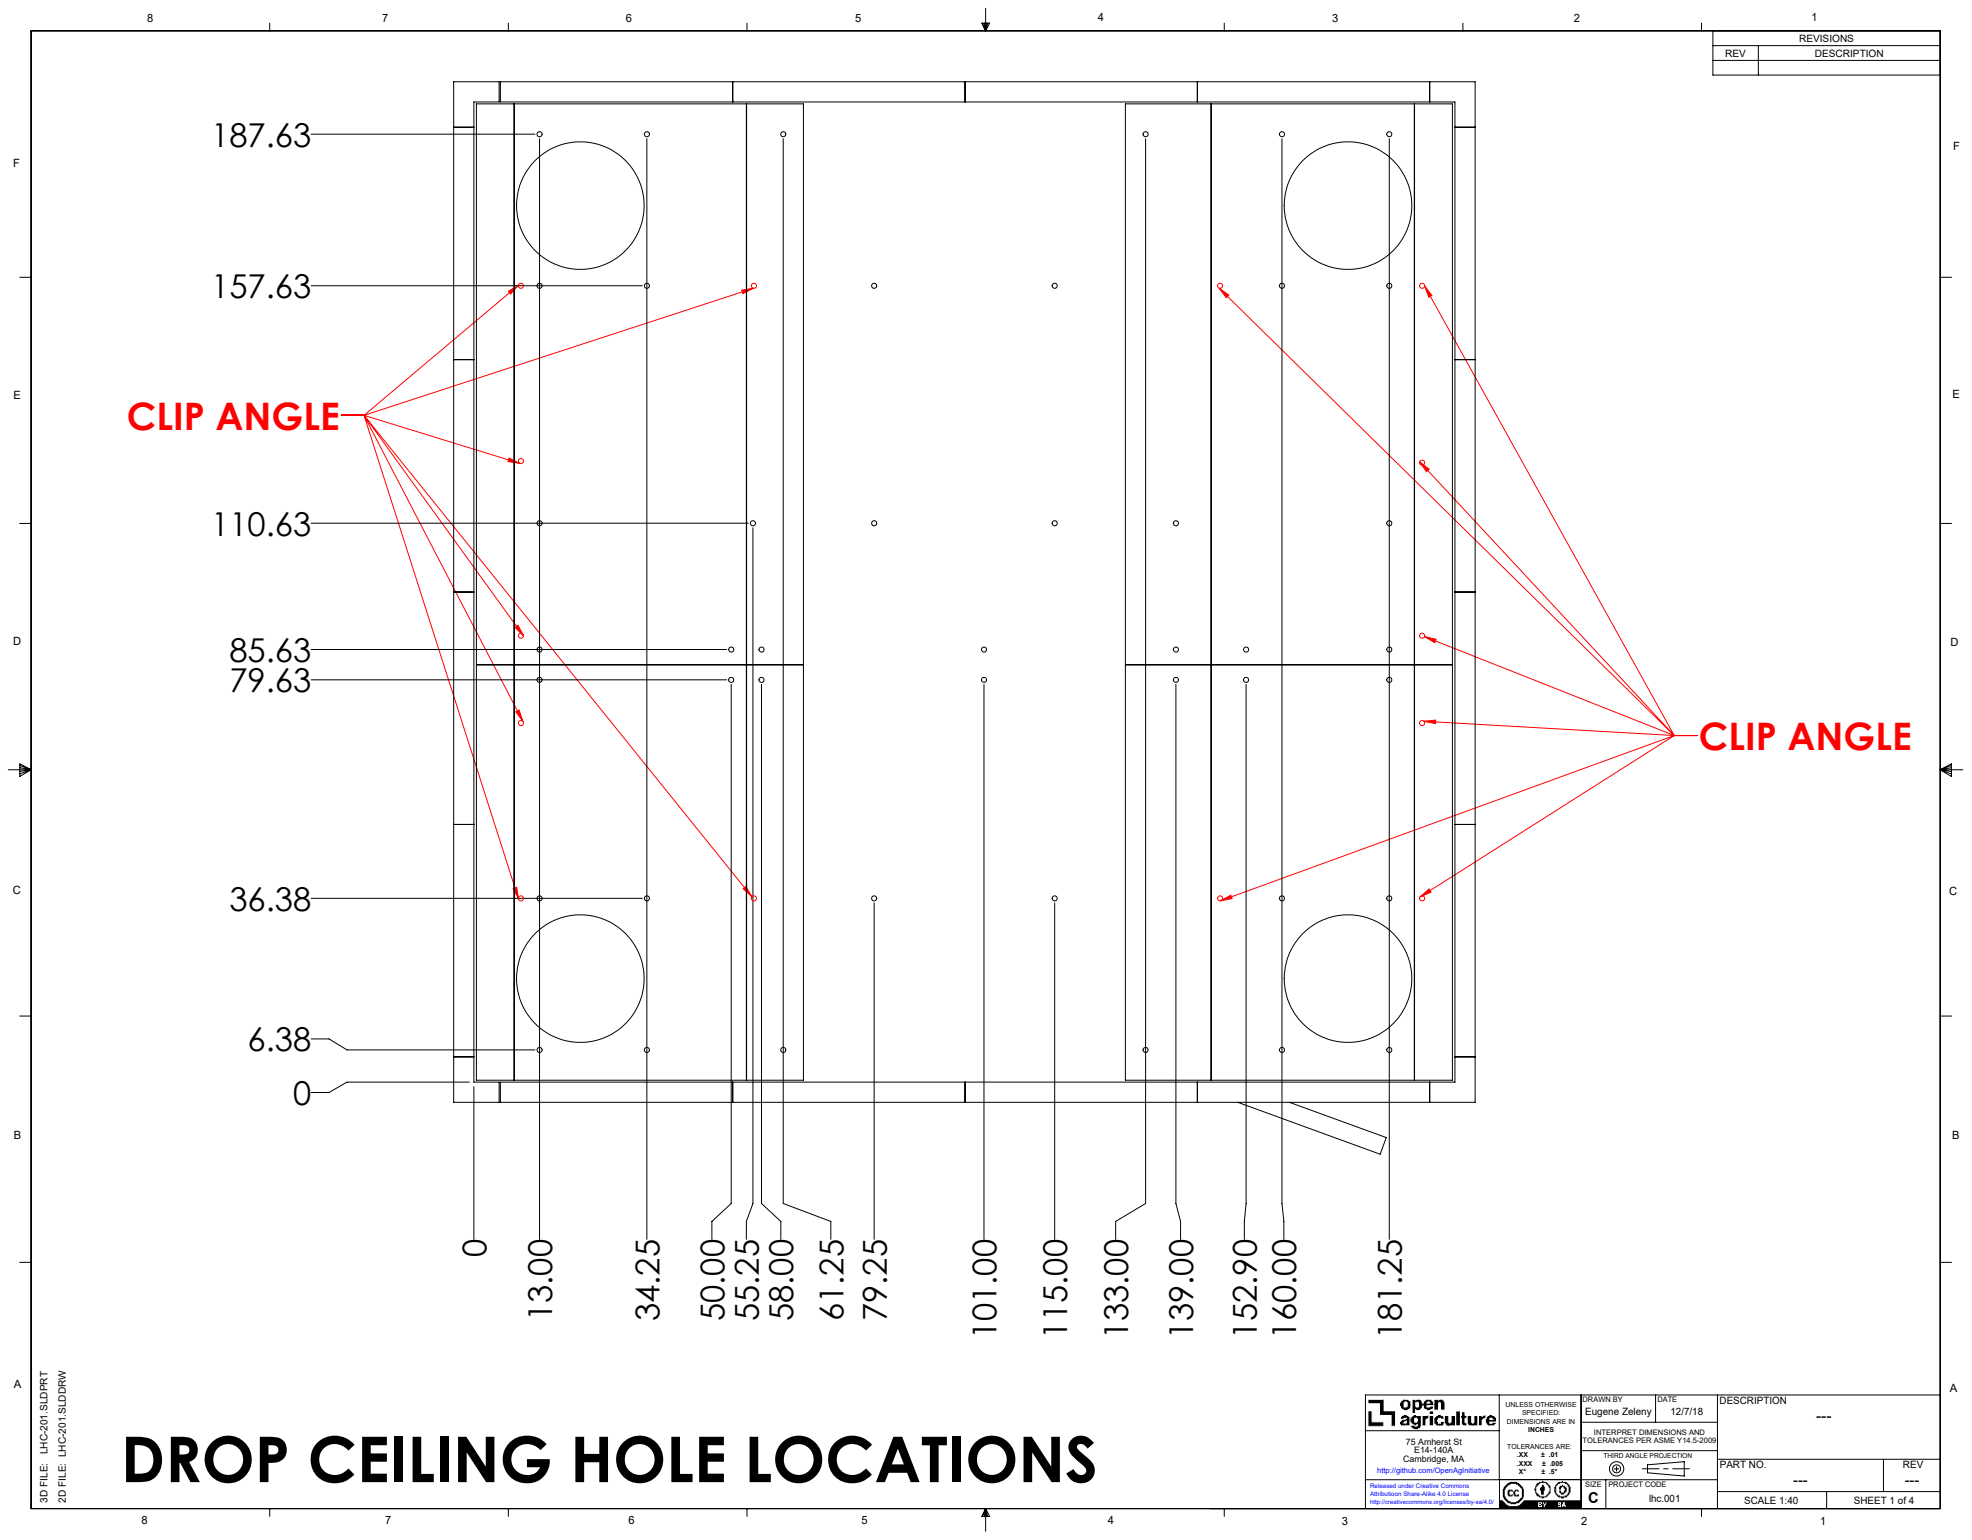
[picture p586: page 1]
CLIP ANGLE; PART NO.; SCALE 1:40; SHEET 1 of 4; PROJECT CODE; Eugene Zeleny; C lhc.001; DRAWN BY; DATE

3D FILE: LHC-201.SLDPRT

2D FILE: LHC-201.SLDDRW
DROP CEILING HOLE LOCATIONS

--- INTERPRET DIMENSIONS AND

UNLESS OTHERWISE
SPECIFIED:
DIMENSIONS ARE IN
INCHES
TOLERANCES ARE:
.XXX ± .005

75 Amherst St
Cambridge, MA
http://github.com/OpenAgInitiative

TOLERANCES PER ASME Y14.5-2009
THIRD ANGLE PROJECTION

Released under Creative Commons
Attributioon Share-Alike 4.0 License
http://creativecommons.org/licenses/by-sa/4.0/

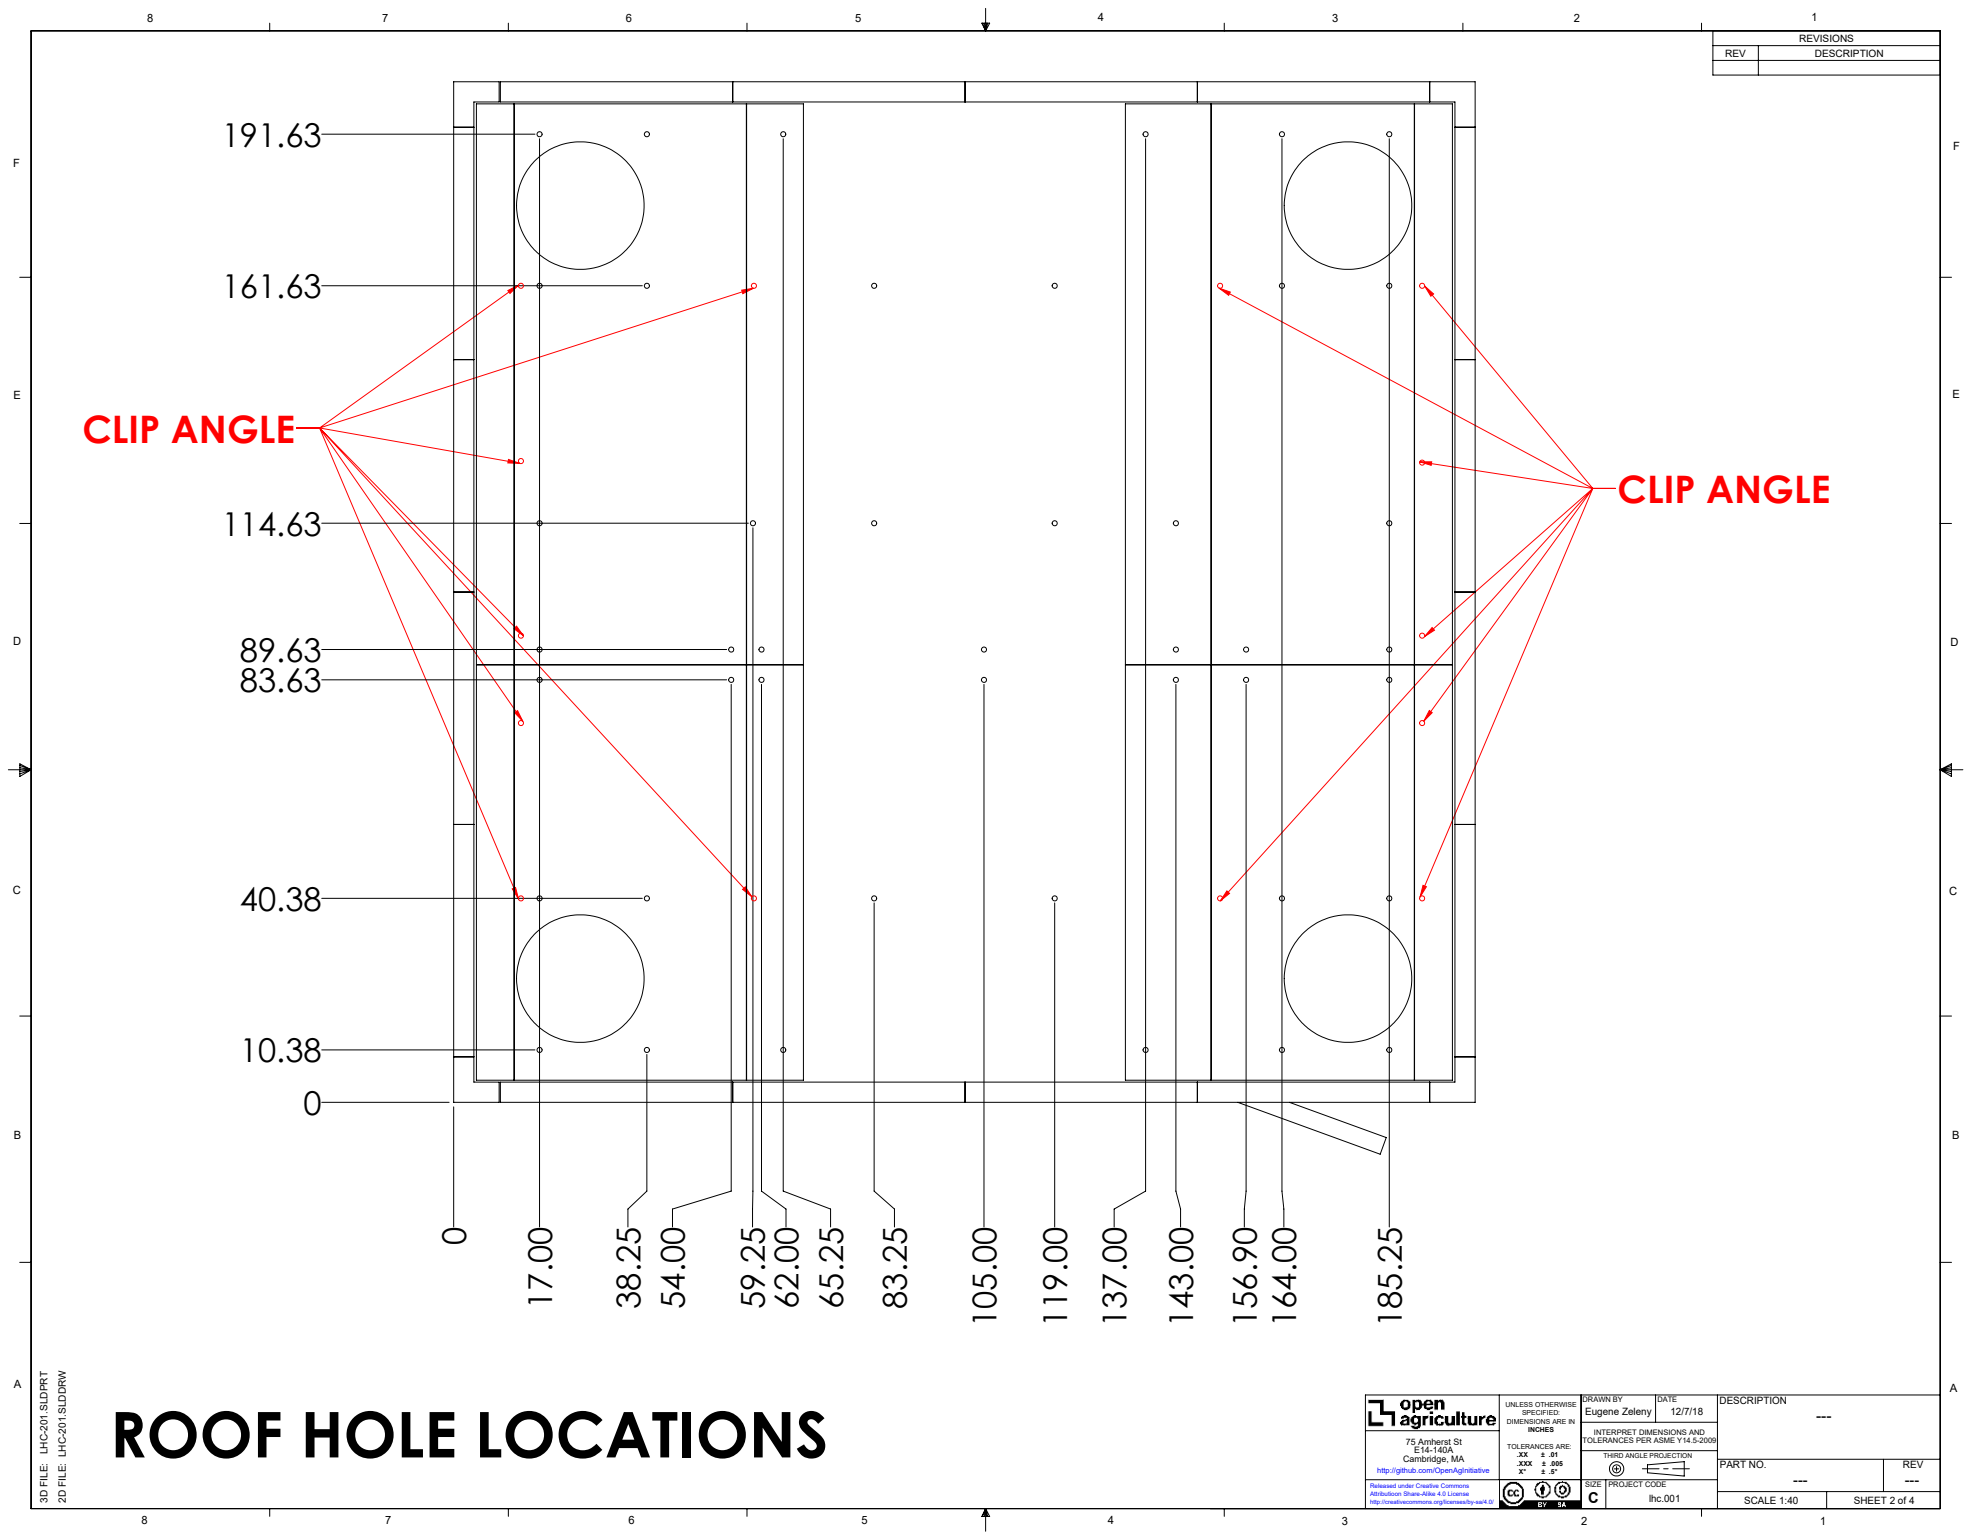
[picture p587: page 2]
CLIP ANGLE; DRAWN BY; DATE; UNLESS OTHERWISE

3D FILE: LHC-201.SLDPRT

2D FILE: LHC-201.SLDDRW
ROOF HOLE LOCATIONS

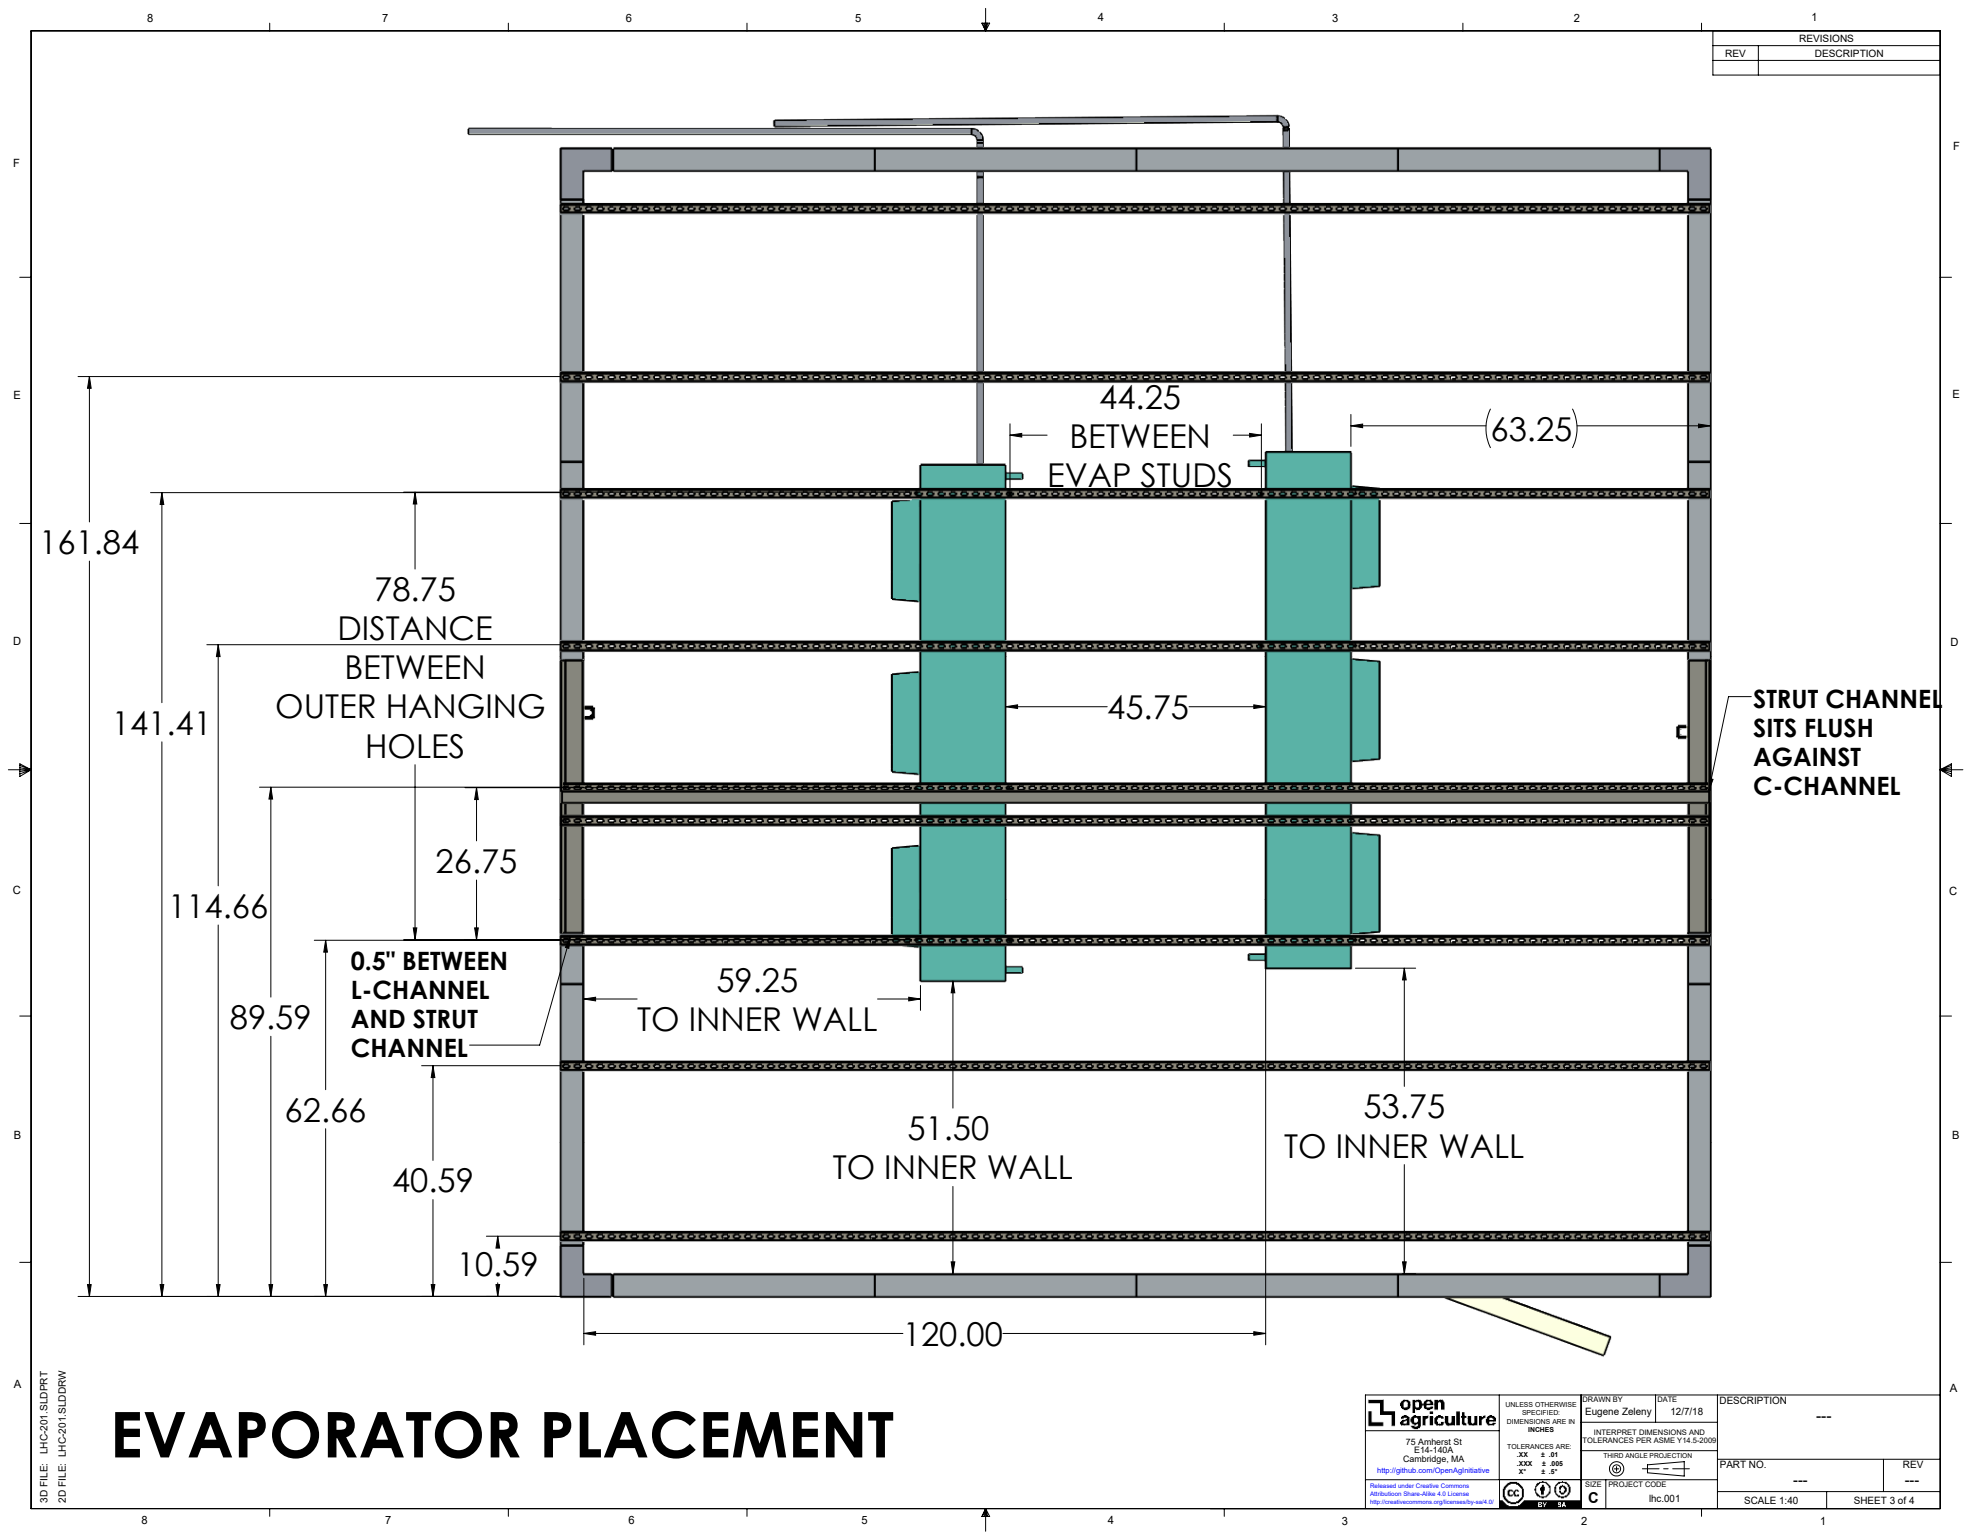
[picture p588: page 3]
OUTER HANGING; EVAP STUDS; STRUT CHANNEL SITS FLUSH; 0.5" BETWEEN; AND STRUT; DRAWN BY; DATE; UNLESS OTHERWISE

TO INNER WALL

3D FILE: LHC-201.SLDPRT

2D FILE: LHC-201.SLDDRW
EVAPORATOR PLACEMENT
