OpenAgricultureFoundation/openag-mechanical/prj/hazelnut_large/LHC-001/LHC-300/2019_3_21_RFQ_PROFAB_lhc-306.PDF

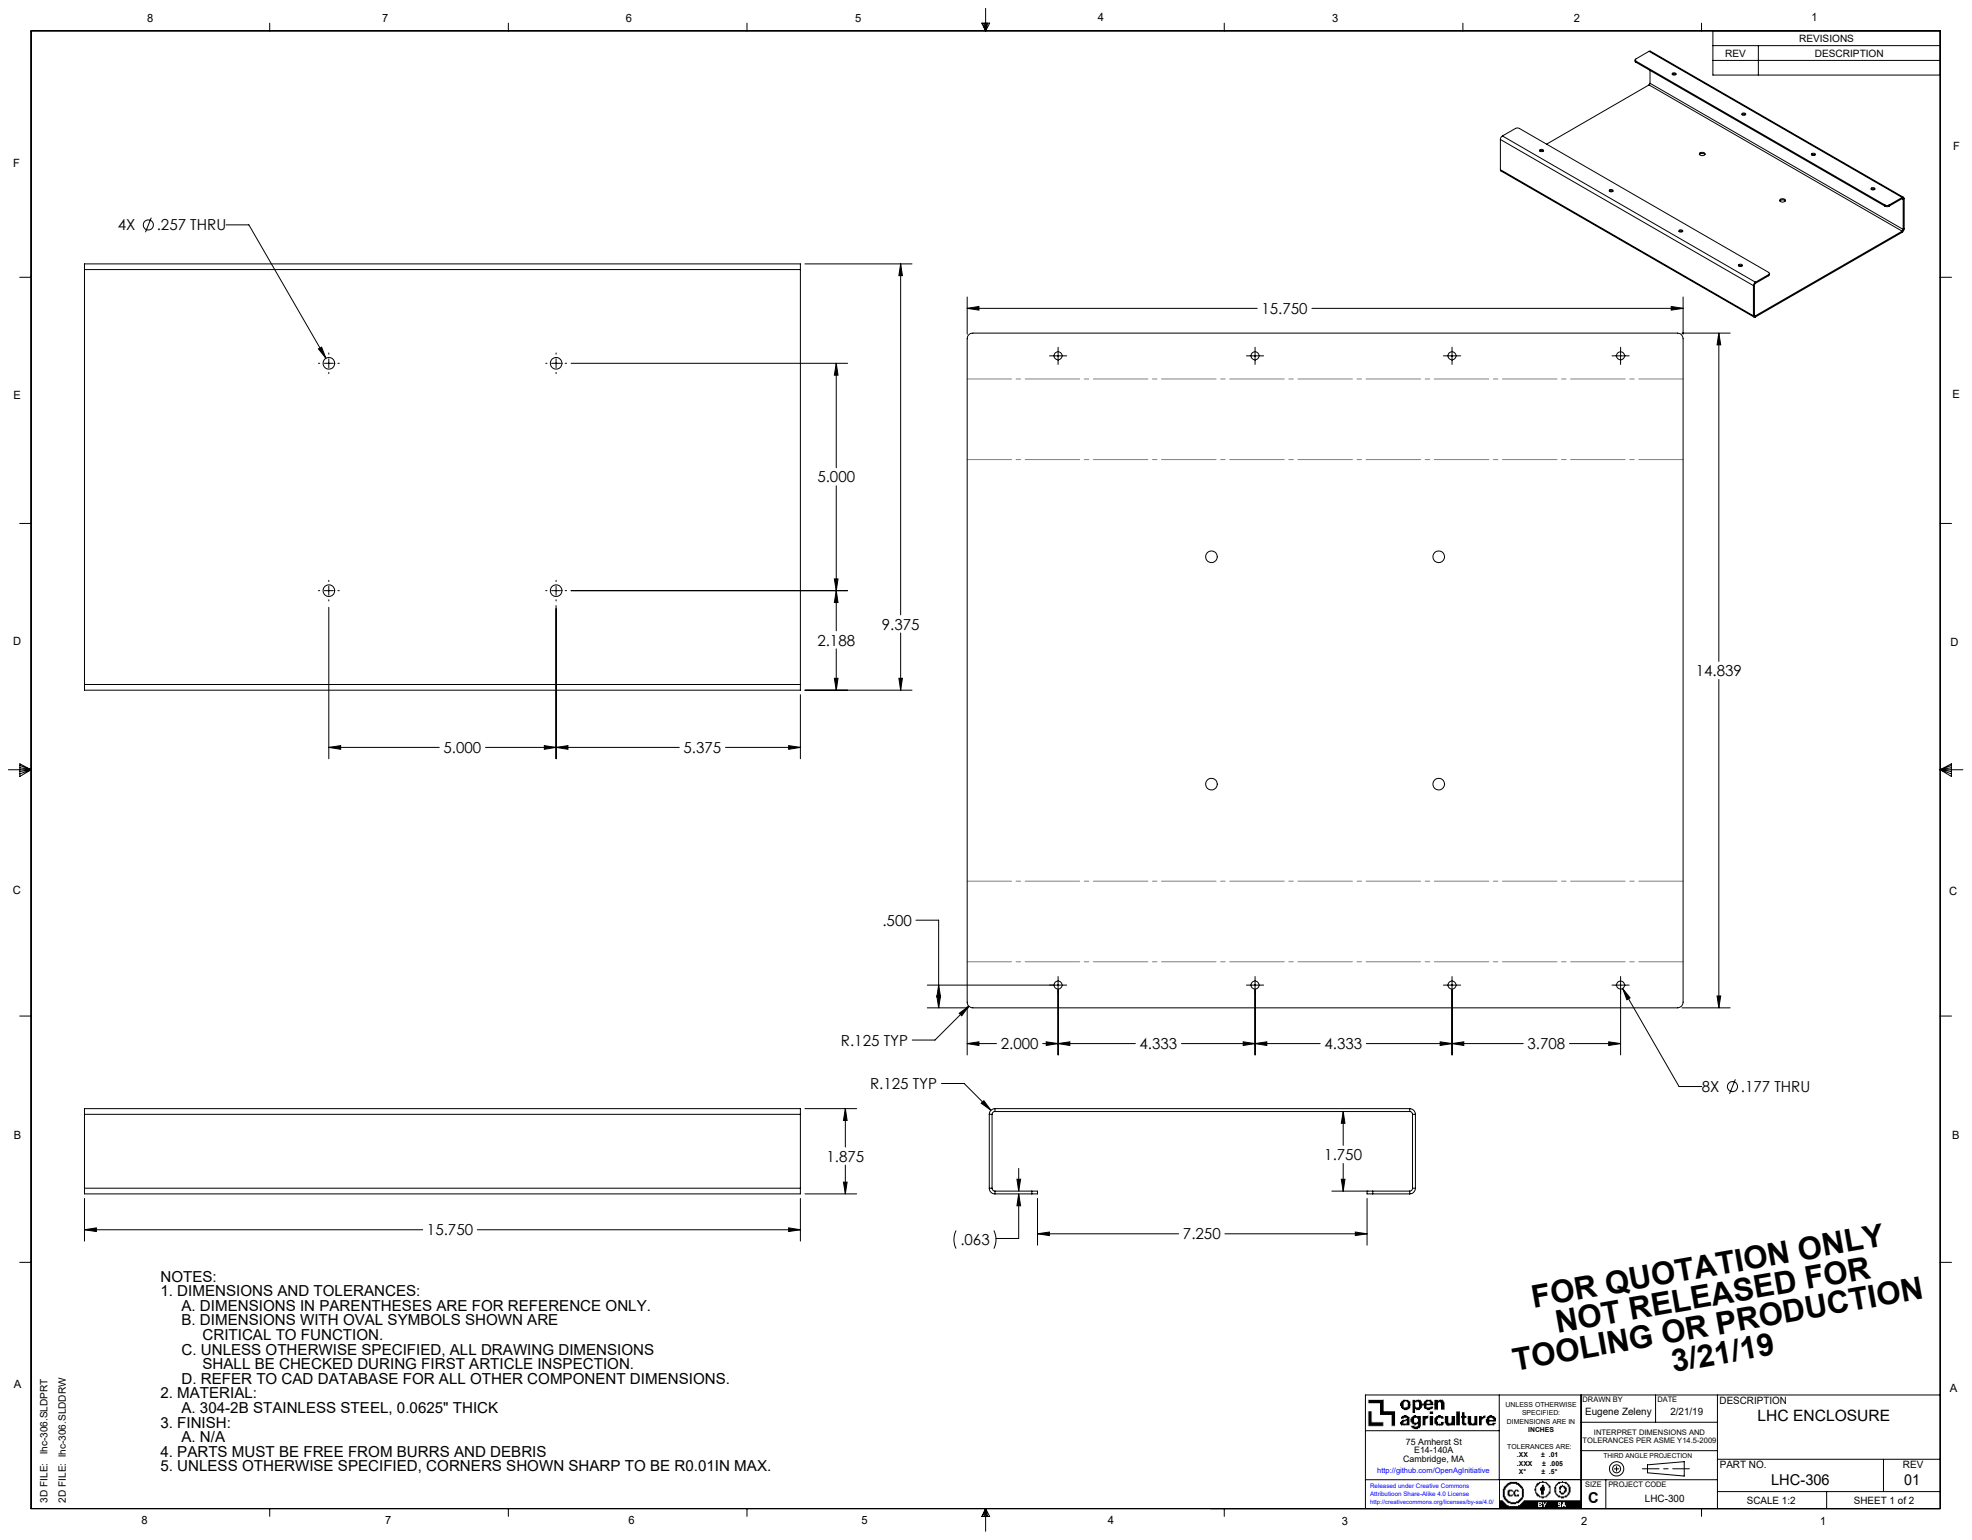
[picture p589: page 1]
4X .257 THRU; R.125 TYP; 8X .177 THRU; PART NO.; SCALE 1:2; SHEET 1 of 2; LHC ENCLOSURE; PROJECT CODE; Eugene Zeleny; C LHC-300; DRAWN BY; DATE

FOR QUOTATION ONLY

NOT RELEASED FOR TOOLING OR PRODUCTION 3/21/19

NOTES:
1. DIMENSIONS AND TOLERANCES:
A. DIMENSIONS IN PARENTHESES ARE FOR REFERENCE ONLY.
B. DIMENSIONS WITH OVAL SYMBOLS SHOWN ARE
CRITICAL TO FUNCTION.
C. UNLESS OTHERWISE SPECIFIED, ALL DRAWING DIMENSIONS
SHALL BE CHECKED DURING FIRST ARTICLE INSPECTION.
D. REFER TO CAD DATABASE FOR ALL OTHER COMPONENT DIMENSIONS.
2. MATERIAL:
A. 304-2B STAINLESS STEEL, 0.0625" THICK
3. FINISH:
4. PARTS MUST BE FREE FROM BURRS AND DEBRIS
5. UNLESS OTHERWISE SPECIFIED, CORNERS SHOWN SHARP TO BE R0.01IN MAX.

3D FILE: lhc-306.SLDPRT

2D FILE: lhc-306.SLDDRW

UNLESS OTHERWISE
SPECIFIED:
DIMENSIONS ARE IN
INCHES
TOLERANCES ARE:
.XXX ± .005

75 Amherst St
Cambridge, MA
http://github.com/OpenAgInitiative

INTERPRET DIMENSIONS AND
TOLERANCES PER ASME Y14.5-2009
THIRD ANGLE PROJECTION

Released under Creative Commons
Attributioon Share-Alike 4.0 License
http://creativecommons.org/licenses/by-sa/4.0/

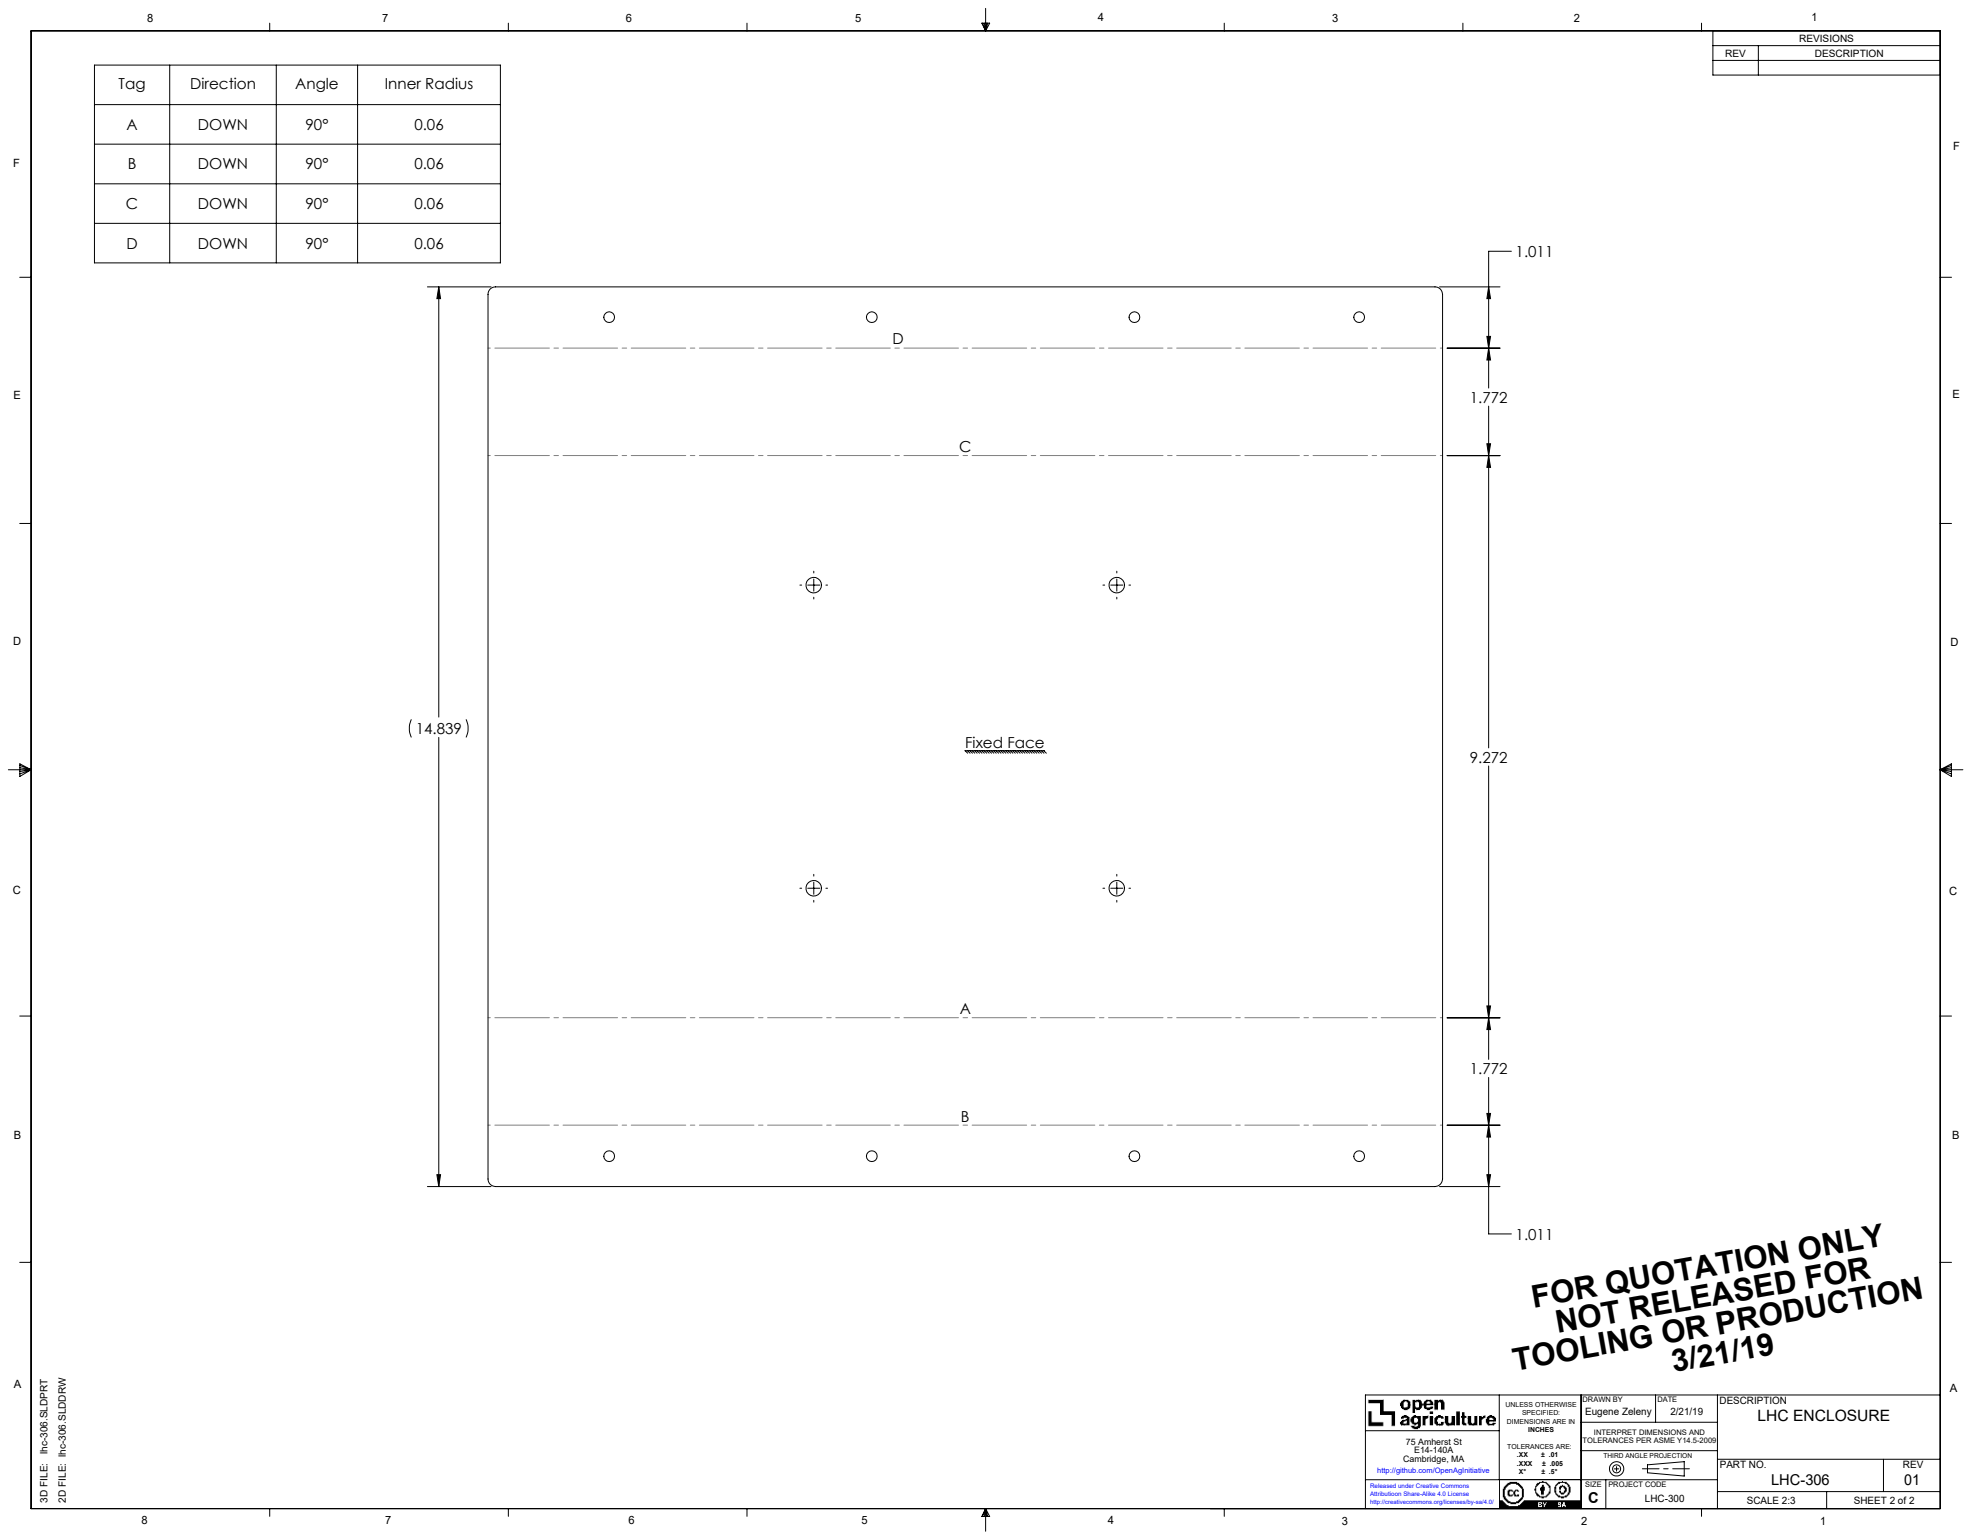
[picture p590: page 2]
Fixed Face; PART NO.; SCALE 2:3; SHEET 2 of 2; LHC ENCLOSURE; PROJECT CODE; Eugene Zeleny; C LHC-300; DRAWN BY; DATE

Tag | Direction | Angle | Inner Radius

A | DOWN | 90° | 0.06
B | DOWN | 90° | 0.06
C | DOWN | 90° | 0.06
D | DOWN | 90° | 0.06

FOR QUOTATION ONLY

NOT RELEASED FOR TOOLING OR PRODUCTION 3/21/19

3D FILE: lhc-306.SLDPRT

2D FILE: lhc-306.SLDDRW

UNLESS OTHERWISE
SPECIFIED:
DIMENSIONS ARE IN
INCHES
TOLERANCES ARE:
.XXX ± .005

75 Amherst St
Cambridge, MA
http://github.com/OpenAgInitiative

INTERPRET DIMENSIONS AND
TOLERANCES PER ASME Y14.5-2009
THIRD ANGLE PROJECTION

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
