OpenAgricultureFoundation/openag-mechanical/prj/hazelnut_large/LHC-001/2-RFQs/L HC Refrigerated Panels' Shop Drawings_Barr Inc..pdf

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

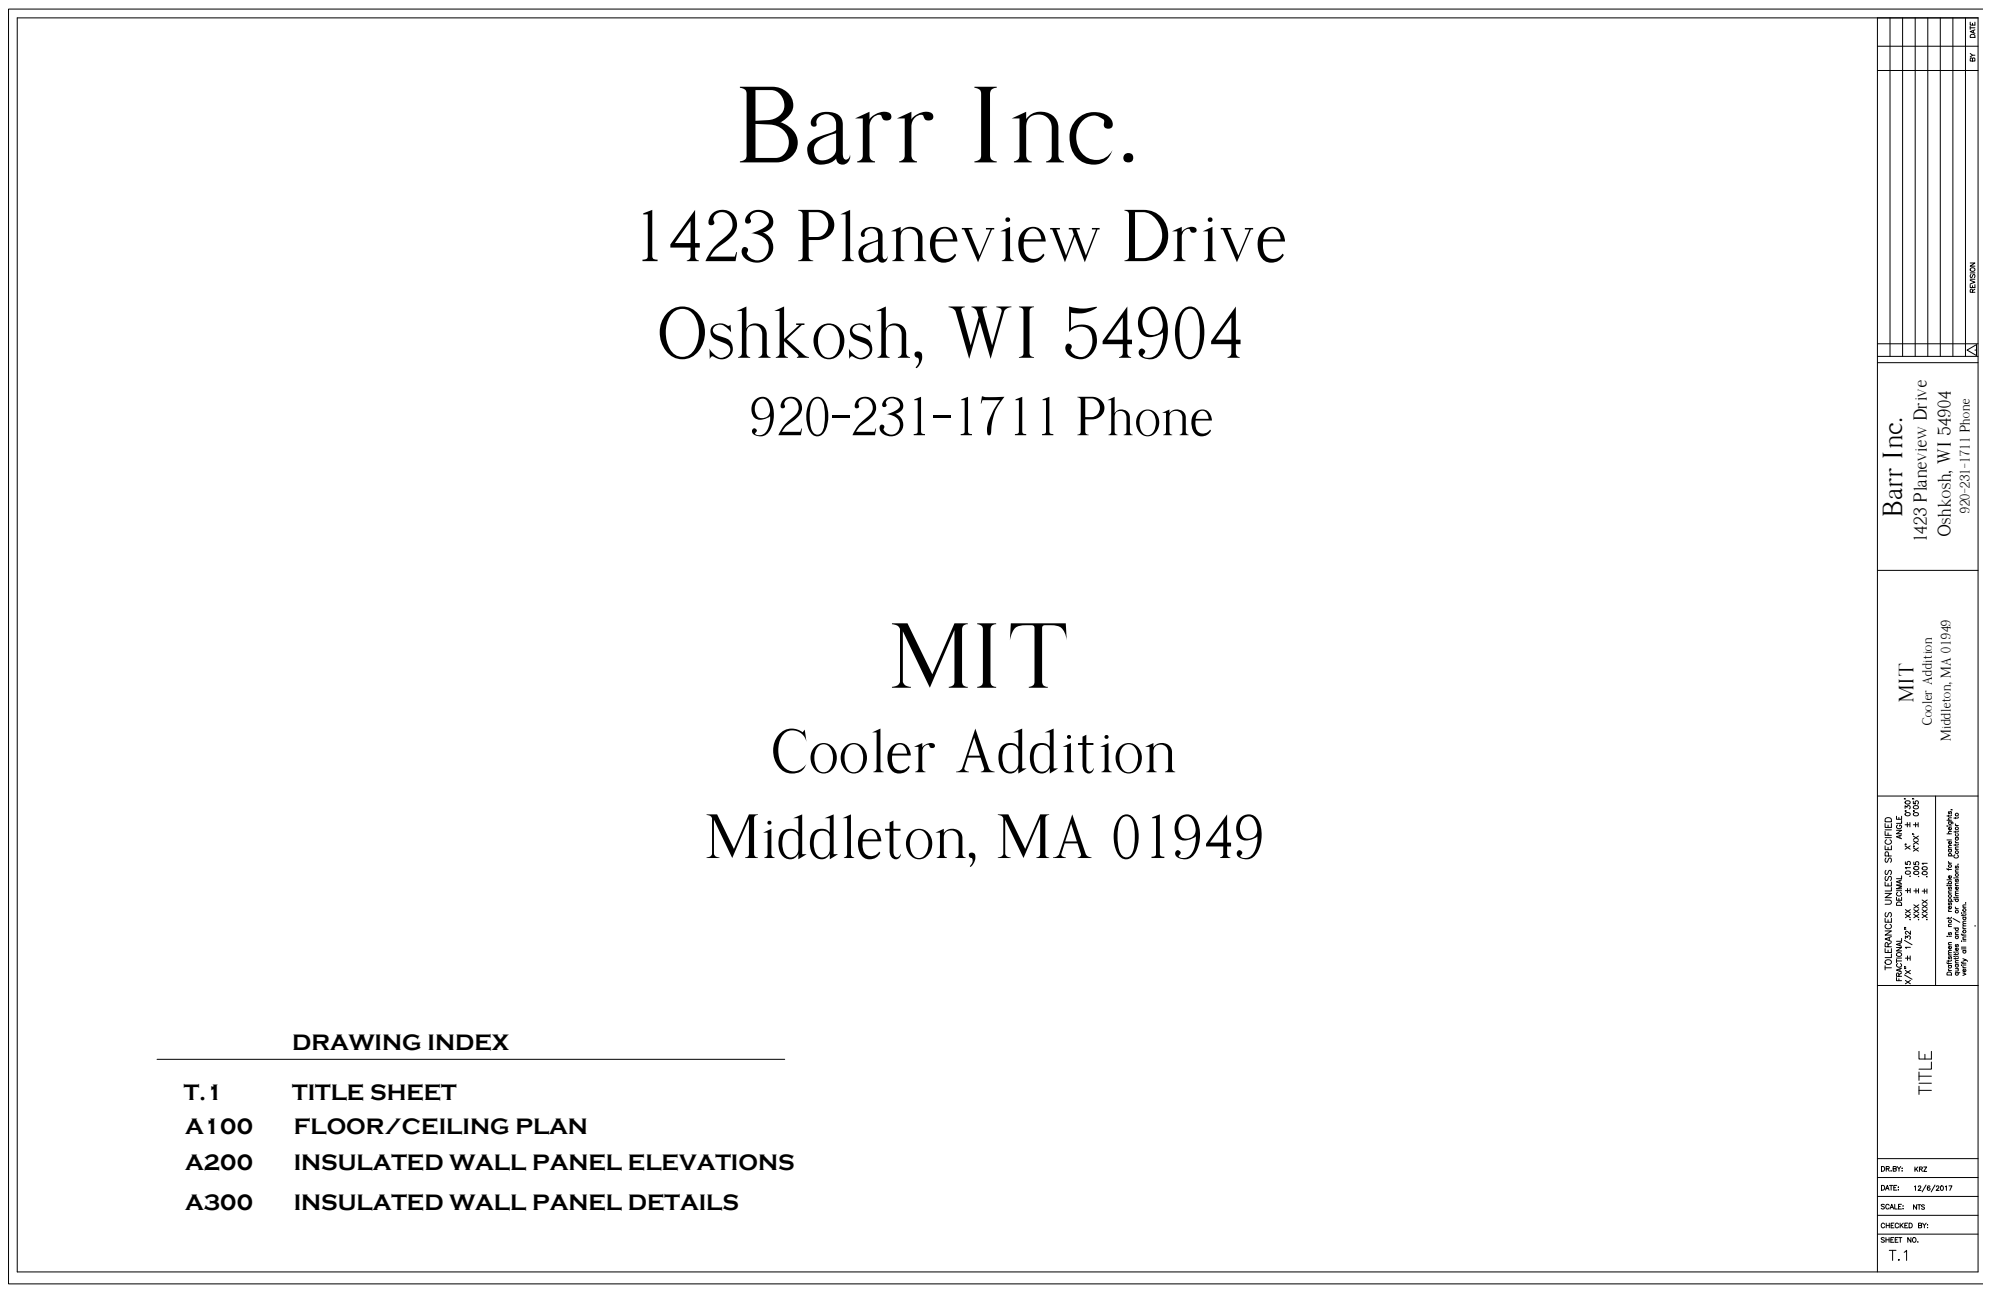
[picture p591: page 1]

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

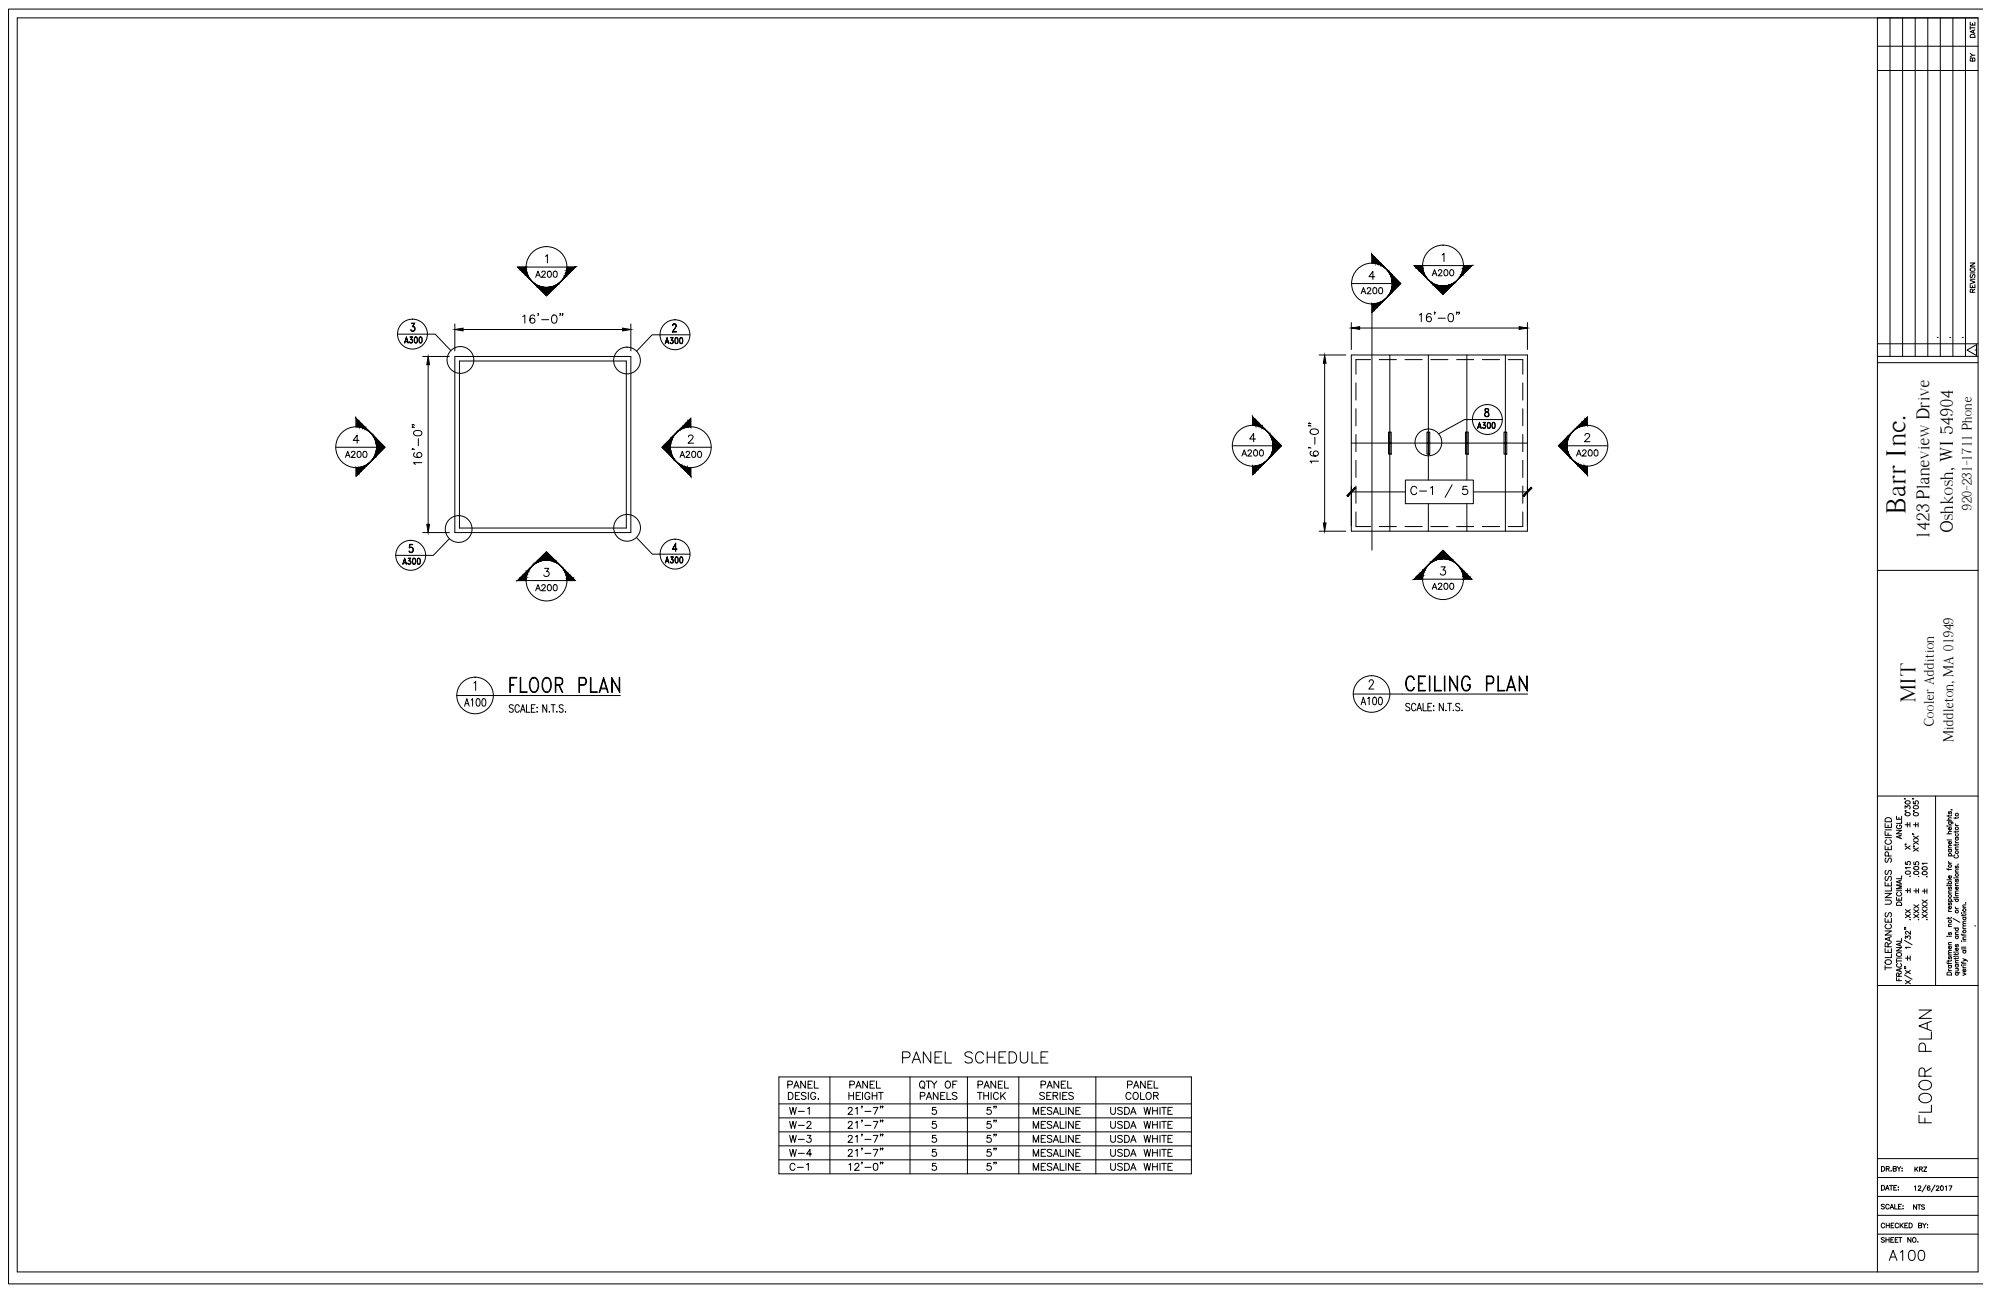
[picture p592: page 2]

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

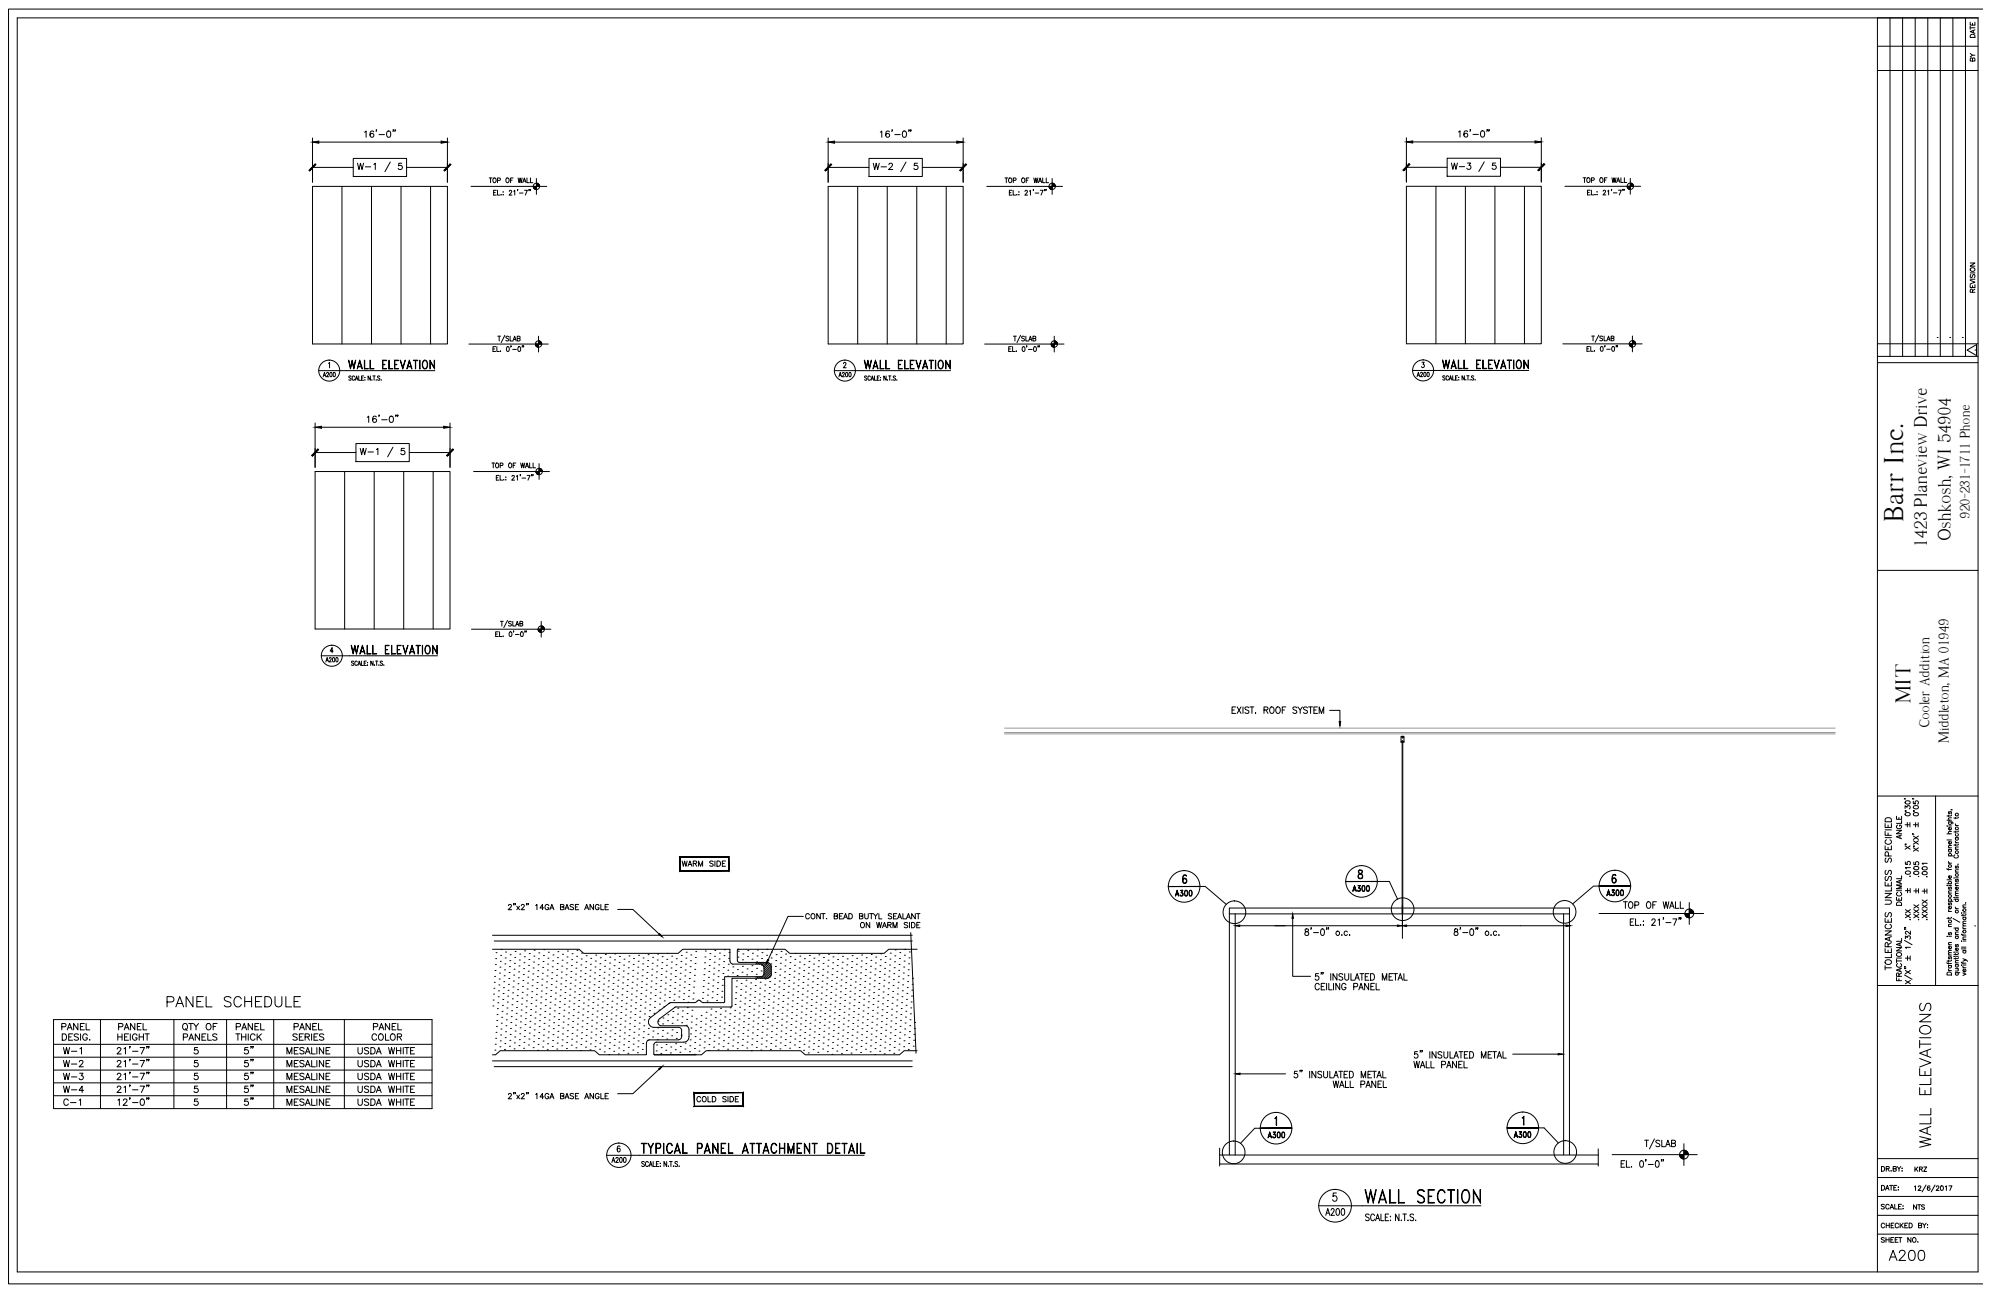
[picture p593: page 3]

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

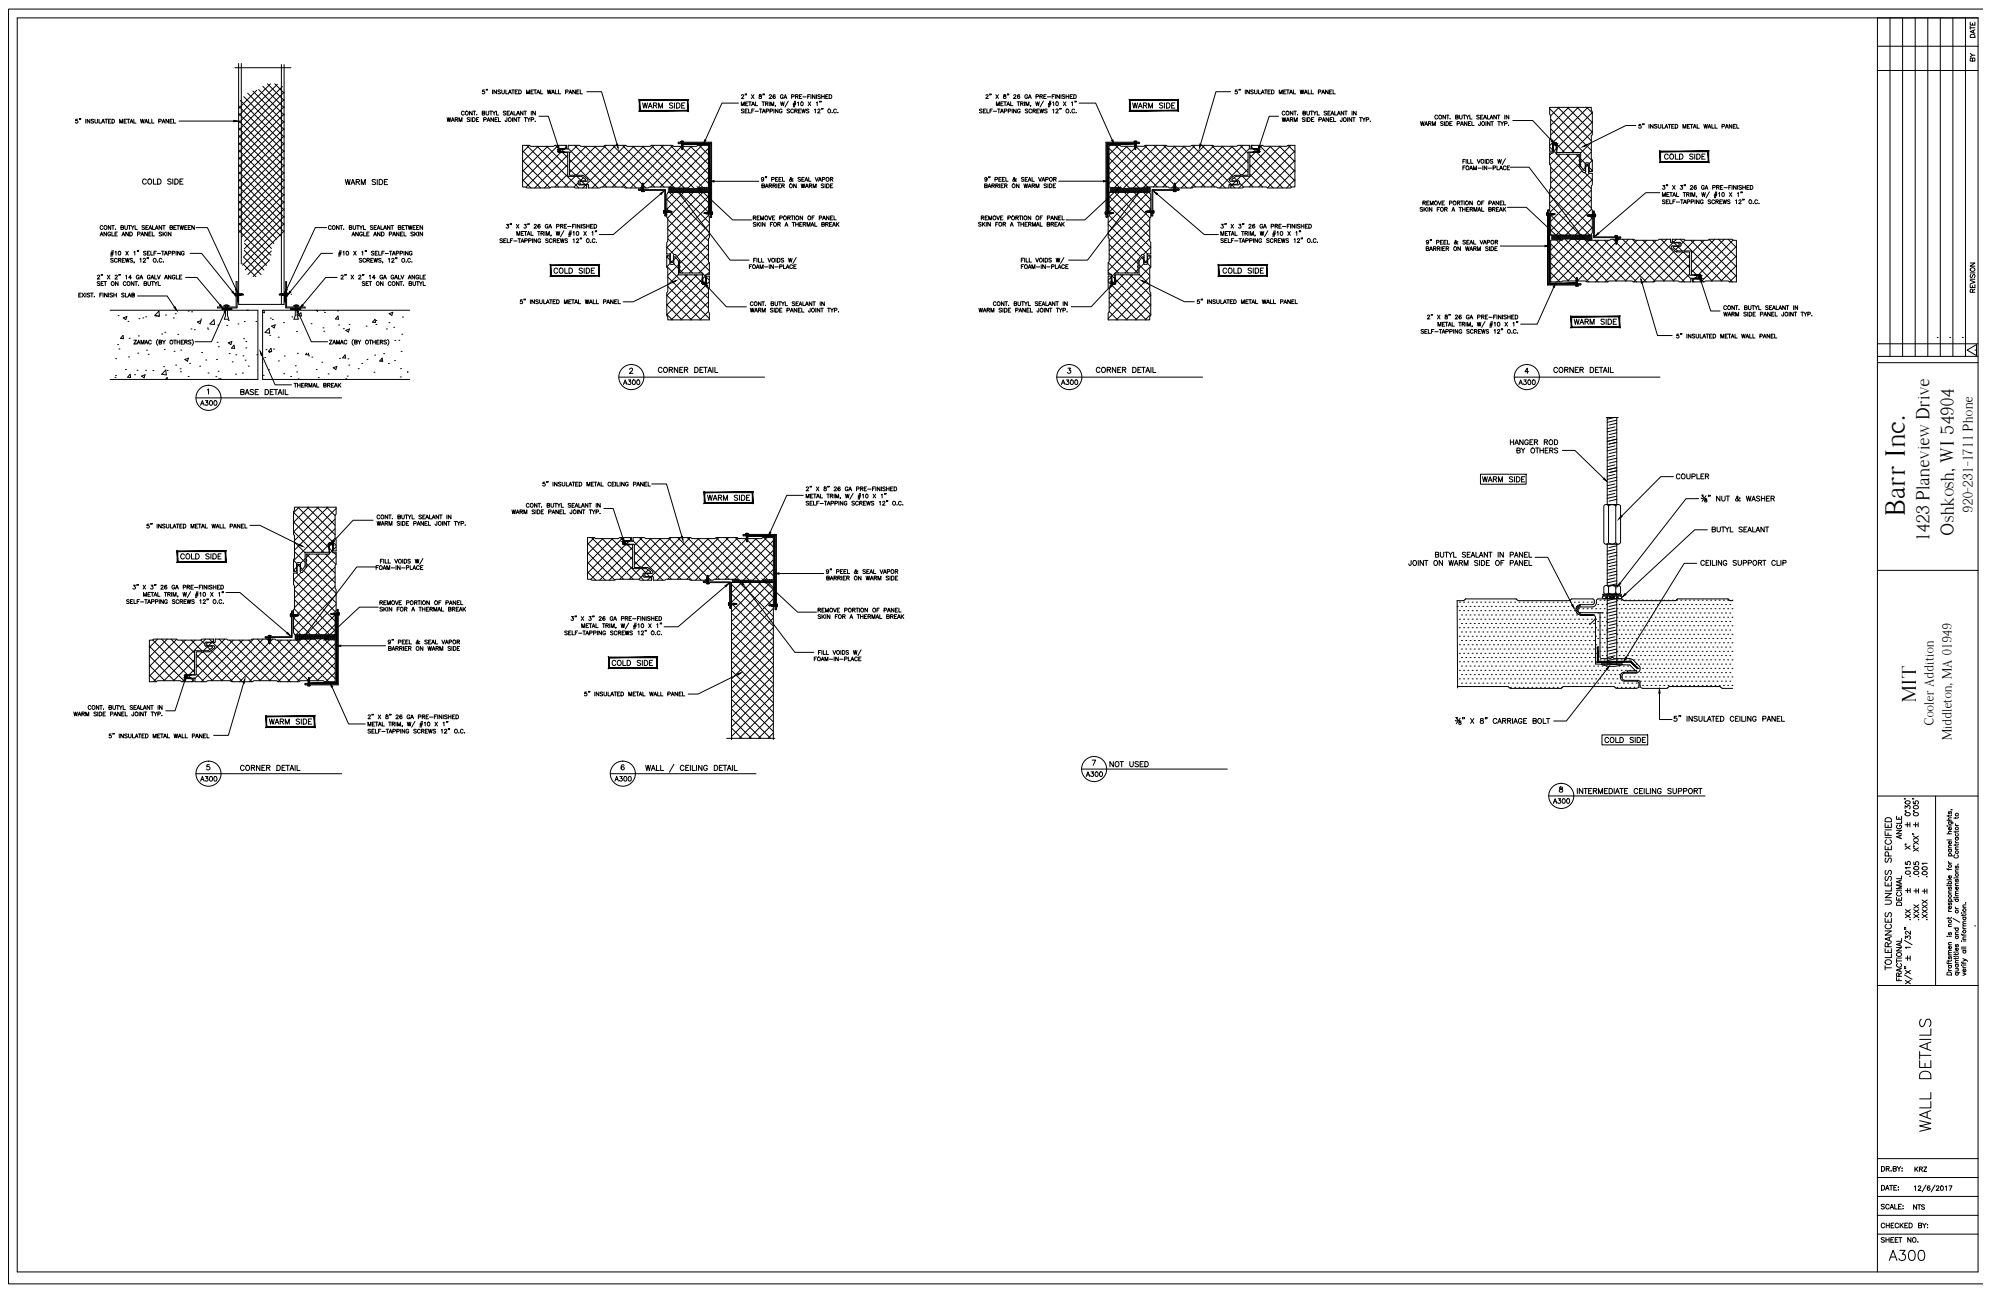
[picture p594: page 4]
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
