OpenAgricultureFoundation/openag-mechanical/(commit log)

2018-05-15 5-15-18 CAD
    Creation of light fixture assembly with example rack and off-the-shelf parts from McMaster.
    [3063T140_SANITARY CLAMPING HANGER (1).SLDPRT, 5-15-18_Cart_Racks.SLDPRT, 5-15-18_Rack_Assembl.SLDASM, 8831T350_WASHDOWN VIBRATION-DAMPING CLAMPING HANGER.SLDPRT, MCM_6546K64.SLDPRT, MCM_9056K36.SLDPRT]
2018-05-18 5-18-18 Changes
    Created Part/Assembly/Drawing Size A Template files for review, and begun creating camera mounting assemblies
    [2615T140_VIBRATION-DAMPING CLAMPING HANGER (1).SLDPRT, 29585T200_BEAM CLAMP FOR PIPE TUBE AND CONDUIT.SLDPRT, 3063T140_SANITARY CLAMPING HANGER (1).SLDPRT, 33085T310_STRUT CHANNEL.SLDPRT, 3580T110_STRUT CHANNEL STUD NUT.SLDPRT, 5 megapixel USB camera model ELP-USB500W02M-L21.SLDPRT, 5-15-18_Cart_Racks.SLDPRT, 5-15-18_Rack_Assembl.SLDASM]
2018-05-18 5-18-18 Changes
    Updates to camera mounting assembly and solidworks templates
    [5 megapixel USB camera model ELP-USB500W02M-L21.SLDPRT, LFR.003.SLDPRT]
2018-05-24 5/24/18 Changes
    Updated camera assembly.
    [2615T130_VIBRATION-DAMPING CLAMPING HANGER.SLDPRT, 5 megapixel USB camera model ELP-USB500W02M-L21.SLDPRT, 91115A819_18-8 SS FEM THRDED HEX STANDOFF.SLDPRT, 92001A321_18-8 SS WING NUT.SLDPRT, 92147A410_TYPE 316 STAINLESS STEEL SPLIT LOCK WASHER.SLDPRT, 92949A077_18-8 SS BUTTON-HEAD SOCKET CAP SCREW.SLDPRT, 93776A461_TYPE 18-8 SS SERRATED-FLANGE LOCKNUT.SLDPRT, LFR.001.SLDDRW]
2018-05-25 5/25/18 Updates
    Updated camera mounting assembly, updated all hardware selections.
    [2233K150_STRUT CHANNEL TAB-LOCK NUT.SLDPRT, 2615T130_VIBRATION-DAMPING CLAMPING HANGER.SLDPRT, 3261T210_STRUT CHANNEL.SLDPRT, 5 megapixel USB camera model ELP-USB500W02M-L21.SLDPRT, 90730A006_TYPE 18-8 STAINLESS STEEL NARROW HEX NUT.SLDPRT, 91115A819_18-8 SS FEM THRDED HEX STANDOFF.SLDPRT, 91770A544_18-8 SS TRUSS HEAD PHILLIPS MACHINE SCREW.SLDPRT, 92001A321_18-8 SS WING NUT.SLDPRT]
2018-05-28 5-28-18 Updates
    Cleaned up CAD assembly, created drawings for all modified parts, organized assembly components.
    [2615T140_VIBRATION-DAMPING CLAMPING HANGER (1).SLDPRT, 3261T210_STRUT CHANNEL.SLDPRT, 33085T310_STRUT CHANNEL.SLDPRT, 3580T110_STRUT CHANNEL STUD NUT.SLDPRT, 5_24_18_RFQ_LFR-001.DXF, 91849A029_TYPE 18-8 STAINLESS STEEL EXTRA-WIDE HEX NUT.SLDPRT, 92196A126_18-8 STAINLESS STEEL SOCKET HEAD CAP SCREW.SLDPRT, 92196A537_18-8 STAINLESS STEEL SOCKET HEAD CAP SCREW.SLDPRT]
2018-05-29 adding tim savas mechanical files for projects including pfc-edu, waterbot, hazelnut components, and food server rack
    [1.SLDPRT, 1.STL, 2.STL, 20gal_reservoir.SLDPRT, 2x4_tray.SLDPRT, 3.STL, 4.STL, 47865K230_BRASS BALL VALVE.SLDPRT]
2018-05-29 adding food server rack bom 2.0
    [fs_rack_bom_2.0.xlsx]
2018-05-29 adding a brief snapshot of pfc_edu assembly
2018-05-29 5-29-18
    Created assemblies and assembly drawings of cart rack sub-assemblies
    [94924A015_NYLON 6-6 WING NUTS.SLDPRT, LFR.001.SLDPRT, LFR.002.SLDPRT, LFR.005.SLDPRT, LFR.101.SLDASM, LFR.101.SLDDRW, LFR.102.SLDASM, LFR.102.SLDDRW]
2018-05-30 Added resevoir mold and tray
    for the pfc edu
    [pfc_res_mold.SLDPRT, pfc_res_tray.SLDPRT]
2018-06-07 6/7/18 Updates
    Updated drawings and part properties
    [2233K150_STRUT CHANNEL TAB-LOCK NUT.SLDPRT, 2615T130_VIBRATION-DAMPING CLAMPING HANGER.SLDPRT, 5 megapixel USB camera model ELP-USB500W02M-L21.SLDPRT, 90730A006_TYPE 18-8 STAINLESS STEEL NARROW HEX NUT.SLDPRT, 91115A819_18-8 SS FEM THRDED HEX STANDOFF.SLDPRT, 91770A544_18-8 SS TRUSS HEAD PHILLIPS MACHINE SCREW.SLDPRT, 92001A321_18-8 SS WING NUT.SLDPRT, 92147A410_TYPE 316 STAINLESS STEEL SPLIT LOC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]
2018-06-08 re-adding all files for bringing into openag solidworks station
    [brain_assembly.SLDASM, column_assembly.SLDASM, columns.SLDPRT, columns01.DXF, columns01.SLDPRT, columns01_tol.DXF, columns02.DXF, columns02.SLDPRT]
2018-06-26 6-26-18 Updates
    [2233K150_STRUT CHANNEL TAB-LOCK NUT.SLDPRT, 2615T130_VIBRATION-DAMPING CLAMPING HANGER.SLDPRT, 29585T200_BEAM CLAMP FOR PIPE TUBE AND CONDUIT.SLDPRT, 3338A22_HORIZONTAL_SURFACE_MOUNT_LEVEL.SLDPRT, 5 megapixel USB camera model ELP-USB500W02M-L21.SLDPRT, 5-15-18_Cart_Racks.SLDPRT, 6-12-18 OpenAg Container #3 BOM.xls, 7429K480_SNAP-IN PLASTIC CLAMP.SLDPRT]
2018-06-26 updated acrylic laser cut part thicknesses
    [6-12-18 OpenAg Container #3 BOM.xls, LFR.003.SLDPRT, LFR.004.SLDPRT, LFR.102.SLDASM]
2018-06-27 Added Hazelnut light files
    [20gal_reservoir.SLDPRT, 90_assembly.SLDASM, 92949A133_18-8 SS BUTTON-HEAD SOCKET CAP SCREW.SLDPRT, BACKFLOW.SLDPRT, HAZELNUTLIGHTASSEM.SLDASM, HAZELNUTLIGHTsubASSEM.SLDASM, HRD-008-175-BTN-SS.SLDPRT, HZL.001.SLDPRT]
2018-06-28 pfcedu
    Mechanical
    [pvc-025-res_test04.SLDPRT]
2018-06-30 v2.0 push
    created v2.0 as stable solidworks model
    [master_brain.SLDASM, pvc-025-brain07.SLDPRT, pvc-025-brain_test (1).SLDPRT, pvc-025-res_test04.SLDPRT, res_tray.SLDPRT]
2018-06-30 end of day
    [master_brain.SLDASM]
2018-07-01 etched names and output dxf files
    added etched names to each part. all names are driven by the part's configuration name. output dxf's for mill test.
    [BBFB_AGAR.DXF, BBI_AGAR.DXF, BBLR_AGAR.DXF, BBO_AGAR.DXF, pvc-025-brain_test (1).SLDPRT]
2018-07-01 units changed
    changed units from cm to in and export new dxf files
    [BBFB_AGAR.DXF, BBLR_AGAR.DXF, master_brain.SLDASM, pvc-025-brain_test (1).SLDPRT]
2018-07-01 added columns and full assembly
    adding columns to and a new full assembly of the bot
    [CDG1_AGAR.DXF, CDG2_AGAR.DXF, CI_AGAR.DXF, CI_AGAR.SLDPRT, CI_AGAR_C.DXF, COL_AGAR.DXF, COL_AGAR.SLDPRT, COR_AGAR.DXF]
2018-07-01 tolerance adjustment
    decreased tolerance on teeth of column side pieces. first run was too lose
    [COL_AGAR.DXF, COL_AGAR.SLDPRT, COR_AGAR.DXF, COR_AGAR.SLDPRT]
2018-07-02 fixed engraving spacing
    repaired text spacing on column pieces to fix vector issue in tool paths
    [COL_AGAR.DXF, COR_AGAR.DXF, COR_AGAR.SLDPRT]
2018-07-02 end of morning
    [COL_AGAR.SLDPRT, columns_assembly02.SLDASM, master_brain.SLDASM, pfc-edu_assembly.SLDASM]
2018-07-02 created bom for remaining container 03 buildout, internal use
    [fs_rack_bom_2.0.xlsx]
2018-07-02 adjustment to fs bom
2018-07-03 adding dxf files for brain panels
    [TBFB_AGAR.DXF, TBLR_AGAR.DXF, columns_assembly02.SLDASM, master_brain.SLDASM, pfc-edu_assembly.SLDASM, pvc-025-brain_test (1).SLDPRT]
2018-07-03 end of afternoon
    [master_brain.SLDASM, pfc-edu_assembly.SLDASM]
2018-07-04 adding model and dxf files for window fit testingand production
    [window.SLDPRT, window_2.5-1000.DXF, window_5-1000.DXF, window_true.DXF]
2018-07-04 adding new window dxf without text
    [window.DXF]
2018-07-04 adding 1/8" panels and knobbed window
    [SP_AGAR.SLDPRT, pfc-edu_assembly.SLDASM, window.SLDPRT, window02.DXF, window02.SLDPRT]
2018-07-04 Changed units of large window
    [window02.DXF, window02.SLDPRT]
2018-07-04 adding grow tray and side panel dxf files
    [SP_AGAR.DXF, TR_AGAR.DXF, TR_AGAR.SLDPRT, master_brain.SLDASM, pfc-edu_assembly.SLDASM, res_tray.SLDPRT]
2018-07-04 adjusted sp dxf file
    [TR_AGAR.DXF]
2018-07-04 adjusted sp and tr dxf files
    [SP_AGAR.DXF, SP_AGAR.SLDPRT, TR_AGAR.DXF]
2018-07-04 adjusted sp dxf
    [SP_AGAR.DXF, TR_AGAR.SLDPRT]
2018-07-04 fixed sp dxf
    [SP_AGAR.DXF, SP_AGAR.SLDPRT]
2018-07-06 Matched TBI panel to current eagle PCB sketch and added necessary holes. Did same for brain side panels. dxf files also added respectively.
    [PFCEDU_V2.dxf, PFCEDU_V2_drivers.dxf, PFCEDU_V2_outlines.dxf, TBB_AGAR.DXF, TBI_AGAR.DXF, TBL_AGAR.DXF, master_brain.SLDASM, pfc-edu_assembly.SLDASM]
2018-07-06 final dxf export for the day
    [master_brain.SLDASM]
2018-07-07 Drew and added dxf file for TBO_AGAR polycarb brain top
    [TBO_AGAR.DXF]
2018-07-19 adding pfc_edu chassis bom and assembly time table
    [bom_pfc_edu.xlsx]
2018-07-19 changed file location of pfc edu spreadsheets from this morning
    [bom_pfc_edu.xlsx]
2018-07-19 slightly adjusted cost/unit on pfc edu spreadsheet
    [bom_pfc_edu.xlsx]
2018-07-19 slight changes to pfc edu spreadsheet
    [bom_pfc_edu.xlsx]
2018-07-19 Heatsink for PFC EDU
    [heatsink.SLDPRT]
2018-07-23 created new dxf of tall front window
    [master_brain.SLDASM, pfc-edu_assembly.SLDASM, window02.SLDPRT, window_tall.DXF]
2018-07-24 making changes for BIT version of pfc_edu
    [COL_AGAR.SLDPRT, COR_AGAR.SLDPRT, COR_BIT.SLDPRT, columns03.SLDPRT, columns_assembly02.SLDASM, master_brain.SLDASM, pfc-edu_assembly.SLDASM]
2018-07-24 new dxf exports for BIT version of pfc_edu
    [BBFB_BIT.DXF, BBI_BIT.DXF, BBLR_BIT.DXF, BBO_BIT.DXF, BOX_ASMBLY.SLDASM, CF.SLDPRT, COL_ASMBLY.SLDASM, CPSTS.SLDPRT]
2018-07-24 adding dxf files for column assembly
    [CDG1_BIT.DXF, CDG2_BIT.DXF, CF.SLDPRT, CFC_BIT.DXF, CF_BIT.DXF, COL_BIT.DXF, COR_BIT.DXF, CPSTS.SLDPRT]
2018-07-24 last dxf files of day
    [BOX_ASMBLY.SLDASM, CF.SLDPRT, COL_ASMBLY.SLDASM, CSDS.SLDPRT, columns_assembly02.SLDASM, master_brain.SLDASM, pfc-edu_assembly.SLDASM]
2018-07-25 adding dxf files for latest modified brain side panels
    [TBFBH_BIT.DXF, TBLRH_BIT.DXF]
2018-07-25 7/25/18 CAD Updates
    Creation of Germinator V3 Database
    [1542N2 HDPE TANK.SLDPRT, 1661A100_LOAD-RATED PULL HANDLE WITH THREADED HOLES.SLDPRT, 3185K113_CONTINUOUS-FLEX NYLON CONDUIT FITTING.SLDPRT, 5372K134_DURABLE NYLON EXTRA-GRIP BARBED TUBE FITTING.SLDPRT, 5549K530_CLEAR VERSILON POLYURETHANE TUBING.SLDPRT, 91115A569_18-8 SS FEM THRDED HEX STANDOFF.SLDPRT, 91773A108_18-8 SS ROUND HEAD PHILLIPS MACHINE SCREW.SLDPRT, 91780A038_ALUM FEM THRDED HEX STAND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]
2018-07-26 adding 5-hole tray
    [BOX_ASMBLY.SLDASM, TR5_BIT.DXF, TR_BIT.SLDPRT, pfc-edu_assembly.SLDASM]
2018-07-27 PFC EDU PCB
    [optic outline.DXF]
2018-07-29 adding latest pocketing and profiling for pcb brain board on pfc_edu
    [BOX_ASMBLY.SLDASM, PFCEDU_V2.dxf, TBI_BIT.DXF, pfc-edu_assembly.SLDASM]
2018-08-03 adjusted pfc TBO panel with correct tooth spacing
    [BOX_ASMBLY.SLDASM, TBO_BIT.DXF, TR_BIT.SLDPRT, pfc-edu_assembly.SLDASM, tops.SLDPRT]
2018-08-03 fixed post hole spacing on clear brain top of pfc
    [BOX_ASMBLY.SLDASM, TBO_BIT.DXF, brain_assembly.SLDASM, pfc-edu_assembly.SLDASM, pvc-025-brain07.SLDPRT, tops.SLDPRT]
2018-08-03 adjusted tray hole size for horticube fit
    [TR_BIT.DXF, TR_BIT.SLDPRT, tops.SLDPRT]
2018-08-03 dropped height of fan support to accommodate heat sink
    [BOX_ASMBLY.SLDASM, TBS_BIT.DXF, original_rhino_import.SLDPRT, pfc-edu_assembly.SLDASM, pvc-025-brain07.SLDPRT, pvc-025-brain08.SLDPRT]
2018-08-06 Germinator Documentation Updates
    CAD screen shots and photographs
    [1542N2 HDPE TANK.SLDPRT, 1661A100_LOAD-RATED PULL HANDLE WITH THREADED HOLES.SLDPRT, 2974K851_DURABLE NYLON TIGHT-SEAL BARBED TUBE FITTING.SLDPRT, 3185K113_CONTINUOUS-FLEX NYLON CONDUIT FITTING.SLDPRT, 5372K134_DURABLE NYLON EXTRA-GRIP BARBED TUBE FITTING.SLDPRT, 5549K530_CLEAR VERSILON POLYURETHANE TUBING.SLDPRT, 91115A151_18-8 SS FEM THRDED HEX STANDOFF.SLDPRT, 91841A007_TYPE 18-8 STAINLESS STE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]
2018-08-07 adding price adjustments to pfc-edu bom
    [bom_pfc_edu.xlsx]
2018-08-08 previous users uncommitted files
    [AACH10 Active Aqua Chiller.SLDPRT, GMR.003.SLDPRT, GMR.503.SLDPRT, GMR.505.SLDPRT, XSPC X2O 420 Pump.SLDPRT, cart_assembly.SLDASM, pump.SLDPRT]
2018-08-08 8-8-18 Tim Updates
    [4x8_template.SLDDRW, BBFB_BIT.DXF, BBI_BIT.DXF, BBLR_BIT.DXF, BBO_BIT.DXF, BOX_ASMBLY.SLDASM, CDG1_BIT.DXF, CDG2_BIT.DXF]
2018-08-08 designed rededge camera mount for hz computer
    [rededge_assembly.SLDASM, rededge_mount.SLDPRT, standoff.sldprt.SLDPRT, standoff_316.SLDPRT, standoff_516.SLDPRT]
2018-08-08 added rededge mount dxf file
    [rededge_mount.DXF]
2018-08-08 correct rededge dxf
    [rededge_mount.DXF, rededge_mount.SLDPRT]
2018-08-08 8-8-2018 Eugene updates
    [cut_sheet.SLDASM, cut_sheet.SLDDRW]
2018-08-09 designed new acrylic reservoir
    [BOX_ASMBLY.SLDASM, COL_ASMBLY.SLDASM, pfc-edu_assembly.SLDASM, res_assembly.SLDASM, res_base.SLDPRT]
2018-08-10 hid archived column in fs-rack bom
    [fs_rack_bom_2.0.xlsx]
2018-08-10 remaining hz rededge mount files
    [rededge_assembly.SLDASM, standoff_516.SLDPRT]
2018-08-10 midway through new brain board design matching latest pcb layout
    [PFCEDU_V3.dxf, PFCEDU_V3_dims.dxf, dims.SLDPRT, electrical_template_sketch.SLDPRT]
2018-08-12 finished latest brain panel fit changes
    [TBI_v4.DXF, dims.SLDPRT, tops.SLDPRT]
2018-08-13 8-13-18 Tim PFC
    [8-13-18 Thermal Grease Testing.xlsx, BOX_ASMBLY.SLDASM, COL_ASMBLY.SLDASM, pfc-edu_assembly.SLDASM, res_assembly.SLDASM, res_base.SLDPRT]
2018-08-14 improved pfc edu cut file for today's cut jobs
    [BOX_ASMBLY.SLDASM, CF.SLDPRT, COL_ASMBLY.SLDASM, CPSTS.SLDPRT, CSDS.SLDPRT, cut_sheet.SLDASM, cut_sheet.SLDDRW, pfc-edu_assembly.SLDASM]
2018-08-14 new cut sheet dxf
    [cut_sheet.DXF, cut_sheet.SLDDRW]
2018-08-14 a second test on a cut sheet dxf file
    [cut_sheet02.DXF]
2018-08-14 made necessary quick edits to cut sheet for easy milling
    [COL_ASMBLY.SLDASM, CPSTS.SLDPRT, cut_sheet.DXF, cut_sheet.SLDASM, cut_sheet.SLDDRW, pfc-edu_assembly.SLDASM]
2018-08-14 testing dxf scaling options menu
    [cut_sheet.SLDDRW, cut_sheet_scaling_disabled.DXF, cut_sheet_scaling_enabled.DXF]
2018-08-27 cut sheet edits
2018-08-27 final drawings and dxf's for prototype of laser cut reservoir
    [COL_ASMBLY.SLDASM, pfc-edu_assembly.SLDASM, res_assembly.DXF, res_assembly.SLDASM, res_assembly.SLDDRW, res_base.SLDPRT]
2018-08-29 adustements to pfc edu brain board
    [BOX_ASMBLY.SLDASM, pfc-edu_assembly.SLDASM, res_assembly.SLDASM, res_base.SLDPRT]
2018-09-03 adding pfc edu tall window dxf file for 48x48 cut
    [tall_window_cut.DXF, tall_window_cut.SLDASM, window_short.SLDPRT, window_tall.SLDPRT]
2018-09-03 updates for tomorrow's 1/4in pfc edu cut file and schedule
    [cut_sheet.SLDASM, tall_window_cut.SLDDRW]
2018-09-04 added version marks and corrected units on pfc edu tall window
    [tall_window_cut.DXF, tall_window_cut.SLDASM, tall_window_cut.SLDDRW, window_tall.SLDPRT]
2018-09-05 new pockets and fillets for pfc edu brain board
    [PFCEDU_V3_september.dxf, TBI_v4.DXF, brain_sketch.SLDPRT]
2018-09-05 squared off inside hole for power on pfc edu brain box
    [TBFBH_BIT.DXF]
2018-09-05 new interior brain support with clearances for fan wires
    [BOX_ASMBLY.SLDASM, TBS.DXF, TBS.SLDPRT, pfc-edu_assembly.SLDASM]
2018-09-05 expanded tolerances on clear top
    [TBO.DXF]
2018-09-07 burn in test results and container CAD
    [2233K150_STRUT CHANNEL TAB-LOCK NUT.SLDPRT, 2615T130_VIBRATION-DAMPING CLAMPING HANGER.SLDPRT, 29585T200_BEAM CLAMP FOR PIPE TUBE AND CONDUIT.SLDPRT, 3338A22_HORIZONTAL_SURFACE_MOUNT_LEVEL.SLDPRT, 5 megapixel USB camera model ELP-USB500W02M-L21.SLDPRT, 5-15-18_Cart_Racks.SLDPRT, 7429K480_SNAP-IN PLASTIC CLAMP.SLDPRT, 76665A68_VHB_TAPE.SLDPRT]
2018-09-09 initial pfc_edu mechanical drawings
    [BBFB.SLDDRW, BBLR.SLDDRW, BOX_ASMBLY.SLDASM, CPSTS.SLDPRT, TBFB.SLDDRW, TBFBH.SLDDRW, TBLR.SLDDRW, TBLRH.SLDDRW]
2018-09-09 quick edits to column drawing
    [CSDS.SLDPRT]
2018-09-10 adding initial/demo mech drawing files for pfc edu
    [BBFB.SLDDRW, TBFB.SLDDRW, TBFBH.SLDDRW, cut_sheet.DXF, cut_sheet.SLDASM, cut_sheet.SLDDRW, cut_sheet02.DXF, cut_sheet_scaling_disabled.DXF]
2018-09-10 file tree renames and an stl file test
    [BBFB.DXF, BBFB.SLDDRW, BBI.DXF, BBLR.DXF, BBLR.SLDDRW, BBO.DXF, BOX_ASMBLY.SLDASM, CDG1.DXF]
2018-09-10 adding more stl files for simple 3D viewing of parts in browser on github
    [BBFB.STL, BBI.STL, BBLR.STL, BBO.STL, BOX_ASMBLY.SLDASM, COL.STL, COL_ASMBLY.SLDASM, COR.STL]
2018-09-10 creation of rack mounted fan hanging assembly
    [91115A569_18-8 SS FEM THRDED HEX STANDOFF.SLDPRT, 92949A146_18-8 SS BUTTON-HEAD SOCKET CAP SCREW.SLDPRT, 9492T130_ZINC-PLATED STEEL SCREW-IN BOLT HOOK.SLDPRT, 9602K410_CORROSION-RESISTANT EQUIPMENT-COOLING FAN.SLDPRT, 98437A104_TYPE 18-8 STAINLESS STEEL SPLIT LOCK WASHER.SLDPRT, BOX_ASMBLY.SLDASM, COL_ASMBLY.SLDASM, PFCEDU_V2.dxf]
2018-09-12 changes to side panel: tolerance at 2/1000" and filleted thumb tab
    [BOX_ASMBLY.SLDASM, COL_ASMBLY.SLDASM, CPSTS.SLDPRT, SP_BIT.SLDPRT, SP_new.DXF, SP_new.SLDPRT, pfc-edu_assembly.SLDASM]
2018-09-12 changed side panel dxf from metric to IPS
    [SP_new.DXF, SP_new.SLDPRT]
2018-09-13 made tray holes smaller to fit horticube. added .008" tolerance to tray edge for improved fit
    [BOX_ASMBLY.SLDASM, TR5.DXF, TR_BIT.SLDPRT]
2018-09-13 made tray holes smaller, added more tolerance .008" for better fit
    [5346K460_BRASS BARBED HOSE FITTING.SLDPRT, 5648K263_CHOOSE-A-COLOR POLYURETHANE TUBING.SLDPRT, 6308T12 Wye-Shaped On-Off Valve.SLDPRT, 73605T87 3-4 GHT Male x 1-2 NPT Male Adapter.SLDPRT, 93725K78 Ultra-Weather-Resistant EPDM Foam Strip.SLDPRT, 9602K410_CORROSION-RESISTANT EQUIPMENT-COOLING FAN.SLDPRT, PFCEDU_V2.dxf, TR_BIT.SLDPRT]
2018-09-16 designed a hood to prevent condensation on hz light boards
    [light_board_hood.DXF, light_board_hood.SLDPRT]
2018-09-16 added thumb notch to one column face for easy probe access. created new cut sheet
    [BOX_ASMBLY.SLDASM, CF.SLDPRT, COL_ASMBLY.SLDASM, TBS.SLDPRT, cut_sheet.DXF, cut_sheet.SLDASM, cut_sheet.SLDDRW, pfc-edu_assembly.SLDASM]
2018-09-16 minor changes to latest cut sheet
    [cut_sheet.DXF, cut_sheet.SLDASM]
2018-09-16 minor cut sheet changes
    [cut_sheet.SLDDRW]
2018-09-17 integrated latest model changes into 4x8 cut sheet
    [BOX_ASMBLY.SLDASM, cut_sheet.SLDASM, pfc-edu_assembly.SLDASM]
2018-09-17 cut file changes
2018-09-26 FERMENTABOT DESIGN UPDATES
    [1542N2 HDPE TANK.SLDPRT, 1661A100_LOAD-RATED PULL HANDLE WITH THREADED HOLES.SLDPRT, 1755K11 Clear Polycarbonate 90 Degree Angle.SLDPRT, 2974K851_DURABLE NYLON TIGHT-SEAL BARBED TUBE FITTING.SLDPRT, 3076T340_TIE-DOWN RING.SLDPRT, 3185K113_CONTINUOUS-FLEX NYLON CONDUIT FITTING.SLDPRT, 33815T310_STAINLESS STEEL TIE-DOWN RING.SLDPRT, 51055K210_DRINKING WATER PUSH-TO-CONNECT TUBE FITTING.SLDPRT]
2018-10-10 10-10-18 fermentabot updates
    [11185A190_SURFACE-MOUNT HINGE.SLDPRT, 11195A120_PLASTIC PIANO HINGE WITHOUT HOLES.SLDPRT, 1479T83 Plastic Funnel.SLDPRT, 1568A410_ROUND-GRIP PULL HANDLE WITH THREADED HOLES.SLDPRT, 1588A714_HARSH-ENVIRONMENT PLASTIC PIANO HINGE.SLDPRT, 33815T310_STAINLESS STEEL TIE-DOWN RING.SLDPRT, 69905K150_SEALED LINEAR SOLENOID.SLDPRT, 70155K431_LINEAR SOLENOID.SLDPRT]
2018-10-14 new pfc animation tests
    [BOX_ASMBLY.SLDASM, CF.SLDPRT, COL_ASMBLY.SLDASM, CPSTS.SLDPRT, CSDS.SLDPRT, TBS.SLDPRT, TR_BIT.SLDPRT, layout.SLDASM]
2018-10-14 pfc animations
    [pfc-edu_assembly.SLDASM]
2018-10-15 animation work
    [BOX_ASMBLY.SLDASM, COL_ASMBLY.SLDASM, CPSTS.SLDPRT, SP_new.SLDPRT, neoprene.SLDPRT, pfc-edu_assembly.SLDASM, sp_assembly.SLDASM, window01.SLDPRT]
2018-10-16 more pfc animations
    [91780A174_ALUM FEM THRDED HEX STANDOFF.SLDPRT, BOX_ASMBLY.SLDASM, Brain Box.SLDASM, COL_ASMBLY.SLDASM, CPSTS.SLDPRT, FMT.003.SLDPRT, FMT.006-COVER.DXF, FMT.006.SLDPRT]
2018-10-16 cleaning and finalizing file tree and nomenclature for pfc edu
    [BBFB.SLDDRW, BBLR.SLDDRW, BOX_ASMBLY.SLDASM, CF.SLDPRT, COL_ASMBLY.SLDASM, CPSTS.SLDPRT, CSDS.SLDPRT, FMT.011.SLDPRT]
2018-10-16 added file name changes to solidworks assembly file
2018-10-16 filling in remaining stl and dxf files for pfc
    [BOX_ASMBLY.SLDASM, CDG.SLDPRT, CPSTS.SLDPRT, CS.SLDPRT, CSDS.SLDPRT, CSL.DXF, CSL.STL, CSR.DXF]
2018-10-16 fermentabot and light rack
    [BOX_ASMBLY.SLDASM, COL_ASMBLY.SLDASM, CS.SLDPRT, LFR.001.SLDPRT, panelpress.DXF, pfc-edu_assembly.SLDASM]
2018-10-17 processed exploded view of pfc edu
    [BOX_ASMBLY.SLDASM, CF.SLDPRT, COL_ASMBLY.SLDASM, NEO.SLDPRT, SP.SLDPRT, SP_ASMBLY.SLDASM, TBS.SLDPRT, TR.SLDPRT]
2018-10-18 adding material spec sheets to pfc edu repo
2018-10-19 adding latest chassis BOM and manufacturing key
    [pfc_chassis_bom.xlsx, pfc_edu chassis bom.csv, pfc_edu manufacturing key.csv]
2018-10-19 file naming correction for bom and manufacturing key
    [pfc_edu bom.csv, pfc_edu chassis bom.csv]
2018-10-22 added vacuum formed reservoir stl file and bom details
    [RES.STL, pfc_edu bom.csv]
2018-10-22 adding remaining stl and dxf files
    [BOX_ASMBLY.SLDASM, CDG.SLDPRT, CDG.STL, CDGL.DXF, CDGR.DXF, CF.SLDPRT, CFC.STL, COL_ASMBLY.SLDASM]
2018-10-22 adding correct tall window stl, dxf, and solidworks files
    [BOX_ASMBLY.SLDASM, COL_ASMBLY.SLDASM, WDS.SLDPRT, WT.DXF, WT.SLDPRT, WT.STL, pfc-edu_assembly.SLDASM]
2018-10-22 created stl and dxf files with proper names for alternate reservoir assembly
    [BOX_ASMBLY.SLDASM, COL_ASMBLY.SLDASM, RSB.DXF, RSB.STL, RSFB.DXF, RSFB.STL, RSLR.DXF, RSLR.STL]
2018-10-22 res file rename
    [RST.STL, res_assembly.SLDASM, res_base.SLDPRT]
2018-10-22 nested new res assembly into boxes folder for better organization
    [RST.STL, res_assembly.DXF, res_assembly.SLDASM, res_assembly.SLDDRW, res_base.SLDPRT]
2018-10-22 adding dedicated folder for reservoir construction
    [RSB.DXF, RSB.STL, RSFB.DXF, RSFB.STL, RSLR.DXF, RSLR.STL, RST.DXF, RST.STL]
2018-10-22 moved reservoir folder to main body of pfc folder
    [RSB.DXF, RSB.STL, RSFB.DXF, RSFB.STL, RSLR.DXF, RSLR.STL, RST.DXF, RST.STL]
2018-10-22 file and folder rename for reservoir
    [RES.SLDASM, RES.SLDPRT]
2018-10-29 hazelnut light changes
    [FERMENTABOT_SIGN-1.DXF, FERMENTABOT_SIGN-2.DXF, FERMENTABOT_SIGN.SLDPRT, FMT.007-pump-bracket.DXF, FMT.007.SLDPRT, FMT.010.SLDPRT, HAZELNUTLIGHTASSEM.SLDASM, HAZELNUTLIGHTsubASSEM.SLDASM]
2018-10-29 removed sketch error in TBI and added new milk crate configuration
    [BOX_ASMBLY.SLDASM, CDG.SLDPRT, COL_ASMBLY.SLDASM, Nervous_System_Rack_Mount_Board.DXF, Nervous_System_Rack_Mount_Board.SLDPRT, pfc-edu_assembly.SLDASM]
2018-10-30 adding engraved bbfb
    [BBFB_engraved.DXF]
2018-11-05 LED Enclosure future design and Fermantabot Documentation
    [90044A299_BLACK-OXIDE ALLOY STEEL SOCKET HEAD SCREW.SLDPRT, 94922A009_NYLON 6-6 CAP NUTS.SLDPRT, 94924A009_NYLON 6-6 WING NUTS.SLDPRT, 96439A800_18-8 SS PRESS-IN NUT FOR SHEET MTL.SLDPRT, 98750A323_GRADE B7 MEDIUM-STRENGTH STEEL THREADED ROD.SLDPRT, 98831A610_NYLON THREADED ROD.SLDPRT, 99117A360_PAN HEAD COMBINATION DRIVE MACHINE SCREW.SLDPRT, LFR.001.SLDPRT]
2018-11-05 fermentabot updates
    [FMT.010.SLDPRT, LFR.008.SLDPRT, bottle.SLDPRT]
2018-11-06 11--18 updates
    [Fermentabot Data 11-6-18.xlsx, LFR.008.SLDPRT, LFR.201-back1.DXF, LFR.201-back2.DXF, LFR.201-front1.DXF, LFR.201-front2.DXF]
2018-11-08 11-8-18 Fermentabot Updates
    [11185A190_SURFACE-MOUNT HINGE.SLDPRT, 11195A120_PLASTIC PIANO HINGE WITHOUT HOLES.SLDPRT, 1479T83 Plastic Funnel.SLDPRT, 1542N2 HDPE TANK.SLDPRT, 1568A410_ROUND-GRIP PULL HANDLE WITH THREADED HOLES.SLDPRT, 1588A714_HARSH-ENVIRONMENT PLASTIC PIANO HINGE.SLDPRT, 1661A100_LOAD-RATED PULL HANDLE WITH THREADED HOLES.SLDPRT, 1755K11 Clear Polycarbonate 90 Degree Angle.SLDPRT]
2018-11-20 pfc mini design
    [FMT.201.SLDASM, LFR.008-11-15-18-inside.DXF, LFR.008-11-15-18.DXF, LFR.008.SLDPRT, PC-BOX-DESIGN-LASER-TEST-11-19-18.DXF, PC-BOX-DESIGN-LASER-TEST.DXF, PFC_EDU-LASER-TEST-11-19-18.DXF, PFC_EDU_CP_11-19-18.SLDPRT]
2018-11-27 pfc mini updates
    [CDG.SLDPRT, COL_ASMBLY.SLDASM, FMT.201.SLDASM, PFC_EDU_CP_11-19-18.SLDPRT, PFC_EDU_CP_11-21-18.DXF, PFC_MINI-LASER-TEST-11-21-18.DXF, PFC_MINI-MINI_CP_11-26-18.DXF, PFC_MINI-MINI_CP_11-26-18.SLDPRT]
2018-12-09 made new drawings for pfc parts
    [BOX_ASMBLY.SLDASM, COL_ASMBLY.SLDASM, cut_sheet.SLDASM, pfc-edu_assembly.SLDASM]
2018-12-10 progress on making z axis scalable
    [CS_scaled.SLDPRT]
2018-12-11 fermentabot changes, and tim's new hz light manifold
    [1479T83 Plastic Funnel.SLDPRT, 1661A100_LOAD-RATED PULL HANDLE WITH THREADED HOLES.SLDPRT, 1755K11 Clear Polycarbonate 90 Degree Angle.SLDPRT, 4946A100_EXPANDABLE LOCKING GROMMETS.SLDPRT, 70155K431_LINEAR SOLENOID.SLDPRT, 91780A560_ALUM FEM THRDED HEX STANDOFF.SLDPRT, 91830A101_18-8 STAINLESS STEEL KNURLED HEAD THUMB SCREW.SLDPRT, 92949A148_18-8 SS BUTTON-HEAD SOCKET CAP SCREW.SLDPRT]
2018-12-11 made drawing for tz led test heatsink and cleaned pfc scaling
    [BOX_ASMBLY.SLDASM, CDG.SLDPRT, CDG02.SLDPRT, CDG_scaled.SLDPRT, CF.SLDPRT, COL_ASMBLY.SLDASM, CSF_scaled.SLDPRT, CS_scaled.SLDPRT]
2018-12-11 z scaling for pfc chassiscompleted
    z scaling for pfc chassiscompleted
    [CDG_scaled.SLDPRT, CSF_scaled.SLDPRT, CS_scaled.SLDPRT, column_assembly.SLDASM, manifold_assembly.SLDASM, pfc_assembly_scaled.SLDASM]
2018-12-12 12-12-19 Updates
    [FMT.101.SLDPRT, FMT.201.SLDASM]
2018-12-13 12-13-18 Fermentabot updates
    [FMT.201.SLDASM, PFC_MINI-MINI_CP_11-26-18.SLDPRT, PFC_MINI-MINI_CP_12-13-18.DXF]
2018-12-14 working on preliminary framework fo lrg_hz light mechanical design
    [framework.SLDPRT]
2018-12-14 equation driven lattice framework completed for hz light mech design
    [FMT.201.SLDASM, framework.SLDPRT]
2018-12-26 Fermentabot Documentation Updates
    [11185A190_SURFACE-MOUNT HINGE.SLDPRT, 11195A120_PLASTIC PIANO HINGE WITHOUT HOLES.SLDPRT, 1479T83 Plastic Funnel.SLDPRT, 1542N2 HDPE TANK.SLDPRT, 1568A410_ROUND-GRIP PULL HANDLE WITH THREADED HOLES.SLDPRT, 1588A714_HARSH-ENVIRONMENT PLASTIC PIANO HINGE.SLDPRT, 1601N123.SLDPRT, 1661A100_LOAD-RATED PULL HANDLE WITH THREADED HOLES.SLDPRT]
2018-12-27 12-27-18 updates
    [1479T83 Plastic Funnel.SLDPRT, 1601N123.SLDPRT, 1661A100_LOAD-RATED PULL HANDLE WITH THREADED HOLES.SLDPRT, 1755K11 Clear Polycarbonate 90 Degree Angle.SLDPRT, 4946A100_EXPANDABLE LOCKING GROMMETS.SLDPRT, 91780A560_ALUM FEM THRDED HEX STANDOFF.SLDPRT, 91830A101_18-8 STAINLESS STEEL KNURLED HEAD THUMB SCREW.SLDPRT, 92949A148_18-8 SS BUTTON-HEAD SOCKET CAP SCREW.SLDPRT]
2019-01-14 adding hz light test validation with light simulation software
    [1863A210_DRAW LATCH.SLDPRT, 91115A135_18-8 SS FEM THRDED HEX STANDOFF.SLDPRT, 91115A834_18-8 SS FEM THRDED HEX STANDOFF.SLDPRT, Bridgelux.SLDPRT, FITNATE Mist Maker.SLDPRT, FMT.101-backboard.DXF, FMT.101-cover.DXF, FMT.101-front.DXF]
2019-01-17 new hz light tests
    [Corrugated PFC Benchmark Data 1-11-19.xlsx, Fermentabot Burn-In Data 1-11-19.xlsx, PFC.101_Master.SLDPRT, PFC.101_Master_CUT_FILE.DXF, full test assembly.SLDASM, photopia_tutorial_assembly.SLDASM, sml_hazelnut box.SLDPRT, test part.SLDPRT]
2019-01-22 3x cob hazelnut light prototype
    [bridgelux_mock.SLDPRT, erp_driver_mock.SLDPRT, heatsink_large.SLDDRW, heatsink_large.SLDPRT, heatsink_small.SLDPRT, heatsink_xlarge.SLDPRT, large heatsink assembly.SLDASM, optic_collar.SLDPRT]
2019-01-22 todays drawings
    [collar_holes.SLDDRW, erp_driver_mock.SLDPRT, heatsink_large.SLDDRW, heatsink_large.SLDPRT, large heatsink assembly.SLDASM, number_fives.SLDDRW, quarter_inch.SLDDRW]
2019-01-23 fermentabot changes
    [1542N2 HDPE TANK.SLDPRT, 1863A210_DRAW LATCH.SLDPRT, 4596K121_THICK-WALL DARK GRAY PVC PIPE FITTING.SLDPRT, 50785K142_MED-PRESSURE BRASS THREADED PIPE FITTING.SLDPRT, 5779K119_PUSH-TO-CONNECT TUBE FITTING FOR AIR.SLDPRT, 5779K162_PUSH-TO-CONNECT TUBE FITTING FOR AIR.SLDPRT, 5779K163_PUSH-TO-CONNECT TUBE FITTING FOR AIR.SLDPRT, 5779K455_PUSH-TO-CONNECT TUBE FITTING FOR AIR.SLDPRT]
2019-01-23 1-23-19 Updates to corrugated PFC database
    [1825 test assembly.SLDASM, Fermentabot Burn-In Data 1-11-19.xlsx, PFC.100.SLDASM, PFC.100_Master.SLDPRT, PFC.101.SLDPRT, PFC.102.SLDPRT, PFC.103.SLDPRT, PFC.104.SLDPRT]
2019-01-24 1-24-19 fermentabot updates
    [1661A100_LOAD-RATED PULL HANDLE WITH THREADED HOLES.SLDPRT, 1825_ceiling_assemby.SLDASM, FMT.003.SLDPRT, Fermentabot 2hour Burn-In Data 1-02-19.xlsx, Fermentabot Burn-In Data 1-11-19.xlsx, Fermentabot Burn-In Data 1-24-19.xlsx, Project Spending Log.xlsx, photopia_tutorial_assembly.SLDASM]
2019-01-25 1-25-18 fermentabot documentation updates
    [11185A190_SURFACE-MOUNT HINGE.SLDPRT, 11195A120_PLASTIC PIANO HINGE WITHOUT HOLES.SLDPRT, 1479T83 Plastic Funnel.SLDPRT, 1542N2 HDPE TANK.SLDPRT, 1568A410_ROUND-GRIP PULL HANDLE WITH THREADED HOLES.SLDPRT, 1588A714_HARSH-ENVIRONMENT PLASTIC PIANO HINGE.SLDPRT, 1601N123.SLDPRT, 1661A100_LOAD-RATED PULL HANDLE WITH THREADED HOLES.SLDPRT]
2019-02-04 2-4-19 Fermentabot and PFC updates
    [Fermentabot Functional Testing Data 1-28-19.xlsx, PFC.100.SLDASM, PFC.100_Master.SLDPRT, PFC.100_Master_0.15_CORRUGATED PLASTIC.DXF, PFC.100_Master_0.15_CORRUGATED PLASTIC_2.DXF, PFC.101.SLDPRT, PFC.102.SLDPRT, PFC.103.SLDPRT]
2019-02-08 moved new hazelnut light to v2.0 folder
    [8020_150.SLDPRT, Bridgelux-VeroSE29-M-STP-17-000021-RA.SLDPRT, Bridgelux-VeroSE29-M-STP-17-000021-RA.STEP, aavid_heatsink.SLDPRT, aluminum_rail.SLDPRT, box_panel.SLDPRT, bridgelux.SLDPRT, bridgelux_mock.SLDPRT]
2019-02-08 added more spec sheets to v2.0 hz light folder
    [khatod_1825_mock.SLDPRT, master_assembly.SLDASM, optic_collar.SLDPRT, rail_assembly.SLDASM, small_hz_module assembly.SLDASM]
2019-02-11 added improved framework modularity for lrg hz testing
    [large_framework assembly.SLDASM, lrg_hz_chamber_adv.SLDPRT, optic_collar.SLDPRT, small_hz_module assembly.SLDASM]
2019-02-12 light simulation work for large hz computer
    [Mirrorbridgelux.SLDPRT, large_framework assembly.SLDASM, lrg_hz_chamber_adv.SLDPRT, lrg_tree_mock.SLDPRT, small_hz_module assembly.SLDASM, small_hz_module_test assembly.SLDASM]
2019-02-14 2-14-19 LHC database creation on github
    [1.SLDPRT, 112.5kVA Three Phase Energy Efficient Transformer Input Voltage 480VAC Delta.SLDPRT, 1825 test assembly.SLDASM, 1825_ceiling_assemby.SLDASM, 1964K830_LOW-PROFILE RECTANGULAR DUCT.SLDPRT, 1976K270_AC EQUIPMENT COOLING FAN.SLDPRT, 2233K150_STRUT CHANNEL TAB-LOCK NUT.SLDPRT, 2615T130_VIBRATION-DAMPING CLAMPING HANGER.SLDPRT]
2019-02-14 light assembly design
    [Mirrorbridgelux.SLDPRT, Part6.SLDPRT, gasket.SLDPRT, gasket_correct2.SLDPRT, khatod_1825_mock.SLDPRT, khatod_1845.SLDPRT, lrg_hz_light_pcb_01.DXF, lrg_hz_module_assembly.SLDASM]
2019-02-15 final changes to current lrg hz light module draft
2019-02-15 renaming hazelnut project files according to nomenclature
    [Mirrorbridgelux.SLDPRT, gasket.SLDPRT, lhc-301.SLDASM, lhc-302.SLDPRT, lhc-303.SLDPRT, lhc-304.SLDPRT, lhc-305.SLDPRT, lhc-306.SLDPRT]
2019-02-15 transferred hz light files into correct folder
    [lhc-301.SLDASM, lhc-302.SLDPRT, lhc-303.SLDPRT, lhc-304.SLDPRT, lhc-305.SLDPRT, lhc-306.SLDPRT, lhc-307.SLDPRT]
2019-02-15 renamed stock parts for hz light assembly
    [1845_KHATOD OPTIC.SLDPRT, 416201U00000G-ND_12IN HEATSINK.SLDPRT, lhc-301.SLDASM]
2019-02-15 more part file renames
    [1621-1007-ND_KHATOD OPTIC COLLAR.SLDPRT, Part6.SLDPRT, bridgelux.SLDPRT, bridgelux_mock.SLDPRT, erp_driver_mock.SLDPRT, khatod_1825_mock.SLDPRT, lrg_hz_light_pcb_01.DXF, small_hz_module assembly.SLDASM]
2019-02-15 part file renames
    [1800-1101-ND_ERP DRIVER.SLDPRT, 976-1596-ND_BRIDGELUX VERO29.SLDPRT, bridgelux_mock.SLDPRT, khatod_1825_mock.SLDPRT, lhc-307.DXF]
2019-02-15 renamed hazelnut master folder names
    [1.SLDPRT, 112.5kVA Three Phase Energy Efficient Transformer Input Voltage 480VAC Delta.SLDPRT, 1621-1007-ND_KHATOD OPTIC COLLAR.SLDPRT, 1621-1007-ND_KHATOD.SLDPRT, 1621-1111-ND_KHATOD OPTIC 1845.SLDPRT, 1800-1101-ND_ERP DRIVER.SLDPRT, 1825 test assembly.SLDASM, 1825_ceiling_assemby.SLDASM]
2019-02-19 eugene's hz light changes
    [1621-1111-ND_KHATOD OPTIC 1845.SLDPRT, 1800-1101-ND_ERP DRIVER.SLDPRT, 416201U00000G-ND_12IN HEATSINK.SLDPRT, 5164T520_HEAVY DUTY POSITIONING ARM.SLDPRT, 5164T620_POSITIONING ARM.SLDPRT, 5164T850_POSITIONING ARM.SLDPRT, 5164T944_POSITIONING ARM.SLDPRT, 5648K263_CHOOSE-A-COLOR POLYURETHANE TUBING.SLDPRT]
2019-02-19 adjusted external references in lrg hz light assembly, added fillets
    [lhc-301.SLDASM, lhc-303.SLDPRT, lhc-304.SLDPRT, lhc-305.SLDPRT]
2019-02-19 adding lrg hz light pcb dxf
    [lhc-303.DXF, lhc-303.SLDPRT]
2019-02-19 adding mechanical drawing and pdf of lrg hz light pcb
    [lhc-303.SLDDRW, lhc-303.SLDPRT]
2019-02-19 support files
    [lhc-301.SLDASM]
2019-02-19 repaired mates and fully defined pfc edu assembly
    [BOX_ASMBLY.SLDASM, COL_ASMBLY.SLDASM, lhc-301.SLDASM, pfc-edu_assembly.SLDASM]
2019-02-20 new enclosure design for lrg hz light module
    [lhc-301.SLDASM, lhc-306.SLDPRT, lhc-307.SLDPRT]
2019-02-20 last enclosure changes on lrg hz light fixture
    [lhc-301.SLDASM, lhc-306.DXF, lhc-306.SLDPRT, lhc-307.SLDPRT]
2019-02-20 light modeling for lrg hz
    [large_framework assembly.SLDASM, lhc-301.SLDASM, lhc-303.SLDPRT, lhc-308.SLDASM, lrg_hz_chamber_adv.SLDPRT]
2019-02-21 updating light simulation environment
    [lhc-308.SLDASM]
2019-02-21 added wall to light test environment
    [lhc-308.SLDASM, lhc-309.SLDPRT, lhc-310.SLDASM, lhc-311.SLDASM, lhc-311.SLDPRT, lrg_hz_chamber_adv.SLDPRT]
2019-02-21 adding hz light pcb dxf for laser cutter
    [lhc-303.1.DXF]
2019-02-22 2-22-19 lhc
    [1621-1111-ND_KHATOD OPTIC 1845.SLDPRT, 3216K560_HARSH ENVIRONMENT MINI CONNECTOR.SLDPRT, 416201U00000G-ND_12IN HEATSINK.SLDPRT, 5648K263_CHOOSE-A-COLOR POLYURETHANE TUBING.SLDPRT, 91772A211_18-8 SS PAN HEAD PHILLIPS MACHINE SCREW.SLDPRT, 91793A540_18-8 SS BINDING HEAD SLOTTED MACHINE SCREW.SLDPRT, 92001A291_18-8 SS WING NUT.SLDPRT, 92001A321_18-8 SS WING NUT.SLDPRT]
2019-02-22 2-22-19 Fermentabot
    [12V Solar Circulation Pump.SLDPRT, 1542N2 HDPE TANK.SLDPRT, 5111K584_PUSH-TO-CONNECT TUBE FITTING FOR AIR WATER.SLDPRT, 5111K870_PUSH-TO-CONNECT TUBE FITTING FOR AIR WATER.SLDPRT, 51235K114_UNIVERSAL THREAD PUSH-TO-CONNECT TUBE FITTING.SLDPRT, 51235K117_UNIVERSAL THREAD PUSH-TO-CONNECT TUBE FITTING.SLDPRT, 5346K460_BRASS BARBED HOSE FITTING.SLDPRT, 90415A460_PAN HEAD DRILLING SCREW FOR METAL.SLDP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]
2019-02-24 ran two-cob light simulation in solidworks
    [lhc-311.SLDASM, lhc-311.SLDPRT]
2019-02-25 ran 18" 2-COB test with 1845 square optic
    [lhc-311.SLDASM]
2019-02-25 2-25-19 updates
    [12V Solar Circulation Pump.SLDPRT, 1479T83 Plastic Funnel.SLDPRT, 1542N2 HDPE TANK.SLDPRT, 1601N123.SLDPRT, 1661A100_LOAD-RATED PULL HANDLE WITH THREADED HOLES.SLDPRT, 1755K11 Clear Polycarbonate 90 Degree Angle.SLDPRT, 1863A210_DRAW LATCH.SLDPRT, 2974K851_DURABLE NYLON TIGHT-SEAL BARBED TUBE FITTING.SLDPRT]
2019-02-27 continuing light simulation testing
    [lhc-309.SLDPRT, lhc-310.SLDASM, lhc-311.SLDASM, lhc-312.SLDPRT, lhc-313.SLDPRT, lhc-314.SLDASM, lhc-315.SLDASM, lhc-315.SLDPRT]
2019-03-05 extended 12" 3x COB design to 24" 6x COB design
    [1621-1007-ND_KHATOD OPTIC 1825.SLDPRT, 416201U00000G-ND_12IN HEATSINK.SLDPRT, lhc-301.SLDASM, lhc-302.SLDPRT, lhc-303.SLDPRT, lhc-304.SLDPRT, lhc-305.SLDPRT, lhc-306.SLDPRT]
2019-03-05 3-5-19 Fermentabot
    [12V Solar Circulation Pump.SLDPRT, 1479T83 Plastic Funnel.SLDPRT, 1542N2 HDPE TANK.SLDPRT, 1601N123.SLDPRT, 1661A100_LOAD-RATED PULL HANDLE WITH THREADED HOLES.SLDPRT, 1755K11 Clear Polycarbonate 90 Degree Angle.SLDPRT, 1863A210_DRAW LATCH.SLDPRT, 2974K851_DURABLE NYLON TIGHT-SEAL BARBED TUBE FITTING.SLDPRT]
2019-03-09 fermentabot updates 3-8-19
    [7432K63 Spiral Bundling Wrap.SLDPRT, 93085K11 Surface-Mount, Hollow, 375 Wide, 1875 ID Rubber Seal.SLDPRT, FITNATE Mist Maker.SLDPRT, FMT.011-bottom.DXF, FMT.011.SLDPRT, FMT.101.SLDPRT, FMT.203.SLDPRT, FMT.204.SLDPRT]
2019-03-12 resolving github conflict, republishing lhc-300 folder
    [1621-1007-ND_KHATOD OPTIC 1825.SLDPRT, 416201U00000G-ND_12IN HEATSINK.SLDDRW, 416201U00000G-ND_12IN HEATSINK.SLDPRT, 416201U00000G-ND_24IN HEATSINK.SLDDRW, 976-1596-ND_BRIDGELUX VERO29.SLDPRT, 98164A115_TYPE 316 SS BUTTON-HEAD SOCKET CAP SCREW.SLDPRT, lhc-217.SLDPRT, lhc-301.SLDASM]
2019-03-12 adding photopia licensing doc
    [lhc-316.SLDASM, lhc-322.SLDPRT]
2019-03-12 Fermentabot Documentation 3-12-19
    [Fermentabot Testing Data 2-21-19.xlsx, HEATER POWER SUPPLY.SLDPRT]
2019-03-12 adding photometric data
    [Large Hazelnut Light Assembly BOM.xlsx, Large Hazelnut Light Test Data.xlsx]
2019-03-12 adding remaining data and docs to lrg hz project
    [Single COB Tests.xlsx]
2019-03-13 adding new end cap design to lrg hz light
    [lhc-323.SLDPRT]
2019-03-13 adding 12-pole connector to design and BOM
    [3216K670_HARSH ENVIRONMENT MINI CONNECTOR.SLDPRT, Large Hazelnut Light Assembly BOM.xlsx, lhc-301.SLDASM, lhc-303.SLDPRT, lhc-305.SLDPRT, lhc-307.SLDPRT, lhc-323.SLDPRT]
2019-03-13 repattern num8 clearance holes in lrg hz light assembly
2019-03-13 adding mounting bracket to lrg hz light and bom changes
    [Large Hazelnut Light Assembly BOM.xlsx, lhc-301.SLDASM, lhc-303.SLDPRT, lhc-305.SLDPRT]
2019-03-14 ez's fermentabot changes
    [4757K220_MINIATURE PVC BALL VALVE.SLDPRT]
2019-03-14 adding correct lhc-316 assembly
    [1621-1007-ND_KHATOD OPTIC 1825.SLDPRT, 1621-1007-ND_KHATOD OPTIC COLLAR.SLDPRT, 1621-1111-ND_KHATOD OPTIC 1845.SLDPRT, 1800-1101-ND_ERP DRIVER.SLDPRT, 3216K560_HARSH ENVIRONMENT MINI CONNECTOR.SLDPRT, 3216K670_HARSH ENVIRONMENT MINI CONNECTOR.SLDPRT, 416201U00000G-ND_12IN HEATSINK.SLDDRW, 416201U00000G-ND_12IN HEATSINK.SLDPRT]
2019-03-14 removed lhc-316 assembly archived version
    [1621-1007-ND_KHATOD OPTIC 1825.SLDPRT, 1621-1007-ND_KHATOD OPTIC COLLAR.SLDPRT, 1621-1111-ND_KHATOD OPTIC 1845.SLDPRT, 1800-1101-ND_ERP DRIVER.SLDPRT, 3216K560_HARSH ENVIRONMENT MINI CONNECTOR.SLDPRT, 3216K670_HARSH ENVIRONMENT MINI CONNECTOR.SLDPRT, 416201U00000G-ND_12IN HEATSINK.SLDDRW, 416201U00000G-ND_12IN HEATSINK.SLDPRT]
2019-03-14 adding spec and mech drawing sheets and cad file for 6-pole receptacle
    [C01630G00610012.sldprt]
2019-03-14 ezs fermentabot changes
    [lhc-316.SLDASM, lhc-317.SLDPRT, lhc-318.SLDPRT, lhc-319.SLDPRT, lhc-322.SLDPRT, lhc-323.SLDPRT]
2019-03-14 3-14-19 LHC design Update
    [1621-1111-ND_KHATOD OPTIC 1845.SLDPRT, 1800-1101-ND_ERP DRIVER.SLDPRT, 3216K670_HARSH ENVIRONMENT MINI CONNECTOR.SLDPRT, 416201U00000G-ND_12IN HEATSINK.SLDDRW, 416201U00000G-ND_12IN HEATSINK.SLDPRT, 416201U00000G-ND_24IN HEATSINK.SLDDRW, 4946A200_EXPANDABLE LOCKING GROMMETS.SLDPRT, 91772A211_18-8 SS PAN HEAD PHILLIPS MACHINE SCREW.SLDPRT]
2019-03-15 produced heatsink drawing, changed hole alignments
    [1621-1007-ND_KHATOD OPTIC 1825.SLDPRT, 416201U00000G-ND_12IN HEATSINK.SLDDRW, 416201U00000G-ND_12IN HEATSINK.SLDPRT, 4946A200_EXPANDABLE LOCKING GROMMETS.SLDPRT, 5648K263_CHOOSE-A-COLOR POLYURETHANE TUBING.SLDPRT, 91793A540_18-8 SS BINDING HEAD SLOTTED MACHINE SCREW.SLDPRT, 92001A321_18-8 SS WING NUT.SLDPRT, 92196A537_18-8 STAINLESS STEEL SOCKET HEAD CAP SCREW.SLDPRT]
2019-03-15 3-15-29 LHC arm design update
    [1621-1007-ND_KHATOD OPTIC 1825.SLDPRT, 416201U00000G-ND_12IN HEATSINK.SLDPRT, 4946A200_EXPANDABLE LOCKING GROMMETS.SLDPRT, 5164T520_HEAVY DUTY POSITIONING ARM.SLDPRT, 5164T620_POSITIONING ARM.SLDPRT, 5164T850_POSITIONING ARM.SLDPRT, 5164T944_POSITIONING ARM.SLDPRT, 5648K263_CHOOSE-A-COLOR POLYURETHANE TUBING.SLDPRT]
2019-03-18 LHC arm design CAD update
    [1621-1007-ND_KHATOD OPTIC 1825.SLDPRT, 416201U00000G-ND_12IN HEATSINK.SLDDRW, 416201U00000G-ND_12IN HEATSINK.SLDPRT, 4946A200_EXPANDABLE LOCKING GROMMETS.SLDPRT, 5164T520_HEAVY DUTY POSITIONING ARM.SLDPRT, 5164T620_POSITIONING ARM.SLDPRT, 5164T850_POSITIONING ARM.SLDPRT, 5164T944_POSITIONING ARM.SLDPRT]
2019-03-19 adding new light heatsink drawing
    [416201U00000G-ND_12IN HEATSINK.SLDDRW]
2019-03-19 adding aluminum plate dxf for cutting
    [lhc-305.DXF]
2019-03-19 3-19-2019 LHC
    [416201U00000G-ND_12IN HEATSINK.SLDPRT, 90866A009_ZINC-PLATED STEEL AND IRON WING NUTS.SLDPRT, 92196A146_18-8 STAINLESS STEEL SOCKET HEAD CAP SCREW.SLDPRT, 96278A007_TYPE 18-8 SS HEX NUT WITH TOOTH WASHER (1).SLDPRT, C01630G00610012.sldprt, Large Hazelnut Light Assembly BOM.xlsx, lhc-301.SLDASM, lhc-302.SLDPRT]
2019-03-20 adding spreadsheet of pfc edu part perimeter lengths
    [part_perimeters.xlsx]
2019-03-20 ADDING DRIVER DESIGN
    [1866-2464-ND MEANWELL DRIVER.SLDPRT]
2019-03-21 3-21-19 LHC updates
    [3193T140_STAND-OFF STRUT-MNT MTL ROUTING CLAMP.SLDPRT, 33085T541_STRUT CHANNEL.SLDPRT, 5175K212_COPPER TUBING FOR DRINKING WATER.SLDPRT, Large Hazelnut Light Assembly BOM.xlsx, lhc-301.SLDASM, lhc-302.SLDPRT, lhc-305.SLDPRT, lhc-306.SLDDRW]
2019-03-22 adding photometric test data for far red light testing and full 6-LED unit testing for lrg hz light system
    [2019-03-21_tests.xlsx]
2019-03-22 changed driver line in lrg hz light BOM
    [Large Hazelnut Light Assembly BOM.xlsx]
2019-03-22 added through holes for cob placement jig
    [OPTIC_PLACEMENT_JIG.DXF, OPTIC_PLACEMENT_JIG.SLDPRT, lhc-301.SLDASM]
2019-03-25 325-19 LHC updates
    [1621-1007-ND_KHATOD OPTIC 1825.SLDPRT, 1964K830_LOW-PROFILE RECTANGULAR DUCT.SLDPRT, 1DGL-JC-50W-RE Red LED.SLDPRT, 3193T140_STAND-OFF STRUT-MNT MTL ROUTING CLAMP.SLDPRT, 33085T541_STRUT CHANNEL.SLDPRT, 416201U00000G-ND_12IN HEATSINK.SLDPRT, 4946A200_EXPANDABLE LOCKING GROMMETS.SLDPRT, 5164T520_HEAVY DUTY POSITIONING ARM.SLDPRT]
2019-03-26 3-26-19 LHC Updates
    [5175K212_COPPER TUBING FOR DRINKING WATER.SLDPRT, 5233K560_MASTERKLEER PVC TUBING (2).SLDPRT, 8694K111 Adhesive Back EPDM Foam.SLDPRT, 92001A311_18-8 SS WING NUT.SLDPRT, 95345A099_PAN HEAD PHIL MACHINE SCREW WITH LOCK WASHER.SLDPRT, 95345A548_PAN HEAD PHIL MACHINE SCREW WITH LOCK WASHER.SLDPRT, 95345A554_PAN HEAD PHIL MACHINE SCREW WITH LOCK WASHER.SLDPRT, 95345A555_PAN HEAD PHIL MACHINE SCREW WI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]
2019-03-27 3-27-19 LHC Updates
    [1621-1007-ND_KHATOD OPTIC 1825.SLDPRT, 1DGL-JC-50W-RE Red LED.SLDPRT, 3193T140_STAND-OFF STRUT-MNT MTL ROUTING CLAMP.SLDPRT, 33085T541_STRUT CHANNEL.SLDPRT, 416201U00000G-ND_12IN HEATSINK.SLDPRT, 4946A200_EXPANDABLE LOCKING GROMMETS.SLDPRT, 5175K212_COPPER TUBING FOR DRINKING WATER.SLDPRT, 5233K560_MASTERKLEER PVC TUBING (2).SLDPRT]
2019-03-28 3-28-19 LHC Updates right before Eugene leaves for 10 days
    [1621-1007-ND_KHATOD OPTIC 1825.SLDPRT, 1DGL-JC-50W-RE Red LED.SLDPRT, 3193T140_STAND-OFF STRUT-MNT MTL ROUTING CLAMP.SLDPRT, 3261T310_STRUT CHANNEL.SLDPRT, 3261T340_STRUT CHANNEL.SLDPRT, 33085T541_STRUT CHANNEL.SLDPRT, 416201U00000G-ND_12IN HEATSINK.SLDPRT, 4379K620_FDA PLASTIC BALL VALVE.SLDPRT]
2019-04-01 eugene's latest lrg hz light changes
    [lhc-301.SLDASM]
2019-04-01 adding latest heat sink mechanical drrawing for lrg hz light
    [416201U00000G-ND_12IN HEATSINK.SLDDRW]
2019-04-01 adding iges, step, and dwg files for pfc edu
    [BOX_ASMBLY.SLDASM, CDG.SLDPRT, CF.SLDPRT, COL_ASMBLY.SLDASM, CS.SLDPRT, SP.SLDPRT, SP_ASMBLY.SLDASM, TBS.SLDPRT]
2019-04-02 adding photometric data, single measurement point of natural far red outdoors upon sunrise
    [2019-03-21_tests.xlsx]
2019-04-02 bom saved
2019-04-09 4-9-19 lhc updates
    [1030A110_BRACKET.SLDPRT, 1621-1007-ND_KHATOD OPTIC 1825.SLDPRT, 1964K830_LOW-PROFILE RECTANGULAR DUCT.SLDPRT, 1976K270_AC EQUIPMENT COOLING FAN.SLDPRT, 1DGL-JC-50W-RE Red LED.SLDPRT, 3193T140_STAND-OFF STRUT-MNT MTL ROUTING CLAMP.SLDPRT, 3208T174_BACK-TO-BACK STACKED STRUT CHANNEL.SLDPRT, 3261T310_STRUT CHANNEL.SLDPRT]
2019-04-18 4-18-19 update
    [1621-1007-ND_KHATOD OPTIC 1825.SLDPRT, 1976K270_AC EQUIPMENT COOLING FAN.SLDPRT, 1DGL-JC-50W-RE Red LED.SLDPRT, 2019-4-11 LHC LIGHT LAYOUT IN SMALL HAZELNUT.SLDPRT, 3193T140_STAND-OFF STRUT-MNT MTL ROUTING CLAMP.SLDPRT, 3208T174_BACK-TO-BACK STACKED STRUT CHANNEL.SLDPRT, 33085T541_STRUT CHANNEL.SLDPRT, 3310T400_STRUT CHANNEL.SLDPRT]
2019-05-01 adding note with specs on heat exchange system for lrg hz light
2019-05-01 5-1-19 Updates
    [91525A109_TYPE 316 STAINLESS STEEL FLAT WASHER.SLDPRT, HEAT SINK HOLE JIG.SLDPRT, Large Hazelnut Light Assembly BOM.xlsx, OPTIC_PLACEMENT_JIG.DXF, OPTIC_PLACEMENT_JIG.SLDPRT, lhc-008.SLDPRT, lhc-301.SLDASM, lhc-305.SLDPRT]
2019-05-02 new heat sink mech drawing for milling
    [416201U00000G-ND_12IN HEATSINK.SLDDRW]
2019-05-02 bom change
2019-05-02 5-2-19 updates
    [112.5kVA Three Phase Energy Efficient Transformer Input Voltage 480VAC Delta.SLDPRT, 1621-1007-ND_KHATOD OPTIC 1825.SLDPRT, 1964K830_LOW-PROFILE RECTANGULAR DUCT.SLDPRT, 1976K270_AC EQUIPMENT COOLING FAN.SLDPRT, 1DGL-JC-50W-RE Red LED.SLDPRT, 3193T140_STAND-OFF STRUT-MNT MTL ROUTING CLAMP.SLDPRT, 3208T174_BACK-TO-BACK STACKED STRUT CHANNEL.SLDPRT, 33085T541_STRUT CHANNEL.SLDPRT]
2019-05-08 5-8-19 LHC Updates
    [10-137-05_PGN1 HEATER.SLDPRT, 1262T567_304 STAINLESS STEEL U-CHANNEL.SLDPRT, 1621-1007-ND_KHATOD OPTIC 1825.SLDPRT, 1764K470_DUCT FLANGE.SLDPRT, 1964K830_LOW-PROFILE RECTANGULAR DUCT.SLDPRT, 1DGL-JC-50W-RE Red LED.SLDPRT, 3193T140_STAND-OFF STRUT-MNT MTL ROUTING CLAMP.SLDPRT, 33085T541_STRUT CHANNEL.SLDPRT]
2019-05-09 5-9-19 LHC updates
    [1621-1007-ND_KHATOD OPTIC 1825.SLDPRT, 1DGL-JC-50W-RE Red LED.SLDPRT, 3193T140_STAND-OFF STRUT-MNT MTL ROUTING CLAMP.SLDPRT, 33085T541_STRUT CHANNEL.SLDPRT, 416201U00000G-ND_12IN HEATSINK.SLDPRT, 4379K620_FDA PLASTIC BALL VALVE.SLDPRT, 4946A200_EXPANDABLE LOCKING GROMMETS.SLDPRT, 5175K212_COPPER TUBING FOR DRINKING WATER.SLDPRT]
2019-05-13 lhc-308 drawing changes and pdf export
    [lhc-308.SLDDRW]
2019-05-13 mech drawing changes to lhc top plate for water jet
    [lhc-304.DXF, lhc-305.DXF, lhc-305.SLDPRT]
2019-05-13 new lhc-300 top plate dxf
    [lhc-301.SLDASM, lhc-304.SLDPRT]
2019-05-20 5-20-19 HVAC LHC Updates
    [10-137-05_PGN1 HEATER.SLDPRT, 1262T567_304 STAINLESS STEEL U-CHANNEL.SLDPRT, 1621-1007-ND_KHATOD OPTIC 1825.SLDPRT, 1734K470_DUCT FLANGE.SLDPRT, 1764K470_DUCT FLANGE.SLDPRT, 1964K830_LOW-PROFILE RECTANGULAR DUCT.SLDPRT, 1976K270_AC EQUIPMENT COOLING FAN.SLDPRT, 1DGL-JC-50W-RE Red LED.SLDPRT]
2019-05-22 changed text and created new dxf file for lhc-304
    [lhc-304.DXF, lhc-304.SLDPRT, lhc-304_no letter.DXF]
2019-05-22 5-22-19 LHC updates
    [10-137-05_PGN1 HEATER.SLDPRT, 1262T567_304 STAINLESS STEEL U-CHANNEL.SLDPRT, 1621-1007-ND_KHATOD OPTIC 1825.SLDPRT, 1734K470_DUCT FLANGE.SLDPRT, 1976K270_AC EQUIPMENT COOLING FAN.SLDPRT, 1DGL-JC-50W-RE Red LED.SLDPRT, 2356T110_STRUT CHANNEL CASTER.SLDPRT, 3193T140_STAND-OFF STRUT-MNT MTL ROUTING CLAMP.SLDPRT]
2019-05-28 5-28-19 LHC updates
    [Floating Light Assembly.SLDASM, lhc-301.SLDASM]
2019-05-29 5-19-19 Updates
    [1621-1007-ND_KHATOD OPTIC 1825.SLDPRT, 1DGL-JC-50W-RE Red LED.SLDPRT, 3193T140_STAND-OFF STRUT-MNT MTL ROUTING CLAMP.SLDPRT, 3208T174_BACK-TO-BACK STACKED STRUT CHANNEL.SLDPRT, 33085T541_STRUT CHANNEL.SLDPRT, 33085T543_STRUT CHANNEL.SLDPRT, 33125T120_STRUT CHANNEL CONNECTOR.SLDPRT, 33125T411_STRUT CHANNEL CONNECTOR.SLDPRT]
2019-05-30 5-30-19 LHC updates
    [1DGL-JC-50W-RE Red LED.SLDPRT, 2019-03-21_tests.xlsx, 3193T140_STAND-OFF STRUT-MNT MTL ROUTING CLAMP.SLDPRT, 33085T541_STRUT CHANNEL.SLDPRT, 33085T543_STRUT CHANNEL.SLDPRT, 3310T400_STRUT CHANNEL.SLDPRT, 416201U00000G-ND_12IN HEATSINK.SLDPRT, 5175K212_COPPER TUBING FOR DRINKING WATER.SLDPRT]
2019-06-06 6-6-19 Updat
    [10-137-05_PGN1 HEATER.SLDPRT, 1621-1007-ND_KHATOD OPTIC 1825.SLDPRT, 1DGL-JC-50W-RE Red LED.SLDPRT, 3193T140_STAND-OFF STRUT-MNT MTL ROUTING CLAMP.SLDPRT, 3208T174_BACK-TO-BACK STACKED STRUT CHANNEL.SLDPRT, 33085T541_STRUT CHANNEL.SLDPRT, 416201U00000G-ND_12IN HEATSINK.SLDPRT, 4379K620_FDA PLASTIC BALL VALVE.SLDPRT]
2019-06-13 6-13-19 updates
    [10-137-05_PGN1 HEATER.SLDPRT, 1262T567_304 STAINLESS STEEL U-CHANNEL.SLDPRT, 1621-1007-ND_KHATOD OPTIC 1825.SLDPRT, 1734K470_DUCT FLANGE.SLDPRT, 1850A110_T-SLOTTED TRACK.SLDPRT, 1976K270_AC EQUIPMENT COOLING FAN.SLDPRT, 1DGL-JC-50W-RE Red LED.SLDPRT, 3193T140_STAND-OFF STRUT-MNT MTL ROUTING CLAMP.SLDPRT]
2019-06-24 6-24-19 Latest LHC CAD Updates
    [10-137-05_PGN1 HEATER.SLDPRT, 1262T567_304 STAINLESS STEEL U-CHANNEL.SLDPRT, 1621-1007-ND_KHATOD OPTIC 1825.SLDPRT, 1734K470_DUCT FLANGE.SLDPRT, 1976K270_AC EQUIPMENT COOLING FAN.SLDPRT, 1DGL-JC-50W-RE Red LED.SLDPRT, 3193T140_STAND-OFF STRUT-MNT MTL ROUTING CLAMP.SLDPRT, 3208T174_BACK-TO-BACK STACKED STRUT CHANNEL.SLDPRT]
2019-07-03 CAD Database Reorganization 7-3-19
    [10-137-05_PGN1 HEATER.SLDPRT, 1262T567_304 STAINLESS STEEL U-CHANNEL.SLDPRT, 1586A130_SURFACE-MOUNT HINGE.SLDPRT, 1621-1007-ND_KHATOD OPTIC 1825.SLDPRT, 1734K470_DUCT FLANGE.SLDPRT, 1976K270_AC EQUIPMENT COOLING FAN.SLDPRT, 1DGL-JC-50W-RE Red LED.SLDPRT, 2233K150_STRUT CHANNEL TAB-LOCK NUT.SLDPRT]
2019-08-06 8-6-19 LHC updates
    [10-137-05_PGN1 HEATER.SLDPRT, 1262T567_304 STAINLESS STEEL U-CHANNEL.SLDPRT, 1621-1007-ND_KHATOD OPTIC 1825.SLDPRT, 1734K470_DUCT FLANGE.SLDPRT, 1976K270_AC EQUIPMENT COOLING FAN.SLDPRT, 1DGL-JC-50W-RE Red LED.SLDPRT, 3193T140_STAND-OFF STRUT-MNT MTL ROUTING CLAMP.SLDPRT, 33085T430_STRUT CHANNEL.SLDPRT]
2019-08-21 8-21-19 LHC Updates
    [1621-1007-ND_KHATOD OPTIC 1825.SLDPRT, 1DGL-JC-50W-RE Red LED.SLDPRT, 3193T140_STAND-OFF STRUT-MNT MTL ROUTING CLAMP.SLDPRT, 416201U00000G-ND_12IN HEATSINK.SLDPRT, 4379K620_FDA PLASTIC BALL VALVE.SLDPRT, 4946A200_EXPANDABLE LOCKING GROMMETS.SLDPRT, 5175K212_COPPER TUBING FOR DRINKING WATER.SLDPRT, 5233K560_MASTERKLEER PVC TUBING (2).SLDPRT]
2019-09-11 9-11-19 LHC Updates
    [10-137-05_PGN1 HEATER.SLDPRT, 1262T567_304 STAINLESS STEEL U-CHANNEL.SLDPRT, 1621-1007-ND_KHATOD OPTIC 1825.SLDPRT, 1734K470_DUCT FLANGE.SLDPRT, 1976K270_AC EQUIPMENT COOLING FAN.SLDPRT, 1DGL-JC-50W-RE Red LED.SLDPRT, 3193T140_STAND-OFF STRUT-MNT MTL ROUTING CLAMP.SLDPRT, 3208T174_BACK-TO-BACK STACKED STRUT CHANNEL.SLDPRT]
2019-09-12 9-12-19 LHC Updates
    [1262T567_304 STAINLESS STEEL U-CHANNEL.SLDPRT, 1734K470_DUCT FLANGE.SLDPRT, 33085T430_STRUT CHANNEL.SLDPRT, 3310T661_STRUT CHANNEL.SLDPRT, 9017K753_LOW-CARBON STEEL 90 DEGREE ANGLE.SLDPRT, CLIP HANGER LOCATIONS.SLDPRT, Floating Light Assembly.SLDASM, Jamison Refrigerator Door.SLDPRT]
2019-09-17 9-17-19 Updates
    [10-137-05_PGN1 HEATER.SLDPRT, 1262T567_304 STAINLESS STEEL U-CHANNEL.SLDPRT, 1621-1007-ND_KHATOD OPTIC 1825.SLDPRT, 1734K470_DUCT FLANGE.SLDPRT, 1976K270_AC EQUIPMENT COOLING FAN.SLDPRT, 1DGL-JC-50W-RE Red LED.SLDPRT, 3193T140_STAND-OFF STRUT-MNT MTL ROUTING CLAMP.SLDPRT, 3208T174_BACK-TO-BACK STACKED STRUT CHANNEL.SLDPRT]
2019-09-18 9-18-19 Update
    [1556A240_BRACKET.SLDPRT, 1826T400_OUTLET BOX WITH RECEPTACLE.SLDPRT, 2615T130_VIBRATION-DAMPING CLAMPING HANGER.SLDPRT, 3200T940_STRUT CHANNEL SHELF BRACKET.SLDPRT, 3338A22_HORIZONTAL_SURFACE_MOUNT_LEVEL.SLDPRT, 5346K460_BRASS BARBED HOSE FITTING.SLDPRT, 5648K263_CHOOSE-A-COLOR POLYURETHANE TUBING.SLDPRT, 6308T12 Wye-Shaped On-Off Valve.SLDPRT]
2019-10-10 10-10-2019 LHC Documentation Updates
    [10-137-05_PGN1 HEATER.SLDPRT, 1362A130_ZINC-PLATED STEEL HOOK.SLDPRT, 1734K470_DUCT FLANGE.SLDPRT, 3528T230_BARBED TUBE FITTING FOR DRINKING WATER.SLDPRT, 3662K270_VERTICAL PLASTIC TANK WITH DRAIN.SLDPRT, 51275K810_POLYETHYLENE TUBING FOR DRINKING WATER.SLDPRT, 5385K250_QD TUBE COUPLING FOR FOOD AND BEVERAGE.SLDPRT, 5385K550_QD TUBE COUPLING FOR FOOD AND BEVERAGE.SLDPRT]
2019-10-18 2019-10-18 Updates
    [2283T11 Wall Mounted Gas Cylinder Rack.SLDPRT, 51275K810_POLYETHYLENE TUBING FOR DRINKING WATER.SLDPRT, 5385K250_QD TUBE COUPLING FOR FOOD AND BEVERAGE.SLDPRT, 5385K550_QD TUBE COUPLING FOR FOOD AND BEVERAGE.SLDPRT, 976-1596-ND_BRIDGELUX VERO29.SLDPRT, C02 Gas Line.SLDPRT, Foam Insulation Box.SLDPRT, LHC-400.SLDASM]
2019-10-22 2019-10-22 Documentation Updates
    [10-137-05_PGN1 HEATER.SLDPRT, 1262T567_304 STAINLESS STEEL U-CHANNEL.SLDPRT, 1556A240_BRACKET.SLDPRT, 1621-1007-ND_KHATOD OPTIC 1825.SLDPRT, 1734K470_DUCT FLANGE.SLDPRT, 1826T400_OUTLET BOX WITH RECEPTACLE.SLDPRT, 1976K270_AC EQUIPMENT COOLING FAN.SLDPRT, 1DGL-JC-50W-RE Red LED.SLDPRT]
2019-10-24 10-24-2019 documentation updates
    [1621-1007-ND_KHATOD OPTIC 1825.SLDPRT, 1DGL-JC-50W-RE Red LED.SLDPRT, 2283T11 Wall Mounted Gas Cylinder Rack.SLDPRT, 3193T140_STAND-OFF STRUT-MNT MTL ROUTING CLAMP.SLDPRT, 3208T174_BACK-TO-BACK STACKED STRUT CHANNEL.SLDPRT, 3208T190_BACK-TO-BACK STACKED STRUT CHANNEL.SLDPRT, 3208T370_BACK-TO-BACK STACKED STRUT CHANNEL.SLDPRT, 33085T430_STRUT CHANNEL.SLDPRT]
2019-10-26 10-26-2019 Updates
    [1621-1007-ND_KHATOD OPTIC 1825.SLDPRT, 1DGL-JC-50W-RE Red LED.SLDPRT, 3193T140_STAND-OFF STRUT-MNT MTL ROUTING CLAMP.SLDPRT, 33085T541_STRUT CHANNEL.SLDPRT, 3310T211_STRUT CHANNEL.SLDPRT, 3310T214_STRUT CHANNEL.SLDPRT, 33125T139_STRUT CHANNEL CONNECTOR.SLDPRT, 33125T146_STRUT CHANNEL CONNECTOR.SLDPRT]
2019-10-28 2019-10-28 Updates
    [33085T541_STRUT CHANNEL.SLDPRT, 3310T211_STRUT CHANNEL.SLDPRT, 3310T214_STRUT CHANNEL.SLDPRT, 33125T139_STRUT CHANNEL CONNECTOR.SLDPRT, 33125T146_STRUT CHANNEL CONNECTOR.SLDPRT, 33125T320_STRUT CHANNEL CONNECTOR.SLDPRT, 33125T421_STRUT CHANNEL CONNECTOR.SLDPRT, 3574T420_STRUT CHANNEL BRACE.SLDPRT]
2019-10-30 2019-10-29 Updates
    [1621-1007-ND_KHATOD OPTIC 1825.SLDPRT, 1DGL-JC-50W-RE Red LED.SLDPRT, 3064T110_LOOP HANGER.SLDPRT, 3193T140_STAND-OFF STRUT-MNT MTL ROUTING CLAMP.SLDPRT, 3225T270_VIBRATION-DAMPING LOOP CLAMP.SLDPRT, 33085T430_STRUT CHANNEL.SLDPRT, 33085T541_STRUT CHANNEL.SLDPRT, 33085T543_STRUT CHANNEL.SLDPRT]
2019-10-31 10-30-2019 updates
    [2531K134_BOLT-DOWN SWIVEL LEVELING MOUNT W TWO HOLES.SLDPRT, CO2 System Design BOM.xlsx, Coil Design BOM.xlsx, LHC-300 Sign-out Sheet.xlsx]
2019-11-06 11-5-2019 Final Documentation Updates
    [LHC-300 Light Assembly Fabrication Checklist - ONGOING.xlsx]
