OpenAgricultureFoundation/openag-mechanical/prj/hazelnut_large/LHC-001/1-Documentation/2019-5-22 LHC-300 Failure Mode Testing/Test 1/IMG_1731.JPG

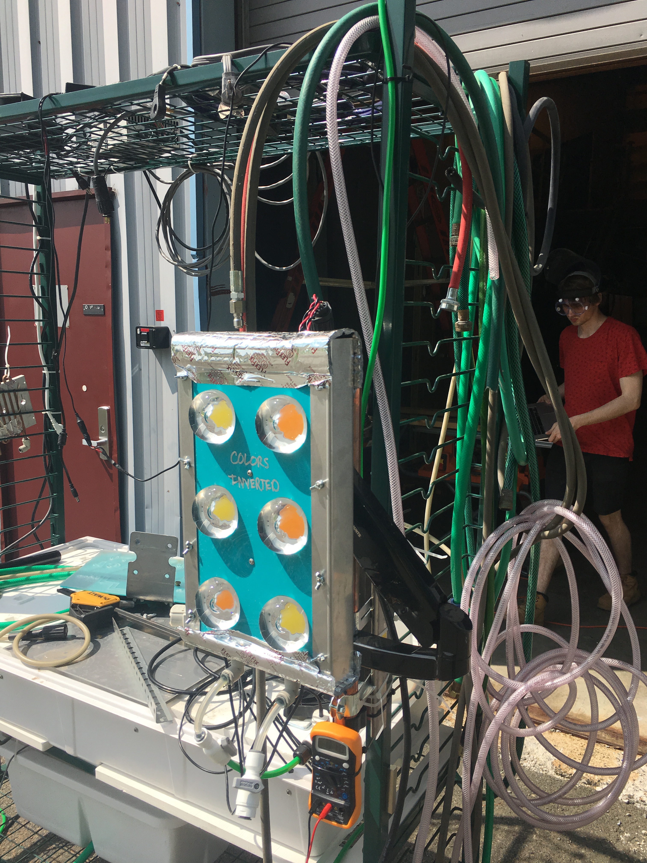
prj/hazelnut_large/LHC-001/1-Documentation/2019-5-22 LHC-300 Failure Mode Testing/Test 1/IMG_1731.JPG
